jiangtao-ml/ESP32_C3_Gateway/README.md

# ESP32-C3 工业数据采集网关（STB3-125 → UDP）

> **一句话**：用 ~50 元的 ESP32-C3 SuperMini + MAX13487，把配电箱电表 `STB3-125` 的用电数据
> （RS-485 / Modbus RTU）采下来，经 WiFi 以 **UDP + JSON** 送到电脑入库。
>
> **目标级别 = L1 实验室样机**（2026-10-22 定）：单台稳定采集 + 结果可复现 + 故障可定位。
> **明确不做**：隔离 / 打样 PCB / EMC 认证 / 批量一致性 —— 理由见 `02_docs/26_级别声明与范围边界.md`。
>
> **最后更新**：**2026-10-26 · 砚青**（结构整理：本文件由 212 行压到约 100 行。删除了与 `PROGRESS.md`
> 重复的进度表、待办清单、环境参数，以及已过期的 IP 值、编译基线、"RXO 必须分压"、EN 接 5V 等口径。
> 原则：**会变的事实只留单一出处**，本文件只做导航）
> 上一版：2026-10-17

---

## 0. 只读这几份文件

| 顺序 | 你想知道 | 读这个 | 它不回答什么 |
| --- | --- | --- | --- |
| 1️⃣ | **这个系统到底怎么跑起来的** | **`02_docs/28_系统全链路说明.md`** ← **新人从这里开始** | 需求和判据 |
| 2️⃣ | **现在在哪个阶段、下一步做什么、能不能放行** | **`02_docs/00_阶段与门禁主控表.md`** ← **唯一主线** | 具体怎么做 |
| 3️⃣ | **今天/本周发生了什么、历史决策留痕** | `PROGRESS.md` | 需求与判据 |
| 4️⃣ | **每个文件该去哪、目录怎么组织** | `02_docs/23_项目结构说明.md` | 进度 |

> 其余 20+ 份文档**只在上面几份指向时才需要打开**。
> 每个目录都有自己的 `README.md`，进去先看那个。
>
> ⚠️ 旧版本文档常写"`04_ai_prompts/00_context.md` 是唯一事实来源"，**该口径已不准确**（2026-10 旧说法）：
> 需求以 `02_docs/21` 为准、判据以 `02_docs/24` 为准、进度以 `PROGRESS.md` 为准。详见 `02_docs/00` §2。

---

## 1. 项目定位（2026-10-21 重新定调，覆盖旧表述）

| | 内容 |
| --- | --- |
| ❌ 不是 | "用 ESP32 替代树莓派省钱" —— 那只是立项由头，**不是验收目标** |
| ✅ 是 | **把 ESP32-C3 + MAX13487 焊到洞洞板上、稳定收发真机数据、做到"完整"** |
| 载体 | 7×9 洞洞板，两模块引脚**直焊**（无排母、焊上即不可拆），后续只补外壳 |
| 验收 | 能采 / 可信 / 可诊断 / 可复现 / 可交付（`02_docs/26` §2） |

> 因此：**本项目不做 PCB**（`02_docs/26` N-2，2026-10-26 用户确认放弃，两套自研板工程已删除）。
> 唯一硬件方案是**洞洞板直焊**。网上买块板子、等打样、找贴片厂 —— 都不在计划内。

---

## 2. 系统链路

```
STB3-125 电表 ──RS-485 (9600 8N1 / Modbus RTU)──►  ESP32-C3 SuperMini + MAX13487
                                                              │  WiFi
                                                              ▼
                                              UDP:8888 JSON ──►  电脑（Ubuntu）→ SQLite
```

三条设计口径（**别"优化"掉**）：

- **上行 = JSON**：数据行 / 心跳行 `type:"hb"` / 失败行 `type:"err"`；带 `seq`、`dev`、`quality`、`invalid`、`raw`（HEX）
- **轮询 = `0x04` 读输入寄存器**，运行时自适应：启动默认**一帧读全 39 寄存器**（83 B），从未成功且连续 3 轮失败才降级 3 段（37/37/19 B）
- **固件只搬运原始值，不做工程量换算** —— 换算放 PC/服务端 ⇒ 公式可演进、`raw_hex` 可重放

---

## 3. 六个目录

```
ESP32_C3_Gateway/
├─ 01_firmware/        固件（唯一可编译产物来源）
│  ├─ esp32c3_gateway/   ★ 主工程（PlatformIO / Arduino）
│  ├─ pio_verify/        编译对照工程（只编译、不烧录）
│  └─ rs485_probe/       焊接体检工程（诊断 GPIO20 通断，不是业务固件）
├─ 02_docs/            设计、需求、方案、判据、排障记录（入口 = 00_阶段与门禁主控表）
├─ 03_logs/            运行证据与日志（不入库；分 A/B/C 三级，见其 README）
├─ 04_ai_prompts/      AI 协作指令与上下文包
├─ 05_hardware/        硬件资料：协议原件 / 字段字典 / 接线 / 洞洞板图纸
│  └─ _备查_未打样PCB/   两块自研板（L2 备查，未入库）
├─ 06_tests/           PC 侧测试脚本与操作卡（见其 README）
├─ PROGRESS.md         进度与决策留痕
└─ README.md           本文件（只做导航）
```

编号前缀用于固定排序，**不要改名**（两百多处交叉引用依赖它）。

---

## 4. 如果今天就要动手

1. **施工顺序**：`05_hardware/洞洞板固化操作卡_2026-10-08.md`（v1.3，含材料 / 步骤 / 电检 / 签核表）
   → 图纸依据 `05_hardware/洞洞板布局图_2026-10-21.md`（v1.2）
2. **编译 / 烧录**：命令与两条链路的选择见 `PROGRESS.md` §5b（**PlatformIO 为正式链**）
3. **起接收端 / 抓包**：`06_tests/README.md`
4. **真机联调**：`06_tests/M5_真机联调操作卡.md`

---

## 5. 三条最致命的红线（都踩过，别再踩）

### ① 485 模块的 `TXD` / `RXD` 是**交叉**约定

模块丝印写的是**模块自身**的收发方向：模块 `TXD` = 芯片 `RO`（收），模块 `RXD` = 芯片 `DI`（发）。

- ✅ 正确：`GPIO21`(ESP32 TX) → 模块 `RXD`；`GPIO20`(ESP32 RX) ← 模块 `TXD`
- ❌ 同名对接 ⇒ **双向全断，而模块电源灯仍亮** —— 这正是 M4 卡五天的真凶
- 复盘：`02_docs/14_M4排障全过程复盘_2026-10-04.md`

### ② 总线侧顺序是 `B` / `A` / `GND`（GND 在最后）

按**字母**接，不按位置接。旧材料记作 `GND/A/B` 是错的。

### ③ 真机在**带电配电箱**里 —— 开箱前断电 + 验电

- 疑似三相 380V ⇒ **必须断全三相**；**无万用表不许开箱**
- **判据：看 485 另一头有没有市电** —— 有市电 ⇒ **充电宝供电 + 拔 USB**
  （否则经 USB 地 + 485 共模可烧电脑主板）
- ⚠️「装的时候断电了」≠「此后一直安全」⇒ **每次改接线前都要再断一次**

> 其余接线事实（EN 接 **3.3V**、`RXO` **直连 GPIO20 不分压**、GND 共地、5V/3.3V 双供电）
> 见 `05_hardware/接线说明.md` 与 `04_ai_prompts/00_context.md` 三.2–三.5。

---

## 6. 现状一句话

**M0–M6 全部通过**（M6：900 s 压测 `poll_ok=975 / poll_err=0`，UDP 数据行送达 98.0%）。
当前在 **S3 验证阶段**：台面计划已就绪（`02_docs/24`），**缺 168 h 真机长跑报告**，
以及 `09_成本对比` / `10_验收结项` 两份交付文档。

> 逐条门禁判定与"下一步只做一件事"见 `02_docs/00_阶段与门禁主控表.md` §6–§7。

---

## 7. 协作约定（详见 `PROGRESS.md` §2b）

- **作者 ≠ 验证者**：任何固件改动必须由另一角色复核后才可烧录。
- **提交只 add 自己的文件**，永不 `git add -A`（会吞掉他人的在途改动）。
- **作废 ≠ 删除**：先移 `_archive/` 并记一行原因。
- **临时产物**写 `.workbuddy/tmp/` 或 `03_logs/`，**不落仓库根目录**。
