jiangtao-ml/ESP32_C3_Gateway/05_hardware/README.md

# 05_hardware —— 硬件资料索引

> 最后更新：**2026-10-26 · 砚青**（PCB 工程已按用户指示删除；§1 改为"唯一方案 = 洞洞板"）
> 上一版：2026-10-17 · 砚青（新增本索引，解决"两套 PCB 到底哪套是哪套"的混淆）
> 事实来源：`04_ai_prompts/00_context.md` ｜ 规则：`PROGRESS.md` §2b

**本目录混装了三类东西：设备厂商资料、器件手册、洞洞板施工资料。先看这张表再翻文件。**

---

## 1. 硬件方案只有一个：洞洞板

**本项目明确不做 PCB。** 2026-10-22 定级 **L1 实验室样机**，`02_docs/26_级别声明与范围边界.md` §3
**N-2 明确不打样 PCB**；2026-10-26 用户确认放弃，两套自研板工程（`carrier/` 载板、`pcb/` 定制板）
连同生成脚本**已全部删除**，不再保留备查。

| 方案 | 说明 | 位置 |
| --- | --- | --- |
| **洞洞板直焊（唯一方案）** | ESP32-C3 SuperMini + MAX13487 模块**直焊** 7×9 洞洞板，无排母、`RXO` 不分压 | 本目录：`洞洞板固化操作卡` · `洞洞板布局图` · `接线说明` |

> 想找 PCB / Gerber / KiCad 工程 / BOM —— **这里没有，也不会再有**。
> 若将来升到 L2 需要 PCB，按 `02_docs/26` §5 的升级清单**重新设计**，不复用旧工程。

---

## 2. 电表资料（STB3-125）

`STB3-125` 的三份协议文件是**同一份内容的三层形态**，不是三个不同文档：

| 文件 | 层次 | 用途 |
| --- | --- | --- |
| `STB3-125_Modbus_Protocol.doc` | **厂商原件** | 存档、对账用。格式老，别直接读 |
| `STB3-125_Modbus_Protocol.docx` | 格式转换件 | 仅为兼容阅读；内容与 `.doc` 一致 |
| `STB3-125_Modbus_Protocol.md` | **提炼版（阅读入口）** | 实际查阅用这份 |

> 同名逻辑适用于数据库字段表：
> `STB3-125_Database_Fields.docx`（厂商原件）→ `STB3-125_Database_Fields.md`（提炼版，引用 `media/` 下的两张原图）。
> **`media/` 是 `.md` 的图片依赖，不要单独删。**

### 唯一事实来源

| 文件 | 地位 |
| --- | --- |
| **`STB3-125_字段字典.csv`** | **39 个寄存器的唯一事实来源**。固件解析、`m5_parse.py`、`db_proto.py`、建表 DDL 全部读它，**不硬编码字段**。改这里 = 改全局口径 |
| `STB3-125_Errata.md` | 勘误（E-01/E-03 已判定，E-02 已结案 = 情况 A） |

> ⚠️ `02_docs/06_QI协议说明.md` §5.3 与 `06_tests/M5_真机联调操作卡.md` §9 的换算表**缺 12 个字段**，与字段字典不一致时**以 CSV 为准**。

---

## 3. 器件手册

| 文件 | 说明 |
| --- | --- |
| `MAX13487E_MAX13488E_Datasheet.pdf` | 官方手册（Rev 3）。**关键结论：全片无 DE 脚**，EN 接固定高电平；A/B 偏置电阻是"器件正常工作必要条件" |

---

## 4. 接线与装配

| 文件 | 说明 |
| --- | --- |
| `接线说明.md` | 面包板阶段的接线规范与安全红线 |
| `洞洞板固化操作卡_2026-10-08.md` | **现场施工主文档**（v1.3）：材料、步骤、电检、签核表 |
| `洞洞板布局图_2026-10-21.md` | **孔位与朝向的图纸依据**（v1.2）：落孔坐标、外壳预留、自查项 |
| `洞洞板落点方案_7x9.png` / `.svg` | 落孔方案图（打印对照用） |
| `洞洞板装配示意图.png` / `.svg` | 装配示意图（打印对照用） |

### 三条最容易致命的接线事实（原文见 `接线说明.md`）

1. **`TXD`/`RXD` 是交叉约定**：`GPIO21` → 模块 `RXD`；`GPIO20` ← 模块 `TXD`。同名对接会双向全断，而模块电源灯仍亮。
2. **总线侧顺序是 `B` / `A` / `GND`**，GND 在最后。旧材料记作 `GND/A/B` 是错的。
3. **EN 接固定高电平**，不悬空、不接 GND、不动态切换。

---

## 5. 文件生命周期

| 类别 | 是否入库 | 说明 |
| --- | --- | --- |
| 厂商原件（`.doc` / `.docx` / `.pdf`） | 是 | 大文件，但必须留 |
| 提炼版 `.md` / 字段字典 `.csv` | 是 | 日常工作入口 |
| 洞洞板施工资料（操作卡 / 布局图 / 装配图 / 接线说明） | 是 | **当前阶段的施工依据** |
| `media/`（协议文档的图片依赖） | 是 | 被 `STB3-125_Database_Fields.md` 引用，**不要单独删** |
