jiangtao-ml/ESP32_C3_Gateway/01_firmware/esp32c3_gateway/README.md

# 01_firmware/esp32c3_gateway —— ESP32-C3 RS-485 采集网关固件主工程

本目录是「ESP32-C3 替换树莓派网关项目」的固件主工程（Arduino sketch）。

> ## ⚠️ 先读这里：当前状态（最后更新 **2026-10-17** 砚青：M6 收官状态同步 + 工具链切 PlatformIO）
>
> | 项 | 现值 |
> | --- | --- |
> | **关卡** | **M0–M6 全部通过** + 功能对齐 **批次 1 / 2 / 3 / 3.5 全部完成**；**M7 验收结项进行中** |
> | 当前阶段 | **阶段四 → 阶段五**（M6 已收官：900s `poll_ok=975/poll_err=0` = 100%） |
> | **上行格式** | **JSON 三类行**（数据行 + 心跳行 `type:"hb"` + **失败行 `type:"err"`**）—— **不再是** `时间戳 \| HEX`（功能对齐批次 1 起） |
> | **轮询帧** | **功能码 `0x04`**（读输入寄存器）；**运行时自适应**（批次 2 起）：启动默认**一帧读全**（`00 27` → 83 字节），从未成功且连续 3 轮失败自动降级 **3 段**（S1/S2/S3 → 37/37/19 字节），本会话不回切 |
> | **时间同步** | **三源**：**主 `172.16.0.2`（校内 chrony）** → 备1 `ntp.aliyun.com` → 备2 `203.107.6.88`；`NTP_TZ_INFO = "CST-8"` |
> | **电脑侧 IP** | **每次开工前实测确认**（漂移史 `.117`→`.118`→`.114`→`.113`→`.121`→**`.150`**）。**2026-10-22 起定为旧测试电脑 `192.168.1.150`**。真机当前由 **NVS** 决定，改 Web 即可、不必重烧 |
> | **串口** | ESP32 = **COM5**（`303A:1001`，原生 USB CDC）；USB 转 485 = CH340（`1A86:7523`）；换 USB 口会变 |
> | **字符间隔超时** | **`RS485_CHAR_TIMEOUT_MS = 8`**（M5 正式档位；M4 期间曾临时放大到 25） |
> | **设备命名** | `dev = "ESP485-" + MAC 后 6 位`（例 `ESP485-159B88`） |
> | 编译基线（`--clean`） | **Flash `1 089 225` B / RAM `49 568` B**（`SELFTEST=0`，2026-10-27 实测）；`SELFTEST=1` = `1 081 561` / `49 408`。**0 error / 0 warning**（默认 flags）｜⚠️ 旧记 `1 070 975 / 49 348` 是 **M6 时代过期数**，勿再引用 |
>
> - **完整当前状态与下一步 → 根目录 `PROGRESS.md`**（**所有协作者 / AI 智能体先读它**）。
> - **烧录工具链**：**PlatformIO（`pioarduino@55.03.311`）为正式链**（2026-10-08 两链真机对照 100%，commit `28945a8`）；`arduino-cli` 降为对照。
> - **本文件其余章节（M2 / M3 / M4）是当时的**过程与实测记录**。示例里的 IP、NTP 源、`HEARTBEAT` 载荷、
>   `0x03` 请求帧等，**都是"当时的真值"**，保留原样作为历史与复现依据 —— **不要拿它们当现状去配置**。

## 目录结构

```
01_firmware/esp32c3_gateway/
├── esp32c3_gateway.ino     # sketch 主文件（M5：WiFi + NTP 三源 + UDP JSON 上行 + 485 总线 0x04 三段读取/解析）
├── config.h               # 非敏感常量（电脑/自身 IP、端口、NTP 三源、周期；485 超时与 Modbus/QI 常量）
├── secrets.h.example      # 凭据模板（占位符，不含真实值）
├── secrets.h              # ← 本地自建，不入库（.gitignore 已忽略）
└── README.md              # 本文件
```

sketch 目录名必须与 .ino 文件名一致（`esp32c3_gateway`），否则 Arduino IDE 无法识别。

## 首次搭建

1. 复制凭据模板并填写真实值（本文件不入库）：

   ```powershell
   Copy-Item .\secrets.h.example .\secrets.h
   ```

   然后编辑 `secrets.h`，把 `<占位符>` 换成实际 SSID / 密码。

2. 用 Arduino IDE 打开 `esp32c3_gateway.ino`。

## 构建方式（Arduino IDE）

| 项 | 设置 |
| --- | --- |
| 开发板 | ESP32C3 Dev Module（ESP32-C3 SuperMini） |
| **USB CDC On Boot** | **Enabled** ← 必需，否则 `Serial` 无输出 |
| Flash Size | 4MB (32Mb) |
| Upload Speed | 921600（不稳定时降到 115200） |
| Port | **COM5**（`303A:1001`，原生 USB CDC；换 USB 口会变）。⚠️ 烧前关掉 Arduino IDE 串口监视器，否则报 `PermissionError(13)` |
| CPU Frequency | 160MHz |

关键设置：**USB CDC On Boot = Enabled**（此项是 `Serial` 有输出的前提）。

> ⚠️ **M3 起（含 M4）这是硬性要求**：若设为 Disabled，`Serial` 会落到 UART0，而 ESP32-C3 的 UART0 默认引脚正是 GPIO20/21 —— 会与 `Serial1` 争用同一对引脚，回环/总线收发必然异常。

> 命令行编译（可选，与上面的 IDE 设置等价；在仓库根目录执行）：

```powershell
arduino-cli compile --fqbn "esp32:esp32:esp32c3:CDCOnBoot=cdc" 01_firmware/esp32c3_gateway
```

> `CDCOnBoot=cdc` 不可省。烧录用同一条命令末尾加 `--upload -p COM5`。
>
> **编译基线（`--clean`，core `esp32:esp32 3.3.10-cn`）**：
> - M4 期（2026-10-03，Codex）：Flash **997299 B (76%)** / RAM **38244 B (11%)**
> - NTP 三源改造后（2026-10-05，Codex）：Flash **999293** / RAM **38308**
> - **M5 + 功能对齐批次 1 后（2026-10-06，WorkBuddy 独立复现）：Flash `1004579 B (76%)` / RAM `39108 B (11%)`，0 error / 0 warning** ← **当前基线**

UART1 参数（**M3 起已接入**，由 `setup()` 调用，形参顺序为 `(baud, config, RX, TX)`）：

```cpp
Serial1.begin(9600, SERIAL_8N1, 20, 21);   // RX=GPIO20, TX=GPIO21，9600 8N1
```

- 引脚：ESP32-C3 的 `HardwareSerial(1)` 可映射到 GPIO20/21（SuperMini 上无 USB/Flash 冲突）。
- `HardwareSerial(1)` 与 USB CDC（`Serial`）相互独立，可同时使用。
- RX 侧电平：**2026-10-21 已裁定直连** —— `RXO` 直接接 `GPIO20`，**不分压**（依据：本模块已实测可直连并通过 M4 1000 次 + M5 真机；用户 2026-10-21 最终确认）。若日后换用 5V 逻辑模块，必须重新按 §6.2 的分压方案处理。

## M2：WiFi + NTP + UDP 联通验证（**历史记录** · 2026-09-27；示例中的 IP / NTP 源 / `HEARTBEAT` 载荷均为当时真值）

前提：本目录已有 `secrets.h`（含真实 SSID / 密码）；`config.h` 的 `UDP_TARGET_IP` / `LOCAL_IP` 与实测一致。

1. **电脑侧**：打开 **NetAssist（网络调试助手）**，协议选 **UDP**，本地端口填 **8888**（= `UDP_TARGET_PORT`），点「打开」。
2. 确认电脑无线网卡 IPv4 仍为 `192.168.1.118`（`ipconfig /all`；**会随网络漂移**，2026-10-04 实测值，原 `.117`）；若已变化，先改 `config.h` 再烧录。
3. 烧录固件并打开串口监视器（115200）。预期串口输出：

```text
[WIFI] 静态配置 IP=192.168.1.200 GW=192.168.1.1 MASK=255.255.255.0 DNS=192.168.1.1
[WIFI] 已发起连接（非阻塞），等待 wifiTick() 报告结果
[UDP] 本地端口 12345，目标 192.168.1.118:8888
[485] UART1 就绪 baud=9600 8N1 RX=GPIO20 TX=GPIO21
[485] 模式=真实 485 总线：ESP32(TX) -> MAX13487 -> 电脑 USB 转 485（Modbus 从站）
[485] ⚠️ RXO 先万用表实测空闲电平：5V 必须 1k/2k 分压后接 GPIO20，3.3V 则直连不分压（未实测前按 5V 处理）；EN 接法随实物芯片型号二选一（MAX13487/13488 → 固定高电平；MAX485/MAX3485 → 方向控制 GPIO），先读丝印；三方必须共地。方向控制宏：MAX485 / MAX3485 → 把 config.h 的 RS485_DE_PIN 改成 EN 所接的 GPIO 号（默认 -1 = 不启用）
[485] 请求 8 字节 | 01 03 00 00 00 02 C4 0B  ->  期望响应 9 字节（从站地址 1，功能码 0x03 读 2 个保持寄存器）
[BOOT] M4 就绪：WiFi + NTP + UDP 心跳 + 485 总线收发 + Modbus RTU 解析
[WIFI] 已连接 SSID=xxx RSSI=-55 dBm IP=192.168.1.200 GW=192.168.1.1
[NTP] WiFi 已连上 -> 触发 SNTP 对时 TZ=CST-8 主=ntp.aliyun.com 备=203.107.6.88
[NTP] 时间已同步：本地 2026-09-27 20:15:03 +0800（TZ=CST-8，源 ntp.aliyun.com / 备选 203.107.6.88）
[UDP -> 192.168.1.118:8888] BOOT+5.012 | UNSYNCED
[UDP -> 192.168.1.118:8888] 2026-09-27 20:15:01 | HEARTBEAT
```

> 说明：本样例中的 UDP 目标为 **`192.168.1.118`**（= 当前 `config.h` 的 `UDP_TARGET_IP`）。
> 2026-09-27 首测时电脑为 `192.168.1.117`，**2026-10-04 实测漂移到 `.118`**；该值会随网络变化，以 `ipconfig /all` 为准。

4. **判定标准**（对应任务书 §9.1 M2）：
   - NetAssist 接收区**每秒出现 1 行**，格式 `YYYY-MM-DD HH:MM:SS | HEARTBEAT`（M4 起心跳标签为 `HEARTBEAT`；M2 阶段当时为 `M2_HEARTBEAT`，属历史记录）；
   - 对时完成前为 `BOOT+<秒>.<毫秒> | UNSYNCED`，对时完成后自动切换为墙钟时间；
   - **时区自检**：串口 `[NTP] 时间已同步` 行末尾应为 `+0800`（东八区）。若显示 `+0000`，说明 `NTP_TZ_INFO` 未生效（见 config.h 中关于不可写 `"<CST-8>"` 的注释）；
   - 连续 ≥60s 不断包（**从第 2 个包开始计时**，规避 ARP 首包丢失）。
5. **断网自恢复验证**：断开路由器 2.4GHz 约 30s 再恢复 → 串口应出现 `[WIFI] 连接断开` → `[WIFI] 第 N 次重连` → `[WIFI] 已连接` → `[NTP] WiFi 已连上 -> 触发 SNTP 对时`，且 **≤60s 内恢复发包**。

> 排查提示：NetAssist 收不到包 → 先看串口有无 `[WIFI] 已连接`（未连上则看 SSID 是否 2.4GHz）；再看 NetAssist 端口是否 8888 且已「打开」；最后确认电脑 IPv4 未变。

## M3：UART1 物理回环自测（内建，每秒自动一次）

目的：**先不接 MAX13487**，证明「串口能自发自收」，为 M4 的 Modbus 收发打底。
自测逻辑已内建在 `esp32c3_gateway.ino` 的 ST_TX / ST_WAIT_RX / ST_PARSE 中，**无需再手改代码**。

> ⚠️ **M4 起默认走真实总线模式**（`config.h` 里 `RS485_MODE_LOOPBACK_SELFTEST = 0`）。
> 要做本节回环自测，先把该宏改成 **`1`** 再烧录，测完**务必改回 `0`**。
> 若保持 `0` 直接短接 GPIO20/21，固件会按 9 字节响应帧等待，8 字节回环帧将被判为 `[M4] 帧长异常 期望 9 收到 8`（这不是故障，是模式不匹配）。

1. **断电**，用一根母-母杜邦线把 **GPIO21（TX1）与 GPIO20（RX1）短接**。
2. **不接 MAX13487**（避免总线偏置 / 终端电阻干扰判断，也避免 5V 电平灌进 GPIO20）。
3. 烧录并打开串口监视器（115200）。预期每秒一行：

```text
[485] UART1 就绪 baud=9600 8N1 RX=GPIO20 TX=GPIO21
[485] 模式=M3 物理回环自测：请短接 GPIO21 <-> GPIO20，且不接 MAX13487
[485] 回环 OK TX=8 RX=8 | 01 03 00 00 00 02 C4 0B
[485] 回环 OK TX=8 RX=8 | 01 03 00 00 00 02 C4 0B
...
[485] 统计：成功 100 / 失败 0 / 超时 0
```

4. **判定标准**（对应任务书 §9.1 M3）：
   - 每秒一行 `[485] 回环 OK TX=8 RX=8`，帧内容与 `01 03 00 00 00 02 C4 0B` **完全一致**；
   - **连续 1 分钟无 FAIL / TIMEOUT**（≥60 次全 OK）；跑到 1000 次时误帧 0、丢帧 0；
   - 每 100 次打印一次 `[485] 统计：成功 X / 失败 Y / 超时 Z`，其中 **Y 与 Z 应恒为 0**。
5. **失败判读**：
   - `TIMEOUT ... RX=0` → 短接线未插好 / 插错引脚，或 `USB CDC On Boot` 不是 Enabled（见上）；
   - `TIMEOUT ... RX=N`（0<N<8）→ 半帧，查杜邦线接触，或确认 MAX13487 是否仍挂在总线上；
   - `FAIL ... 期望 ... 收到 ...` → 后面紧跟的 `[差异] byte[i]` 会指出具体错位字节。

> ⚠️ 回环自测必须**先断开 MAX13487**，避免总线偏置 / 终端电阻干扰判断。

> 三级超时（均可调，见 `config.h`）：首字节 **80ms** → 字节间静默 **4ms** 判定本帧结束 → 整帧兜底 **300ms**。
> 发送后另有 **2ms** 保护间隔（`RS485_TX_GUARD_MS`）。9600 8N1 下 8 字节仅约 8.3ms，余量充足。

## M4：真实 485 总线收发 + Modbus RTU 解析（✅ **已完成，留作回归参考** · 2026-10-04）

目的：把 ESP32 从「自己发自己收」接到**真实 485 总线**上。ESP32 每秒发一帧 Modbus RTU 请求，
电脑端用 **USB 转 485 模块 + Modbus 从站模拟器**应答，ESP32 校验响应帧并打印解析结果。
M4 只用功能码 `0x03`（读 2 个保持寄存器）验证**物理链路与解析**，**QI 真机协议留待 M5**。

请求帧（`config.h` 的 `MODBUS_TEST_FRAME`，已含独立复算的 CRC）：

```text
01 03 00 00 00 02 C4 0B
│  │  └──┬──┘ └──┬──┘ └──┬──┘
│  │     │       │       └── CRC16/Modbus = 0x0BC4，低字节在前（C4 0B）
│  │     │       └────────── 读 2 个寄存器
│  │     └────────────────── 起始地址 0x0000
│  └──────────────────────── 功能码 0x03（读保持寄存器）
└─────────────────────────── 从站地址 1
```

期望响应帧长 = **9 字节**：地址 1 + 功能 1 + 字节数 1 + 数据 4 + CRC 2。

### 接线（三方必须共地）

> ### ⚠️⚠️【2026-10-04 M4 实测确认】下表用的是**芯片引脚名**，与**模块丝印**的对应关系是「交叉」的
>
> 模块丝印写的是**模块自身的收发方向**，不是"你那边接什么"：
>
> | 芯片引脚（下表用名） | 模块丝印 | 应接到 ESP32 |
> | --- | --- | --- |
> | `DI`（驱动**输入**） | **`RXD`** | `GPIO21`（TX） |
> | `RO`（接收**输出**） | **`TXD`**（别名 `RXO`） | `GPIO20`（RX） |
> | `VCC` / `GND` / `EN` | 同名 | `5V` / `G` / **`3.3`** |
>
> **即：`GPIO21` → 模块 `RXD`；`GPIO20` ← 模块 `TXD`。**
> 按"同名对接"（`GPIO21`→模块 `TXD`）会**双向全断**（`GPIO21` 顶在芯片输出脚上对撞、`DI` 从未被驱动），**而模块电源灯仍亮**，极易误判为硬件故障。
> 本项即 M4 卡 5 天的真凶，详见 `02_docs/14_M4排障全过程复盘_2026-10-04.md`。
>
> 另注：**总线侧 3 脚丝印顺序为 `B` / `A` / `GND`**（`GND` 在最后），旧材料记作 `GND / A / B` 是错的。

| 连接 | ESP32-C3 SuperMini | MAX13487 模块 | 说明 |
| --- | --- | --- | --- |
| 供电 | `5V` | `VCC` | ⚠️ MAX13487 **必须 5V**，不要接 3.3V |
| 发送 | `GPIO21`（TX1） | `DI` | 3.3V 逻辑可直驱 DI，无需电平转换 |
| 接收 | `GPIO20`（RX1） | `RXO`（= RO / RXD）**直连** | **不分压**（2026-10-21 裁定）。见下方说明 |
| 地 | `GND` | `GND` | ⚠️ **必须共地** |
| 总线 | — | `A(+)` / `B(-)` | 与 USB 转 485 模块的 `A(+)` / `B(-)` 一一对应接好 |
| 电脑侧 | — | — | USB 转 485 模块的 A/B 并在同一条总线上，其 `GND` 也必须并入上述共地点 |
| 控制 | `3.3` | `EN` | ⚠️ **接法随实物芯片型号二选一**（`MAX13487 / MAX13488` → 接**固定高电平**；`MAX485 / MAX3485` → 接方向控制 GPIO，需改造固件）。**先读实物 8 脚芯片丝印，未读前不得接任何电平**。本工程实物 = MAX13487，**接 3.3V**（2026-10-21 统一：原表写 `VCC/5V`，与载板网表的 `+3V3 → EN` 冲突，现以 3.3V 为准，见 `PROGRESS.md §8.2`） |

```text
共地拓扑（星形，务必连到同一点）：
  ESP32-C3 GND ──┬── MAX13487 GND
                 └── USB 转 485 模块 GND
```

> ### ✅ RXO 接法：已裁定**直连，不分压**（2026-10-21）
>
> 本模块 `RXO` 直连 `GPIO20`。依据：2026-10-06 拆掉 1k/2k 后 M4（1000 次）与 M5（真机）均通过；2026-10-21 用户最终确认不需分压。
>
> **若将来换用 5V 逻辑的 485 模块**，必须先量 `RXO` 空闲电平再决定，分压按下图：
>
> ```text
> MAX13487 RXO ──[1kΩ]── ● 分压节点 ──[2kΩ]── GND（**仅当 RXO 空闲为 5V 时**）
>                        └── ESP32 GPIO20（约 3.33V）
> ```
>
> - **严禁** `2kΩ 接 RXO、1kΩ 接 GND`：分压点仅约 1.67V，低于 ESP32-C3 高电平门限，必然收不到。
> - **严禁**只串一个 1kΩ 就直接进 GPIO20（不构成分压，5V 会灌进 3.3V 引脚，打穿 GPIO20）。
> - 本项目**洞洞板是直焊的**（无排母），换模块＝拆焊，所以"以后再说"成本很高。

> ### ⚠️⚠️ EN 接法：随实物芯片型号二选一，先读丝印
>
> 模块丝印 `EN` 的**含义随主芯片型号而变**：`MAX13487 / MAX13488` 上是 `RE#` 或 `SHDN#`（**接固定高电平即正确**）；`MAX485 / MAX3485` 上是方向控制脚（**必须由 GPIO 动态切换**，固定接高会占死总线）。
> **接线前必须先读实物 8 脚芯片丝印定型；丝印未读前不得给 EN 接任何电平。** 详见根目录 README 第 6.1 节与 `04_ai_prompts/00_context.md` 三.5。
>
> ### ⚠️⚠️（阻塞）先确认实物主芯片型号，再谈 EN
>
> 本模块所在商品页是**三合一款**：`MAX3485`（3.3V **单向**）/ `MAX485`（5V **单向**）/ `MAX13487`（5V **双向**）。
> 商品图上的芯片丝印是 `MAX485 ESA`。**三者的 EN 语义完全不同**：
>
> | 实物芯片 | 方向控制 | `EN` 该怎么接 |
> | --- | --- | --- |
> | MAX13487 / MAX13488（5V 双向） | 自动，无需控制脚（芯片**无 `DE` 脚**） | **接固定高电平**（模块 VCC/5V，3.3V 亦可）；**不得悬空 / 接 GND / 动态切换**。悬空若对应 `SHDN#` 会关断器件（症状 = `RX=0`） |
> | MAX485 / MAX3485（单向） | **必须**由 MCU 切 DE/RE | **必须接 GPIO 动态切换**；固定接高 = **占死总线**。本固件**已内建** `RS485_DE_PIN`：把 EN 所接 GPIO 号填入 `config.h` 即启用（默认 `-1` 不启用；实测方向相反时改 `RS485_DE_ACTIVE_HIGH`） |
>
> **接线前必须先读实物芯片丝印确认**。若为 MAX485 / MAX3485，把 `config.h` 的 `RS485_DE_PIN` 设为 EN 所接 GPIO 号后重新编译即可（无需改固件逻辑）。
>
> #### MAX13487E / 13488E 数据手册要点（**仅对 `MAX13487 / MAX13488` 成立**）
>
> 引脚（8 脚 SO）：`1 RO / 2 RE# / 3 SHDN# / 4 DI / 5 GND / 6 A / 7 B / 8 VCC` —— **无 `DE` 脚**。
> - `RE#`：拉低 → `RO` 常使能；拉高 → **交 AutoDirection 控制接收器**。
> - `SHDN#`：**拉高才正常工作**；拉低 → 关断器件。
> - **`DI` 空闲须为高电平**（数据手册 Idle State 要求），**不要在 `DI` 上加下拉**。

### 电脑端 Modbus 从站模拟器：**Modbus Slave**（用户已选定）

| 项 | 设定 |
| --- | --- |
| 工具 | **Modbus Slave**（Witte Software），官网 modbustools.com |
| 连接 | `Connection` -> `Connect` -> **Serial Port**，选中 USB 转 485 对应的 COM 口 |
| 模式 | **RTU**；波特率 **9600**、数据位 **8**、校验 **None**、停止位 **1**、无流控 |
| 从站 | `Setup` -> `Slave Definition`：**Slave ID = 1** |
| 功能 | 选 **03: Read Holding Registers**；`Address` = **0**、`Quantity`/**Length = 2**、`Mode` = `Dec` |
| 数据 | 双击 `0` / `1` 两行填任意值，例如 **10** 与 **20**（对应固件打印 `[0]=10 [1]=20`） |
| 应答 | 保持窗口打开并已 `Connect`；Modbus Slave 收到请求会自动回帧 |

> 备选：`pymodbus`（Python，`pip install pymodbus`）以脚本方式起 RTU 从站，便于复现与自动化；若 Modbus Slave 的显示不直观，可换用它。二者任选其一，**不要同时占用同一个 COM 口**。

> ⚠️ Modbus Slave 是**共享软件**：未注册时每次运行限时约 10 分钟且会弹窗。M4 验收需连续 ≥1 分钟，
> 时间够用；若超时弹窗导致断开，重新 `Connect` 即可。

### 用户操作步骤

1. **断电**接线：按上表接 ESP32 ↔ MAX13487 ↔ USB 转 485，**先完成三方共地**。
2. **上电前**用万用表测模块的 RXO 空闲电平，据此决定直连还是分压（见醒目框）。`EN` 按实物芯片丝印结论接入（`MAX13487 / MAX13488` → 固定高电平；`MAX485 / MAX3485` → 方向控制 GPIO）；**丝印未读前不得接任何电平**。
3. 电脑插上 USB 转 485，在设备管理器确认 COM 号，打开从站模拟器并按上节参数设好。
4. 烧录固件（`RS485_MODE_LOOPBACK_SELFTEST = 0`），打开串口监视器（115200）。

### 预期输出

```text
[485] 模式=真实 485 总线：ESP32(TX) -> MAX13487 -> 电脑 USB 转 485（Modbus 从站）
[485] ⚠️ RXO 先万用表实测空闲电平：5V 必须 1k/2k 分压后接 GPIO20，3.3V 则直连不分压（未实测前按 5V 处理）；EN 接法随实物芯片型号二选一（MAX13487/13488 → 固定高电平；MAX485/MAX3485 → 方向控制 GPIO），先读丝印；三方必须共地。方向控制宏：MAX485 / MAX3485 → 把 config.h 的 RS485_DE_PIN 改成 EN 所接的 GPIO 号（默认 -1 = 不启用）
[485] 请求 8 字节 | 01 03 00 00 00 02 C4 0B  ->  期望响应 9 字节（从站地址 1，功能码 0x03 读 2 个保持寄存器）
[M4] 解析 OK ADDR=1 FUNC=0x03 DATA=00 0A 00 14
      REG: [0]=10 [1]=20  CRC=3EDA
[M4] 解析 OK ADDR=1 FUNC=0x03 DATA=00 0A 00 14
      REG: [0]=10 [1]=20  CRC=3EDA
...
[485] 统计：成功 100 / 失败 0 / 超时 0
```

### 判定标准（M4 通过条件）

- 每秒一行 `[M4] 解析 OK ADDR=1 FUNC=0x03 DATA=...`，且 `REG:` 值与电脑端从站设定**一致**；
- **连续 ≥60s 无** `[M4] 超时` / `[M4] CRC 失败` / `[M4] 帧长异常` / `[M4] 地址不匹配`；
- 每 100 次累计打印 `[485] 统计：成功 100 / 失败 0 / 超时 0`（1000 次时误帧 0、丢帧 0）。

> 注：`CRC=3EDA` 是 **CRC 数值**（十六进制字面量）；线上字节序为**低字节在前**，故该帧帧尾实际是 `DA 3E`。二者不矛盾。
>
> 注：若实物为 `MAX485` / `MAX3485`，除接线外还需把 `config.h` 的 `RS485_DE_PIN` 改成 EN 所接的 GPIO 号（默认 `-1` = 不启用方向控制）；固件会在发送前拉高 EN、发完并等满 `RS485_TX_GUARD_MS` 后拉低。

### 失败判读

| 现象 | 可能原因 |
| --- | --- |
| `[M4] 超时 ... RX=0` | 未共地 / `A(+)`、`B(-)` 接反 / MAX13487 未接 5V / `EN` 误接（`MAX13487 / MAX13488` 悬空会关断器件） / RXO 未接入 GPIO20 或分压接错 |
| `[M4] 超时 ... RX=N`（0<N<9） | 波特率或帧格式不一致（须 9600 8N1 无校验）/ 半帧（线缆接触、总线反射） |
| `[M4] 帧长异常 期望 9 收到 8` 且紧跟 `[诊断] RX 帧 == TX 帧` | **自发自收回显 / 总线被占死**：接收器被常开使能（`MAX13487 / 13488` 的 `RE#` 被拉低）或方向控制被固定使能（`MAX485 / 3485` 的 `EN` 接高），先查 `EN` 是否误接 |
| `[M4] 地址不匹配 期望 1 收到 N` | 从站模拟器地址不是 1，或帧错位 |
| `[M4] CRC 失败 期望 XXXX 计算 YYYY` | 从站 CRC 字节序不是「低字节在前」（应为 `低字节 高字节`）/ 线路噪声误码 |
| `[M4] 从站异常响应 FUNC=0x83 异常码=0x02` | 从站不存在该寄存器地址（`0x02` = 非法数据地址），改从站寄存器配置 |
| 一发就收到**自己的请求帧**（`[M4] 帧长异常 期望 9 收到 8`） | 半数情况是单向模块（MAX485 / MAX3485）**未做方向切换**：先读实物芯片丝印确认型号，见上方醒目框 |
| `[485] 回环 FAIL` 出现在 `RS485_MODE_LOOPBACK_SELFTEST = 1` | 该开关只适用于**不接 485 模块**、GPIO20/21 直接短接的场景；接了 MAX13487 时回环会失败，属预期 |

> 三级超时 + 帧长驱动（均在 `config.h`）：首字节 **80ms** → 字节间静默 **4ms** → 收满 **9 字节**立即结束 → 整帧兜底 **300ms**。
> 发送后另有 **2ms** 保护间隔（`RS485_TX_GUARD_MS`）。真实总线上若**稳定丢首字节**，优先把该值调到 **3~5ms** 复测。

> ⚠️ **M4 特有风险：电脑端从站经 USB 转 485 时，字符间隔阈值 4ms 可能过紧。** USB 转串口芯片（CH340 等）按 USB 帧（1ms 轮询、最坏可达 ~16ms 延迟）**批量**交付字节，字节之间会出现数毫秒到十几毫秒的**真空间隙**。固件在“收满预期帧长”之前若遇到 >4ms 的空隙，会按第 2 级（字符间隔）提前判「半帧 → 超时」，典型现象是 `[M4] 超时 ... RX=1~8` 且**每次心跳都超时**——极易被误判成模块坏 / 接线错。
>
> **M4 期间的处置**：把 `config.h` 的 `RS485_CHAR_TIMEOUT_MS` 临时放大再复测。
> **实际经过**：M4 期间用的是 **25ms**；**M5 起已收回正式档位 `8`**（值域 4~8，取上界）。
> 帧长驱动仍是主收帧判据，放大该值不影响正常帧的结束时机。
>
> 附带说明：ESP32-C3 每次复位时 ROM/bootloader 会在 U0TXD（=GPIO21）打印启动日志，这些字节会经 485 模块的 DI 上总线（115200 波特）。通常被从站当作噪声忽略；排查「上电瞬间总线异常」时先想到它。另需目视确认主控板是否带 CH340 之类 USB 转串口芯片且占用 GPIO20/21（带则与 UART1 抢引脚，须改用其它可用 GPIO）。

> 回归自测：改回 `RS485_MODE_LOOPBACK_SELFTEST = 1` + 短接 GPIO20/21，即可复跑 M3 的物理回环自测，
> 用于在怀疑「串口层」故障时快速区分是**串口问题**还是**485 收发器 / 总线问题**。

## M5：接入 QI 真机（✅ **2026-10-05 实测通过**）

**实测结论**：真机**三段读取 59/60**（连续 60 s）、每包 **78 字节 = 39 个寄存器**完整数据，数据自洽
（`openState` 无锁/合闸、A 相 222 V、49.9 Hz、N 相板载温度 24 ℃、B/C 相全 0）；UDP 上行 **36/36** 包。
证据：`03_logs/M5真机首测_20261005_2035.log`。

### 轮询帧：**功能码 `0x04`（读输入寄存器）**

**运行时自适应（批次 2 起，2026-10-07）**：启动默认**一帧读全**（`config.h` 的 `QI_FULL_FRAME`，`00 27` → 83 字节）；从未成功且连续 3 轮失败自动降级为 **3 段**（依据 `05_hardware/STB3-125_Errata.md` E-02；曾成功过则永不降级）：

| 段 | 覆盖寄存器 | 请求帧（CRC 已由 `06_tests/m5_frame_check.py` 独立复核） | 期望响应 |
| --- | --- | --- | --- |
| S1 | 30001–30016 | `01 04 00 00 00 10 F1 C6` | **37 字节** |
| S2 | 30017–30032 | `01 04 00 10 00 10 F0 03` | **37 字节** |
| S3 | 30033–30039 | `01 04 00 20 00 07 B0 02` | **19 字节** |

- 备选「一帧读全」：`01 04 00 00 00 27 B0 10` → 83 字节（**尚未在真机上试过**，属 E-02 未收敛项）。
- ⚠️ **`0x03` 回环帧禁止带到 M5 轮询** —— 它读的是保持寄存器（配置值），会产出"看着正常但语义错误"的数据。
  该帧现在**仅**保留给 `RS485_MODE_LOOPBACK_SELFTEST = 1` 的串口层自检。

### 上行格式：**JSON**（功能对齐批次 1 起，不再是 `时间戳 | HEX`）

- **数据行**（三段全成功时发一行）：`seq / dev / mac / ip / ts / ts_ok` + 39 个测量字段 +
  `quality / invalid / seg` + **`raw`（78 字节 HEX，留证与可重算）**
- **心跳行**（每轮都发）：`"type":"hb"` + `seq / dev / fw / ts / ts_ok` +
  `rssi / free_heap / mode / poll_ok / poll_err / udp_tx` +
  **`tx_fail / reconn / up`**（真实计数）+ **`reset / boot`**（复位原因与启动序号）+
  **`clk_hold / clk_back`**（时钟回退拦截次数与最近秒数）+ **`queue: null / dropped: null`**
  > ⚠️ **2026-10-27 起 `queue`/`dropped` 由假 `0` 改为 `null`**：本固件**没有发送队列**
  > （UDP 走同步 `sendto`，不存在排队缓冲），恒发 0 属于"看起来有能力、实际不存在"的假数据。
  > 改 `null` 后语义 = "本设备无此能力"，与"队列当前为空（=0）"严格区分。
  > 接收端不受影响（`udp_collect.py` 的 `HB_REQUIRED` 不含这两个键）。详见 `02_docs/30`。
- 字段名与顺序以 `02_docs/17` §3（从参考实现读出的格式串）为准；
  **换算口径以 `05_hardware/STB3-125_字段字典.csv` 为准**（39 寄存器 ↔ 39 字段，一一对应）。

### 判据与现场纪律

- **Q-08 主判据** = **原始寄存器值逐项相等**；兜底 = 工程量误差 ≤ ±0.5% 满量程。两条同时记录。
- 🔴 **真机带电期间，ESP32 的 USB 数据线必须拔掉**；运行时用**充电宝**供电
  （否则电脑与配电箱经 USB 地 + 485 共模构成接地回路，**烧电脑主板**）。
- 现场操作单、安全协议与**停手条件**：`06_tests/M5_真机联调操作卡.md`（§1 安全 / §0b 台面预演 / §0c 无串口现场单）。
- 数据落库与商业化设计：`02_docs/16`（含 39↔39 字段对照、四层校验、商业化清单）。

## 商用级加固开关（2026-10-27 · 对应 Codex 固件四条 P0-1~P0-4）

> 事实来源与完整论证：**`02_docs/30_固件商用级加固_2026-10-27.md`**
> ⚠️ **本批未经第二角色复核、未经真机验证**。烧录前先跑 `04_ai_prompts/13` 的复核指令。

| `config.h` 开关 | 默认 | 作用 | 置 0 的后果 |
|---|---|---|---|
| `FW_WDT_ENABLE` | `1` | 任务看门狗 30 s（`trigger_panic`） | 回到"板子卡死只能人工断电"，且无复位证据 |
| `FW_CLK_GUARD_ENABLE` | `1` | NTP 回退钳位（源头用 `settimeofday()` 拉回旧值） | `CLOCK_STEP` 风险回归 ⇒ **Y-4 可能判 F** |
| `FW_TS_MONOTONIC_ENABLE` | `1` | `ts` 严格递增护栏（只在倒退时 `last+1` 跳过） | 时钟回退窗口内可能已发出倒退 `ts` |
| `FW_WDT_TIMEOUT_MS` | `30000` | 看门狗超时（整轮最坏约 1 s，两个数量级余量） | — |
| `FW_CLK_BACK_HOLD_S` | `3600` | 超过此值的回退视为"时钟真错"，直接接受并重建基线 | 调小 ⇒ 大跳也被拦（可能永久卡在旧时间）；调大 ⇒ 容忍更大错误 |

**新增运行时观测（心跳里有字段，串口也有行）**：
- `[BOOT] reset_reason=<原因> boot_count=<n>` —— 上电必打。
  `boot_count == 1` ⇒ RTC 保留区已重建 ⇒ **真断电/首次上电**；`> 1` ⇒ **软复位或看门狗，未断电**。
  `reset_reason` 重点看：`BROWNOUT` / `PWR_GLITCH`（供电不稳，非固件问题）、`USB`（插拔/换 USB 线）、`TASK_WDT`（固件卡死被看门狗救回）。
- `[WDT] 任务看门狗已启用：30000 ms ...` —— **见到这行才算狗真开了**（初始化失败只告警不阻断采集）。
- `[CLK] 拦下 NTP 回退 Ns（保持 X），累计 K 次` —— 钳位生效的直接证据，对应心跳 `clk_hold` / `clk_back`。

**回退方法**：任一开关置 `0` 即局部回退；三个功能开关全置 `0` = 完全回到批次 3 行为（新函数退化为空壳，不影响编译）。

> ⚠️ **本机 IDF 5.5 的坑（勿踩）**：`esp_task_wdt_init()` **只有新签名**
> `esp_task_wdt_init(const esp_task_wdt_config_t *)`。旧的两参数写法
> `esp_task_wdt_init(30, true)` 在该头文件里**无声明，会编译失败**（2026-10-27 已 grep 实证）。

## 约束

- **QI 真机协议已实现（M5 起）**：功能码 `0x04` 读输入寄存器 + **3 段读取**（S1/S2/S3）+ 拼接成 **78 字节** +
  每段独立 CRC 校验（任一段失败即整轮不上传）；一帧读全（`00 27`）作为编译期备选。
  ⚠️ **未做**：`00 27` 的真机验证（E-02 未收敛）、固件侧工程量换算以外的容差判定。
- 全程 `millis()` 非阻塞调度，**禁止 `delay()`**。
- `secrets.h` 永不入库；`config.h` 只放非敏感常量。
- 事实来源：`04_ai_prompts/00_context.md`（动手前必读）。
