jiangtao-ml/ESP32_C3_Gateway/05_hardware/洞洞板固化操作卡_2026-10-08.md

# 洞洞板固化操作卡（面包板 → 洞洞板焊接）

| 项 | 内容 |
| --- | --- |
| 文档 | `05_hardware/洞洞板固化操作卡_2026-10-08.md` |
| 版本 | **v1.4 / 2026-10-23**（v1.3 补外壳预留；v1.4 加"端子→焊盘"读法注记） |
| 作者 | 砚青（方案与验证）· 姜涛（焊接执行） |
| 触发 | 老师要求把面包板装置固化为洞洞板（照片：约 7×9cm 双面镀锡洞洞板） |
| 前置状态 | 面包板版已验证：批次 3 真机 100% + M6 压测 100%（2026-10-08） |
| 关联 | `05_hardware/接线说明.md`（接线事实来源）· `01_firmware/esp32c3_gateway/config.h`（引脚定义）· `06_tests/M5_真机联调操作卡.md`（真机侧安全协议） |

> 🔴 **2026-10-23 读法注记（先读这一段再看下文）**：施工图已改为 `05_hardware/洞洞板落点方案_7x9.svg` **v3**（见 `洞洞板布局图_2026-10-21.md` §2.0）。**3P 端子已取消**，A / B / GND 改由 3 个焊盘 `P1 / P2 / P3` 引杜邦线。本文凡出现「端子 `1` / `2` / `3`」，一律读作 **`P1`(A) / `P2`(B) / `P3`(GND)**；§3 走线表、§4 工序第 5/9 步、§5 电检 **M6 / M7 / M8 / M14 / M16** 的对象同样如此。落孔坐标与 8 根线的路径**只以 v3 图为准**（本文的行/列描述已过期）。

> ⚠️ **红线**
> ① 模块按**字母**接不按位置。逻辑侧丝印顺序是 **`GND` → `TXD` → `RXD` → `VCC` → `EN`**；总线侧是 **`B` → `A` → `GND`**（GND 在最后）。
> ② `EN` 接**固定 3.3V**，不得悬空 / 接 GND / 动态切换。**不要接 5V**（v1.0 写的是 5V，2026-10-21 更正，见 §7）。
> ③ **所有 GND 共地**（ESP32 / MAX13487 / 端子 / 电源）。
> ④ **不分压**：`RXO`（= 模块 `TXD`）直连 `GPIO20`。此条为用户 2026-10-21 裁定，见 §0。
> ⑤ `VCC` 必须 5V，**不得接 3.3V**（MAX13487 是 5V 器件）。
> ⑥ 模块板载已有 `472 / 121 / 472`（4.7k 偏置 / 120Ω 终端 / 4.7k）⇒ **洞洞板上不得再加终端或偏置**。
> ⑦ **本板无排母，模块引脚直焊上板 ⇒ 焊上即不可拆**。焊错只能拆焊，拆焊必伤焊盘。**图纸签核与 §5 电检这两关，权重比用排母时更高。**

---

## 0. 电平：已裁定不分压（本卡不再要求先测）

**用户 2026-10-21 裁定：`RXO` 直连 `GPIO20`，不做 1k/2k 分压。** 本卡按此执行。

原先要求"先测空闲电平再决定"，是因为模块若是 5V 逻辑，直连会超过 GPIO20 的绝对最大额定（3.6 V）。**本次已确认不需分压**，故该前置项关闭。

保留一条给未来的提醒（**不是本次的动作**）：

| 情形 | 动作 |
| --- | --- |
| 换用另一块 485 模块（尤其是 5V 逻辑的） | 重新量 `TXD` 对 `GND` 空闲电压：3.2–3.4 V 直连；4.5–5.1 V 必须分压 |
| 本卡当前这块模块 | 直连，**不测、不分压** |

> 注意：直焊后换模块意味着拆焊。所以"以后再说"的成本很高——如果对这块模块的来路没有把握，**现在花两分钟量一次比将来拆板便宜**。这一句是提醒，不构成前置条件。

---

## 1. 材料清单（v1.2：**无排母，模块直焊**）

| 材料 | 规格 | 数量 | 说明 |
| --- | --- | --- | --- |
| 万用板 | 双面镀锡 **70×90 mm**，2.54 mm 孔 | 2（1 备） | 模块引脚穿板直焊 |
| **排母** | — | **0** | **本板不用排母**（用户 2026-10-21 明确）。模块引脚直接穿过孔焊 |
| 接线端子 | 3P **5.08 mm** 螺钉式 | 1 | 出 A / B / GND 三位 |
| 导线 | 24 AWG 单股，红/黑/蓝/绿/橙 | 各 30 cm | 板内飞线 |
| 焊锡丝 | 0.6–0.8 mm 含松香 | 若干 | 直焊引脚宜用细一点的 |
| 助焊剂 / 吸锡带 | — | 各 1 | **直焊不可拆，返修全靠这两样** |
| 烙铁 | 恒温 320–350 ℃ | 1 | 尖头，便于焊 2.54 mm 相邻脚 |
| 万用表 | 通断 + 电阻 + 直流电压 | 1 | **没有不许开箱/不许焊** |
| 5V 电源 | 5V/2A 适配器 + USB-C 线 | 1 | 充电宝只够台面短测，撑不过 168h |
| 热缩管 | ⌀1.5 / ⌀3 | 若干 | — |
| 斜口钳 / 镊子 | — | 各 1 | 剪引脚、夹线 |
| **手电钻 + ⌀3.2 钻头** | — | 1 | **焊前**钻 4 个安装孔（装壳用，见 §4 步骤 1b） |
| **M3 自攻螺钉 ×4 + 尼龙柱** | M3×8 / M3×6 | 1 套 | 固定到外壳；尼龙柱给背面焊点留净空 |
| **不采购** | 120 Ω、4.7 kΩ、电平转换、1k/2k 分压 | 0 | 模块自带终端/偏置；**本次不分压**（§0） |

> ⚠️ **直焊的三个代价**，动手前先接受：
> ① 模块不可拆，坏了要拆焊；
> ② 引脚剪断后无法插排母复用；
> ③ 焊错一根线，返修要动到相邻焊点。
> 因此 §2 的布局必须先在纸上定死，**不要边焊边改**。

---

## 2. 布局（横放，元件面朝上）

```
 [5V/2A USB-C]            ┌────────────── 洞洞板 70×90 ──────────────┐
      │                   │                                        │
      ▼                   │  [ESP32-C3 直焊]     [MAX13487 直焊]    [端子:A B GND]
   ESP32 的 5V/G          │   (靠右,USB朝外)       (居中)            (靠左,出线方便)
                          └────────────────────────────────────────┘
```

- ESP32 靠**右边缘**（USB 头朝板外，方便插电源线、也方便后期插 USB 烧录）；MAX13487 居中；**A/B/GND 端子在左边缘**（出线朝真机方向）。
- 两模块之间留 **3–4 行孔距**（7.6–10.2 mm）走线。
- SuperMini 两排引脚**行距 15.24 mm（6 格）**；模块 3 针排相对 5 针排**偏 1 格（居中）**。这两项错一格就插不进孔。
- **两模块之间不要贴太近**：直焊后没有排母的间隙，飞线要从中间穿过，留 3 行以上才够。

> 正式动手前必须先在 **A4 5mm 方格纸上画 1:1 图**并签核，规格见 `05_hardware/洞洞板布局图_2026-10-21.md`。**图上没签字不焊。** 直焊不可拆，这一关比任何时候都重要。

---

## 3. 接线表（8 根，无短接）

| # | 从（ESP32-C3 SuperMini） | 到（MAX13487 模块丝印） | 线色 | 说明 |
| --- | --- | --- | --- | --- |
| 1 | `5V` | `VCC` | 红 | 模块必须 5V |
| 2 | **`3.3`** | **`EN`** | 蓝 | **固定高电平；v1.1 从 5V 改为 3.3V** |
| 3 | `G` | `GND` | 黑 | 共地（参考地，先焊这条） |
| 4 | `21`（UART1 TX） | `RXD` | 绿 | ESP32 发 → 模块收（**交叉**） |
| 5 | `20`（UART1 RX） | `TXD` | 黄 | 模块 RO 输出 → ESP32 收（**交叉**，先看 §0） |
| 6 | 模块 `A` | 端子 `1` | 橙 | 字母对字母，勿按位置 |
| 7 | 模块 `B` | 端子 `2` | 橙 | — |
| 8 | 模块 `GND` | 端子 `3` | 黑 | 真机侧 GND |

**就这 8 根，没有第 9 根，也没有"2 根短接"。** LED 是板载 GPIO8 自带；MAX13487 **无 DE 脚**；`5V` / `3.3` 各只用一次。

### 3.1 为什么 #4/#5 是交叉的

模块丝印写的是**模块自己的收发方向**，不是芯片脚名：

- 模块 `RXD` = 芯片 `DI`（驱动输入）⇒ 要接 ESP32 的 **TX**（`GPIO21`）
- 模块 `TXD` = 芯片 `RO`（接收输出）⇒ 要接 ESP32 的 **RX**（`GPIO20`）

同名的 `TXD→TXD`、`RXD→RXD` 接法会**双向全断，而模块电源灯照常亮** —— M4 阶段在这上面耗了五天。

---

## 4. 焊接步骤（v1.2：模块直焊）

1. **拍照**面包板现状（正面 / 背面 / 两个 45°，接线对照用）。
1b. **钻安装孔（必须在焊之前）**：按布局图 §2.1 定的位置钻 4 个 ⌀3.2 mm 孔，距板边 ≥5 mm、距最近焊盘 ≥4 mm；去毛刺。
   - ⚠️ **焊完再钻，手电钻的振动会把已完成的焊点和走线震裂**。这一步顺序不能换。
   - 装壳时用 M3 尼龙柱垫高 ≥5 mm，给背面锡点留净空。
2. **干插定位（不焊）**：把两个模块的引脚穿进板孔，从**背面**看是否每根都落孔、板面是否平贴；用美纹胶带固定位置。**这一步定死后就不再改，因为焊上不可拆。**
3. **焊 ESP32**：先焊**对角两个脚**固定，插 USB 线复查"USB 口朝板外、模块不歪、两排都在孔里"，确认后再焊其余 14 个脚。
4. **焊 485 模块**：逻辑侧 5 脚 + 总线侧 3 脚，同样先焊对角、再补全。注意 5 脚排与 3 脚排**不在同一列**（偏 1 格）。
5. **焊端子**（3P 5.08 mm）。端子热容量大，先焊它可以避免后面烫坏细线。
6. **先焊 #3（GND）**：先把参考地建立起来，后面所有测量都以它为基准。
7. 焊 #1（红，5V）、#2（蓝，3.3V→EN）。#2 两端套热缩，因为它紧邻 5V 走线。
8. 焊 #4 / #5（绿 / 黄）。这两根**双绞并远离电源线**，减少串扰。
9. 焊 #6 / #7 / #8（橙 / 橙 / 黑）到端子。
10. 剪掉背面多余引脚（**留 1 mm 以下**，避免扎穿胶带或短路）、清洗助焊剂、热缩收口。
11. 在每根线两端套/贴 `W1…W8` 标签（后面电检要逐根点名）。
12. **电检（§5），不通过不上电。**

> 直焊时**每焊一个脚都要停一秒确认没有连到隔壁**：2.54 mm 间距下，烙铁停留偏久就会拖出一条锡桥，而这条桥可能是 5V 到 GND。

---

## 5. 万用表检查清单（断电、模块**未插**）

| # | 测点 | 档位 | 期望 | 不符时 |
| --- | --- | --- | --- | --- |
| M1 | J2.1 ↔ J3.4（5V） | 通断 | <1 Ω 鸣响 | 断线/虚焊 |
| M2 | **J2.3 ↔ J3.5（3.3V→EN）** | 通断 | <1 Ω 鸣响 | 断线/虚焊 |
| M3 | J2.2 ↔ J3.1 ↔ J5.3 ↔ TPGND | 通断 | 每段 <1 Ω | 共地没做全 |
| M4 | J1.8(GPIO21) ↔ J3.3(RXD) | 通断 | <1 Ω | 接错/断线 |
| M5 | J1.7(GPIO20) ↔ J3.2(TXD) | 通断 | <1 Ω | 接错/断线 |
| M6 | 模块 A ↔ 端子 1 | 通断 | <1 Ω | — |
| M7 | 模块 B ↔ 端子 2 | 通断 | <1 Ω | — |
| M8 | 模块 GND ↔ 端子 3 | 通断 | <1 Ω | — |
| M9 | 5V ↔ GND | 电阻 | **>10 kΩ** | **短路，停** |
| M10 | 3.3V ↔ GND | 电阻 | **>10 kΩ** | **短路，停** |
| **M11** | **5V ↔ 3.3V** | 电阻 | **>100 kΩ** | **两轨短接，停** |
| M12 | GPIO20 ↔ 5V / 3.3V / GND | 电阻 | 均 >1 MΩ | 桥连，停 |
| M13 | GPIO21 ↔ 5V / 3.3V / GND | 电阻 | 均 >1 MΩ | 桥连，停 |
| M14 | 端子 1 ↔ 端子 2 | 电阻 | 空载 ∞ | 桥连 |
| M15 | 相邻排针之间 | 电阻 | >1 MΩ | 桥连（尤其 20/21 相邻） |
| **M16** | 端子 1 ↔ 2（A↔B） | 电阻 | **100–140 Ω（≈120 Ω）** | ≈60 Ω = 重复终端，拆掉外加的 120Ω |
| M17 | **上电后** EN ↔ GND | 直流电压 | **3.2–3.4 V** | 读到 5 V ⇒ #2 接错，立刻断电 |

> M9–M15 全部通过之前**不许上电**。M16 是模块已焊上后测，M17 需 S1 上电后测。

---

## 6. 上电时序（每步之前都断电、验电）

| 阶段 | 状态 | 判据 |
| --- | --- | --- |
| **S0** | 什么都不插，断电 | M1–M15 全过 |
| **S1** | 模块已直焊在板上，直接 USB 供电 | 5V 引脚 4.75–5.25 V；3.3 引脚 3.25–3.35 V；**EN 对 GND = 3.25–3.35 V（读到 5 V 立即断电）** |
| **S2** | 断电，测 M16（A↔B ≈120 Ω） | 合格后 5V/2A 供电（**不接电脑**）：模块灯亮、无发热、无异味 |
| **S3** | A/B 悬空（不接真机），电脑起接收端 | 约 3 轮后 `mode:"3seg"` + `err` 行 `seg:"S1"` ⇒ ESP32↔模块通路正常 |
| **S4** | **断电**接真机 A/B（先断电验电） | 数据行 `seg:"1"`、39 字段齐全、`quality:"OK"`、连续 5 min 成功率 100% |

> v1.2 起模块是直焊的，**没有"插模块"这个步骤**。S1 一旦上电，模块就已带电，所以 M9–M16 必须在 S1 之前全部通过。

S1–S3 在桌面完成，不用动配电箱。S4 需要断电窗口，按 `06_tests/M5_真机联调操作卡.md` 的安全协议走。

---

## 7. v1.0 → v1.1 改了什么（为什么必须改）

| # | v1.0 原文 | 问题 | v1.1 |
| --- | --- | --- | --- |
| 1 | `:13` 「逻辑侧 `VCC/TXD/RXD/EN/GND`」 | **字母表本身错了**。实物丝印是 `GND/TXD/RXD/VCC/EN`。"按字母接"的原则对，但照这张表念会全部错位 | 改为 `GND/TXD/RXD/VCC/EN` |
| 2 | `:14` / `:52` 「`EN` 接固定 5V」 | 与载板网表（`+3V3 → EN`）及 2026-10-09 确认冲突 | 改 **3.3V** |
| 3 | `:25` 「排母 1×14」 | SuperMini 是 **2×8 = 16 脚**，1×14 插不下 | 改 **1×8 × 2 条** |
| 4 | `:26` 「1×8 或 1×16」 | 模块是 **5 脚排 + 3 脚排**两排 | 改 **1×5 + 1×3** |
| 5 | `:27` 「端子 2P」 | 要出 A / B / GND **三位** | 改 **3P 5.08 mm** |
| 6 | `:47` 「8 根 + 2 短接」 | 表内只有 8 行，`:60` 也写"就这 8 根"；**根本没有短接项** | 删掉"+2 短接" |
| 7 | 无 §0 | `RXO` 空闲电平从未实测（Q-10 挂了很久） | 新增 §0 强制前置 |
| 8 | 电检只有 3 条 | 缺 5V↔3.3V 短接、缺 A↔B 终端值、缺 EN 实测电压 | 扩到 M1–M17 |
| 9 | 无记录表 | 焊完没有任何可追溯证据 | 新增 §8 |

---

## 8. 焊后必须留的记录（填完拍照入 `media/`）

```
板号：________   图纸版本：________   焊接日期：________
烙铁温度：______℃   焊锡：________

W1(5V→VCC)  ☐通  ___Ω      W5(20←TXD) ☐通  ___Ω
W2(3.3→EN)  ☐通  ___Ω      W6(A→1)    ☐通  ___Ω
W3(G→GND)   ☐通  ___Ω      W7(B→2)    ☐通  ___Ω
W4(21→RXD)  ☐通  ___Ω      W8(GND→3)  ☐通  ___Ω

M9  5V↔GND    ____Ω (期望 >10k)
M10 3.3↔GND   ____Ω (期望 >10k)
M11 5V↔3.3    ____Ω (期望 >100k)
M16 A↔B       ____Ω (期望 100–140)
M17 EN(上电)  ____V  (期望 3.2–3.4)
电平处理：□ 直连 GPIO20（本次裁定，不分压）

S1 5V=____V 3.3=____V EN=____V
S4 真机 5min：成功率 ____%   seg=____   quality=____

缺陷/返修：______________________________________
焊接人签字：________    核对人签字：________
```

**必拍 8 张**：正面 / 背面 / 左右各 45° / 两处排母微距 / 端子与 A B GND 标签微距 / 整机带线。
存 `05_hardware/media/weld_<YYYYMMDD>_01..08.jpg`。

---

## 9. 必须停手的 10 条

M1–M8 任一不通 / M9–M15 任一不符 / 5V↔GND < 10 kΩ / 5V↔3.3V 有导通 / EN 实测 5 V / 焦味、发黑、烫手 / 电表端子看不清 A/B/GND / USB 还插着电脑就要接电表 / 没有万用表或没有第二人核对 / RXO 未实测就要接 GPIO20 / 任何"先上电试试"的念头。

---

## 10. 变更记录

| 版本 | 日期 | 作者 | 变更内容 |
| --- | --- | --- | --- |
| **v1.4** | **2026-10-23** | 砚青 | 红线前插入**读法注记**：3P 端子已取消 → 端子 `1/2/3` 一律读作焊盘 `P1/P2/P3`，涉及 §3 走线表、§4 第 5/9 步、§5 电检 M6/M7/M8/M14/M16；落孔与走线只以 `洞洞板落点方案_7x9.svg` v3 为准。**未改写正文坐标**（保留历史可复现性）。触发：施工图 v3 取消端子并重排布局，本卡若被照字面执行会去找不存在的端子。 |
| **v1.3** | **2026-10-22** | 砚青 | 补**外壳预留**：§1 增手电钻/⌀3.2 钻头/M3 螺钉与尼龙柱；§4 新增步骤 **1b「焊前钻 4 个安装孔」**并说明"焊完再钻会震裂焊点"。触发：用户选定 L1 且后续要装壳，而安装孔漏了就得拆板。 |
| v1.2 | 2026-10-21 | 砚青 | 按实际硬件改为**无排母、模块引脚直焊、不分压**：§1 材料删掉 2×1×8 / 1×5 / 1×3 排母，补助焊剂与吸锡带（直焊返修必需）；§0 由"必须先测 RXO"改为"已裁定直连"（保留换模块时的提醒）；§4 焊接顺序改为干插定位→先焊对角→复查几何→补全，并加"每脚停一秒防锡桥"；§5/§6 去掉"插模块"步骤；红线新增第 ⑦ 条"直焊不可拆"。触发：用户明确只有模块 + 洞洞板，没有排母、不需要分压。 |
| v1.1 | 2026-10-21 | 砚青 | 修 v1.0 的 5 处硬错（字母表顺序、排母 1×14、模块排母、端子 2P、"8 根+2 短接"）；**EN 由 5V 改 3.3V**（对齐载板网表与实际使用）；新增 §0 RXO 实测前置、M1–M17 电检表、S0–S4 上电时序、§8 记录表、§9 停手清单。触发：168h 长跑前要把面包板固化，而 v1.0 按原样施工会接错。 |
| v1.0 | 2026-10-08 | 砚青 | 首版。触发：老师要求固化到洞洞板。接线表从 `config.h` 与 `接线说明.md` 提取，照抄已验证 100% 的面包板现状。 |
