jiangtao-ml/ESP32_C3_Gateway/05_hardware/洞洞板布局图_2026-10-21.md

# 洞洞板布局图与接线图 · 纸面作业规格

| 项 | 内容 |
| --- | --- |
| 文档 | `05_hardware/洞洞板布局图_2026-10-21.md` |
| 版本 | **v1.4 / 2026-10-23**（v1.3 挂装配示意图；v1.4 新增 §2.0 v3 施工落点 + 交叉处理） |
| 作者 | 砚青（规格）· 姜涛（绘制与执行） |
| 作用 | **焊前唯一强制关卡**。图上没签字，不动烙铁 |
| 配套 | `05_hardware/洞洞板固化操作卡_2026-10-08.md` v1.1（工序与电检） |

> 为什么值得花半天画图：本项目 M4 阶段在接线错误上耗了 **5 天**，根因就是"模块丝印同名 ≠ 应该对接"。纸上画错只损失一块橡皮，板上接错要拆焊、可能连带烫坏焊盘。

---

## 1. 工具

| 项 | 规格 | 用途 |
| --- | --- | --- |
| 方格纸 | **A4，5 mm 格**（或 2.54 mm 专用洞洞板纸） | 1:1 绘图。5 mm 格 ≈ 2 孔的近似比例，便于目视 |
| 描图纸 | A4 | 翻面做**焊接面镜像图**，检查背面走线 |
| 铅笔 + 橡皮 | HB | 打底稿，允许改 |
| 五色笔 | 红 / 黑 / 蓝 / 绿 / 橙 | 见 §2 颜色约定 |
| 直尺 | 15 cm 钢尺 | 量 2.54 的整数倍 |
| 实物 | 洞洞板、两个模块、端子、烙铁、万用表 | 摆位比对 |
| 相机 | 手机即可 | 拍签核后的图存档 |

### 颜色约定（三张图统一）

| 颜色 | 含义 |
| --- | --- |
| 红 | 5V 轨 |
| 蓝 | 3.3V 轨（只到 EN） |
| 黑 | GND / 共地 |
| 绿 | 逻辑信号（W4 / W5） |
| 橙 | 485 总线（A / B） |

---

## 2. 三张图（缺一不可）

> 📎 **装配外观示意**（2026-10-22 新增）：`05_hardware/洞洞板装配示意图.svg` / `.png` —— 一张图看全「板 + 两模块 + 端子的相对位置、8 根线的 W 编号、关键尺寸、禁止项」。
> ⚠️ 它**只是示意，不是施工图**：孔位未逐个落点，引脚标签写的是**名称**不是坐标。**1:1 落孔仍以下面图 1 为准，图上签字才动烙铁。**

### 2.0 现行施工图：`洞洞板落点方案_7x9.svg` v3（2026-10-23）

> 📎 `05_hardware/洞洞板落点方案_7x9.svg` / `.png` —— **落孔的施工依据**。v3 起口径变了三条，与本节旧描述冲突时**以 v3 为准**：
>
> 1. **取消 3P 端子** → 改 3 个焊盘 `P1(A) / P2(B) / P3(GND)`（列 C/D/E，行 027），各引 1 根杜邦线出去。§2 图 1 元素表里的"端子"行、§4 签核里的"端子朝向"、C8 里的"端子 1/2" 一律读作 `P1 / P2`。
> 2. **ESP32 掉头 180°**：USB 朝板下边缘（板外留 ≥15 mm 插线）。西列落在 **H 列**、东列落在 **N 列**（相距 6 格 = 15.24 mm）。
> 3. **不加 TP5V / TP33 / TPGND 测试点**（板上已无空间余量，测点靠模块引脚本身）。

**落点表（相对关系，允许整体平移）**

| 器件 | 行 | 列 |
| --- | --- | --- |
| 杜邦焊盘 P1~P3 | 27 | C / D / E |
| 模块 3 脚排（A/B/GND） | 23 | C / D / E |
| 模块 5 脚排（GND/TXD/RXD/VCC/EN） | 17 | C ~ G |
| ESP32 西列（5V…0） | 3 ~ 10 | H |
| ESP32 东列（5…21） | 3 ~ 10 | N |

> ⚠️ 模块两排针的行差（23 − 17 = 6 格）**必须先量实物**；量出几格就把行 23 改成 `17 + 格数`，其余不动。

**8 根线（按字母接，不按位置）**

| # | 起点 | 终点 | 线材 |
| --- | --- | --- | --- |
| W1 | H-3 · 5V | F-17 · VCC | 锡条 |
| W2 | H-5 · 3.3 | G-17 · EN（固定高电平） | 锡条 |
| W3 | H-4 · G | C-17 · GND | **绝缘线** |
| W4 | N-10 · 21 | E-17 · RXD | **绝缘线** |
| W5 | N-9 · 20 | D-17 · TXD | **绝缘线** |
| W6 | C-23 · A | P1 · C-27 | 锡条 |
| W7 | D-23 · B | P2 · D-27 | 锡条 |
| W8 | E-23 · GND | P3 · E-27 | 锡条 |

### 2.0.1 交叉怎么办（2026-10-23 定）

**结论：锡条上不做交叉。** 6 处交叉全部由「绝缘飞线从锡条上方架空跨过」消解 —— **0 过孔、0 处锡条互压**。

| # | 孔位 | 交叉的两根 | 谁架空 |
| --- | --- | --- | --- |
| X1 | F-004 | W3 GND × W1 5V | W3（绝缘线） |
| X2 | F-013 | W5 TXD × W1 5V | W5（绝缘线） |
| X3 | G-013 | W5 TXD × W2 3.3V | W5（绝缘线） |
| X4 | F-014 | W4 RXD × W1 5V | W4（绝缘线） |
| X5 | G-014 | W4 RXD × W2 3.3V | W4（绝缘线） |
| X6 | P-013 | W4 RXD × W5 TXD | 两根都绝缘 |

三条硬约束（违反任一条即短路）：

1. 🔴 **原方案 W1(5V) 与 W3(GND) 都落在 F-004 同一个孔** —— 那不是"交叉"，是 5V 直碰 GND。改后 **F-004 孔里只焊 W1**，W3 从锡条上方架空过去。
2. **不能靠"穿到背面绕一下"来解决**：本板是**双面镀锡 + 金属化孔**，正面焊过的孔，**背面环也是同一个网**。从背面横穿 F 列 / G 列（W1 / W2 的竖直轨）必然碰到它们的孔 ⇒ 一样短路。要在背面绕，只能走到 **row ≤ 002**（W1 在 F-003 就收头了，F-002 以下才是空的）——可行但绕远，不推荐。
3. **绝缘线上板必须在锡条焊完之后**再穿，且交叉点要把线**拱起来**，不要绷平压在锡条上；漆包线建议在交叉段套 3–5 mm 热缩管。

> 若坚持 8 根全用锡条：W3 可改 `H-004 → G-004 →（背面）G-002 → C-002 →（正面）C-017`，2 个过孔、0 交叉。W4/W5 同法只剩 row 001/002 两条通道，且与 W3 抢线 —— **不划算，直接用 0.3–0.5 mm 漆包线**。

### 图 1 · 元件面 1:1 布局图

目标：确定**每个器件焊在哪几个孔**，以及它们之间的几何关系。

必须画出并标注：

| 元素 | 要求 |
| --- | --- |
| 板外形 | 70 × 90 mm 实线矩形，四角标尺寸 |
| 2.54 点阵 | 每隔 5 mm 画一条淡格线即可（不必每孔都画圆） |
| ESP32 引脚两排 | **行距 15.24 mm（6 格）**，靠右下侧；**USB 口朝板外**，标出 USB 朝向箭头。**模块直接焊在板上，不画排母** |
| 485 逻辑侧 5 脚 | 居中；按丝印顺序标 `GND / TXD / RXD / VCC / EN`（从上到下） |
| 485 总线侧 3 脚 | 相对 5 针排**偏 1 格（居中）**；标 `B / A / GND` |
| 端子 | **3P 5.08 mm**，靠左边缘（出线朝外），三个位标 `1 / 2 / 3` |
| 测试点 | 三个独立焊盘：`TP5V`、`TP33`、`TPGND` |
| 分区 | 用浅色虚线框出"5V 区"与"3.3V 区"，两区之间留 ≥2 孔 |
| 禁装提示 | 红框写：**"禁止加装 120Ω / 4.7k / 电平转换"** |

**关键尺寸核对**（这四项错一个就装不上）：

1. SuperMini **两排引脚**行距 = **15.24 mm**（不是 2.54 的整数倍以外任意值）
2. SuperMini 每排 **8 孔**（不是 14 孔）
3. 模块 5 针排与 3 针排**间距 = 2 格（5.08 mm）**，且 3 针排相对 5 针排**居中偏 1 格**
4. 端子 3P **5.08 mm** 间距 = **正好跨 2 个孔**

### 2.1 外壳预留（**必须在焊之前定，焊完再改就来不及**）

用户已明确后续要装外壳。外壳虽然以后做，但**板子的外形、安装孔、开窗位置必须在画图时就留出来**——焊完再钻孔会把焊点和走线震裂。

| 项 | 要求 | 为什么 |
| --- | --- | --- |
| **安装孔** | 4 × ⌀3.2 mm（配 M3 自攻螺钉），距板边 **≥5 mm**、距最近焊盘 **≥4 mm** | 太靠边会崩边；太近焊盘会钻断走线 |
| **钻孔时机** | **焊之前钻**（或至少在焊大面积铜箔之前） | 手电钻的振动会震裂已完成的焊点 |
| **背面空间** | 板下（焊接面）留 **≥5 mm** 净空 | 洞洞板背面有锡点，贴平装会顶住壳底/支柱，可能短路 |
| **正面净高** | 实测元件最高点（含热缩、排针）后 **+5 mm** 余量 | 买盒子时按这个数选，不要按板子厚度估 |
| **USB-C 开窗** | 记下"板边 → USB 口中心"的距离与高度 | 装壳后要能插线；位置错了要么开窗偏、要么只能拆壳烧录 |
| **端子出线** | 端子朝**壳体出线孔**那一侧，且留 ≥10 mm 走线空间 | 线要能弯出来，不能顶住壳壁 |
| **板外形与盒子** | **先定盒子，再定板外形**（或先定板，再按板选盒），二者必须同时确定 | 70×90 的板塞不进 100×68 的明装盒（90 > 68） |

**建议流程**：先用纸板剪一块 70×90 试装进候选盒子 → 确认 USB 口与端子能对上 → 再在图上定安装孔 → 再钻孔 → 最后焊。

> 这一节不能省。装壳是 L1 的最后一步（见 `02_docs/26` §3），但如果布局没留位置，就会变成"要么不开窗、要么拆板重做"。

### 图 2 · 接线 / 网络图

目标：把 8 根线**按角色**连起来，而不是按丝印同名连。

画法：

- 每个引脚画一个小圆，圆旁标 **"器件.脚名"**，例如 `U1.20(RX)`、`M1.TXD`。
- 每根线起止两端都标 **`W1`…`W8` 编号**，与操作卡 §3 表严格对应。
- 线的**走向**画出（直连 / 绕行 / 从哪两排孔之间穿过），不要只画逻辑连接。
- 每根线旁标注**线色**。

必须写清的三条"角色"注释：

```
W4：ESP32 TX(21) ──► 模块 RXD       （模块 RXD = 芯片 DI，是"收"）
W5：模块 TXD ──► ESP32 RX(20)       （模块 TXD = 芯片 RO，是"发"）
W2：ESP32 3.3 ──► 模块 EN           （固定高电平，不是 5V）
```

> **禁止写"TXD 接 TXD"这种表述**。写角色不写同名，是这张图唯一的目的。

### 图 3 · 焊接面镜像图

目标：检查从背面看是否短路、是否要跨线。

做法：把图 1 放在描图纸下，沿**长边**翻面描一遍；或直接在描图纸上按镜像画。

检查点：

- 镜像后的引脚序号是否仍与实物一致（拿模块对着描图纸插一下最快）
- 同一列相邻两孔之间是否有两条线要跨过（有 ⇒ 改走线或换孔位）
- 焊盘之间的**锡桥风险区**（间距 2.54 mm 的相邻飞线）是否已用不同层/不同方向避开

---

## 3. 八项自查（前 5 项必做，后 3 项有时间就做）

| # | 检查项 | 通过判据 |
| --- | --- | --- |
| C1 | **端点计数** | 每个网络（除 GND）**恰好 2 个端点**；GND 逐点打勾（应 ≥5 处：J2.2 / J3.1 / J5.3 / TPGND / 模块 GND） |
| C2 | **走线交叉：锡条上必须为 0** | v3 已做到 0 处锡条互压；6 处交叉全部由绝缘线架空跨过（见 §2.0.1）。**出现锡条压锡条 ⇒ 停手改线，不要指望"焊的时候绕一下"**。仍不得从模块体下方穿过 |
| C3 | **电源间距** | 5V 与 GND 不相邻；5V 与 3.3V ≥2 孔（5.08 mm） |
| C4 | **翻面对齐** | 图 3 与实物逐脚对齐，任一脚偏移 >1 mm 就重画 |
| C5 | **角色朗读** | 沿 W1→W8 逐根念："ESP32 发，模块收" / "模块发，ESP32 收"。**不许念丝印同名**。由第二个人听并核对 |
| C6 | **实物摆位** | 把两个模块真的摆在纸上，看引脚是否落进所画的孔位 |
| C7 | **假装配** | 第二个人只看图，用杜邦线在面包板上按图接一遍，能通即说明图自洽 |
| C8 | **A/B 专项** | 必须是"模块 B（总线排第 1 脚）→ `P2`、模块 A（第 2 脚）→ `P1`"。画成两条平行直线几乎必错（**v3 已取消端子，读作焊盘**） |
| C9 | **外壳预留** | 4 个安装孔（距边 ≥5 mm、距焊盘 ≥4 mm）已画进图；USB 口中心位置与端子朝向已标注；纸板试装候选盒子通过。**外壳是 L1 的最后一步，布局没留位就得拆板** |

---

## 4. 签核（画完填，拍照存档）

```
图号：________   版本：________   绘制日期：________

绘制人：________          核对人（第二人）：________

□ C1 端点计数通过        □ C5 角色朗读通过
□ C2 交叉 ≤3 且不穿模块体 □ C6 实物摆位一致
□ C3 5V/GND/3.3V 间距    □ C7 假装配通过
□ C4 镜像对齐            □ C8 A/B 顺序正确
□ C9 外壳预留（安装孔 + USB 开窗 + 端子朝向 + 纸板试装）

候选外壳型号/尺寸：__________  USB 口中心距板边：______ mm
安装孔：□已钻（焊前）  ⌀____  端子朝向：________

RXO 空闲电平实测：______ V    （见操作卡 §0）
   → □ 3.2–3.4V 直连      □ 4.5–5.1V 需分压（图已改）

结论： □ 允许焊接        □ 退回重画（原因：________________）

签字：________
```

拍照存 `05_hardware/media/layout_<YYYYMMDD>_signed.jpg`。

---

## 5. 从图到板：落笔即定孔

画完图后，**不要**拿着图直接焊。先做一次"打点"：

1. 把图 1 垫在洞洞板下，用**记号笔**在板上点出第 1 脚与第 8 脚（或 5 脚排的首尾）**两个孔**（不必全点）。
2. 把模块的引脚**干插**进被点的孔里，从背面看是否每根都落孔、板面是否平贴。
3. 全部对上再开始焊第一个脚。
4. ⚠️ **本板无排母，模块是直焊的**：焊上即不可拆。干插定位这一步做不好，后面只能拆焊返修。

这一步花 3 分钟，能避免"焊到第 7 个脚发现整排偏了一格"。

---

## 6. 变更记录

| 版本 | 日期 | 作者 | 变更内容 |
| --- | --- | --- | --- |
| v1.4 | 2026-10-23 | 砚青 | 新增 **§2.0 现行施工图 v3**（取消 3P 端子改焊盘 P1~P3 / ESP32 掉头 USB 朝外、西列 H 东列 N / 不加测试点）+ **§2.0.1 交叉处理**（6 处交叉全部绝缘线架空，锡条上 0 交叉、0 过孔）；C2 判据由"≤3 次"收紧为"锡条上必须为 0"；C8 端子改读焊盘。触发：用户实焊前问「用锡条走线需要交叉吗」——原图 W1(5V) 与 W3(GND) **落在 F-004 同一个孔**（真短路，不是交叉），且双面镀锡板"穿背面绕行"在已被占用的列上同样短路，必须给出可施工的替代路径。 |
| v1.3 | 2026-10-22 | 砚青 | 新增**装配外观示意图**（`洞洞板装配示意图.svg` / `.png`，1440×1080）并在 §2 挂引用；文档头版本号由过期的 v1.0 对齐到 v1.3。触发：用户要求「用一张图说明焊在洞洞板上的样子」——纯文字规格无法一眼确认摆位；同时必须写明「示意 ≠ 施工图」，否则会拿示意图直接开焊。 |
| v1.2 | 2026-10-22 | 砚青 | 新增 **§2.1 外壳预留**（安装孔 ⌀3.2 / 距边 ≥5 mm / 距焊盘 ≥4 mm、焊前钻孔、背面净空 ≥5 mm、USB 开窗位置、端子朝向、先定盒子再定板外形）与自查项 **C9**；签核表增加外壳/钻孔字段。触发：用户确定 L1，后续要装外壳——**布局不留位，装壳就得拆板**。 |
| v1.1 | 2026-10-21 | 砚青 | 按实际硬件改为**无排母、模块直焊**：图 1 的三处"排母"改为引脚直接落孔；§5「落笔即定孔」由"插排母"改为"干插模块"；C6 判据同步。触发：用户明确只有模块 + 洞洞板。 |
| v1.0 | 2026-10-21 | 砚青 | 首版。把"纸面绘图"从口头要求变成可判定关卡：三张图 + 8 项自查 + 签核表 + 打点落孔。触发：168h 长跑前的洞洞板固化，而项目里此前**没有任何洞洞板几何文件**。 |
