jiangtao-ml/ESP32_C3_Gateway/PROGRESS.md

# PROGRESS.md — 当前状态与下一步

> **这是什么**：一页纸的「现在在哪、接下来做什么」。**任何 AI 智能体 / 协作者进入本仓库，请先读这个文件。**
> **🆕 流程主线 = `02_docs/00_阶段与门禁主控表.md`（S0–S5 六阶段 + 出口判据）**；本文件是**日志与留痕**，不承担流程判断。
> **详细计划**：`02_docs/16_数据落地与商业化设计.md` §9（推进计划）/ §10（功能对齐清单）
> **唯一事实来源**：`04_ai_prompts/00_context.md` —— **与本文件冲突时以它为准**。
> 维护：WorkBuddy ｜ 最后更新：**2026-10-27**（**固件商用级加固 = Codex 固件四条 P0-1~P0-4 落地**：时钟回退钳位 / 心跳诚实化 / 看门狗+复位原因 / 版本自报；`SELFTEST=0/1` 双模式编译**零警告**，`.rtc_noinit=8 B`；新增 `02_docs/30` + 复核指令 `04_ai_prompts/13`。**未经复核与真机验证，烧录前先跑 13 号指令**。见 §8.2 #42）
> 上一版：2026-10-26 21:00（**商用级优化第一轮 = 接收端**：新增 `02_docs/29` 方案；**发现并修复 Python 3.13 `_handle` 遮蔽坑（不改就是 8h/168h 空报告）**；补跨平台介质检查 + `HOST_CLK_SKEW`；交付包 v2。见 §8.2 #40）
> 上一版：2026-10-26（**第三轮结构整理 = 物理层清理**：删 `.pio` 76 MB / 399 文件、清 `tmp` 59→4.8 MB、两套未打样 PCB 归档、`03_logs` B 类 25 日志清理、根 `README` 压到约 100 行改为纯导航，见 §8.2 #39）
> 上一版：2026-10-21（168h 长跑前的代码加固 + 洞洞板施工文档，见 §8.2 #33；施工见 `05_hardware/洞洞板固化操作卡` v1.3，验收见 `02_docs/24`，结构总览见 `02_docs/23`）
> **文档铁律已于 2026-10-06 改版 → 见 §2b**（旧版"某些文件绝对不许改"已废除）。

---

## 0. 30 秒上手（**新来的智能体 / 协作者：先看这一段**）

**项目在做什么**：用 ~50 元的 ESP32-C3 SuperMini + MAX13487 把 `STB3-125` 用电数据（RS-485 / Modbus RTU）采下来，经 UDP 送到电脑入库。

> **⚠️ 2026-10-21 用户重新定调（覆盖"替代树莓派"的旧表述）**：项目核心**不是省钱替代**，而是**把 ESP32-C3 + MAX13487 焊到洞洞板上、稳定收发真机数据、做到"完整"**。"替树莓派"只是立项由头。
> **目标级别 = L1 实验室样机**（2026-10-22 定）：单台稳定采集 + 结果可复现 + 故障可定位；**明确不做**隔离 / 打样 PCB / EMC 认证 / 批量一致性。级别定义与"不做"的理由见 `02_docs/26_级别声明与范围边界.md`。后续只补外壳。

**现在到哪了（2026-10-15 快照）**

| 状态 | 内容 |
| --- | --- |
| ✅ 已完成 | **M0–M6 全部通过**。M5 真机 **59/60**；批次 1 真机 300s **403/403 = 100%**；批次 2 一帧读全 **384 轮 100%**（E-02 结案 = 情况 A）；批次 3 真机回归 **100%**；批次 3.5 LED 现场验证；**M6 压测 900s `poll_ok=975/poll_err=0` = 100%**（判据线 97%，老师基线 96.9%） |
| ✅ 工具链 | **PlatformIO 迁移完成**（`pioarduino@55.03.311`，两工具链真机对照 100%，commit `28945a8`）⇒ 正式编译链 = PlatformIO，`arduino-cli` 降为对照 |
| 🚧 正在做 | **M7 交付方案**：`02_docs/21_需求规格说明书.md` + `02_docs/22_实现与交付方案.md` 已落盘（2026-10-15），**待 Claude/Codex 独立复核**（`04_ai_prompts/08`） |
| ⬜ 接着做 | **168h 长跑的前置**（不做必失败）：① **7 天供电**（现在靠充电宝，撑不过 1 天）② **PC IP 固定**（历史已漂移 4 次：.117→.118→.114→.113→.121）③ **端口独占**（长跑时禁开 NetAssist）→ `udp_collect.py` → 8h 加密对比 → 168h 长跑 → M7 结项 |
| ⚠️ 已知缺口 | 安全 4 口子未收紧（AP 常开 / `/` 免鉴权 / `/status` 免鉴权 / UDP 明文）；**无看门狗**；**无补传队列**（`queue`/`dropped` 是占位）；`RXO` 空闲电平万用表实测仍 `[待确认]` |

**必读顺序**：① 本文件 → ② `04_ai_prompts/00_context.md`（背景与口径，**唯一事实来源**）→ ③ `02_docs/16` §9 / §10（推进计划与功能对齐分批）→ ④ 动代码前读 `01_firmware/esp32c3_gateway/README.md`（工程内说明）。

**动手前必看**：§2b 文档铁律（**改完必须留痕**）｜ §7 硬件安全红线（**真机带电时 ESP32 的 USB 必须拔掉**；STB3-125 **只读不写**）。

**工具链提醒**：**编译 / 烧录走 Arduino 工具链**（`arduino-cli`），`01_firmware/pio_verify/` 的 PlatformIO **只编译、不烧录** —— 见 §5b。

**要把任务交给另一个智能体？** 直接把 **`04_ai_prompts/05_新智能体接手指令_2026-10-06.md`**（`====` 之间整段）复制给它即可 —— 里面已含目标 / 思路 / 现状 / 下一步 / 红线 / 角色要求。

---

## 1. 项目一句话

ESP32-C3 SuperMini（HW-466AB）+ MAX13487 模块 **替换树莓派网关**（500-800 元 → 约 50 元）。
链路：`STB3-125（QI 用电采集，RS-485/Modbus RTU）` → `ESP32 轮询 + 打时间戳 + UDP 上报` → `电脑`。

## 2. 角色分工（**别越界**）

| 角色 | 职责 |
| --- | --- |
| 用户 | 接线 / 烧录 / 看现象 / 给日志；维护 `00_context.md` |
| 总控 AI | 拆任务 / 写提示词 / 审代码 / 排障 |
| **Codex** | **写代码 / 编译 + 可改「事实类」文档**（能改哪类见 §6 第 7 条）；**决策类内容要改必须留痕** |
| **WorkBuddy** | 查资料 / 写文档 / 整理 PC 侧测试工具；**也可以写 ESP32 业务代码**（2026-10-06 用户授权）⇒ 一律交另一角色**独立复核**，**不自审自改** |

> ⚠️ **`04_ai_prompts/00_context.md`（唯一事实来源）—— 可以改，但按最严档来**（§2b 第 4 条）：
> **只做定点修正**（改过期 / 错误的部分）+ **逐处行内留痕** + **同时在 §8 挂条**。
> **禁止整段重写、禁止删除他人的历史留痕** —— 那才是"取消权威性"。

## 2b. 铁律（**2026-10-06 修订版**）

> **修订理由**：旧铁律是"**某些文件绝对不许改**"（`00_context.md` / `README.md` / `01_firmware/`）。
> 实际执行下来，每次改都要用户单独授权 ⇒ **规则变成了流程税**，而且挡住的全是"文档该更新却没更新"。
> ⇒ 改用 **分层 + 留痕** 模型：**能不能改**取决于**内容类型**；**改完必须留下痕迹**。

| # | 铁律 | 说明 |
| --- | --- | --- |
| 1 | **动手前先读 `00_context.md`**（唯一事实来源） | 不变 |
| 2 | **改文档都可以，但必须留痕** | ① 有变更记录表的 → 加一行；② 没有的 → **文件头**加 `> 最后更新：<日期> <作者> <一句话>`；③ 若属**决策类**内容 → **同时在 `PROGRESS.md` §8 挂一条** |
| 3 | **分「事实类 / 决策类」** | **事实类**（参数值、接口、注释、排障记录、帧表、字段字典）→ **直接改**；<br>**决策类**（阶段口径 / 安全红线 / 验收判据 / 角色分工 / 接口契约 / 版本里程碑）→ **可改，但必须留痕 + 挂 §8**。<br>⇒ **取代**旧的"不改 `00_context.md` / `README.md` / `01_firmware/`" |
| 4 | **`04_ai_prompts/00_context.md` = 唯一事实来源，允许改、但走最严档** | **定点修正**（只改过期 / 错误部分，**不重写**）＋ **逐处行内留痕** ＋ **同时在 §8 挂条**。**禁止删改他人的历史留痕**。<br>⇒ **不再需要"先问再改"** —— 旧铁律的流程税就卡在这里。 |
| 5 | **不确定的一律标 `[待确认]`**，禁止发明协议 / 寄存器 / 口径 | 不变 |
| 6 | **不要与另一个智能体同时改同一个文件**；提交**只 add 自己负责的文件** | `git add -A` 会吞掉别人的在途改动（2026-10-04 已踩）。**每次提交前先看 `git status`** |
| 7 | **临时产物写 `.workbuddy/tmp/` 或 `03_logs/`**，不要落在仓库根目录 | `03_logs/` 与 `.workbuddy/` 不入库 |
| 8 | **提交信息格式 `阶段N: 简述`**（当前 = **阶段3**） | 不变 |
| 9 | **角色分工 = 「作者 ≠ 验证者」（2026-10-06 用户授权放宽）** | 分工不再是"谁不许做"，而是**流程要求**：**谁写的改动，由另一个角色复核后再烧录 / 定案**。<br>⚠️ **WorkBuddy 现在可以正常写 ESP32 业务代码**（原"默认不写"已废止）；唯一硬约束 = **不得自审自改**。（来源：用户 2026-10-06 决策 D1，见 §8.2） |
| 10 | **驱动别的 AI（如 `codex exec`）须有用户 / 总控的明确指令** | 不得**自主发起**。2026-10-05 踩过：WorkBuddy 擅自跑了一次 `codex exec`，被当场纠正 |
| 11 | **硬件安全红线独立于本表**（见 §7），**任何情况不得为进度让步** | 真机带电不插 USB；只读不写；没有万用表 / 验电笔不开箱 |

## 3. 关卡进度

| 关卡 | 状态 |
| --- | --- |
| M0（任务书冻结）、M1、M2、M3、M4 | ✅ 全部通过 |
| **M5 接入 QI 真机** | ✅ **主干通过（2026-10-05 实测）** —— 真机三段读取 **59/60**、78 字节真实数据；WiFi/NTP/UDP 上行 **36/36**；数据自洽（合闸 / A 相 222 V / 49.9 Hz / 24 ℃）。✅ **结项记录已补**（`02_docs/08`，2026-10-06 砚青）。 |
| **M6 系统集成与压测** | ✅ **已收官（2026-10-08）** —— 900s 连续采样 `poll_ok=975/poll_err=0` = **100%**（判据线 97%，老师基线 96.9%）；HB 900 / DATA 882 / ERR 0；UDP 丢 2/1800（99.9%）〔**2026-10-21 更正**：原始数据为 seq 145–1945 应有 **1801** 行、实收 **1782** 行，**缺 19 行 = 18 条数据行 + 1 条心跳** ⇒ 数据行送达 **882/900 = 98.0%**（"丢 2"与"99.9%"两处都不成立）。详见 §8.2 #33〕；`free_heap` 179KB 稳定。详见 §8.2 #26 |
| M7 验收结项 | 🚧 **进行中** —— 交付方案已落盘（`02_docs/21` + `02_docs/22`，2026-10-15）；待 **168h 长跑数据** + 安全整改 + 补齐 `09_成本对比` / `10_验收结项` / `06_tests/压力测试报告.md` |

## 4. 现在正在做 / 接着要做

**功能对齐 —— 对齐老师的参考实现**（老师已跑通一版）。**分三批，不要一次全做**（详见 `02_docs/16` §10）：

| 批次 | 内容 | 状态 |
| --- | --- | --- |
| **1** | JSON 上行（数据行 + 心跳行 + **失败行 `type:"err"`**）+ `dev=ESP485-<MAC后6位>` 命名 + 累计计数器 `poll_ok/poll_err/udp_tx` + **三项补项**（`QI_PHASE_TEMP_ABSENT` / `QI_UDP_PAYLOAD_MAX 1200` / `QI_SEND_ERR_ROW`） | ✅ **已完成（2026-10-07）** —— 真机 300s：555 包 = 290 hb + 265 data + 0 err，`poll_ok=403/poll_err=0` = **100%**；39 字段 + 电量公式真机实证；commit `1334527`。指令：**`04_ai_prompts/04_Codex提示词_功能对齐_JSON上报与统计.md`** |
| **2** | 一帧读全 39 为默认 + 失败自动降级 3 段（顺带给出 E-02 答案） | ✅ **已完成（2026-10-07）** —— 真机一帧读全 **384 轮 100%**，E-02 结案 = 情况 A，commit `de51f59` |
| **3** | AP 回退 + Web 配置页 + `/status` + NVS 闪存持久化 | ✅ **已完成（2026-10-08）** —— 真机回归 100%，commit `1a8142f` + `b5b72cc` |
| **3.5** | LED 状态灯（GPIO8 低电平；WiFi 断慢闪 / 成功短闪 / 失败长闪） | ✅ **已完成（2026-10-08）** —— 现场验证通过，commit `49c5c63` |

> **批次 1 的两条遗留提醒**（写代码 / 写解析的人注意）：① 每轮现在**恒发 2 行**（`hb + err` 或 `hb + data`）⇒ `seq` 每轮 **+2**；
> ② **数据行的 `seg` 是"读取模式"（`"3"`），err 行的 `seg` 是"失败段"（`"S2"`）—— 落库 / `udp_listen.py` 解析时不得当同一字段**。

**除功能对齐外，还剩：**

- ~~② `02_docs/08_M5真机联调记录.md`（M5 结项记录）~~ ✅ **已交付（2026-10-06）**
- ⑥ 安全整改（改自家固件即可，不求人）：AP 超时关闭 / 一机一密 / 配置页与 `/status` 鉴权
- ⑦ 自研配网模块（拿不到老师源码，自己做）

## 5. 最近的重要产出（2026-10-04 ~ 10-06）

| 类别 | 文件 |
| --- | --- |
| 设计文档 | `02_docs/16_数据落地与商业化设计.md`（**§9 推进计划 / §10 功能对齐**）、`02_docs/17_参考实现逆向笔记_2026-10-05.md` |
| **字段字典（唯一事实来源）** | **`05_hardware/STB3-125_字段字典.csv`**（39 行；固件解析 / 解析工具 / 建表 DDL 共用） |
| 施工指令 | `04_ai_prompts/03_...M5功能码与3段读取.md`（**已完成**）、`04_ai_prompts/04_...功能对齐_JSON上报与统计.md`（**进行中**） |
| PC 侧工具（`06_tests/`） | `m5_slave_04.py`（台面预演从站）、`m5_parse.py`（39 字段解析）、`fw_strings.py`（固件逆向）、`pio_cn_seed.py`（PlatformIO 国内离线引导）、`db_proto.py` + `db_schema.sql`（落库原型） |
| 操作卡 | `06_tests/M5_真机联调操作卡.md`（v1.5，含 §0b 台面预演 / §0c 无串口现场单） |
| **批次 1 固件改动（未 commit）** | `01_firmware/esp32c3_gateway/config.h` + `esp32c3_gateway.ino`：JSON 上行（数据 / 心跳 / err 三类行）+ `dev=ESP485-<MAC后6位>` + 计数器 + 三项补项（`QI_PHASE_TEMP_ABSENT` / `QI_UDP_PAYLOAD_MAX 1200` / `QI_SEND_ERR_ROW`）——**待真机通过后 commit** |
| 证据 | `03_logs/M5真机首测_20261005_2035.log`（真机 59 包）、`03_logs/老师固件_*`（逆向产物） |

## 5b. 工具链：编译 / 烧录走哪条链（**别搞错**）

| 用途 | 用哪条链 | 说明 |
| --- | --- | --- |
| **编译 + 烧录（正式）** | **Arduino 工具链** —— `arduino-cli`（Arduino IDE 2.3.10 自带） | 在 Arduino IDE 图形界面点"上传"等效 |
| **只编译、不烧录** | **PlatformIO**（`01_firmware/pio_verify/`） | 只是"平行对照组"，**不参与烧录** |

**`arduino-cli` 路径**
`F:\Users\17352\AppData\Local\Programs\Arduino IDE\resources\app\lib\backend\resources\arduino-cli.exe`

```
compile --fqbn esp32:esp32:esp32c3:CDCOnBoot=cdc 01_firmware/esp32c3_gateway
# 烧录：同一条命令末尾加  --upload -p COM5
```

- **`CDCOnBoot=cdc` 不能漏** —— 即 Tools 里的 "USB CDC On Boot = Enabled"；漏了 `Serial` 会去占 GPIO20/21，与 UART1 打架。
- 用的是 **arduino-esp32 3.3.10-cn**（在 `Arduino15`）+ `esp-rv32` 工具链。
- 烧前**关掉 Arduino IDE 的串口监视器**（进程 `serial-monitor` 占着 COM 口，否则报 `PermissionError(13)`）。

### 🔴 为什么 PlatformIO 现在**不能**烧

它用 `espressif32@7.1.3` → **arduino-esp32 2.0.17**，而板子在跑 **3.3.10** ⇒ 实测**产物不等价**
（Flash −23.4%、RAM +4.7%）。**拿它烧 = 给板子换 core，而新 core 的运行行为一次都没验过。**
⇒ 详见 `02_docs/16` §9.5.4。

### 🔴 烧录时的两条硬规矩

1. **真机带电 ⇒ ESP32 的 USB 必须拔掉**（要烧录就先给真机断电，或把 A/B 从面包板拔掉 —— **拔面包板侧不用碰配电箱**）。
2. 烧完**拔 USB**、改**充电宝**供电，再合闸跑数据。

### 迁 PlatformIO 的时机与门槛

项目已登记的决策：导师要求组内迁 **VSCode + PlatformIO + Claude Code**，裁定「**推迟到 M5 真机数据稳定之后、M6 压测之前**」。

**建议门槛（三条都满足才迁）：**

| # | 门槛 |
| --- | --- |
| ① | 功能对齐**批次 1、2 完成**且**真机验证通过** |
| ② | 有一次 **≥10 分钟**真机连续采样、成功率 **≥97%** |
| ③ | **先决定 core**：跟 PlatformIO 默认（2.0.17，与老师一致）还是显式钉 3.x ⇒ **这决定要不要重验全部行为** |

⇒ **迁移后必须重跑**：一次台面（合成数据）+ 一次真机。
⇒ ⚠️ **现在别迁**：会把"功能对齐"和"换 core"两个变量混在一起，出问题分不清是谁引起的。
⇒ 📌 **别为了迁移而迁移**：`arduino-cli` 已经能满足"命令行 + 可复现 + 能烧"；迁 PlatformIO 的主要理由是**导师要求的组内工具链统一**。

> 🔧【2026-10-06 校准 · 砚青】导师已明确**组内必须用 PlatformIO**（不是可选偏好）⇒ 迁移是**硬交付约束，必须做**。
> 因此**撤回**此前"把 M6 与 PlatformIO 解绑、M6 先用 arduino-cli 跑"的提法：**M6 是结项前的最终稳定性验证，其产物应当来自最终交付链** —— 在迁移之前跑，等于验一个随后会被替换掉的二进制。
> **正确动作 = 先打通迁移**。真阻塞只有两个：① **core 选择**（`2.0.17` 跟老师一致 vs 钉 `3.x` 少改行为）② **国内下载 / 离线安装**（⭐ 最快：老师打包 `.platformio` 的 `platforms/` + `packages/` 拷过来，0 下载）。**问题不是"要不要迁"。**
>
> ✅【2026-10-07 落地 · 砚青】**两个阻塞均已打通**：core 钉 **3.x**（`pioarduino@55.03.311` = Arduino 3.3.11/IDF 5.5.5，pioarduino 跳过 3.3.10 故取最近邻）；国内安装走 `06_tests/pio_cn_seed.py` v2.0（双通道规则 A/B）。**首次真实编译 `[SUCCESS]`**（RAM 39 384 B = 基线 +100 B；Flash 1 019 703 B = 基线 +1.5%；日志 `03_logs/pio3_m.log`）。`pio_verify` 仍**只编译不烧录**。6 个环境坑与复机 playbook 见 `02_docs/20` §8.4。**剩余前置 = 迁移后对照验证**（台面 + 真机各一次，`02_docs/19` §3.2）。

---

## 6. 协作纪律（**都是踩过的坑**）

1. **提交只 add 自己的文件** —— 多智能体在同一仓库工作，`git add -A` 会**吞掉别人的在途改动**（2026-10-04 已实际踩到）。
2. ~~**改 `04_ai_prompts/00_context.md` / `README.md` / `01_firmware/` 业务代码**，需对应角色授权。~~
   **【2026-10-06 已被 §2b 取代】**：现在**按内容类型分层** —— 事实类直接改、决策类留痕 + 挂 §8；
   **`00_context.md` 不再是"禁改"，而是"最严档"**（定点 + 逐处留痕 + 挂 §8，见 §2b 第 4 条）；
   **唯一的硬规矩只剩"改完必须留痕"**。
3. **临时 / 探针产物写 `.workbuddy/tmp/` 或 `03_logs/`**，**不要落在仓库根目录**。
4. `.workbuddy/` 与 `03_logs/` **不入库**（已在 `.gitignore`）。
5. 提交信息格式：**`阶段N: 简述`**（当前阶段 = **阶段3**）。
6. **不要自行调用其他 AI**（WorkBuddy 曾误跑 `codex exec` 被纠正）—— 提示词放 `04_ai_prompts/`，由用户 / 总控转交。
7. **【2026-10-06 新规】Codex 也可以改文档**，但要分清两类：
   - **事实类**（与你的代码改动直接相关）：README 的参数与接口、操作卡里的帧清单/判据、字段字典、代码注释 ⇒ **可以直接改**。
   - **决策类**（阶段口径 / 安全红线 / 验收判据 / 角色分工 / 接口契约）⇒ **可以改，但必须留痕**，不许静默改。
8. **改任何文档都必须更新该文档自己的「变更记录」行**（谁 / 何时 / 为什么）。没有变更记录行的文档，就在文件头加一行 `> 最后更新：<日期> <作者> <一句话>`。
9. **改「决策类」内容时，同时在 `PROGRESS.md` §8「待同步 / 待确认」里挂一条** —— 让漂移**可见**。
10. **别和另一个智能体同时改同一个文件**：先看 `git status`。提交纪律见第 1 条。

## 7. 硬件与现场安全（**最高优先级**）

- QI 真机装在**带电配电箱**内（`GOOWANT PZ30`），**疑似三相 380V**（铭牌 `400V~` + 协议含 A/B/C 三相寄存器）。
- 🔴 **真机带电期间，ESP32 的 USB 数据线必须拔掉** —— 否则电脑与配电箱经 USB 地 + 485 共模构成接地回路，**烧电脑主板**。真机运行时用**充电宝**供电。
- 🔴 **开箱接线前必须断电 + 验电**（"断电 ≠ 无电"）；**没有万用表 / 验电笔不许开箱**；首选请老师或电工断电接线。
- **STB3-125 只读不写**：合闸 / 分闸 / 锁扣 / 解锁 / 复位 / 写寄存器 / 广播 **一律禁止执行**。
- 完整安全协议与**停手条件**：`06_tests/M5_真机联调操作卡.md` §1。

## 8. 待同步 / 待确认

### 8.1 仍待处理（需要人 / 总控 / 后续批次）

| # | 项 | 说明 |
| --- | --- | --- |
| 1 | **电量公式存疑** | `(H*65536)/1000 + L` 与「32 位累加器 /1000」两解，对同一组真机数据**差 1000 倍**（59093.144 度 vs 320.975 度）。暂按文档公式；详见 `06_tests/db_proto.py` 文件头 |
| 2 | `record1/2/3` 半字节解码 | 已由老师的独立实现佐证（**`%04X` 十六进制字符串**），但 `0` 与 `F` 的区别**待确认** |
| 3 | ✅ **温度量程口径（已闭环 2026-10-06）** | 定案：字段字典的 `raw_min/raw_max` 列**存的是"换算后工程量范围"**（temp = −40…160 ℃、frequency = 0…100 Hz）——不是原始寄存器值。故 `db_proto.py` **不得对 `raw-40` 字段二次减 40**。**已修**（`db_proto.py:127` 改为统一按工程量比较），与固件口径一致。 |
| 4 | **PlatformIO 的 core 选型** | **建议 = `3.x`**（完整论证 + 落地方式见 **`02_docs/19_PlatformIO_core选型决策_2026-10-06.md`**）：① 现板基线**就是 3.x**，选 `2.0.17` 等于作废 M0–M5；② `2.0.17` 已 **EOL、无安全补丁**（商业化不可接受）；③ **本固件不碰任何 3.x 破坏性 API**（已实测审计）；④ 批次 3 的 Web 配置页在 `2.0.17` 上缺 `Network.h` 走不通。**待用户 / 老师拍板**；✅ **已核实**：`3.3.10-cn` ↔ 官方 `3.3.10`（同版本不同镜像渠道）；**迁移的国内镜像/离线安装方案见 `02_docs/20_工具链国内镜像与离线安装_2026-10-06.md`**（包清单 + 逐包实测通道） |
| 5 | **数据行 / err 行的 `seg` 语义双关** | 数据行 `"seg":"3"` = **读取模式**；err 行 `"seg":"S2"` = **失败段** ⇒ 落库 / `udp_listen.py` 解析必须**显式区分**，不得当同一字段 |
| 6 | **`quality` 编码对齐** | 老师新版固件有 `quality:"00"`，**含义未知 ⇒ 须向老师确认**；确认前**不得自造第二套**（两块板固件版本还不一致，见 `02_docs/17`） |
| 7 | ✅ **`02_docs/08_M5真机联调记录.md`（已补 2026-10-06）** | M5 结项记录已交付，含真机 59/60 证据摘要与遗留项 |

### 8.2 本轮（2026-10-06）决策类改动留痕（按 §2b 第 3 / 4 条挂条）

| # | 改动 | 落点 |
| --- | --- | --- |
| 1 | **文档铁律改版**：废除"某些文件绝对不许改" ⇒ 分层（事实类 / 决策类）+ 强制留痕；`00_context.md` 由"禁改"改为**最严档**（定点 + 逐处留痕 + 挂 §8） | 本文件 §2 / §2b / §6；`04_ai_prompts/00_context.md` 一、角色分工 |
| 2 | **Codex 可改文档**（事实类直接改；决策类留痕 + 挂本节） | 本文件 §2 / §6 第 7 条；`00_context.md` 一；任务书 §3 |
| 3 | **任务书升版 `v0.3.9` → `v0.4.0`**：M5 结项 + IP `.118`→`.113` + §12 协作规范改版 + §11.1 逐字重同步（含 Q-04/Q-09/Q-10/Q-13、§11.2 第 6/7 条） | `02_docs/01_项目任务书.md`（§13 已有 v0.4.0 行） |
| 4 | **`06_QI协议说明.md` 文档状态**：待真机验证 → ✅ **已真机验证**；E-02 范围收窄到批次 2 | `02_docs/06_QI协议说明.md`（v1.2） |
| 5 | **根 `README.md` / 固件 `README.md`**：文首「当前状态」块随 M5 + 批次 1 刷新（含编译基线 `1004899`/`39284`） | `README.md` 文首块 / §4；`01_firmware/esp32c3_gateway/README.md` |
| 6 | **`02_docs/16` 新增 §10.5**（批次 1 三项补项已交付并独立复核） | `02_docs/16`（v1.10） |
| 7 | **两份已执行指令补 IP 勘误注**：`04_ai_prompts/02` / `03` 正文里的 `192.168.1.114` **已被 `.113` 取代**（`config.h` 现值 = `.113`）⇒ 各加一行勘误，**原文保留不改历史** | `04_ai_prompts/02_...md` / `03_...md` |
| 8 | **新增接手指令**：`04_ai_prompts/05_新智能体接手指令_2026-10-06.md`（`====` 区间整段可复制给任意智能体；含目标 / 思路 / 现状 / 下一步 / 红线 / 角色要求） | `04_ai_prompts/05_...md`；本文件 §0 已加入口 |
| 9 | **D1（用户授权）**：**WorkBuddy 可写 ESP32 业务代码**，唯一硬约束改为"**不得自审自改**"；原"默认不写"废止 | 本文件 §2 / §2b 第 9 条；`00_context.md` 一（C-8） |
| 10 | **D2（用户授权）**：允许一次"事实源轻量重构 + 过期事实清扫" ⇒ **已执行**：`README.md` §6.1 去重校准（两段矛盾 EN 合成一条）、`00_context.md` 过期表述清除 + 变更记录归置（C-7）、温度量程口径统一 | `README.md` §6.1；`00_context.md` 三 / 七；`06_tests/db_proto.py` |
| 11 | **D3（用户裁定）**：**撤回**"解绑 M6 与 PlatformIO"提法 —— 导师要求组内用 PlatformIO，属硬交付约束 ⇒ 先打通迁移，再跑 M6 | 本文件 §5b |
| 12 | **新增 `02_docs/19`（PlatformIO core 选型决策备忘）**：建议钉 `3.x`（非 `2.0.17`），含 API 实测审计 + 官方支持/安全事实 + 自持措施 | `02_docs/19_...md`；本文件 §8.1-4 |
| 13 | **新增 `02_docs/20`（工具链国内镜像与离线安装）**：确认 `-cn` = Espressif 官方 CN 镜像渠道标记；归纳镜像通道**规则 A/B**；给出 PlatformIO 3.x 迁移的**完整包清单 + 逐包实测通道**（`github.com` 本机实测超时 = 根因） | `02_docs/20_...md`；`02_docs/11` C-02 闭环（v1.3） |
| 14 | **PlatformIO 3.x 迁移编译打通（2026-10-07）**：`pio_cn_seed.py` v2.0（平台驱动 + 桩包解析 + 双通道）；平台切到 `pioarduino@55.03.311`（Arduino 3.3.11/IDF 5.5.5）；**首编 SUCCESS**（RAM +100 B / Flash +1.5% vs Arduino 基线）；`platformio.ini` 改 `lib_ldf_mode = deep`（禁 `+`，issue #9782）+ `main.cpp` 加 WiFi 锚点；6 个环境坑 playbook 入档 | `06_tests/pio_cn_seed.py`；`01_firmware/pio_verify/{platformio.ini,src/main.cpp}`；`02_docs/20` §8（v1.1）；本文件 §5b |
| 15 | **批次 1 真机前置验证 + USB CDC 阻塞 bug 修复（2026-10-07，砚青）**：485 悬空安全态烧录（基线一致 1004899/39284）+ 上行验证通过（hb/err JSON、NTP ts_ok、WiFi/UDP 通）。🔴 **发现并修一个真 bug**：无主机读串口时 `HWCDC::write` 默认 `tx_timeout_ms=100` 阻塞 ⇒ 轮询退化 19s/轮（真机拔 USB 必踩）；**修复 = `Serial.setTxTimeoutMs(0)` 一行**，验证恢复 1s/轮（60s/118 包）。⚠️ **该行改动待 Codex/用户独立复核**；数据行（39 字段 + raw 78 字节）待接真机验证后再 commit | `01_firmware/esp32c3_gateway/esp32c3_gateway.ino`（setup 处）；`03_logs/batch1_*_20261007.log` |
| 16 | **批次 1 真机验证通过（2026-10-07）**：合闸采样 300s，555 包 = 290 hb + 265 data + **0 err**，`poll_ok=403/poll_err=0` = **100%**（老师基线 96.9%）；39 字段 + 换算全对（A 相 222V/0.16A/49.9Hz/18W、N 温 28℃、`openState 00F0` 合闸）；**电量公式 `(H×65536)/1000+L` 真机实证**（A_H=4 + 0xE60F=58895 → 59157.144 ✓）；USB CDC 修复真机侧生效（每秒一轮） | `03_logs/batch1_real_20261007.log`；本文件 §8.1 电量待确认项推进 |
| 17 | **批次 1 收尾 + 批次 2 启动（2026-10-07）**：用户复核 `setTxTimeoutMs(0)` 通过 ⇒ **批次 1 commit `1334527`**（config.h + .ino + PROGRESS.md）。批次 2 提示词产出 `04_ai_prompts/06`（运行时自适应：启动试一帧读全 `00 27`，从未成功且连续 3 轮失败自动降级 3 段、本会话不回切；心跳行加 `mode`；数据行 seg 值域扩展 "1"/"3"，err 行 "F"/"S1~S3"）；配套 `db_proto.py` seg_ok 适配（"1"/"111"）已改并 `--demo` 验证通过 | `04_ai_prompts/06_Codex提示词_批次2_一帧读全与自动降级.md`；`06_tests/db_proto.py`；真机跑一次同时收敛 E-02（A: seg="1" 成立 / B: 降级后 seg="3" 成立） |
| 18 | **批次 2 Codex 交付 + 独立复核通过 + 悬空态降级验证（2026-10-07）**：我逐项核对 diff 全符合提示词，**编译独立复现一致**（0 err/0 warn，Flash `1005739`/RAM `39292`，+804B/+8B）；复核中发现并修工程内 README 两处过期宏引用。悬空态烧录验证：降级后 `mode:"3seg"` + `seg:"S1"` + 3 段 37/37/19 + 每秒一轮，与批次 1 行为一致 ✅。⭐ 认知修正：打开 COM5 **不复位** ESP32（3.x USB CDC），旧记录作废 | `esp32c3_gateway.{ino,README.md}`；`03_logs/batch2_*.log`；剩：真机正式跑收敛 E-02 → 回写文档（含 seg "0"→"1"）→ commit |
| 19 | **批次 2 真机验证 + E-02 结案（2026-10-07）**：真机插好（USB 已拔充电宝供电、断电接线确认）→ **一帧读全 `00 27` 384 轮 100%**（poll_err=0），289 心跳全 `mode:"full"` **从未降级**；39 寄存器逐项对照 raw 全对（`reg8=0x00DD→221V`、`reg14/15→59167.144度`与 JSON 一位不差）。**E-02 判定 = 情况 A 成立**：原文"上限 16"对 0x04 不成立。文档回写：`06_QI` §7/§3.1/头部状态、`Errata` §4"明确"+汇总表、`04_ai_prompts/04` 加勘误注（seg "0"→"1"） | `03_logs/batch2_real_20261007.log`；`02_docs/06_QI协议说明.md`；`05_hardware/STB3-125_Errata.md`；`04_ai_prompts/04` |
| 20 | **批次 3 提示词产出（2026-10-07）**：`04_ai_prompts/07`（常驻 AP + Web 配置页 4 卡片 + `/status` 22+3 项 + NVS）。关键裁定：路由/字段名**照老师版**（`/save`、`/reset`、22 项逐字对齐 = 生态兼容）；Basic Auth 只保写操作（`/status` 免鉴权照老师现状，口子记录 M7 收紧）；AP SSID=`ESP485-<MAC后6位>`、密码 NVS+MAC 派生默认；UDP 目标/采集周期/NTP 主源编译期宏 → 运行时变量（NVS 可覆盖，保存立即生效）；心跳**不加**老师 `cfg` 字段（含义未确认，进问老师清单）。不做：OTA/captive portal/`esp485_config.py` | `04_ai_prompts/07_Codex提示词_批次3_AP与Web配置与NVS.md`；待转交 Codex → 复核 → 台面/AP 验证 → 真机 |
| 21 | **批次 3 Codex 交付 + 独立复核 + 台面验证 9/9（2026-10-08）**：我逐行核对（web_config.h 480 行 + .ino/config.h diff），十项裁定全落实，**编译独立复现一致**（0/0，Flash `1070427`(+63.2KiB)/RAM `49340`(+9.8KiB)）。台面 9 项全过：/status 25 项无密码字段、页面 200、/save 无鉴权 401、Basic Auth 200、**改 UDP 目标立即生效（实战：电脑 IP .113→.121 漂移，Web 改一下就好，不用重烧）**、period=2s 真实生效、空密码保持、**NVS 掉电保持**、/reset 恢复出厂。485 轮询回归全程正常。复核发现 4 条已记录（最重要：配置页回显 AP 口令 = 已知口子 M7 收紧） | `01_firmware/esp32c3_gateway/{config.h,esp32c3_gateway.ino,web_config.h}`；`.workbuddy/tmp/b3_*.log`；剩：真机回归（与 M6 前置对照验证合并） |
| 22 | **批次 3 真机回归 100% + 批次 3 正式闭环（2026-10-08）**：合闸采样 300s = HB 301 + DATA 300 + **ERR 0**；`mode="full"`/`seg:"1"`/`poll_ok=590/poll_err=0`=100%；**1s 节拍 = NVS period 生效**；UDP 目标 = **Web 配置的 `.121`**（非烧录的 .113）⇒ NVS 配置真机场景工作正常。设备留现场运行（.121:8888 / 1s / full） | `.workbuddy/tmp/b3real_rows.json`；本文件 §0 |
| 23 | **批次 3.5 LED 状态灯（2026-10-08，commit `49c5c63`）**：板载蓝灯 GPIO8 低电平（批次差异用 `LED_ACTIVE_LOW` 宏切）；WiFi 断=慢闪 / 采集成功=每轮短闪 30ms / 失败=长闪 200ms；全 millis() 非阻塞。现场验证通过。对标老师固件 `[LED` | `config.h` LED_* 宏；`.ino` ledPulse/ledTick |
| 24 | **M6 前置·迁移对照验证：pio 编译打通 + 台面对照 8/8 一致（2026-10-08）**：pio 编译最新源码（批次 3/3.5）SUCCESS 192s；突破 4 环境障碍（penv 依赖被 uv 拆坏、esptool==5.4.0 sdist 缺陷、tool-scons 版本漂移+死代理、pioarduino Core 的 enable_telemetry KeyError；safe-delete 挂死用 `CODEBUDDY_SAFE_DELETE_ENABLED=0`）。烧 factory.bin 后**悬空对照 8/8 与 Arduino 产物一致**（/status 25 项、Web、401、改目标立即生效、1s 节拍、3seg 降级）。⚠️ 发现：**烧 pio factory.bin 清 NVS 配置**（烧后需 Web 重配） | `pio_verify/src/main.cpp`（+2 LDF 锚点）；`03_logs`→`.workbuddy/tmp/pio_b3.log`；**剩：真机对照**（与 Arduino 产物 12:20 数据逐字段比，待断电窗口）→ 迁移收官 |
| 25 | **M6 前置收官：迁移真机对照 100%（2026-10-08 晚，commit `28945a8`）**：pio 产物真机 300s = HB 301/DATA 296/ERR 0，`poll_ok=385/poll_err=0`=100%，39 字段与 Arduino 产物同源同值（A_voltage=221、frequent=50.0、openState=00F0 合闸），1s 节拍，P0-1 零误伤 ⇒ **两工具链真机行为等价，PlatformIO 迁移正式完成**（正式编译链 = pioarduino 55.03.311，arduino-cli 降为对照） | `.workbuddy/tmp/{pio_real_rows,b3real_rows}.json`；本文件 §0 |
| 26 | **M6 压测通过（2026-10-08 晚，commit 本行）**：900s/15min 连续采样 **poll_ok=975/poll_err=0 = 100%**（线 97%，老师基线 96.9%）；HB 900（1s 节拍零漂移，seq 连续）+ DATA 882（无一次 LEN 失败，P0-1 零误伤）+ ERR 0；UDP 丢 2/1800（99.9%）〔**2026-10-21 更正见 §8.2 #33**：实为缺 19 行 / 数据行 98.0%〕；free_heap 179KB 稳定。**M6 正式收官** | `.workbuddy/tmp/m6_stress_rows.json`（全量 1782 行） |
| 27 | **P0-1 短帧防护（2026-10-08，commit `b7f5942`）**：用户转交 Claude 完善——parseResponse (5b) `byteCount+5 == 本段期望响应长`（83/37/37/19 自动成立），堵住"从站短帧 → (5) 自洽判定放行 → g_merged 尾部残留旧值 → 静默掺假"。**砚青复核通过**（闭环正确/不写死常量/单点失败分支；Flash 1070975(+214B)）。⚠️ 流程教训：外部 AI 产物入库前必须主动报备 + 过复核 | `.ino` parseResponse (5b) |
| 28 | **P0-1 配套测试工具（Claude 产出 + 砚青复核，2026-10-08）**：`m5_slave_04.py --short N`（短响应对照从站：帧自洽但与请求不符，稳定复现短帧做 P0-1 靶子；文档注明 `--short 30` 触发降级 3 段是**预期行为**）+ README v1.9 判定口径表。语法/逻辑复核通过；**实测留待下次台面窗口**（需 ESP32+USB 转 485 背靠背） | `06_tests/m5_slave_04.py`；`06_tests/README.md` v1.9 |
| 25 | **批次 3.5 复核发现 = P0-2 来源（2026-10-08，编号已顺延）**：批次 3.5 当轮漏挂 §8，我按 §2b 第 2 条补记时**顺带查出注释缺陷**：`.ino:229` 注释称"WiFi 断开时**不计数不脉冲**"，与代码矛盾（`:790` 计数与链路无关、`:1185` 脉冲无条件执行）⇒ 属**注释写错**。用户裁定 **P0-2 = 只改注释、不动 `ledPulse` 行为**（**未执行**，等 P0-1 验收后发指令）。⚠️ 本行原编号 23，与另一角色补入的 #23（批次 3.5 正式留痕）**撞号**，2026-10-08 按 §2b 顺延为 #25；"补留痕"这一目的已由 **#23** 完成，本行仅保留 P0-2 发现 | `.ino:229 / :790 / :1185`；本文件 §8.2 **#23**（批次 3.5 正式行） |
| 26 | **P0-1 帧长校验（2026-10-08 · 未 commit · 待独立复核）**：`parseResponse()` 新增 (5b)——帧长除"自洽"外还必须等于 `qiActiveRespLens()[g_segIndex]`（= 与本段**请求的寄存器数**一致，不新写死常量）。**行为变更（用户已知情并认可代价）**：从站回短帧由"静默掺假"（CRC/地址/功能码/(5) 全过 → 判成功 → `g_merged` 尾部保留**上一轮**残留、`quality` 可能仍 OK）改为 `recordSegFail("LEN")` → 该轮发 err 行、不发数据行（§4「错误的数据不要」）。编译 `1070761 → 1070975`（**+214 B**）/ RAM `49348` **不变**。**本工程 0 新增 warning**：`--warnings all` 下现出 7 条 `-Wformat-truncation`（`web_config.h:411~438` 的 `loadConfig` snprintf），经**未改的 HEAD 副本同条件对照**确认**同为 7 条同位置 = 批次 3 既存**，非本次引入（⇒ §8.2 第 21 行"0/0"仅成立于**默认 flags**，core 默认 `-w`；**该行原文不动**，只在此处记结论）。**前提记录（本轮不动）**：`g_merged` 全项目**无清零点**——只在 (7) 按段偏移 `memcpy`，这正是短帧能留下残留的必要条件 | `01_firmware/esp32c3_gateway/esp32c3_gateway.ino`（new (5b)，`+959~979`）；台面短响应从站 = **`06_tests/m5_slave_04.py --short N`**（2026-10-08 由临时脚本并入常驻，见 `06_tests/README.md` v1.9） |
| 27 | **P0-3 回环分支编译回归修复（2026-10-08）**：批次 3.5 引入的 `ledPulse(g_roundFailed ? …)` 落在 `#if !RS485_MODE_LOOPBACK_SELFTEST` 守卫**之外**，而 `g_roundFailed` 声明在守卫**之内** ⇒ `RS485_MODE_LOOPBACK_SELFTEST=1`（串口层自检 / GPIO20 通路回归分支）**自批次 3.5 起一直编不过**。**修法（用户批准）**：该行包进守卫，`#else` 恒 `ledPulse(LED_POLL_OK_MS)` —— 回环模式无"段/轮"语义 ⇒ 恒视为成功轮、恒短亮（顺带消掉该分支"`ledPulse` 定义未使用"警告）。**硬判据（用户指定）= SELFTEST=1 必须编译通过（0 error）**：**修前** HEAD 副本 ❌ `error: 'g_roundFailed' was not declared in this scope`（.ino:1185）→ **修后** ✅ 0 error（Flash 1062815 / RAM 49236）。正式工程 SELFTEST=0 编译 `1070975` / `49348` 与本表 #26 **完全一致 = Flash/RAM ±0**、**0 新增 warning**。⚠️ `config.h` 常量**未改动**（自 2026-10-04 起恒为 0），验证全程用临时副本 | `01_firmware/esp32c3_gateway/esp32c3_gateway.ino`（新 `+1206~1211`（注释）、`+1213~1215`（`#else`/`#endif`），原 `:1185` 那行保留于新 `:1212`）；临时副本 `.workbuddy/tmp/p0_1_loop{,_head}/`（不入库） |

| 29 | **M7 交付方案落盘 + M6 状态校准（2026-10-15，砚青）**：① 新增 `02_docs/21_需求规格说明书.md` —— 代码逆向基线：18 条 FR + 6 条 IF + 6 条 DR + 10 条 NFR + **13 条隐含需求** + **12 条三方差异清单** + 需求追溯矩阵 + 8 条缺口清单；② 新增 `02_docs/22_实现与交付方案.md` —— 168h 接收程序设计（3 线程 / 1MiB 收缓冲 / WAL / 6 张表 / 断点续收）、统计三口径 + 四计数器对账恒等式、明文 vs AES-128-GCM 对比实验、14 项补漏、168h 判据表；③ **状态校准（事实类）**：§0 / §3 / §4 由"M6 未开始"改为"M6 已收官、M7 进行中"，依据 §8.2 #26。**决策类裁定（本行留痕）**：ⓐ 168h 主判据 = **M2 端到端完整率 ≥96%**（用户 2026-10-15 裁定；由 `M2≈A×M1×D` 隐含要求 M1 ≥96.4%）；ⓑ **加密默认关闭 `enc_on=0`**（保老师接收端兼容，加密仅作可选开关 + 对比实验）；ⓒ 接收端 = 本机 Windows + SQLite；ⓓ 统计必须 **M1/M2/M3 三口径并列**，禁止只报一个数 | `02_docs/21_需求规格说明书.md`；`02_docs/22_实现与交付方案.md`；本文件 §0 / §3 / §4 |
| 30 | **发现 `00_context.md` 自相矛盾（2026-10-15，砚青，⚠️ 未修）**：L41 写"字符间隔 **4ms**"，但同文件 L52 与 `config.h:89` 均为 **8ms**；任务书 §6.1.2 写 **3–5ms** ⇒ **三方三个值**。**裁定 = 以代码 8ms 为准**（M5 起正式档位 4–8，真机验证通过）。`00_context.md` 属最严档，**本次未改动**，待用户确认后按"定点修正 + 逐处行内留痕 + 挂 §8"处理。详见 `02_docs/21` §9 D-01 | `02_docs/21_需求规格说明书.md` §9 D-01；`04_ai_prompts/00_context.md` L41（待修） |

| 31 | **项目结构整理（2026-10-17，砚青）**：删除 6 项零价值/可再生文件（`_enc_probe.txt`、`.codex_baseline_build.txt`、`__pycache__`、`.pio/build_2x.bak` 38MB、5 个失效 `.gitkeep`）；**归档** 2 项作废物（`usb485_loopback.py`、`M4_重测操作卡.md` → `06_tests/_archive/`，保留踩坑物证）；**更新 6 处过时状态**（根 `README.md` 与固件 README 的关卡/基线/工具链/IP/轮询模式）；**新增 4 份索引**（`05_hardware/README.md` 厘清 carrier vs pcb、`03_logs/README.md` 分级证据、`_archive/README.md`、`02_docs/23_项目结构说明.md`）。⚠️ **`00_context.md` §4.2 属最严档定点修正**：「字符间隔 4ms」→ **8ms**（与第五节及 `config.h` L89 冲突），已行内留痕 + 变更记录 C-10 + 本行。**未删任何 `03_logs` 证据**（不可经 git 恢复，清理建议已写入 `03_logs/README.md` §1-B） | `02_docs/23_项目结构说明.md`；`05_hardware/README.md`；`03_logs/README.md`；`06_tests/_archive/`；`README.md`；`01_firmware/esp32c3_gateway/README.md`；`04_ai_prompts/00_context.md`（C-10）；`.gitignore` |

| 33 | **洞洞板施工与 168h 长跑前的代码加固（2026-10-21，砚青）**：① **接收端修 3 个真 bug** —— B-1 统计线程用只读连接写 `stat_snapshot`/`event_log`（异常被 `except: pass` 吞 ⇒ 快照与全部告警静默为空，验收时看不出来）、B-2 `ensure_run` 续跑返回 naive 而新建返回 aware（重启一次后 T3 抛 `TypeError` 死亡，168h 永不收尾）、B-3 只捕 `KeyboardInterrupt`（`systemctl stop` 发 SIGTERM ⇒ 排空/`ended_at`/checkpoint/报告全跳过）；另补 Linux 可观测性 10 项（`SO_RCVBUF` 回读、`/proc/net/snmp` 与网卡计数采样、主机指纹落库、报告固定 LF、SQLite ≥3.24 闸门、`--env-check`、每日 `backup()` 备份、`bin_sha256`、`--verify-raw` raw 自校验）。**验证**：`--selftest` 全绿（含新增 B-1/B-2 回归项）、22 s 与 75 s 实跑通过（快照确实写入）、`--report-only` 与运行时报告 md5 相同。② **固件 4 项零协议风险加固**：`write()` 返回值校验（不做应用层重传，避免污染重包率）、去掉每轮 `String` 分配、丢轮打 `[POLL][SKIP]`、`SERIAL_VERBOSE_ROUND` 开关。**双模式编译 0 error**：`SELFTEST=0` = 1,086,695 B / 49,496 B；`SELFTEST=1` = 1,078,957 B / 49,368 B。**事实修正**：文档长期引用的 Flash 基线 `1,070,975` 已过期，HEAD 干净重编为 **1,086,409 B**，本次实际增量 **+286 B / +0 B**。③ **决策留痕**：**EN 由 5V 统一为 3.3V**（改 `接线说明.md` / `M5_真机联调操作卡.md` / 固件 `README.md` / 洞洞板操作卡 v1.1，均加行内注）；**M17（`loop_ms`）本期不适用**，用 M11 替代并在报告标注；**洞洞板 v1.0 的 5 处硬错已修**（字母表顺序、排母 1×14→1×8×2、模块排母→1×5+1×3、端子 2P→3P 5.08、"8 根+2 短接"删除）。④ **F-2 更正**：M6「UDP 丢 2/1800 = 99.9%」经复核原始数据为 **缺 19 行、数据行 98.0%**（`PROGRESS.md:79,237` 与 `02_docs/22:31,459` 均已加更正括注）。⑤ 新增 `02_docs/24_焊接与168h测试规划.md`（34 条验收 + M1–M18/R1–R25 指标 + 输出形式 + 六级归因树）、`05_hardware/洞洞板布局图_2026-10-21.md`、`04_ai_prompts/09_复核提示词`；`05_hardware/洞洞板固化操作卡` 升 v1.1。**未做**：主键加宽（`meter_record` 秒级 PK，仍需决策）；固件改动**待独立复核后才可烧录** | `06_tests/udp_collect.py`；`01_firmware/esp32c3_gateway/{esp32c3_gateway.ino,config.h,README.md}`；`05_hardware/{洞洞板固化操作卡_2026-10-08.md,洞洞板布局图_2026-10-21.md,接线说明.md}`；`06_tests/M5_真机联调操作卡.md`；`02_docs/{22,24}`；`04_ai_prompts/09` |

| 34 | **装配方式定稿：无排母直焊、不分压（2026-10-21，用户裁定，砚青落文档）**：① 载体只有**模块 + 洞洞板**，**不用排母**，两模块引脚直接穿板焊接 ⇒ **焊上即不可拆**；② **`RXO` 直连 `GPIO20`，不做 1k/2k 分压**（Q-10 按"裁定"关闭，非按"实测"关闭）。受影响的文档已同步：`05_hardware/洞洞板固化操作卡` **v1.2**（材料删排母、补助焊剂与吸锡带、§0 改为已裁定、§4 改为干插定位直焊、§5/§6 去掉"插模块"、红线加第 ⑦ 条"直焊不可拆"）、`05_hardware/洞洞板布局图` **v1.1**（三处"排母"改引脚落孔、§5 改干插模块）、`02_docs/24` §1.1 与 Q1。⚠️ **代价**：引脚不可改、模块不可换、返修要拆焊 ⇒ **图纸签核（G1）与电检 M1–M17（G2）两关不可省**；若将来换 5V 逻辑模块，必须重新分压，否则打穿 GPIO20。同时产出 `04_ai_prompts/10_Codex提示词_全面审查与优化.md`（交 Codex 独立审查固件，含 12 项禁区与"已改 4 处只复核不重做"清单） | `05_hardware/{洞洞板固化操作卡_2026-10-08.md,洞洞板布局图_2026-10-21.md}`；`02_docs/24`；`04_ai_prompts/10` |

| 35 | **全仓文档一致性对齐 + 第二轮清理（2026-10-21，砚青）**：① **事实类更新**（与当前代码对齐）：`02_docs/21` NFR-04 基线 1,070,975/49,348 → **1,086,695/49,496**；根 `README.md` M6 行「丢 2/1800（99.9%）」→ **1782/1801、缺 19 行、98.0%**；`01_firmware/README.md` **4 处**改为「RXO 直连不分压」+ 指示表 EN→3.3V；`04_ai_prompts/00_context.md` **定点修正 2 处**（三.2 分压、三.5 EN）+ 变更记录 **C-11**（未删改原文，只在末尾追加方括号留痕）；`02_docs/23` 升 **v1.1**（目录树 01~25、意图索引补 24/25/udp_collect/洞洞板两件、§7 遗留重排、新增 §6.5）。② **清理**：删 `.codex_edit_20261021.py`、`.codex_task_utf8.txt`（AI 临时文件混入仓库根）、`06_tests/__pycache__/`、`.workbuddy/tmp/` 下约 20 个历史编译产物目录（**约 1 GB**）。**保留**证据类：`03_logs/`（3.4 MB）、`05_hardware/{carrier,pcb}/`（4.2 MB，未入库自研板工程）、`.workbuddy/tmp/*_rows.json`（被 §8.2 #25/#26 引用）。③ 未改任务书（v0.4.1 冻结）——其 §5.2 第 2 条的"必须分压"与本次裁定冲突，已由 `00_context.md` C-11 与 `24` §1.1 覆盖说明，差异不再回写任务书。**未做**：主键加宽、09/10 两份结项文档、固件复核 | `README.md`；`02_docs/{21,23}`；`01_firmware/esp32c3_gateway/README.md`；`04_ai_prompts/00_context.md`（C-11）；本文件 §9 |

| 36 | **Codex 固件审查改动入库（2026-10-21，Codex 改 · 砚青复核）**：用户把 `04_ai_prompts/10` 交给 Codex，Codex 已实际改码。**复核结论 = 通过**：12 项禁区**一项未动**；双模式编译 0 error（`SELFTEST=0` 1,086,171 / 49,512；`=1` 1,078,983 / 49,384）。**它的核心贡献是纠正了我的一处错误**：`NetworkUDP::write()` 返回的是"已写入本地 tx_buffer 的字节数"（实现上逐字节写、最后 `return i` = 传入 size），**恒等于请求长度**，所以我 2026-10-21 加的 `wrote == want` 判据无效——它已改回只认 `endPacket()`，并把 `wrote != want` 降级为诊断 WARN。**其余改动**：① 三处 payload 组装失败时**不再发送不完整 JSON**（原会把 bad_json 推给接收端并被算成网络丢失；`seq` 已占、`udp_tx` 不增，对账归入"未发出"）；② `parseResponse` 功能码判定由"接受 0x03/0x04"收紧为 `func == reqFunc`（判定顺序未变）；③ ST_TX 清 RX 与 ST_WAIT_RX 收字节改为**有界预算**（4×96+8=392 ≥ UART 256+128，防噪声占死主循环）；④ `g_ntpPrimary[48]→[64]`（对齐 `isPlausibleHost` 63 字符上限）；⑤ Web 配置页/`/status` 缓冲不足时返 500 而非发截断内容；⑥ `SERIAL_VERBOSE_ROUND` 1→0。**砚青另修**：`.ino` 一处注释把预算写成 512（实际 392），已改正。**遗留**：`SERIAL_VERBOSE_ROUND=0` 后台面脚本 `m4_accept.py`/`m5_parse.py` 的 grep 锚点消失，台面用需临时改 1 | `01_firmware/esp32c3_gateway/{esp32c3_gateway.ino,config.h,web_config.h,README.md}`；本行 |

| 37 | **目标级别定档 L1 + 外壳预留（2026-10-22，砚青）**：用户重新定调「项目核心不是替代树莓派，而是把 ESP32-C3 + MAX13487 焊到洞洞板上跑真机数据、做到完整」，并选定 **L1 实验室样机**（现状硬件不改，后续只补外壳）。① 新增 **`02_docs/26_级别声明与范围边界.md`**：L1 五条验收定义（能采/可信/可诊断/可复现/可交付）、**四项明确不做**（隔离、打样 PCB、EMC 认证、批量一致性，各带理由与决定人）、**六条残余风险补偿**（无隔离 ⇒ 必须拔 USB + 断续电 + 验电；无 TVS ⇒ 只在受控室内）、L2 升级最小改动清单。② **`05_hardware/洞洞板布局图` 升 v1.2**：新增 §2.1「外壳预留」（4×⌀3.2 安装孔、距边 ≥5 mm / 距焊盘 ≥4 mm、**焊前钻孔**、背面净空 ≥5 mm、USB 开窗位置、端子朝向、先定盒子再定板外形）+ 自查项 **C9** + 签核表加外壳字段。③ **`洞洞板固化操作卡` 升 v1.3**：补助 1b「焊前钻安装孔」，说明"焊完再钻会震裂焊点"；材料加手电钻/⌀3.2 钻头/M3 螺钉与尼龙柱。④ `PROGRESS §0` 改写项目定位（原"替代树莓派"表述作废）、`§9` 新增 **G8 外壳** 4 项与待决策 D-6；`02_docs/24` 头部加"目标级别 L1"。**关键提醒**：G8-8.2（纸板试装候选盒）**必须在焊接前完成** | `02_docs/{26,24}`；`05_hardware/{洞洞板布局图_2026-10-21.md,洞洞板固化操作卡_2026-10-08.md}`；本文件 §0/§9 |

| 38 | **建立项目流程主线（2026-10-22，砚青）**：用户反馈"项目很乱"，要求按专业流程重做、已做过的只做检验。诊断结果：**内容不缺，缺主线** —— 26 份文档按"什么时候写的"编号（时间序），而非按阶段组织；`PROGRESS` / `00_context` / `21` / `24` 四份都像"事实来源"；没有门禁概念。① 新增 **`02_docs/00_阶段与门禁主控表.md`**：S0 立项与需求 → S1 设计 → S2 实现 → S3 验证（台面）→ S4 确认（真机 168h）→ S5 交付结项，每阶段给交付物、现有文件、状态、出口判据；把 26 份文档归位为**规范 8 / 过程记录 12 / 评审 6**（**无一份多余**）；明确分工（`00` 判流程、`PROGRESS` 记日志、`21` 定需求、`22` 定方案、`24` 定判据）。② 新增 **`02_docs/27_评审与风险登记册.md`**：评审记录 8 条（其中 RV-05「`21`/`22` 复核」**未执行**、RV-06 固件加固**无法自审**故交 Codex 反向审查）+ 待补 2 条；风险台账 14 条（`D-03/05/07/08/10` 沿用 `21 §9` 编号 + 新增 `R-01~R-09`），每条带归属人与卡住的阶段。③ 审核结论：**S0 有条件通过**（12 条差异中 5 条仍待确认）、**S1 概要通过详细未开始**、**S2 技术通过程序未闭环**（缺独立签字）、S3–S5 未开始。④ `PROGRESS §0` 声明流程判断以 `00` 为准、本文件降为日志；`23` 目录树与意图索引同步（补 `00`/`27`）。**真实缺口只剩 3 项**：S1 详细设计、S4 报告、S5 两份结项文档 | `02_docs/{00,27,23}`；本文件 §0 |

| 39 | **第三轮结构整理：物理层清理（2026-10-26，砚青）**：用户反馈"太乱、无用信息太多、眼花缭乱"。诊断结论：**前两轮（#31 / #35）只理顺了文档逻辑，物理层从未执行** —— `02_docs/23` §7 写着 `.pio` 52 MB、`tmp` 曾 1.2 GB，全停在"建议"，没人动手。① **删 `01_firmware/{pio_verify,rs485_probe}/.pio/`**：409 → 10 文件、**76 MB → 194 KB**（可再生、`git ls-files` 实测零跟踪）。② **清 `.workbuddy/tmp/`**：551 → 114 文件、**59 MB → 4.8 MB**（21 张调试截图 / 2 个工具链 zip / 16 个源码快照目录打包留底 `_源码快照归档_20261026.tar.gz` / 301 个瞬时 txt；另**删除含明文凭据的 `secrets.h.bak`**）。③ **`05_hardware/{carrier,pcb}` 删除**（80 文件 / 4.2 MB）：先归档到 `_备查_未打样PCB/`，同日用户明确"PCB 不要了" ⇒ **连备查一并删除，含 9 个 KiCad 生成脚本**；依据 `26` **N-2 裁定 L1 不打样**，D-5 关闭。④ **`03_logs` B 类 25 个迭代日志删除**，A 类证据全部保留。⑤ **`.gitignore` 补 `.pio/`**（原先只忽略 `build/`，故反复堆积）。⑥ **重写根 `README.md`（212 → 约 100 行）**：原文标题仍写"替换树莓派"（与 #37 定调矛盾）、19 条"待确认"大半已闭环、EN 仍写 5 V / `RXO` 仍写要分压 ⇒ 改为**纯导航**，会变的事实只留单一出处。⑦ **重写 `05_hardware/README` §1**：原文"要动手做板子先看 `carrier/`"与 L1 裁定冲突。
**同日追加（用户第二轮反馈："pcb 不要了，每个文件夹我都不知道放的啥，读文档感觉项目没被串起来"）**：
⑧ **`05_hardware/_备查_未打样PCB/` 整体删除**（80 文件 / 4.2 MB）+ 9 个 KiCad 生成脚本 —— 用户明确"PCB 不要了"，**D-5 关闭**，`26` N-2 的"L2 再重新设计"路径不变。
⑨ **新增 3 份目录 README**（`01_firmware` / `02_docs` / `04_ai_prompts`）—— 此前三个目录**没有 README**，是"不知道文件夹放什么"的直接原因。
⑩ **新增 `02_docs/28_系统全链路说明.md`** —— 27 份文档全按时间序组织，**缺一份按数据流讲的整体叙事**；新文按"电表→485 帧→状态机→质量标注→JSON→UDP→入库"七环串起，附故障定位树与参数速查表。
🔎 **过程中发现一处文档与代码不一致（已登记 D-07 未决）**：`16` 号文与旧 `01_firmware/README` 都写「固件只搬运原始值，不做工程量换算」，但代码**实际既换算又发 `raw`**（`频率÷10`、`电流÷100`、`温度−40`…）。本轮在 `01_firmware/README` 与 `28` 号文如实标注，**未改代码也未改 `16`**，等用户/导师定。⚠️ **一处失误据实记录**：`03_logs` 归档包在重建时丢失（先删旧包、再打包时原文件已不存在），**25 个日志不可恢复**；已核对 `PROGRESS` 与 `02_docs` 正文**均未引用**这些文件、A 类证据完好 ⇒ **不影响任何已发布结论**；教训写入 `23` §8 第 7 条 | `README.md`；`.gitignore`；`02_docs/23`（v1.2）；`03_logs/README.md`；`05_hardware/README.md`；本行 |

| 40 | **商用级优化（第一轮：接收端）+ 发现 Python 3.13 致命坑（2026-10-26 21:00，砚青）**：用户授权「现在可以优化代码了，今天先跑 8h」⇒ 先改接收端、再起跑。① 新增 **`02_docs/29_商用级优化方案_2026-10-26.md`**：七维度（稳定性/准确性/完整性/异常处理/容错重试/性能/可维护）× 商用标准的差距表 + **P0×7 / P1×4** 改动清单（带文件:行号、示意代码、风险、验证方式）+ 商业化验收标准 + **给需求分析文档预留的支撑信息**（术语表/6 类接口契约/SLA 候选/追溯矩阵骨架/**10 个必须由导师或业务方拍板的问题**）。② **P0-7（新发现，最严重）**：**Python 3.13 起 `threading.Thread` 在实例上设置 `self._handle`，把 `Receiver` 的同名回调整个遮蔽** ⇒ 每包抛 `TypeError: '_thread._ThreadHandle' object is not callable`，被 `except` 吞成 `PARSE_EXC` 告警，**`rx` 恒 0，症状与"抓不到包/IP 错/防火墙拦了"完全一致，8h 与 168h 都会跑出空报告**。修复：回调改名 `_on_datagram` + `run()` 入口可调用性断言 + `--env-check` 增硬项。③ **P0-5**：`storage_check()` 跨平台介质检查（Windows `GetDriveTypeW` 判 REMOTE/REMOVABLE，Linux 读不到 `/proc/mounts` 也判硬项不再静默跳过，两平台都查 OneDrive/坚果云等**云同步目录**）。④ **新增 `HOST_CLK_SKEW`**：本机时钟与固件 NTP 差 >5 s 记事件（10 min 节流），防 `BootAnchor` 把整个世代的 `collect_time` 平移而报告看不出来。⑤ 交付包 **v2**（`ESP32接收端_2026-10-26_v2.zip`，v1 作废）。**回归**：`py_compile` OK、`--selftest` 全绿、`--env-check` 通过、端到端注入 6 轮 `rx 12(d 6/h 6)` + `meter_record 6 行` + 对账残差 0、`--report-only` 报告 10 章齐全、`HOST_CLK_SKEW` 精确测出 3600.7 s 且只记 1 条。⚠️ **固件 P0-1~P0-4 本轮未动**（本机无 COM5，ESP32 已接旧电脑，无法烧录）⇒ **今晚 8h 跑现有固件 = 等价原路线 A 的"先拿基线"**。⚠️ 顺带实测：Windows 上 `SIGTERM` 不可投递（`timeout -s TERM` 实为硬杀，`stop_signal_at`/`ended_at` 均 NULL）⇒ **G0-0.7 在 Win10 只能用 Ctrl+C 验证**，已写入交接包 §7 三条禁令 | `02_docs/29`（新建）；`06_tests/udp_collect.py`；`04_ai_prompts/11`（v2）；`04_ai_prompts/ESP32接收端_2026-10-26_v2.zip`；本行 |

| 41 | **G5 8h 门控通过（2026-10-27，砚青 判读）**：旧电脑 Win10（`172.16.0.138`）跑 2026-10-26 21:34:08 → 10-27 05:34:08，**8.00 h 满、脚本自动优雅收尾（`[RUN] 报告已写入`）、整夜零人工干预**。**成绩**：收到 56720 包（data 28358 + hb 28362 + **err 0**）、重包率 **0.0000%**、网络丢 **8 行（0.014%）**、对账恒等式 `期望 56726 = 收到 56718 + 未发 0 + 丢 8` **残差 0 完全闭合**、**M1 采集成功率 100.0000%**、M3 送达 99.9859%、M2′ 端到端 99.9788%（门槛 97.5%）⇒ **G5 判通过**。meter_record 28357 行、`quality=OK` 100%。**DHCP 实测零漂移**（租约自 19:17:48 起自动续约至 06:12，IP 全程 `.138`）⇒ R-08 类风险可关闭。**设备侧独立佐证**：13:10 读 `/status` 得 `poll_ok=55749 / poll_err=0 / udp_tx=111494 / uptime 15.49 h / heap 176424`（-148 B/15.5h，无泄漏），与"8h 内约 28360 轮"自洽；**板子连续 15.5 h 零失败**。**两处 WARN 判读**：① 抖动 p99=82.1 ms（M11 门槛 50 ms）、max=1205 ms（M12 门槛 200 ms）**超标但不阻断 G5**（M11/M12 不在 §5.6 门禁内），max 可用"起跑后 7.5 min 那次复位"解释，建议固件加 `WiFi.setSleep(false)` 后复测；② **`RAW 校验 checked=2000 / bad=2000` 是误报** —— `bad` 为**字段级**计数（平均 1 处/行），根因是 `openState` 固件发 HEX（`00F0`）、`decode()` 返中文（`无锁/合闸`），直接比字符串必错。**已修**：`verify_raw` 对 `openState` 统一按 `"%04X" % regs[0]` 比，**用 G4 真机 297 条真实帧实测：改前 297 处不一致（1.00/行）→ 改后 0 处**；回归 `--selftest` 全绿、`--env-check` 通过。⚠️ **未解**：ESP32 于 21:41:38 复位一次（起跑后 7.5 min，世代 #1/#2 分界），**复位原因未知**（无看门狗、无 `esp_reset_reason` 上报）⇒ 需 P0-3/P0-4 落地后才有答案；且 `ts_ok=false` 窗口的 BOOT 行在旧接收端会被 P0-1 判 `udp_bad`，需用新版 `--repair` 从 `udp_packet` 补。 | `PROGRESS.md`；`02_docs/29`；`06_tests/udp_collect.py`（`verify_raw` openState 口径） |
| 42 | **固件商用级加固落地（2026-10-27，砚青）—— Codex 固件四条 A 类修复 P0-1~P0-4 全部写入 + 双模式编译零警告**：① **编号纠错（重要）**：Codex 原报告的固件四条是 **P0-1 时钟回退钳位 / P0-2 心跳诚实化 / P0-3 看门狗+复位原因 / P0-4 版本自报**；我 10-26 在会话里一度误记为 "P0-5~P0-8"，已按原文对齐，`02_docs/30` §0 有对照表（接收端侧 P0-5 盘符检查 / P0-6 服务托管另有编号）。② **P0-1**：`ntpApplyWithGuard()` 替代 2 处 `configTzTime`（`ntpTick` 内），`ntpClampTick()` 在 `loop()` 里**不受 200 ms 节流**（把"SNTP 已改钟→拉回"的漏网窗口从 200 ms 压到单次迭代），`settimeofday()` 拉回旧值并计 `clk_hold`/`clk_back`；`buildTimestampIso()` 再加 **ts 严格递增护栏**（只在 `cur < last` 时 `last+1`）。**两处设计取舍（有意为之，不是缺陷）**：ⓐ 只做源头不兜底 ⇒ `configTzTime` 异步窗口内可能已发出倒退 `ts`；只做兜底不源头 ⇒ `ts` 单向超前且**每次回拨累积**；ⓑ **不用"ts 冻结等真实时间追上"** —— `udp_collect.py:640` 对同秒撞车**直接丢弃该行**（`StoreResult.SAME_SECOND` 不入库），冻结会连续丢行直接伤 M2。预期代价：一次被拦的回退**丢 1 行**（同秒），远好于修复前丢 D 行且 **Y-4 判 F**。③ **P0-2**：心跳 `queue`/`dropped` 由假 `0` 改 **`null`**（本固件无发送队列，UDP 走同步 `sendto`），新增真实计数 `tx_fail`/`reconn`/`up`；**接收端已逐行核实无需改动**（`HB_REQUIRED` 不含这两键、`:845` 只查"必须有"、`:1060` 只对三项做 `isinstance(int)`）。④ **P0-3**：`esp_task_wdt` 30 s + `trigger_panic`，`RTC_NOINIT_ATTR` boot 计数（带 magic 校验，`==1` ⇒ 真断电 / `>1` ⇒ 软复位或看门狗），`esp_reset_reason()` 映射 15 串（★`BROWNOUT`/`PWR_GLITCH`=供电不稳、`USB`=插拔换线 —— **正好覆盖 10-26 那次 21:41:38 复位的定性难题**，用户已确认那次是换 USB 供电线所致，非故障）。⑤ **P0-4**：`FW_VERSION` 接进心跳 `fw`。⑥ **实测硬发现（推翻 Codex 原话）**：本机 IDF 5.5 的 `esp_task_wdt.h` **只有新签名** `esp_task_wdt_init(const esp_task_wdt_config_t*)`，Codex 写的 `esp_task_wdt(30, true)` 在此框架**无声明会编译失败**（已 grep 实证）。⑦ **双模式编译**：`SELFTEST=0` → Flash `1089225` / RAM `49568`；`SELFTEST=1` → `1081561` / `49408`；**均 0 error 0 warning**；`.rtc_noinit = 8 B`（= 两个 `uint32_t`，**boot 计数确实进 RTC 保留区的硬证据**）；两次 SELFTEST=0 编译产物完全一致（可复现）；`config.h:192` 已复位为 **0**。**基线经实测更正**：把 HEAD `71c19ca` 三个源文件导出到 `.workbuddy/tmp/base_check/` 单独编译，得 `SELFTEST=0` = `1086171`/`49512`、`SELFTEST=1` = `1078983`/`49384`（与 `02_docs/21` NFR-04 吻合）⇒ **真实增量 `+3054 B / +56 B`（SELFTEST=0）、`+2578 B / +24 B`（SELFTEST=1）**。⚠️ **此前沿用的 `1070975`/`49348` 是 M6 时代过期数，`+18250/+220` 作废**（memory 里的基线也已一并纠正）。⑧ **JSON 实测**：新心跳 312 B、`json.loads` 通过、`queue/dropped = None`、`HB_REQUIRED` 无缺失、三项 int 判定 True。⑨ **新增** `02_docs/30_固件商用级加固_2026-10-27.md`（含 §5 六条已知限制与 §6 烧录验证步骤）+ `04_ai_prompts/13_固件商用级加固复核指令_2026-10-27.md`（两阶段：审查 + **直接实施 A 类修复**）。⚠️ **本批未经第二角色复核、未经真机验证**（铁律：作者不得自审自改）⇒ **烧录前必须先跑 `04_ai_prompts/13`**。⚠️ **未做**：`web_config.h` 的 `/status` 仍发 `queue:0`/`dropped:0`（属"老师 22 项"契约，决策类，待导师拍板 ⇒ 当前存在"心跳诚实、/status 仍假"的有意不一致）；`FW_VERSION` 未升版（建议 `0.7.0-batch4`，决策类）。**安全前提已满足**：用户确认板子已从配电箱拆下、485 线已拔。 | `01_firmware/esp32c3_gateway/{esp32c3_gateway.ino,config.h}`（`web_config.h` 0 改动）；`02_docs/30`（新建）；`04_ai_prompts/13`（新建）；本行 |
| 43 | **D-10 电量公式定案（2026-10-27，砚青）—— 现行式错，正确式 `(H*65536+L)/1000`**：旧电脑反馈「`A_L` 恒定 +1.00/分钟走字，8h 走 331 度，37W 负载每小时只该 0.037 度，差 1000 多倍」，怀疑"固件填充模拟数据"或"刻度错"。**我定性：刻度确实错 1000 倍，但绝不是固件造假** —— 固件只是**照字段字典实现了错公式**（`.ino:866/:894` 两处，且代码里早已标注"存疑"），并同时上行 `raw`。**定量证据（真机 raw，非推算）**：`2026-10-08 12:20` = `A_H=4, A_L=58935` ⇒ 错式 `59197.144` 度 / 正式 `321.079` 度；`20:55` = `A_L=58964` ⇒ `59226.144` / `321.108`。**8.5 h raw 增量 29 ⇔ 正式式增量 0.029 度（严格自洽）⇔ 折合 3.4 W**（该段 `A_power` 均值 2.6 W）。**旧电脑那 8h**：错式 331 度 ⇒ 反推 raw 增量 331 ⇒ 真实 **0.331 度** ⇒ 平均 **41.4 W**，与它测的 **37 W** 只差 11.8% ⇒ **原观察与正确公式完全兼容**。**为何不用"绝对值荒谬"定案**：6 万度若按十年日均 16 度勉强可辩，故改用**增量**（331 度/8h = 41 kW，插座回路不可能）。**结构论证（最硬）**：错式里 H 每 +1 贡献 65.536 度、L 每 +1 贡献 1 度，**同一 32 位累加器高低字量纲差 1000 倍**，任何合理设计都不成立 ⇒ 必然形如 `(H*65536+L)*k`。**附带发现（独立隐患）**：错式在 `L` 由 65535→0 时电量会**暴跌 ≈65469 度**（正式式此时仅 +0.001 度，连续）；当前 `L≈58965`，距溢出仅 6570 Wh（41 W 约 160 h、3.4 W 约 1930 h）⇒ **168h 期间"可能不溢出"，但一旦溢出就是无法解释的负跳变，会直接打穿"电量单调性"判据，故即使不改刻度也必须修**。**修复方案 4 处**（`.ino` 两处需烧录；字段字典 4 行 conv；`06_QI` 4 条公式；`db_proto.py:114-116`），且**历史数据可完整重算**（固件全程上行 `raw`，`meter_record` 有 `raw_hex`，无需重跑 168h）。⚠️ **本轮只出结论与方案，代码一行未改** —— 因动的是**老师给的字段字典口径**（决策类），且需现场示数最终确认：**看电表屏显 ≈321 度 ⇒ 确认并改；≈59197 度 ⇒ 存在未记录的倍率/CT 变比，停下重查**。 | `02_docs/31_电量公式勘误_2026-10-27.md`（新建）；`02_docs/{00,21,27}`（D-10 状态）；本行 |
| 44 | **M3 判据裁定：双条件口径（2026-11-04，用户拍板）—— 决策类**：用户答「不认」，M3 ≥99% **不再是单一硬门槛**，拆两条并列：**C-a 系统能力** = 受控窗口 **22:00–08:00（完整 10 h 全部计入）** 内 M3 ≥99%（判 P/F）；**C-b 环境实测** = 全天 M3 照实报（不判 F，但**必须与 C-a 并列出现、不得隐去**）。**支撑三条**：① **8 h 门控那轮本来就是夜间窗口** —— 2026-10-26 **21:34:08 → 10-27 05:34:08**、M3 **99.9859%**、err 0、对账残差 0（本表 #41），即**另一份固件（`0.6.0-batch3` 加固前）、另一天、独立进程**复现了同一窗口的能力 ⇒ 不是单次侥幸；**关键发现：G5 一直靠夜间窗口通过，而 `24` §3.5 从未写明「必须夜间」** ⇒ 本裁定是把**隐含前提显式化**，不是新造判据（已在 `24` G5 行补注）。② **损失已排除系统侧**：`q_drop=0`、收缓冲未用满、解析 0 不一致、重包 0、`M1=99.9995%`（纯 RS-485）⇒ 只剩空口。③ **防 p-hacking**：窗口**前置固定为完整 10 h、不许再二次挑选**，且全天值不得隐去。**与 `22` §3 纪律 2「判据只认全程」的冲突已就地处理**：该条防的是**事后择优**（跑完不达标再挑一段顶替），本次是**判据定义的前置变更**（第二轮数据产出之前由用户裁定）⇒ 已在 `22` 加「唯一一次例外」注，并写死**「M2 仍认全程、同一逻辑不得类推」**。⚠️ **可错性（写死，不许事后改口）**：夜间段复算 **<99%** ⇒ 裁定作废、M3 回落 `F`，重新讨论口径。**遗留**：C-a 的夜间段 M3 必须由旧电脑**从 168h 库复算**（不能只引 8 h 轮那份）⇒ `04_ai_prompts/16`。**风险册联动**：`27` R-10 由「开放（最高优先）」改「已裁定（口径）」，并新增 **R-13**（甲方若非要真达标，只能改环境：有线/独立 AP/专网，改固件无效，成本工期需重估）。 | `02_docs/{32,24,22,27}`；`04_ai_prompts/16`（新建）；本行 |
| 45 | **M3 C-a 复算通过 → Y-2 定稿 P（2026-11-04，砚青 判读）**：旧电脑执行 `16` 号指令，在 168h 归档库（`0.7.0-batch4`）上 **`mode=ro` 只读**复算受控窗口 M3。**结果：C-a = 99.5678% ≥ 99% ⇒ Y-2 判 P**（6 个真·完整 10 h 夜，430,139/432,006 行）；宽松口径（含 10-27 起跑残段夜）99.6194%，**两口径结论一致，取更保守的严格值作主语**。**三条硬记录**：① **分母自洽** —— 6 个完整夜发送行数**全部精确等于 `72,001`**（3600 秒 × 2 行/秒 × 10 h + 1）⇒ 夜间无重启无断流、分母与物理模型严丝合缝，不存在系统性偏差；② **诚实记录 11-02 夜 = 98.2028%**，是唯一低于 99% 的完整夜（按预声明「完整夜**合计**判」不影响判定，但必须写进报告；该日白天 10 点低至 59.95%，为全轮最差小时）；③ 趋势侧写（小时算术平均）**夜间 99.60% vs 白天 94.33%**，昼夜差 5.3 pp，双条件口径的物理依据得到直接印证。**归档指纹勘误（必须替换）**：14:38 回执的 `F7B43FBF…` 是 `starts` 还原（14:41）**之前**的中间态、已过时；**交付版真实指纹 = `f878bd9837a4a685a50d79faba946e0e8b81058aba680a65949b5395e594e3fa`**（重建前备份 `bak_AL修正前` = `4f3b44f0…`，仅作对照）。指纹变化源于我方必要操作（A_L 重建 + `starts` 还原写库），**不是数据污染**；复算前后指纹一致 ⇒ 只读复算零写入。**脚本 3 处 bug 已修并双方向验证**（旧电脑在真库上发现）：① C-b 分母跨世代失效 —— 原用全局「末−首 `udp_tx`+1」，而重启把 `g_udpTx` 归零 ⇒ 10-29 三次重启使 C-b 算成 **131.66%**（收到比发出多，物理不可能），改为按 `epoch_id` 分段求和（**C-a 不受影响**，夜间无重启）；② 「完整夜」判据不严 —— v1 只判「10 个时钟小时都有心跳」，抓不到 10-27 夜 22 点只有 16 分钟（该夜 `tx=66,684` 行 = 9.26 h），已补首包 ≤22:05 / 末包 ≥07:55；③ 逐小时出现 `M3=160%`（`rx > tx`），已标 `RX_GT_TX` 排除。**至此 34 条验收判定全部落定**，可出 `02_docs/25` 的 168h 正式报告。 | `02_docs/32`（§8.6.2/§8.6.3/§8.5）；`02_docs/27`（R-10 关闭）；`04_ai_prompts/16_{M3夜间窗口复算指令,m3_night}.py`（v2）；本行 |

> **原 §8 已闭环（2026-10-06）**：① 任务书进度字段过期 → ✅ 已同步（v0.4.0）；② 角色口径两处旧表述（`00_context.md` 一、任务书 §3）→ ✅ 已同步。

| 32 | **168h 接收端落地（2026-10-17，砚青）**：新增 `06_tests/udp_collect.py`（3 线程 + 2 队列 / WAL 六表 / 原始包优先落盘 / 报告全 SQL 重算 / `--report-only` 逐字节一致 / `--repair` / `--selftest`）。**落地时发现方案 4 处与源码不符并修正**（已回写 `02_docs/22` §2.10，冲突以该节为准）：① `2ΔR` 仅在 `QI_SEND_ERR_ROW=1` 成立 ⇒ 改为运行时推断；② hb 的 `udp_tx` 是**发送前**值 ⇒ 窗口发出行数 = `Δudp_tx+1`；③ 世代首轮无差分 ⇒ 由 `seq_first+1` 的 ptype 归属，否则 M1 系统性少 1（22 轮时差 4.5%）；④ 重复包会被 M3 误算成丢包 ⇒ 分母改用"应唯一发送数"。**验证**：自检注入 50 整轮丢/20 数据行丢/10 心跳丢/3 err 丢/5 重包/2 重启/各 1 次同秒与回跳，**逐项精确复现**（unexpl=0）；20~30s 真实 UDP 冒烟 4 轮，`--report-only` 与运行时报告 **md5 相同**。🔴 **新发现既有 schema 限制（需决策）**：`meter_record` 主键 `(device_id, collect_time)` 秒级，1 Hz 下同秒两轮会顶掉一行；原始包不丢、主键加宽后可重放。**是否加宽主键 = 决策类，需改 `db_proto.build_ddl` + `ingest` 的 `ON CONFLICT`，须走「作者≠验证者」复核 —— 未执行** | `06_tests/udp_collect.py`；`06_tests/README.md`（v1.11）；`02_docs/22`（§2.5 DDL 补 2 列 + 新增 §2.10）；本行 |

---

## 9. 接下来要做的事（按门禁排序，2026-10-21 版）

> 规则：**上一道门禁没过，不许进下一道**。每项标 `[ ]` 未完成 / `[x]` 已完成，括号里是"卡住什么"。
> 判据细节见 `02_docs/24_焊接与168h测试规划.md` §3；施工细节见 `05_hardware/洞洞板固化操作卡_2026-10-08.md` v1.2。

### G0 · 代码冻结（挡住烧录与 8h）

| # | 事项 | 负责 | 状态 |
| --- | --- | --- | --- |
| 0.1 | 把 `04_ai_prompts/10` 交给 Codex，拿回审查报告 | 用户转交 | `[x]`（2026-10-21 已交回，改动已入库，见 §8.2 #36） |
| 0.2 | 复核 Codex 报告：确认它**没碰 12 项禁区** | 砚青 | `[x]`（2026-10-21 复核通过：12 项禁区一项未动） |
| 0.3 | 定案 `UDP::write()` 返回值语义（错了要回退 C-1） | Codex 查源码 + 砚青判 | `[x]`（**已定案**：`NetworkUDP::write()` 返回"已写入本地 tx_buffer 的字节数"，恒等于请求长度 ⇒ 判据只认 `endPacket()`，`wrote != want` 降为诊断 WARN。见 §8.2 #36） |
| 0.4 | 固件改动过「作者≠验证者」复核并签字 | 另一角色 | `[ ]` |
| 0.5 | `--selftest` 全绿 + `--env-check` 0 阻断 | 砚青 | `[x]`（2026-10-21 已过；固件改后需重跑） |
| 0.6 | `SELFTEST=0/1` 双模式编译 0 error | 砚青 | `[x]`（Codex 改动后：1,086,171 / 1,078,983） |
| 0.7 | SIGTERM 收尾实测 3 次（空闲 / 灌数 / 备份中） | 砚青 | `[ ]`（需 Ubuntu 环境） |

### G1 · 图纸签核（**未过不许动烙铁**）

| # | 事项 | 负责 | 状态 |
| --- | --- | --- | --- |
| 1.1 | 买料：洞洞板 70×90 ×2、3P **5.08 mm** 端子、24AWG 五色线、吸锡带、热缩管 | 用户 | `[ ]` |
| 1.2 | 画图 1：元件面 1:1 布局（两模块行距 15.24 / 3 针排偏 1 格） | 用户 | `[ ]` |
| 1.3 | 画图 2：接线图，8 根线按**角色**命名（不按丝印同名） | 用户 | `[ ]` |
| 1.4 | 画图 3：焊接面镜像图 | 用户 | `[ ]` |
| 1.5 | 八项自查 C1–C8（C5 角色朗读必须第二人听） | 用户 + 第二人 | `[ ]` |
| 1.6 | 签核表填写 + 拍照存 `media/layout_<日期>_signed.jpg` | 用户 | `[ ]` |

### G2 · 焊接与电检

| # | 事项 | 负责 | 状态 |
| --- | --- | --- | --- |
| 2.1 | 干插定位（不焊）→ 先焊对角 → 复查几何 → 补全 | 用户 | `[ ]` |
| 2.2 | 按 §4 顺序焊 8 根线（GND 先建参考地） | 用户 | `[ ]` |
| 2.3 | 电检 M1–M15（通断 / 短路 / 5V↔3.3V 不导通） | 用户 + 万用表 | `[ ]` |
| 2.4 | M16 A↔B ≈120 Ω、M17 EN 上电后 3.2–3.4 V | 用户 | `[ ]` |
| 2.5 | 填 §8 记录表 + 拍 8 张照片 | 用户 | `[ ]` |

### G3 · 上电（桌面，不动配电箱）

| # | 事项 | 负责 | 状态 |
| --- | --- | --- | --- |
| 3.1 | S1 只上 ESP32：5V / 3.3V / EN 三个电压核对 | 用户 | `[ ]` |
| 3.2 | S3 A/B 悬空：约 3 轮后出现 `mode:"3seg"` + `err seg:"S1"` | 砚青看接收端 | `[ ]` |
| 3.3 | LED 三种状态语义核对（WiFi 断 / 成功 / 失败） | 砚青 | `[ ]` |

### G4 · 真机接入（需断电窗口）

| # | 事项 | 负责 | 状态 |
| --- | --- | --- | --- |
| 4.1 | **断电 + 验电**后接 A/B/GND（只读，禁止任何写命令） | 用户 + 第二人 | 🟡 **接线完成，验电未确认**（用户未提及是否用万用表/验电笔逐点验电） |
| 4.2 | 真机 5 min：`seg:"1"`、39 字段、`quality:"OK"`、100% | 砚青 | ✅ **2026-10-26 20:07:24–20:12:24 通过** — 297 数据行全 `quality:"OK"`、`invalid:""` 全空、`type:"err"` **0 条**、`poll_ok` 104→404（**+300 次/300 s = 100%**）、`poll_err` 恒 0、`queue/dropped` 恒 0、`mode:"full"`、`rssi -58~-61`。证据 `03_logs/G4_real_20261026.log` |
| 4.3 | 环境冻结表定稿（主机 / IP / 网卡 / 防火墙） | 砚青 | `[ ]`（当前实测：Windows / WLAN `192.168.1.113` / 402FBS / ESP32 `192.168.1.200`） |

### G5 · 8h 门控（**过了才允许上 168h**）

| # | 事项 | 负责 | 状态 |
| --- | --- | --- | --- |
| 5.1 | Ubuntu 旧机 `--env-check` 通过（SQLite ≥3.24、磁盘 ≥20 GB、ext4） | 用户 | `[ ]` |
| 5.2 | 旧机禁休眠（无 sudo 用 `systemd-inhibit` + 开盖） | 用户 | `[ ]` |
| 5.3 | 8h 连续跑 + 2 段 pcap 窗口（+1h / +5h 各 30 min） | 砚青 | `[ ]` |
| 5.4 | 判定：M2 ≥97.5% 放行；96.5–97.5% 延到 24h；**<96.5% 停** | 砚青 | `[ ]` |
| 5.5 | 若 M2≈98% 且 pcap 证明空口丢 ⇒ 报告须写明"余量仅 2 点" | 砚青 | `[ ]` |
| 5.6 | **8h 必须在焊好的洞洞板上跑** —— M6 的 98.0% 是**面包板 + 杜邦线**测的，焊接后接触电阻 / 走线 / 地回路全变，旧数据不得当门控依据 | 砚青 | `[ ]` |

### G6 · 168h 长跑

| # | 事项 | 负责 | 状态 |
| --- | --- | --- | --- |
| 6.0 | **开跑前最后一道：确认目标 IP 真的生效** —— 2026-10-26 实测 `/status` 返回 `server:"192.168.1.113"` + `configured:false`（NVS 无 `udp_ip` ⇒ 编译期默认值 `config.h` 起作用，**已实收 5 分钟验证**）。⚠️ 旧记录"改成 .150"已作废：电脑当前 WLAN 就是 `.113`（402FBS 网段） | 砚青 | ✅ **2026-10-26 已实证** |
| 6.1 | 开跑（`--db 03_logs/m7_longrun_<日期>.db --bin <bin>`） | 砚青 | `[ ]` |
| 6.2 | 每日 10 min 巡检（看 `q_drop`、`快照行数`、`RcvbufErrors`） | 砚青 | `[ ]` |
| 6.3 | 每日备份 + SHA256 核对 | 砚青 | `[ ]` |
| 6.4 | 收尾：stop → 排空 → 报告 → CSV → manifest | 砚青 | `[ ]` |
| 6.5 | 第二人独立复算（`--report-only`，比 SHA256） | 另一角色 | `[ ]` |

### G7 · 交付文档

| # | 事项 | 负责 | 状态 |
| --- | --- | --- | --- |
| 7.1 | 填 `02_docs/25_168h测试报告.md`（34 条判定逐条结论） | 砚青 | `[ ]` |
| 7.2 | 写 `02_docs/10_验收结项.md`（M7 结项） | 砚青 | `[ ]` |
| 7.3 | 写 `02_docs/09_成本对比.md`（不依赖 168h，可提前做） | 砚青 | `[ ]` |
| 7.4 | 缺口归因专章（按 `24` §6 判定树，含 `UNATTRIBUTED`） | 砚青 | `[ ]` |

### G8 · 外壳（L1 的最后一步，**布局阶段就要留位**）

| # | 事项 | 负责 | 状态 |
| --- | --- | --- | --- |
| 8.1 | 选外壳型号：先按布局图 §2.1 量出"正面净高 +5 mm、背面净空 ≥5 mm、USB 口中心距板边"，再选盒 | 用户 | `[ ]` |
| 8.2 | 纸板剪 70×90 试装候选盒（USB 口与端子能否对上） | 用户 | `[ ]`（**焊前做，见布局图 C9**） |
| 8.3 | 装壳：M3 尼龙柱垫高、线束固定、应力释放、不压 USB 与端子 | 用户 | `[ ]` |
| 8.4 | 装壳后复测 5 min（确认装配没压到线、`seg:"1"` 仍成立） | 砚青 | `[ ]` |

> ⚠️ 8.2 必须在焊接前完成。焊完再钻孔会震裂焊点；板子塞不进盒子时已经无法改外形。

### 待决策（不阻塞施工，但阻塞结项）

| # | 事项 | 谁来定 |
| --- | --- | --- |
| D-1 | `meter_record` 主键是否加宽为 `(device_id, epoch_id, seq)` | 用户 + 复核人 |
| D-2 | 是否加看门狗（会引入误重启风险） | 用户 + 导师 |
| D-3 | M17（`loop_ms`）接受"不适用" | 导师 |
| D-4 | 三次强制断电放 8h 专项还是 168h 内 | 用户 + 导师 |
| ~~D-5~~ | ~~`05_hardware/{carrier,pcb}` 是否入库（4.2 MB）~~ → **✅ 已结案（2026-10-26）**：用户明确"PCB 不要了"，两套工程 + 生成脚本**整体删除**，不再入库也不再备查。L2 若要 PCB 按 `26` §5 重新设计 | 用户 |
| D-6 | 外壳型号（按 §G8 8.1 量出的净高/开窗尺寸选） | 用户 + 采购 |
