jiangtao-ml/ESP32_C3_Gateway/02_docs/16_数据落地与商业化设计.md

# 16 · 数据落地与商业化设计（M5 → 产品化）

| 项 | 内容 |
| --- | --- |
| 文档 | `02_docs/16_数据落地与商业化设计.md` |
| 版本 | v1.0 |
| 日期 | 2026-10-05 |
| 作者 | WorkBuddy（文档 / 测试角色） |
| 触发 | 用户提问：采集数据怎么入库、解析格式怎么设计、错误数据怎么处理、商业化要考虑什么；并附《数据库说明.docx》 |
| 事实来源 | `04_ai_prompts/00_context.md` |
| 字段字典来源 | **`05_hardware/STB3-125_Database_Fields.md`（= 用户所附《数据库说明.docx》，逐条一致）**、`02_docs/06_QI协议说明.md` §5.3 |
| 实测依据 | `03_logs/M5真机首测_20261005_2035.log`（59 包真机数据）+ `06_tests/m5_parse.py` |

---

## 0. 先纠正一处我自己的疏漏

用户所附的《数据库说明.docx》，**仓库里本来就有**：`05_hardware/STB3-125_Database_Fields.md` / `.docx`
（逐条比对一致，含两张原始截图）。

2026-10-05 上午做 M5 数据核对时，我遇到 `reg1/2/3 = 0x6660/0x0066` 和 `reg7 = 0` 读不懂，
**只查了 `06_tests/M5_真机联调操作卡.md` §9 的换算速查表，没有去查这份字段表** ⇒ 当时只能标 `?` 并说"待查全表"。
**这是我的疏漏**，不是资料缺失。本文档把那份表接进来了。

---

## 1. 关键结论：39 个输入寄存器 ↔ 39 个数据库字段，**一一对应、顺序完全一致**

`STB3-125` 的输入寄存器 `30001~30039`（0-based `0x0000~0x0026`）与字段表里的 39 个字段**同序对应**。
两侧独立来源（协议文档 vs 数据库字段表）在同一点上完全吻合，且与真机实测值自洽 ⇒ **映射成立**。

| 序 | 寄存器 | DB 字段 | 类型 | 量程 / 精度 | 换算 | 真机实测（2026-10-05 20:35:40） |
| --- | --- | --- | --- | --- | --- | --- |
| 0 | `0x0000` | `openState` | varchar | 高字节 `0x01`=本地锁止/`0x00`=无锁；低字节 `0x0F`=分闸/`0xF0`=合闸 | 整字节比对 | `0x00F0` → **无锁 / 合闸** |
| 1 | `0x0001` | `record1` | varchar | 前第 9-12 次分闸原因，F=无 1=过流 2=漏电 3=过温 4=过载 5=过压 6=欠压 7=远程 8=模组 9=失压 B=限电 | 见 §1.1 | `0x6660` → 欠压×3 + 空位 |
| 2 | `0x0002` | `record2` | varchar | 前第 5-8 次分闸原因 | 同上 | `0x0066` → 欠压×2 |
| 3 | `0x0003` | `record3` | varchar | 前第 1-4 次分闸原因 | 同上 | `0x0000` → 全空位 |
| 4 | `0x0004` | `frequent` | double | 0~100 Hz，0.1 | ÷10 | `0x01F3` → **49.9 Hz** |
| 5 | `0x0005` | `leakage_current` | double | 0~1 A，0.001 | ÷1000 | `0x0000` → 0.000 A |
| 6 | `0x0006` | `N_temp` | int | −40~160 ℃ | −40 | `0x0040` → **24 ℃** |
| 7 | `0x0007` | `A_temp` | int | −40~160 ℃ | −40 | `0x0000` → −40 ℃ ⚠️**无效** |
| 8 | `0x0008` | `A_voltage` | int | 0~600 V | 1:1 | `0x00DE` → **222 V** |
| 9 | `0x0009` | `A_current` | double | 0~655.35 A，0.01 | ÷100 | `0x0000` → 0.00 A |
| 10 | `0x000A` | `A_Pf` | double | 0~1，0.01 | ×0.01 | 0.00 |
| 11 | `0x000B` | `A_power` | int | 0~65535 W | 1:1 | 0 W |
| 12 | `0x000C` | `A_Q` | int | 0~65535 VAR | 1:1 | 0 VAR |
| 13 | `0x000D` | `A_S` | int | 0~65535 VA | 1:1 | 0 VA |
| 14 | `0x000E` | `A_H` | int | 1~999999999 | — | `0x0004` |
| 15 | `0x000F` | `A_L` | double | 度，0.001 | 见 §1.2 | `0xE5CF` → **A 相 59093.144 度** |
| 16 | `0x0010` | `B_temp` | int | −40~160 ℃ | −40 | −40 ℃ ⚠️**无效** |
| 17 | `0x0011` | `B_voltage` | int | 0~600 V | 1:1 | 0 V |
| 18 | `0x0012` | `B_current` | double | 0~655.35 A | ÷100 | 0.00 A |
| 19 | `0x0013` | `B_Pf` | double | 0~1 | ×0.01 | 0.00 |
| 20 | `0x0014` | `B_power` | int | 0~65535 W | 1:1 | 0 W |
| 21 | `0x0015` | `B_Q` | int | 0~65535 VAR | 1:1 | 0 VAR |
| 22 | `0x0016` | `B_S` | int | 0~65535 VA | 1:1 | 0 VA |
| 23 | `0x0017` | `B_H` | int | 1~999999999 | — | 0 |
| 24 | `0x0018` | `B_L` | double | 度 | 见 §1.2 | **B 相 0.000 度** |
| 25 | `0x0019` | `C_temp` | int | −40~160 ℃ | −40 | −40 ℃ ⚠️**无效** |
| 26 | `0x001A` | `C_voltage` | int | 0~600 V | 1:1 | 0 V |
| 27 | `0x001B` | `C_current` | double | 0~655.35 A | ÷100 | 0.00 A |
| 28 | `0x001C` | `C_Pf` | double | 0~1 | ×0.01 | 0.00 |
| 29 | `0x001D` | `C_power` | int | 0~65535 W | 1:1 | 0 W |
| 30 | `0x001E` | `C_Q` | int | 0~65535 VAR | 1:1 | 0 VAR |
| 31 | `0x001F` | `C_S` | int | 0~65535 VA | 1:1 | 0 VA |
| 32 | `0x0020` | `C_H` | int | 1~999999999 | — | 0 |
| 33 | `0x0021` | `C_L` | double | 度 | 见 §1.2 | **C 相 0.000 度** |
| 34 | `0x0022` | `power` | int | 0~65535 W | 1:1 | 0 W |
| 35 | `0x0023` | `Q` | int | 0~65535 VAR | 1:1 | 0 VAR |
| 36 | `0x0024` | `S` | int | 0~65535 VA | 1:1 | 0 VA |
| 37 | `0x0025` | `H` | int | 1~999999999 | — | `0x0004` |
| 38 | `0x0026` | `L` | double | 度 | 见 §1.2 | **合相 59093.144 度** |

另有 5 个**不由寄存器提供**、由系统补齐的字段：`id` / `macAddress` / `address` / `collectTime` / `saveTime`。

### 1.1 两个悬案解开

- **`reg1/2/3` = `record1/2/3` 分闸记录**。实测 `0x6660` / `0x0066` / `0x0000`。
  ⚠️ **解码方式待确认**：字段表说是 varchar（4 条记录/字段），本文件的读法是"每半字节 1 条记录"
  （`0x6660` → 欠压/欠压/欠压/空位），**这是推测**；也可能是 ASCII 字符或 BCD。**定案前不得写进固件/入库逻辑**。
  不过它与现场自洽：施工/工地供电反复欠压跳闸是常见现象。
- **`reg7` = `A_temp`（A 相接线柱温度），量程 −40~160** ⇒ 实测 `raw = 0` → **−40 ℃ 恰好是量程下限**，
  而 A 相电压 222 V 说明该相是带电的 ⇒ **这是"无数据"的伪装值，不是真实温度**。
  同一时刻 `N_temp = 24 ℃`（板载温度）正常 ⇒ 判断该设备**不上报 A/B/C 接线柱温度**。

### 1.2 电量公式（字段表原文）

```
A 相总电量 = (A_H × 65536) / 1000 + A_L   单位度，精度 0.001
B 相总电量 = (B_H × 65536) / 1000 + B_L
C 相总电量 = (C_H × 65536) / 1000 + C_L
合相总电量 = (H   × 65536) / 1000 + L
```

⚠️ 字段表把 `A_L` 描述为「double 型，单位度，精度 0.001」，但公式里 `A_L` 是按**原始低字**（0~65535 整数）
参与运算的。**二者表述不一致**，按 `H=4, L=58831 → 59093.144 度` 验证，**公式口径才是对的**。
建议在字段字典里把 `A_L` 改注为「低字原始值（0~65535）」，避免下游把 0.001 再乘一次。

### 1.3 连带影响：操作卡 §9 换算表不完整

`06_tests/M5_真机联调操作卡.md` §9 只列了 27 项，**缺 `record1/2/3`、`A_Q/A_S`、`B_Q/B_S`、`C_Q/C_S`、`power/Q/S` 共 12 项**。
⇒ 应把 §9 改为**引用字段字典**，不要再维护第二份。

---

## 2. 数据链路分层与格式约定

```
L0 总线帧      Modbus RTU（485 差分，CRC16 保证）            ← 固件
L1 上行报文    UDP 文本：`YYYY-MM-DD HH:MM:SS | <78B HEX>`   ← 固件（M5 现状）
L2 解析换算    取 39 寄存器 → 按 §1 字典换算 → 判质量        ← PC / 边缘 / 云
L3 持久化      入库（结构化字段 + 原始留证 + 质量标记）
```

### 设计原则（建议固化为项目铁律）

> **固件只搬运原始值，不做任何工程量换算。**

理由（都是商业化的钱）：
1. **换算式变更不用召回设备**——改服务端即可，现场设备零动作；
2. **可重算**：保留原始 78 字节，历史数据可离线重放；新增字段/纠错不必重新采集；
3. 避免把"未验证的公式"固化进 240 台设备里的每一台。

M5 当前的 P12 已经就是这样（`m5_parse.py` 在 PC 侧换算），**这是隐性优势，不要"顺手优化"掉**。

---

## 3. 解析结果的字段契约（建议在字段表基础上补 6 列）

原字段表定义的是**"值"**，没有定义**"这条数据可不可信"**。商业化必须补：

| 新增字段 | 类型 | 用途 |
| --- | --- | --- |
| `device_id` | varchar | 设备唯一标识（优先 `macAddress`；**不要**用自增 `id` 当设备外键） |
| `src` | varchar | 数据来源：`real` 真机 / `sim` 模拟器 / `replay` 回放 —— **防止测试数据混入生产** |
| `raw_hex` | varchar(156) | 原始 78 字节 HEX，**留证 + 可重放** |
| `seg_ok` | char(3) | 三段成败位图，如 `111`；`101` 表示 S2 失败 |
| `quality` | varchar | 整行质量：`OK` / `PARTIAL`（部分字段无效）/ `BAD` |
| `invalid_fields` | varchar | 被判无效的字段名（逗号分隔或 JSON） |

建议索引：`UNIQUE(device_id, collectTime)` —— 补传/重发场景必然产生重复，靠唯一键做**幂等**。

---

## 4. 「错误的数据不要」—— 分四层，且**不要靠"丢整条"实现**

| 层 | 检查 | 现状 |
| --- | --- | --- |
| **L0 传输层** | CRC16 校验；**任一段失败即整轮不上传** | ✅ 已在固件实现（P6） |
| **L1 结构层** | 三段齐全 / 帧长 / `byte count` 与长度自洽 | ✅ 已在固件实现（P4） |
| **L2 语义层（新增，重点）** | ① 量程越界（按 §1 表逐字段判）<br>② **无效值伪装**：`A/B/C_temp == −40`（=量程下限）⇒ 判无效<br>③ 状态一致性：`openState` 合闸但三相电压全 0 ⇒ 可疑<br>④ 电量单调性：总电量只增不减，回退 ⇒ 计数字段异常<br>⑤ 时间合理性：`collectTime` 与 `saveTime` 偏差过大 / 时间戳重复 | ❌ **待做** |
| **L3 业务层** | 连续失败 N 次告警；设备级数据缺失率统计 | ❌ 待做 |

### ⚠️ 「不要错误数据」的两种实现，强烈建议选 (b)

- **(a) 整条丢弃**：简单，但**一个温度字段无效会连带丢掉 39 个有效字段**。
  按本次实测，A/B/C_temp 三项恒为无效 ⇒ **按 (a) 每一条数据都会被丢掉**，系统直接废掉。
- **(b) 整行入库 + 无效字段置 NULL + 打质量标记**：可追溯、可统计，也能按客户要求出
  "只看 `quality='OK'`" 的视图。

> 商业化要的是**数据质量可观测**，不是"看不见坏数据"。建议默认 (b)，
> 并保留一个**可配置的严格模式**给有强制要求的客户。

---

## 5. 商业化落地要考虑的（按优先级）

### P0 —— 不做会翻车

1. **上报协议必须换掉 UDP。** 现在是"无连接 / 无重传 / 无鉴权"，**丢一个包就永久丢 1 秒数据**（本次 59/60 就有 1 次缺口）。
   建议：**MQTT(QoS1) + TLS**，边缘侧本地缓存 + 序号 + 断网续传。
2. **规模账要早算。** 1 台 1 Hz = **8.64 万条/天**；1000 台 = **8640 万条/天**。
   ⇒ 必须定**采样/入库分频**（例：1 s 采样、15 s 或 60 s 落库）、**时序库**（TDengine / TimescaleDB / ClickHouse）
   或**分区表 + 冷热分离**。用自增主键 + 单表 MySQL 撑不住。
3. **安全基线**：一机一密、TLS、固件签名、安全启动、OTA 校验。
   485 侧目前是**明文、无认证**（现场短距离可接受，但必须写进威胁模型）。
   ⚠️ 历史提交里有明文 WiFi 凭据（Q-07 已按"策略 A 不改写历史"结案）—— 商业化前必须真换密码 + 一机一密。
4. **🚨 架构分叉点：只读铁律 vs 客户要"远程分合闸"。**
   `00_context.md` 三.5 明令本阶段**只读不写**（合闸/分闸/锁扣/解锁/复位/广播一律禁止）。
   但商业化后客户**一定**会要控制功能 —— 这是**产品需求与安全红线的正面冲突**。
   **必须先把安全设计做完**（强鉴权 + 二次确认 + 操作审计 + 权限分级 + 失败回滚 + 物理闭锁），
   才谈开放写操作。**在 M6 之前不要动它。**

### P1 —— 规模化之前必须补齐

5. **设备管理**：OTA、远程配置、心跳超时/离线告警、设备台账（`macAddress` ↔ 现场位置/箱号/客户）。
6. **时间一致性**：目前单 NTP 源（校内 chrony）。商业化需多源 + 单调时钟；
   **入库统一存 UTC + 时区字段**（现场是 CST-8），避免跨时区/夏令时事故。
7. **幂等与去重**：`UNIQUE(device_id, collectTime)`；补传必然重复。
8. **可重放**：`raw_hex` 保留策略（保留期/压缩/归档），这是纠错与审计的底牌。

### P2 —— 长期

9. **合规**：用电数据含用户行为与商业信息 ⇒ 等保、留存期、加密存储、数据出境。
10. **可靠性冗余**：单 ESP32 无冗余。建议心跳 + 离线判定 + 现场备用网关（哪怕只做"存储转发"）。
11. **硬件成本**：ESP32-C3 ~50 元 + **RS485 隔离模块（必配，不是可选）**；规模化后复核选型。
    `MAX13487` 5 V 双向、`EN` 固定高——已确认，无方向切换风险 ✅。
12. **可运维性**：日志分级、远程诊断、故障自恢复演练（断电/断网/485 断线各一次）。

---

## 6. 对现有资产的改动建议（**不阻塞 M5**）

| # | 动作 | 状态 |
| --- | --- | --- |
| **A1** | 把 §1 的表固化成字段字典（机器可读） | **✅ 已完成（2026-10-06）** —— `05_hardware/STB3-125_字段字典.csv`（39 行，列：`reg_index/reg_addr/field/cn/unit/raw_min/raw_max/decimals/conv`）。**唯一事实来源**，供固件解析 / 解析工具 / 建表 DDL / 文档四处共用 |
| **A2** | `06_tests/m5_parse.py` 改为**读字段字典** | ⏳ **部分**：新增的 `db_proto.py` **已是字典驱动**；`m5_parse.py` 仍内置一份拷贝 ⇒ 待改为读同一份 CSV |
| **A3** | 写 **SQLite 落库原型**（DDL + 解析 + 校验 + 打标 + 幂等） | **✅ 已完成（2026-10-06）** —— `06_tests/db_proto.py` + 导出的 `06_tests/db_schema.sql`。**不依赖真机**：用 `--demo` 合成数据、或 `--log <真机抓包>` 都能端到端跑通。实测真机 59 条全部入库且 `quality=OK`；同数据二次入库 **7→7、新增 0 行**（幂等成立） |
| **A4** | `M5_真机联调操作卡.md` §9 换算表 → 改为引用字段字典 | ⏳ 待做 |

> **A3 的一个关键设计（实测才发现）**：把「**该型号已知不上报的字段**」与「**本次异常**」分开。
> 否则按实测 `A/B/C_temp` 恒为 `−40`，**每一行都会被降级成 `PARTIAL`**，`quality` 就彻底失去区分度
> （永远不存在 `OK`）。`db_proto.py` 用 `--known-missing`（默认 `A_temp,B_temp,C_temp`）处理：
> 这些字段**仍置 NULL**，但**不拖累整行质量**，只在 `err_reason` 里记 `KNOWN_MISSING:...`。

---

## 7. 结论

1. **那份《数据库说明.docx》完全能用，而且是关键拼图** —— 它补齐了 39 个寄存器的完整语义，
   让 M5 的"解析"从"27 项 + 12 个问号"变成"39 项全解"。
2. **"错误的数据不要"的正确做法不是丢行，而是"整行入库 + 字段级置 NULL + 打质量标记"** ——
   否则按本次实测的无效值情况，会把全部数据都丢光。
3. **当前架构有一个商业化优势要守住**：固件只搬原始值、换算全在服务端 ⇒ 公式可演进、数据可重放。
4. **最大的架构分叉点是"要不要开放写操作"**，它撞的是项目自己的安全红线，需要单独决策。

---

## 8. 与老师的参考实现对比（2026-10-05 收到实拍，**重要**）

老师的 `ESP32-C3 + MAX13487 采集器`（固件 **1.5.0**，设备标识 `ESP485-AF49E4`）已经跑起来了，
能力清单与我们的 M5 对照如下：

| 能力 | 老师的实现 | 我们的 M5 | 结论 |
| --- | --- | --- | --- |
| **配置方式** | **常驻 AP 热点 + Web 配置页**（`ESP485-CFG-XXXX`，`http://192.168.4.1/`），保存**立即生效**、配置存闪存 | 编译期常量（`config.h`） | **老师的更适合商用**：现场改参数不用重烧 |
| **状态观测** | **`/status` JSON**：`mac/fw/ip/rssi/uptime_ms/poll_ok/poll_err/udp_tx/queue/dropped` | 只能看串口 / UDP 数据 | **值得抄**：`poll_ok/poll_err` 正是 M5 的"读取成功率" |
| **上行格式** | **JSON**：`seq` + `dev` + `ip` + `ts` + `quality` + 39 字段（**工程量**） | 文本 `时间戳 \| 78B HEX`（**原始值**） | 取舍见 §8.2 |
| **传输** | UDP :9000（带 `queue`/`dropped` 计数） | UDP :8888 | 同一代方案，**两边都还没上 MQTT** |
| **设备标识** | `dev = "ESP485-" + MAC 后 6 位` | 无（只有 IP） | **抄** —— 正是 §3 建议的 `device_id` |
| **质量标记** | **`"quality":"00"`** | 无（只有固件侧 PASS/FAIL） | 老师**已经做了** ✅ 但编码含义待确认 |
| **序号** | `seq` 递增 | 无 | **抄** —— 算丢包率、去重都要 |
| **时间戳** | ISO8601 + 微秒：`2026-10-03T20:40:23.503800` | `YYYY-MM-DD HH:MM:SS`（Q-12） | 入库用老师的 ISO 格式；人眼通道保留 Q-12 |
| **实测成功率** | `poll_ok 402 / poll_err 13` ≈ **96.9%** | 59/60 ≈ **98.3%** | 同量级 ⇒ **1 Hz 下 ~97% 可作基线** |

### 8.1 三点重要发现

1. **`quality` 字段老师已经实现了。**
   我 §3 建议的"整行入库 + 打质量标记"**方向与老师一致**（不是我独创）。
   ⚠️ 但 `"quality":"00"` 的**编码含义未知**（是位图？故障码枚举？）—— **需向老师确认**，
   确认前不得自行定义第二套。

2. **`A/B/C_temp = −40` 在老师的数据里同样存在**（`"A_temp":-40,"B_temp":-40,"C_temp":-40`）。
   ⇒ **不是我方接线或解析的问题**，是该型号设备确实不上报接线柱温度。
   ⚠️ 而老师的数据里 **−40 被原样输出、直接进库** ⇒ **说明这个"无数据伪装值"目前会污染数据库**。
   ⇒ §4 的 **L2 无效值判定是真实存在的缺口**，且已被老师自己的数据佐证。

3. **老师的 `recor1 = "6666"` / `recor2 = "0066"` / `recor3 = "0000"`，
   与我们实收的 `0x6660` / `0x0066` / `0x0000` 完全同构**
   （4 位十六进制字符 = 4 条分闸原因，逐位对应）。
   ⇒ 我 §1.1 标"推测"的**半字节解码，现已被老师的独立实现佐证**，置信度可上调为
   「已由老师实现验证」（仅 `0` 与 `F` 的区别仍待确认）。
   📌 另注：老师的字段名写作 **`recor1/2/3`**（少一个 d），若日后要接收老师的数据需做兼容映射。
   📌 **老师的 JSON 里没有 `openState`**（其余 38 项齐全）—— 是有意省略还是遗漏，值得一问。

### 8.2 一处架构分歧（要总控裁定）

- **老师：固件内换算** —— JSON 直接给工程量（`"frequent":50.1`、`"A_voltage":231`、`"A_current":0.11`）。
- **我们 M5：固件只搬原始值** —— 78 B HEX，换算在 PC / 服务端。

| 对比项 | 老师（固件换算） | 我们（只搬原始值） |
| --- | --- | --- |
| 接收端复杂度 | **低**（直接入库） | 需要一个解析层 |
| 公式 / 字段含义变更 | **要重烧每一台设备** | 改服务端即可 |
| 历史可重算 | **不能**（JSON 里没有原始值） | **能**（保留 raw） |
| 现场演示友好度 | **高** | 低 |

**建议（折中，不推翻任何一方）**：
1. M5 的"原始值"通道**保持不动**（已实测可用）；
2. 由**服务端**生成"工程量 JSON"（等价于老师的输出）—— 接收端一样简单，但公式仍可演进；
3. 若总控决定让**固件直出 JSON**，则**必须同时附带 `raw`（78 B HEX）字段**，否则历史数据不可重算。
4. 两条路都要把 `seq` / `dev` / `quality` / `ts` 对齐（见 §8.3），**格式统一是接老师数据的前提**。

### 8.3 可以马上就抄的三件事

| # | 抄什么 | 落在哪 |
| --- | --- | --- |
| 1 | **`/status` 计数器**：`poll_ok` / `poll_err` / `udp_tx` / `queue` / `dropped` / `uptime_ms` | 补进 P13 的 UDP 行或另开一行；`poll_ok/poll_err` 就是 M5「读取成功率」的现成分母分子 |
| 2 | **`dev` 设备标识** = MAC 后 6 位 | 我们的 UDP 行加 `dev=` 字段，入库即 `device_id` |
| 3 | **`seq` 递增序号** | 同上；用来算丢包率、做补传去重 |

> 老师的 `queue` / `dropped` 两个计数说明**固件里有本地排队**（我 §5-P1 建议的"边缘缓存"雏形）。

### 8.4 🔴 商业化必须处理的安全项（本次实拍暴露）

| # | 问题 | 风险 | 处置 |
| --- | --- | --- | --- |
| 1 | **AP 热点用固定密码，且密码已出现在文档 / 聊天记录里** | 任何人靠近即可连上配置页，**改 WiFi / 改 UDP 目标地址 = 把数据引流到别处** | 一机一密；配网完成后**关闭或超时关闭 AP**；密码贴在设备标签而非写在群文件 |
| 2 | **配置页无鉴权**（`http://<ip>/` 直接打开就能改） | 同网段任何人可改参数 | 加口令 / Token；改关键项（UDP 地址）需二次确认 |
| 3 | **`/status` 明文暴露 MAC、内网 IP、上游地址** | 攻击前的情报收集 | 加鉴权或仅在 AP 配网模式开放 |
| 4 | **UDP 明文、无鉴权** | 可伪造数据上报；可窃听 | MQTT + TLS（§5-P0 第 1 条）；至少加应用层校验 |

---

## 9. 推进计划（2026-10-05 定）

> 前提澄清（用户补充）：**老师本意是让用户 / 企业都能改配置，图的是方便。** 这是**对的需求**，
> 所以 §8.4 的结论不是"把配置锁死"，而是 **把"谁能进"从"知道那个已流出的密码的人"改成"手里拿着设备的人"**。

### 9.1 六条线（按"谁能动"排序）

| 序 | 线 | 内容 | 谁能做 / 阻塞点 |
| --- | --- | --- | --- |
| **①** | **向老师对齐**（零成本，**先做**） | **基准已定（2026-10-05 21:15 用户裁定）：以逆向的那块板为准**（`48:F6:EE:15:9B:88`：用 `mac`、**无** `dev`/**无** `quality`、配置页**有**鉴权）。<br>**只剩两个问题**：<br>a) **能不能直接给源码** —— 逆向只能拿字符串，要改逻辑必须有源码<br>b) **这块板的固件版本号**是什么（便于日后对齐） | 用户发一条消息即可 |
| **②** | **M5 收尾**（关卡纪律） | a) **E-02 决策**：烧一次 `QI_READ_SPLIT_3SEG = 0`，在真机上试 `00 27` 一帧读全<br>b) **缺的 1 包定性**（需串口）<br>c) 写 `02_docs/08_M5真机联调记录.md`（交付物，待建） | **需老师配合断电一次**<br>⇒ 与 ③ 合并同一次窗口 |
| **③** | **对齐上报格式（JSON）** | 把我们的上行从 `时间戳 \| 78B HEX` 改成**与基准同构的 JSON**（§9.4）。⚠️ 其中"换算放哪"需一次裁定 | 需 Codex 改 + 断电烧录；**与 ② 合并** |
| **④** | **PlatformIO 并行验证** | 迁移窗口已到（§9.5）。新建 `platformio.ini` + `src/main.cpp` **与现有 `.ino` 并存**，**只编译不烧录**，比对 Flash/RAM 与警告 | **WorkBuddy 可独立做**（不占断电窗口、不动现有工程） |
| **⑤** | **落库原型**（可独立推进） | SQLite：建表 DDL + 解析 + **L2/L3 四层校验** + 打标 + 幂等 | **不依赖真机** |
| **⑥** | **安全整改**（交付前） | 见 §9.2 | 需老师同意改固件 |

### 9.2 安全项的正确姿势（回应"老师要方便"）

问题不在"开放"，在**开放给谁**：

- **现在** = 知道那个（已流出的）密码的人，**任何时间、任何距离**内都能进；
- **目标** = **手里拿着这台设备的人**才能进。

做到这一点的最小改动、且**完全不牺牲现场便利**：

| # | 改动 | 现场体验 | 关掉的口子 |
| --- | --- | --- | --- |
| 1 | **AP 上电只开 N 分钟，或长按按键才开** | 装机时开着，照样方便；**运行期自动关门** | 设备在线期间的常开入口 |
| 2 | **一机一密，密码印在设备标签上** | 照样"看一眼标签输入" | 一处泄露 = 全网泄露 |
| 3 | **配置页加口令（复用 AP 密码）** | **零额外记忆成本** | 同网段任意人可改 |
| 4 | **改 UDP 目标地址需二次确认** | 多点一次 | **唯一能把数据引流出去的开关** |
| 5 | 长期：上行 MQTT + TLS | 无感知 | 伪造 / 窃听 |

> 一句话：**把"墙上那把万能钥匙"换成"每台设备各自的门卡"，便利性一点没少。**

### 9.3 现在**不要**做

| 别做 | 原因 |
| --- | --- |
| MQTT / 时序库 / 云平台 | 属**产品化阶段**；现在上会打断"跑通 → 压测 → 产品化"的节奏（§5 已登记，不是遗忘） |
| 远程分合闸等**写操作** | 撞 `00_context.md` 三.5 **只读铁律**；**M6 之前不碰**（§5-P0 第 4 条已定性为架构分叉点） |
| 在 `quality` 语义确认前自定义第二套质量编码 | 会与老师的数据**对不上**，后期还得改 |

### 9.4 对齐清单：以逆向的那块板为基准

**基准版固件**（`48:F6:EE:15:9B:88`）的上行格式串（原文，见 `02_docs/17` §3）：

```
{"seq":%lu,"mac":"%s","ip":"%s","ts":"%s","ts_ok":%s,
 "openState":"%04X","record1":"%04X","record2":"%04X","record3":"%04X",
 "frequent":%.1f,"leakage_current":%.3f,"N_temp":%d,
 "<A|B|C>_temp":%d,"<A|B|C>_voltage":%u,"<A|B|C>_current":%.2f,"<A|B|C>_Pf":%.2f,
 "<A|B|C>_power":%u,"<A|B|C>_Q":%u,"<A|B|C>_S":%u,"<A|B|C>_H":%u,"<A|B|C>_L":%.3f,
 "power":%u,"Q":%u,"S":%u,"H":%u,"L":%.3f}
```

| 类别 | 项 | 决定 |
| --- | --- | --- |
| **必须一致** | 字段名、字段顺序、语义 | 按上表逐字对齐（与 `05_hardware/STB3-125_Database_Fields.md` 三方吻合） |
| **必须一致** | `openState` / `record1/2/3` 的表示 | **`"%04X"` 十六进制字符串**（半字节解码已确认） |
| **必须一致** | 设备标识 | **用 `mac`**（完整 MAC），**不用 `dev`** |
| **必须一致** | 心跳行独立 | 基准：`"type":"hb"` + `rssi/free_heap/poll_ok/poll_err/udp_tx/queue/dropped/cfg`。**我方现状（2026-10-27）**：去掉 `cfg`；新增 `dev`/`fw`/`mode`/`tx_fail`/`reconn`/`up`/`reset`/`boot`/`clk_hold`/`clk_back`；且 `queue`/`dropped` 由 `0` 改 **`null`**（本固件无发送队列，不谎报）。**接收端按名取值、缺键不报错**（`HB_REQUIRED` 只 5 个键），故不破坏兼容；完整差异见 `02_docs/30` |
| **必须一致** | `/status` 22 项 | 逐字对齐 |
| **必须一致** | `ts` 时间戳 | ISO8601（基准是 `2026-10-03T20:40:23.503800`）；**人眼通道可继续用 Q-12 格式** |
| **可以不同（推荐）** | **换算位置** | 基准 = **固件内换算**；我们**推荐"基线字段 + 末尾追加 `raw`（78 B HEX）"** —— JSON 接收端按名取值，多一个字段不破坏兼容，但换来**公式可演进 + 历史可重放**。⚠️ **此项需一次裁定** |
| **可以不同（推荐）** | **质量标记** | 基准这版**没有** `quality`（老师新版有）。**建议：上报格式严格对齐基准、不加 `quality`；把质量判定放在"入库层"**（§4 的 L2/L3），落成数据库的 `quality` / `invalid_fields` 列。**上报字段 ≠ 数据库列**，两边都不冲突 |
| **保持现状** | 传输 | 双方都还是 UDP（老师 :9000，我们 :8888）；MQTT 属产品化阶段 |

> 一句话：**"以这块版本为准"我们落成"字段与语义逐字对齐，只有在'可重算性'和'质量标记位置'两点上做加法，并把加法做成向后兼容"。**

### 9.5 PlatformIO 迁移（**窗口已到**）

**这条不是新话题，是接上一条已登记的决策。** 项目记录里写着：
导师张振亚要求组内迁 **VSCode + PlatformIO + Claude Code**，项目已裁定
「**PlatformIO 接管编译推迟到 M5 真机数据稳定之后、M6 压测之前**」（导师已回「可以」默许）。
当时推迟的理由：换构建系统会污染 M5 期间"硬件 or 代码"的判因。

**现在**：M5 主干实测已通过（真机 3 段读取、59/60 成功、连续 60 s 无失败），只剩两个小尾巴（E-02、缺包定性）。
**⇒ 触发条件基本达成，老师那边也在用 PlatformIO ⇒ 顺理成章，窗口到了。**

**做法：并行验证，不整体切换。**

| 步 | 动作 |
| --- | --- |
| 1 | 新建 `platformio.ini` + `src/main.cpp`，**与现有 `01_firmware/esp32c3_gateway/` 的 `.ino` 并存**（不动现有工程，M5 收尾还能用它） |
| 2 | **只编译、不烧录**；比对 Flash / RAM 是否等价、有无新增警告 |
| 3 | 等价后再决定是否切换为唯一构建方式，并同步 `README` / 任务书 / 排障文档 |

**必须锁死三件事**（否则重演 `esp-rv32` 那次排障）：

1. **core 版本** —— ⚠️ **这是最大的坑**：PlatformIO 默认的 `espressif32` platform 用的是 **arduino-esp32 2.x**
   （**正是老师那套**，`esp-idf v4.4.7`），而我们 Arduino IDE 用的是 **3.3.10（IDF 5.x）**。
   ⇒ **一旦迁移，core 会降级，API 可能不兼容**（`configTzTime` / `sntp_*` / `WiFi.setSleep` 等签名有过变化）。
   ⇒ 必须**显式锁定版本**（写死在 `platformio.ini` 里），并**重新编译 + 复跑一遍 M5 验证**，不能"默认就好"。
2. **编译选项要搬全** —— `CDCOnBoot=cdc`（USB CDC On Boot，**必须**，否则 Serial 会占 GPIO20/21）、Flash 4 MB、分区表。
3. **`.ino` → `main.cpp` 的坑** —— `.ino` 由 Arduino 预处理器**自动生成函数原型**；改成 `main.cpp` 后
   **必须自己补前向声明**，否则会出现一堆"未声明标识符"的错误（这与代码逻辑无关，纯构建差异）。

> 附带好处：老师的固件里出现 `Arduino Event Malloc Failed!` ⇒ **他用的也是 arduino 框架，只是构建工具是 PlatformIO**。
> ⇒ **框架相同、只是构建工具不同** ⇒ 复用代码的成本比想象中低。

### 9.5.1 ⚠️ 实测阻塞（2026-10-05 22:00，**重要**）

**② 「PlatformIO 并行验证」在当天网络条件下做不成** —— 卡在下载，不是卡在代码。

| 实测项 | 结果 |
| --- | --- |
| `platform-espressif32` | ✅ **已装**（`espressif32@7.1.3`，7 MB） |
| `toolchain-riscv32-esp`（~200 MB+） | ❌ 下载速度仅 **≈14 KB/s**（两分钟 1.67 MB）⇒ 单独这个就要 **约 4 小时**，而 PlatformIO 侧还要 `framework-arduinoespressif32` 等，总量 **GB 量级** |
| 网传"清华 PlatformIO 镜像" | ❌ **不存在**（`mirrors.tuna.tsinghua.edu.cn/platformio/` → **404**；TUNA 的 404 页还专门提示"从大模型拿到的链接多半不存在"） |
| 网传"阿里云 PlatformIO / espressif 镜像" | ❌ **均 404** |
| 本地代理 | ❌ 7892 / 7890 / 7897 / 10809 / 1080 **全部未监听** |
| 国内网络本身 | ✅ **不慢** —— TUNA 首页 0.2 s 返回 22 KB ⇒ **慢的是 PlatformIO 的 CDN，不是家里的网** |
| 另注 | PlatformIO Core **不读 Windows「Internet 选项」代理**，只认环境变量 `HTTP_PROXY` / `HTTPS_PROXY` ⇒ 系统代理开着也没用 |

**✅ 但本地其实已经有大部分所需组件**（Arduino esp32 core 3.3.10-cn 装的）：

| Arduino 侧（`Arduino15\packages\esp32\tools\`） | 体积 | PlatformIO 对应包 |
| --- | --- | --- |
| **`esp-rv32` 2601-cn**（RISC-V GCC） | **2387 MB** | `toolchain-riscv32-esp` |
| `esptool_py` 5.3.0-cn | 62 MB | `tool-esptoolpy` |
| `mkspiffs` / `mklittlefs` | 1.8 MB | `tool-mkspiffs` / `tool-mklittlefs` |
| `openocd-esp32` | 7 MB | `tool-openocd-esp32` |
| `esp32c3-libs` 等 | 200 MB+ | `framework-arduinoespressif32-libs`（部分） |

⇒ 缺的主要是 `framework-arduinoespressif32`（Arduino core 本体在 `Arduino15\packages\esp32\hardware\esp32\3.3.10-cn`）。

**三条出路（按性价比排序）：**

| # | 办法 | 成本 |
| --- | --- | --- |
| **A** ⭐ | **找老师要一份 `/教授机/.platformio` 的 `platforms/` + `packages/` 打包拷过来** —— 他那边已装齐，PlatformIO 的包目录**是可移植的**，拷过来 0 下载 | 一次拷盘 |
| **B** | 换网络环境再下：**手机 5G 热点** / 有代理的机器 / 学校机房；或先设 `HTTPS_PROXY` 再跑 `pio run` | 等网络 |
| **C** | 把 Arduino 已有的包**软链/改造给 PlatformIO 用**（`esp-rv32` → `packages/toolchain-riscv32-esp`，补版本标记） | **可行但不确定**：目录命名与版本号都对不上（PlatformIO 要 `8.4.0+2021r2-patch5`，Arduino 那份是新的 GCC），可能要调较久 |

### 9.5.2 复核"四条提速方法"（2026-10-05 22:10，**逐条实测**）

用户提供了 4 条网传方案，逐条验证如下（**结论：1 条真、2 条假、1 条前提不满足**）：

| 方法 | 判决 | 实测依据 |
| --- | --- | --- |
| **① `platform_packages` 指向 `dl.espressif.cn`** | **✅ 真实且很快，但只解决一半** | `.../arduino-esp32/releases/download/2.0.17/esp32-2.0.17.zip` → **HTTP 200，242.9 MB**；**实测下载 2185 KB/s（≈2.1 MB/s）**，比 PlatformIO CDN **快 150 倍以上**。⚠️ 但：**(a) 它只换 framework，不换卡住的工具链**；**(b) 版本对不上**（见 §9.5.3） |
| **② `pioconfig.ini` + 阿里云/清华镜像** | **❌ 不可行，URL 是编的** | `mirrors.aliyun.com/espressif/` → **404**；`mirrors.aliyun.com/platformio/` → **404**；清华 TUNA 无 `platformio` 目录（404）。且 PlatformIO **没有 `pioconfig.ini` 这个配置文件**，`mirror.*` 键名官方不认 |
| **③ 设 `HTTPS_PROXY` 走代理** | **✅ 思路对，但前提不满足** | `HTTPS_PROXY` + `pio settings set enable_proxy_strict_ssl false` 这两条正确（PlatformIO Core **只认环境变量**，不读 Windows 系统代理）。但实测本机 **7892/7890/7897/10809/1080 全部未监听** ⇒ 现在设了也没用 |
| **④ 手动下载放 `packages/`** | **✅ 思路对（兜底），但它给的源 404** | `mirrors.aliyun.com/espressif/tools/` → **404**。⚠️ 另注：**裸目录不一定被识别** —— PlatformIO 靠包目录里的 `.piopm` 元数据判断是否已装，常需补元数据。**正确源应换成乐鑫 CN CDN**（见下） |

**✅ 已验证可用的乐鑫 CN CDN 直链（实测 HTTP 200）**

| 包 | URL | 大小 |
| --- | --- | --- |
| **工具链（正是 PlatformIO 要的版本）** | `https://dl.espressif.cn/github_assets/espressif/crosstool-NG/releases/download/esp-2021r2-patch5/riscv32-esp-elf-gcc8_4_0-esp-2021r2-patch5-win64.zip` | **247.7 MB** |
| framework 2.0.17 | `https://dl.espressif.cn/github_assets/espressif/arduino-esp32/releases/download/2.0.17/esp32-2.0.17.zip` | 242.9 MB |

> ⚠️ 乐鑫 CN CDN **只镜像 GitHub release 资产**，不镜像 PlatformIO 自己重新打包的包
> ⇒ `toolchain-riscv32-esp@8.4.0+2021r2-patch5` 这个"PlatformIO 重打包版"在上面**没有**；
> 但它的**上游**（Espressif 原版 win64 zip）有 —— 代价是**目录布局不同**（原版多一层），需拍平 + 补 `.piopm`。

### 9.5.3 🔴 比下载更重要的发现：**"零差异"这个目标不成立**

| 项 | 我们（Arduino IDE） | `espressif32@7.1.3` 声明要的 |
| --- | --- | --- |
| Arduino core | **arduino-esp32 3.3.10** | **`framework-arduinoespressif32 ~4.20017.0`**（2.0.17 那一代） |

佐证（乐鑫镜像实测）：`esp32-3.3.10.zip` → **404**；`esp32-3.3.0.zip` → 200 但**只有 24.6 MB**
（3.x 把预编译库拆成独立的 `*-libs` 包 —— 这正是本机 `Arduino15` 下那堆 `esp32c3-libs`（200 MB+）的来源）。

> **⇒ 迁到 PlatformIO ≠ 零差异，而是"换 core"（3.3.10 → 2.0.17）。**
> API 会变（§9.5 已预警），**产物必然不同**，且**必须重跑一遍 M5 验证**。
> **⇒ 所以 ② 的真正前置不是"能不能下载"，而是"迁到哪个 core"——这个决定必须由用户 / 总控做。**
> 📌 附带好处：老师用的是 PlatformIO + **arduino-esp32 2.x** ⇒ **他那边和 `espressif32@7.1.3` 的默认是同一代**，
> 所以"找老师拷 `.platformio`"不仅能省下载，**而且正好验证他那个组合**。

### 9.5.4 ✅ ② 已完成：**能编过，但产物不等价**（2026-10-05 22:44）

**结论：PlatformIO 编译通过（`[SUCCESS] Took 47.21 s`，0 error / 0 warning），但产物与 Arduino 不等价。**

| 指标 | Arduino IDE（arduino-cli，**core 3.3.10**） | PlatformIO（**core 2.0.17**） | 差 |
| --- | --- | --- | --- |
| **Flash** | **1 000 967 B**（76%） | **766 588 B**（58.5%） | **−234 379 B（−23.4%）** |
| **RAM（global）** | **38 412 B**（11%） | **40 212 B**（12.3%） | **+1 800 B（+4.7%）** |
| error / warning | 0 / 0 | **0 / 0** | — |
| 产物 | — | `firmware.bin` 785 456 B / `firmware.elf` 11.0 MB | — |

> **⇒ 「迁 PlatformIO 零差异」的答案：不成立（已量化）。**
> 差异来源就是 §9.5.3 说的**换 core**（3.3.10 → 2.0.17）：库更旧更瘦 ⇒ Flash 少 229 KB；静态区更大 ⇒ RAM 多 1.8 KB。
> **⇒ 迁移的正确姿势是"换 core + 重跑全套验证"，不是"零差异切换"。**

**⚠️ 两个必须一并计入迁移成本的点**

1. **"只 include 外部 `.ino`"这种骨架会让 PlatformIO 的 LDF 失效**：`src/main.cpp` 只 `#include "../esp32c3_gateway/esp32c3_gateway.ino"`，
   而该 `.ino` **在 `src/` 之外** ⇒ LDF **看不到它里面的 `#include <WiFi.h>`** ⇒ 报
   `fatal error: WiFi.h: No such file or directory`（框架核心本身编得过）。
   本次靠两处人为改动绕过：`lib_ldf_mode = deep+` + 一条额外 `-I.../libraries/WiFi/src`。
   ⇒ **正式迁移时应当把 `.ino` 拆成真正的 `src/*.cpp`**（届时还要补函数原型，见 §9.5 第 3 条）。
2. **能编过 ≠ 跑对**：0 error / 0 warning 只说明 **API 层面兼容**；**运行期行为差异（NTP / WiFi / 485 时序）完全没验证**。

**✅ 已解决的环境问题（可复用）**

| 问题 | 解法 |
| --- | --- |
| PlatformIO CDN ≈14 KB/s | 改用**乐鑫 CN CDN `dl.espressif.cn`（实测 2.1 MB/s）** |
| 乐鑫给的是原版包，PlatformIO 报 `MissingPackageManifestError` | **离线预置**：`06_tests/pio_cn_seed.py` —— 解压到 `~/.platformio/packages/`，**自动拍平多余顶层目录 + 写 `package.json` / `.piopm`** |
| framework 包主属必须是 **`platformio/`**（不是 `espressif/`），否则 PlatformIO 认为没装 | 已在脚本里更正（`pio_owner="platformio"`） |
| pip 依赖走 PyPI 只有 37 kB/s | 可加 `PIP_INDEX_URL=https://pypi.tuna.tsinghua.edu.cn/simple`（清华 PyPI 镜像**是真实存在**的） |

📌 本工程实测体量：`toolchain-riscv32-esp` 908 MB + `framework-arduinoespressif32` 703 MB（解压后），
外加大约 20 个小包 ⇒ 说明**为什么"拷老师那份 `.platformio`"仍然是最快的路**。

---

---

## 10. 功能对齐清单（对齐老师的参考实现，2026-10-06 用户要求）

**用户要求：老师有的功能，我们也要有。** 共 8 项。**不一次全做**——按"可独立验证"分批：

| # | 能力 | 老师 | 我们（现状） | 批次 | 风险 |
| --- | --- | --- | --- | --- | --- |
| 1 | **一帧读全 39** | ✅ | ❌ 走 3 段（E-02 保守方案） | **2** | 中（动状态机 + E-02） |
| 2 | **输出 JSON** | ✅ | ❌ 文本 `时间戳 \| 78B HEX` | **1** | 低（只动上行侧） |
| 3 | **设备命名 `ESP485-<MAC后6位>`** | ✅ | ❌ 无 | **1** | 低 |
| 4 | **Web 配置页**（改 WiFi/NTP/UDP/周期） | ✅ | ❌ 编译期常量 | **3** | 高（≈新写一套） |
| 5 | **`/status` JSON 端点** | ✅ | ❌ 无 | **3** | 高 |
| 6 | **AP 回退**（连不上开热点） | ✅ | ❌ 无 | **3** | 高 |
| 7 | **闪存配置持久化** | ✅ | ❌ 无 | **3** | 中 |
| 8 | **统计 `poll_ok/poll_err/udp_tx`** | ✅ | ⚠️ 只有串口统计 | **1** | 低 |

### 10.1 分批方案与理由

| 批次 | 内容 | 为什么这样切 | 状态 |
| --- | --- | --- | --- |
| **1** | **JSON 上行（数据行 + 心跳行）+ `dev` 命名 + 累计计数器** | 只动 `sendUdpPayload` 与几个计数器 ⇒ **不动 485 逻辑、可台面验证**（A/B 拔掉 + USB 供电 = 无市电回路，安全） | ✅ **Codex 已交付，WorkBuddy 独立复核通过**（数字逐字节一致）；⏳ **待补 3 项小修**（见 §10.4）。指令：`04_ai_prompts/04_...md`（§八 为复核结论与补项） |
| **2** | **一帧读全为默认 + 失败自动降级 3 段** | 顺带**一举给出 E-02 的答案**（真机到底接不接受 `00 27`）；但会动状态机，**必须与批次 1 分开** | 待批次 1 验证后另发指令 |
| **3** | **AP + Web 配置页 + `/status` + NVS 持久化** | 等于新写一套配置体系，**改动量与风险完全不同级**，不应与批次 1 混在一次提交 | 待批次 2 后另发指令 |

### 10.2 批次 1 里我们要比老师**多做**的两处（已写进指令）

1. **JSON 里额外带 `raw`（78 字节 HEX）** —— 老师只有工程量 ⇒ **他的历史数据不可重算**；
   多一个字段不破坏兼容，但换来公式可演进 + 历史可重放（§9.4 已论证）。
2. **带 `quality` 与 `invalid`（无效字段列表）** —— 老师把 `A/B/C_temp = −40` 原样发出去，
   **接收端无法分辨"设备不上报"与"本次异常"**；我们多给一个无效字段列表（§4 已论证）。

### 10.3 批次 1 的一个**行为变更**（需留意）

失败时**不再单独发 `FAIL:Sx:原因` 行**，改为「数据行 / 心跳行」两类行模型（对齐老师）。
⇒ **代价：拔掉 USB 时现场看不到失败段与原因**（只剩计数器）。
⇒ 指令里要求：**串口日志必须保留 `FAIL:Sx:原因`**，并请 Codex 回报"要不要额外发一行 `type:"err"`"。

### 10.4 批次 1 复核发现（2026-10-06）——**一个"同一个坑踩了两次"的问题**

Codex 交付后 WorkBuddy 独立复核：**编译数字逐字节一致**（`1004579` / `39108`，0 error / 0 warning，
本工程文件 0 warning），硬约束逐条通过，6 处 `appendf` 的格式串与实参**逐个对上**。**报告可信。**

🔴 **但固件侧把 `A/B/C_temp == -40` 计入了 `invalid`** ⇒ 而该型号设备**恒不上报接线柱温度**
⇒ **每一行数据的 `invalid` 都非空 ⇒ `quality` 永远是 `PARTIAL`，彻底失去区分度**。

> ⚠️ **这正是 §6「A3 的一个关键设计」里、落库原型已经踩过并修正的同一个坑**
> （那里是 `OK=0/PARTIAL=6` → `OK=6/PARTIAL=0`）。
> **教训**：这不是"固件没写好"，而是**我写指令时没把"已知不上报 ≠ 本次异常"这条口径写进去**
> —— 口径在文档里，但没有传递到固件规格。**以后凡是"字段有效性"相关的指令，必须显式带上这条分层。**
> ⇒ 已在 `04_ai_prompts/04` §8.2 补上（要求加 `QI_PHASE_TEMP_ABSENT` 宏，与 `db_proto.py --known-missing` 同口径）。

**另两项一起补（趁未烧录，零额外窗口成本）**：`QI_UDP_PAYLOAD_MAX` 1024→1200（最坏 1106 B 会截断）；
实现 `QI_SEND_ERR_ROW` 且**本次默认为 1**（第一次真机运行 USB 必须拔掉 ⇒ 没有串口 ⇒ `type:"err"` 行是唯一的失败可见通道）。

### 10.5 ✅ 批次 1 收尾：3 项补项**已交付并独立复核**（2026-10-06）

Codex 按 §10.4 / 指令 §8.2 交付 ①②③，WorkBuddy **独立重编复核**（`arduino-cli --clean --warnings all`）：

| 项 | 落地 | 复核 |
| --- | --- | --- |
| ① `A/B/C_temp == -40` 不进 `invalid` | `config.h` 新增 `QI_PHASE_TEMP_ABSENT 1`；`.ino` 拆两支：`== -40` 走空分支（宏=1），`< -40` / `> 160` 无论宏取值都进 `invalid` | ✓ 逐行核对；`quality` 判定式**一字未改** |
| ② `QI_UDP_PAYLOAD_MAX` 1024 → 1200 | `config.h` | ✓ 截断告警路径保留，不静默截断 |
| ③ `QI_SEND_ERR_ROW`（本次默认 1） | `config.h` + `.ino` `buildErrJson()`；失败轮发 `hb + err`、成功轮发 `hb + data` | ✓ 回环模式编译不受影响；`poll_err` 取本轮 `++` 后值 |

**编译基线**：seg1（3 段）**Flash `1004899` / RAM `39284`**、seg0（一帧读全）`1004339` / `39284`，**0 error / 0 warning**（`--warnings all` 下 38 条警告**全部**来自 core `gpspi_flash_ll.h` / `spimem_flash_ll.h`，本工程 0 条）——**与 Codex 报告逐字节一致**。
**最坏行长**：数据行 **1106 B**（缓冲 1200 ⇒ 余量 **94 B**；1024 时缺口 82 B ⇒ ② 确有必要）；典型数据行 898 B（旧口径 923 B ⇒ ① 省 25 B 并恢复 `quality` 区分度）；心跳 213 B / err 典型 130 B。
**代价与注意**：① 每轮现在**恒发 2 行**（`hb + err` 或 `hb + data`）⇒ `seq` 每轮 +2；② 数据行 `seg` 是**读取模式**、err 行 `seg` 是**失败段**，**落库 / `udp_listen.py` 解析时不得当同一字段**。
⇒ **代码侧批次 1 完成**（未 commit）；**下一步 = 真机跑一次**（场次：③ 台面 A/B 拔掉 + USB 供电 → 真机 充电宝供电 + 拔 USB）。

---

## 变更记录

| 版本 | 日期 | 作者 | 变更内容 |
| --- | --- | --- | --- |
| **v1.10** | 2026-10-06 | WorkBuddy | **批次 1 收尾**，新增 **§10.5**。① §10.4 的 3 项补项（`QI_PHASE_TEMP_ABSENT` / `QI_UDP_PAYLOAD_MAX 1200` / `QI_SEND_ERR_ROW`）**已交付**，WorkBuddy **独立重编复核** `1004899`/`39284`、0 error/0 warning，**与 Codex 报告逐字节一致**；② 记录最坏行长（数据行 1106 B、缓冲余量 94 B）与两条代价（`seq` 每轮 +2；数据行 `seg`=读取模式 vs err 行 `seg`=失败段，**解析时不得混同**）；③ §10.1 批次 1 状态改为「代码完成·复核通过·待真机」。 |
| **v1.9** | 2026-10-06 | WorkBuddy | **批次 1 交付并复核**，新增 **§10.4**。① 独立复核结论：**编译数字逐字节一致**（`1004579`/`39108`，0 error/0 warning，本工程 0 warning）、硬约束逐条通过、6 处 `appendf` 格式串与实参逐个对上 ⇒ **Codex 报告可信**；② 🔴 **发现固件侧把 `A/B/C_temp == −40` 计入 `invalid`** ⇒ 该型号恒不上报接线柱温度 ⇒ **每行 `quality` 永远是 `PARTIAL`、失去区分度**；**这正是落库原型已踩过并修正的同一个坑** ⇒ 教训记录：**口径在文档里、但没传递到固件规格**，以后"字段有效性"类指令必须显式带上「已知不上报 ≠ 本次异常」的分层；③ 另两项补项（缓冲 1024→1200、实现 `QI_SEND_ERR_ROW` 且本次默认 1 —— 因为第一次真机运行 USB 必须拔掉、没有串口）；④ §10.1 批次 1 状态更新为「已交付·复核通过·待 3 项小修」。 |
| **v1.8** | 2026-10-06 | WorkBuddy | 新增 **§10 功能对齐清单**。触发：用户列出老师的 8 项能力，要求「老师有的我们也要有」。内容：① 8 项能力逐条对照现状；② **按"可独立验证"分三批** —— **批次 1**（JSON 上行 + `dev` 命名 + 累计计数器，只动上行侧、可台面验证）、**批次 2**（一帧读全为默认 + 失败自动降级 3 段，顺带给出 E-02 答案）、**批次 3**（AP + Web 配置页 + `/status` + NVS，≈新写一套）；③ 明确批次 1 里我们**比老师多做的两处**（JSON 额外带 `raw`、带 `quality`/`invalid`）；④ 记录批次 1 的**行为变更与代价**（失败不再单独发 `FAIL:Sx:原因` ⇒ 现场失去失败原因，要求串口保留 + 请 Codex 回报是否补 `type:"err"` 行）。<br>配套新增施工指令 **`04_ai_prompts/04_Codex提示词_功能对齐_JSON上报与统计.md`**（批次 1 详规 + 批次 2/3 概要 + 13 条硬约束 + 7 条验收判据）。 |
| **v1.7** | 2026-10-06 | WorkBuddy | **落地 ⑤ 落库原型**。① 新增 **`05_hardware/STB3-125_字段字典.csv`**（39 行机器可读字段字典，**唯一事实来源**，对应 A1）；② 新增 **`06_tests/db_proto.py`**（字典驱动：解析 → **四层校验 L0~L3** → 质量打标 → **幂等入库**，保留 `raw_hex`；`PRIMARY KEY(device_id,collect_time)` + UPSERT 保证补传幂等）与导出的 **`06_tests/db_schema.sql`**（对应 A3）；③ **§6 的 A1/A3 标记为已完成**、A2 部分完成；④ 记录 A3 过程中实测到的**关键设计修正**：必须把「该型号已知不上报字段」（`A/B/C_temp = −40`）与「本次异常」分开，否则每行都降级成 `PARTIAL`、`quality` 失去区分度 —— 用 `--known-missing` 处理（仍置 NULL，但不拖累整行）；⑤ 实测证据：真机抓包 **59 条全部入库且 `quality=OK`**、同数据二次入库 **7→7 新增 0 行**。 |
| **v1.6** | 2026-10-05 | WorkBuddy | **完成 ② PlatformIO 并行验证**，新增 **§9.5.4**。**结论：能编过（`[SUCCESS]`，0 error / 0 warning），但产物不等价** —— Flash **1 000 967 → 766 588 B（−23.4%）**、RAM **38 412 → 40 212 B（+4.7%）**，差异来自**换 core**（3.3.10 → 2.0.17）⇒ **「零差异迁移」不成立，正确姿势是"换 core + 重跑全套验证"**。另记录：(a) 「只 include 外部 `.ino`」的骨架会让 PlatformIO 的 LDF 失效（`WiFi.h not found`），本次靠 `lib_ldf_mode = deep+` + 额外 `-I` 绕过，**正式迁移应拆成真正的 `src/*.cpp`**；(b) **能编过 ≠ 跑对**，运行期行为未验证；(c) 新增可复用工具 **`06_tests/pio_cn_seed.py`**（从乐鑫 CN CDN 离线预置包，自动拍平目录 + 写 `package.json`/`.piopm`；并修正 frameowrk 包主属须为 `platformio/`）；(d) 实测本平台需求包解压后 **1.6 GB+**，佐证"拷老师的 `.platformio`"仍是最快路径。 |
| **v1.5** | 2026-10-05 | WorkBuddy | 新增 **§9.5.2「复核四条提速方法」**（逐条实测）与 **§9.5.3「零差异目标不成立」**。触发：用户贴来 4 条网传提速方案问可行性。结论：**① `platform_packages` → `dl.espressif.cn` 真实且很快**（实测 **2.1 MB/s，比 PlatformIO CDN 快 150×**；给出两条已验证 HTTP 200 的直链），但只解决 framework、不解决工具链，且版本对不上；**② 与 ④ 的 URL 全是编的**（阿里云 `espressif`/`platformio`、清华 `platformio` **全 404**；PlatformIO **没有 `pioconfig.ini`**）；**③ `HTTPS_PROXY` 思路正确但本机无代理在跑**。**更重要的发现**：`espressif32@7.1.3` 声明要 `framework-arduinoespressif32 ~4.20017.0`（2.0.17 代），而我们用 **3.3.10** ⇒ **"迁 PlatformIO 零差异"不成立，实质是换 core**（产物必然不同、必须重跑 M5 验证）⇒ **② 的真正前置是"迁到哪个 core"，需用户/总控裁定**；并指出"找老师拷 `.platformio`"正好验证他那个同代组合。 |
| **v1.4** | 2026-10-05 | WorkBuddy | 新增 **§9.5.1「实测阻塞」**。② PlatformIO 并行验证**当天做不成**：`platform-espressif32` 已装，但 `toolchain-riscv32-esp`（200 MB+）实测只有 **≈14 KB/s**，PlatformIO 侧总需求量级为 GB。**核实并否掉了网传镜像**（清华 TUNA 与阿里云的 PlatformIO/espressif 路径**全部 404**；TUNA 404 页还专门提示"从大模型拿到的链接多半不存在"），本地也无代理（7892/7890 等全未监听）；但**国内网络本身不慢**（TUNA 首页 0.2 s / 22 KB）⇒ 瓶颈是 PlatformIO 的 CDN。同时记录：**PlatformIO Core 不读 Windows「Internet 选项」代理，只认 `HTTP_PROXY`/`HTTPS_PROXY`**；**本机已由 Arduino esp32 core 备好大部分组件**（`esp-rv32` 2.4 GB 等）；给出三条出路，**首推"从老师机器拷 `.platformio` 的 `platforms/`+`packages/`"（包目录可移植，0 下载）**。<br>**结论定性：② 不是失败，是被外部网络阻塞；工程骨架已就绪**（`01_firmware/pio_verify/` 只 include 现有 `.ino`，设计正确）。 |
| **v1.3** | 2026-10-05 | WorkBuddy | 用户裁定「**以逆向的那块板为基准**」（`48:F6:EE:15:9B:88`：用 `mac`、无 `dev`/`quality`、配置页有鉴权），并补充「**老师用 PlatformIO、用户用 Arduino IDE**」。改动：① **§9.1 四条线扩为六条** —— ① 向老师对齐**基准已定**（只剩"能否给源码"与"版本号"两问）、② M5 收尾、**③ 新增「对齐上报格式（JSON）」**、**④ 新增「PlatformIO 并行验证」**、⑤ 落库原型、⑥ 安全整改；② **新增 §9.4 对齐清单** —— 逐项区分"必须一致"（字段名/顺序/语义/`%04X` 表示/`mac`/心跳行/`/status`/`ts`）与"可以不同"（**换算位置**推荐"基线字段 + 追加 `raw`"；**质量标记**建议**不放上报、放入库层**，并说明"上报字段 ≠ 数据库列"）；③ **新增 §9.5 PlatformIO 迁移** —— 指出这接的是项目已登记决策（导师要求组内迁 VSCode+PlatformIO，"推迟到 M5 数据稳定之后、M6 之前"），**判定窗口已到**，做法为"并行验证、不整体切换"，并列出**必须锁死的三件事**（core 版本会从 3.3.10 降到 arduino-esp32 2.x ⇒ 最大风险；编译选项 `CDCOnBoot=cdc`/Flash/分区表要搬全；`.ino`→`main.cpp` 需自己补函数原型）。 |
| **v1.2** | 2026-10-05 | WorkBuddy | 新增 **§9 推进计划**。触发：用户澄清「老师本意就是让用户/企业都能改配置，图方便」，并问「接下来做什么」。内容：① §9.1 四条线按"谁能动"排序 —— **① 向老师对齐 3 个问题（零成本先做，不解锁则后面可能白做）→ ② M5 收尾（需老师配合断一次电，E-02 + 缺包定性 + 写 `02_docs/08`）→ ③ 落库原型（不依赖真机，可独立推进）→ ④ 安全整改（交付前）**；② §9.2 把安全结论从"锁死配置"修正为**"把谁能进从『知道流出密码的人』改成『手里拿着设备的人』"**，并给出 5 条**不牺牲便利性**的最小改动（AP 超时关闭 / 一机一密贴标签 / 配置页口令 / 改 UDP 目标二次确认 / 上行 TLS）；③ §9.3 明确**现在不要做**的三件事（MQTT 与云平台、写操作、自定第二套 quality 编码）。 |
| **v1.1** | 2026-10-05 | WorkBuddy | 新增 **§8「与老师的参考实现对比」**。触发：用户提供老师实拍的 3 张图（配置页 / `/status` JSON / NetAssist 抓包）。内容：① 10 项能力逐条对照（配置方式、状态观测、上行格式、设备标识、序号、质量标记、时间戳、实测成功率）；② 三点发现 —— `quality` 字段老师**已实现**（方向印证 §3，但编码待问）、`A/B/C_temp = −40` **在老师数据里同样存在且被原样入库**（佐证 §4 的 L2 缺口）、老师 `recor1="6666"` 与我方 `0x6660` **同构**（半字节解码置信度上调为"已由老师实现验证"）；③ §8.2 固件换算 vs 只搬原始值的分歧与折中建议；④ §8.3 可立即借鉴的三项（`/status` 计数器、`dev` 标识、`seq`）；⑤ §8.4 商业化必须处理的安全项（固定 AP 密码、配置页无鉴权、`/status` 信息暴露、UDP 明文）。 |
| v1.0 | 2026-10-05 | WorkBuddy | 首版。触发：用户附《数据库说明.docx》并提出入库/解析格式/坏数据剔除/商业化四个问题。内容：① 指出该文档与仓库 `05_hardware/STB3-125_Database_Fields.md` 逐条一致（并承认上午核对时漏查该文件的疏漏）；② 给出 **39 寄存器 ↔ 39 字段 一一对应表**（含真机实测值），解开 `reg1/2/3`=分闸记录、`reg7`=−40 ℃ 为"无数据"伪装两个悬案；③ 指出电量公式与 `A_L` 类型描述不一致、操作卡 §9 缺 12 项；④ 提出四层校验（L0~L3）与"整行入库 + 打标"而非丢行的处置原则；⑤ 商业化考虑 12 条按 P0/P1/P2 分级，含"只读铁律 vs 远程分闸"的架构分叉点；⑥ 给出 A1~A4 后续动作。 |
