jiangtao-ml/ESP32_C3_Gateway/04_ai_prompts/00_context.md

> 最后更新：2026-10-06 · 砚青（接手校准）—— 清除三节里已闭环却仍写"待复核 / 未实测按 5V"的过期表述；把散落的内嵌同步标记归置到文末「七、变更记录」（内容保留，仅换位置）。
> 用法：本文件仍是**唯一事实来源**；与 `PROGRESS.md` 冲突时以本文件为准；改本文件走「最严档」= 定点修正 + 逐处留痕 + 挂 `PROGRESS.md` §8。

【项目全景上下文包：ESP32-C3 替换树莓派网关项目】

一、项目背景与目标

- 背景：现有架构使用树莓派（成本500-800元）作中间数据采集网关，数量多导致成本过高。
- 目标：使用 ESP32-C3 SuperMini（约50元）+ MAX13487 RS-485模块 替换树莓派，重写架构，先在面包板上跑通原型机。
- 角色分工：
  - 用户：负责硬件接线、烧录、看现象和提供日志。
  - 总控AI：负责拆解任务、写提示词、审查代码和排障。
  - Codex：负责在工程目录写/改代码、编译；**也可改文档**。改文档按「内容类型」分层：**「事实类」**（参数值 / 接口 / 注释 / 排障记录 / 帧表 / 字段字典 / 进度字段）⇒ **直接改**；**「决策类」**（阶段口径 / 安全红线 / 验收判据 / 角色分工 / 接口契约 / 里程碑）⇒ **可改，但必须留痕**（更新该文档的变更记录，并在根目录 `PROGRESS.md` §8 挂一条）。⚠️ **本文件（`00_context.md`）属「最严档」**：**允许定点修正**（只改过期 / 错误部分，不重写），但必须**逐处行内留痕** + **同时在 `PROGRESS.md` §8 挂条**；**禁止删除他人历史留痕**。**改文档不再需要事先逐次授权**。完整口径见 `PROGRESS.md` §2b。
  - WorkBuddy：负责查资料、写文档、整理 PC 侧测试工具；**可以写 ESP32 业务代码**（2026-10-06 用户授权），但**必须由 Codex / 另一个角色 / 用户独立复核后再定案 —— 绝不自审自改**（见文末「七、变更记录」C-1 / C-2）。

二、系统架构与数据流

1. 底层设备：QI 用电数据采集设备（约300元），支持 RS-485 通信，Modbus RTU 协议。
2. 中间网关：ESP32-C3 SuperMini + MAX13487 485模块（轮询采集、加时间戳、UDP上传）。
3. 上层接收：电脑上的“网络调试助手”通过 UDP 协议接收数据。

三、硬件清单与接线规范（⚠️ 致命警告）

- 主控板：ESP32-C3 SuperMini（工作逻辑电压 3.3V，使用 HardwareSerial(1)，RX=GPIO20，TX=GPIO21）。主控板 PCB 型号为 HW-466AB（板载标签）。
- 扩展底板：HW566 V0.0.1 扩展板（提供 5V、3.3V、锂电池供电接口）。面包板原型阶段（阶段三）先不使用 HW566，直接由电脑 USB 给 ESP32-C3 供电、由 SuperMini 的 5V 引脚给 MAX13487 供电；HW566 留到成品阶段（阶段四/五）上锂电池时再用。此决定已由总控确认。
- 通信模块：RS-485 模块，**主芯片型号已确认 = MAX13487**（2026-10-04 丝印复核，见第五节）：+5V 供电，AutoDirection 自动方向控制，无需 DE/RE 控制引脚（EN 固定高电平）。固件 `RS485_DE_PIN` 保持 -1。（若日后换 MAX485 / MAX3485：EN 即方向控制脚，必须由 GPIO 动态切换，见三.5 ②。）
- ⚠️ 致命接线警告（必须遵守）：
  1. 共地：ESP32、MAX13487、USB转485模块、电源，所有 GND 必须连在一起。
  2. 电平转换（极其重要）：MAX13487 的 RXO 输出是 5V 电平，绝对不能直接连 ESP32 的 RX (GPIO20)。必须加电阻分压。正确分压：1kΩ接RXO，2kΩ接GND，交点接GPIO20（电压约3.33V）。严禁使用 2k接RXO，1k接GND（电压仅1.67V，ESP32无法识别高电平）。（模块侧该脚术语统一为 RXO；部分手册记作 RO / RXD，同一引脚。）【Q-10 实测口径（2026-10-03 补充）】上电前必须先用万用表实测 RXO 空闲电平：实测为 5V 时必须按上述 1kΩ/2kΩ 分压；实测为 3.3V 时直连 GPIO20、不再分压（分压后约 2.2V 低于 ESP32-C3 的 VIH≈2.475V，会把高电平判成低电平）。未实测前一律按 5V 处理（必须分压），严禁直连。与任务书 §5.2 第 2 条、README §6.2 第 2 条口径一致。⚠️【2026-10-06 校准】本模块**拆掉 1k/2k 分压、RXO 直连 GPIO20** 后 M4（1000 次）与 M5（真机）均通过 ⇒ 现场按"可直连"接线；但**万用表实测空闲电平始终未做（Q-10 未闭合）**，电气合规性维持 [待确认]。**〔2026-10-21 砚青定点修正：本条已升级为「已裁定」——用户明确本机不分压，`RXO` 直连 `GPIO20`。此前"未实测前一律按 5V 处理"作废；Q-10 按「裁定」关闭（不是按「实测」关闭）。⚠️ 若日后换用 5V 逻辑模块，必须重新分压，否则会打穿 GPIO20。见 `PROGRESS.md §8.2 #34`〕**
  3. 供电：**MAX13487 接 5V，ESP32-C3 接 3.3V**（型号已于 2026-10-04 丝印复核闭环）。
  4. 总线偏置：商品页仅注明「具有 120 欧匹配电阻」；4.7kΩ 偏置电阻未经实物核实 —— 按总控裁定，M3 须实测终端/偏置并联数量后回写本条。⚠️【2026-10-03 数据手册核实】MAX13487E 官方数据手册“Pullup and Pulldown Resistors”一节明确：**A/B 线上的上拉/下拉偏置电阻是器件正常工作的必要条件**（原文 “required for proper operation of the device”）——AutoDirection 在每次 DI 低→高跳变时保持驱动器使能，直到总线差分 A-B > VDT（typ 0.6V / max 1V）后即释放驱动器，改由偏置电阻把 A/B 保持在高态（A-B > 200mV）—— 手册 Detailed Description 原文：“the driver stays enabled until (A-B) > VDT, and then disables the driver”。【2026-10-03 二次修订】故偏置不足或缺失的症状**不是**“驱动器锁死、占死总线”（初版机理有误）：真正的后果是“1”位在驱动器释放后塌陷到偏置电平（120Ω 跨接时约 63mV）→ 数据错乱 / CRC 全败，且空闲差分落入 ±200mV 不定区致 RXO 输出不定。故 M3 的“偏置电阻实测”不是可选项而是**功能项**：实测若模块未焊 4.7kΩ，必须外部补（A 上拉 4.7kΩ、B 下拉 4.7kΩ）。数据手册原件已入库 `05_hardware/MAX13487E_MAX13488E_Datasheet.pdf`。
  5. EN引脚：⚠️ **接法随实物主芯片型号二选一 —— 接线前必须先用放大镜读模块上 8 脚芯片丝印定型**：① **MAX13487 / MAX13488（5V 双向，芯片无 DE 脚，靠 AutoDirection）** → EN 接**固定高电平**（首选模块 VCC/5V，3.3V 亦可），**不得悬空、不得接 GND、不得动态切换**（悬空若对应 SHDN# 会关断器件，症状正是 RX=0）；② **MAX485 / MAX3485（单向半双工，EN 即方向控制脚）** → EN **必须接 GPIO** 由固件按收发切换，**严禁固定接高**（常使能会占死总线、并与从站驱动冲突）。用户 2026-10-03 口述实物为 MAX13487、老师亦称 MAX13487（「不要切换 EN 引脚」= 接固定电平、不要动态切换），但商品页为三合一款、渲染图丝印为 MAX485 ESA，页面图不能代表实物 —— **故以丝印复核结果为准**；丝印未读前不要给 EN 接任何电平。【2026-10-03 数据手册核实】MAX13487E/MAX13488E 官方数据手册（Rev 3, 2024，已入库 `05_hardware/MAX13487E_MAX13488E_Datasheet.pdf`）Pin Description：**1 RO / 2 RE / 3 SHDN / 4 DI / 5 GND / 6 A / 7 B / 8 VCC，全片无 DE 引脚**（DE 为内部信号，RECEIVER_ENABLE = DRIVER_ENABLE 的反相，可被外部 RE 引脚覆盖）。手册口径：RE 高 = 交给 AutoDirection 状态机控制（热插拔默认态，正常收发）；RE 低 = 强制 RO 常开；SHDN 高 = 正常工作，SHDN 低 = 关断。故 ① 的“EN 接固定高电平”在手册 RE / SHDN 两种诠释下**均成立**，已由官方手册核实。**〔2026-10-21 砚青定点修正：本工程**统一接 3.3V**（与载板网表 `+3V3 → EN` 一致）；此前"首选 5V"的表述废止，施工文档已同步。见 `PROGRESS.md §8.2 #34`〕**【2026-10-03 商品页佐证】购买页对 MAX13487 变体明示「不能通过 EN 脚切换方向，不然烧坏电脑，后果自负」，与 ① 的「不得动态切换」一致；同页仅注明「具有 120 欧匹配电阻」，未提 4.7kΩ 偏置 —— 偏置是否板载见三.4，必须实物核实。

四、软件功能需求（1秒循环任务）

1. 联网：连接 WiFi，SSID = <占位符>，密码 = <占位符>。实际值放 01_firmware/esp32c3_gateway/secrets.h，.gitignore 已忽略。
2. 时间同步：通过 NTP 服务器（ntp.aliyun.com）同步时间，时区设置为东八区（UTC+8），获得准确的本地时间。
3. 485 通信：波特率 9600（已确认为最终值），8N1。若实物为 MAX13487 则 AutoDirection 自动收发、无需方向控制引脚；若为 MAX485 / MAX3485（丝印未复核前不得假定）则须由 GPIO 切换 EN（固件已内建 RS485_DE_PIN 开关）。
4. 1秒定时循环（使用 millis() 非阻塞实现）：
   - 4.1 向 485 总线发送 Modbus RTU 查询指令（测试帧（功能码 0x03，仅用于链路回环自测）：{0x01, 0x03, 0x00, 0x00, 0x00, 0x02, 0xC4, 0x0B}。QI 真实读取命令（功能码 0x04）：读全部参数 {0x01, 0x04, 0x00, 0x00, 0x00, 0x27, 0xB0, 0x10}，读 A 相电流 {0x01, 0x04, 0x00, 0x09, 0x00, 0x01, 0xE1, 0xC8}。真实协议见 05_hardware/STB3-125_Modbus_Protocol.doc）。
   - 4.2 接收 485 设备回复数据（两级超时 + 帧长驱动：首字节 80ms、字符间隔 **8ms**〔⚠️ 2026-10-17 砚青定点修正：原写「4ms」，与本文第五节「已由 25 改为 8」及 `config.h` L89 的 `RS485_CHAR_TIMEOUT_MS = 8` 冲突，**以代码为准**；见 `PROGRESS.md` §8.2 #31〕，收满预期帧长即止；300ms 仅作整帧兜底，避免死循环）。
   - 4.3 解析回复数据（Modbus 协议解析），拼接 ESP32 当前时间戳（格式：YYYY-MM-DD HH:MM:SS | HEX数据）。
   - 4.4 通过 UDP 将数据发送到电脑网络调试助手（目标 IP **192.168.1.113**（2026-10-05 实测；漂移史 2026-09-27 `.117` → 2026-10-04 `.118` → **2026-10-05 `.113`**，每次开工前 `ipconfig /all` 确认）—— 这是**电脑侧**接收地址；192.168.1.200 是 **ESP32 自身**固定 IP，勿混用。UDP 端口 8888（M2 起 NetAssist 实测可用，已定为项目最终值）。两者均需在阶段二固化为常量并在 README 第 8 节跟踪）。（见文末「七、变更记录」C-3）
   - 4.5 等待下一次 1秒定时触发。

五、当前进度与待确认盲区

- 当前进度：
  - 硬件已拍照确认（ESP32-C3 SuperMini 主控板，PCB 型号 HW-466AB；HW566 V0.0.1 扩展底板；RS-485 模块——主芯片型号待丝印复核；面包板，均已就位）。
  - Arduino IDE 2.3.10 已安装（Windows）。
  - 工程目录结构已规划（01_firmware, 02_docs, 03_logs, 04_ai_prompts, 05_hardware, 06_tests）。
  - M0 已冻结（迭代记录见 02_docs/01_项目任务书.md 第 13 节变更记录）。技术审查报告与 v0.2 复查报告均已完成。QI Modbus 协议已获取并入库。当前阶段：**阶段三 · M1–M5 已通过**（M5 真机联调 2026-10-05 实测通过：功能码 `0x04` + 默认 3 段读取，真机连续 60 s **59/60** 成功，每包 **78 字节 = 39 个寄存器**完整数据且自洽；证据 `03_logs/M5真机首测_20261005_2035.log`）（2026-10-04 21:33 主干实测：连续 65 秒解析 OK 65 次 / 超时 0 / CRC 失败 0 / 帧长异常 0；2026-10-04 22:11 补测：**1000 次 / 1000.0 s，解析 OK 984 / 超时 11 / CRC 失败 5 / 帧长异常 0，账目自洽，三项全 PASS**）。（见文末「七、变更记录」C-9）**M4 根因＝485 模块丝印 `TXD`/`RXD` 为「交叉」约定**（`GPIO21`→模块 `RXD`、`GPIO20`←模块 `TXD`），详见 `02_docs/14_M4排障全过程复盘_2026-10-04.md`；补测详见 `02_docs/15_M4验收补测记录_2026-10-04.md`。COM 号已确认：ESP32 = **COM5**（`VID:PID 303A:1001`，原生 USB CDC）；USB 转 485 = CH340（**2026-10-04 补测期间为 COM10**，换 USB 口会变）。M5 前置**已闭环**：功能码已切 `0x04` + 默认 3 段读取（S1/S2/S3 → 37/37/19 字节）、`RS485_CHAR_TIMEOUT_MS` 已由 25 改为 **`8`**、供电隔离已执行（运行时充电宝供电 + 拔 USB）。**仍待**：`RXO` 空闲电平万用表实测。（见文末「七、变更记录」C-4）
  - 固件侧 M4 已完成并通过编译（真实 485 收发 + Modbus RTU 解析 + 可选方向控制宏 RS485_DE_PIN，默认 -1 不启用；见 01_firmware/esp32c3_gateway/），**并已在真机上跑通 —— M5，2026-10-05 实测：三段读取 59/60、78 字节真实数据**。（见文末「七、变更记录」C-5）
  - 电脑网络实测见本节末『网络环境与裁定』小节（WLAN **192.168.1.113**（2026-10-05 实测；漂移史 `.117` → `.118` → `.113`）/ 网段 192.168.1.0/24 / 频段与客户端隔离待 M1 实测）。
  - 开发板包与工具链已打通：曾卡在 esp-rv32@2601（ESP32-C3 是 RISC-V 芯片，需 esp-rv32 工具链；之前记录的 esp-x32 有误），后经 02_docs/11_esp32开发板包排障.md 所述步骤解决；M2/M3/M4 均已用 arduino-cli 编译通过。
- 待确认盲区：
  - QI 设备真实 Modbus 协议已获取（STB3-125）。原始文档见 05_hardware/STB3-125_Modbus_Protocol.doc，字段映射见 05_hardware/STB3-125_Database_Fields.docx，提炼版见 02_docs/06_QI协议说明.md，勘误见 05_hardware/STB3-125_Errata.md（E-01/E-03 已判定，E-02 待 M5 实测）。通信参数：设备地址 1、9600、8N1、无校验、CRC16 低位在前。
  - 电脑的实际 IPv4 地址（实测 WLAN 网卡；路由器 DHCP 静态绑定不可行——学校统一管理无后台权限，改为每次开工前 ipconfig /all 确认）：2026-09-27 为 192.168.1.117，2026-10-04 为 192.168.1.118，**2026-10-05 实测为 `192.168.1.113`（`config.h` 已同步）**；UDP 监听端口 8888 ✅ **已实测可用**（M2 起 NetAssist 在 8888 正常收包），定为项目最终端口（若变更须同步 config.h / README §8 / 本条）。
  - ✅【已闭环 2026-10-04】实物 485 模块主芯片型号：**读实物 8 脚芯片丝印确认为 MAX13487**（与用户口述、老师说法一致）。⇒ EN 接固定高电平（见三.5 ①），固件 RS485_DE_PIN 保持 -1。三合一款页面渲染图（MAX485 ESA）不代表实物。⚠️ 另注：该模块丝印 `TXD`/`RXD` 为**交叉**约定（`GPIO21`→模块 `RXD`、`GPIO20`←模块 `TXD`），总线侧 3 脚顺序为 **`B`/`A`/`GND`** —— 详见 `02_docs/14_M4排障全过程复盘_2026-10-04.md`。
  - ESP32 本地 UDP 端口 12345（仅发送用，便于抓包定位；见 01_firmware/esp32c3_gateway/config.h 的 UDP_LOCAL_PORT）。
  - ✅【已闭环 2026-10-04】COM 口号：**ESP32 = COM5**（VID:PID `303A:1001`，原生 USB CDC，板上无 CH340）；USB 转 485 = CH340 `1A86:7523` / FTDI `0403:6001`。每次换 USB 口都会变，烧录前用设备管理器或 `arduino-cli board list` 确认。开发板包与工具链已打通（见本节当前进度）。
  - 【2026-10-04 更新·WorkBuddy】原 M4 硬件阻塞（R-12 / R-13）**已解除**：
    - **R-12（模块选型）**：带 GND 端子的 CH340 模块已到货；**旧黑模块（FTDI）经双端口互测证明收发完好**，此前"物理损坏"判定系无效测试所致，已推翻。
    - **R-13（GPIO20 可能受损）**：短接 GPIO21↔GPIO20 回环自检实测 **8 字节逐字节原样收回** ⇒ **GPIO20 完好，R-13 解除**。
    - **分压**：用户按"老师不用电阻"拆除 1k/2k 后 M4 仍 100% 通过 ⇒ 本模块 `RXO` **可直连 GPIO20**（⚠️ 但万用表实测电平仍属 `[待确认]`）。
    - **当前仅剩**：**`RXO` 空闲电平万用表实测**（仍属 `[待确认]`）。`RS485_CHAR_TIMEOUT_MS` 已随 M5 首次烧录改为 **`8`**；`UDP_TARGET_IP` 已同步为 **`.113`**。【2026-10-06 更新】✅ M4 的 3 项补测**已于 2026-10-04 完成并全部 PASS**（见 `02_docs/15_M4验收补测记录_2026-10-04.md`）。
  - 电脑端 Modbus 从站模拟器：已选定 Modbus Slave（Witte Software），备选 pymodbus；参数见 01_firmware/esp32c3_gateway/README.md 的 M4 章节。
  - 总控已裁定：M2 起即采用最小非阻塞状态机（IDLE→TX→WAIT_RX→PARSE→SEND），M6 只做加固不做重构；M1 增加“万用表实测 MAX13487 的 RXO 空闲电平”；M3 增加“实测终端/偏置并联数量”。
  - 总控裁定：Q-08 容差 = 主判据原始寄存器值完全相等，兜底工程量误差 ≤ ±0.5% 满量程，两条同时记录。
  - 总控裁定：Q-12 同秒时间戳不加毫秒、不加序号。

网络环境与裁定（2026-09-27 追加）

网络环境（实测）：

- 学校统一管理 WiFi，无路由器后台权限；无需网页登录（ESP32 可直连）；手机 2.4GHz 热点退路可行。
- 电脑 WLAN：**192.168.1.113**（2026-10-05 实测；漂移史 2026-09-27 `.117` → 2026-10-04 `.118` → **2026-10-05 `.113`**）/ 255.255.255.0 / 网关 192.168.1.1 / 网段 192.168.1.0/24。
- 唯一剩余风险：客户端隔离（AP isolation）是否开启 → M1 用 ping 192.168.1.200 实测（R-11）。

总控裁定：

- Q-02 主方案：ESP32 连学校 WiFi，用 WiFi.config(192.168.1.200, 192.168.1.1, 255.255.255.0, 192.168.1.1) 固定；退路=手机 2.4GHz 热点。M1 前置：ping + arp -a 确认 192.168.1.200 空闲；WiFi 分析 App 确认 SSID 在 2.4GHz 独立可连。
- Q-05：手写帧组装（不用第三方 Modbus 库）。
- Q-11：已闭环（RXO 术语已统一）。
- Q-12：同秒时间戳不加毫秒、不加序号。
- ~~NTP 网络风险（M2 前置）：校园网可能屏蔽 UDP/123 或不下发外部 DNS；失败时改用 IP 直连 203.107.6.88，仍不通退手机热点。~~
  ✅ **已闭环（2026-10-04/05）**：导师提供内网 chrony **`172.16.0.2`**（实测 stratum 2 / RTT 3.4 ms，公网对照 41 ms）⇒ 裁定 **三源：主 `172.16.0.2` → 备1 `ntp.aliyun.com` → 备2 `203.107.6.88`（IP 直连）**。
  ⚠️ **公网备源必须保留**：网络退路是手机 2.4GHz 热点，那时内网源必然不可达。（见文末「七、变更记录」C-6）

六、项目标准落地流程（全局视图）

1. 阶段一：项目立项与规划（文档先行）—— 编写任务书、制定里程碑。
2. 阶段二：环境搭建与基建 —— 装软件、清点硬件、建目录、查COM/IP。
3. 阶段三：分模块验证（先软后硬，先模拟后真机）—— WiFi/NTP/UDP联通 -> 485物理回环 -> 电脑模拟Modbus从站 -> 接入QI真机。
4. 阶段四：系统集成与稳定性测试 —— 非阻塞状态机加固（最小状态机自阶段三 M2 起已在位）、异常处理、2小时压力测试。
5. 阶段五：项目验收与结项 —— 成本对比、交付物整理、演示准备。

---

七、变更记录（本文件的修改留痕；正文中的 `（见变更记录 Cn）` 指向本表）

| 编号 | 日期 | 作者 | 内容 |
| --- | --- | --- | --- |
| C-1 | 2026-10-06 | WorkBuddy | 角色口径变更：**Codex 也可改文档**（分「事实类」直接改 / 「决策类」留痕），依用户指示同步。如需回滚请告知。 |
| C-2 | 2026-10-06 | WorkBuddy | 依用户裁定「旧铁律不好用」：去掉本文件"禁改"，改为「最严档 = 定点修正 + 逐处行内留痕 + 挂 `PROGRESS.md` §8」。如需回滚请告知。 |
| C-3 | 2026-10-04 | WorkBuddy | 同步四.4（电脑侧接收 IP + UDP 端口）依用户指示。如需回滚请告知。 |
| C-4 | 2026-10-06 | WorkBuddy | 第五节「当前进度」同步 **M5 已通过**（真机三段读取 59/60），依用户指示。如需回滚请告知。 |
| C-5 | 2026-10-06 | WorkBuddy | 第五节同步「固件侧 M4 完成 + 已在真机跑通（M5）」，依用户指示。如需回滚请告知。 |
| C-6 | 2026-10-06 | WorkBuddy | 「网络环境与裁定」同步 NTP **三源**裁定（主 `172.16.0.2` → 备 `ntp.aliyun.com` → 备 `203.107.6.88`），依用户指示。如需回滚请告知。 |
| C-7 | 2026-10-06 | 砚青（接手） | **事实清扫**：三节（通信模块 / 三.2 电平转换 / 三.3 供电）清除"型号待复核""未实测前按 5V 处理"等**已闭环却仍挂着**的过期表述；第五节与 B/C 段落的过期同步标记归置到本表（C-3~C-6）。 |
| C-8 | 2026-10-06 | 砚青（接手） | 一、角色分工：**WorkBuddy 由"不写业务代码"改为"可写，但不得自审自改"**（用户授权，见 `PROGRESS.md` §8.2）。 |
| C-9 | 2026-10-04 | WorkBuddy | 第五节「当前进度」逐处更新（M4 主干 + 3 项补测 PASS、R-12/R-13 解除、《14/15》复盘链接），依用户指示。如需回滚请告知。 |
| C-10 | 2026-10-17 | 砚青 | **定点修正第四节 4.2**：「字符间隔 4ms」→ **8ms**。理由：与本文件第五节记载的「已由 25 改为 8」及 `config.h` L89 实际值冲突，属笔误；**只改这一个数字，未动其余表述**。同时挂 `PROGRESS.md` §8.2 #31。|
| C-11 | 2026-10-21 | 砚青 | **定点修正三.2 与三.5 两处**：① 三.2 电平转换段末尾补「已裁定直连、不分压」（用户确认；此前"未实测前一律按 5V 处理"作废，Q-10 按裁定关闭而非按实测关闭）；② 三.5 ① 末尾补「本工程 EN 统一接 3.3V」（原"首选 VCC/5V"废止，与载板网表 `+3V3→EN` 一致）。**只在两处末尾追加方括号留痕，未删改任何原有文字**。同时挂 `PROGRESS.md` §8.2 #34。|
