jiangtao-ml/ESP32_C3_Gateway/04_ai_prompts/10_Codex提示词_全面审查与优化.md

# 10 · Codex 提示词：固件全面审查与优化

| 项 | 内容 |
| --- | --- |
| 文档 | `04_ai_prompts/10_Codex提示词_全面审查与优化.md` |
| 版本 | v1.0 / 2026-10-21 |
| 作者 | 砚青（WorkBuddy） |
| 用途 | 交 Codex 做**独立审查 + 提出可落地的优化改动**。产物仍需另一角色复核（作者 ≠ 验证者） |
| 基线 | commit `98ebf1d`，`SELFTEST=0` = Flash 1,086,695 / RAM 49,496；`SELFTEST=1` = 1,078,957 / 49,368 |

> 用法：把下面 `====` 之间的内容整段复制给 Codex。

---

====

## 你的任务

对一个 ESP32-C3 的 RS-485 采集网关固件做**全面审查**，找出并**提出具体的优化改动**。不要重写、不要重构项目结构——本项目有明确纪律：**M6 之后"只加固不重构"**。

产出两份东西：

1. **审查报告**：逐条列出发现的问题（每条必须给 `文件:行号` + 代码证据 + 为什么是问题 + 具体改法）。
2. **改动清单**：你实际改了哪些行、为什么改、改动前后编译体积对比。

你的改动之后还会被另一个角色复核，所以**每一条都必须可被验证**，禁止"建议优化一下结构"这种无法判定的表述。

---

## 一、项目背景（够用即可，不要扩大调研）

用 ~50 元的 ESP32-C3 SuperMini + MAX13487 替换 500–800 元的树莓派网关，轮询 `STB3-125` 电表（Modbus RTU，功能码 `0x04`，39 个输入寄存器，9600 8N1，从站地址 1），每秒一轮，把读数以 **UDP JSON** 发到 PC 的 8888 端口。已连续跑到 M6（900 s 压测 100%、真机回归 300 s 100%），现在要冲 **168 小时连续测试**。

代码位置：

- `01_firmware/esp32c3_gateway/esp32c3_gateway.ino`（主逻辑，约 1350 行）
- `01_firmware/esp32c3_gateway/config.h`（全部编译期常量）
- `01_firmware/esp32c3_gateway/web_config.h`（常驻 AP + Web 配置页 + `/status` + NVS）
- `01_firmware/esp32c3_gateway/secrets.h`（**凭据，禁止读取内容写进报告，禁止修改**）

---

## 二、硬件现状（**本次审查的关键前提，已定稿，不要再讨论选型**）

| 项 | 现状 |
| --- | --- |
| 载体 | **洞洞板（万用板）**，70×90 mm 双面镀锡，2.54 mm 孔 |
| 装配 | **没有排母**。ESP32-C3 SuperMini 与 MAX13487 模块的引脚**直接穿过洞洞板孔焊接**，焊上即不可拆 |
| 供电 | ESP32 的 USB-C 是唯一入口；模块 `VCC` 由 ESP32 的 `5V` 引脚供给 |
| 电平 | **不分压**。模块 `TXD`（RO/RXO）**直连** `GPIO20`，已裁定为 3.3V 逻辑兼容 |
| `EN` | 固定接 **3.3V**（不是 5V） |
| DE | **无**。MAX13487 是 AutoDirection，`RS485_DE_PIN = -1` |
| 终端/偏置 | 模块板载已有 `472 / 121 / 472`（4.7k / 120Ω / 4.7k），板上**不得再加** |
| 调试口 | 只有 USB-C（串口 + 烧录 + 供电三合一）；LED 是板载 GPIO8 |

接线（8 根，**交叉**，这是最容易错的地方）：

```
ESP32 5V   → 模块 VCC        ESP32 3.3 → 模块 EN
ESP32 G    → 模块 GND        ESP32 21(TX) → 模块 RXD
ESP32 20(RX) ← 模块 TXD      ESP32 GND → 端子 GND
模块 A → 端子 A              模块 B → 端子 B
```

**"没有排母"带来的三个后果，请在审查时始终考虑：**

1. **不可插拔隔离**：无法把模块拔下来做回环测试，也无法在不动烙铁的前提下换模块。固件里的降级/自恢复逻辑因此更重要。
2. **不可跳线**：任何"临时短接 A/B 自环"的调试手段都不可用（何况 A/B 短接本身就是无效自测）。
3. **引脚不可改**：一旦焊错只能拆焊。所以**引脚分配的正确性优先级高于一切**。

---

## 三、编译与验证方式

```bash
cd 01_firmware/pio_verify
pio run              # SELFTEST=0（正式）
```

双模式是硬要求（历史上漏过一次，导致回环分支编不过）：

```bash
# SELFTEST=1：把 config.h:184 的 RS485_MODE_LOOPBACK_SELFTEST 临时改为 1
# 编译后必须改回 0，不得提交该改动
```

**当前基线（必须对齐，否则说明你改坏了）**

| 模式 | Flash | RAM | 要求 |
| --- | --- | --- | --- |
| `SELFTEST=0` | 1,086,695 B（82.9%） | 49,496 B（15.1%） | 0 error / 0 新增 warning |
| `SELFTEST=1` | 1,078,957 B | 49,368 B | 0 error |

> ⚠️ 仓库文档里出现的 `1,070,975` 是**过期基线**，不要拿它做对比。
> ⚠️ Flash 只剩约 **224 KB** 余量，任何新增功能都要报增量。

---

## 四、审查清单（逐项给结论，不要跳）

### A. 功能正确性（最高优先级）

1. **Modbus 帧**：请求帧字节、CRC16（`0xFFFF` 初值 / `0xA001` 多项式 / **低字节在前**）是否与 `m5_frame_check.py` 的独立复核结果一致？不要重算后"顺手改"，只报告是否一致。
2. **39 个寄存器的映射**：`g_merged` 的段偏移拼接是否正确？一帧读全（83 B）与 3 段（37/37/19 B）两条路径拼出来的 39 个寄存器是否逐一对齐？有没有可能某段缺失导致尾部残留上一轮的值？
3. **P0-1 帧长校验**：`byteCount + 5` 是否等于本段**请求**的寄存器数×2+5？这道闸门是唯一挡住"短帧静默掺假"的，**不得削弱**。
4. **工程量换算**：`A/B/C_temp`（`raw-40`）、电压、电流、功率、频率、漏电、电量 `(H×65536)/1000+L` 的公式与量程判据是否一致？特别注意 `-40 ℃` 既是"该型号恒不上报"的伪装值、又可能是"真越界"，代码如何区分？
5. **`quality` / `invalid`**：`PARTIAL` 的判定条件是否与字段级 `invalid` 一一对应？
6. **计数器语义**：`poll_ok` / `poll_err` 是否仍在 WiFi 链路判断**之前**自增？（这是接收端对账恒等式的前提，动了整套统计就废了）
7. **`seq` 语义**：是否仍是**每发一行自增 1**、三条行型共用同一个 `seq`？
8. **时间戳**：NTP 判据是否仍用 `sntp_getreachability()` 而不是 `getLocalTime()` 的返回值？`ts_ok` 是否准确反映"本轮会话已对时"？

### B. 逻辑缺陷与边界/异常

逐条给"有/无问题"的结论：

1. **半帧/超时**：三级超时（首字节 80 ms / 字符间隔 8 ms / 整帧 300 ms）组合起来，会不会出现"半帧被当成完整帧"？
2. **`byteCount` 异常**：奇数、为 0、超过 `g_rxFrame` 容量、与请求不符 —— 四种情况分别怎么处理？
3. **异常响应**（`func|0x80` + 异常码，5 字节）与正常短帧的区分顺序是否正确？
4. **`g_merged` 从不整轮清零**（这是已知设计），那么"某段失败但整轮仍被判成功"的可能路径是否存在？
5. **3 段模式最坏耗时**：3×300 ms 兜底 + 8 ms 间隙 ≈ 933 ms，而周期是 1000 ms —— 阈值只剩 67 ms 余量。请核算这个估算，并指出会在什么条件下越界、越界后发生什么。
6. **`millis()` 回绕**：所有比较是否都写成 `(int32_t)(now - t) >= 0`？168 h = 7 天，不触发 49.7 天回绕，但写法错就是埋雷。
7. **`seq` 是 `uint32_t`**：回绕时（约 49,710 天）不会出问题，但 `%lu` 打印与接收端解析是否一致？
8. **电量 32 位进位**：`rH` 从 0xFFFF 进位到 0 的瞬间，公式会不会出现负跳变？
9. **WiFi 断线期间**：`sendUdpPayload()` 早退后，`g_roundFailed` / `g_failSeg` 等状态是否会在下一轮残留？
10. **NTP 未同步**：`ts` 退化成 `BOOT+<秒>` 后，接收端要靠锚点换算。这个格式是否稳定、有没有边界（例如 `millis()` 恰好在整秒附近抖动）？
11. **NVS**：读失败、键缺失、值越界（例如 `poll_s` 被写成 0 或负数）分别怎么处理？会不会导致除零或死循环？
12. **Web 服务**：客户端只发半个请求时，`handleClient()` 最长会阻塞多久？这段时间里轮询会怎样？

### C. 资源占用与性能（168 h 视角）

1. **堆**：热路径上是否还存在任何动态分配（`String` / `malloc` / `new`）？本轮已把 `WiFi.localIP().toString()` 改为栈上缓冲，请确认没有遗漏。
2. **栈**：`parseResponse()` / `buildDataJson()` 的局部数组叠加 `vsnprintf` 的浮点栈帧，在 8 KB 的 loopTask 栈上余量多少？给出最坏路径估算。
3. **串口**：`Serial.setTxTimeoutMs(0)` 是否仍在、是否对所有分支生效？（去掉它会让 1 s 周期退化到 ~19 s）每轮还剩多少次 `write`？`SERIAL_VERBOSE_ROUND=0` 时降到多少？
4. **Flash**：82.9% 已用，剩约 224 KB。指出当前有哪些"占体积但长跑用不到"的部分（例如 Web 页面字符串、调试字符串），并给出可压缩的建议（**只建议，不实施**）。
5. **CPU**：`loop()` 是否有隐含的忙等或长阻塞？`WebServer::handleClient()` 的 `_nullDelay` 是否已关？
6. **NVS 磨损**：`WiFi.persistent(true)` + "从未连上时每 5 s 调 `WiFi.begin()`" 是否会导致 NVS 反复写入？请从 core 源码确认，并给出证据（行号）。这是 168 h 场景下的真实风险。
7. **UDP 发送路径**：`beginPacket` 失败（pbuf 耗尽）时会发生什么？会不会连续失败却没有自恢复？

### D. 可读性与结构

1. 注释与代码**不一致**的地方，逐条列出并给出正确表述。已知可疑项（请核实，不要照抄我的话）：
   - 某处注释称"每轮热路径 ~190 次 write"，实际构造是否为 44 次（verbose 开）/ 2 次（关）？
   - `config.h` 里关于字符间隔"3~5 ms"的提示与 `RS485_CHAR_TIMEOUT_MS = 8` 是否矛盾？
2. 单文件 1350 行是否该拆？**只给结论和代价分析**（拆 `.ino` 需要自己补函数原型），不要动手拆。
3. 命名是否有误导（例如 `qiSegTag()` 与 `qiDataSegTag()` 的区别是否一目了然）？
4. 是否存在复制粘贴造成的重复代码块（三相交替处理的段落）？如果合并能显著降体积且不改行为，可以作为"建议项"提出。

### E. 与硬件接线的匹配性（**本次重点**）

逐条确认：

1. **引脚分配**：`RS485_TX_PIN=21` / `RS485_RX_PIN=20` / `LED_PIN=8` 是否与 `ARDUINO_USB_CDC_ON_BOOT=1` 下的 USB CDC 不冲突？`Serial`（USB）与 `Serial1`（UART1）是否各走各的？
2. **GPIO8 是 ESP32-C3 的 strapping 脚**（启动时需为高电平才能正常从 flash 启动）。LED 是**低电平点亮**，请确认：上电/复位瞬间 GPIO8 的状态由谁决定？会不会因为"低电平点亮"的默认状态影响启动？给出 core 与芯片手册依据。
3. **`EN` 固定 3.3V**：代码里是否存在任何会驱动 EN 或方向脚的逻辑？`RS485_DE_PIN=-1` 是否在所有分支（含 3 段模式、含错误恢复）都成立？
4. **不分压、直连 GPIO20**：确认代码中没有任何依赖"外部电平转换"的假设；同时指出如果将来换 5V 逻辑模块，固件层面有没有可做的保护（例如启动时自检）——**只建议**。
5. **无排母、不可插拔**：评估当前的降级策略（一帧读全 → 3 段）在"无法人工干预"的现场是否足够。如果 168 h 中途总线彻底断开，固件的行为是什么？
6. **只有 USB-C 一个口**：长跑时必须拔掉 USB 数据线、改用电源适配器。固件是否依赖 USB 连接（例如 `while(!Serial)` 等待）？这个等待会阻塞多久？
7. **LED 是唯一现场反馈**：当前三种状态（WiFi 断=慢闪 / 成功=短闪 / 失败=长闪）在"总线正常但 WiFi 断"时显示什么？现场能否据此判断该修网络还是该修 485？

---

## 五、绝对不能动（动了就是事故）

| # | 项 | 原因 |
| --- | --- | --- |
| 1 | Modbus 请求帧字节与 CRC 实现 | 已被独立脚本复核、真机 384 轮验证 |
| 2 | `parseResponse()` 的判定顺序 | 异常响应必须先于帧长判定 |
| 3 | P0-1 的 `byteCount+5 == 本段期望长` | 唯一挡住"短帧静默掺假"的闸门 |
| 4 | `g_merged` 不做整轮清零 | 加清零会掩盖短帧问题 |
| 5 | `RS485_DE_PIN = -1` 与 AutoDirection 假设 | 实物无 DE 脚，动态切会顶死总线 |
| 6 | `Serial1.flush()` 作为"发完"判据 | 换固定 delay 在 9600 下不可靠 |
| 7 | `poll_ok`/`poll_err` 在链路判断前自增 | 接收端对账恒等式的前提 |
| 8 | `g_nextPollMs += g_pollIntervalMs` 的推进方式 | 改成按完成时刻推进会累积漂移 |
| 9 | JSON 字段名、字段顺序、类型 | 与老师接收端逐字兼容 |
| 10 | `Serial.setTxTimeoutMs(0)` | 去掉就回到 ~19 s/轮 |
| 11 | NTP 判据 `sntp_getreachability()` | 换 `getLocalTime()` 会被 RTC 旧时间骗过 |
| 12 | `seq` 的自增位置（每次 build 时 +1） | 三行型共用一个序列 |

**另外禁止**：

- 不改 `secrets.h`（也不要把它里面的内容写进报告）
- 不改 `platformio.ini` 的平台版本（`pioarduino@55.03.311` 是选型结论）
- 不引入第三方库
- 不把 `01_firmware/esp32c3_gateway/` 拆成多文件
- 不 `git add -A`（提交时只 add 你自己改的文件）

---

## 六、已经改过的地方——请**复核**，不要重做

2026-10-21 已做了 4 处加固，请分别判断"正确 / 有问题 / 需要回退"：

| # | 位置 | 改动 | 你要确认什么 |
| --- | --- | --- | --- |
| C-1 | `udpSendLine()` | 校验 `write()` 返回值是否等于 `strlen(payload)`；不等即判失败；失败仍调用 `endPacket()` 释放 pbuf | ⚠️ **重点**：core 3.x 的 `UDP::write()` 返回值语义是"已写入字节"还是"已受理"？若是后者，这项会把成功误判为失败。请查 `NetworkUdp.cpp` 并给出结论 |
| C-2 | `buildDataJson()` | `WiFi.localIP().toString().c_str()` → 栈上 `char ipBuf[16]` + `snprintf` | JSON 里 `ip` 字段是否**逐字节相同** |
| C-3 | `loop()` 尾部 | 丢轮重对齐分支加 `Serial.printf("[POLL][SKIP] ...")` | 是否**没有**改变 `g_nextPollMs` 的推进语义 |
| C-4 | `parseResponse()` / `udpSendLine()` | 新增 `SERIAL_VERBOSE_ROUND` 开关，包住逐轮详细回显 | 关掉后是否有变量变成"未使用"、是否产生新 warning |

---

## 七、已知但**这次不要实施**的项（评估即可）

这几项风险明确，但属决策类，需用户/复核人拍板：

1. **看门狗**：当前 `loop()` 无 WDT（core 的 `loopTaskWDTEnabled = false`），卡死只能人工断电。168 h 场景值得加，但会引入误重启风险，且要配合喂狗点设计。**给方案与代价，不要改代码。**
2. **WiFi 从未连上时的 NVS 写入**（见 C-6）：给证据与改法建议。
3. **Web 半开连接阻塞 5 s**：给量化影响与规避建议（运维规避 or 代码改造二选一）。
4. **`loop()` 无 `yield`**：CPU 常驻 100%，功耗偏高。是否值得动，给判断依据。

---

## 八、一个必须回答的实证问题

M6 的 900 s 原始数据里，**缺 19 行 = 18 条数据行（870 B）+ 1 条心跳（190 B）**，而设备侧 `udp_tx` 与 `seq` 逐行严格相等（`endPacket` 全部返回成功）。即：固件认为发出去了，但接收端少了约 2% 的**大包**。

请从**固件角度**回答：

1. 心跳行与数据行是**背靠背在同一毫秒内发两个 UDP 包**（间隔 0 ms）。这会不会导致 lwIP pbuf 或 WiFi 发送队列在"第二个较大的包"上出问题？
2. 在 hb 与 data 之间插入一个很小的间隔（例如 2–5 ms）是否可能改善？**请评估对 1 s 周期的影响**（当前一轮约 105–120 ms，余量够）。
3. 有没有固件侧可观测手段能在长跑中区分"发了但没上空中"与"真的没发"？（例如 `endPacket` 成功但 WiFi 层丢帧的迹象）

**这一问不要猜。** 能给证据（core 源码、lwIP 配置、已知 issue）就给证据；给不了就明确写"固件侧无法判定，需接收端 pcap 与内核计数配合"。

---

## 九、输出格式

### 9.1 审查报告

按 A–E 五节组织，每节一张表：

| 编号 | 严重度 | 位置 | 问题 | 证据 | 建议改法 |
| --- | --- | --- | --- | --- | --- |
| A-1 | Blocker / Major / Minor / Info | `文件:行号` | 一句话说清 | 代码片段或日志 | 具体到怎么改 |

严重度定义：
- **Blocker**：会导致数据错、挂死、或破坏协议，必须改。
- **Major**：影响长跑可靠性或可观测性，建议改。
- **Minor**：可读性、注释错误、轻微浪费。
- **Info**：仅记录，不建议动。

### 9.2 改动清单

| 文件 | 行号 | 改了什么 | 对应发现 | 风险 |
| --- | --- | --- | --- | --- |

### 9.3 编译证据

```
SELFTEST=0: Flash ____ / RAM ____   error __  warning __
SELFTEST=1: Flash ____ / RAM ____   error __  warning __
与基线差值：Flash ____ / RAM ____
```

### 9.4 结论

一句话回答：**这份固件现在能不能支撑 168 小时连续跑？** 如果不能，还差什么。

---

## 十、纪律

1. **只加固，不重构。** 每一处改动都要能说清"不改会出什么事"。
2. **不确定就标 `[待确认]`**，禁止编造寄存器、寄存器地址、芯片行为。
3. **不要静默修改**你不确定的地方；拿不准的写进报告让用户决定。
4. 改完必须自己编译两种模式并贴出体积。
5. 报告里出现的中文注释风格与现有代码保持一致（带日期与改动人标记）。

====

---

## 附：本次提示词针对的硬件变更（供后续文档同步）

用户 2026-10-21 明确：**只有模块 + 洞洞板，没有排母，不需要分压，接线直接焊在洞洞板上。**

对既有文档的影响（待同步）：

| 文档 | 需改 |
| --- | --- |
| `05_hardware/洞洞板固化操作卡` | §1 材料取消 2 条 1×8 / 1×5 / 1×3 排母；§0 RXO 实测由"必须测"改为"已裁定直连"；§4 焊接顺序改为"模块引脚穿板直焊" |
| `05_hardware/洞洞板布局图` | §6「打点落孔」改为"先干插模块定位、再焊模块引脚" |
| `02_docs/24` §1.1 | 注明"不分压已定稿" |

> ⚠️ 直焊的代价：**焊上即不可拆**。焊错只能拆焊，拆焊会伤焊盘。所以图纸签核与 M1–M17 电检这两关的权重比用排母时更高。
