jiangtao-ml/ESP32_C3_Gateway/02_docs/20_工具链国内镜像与离线安装_2026-10-06.md

# 20 · 工具链国内镜像与离线安装方案（`-cn` 释义 + PlatformIO 3.x 迁移）

> 最后更新：**2026-10-06 · 砚青** ｜ 类型：**方案 + 实测记录**
> 关联：`02_docs/11_esp32开发板包排障.md`（CN 镜像首次排障）· `02_docs/19`（core 选型）· `06_tests/pio_cn_seed.py`（既有落地脚本）· `PROGRESS.md` §5b / §8.1-4
> 本文件所有 URL 与体积均为 **2026-10-06 本机实测**，未实测项一律标 `[待确认]`。

---

## 0. 一句话

**`-cn` = Espressif 官方中国镜像的版本标记**（与官方版本号一一对应，如 `3.3.10-cn` ↔ 官方 `3.3.10`）；它的下载走**乐鑫 CN CDN `dl.espressif.cn`**。
**根因是 `github.com` 在国内直连不通**（本机实测超时 / 0 字节）。⇒ 只要把包分成两类走两条通道（见 §4），**PlatformIO 迁到 3.x 完全可以不下 GitHub**。

---

## 1. `-cn` 是什么（已用本机数据确认）

本机 `Arduino15` 下同时存在两个索引，对照即得结论：

| 索引文件 | 版本列表（节选） | 所有下载 URL 的域名 |
| --- | --- | --- |
| `package_esp32_index_cn.json`（**CN 镜像**） | `3.3.10-cn, 3.3.9-cn, …, 2.0.17-cn, …`（**全部带 `-cn`**） | **`dl.espressif.cn`（50/50 平台 + 1041/1041 工具）** |
| `package_esp32_index.json`（官方） | `3.3.12, 3.3.11, 3.3.10, 3.3.9, …`（**无后缀**） | `github.com`（52/52 平台） |

**结论（三条）**：
1. **`-cn` 只是"发布渠道标记"，不是不同的代码分支** —— `3.3.10-cn` 对应官方 `3.3.10`，**同一版本、不同镜像**。
2. **CN 索引把全部下载 URL 换成了 `dl.espressif.cn`** —— 这就是"国内镜像"的实质。
3. **CN 镜像索引来源**：`https://jihulab.com/esp-mirror/espressif/arduino-esp32/raw/gh-pages/package_esp32_index_cn.json`（**极狐 GitLab**，Espressif 官方 CN 镜像仓）。本机 `~/.arduinoIDE/arduino-cli.yaml` 的 `board_manager.additional_urls` 已配置此地址 ✅。

⚠️ **一个必须知道的取舍**：CN 镜像**会滞后** —— 官方已到 `3.3.12`，CN 最高 `3.3.10-cn`。
⇒ 对"固定版本、可复现"其实**有利**（钉一个 CN 版本即可）；但**不要以为它总是最新**。

---

## 2. 本机现状（2026-10-06 实测）

| 侧 | 状态 |
| --- | --- |
| **Arduino / arduino-cli** | 已装 **`3.3.10-cn`**，位于 `Arduino15/packages/esp32/hardware/esp32/3.3.10-cn` ✅ |
| **PlatformIO** | **VS Code 内已装**；`~/.platformio` 存在，含 `platforms/espressif32@7.1.3` + `packages/{framework-arduinoespressif32, toolchain-riscv32-esp, tool-esptoolpy, tool-scons}` |
| **PlatformIO 当前 core** | ⚠️ **`framework-arduinoespressif32 4.20017.0` = arduino-esp32 `2.0.17`** ⇒ **与板子上的 3.3.10 不是同一代**（这正是要迁移的原因） |

⇒ **迁移动作 = 把 PlatformIO 的平台从官方 `espressif32`（2.0.17）换成 `pioarduino` 的 3.x**，**不是从零安装**。
⇒ 且**项目里已经有成熟做法**：`06_tests/pio_cn_seed.py`（2.0.17 时代写的"CN CDN 下载 → 拍平目录 → 补 `package.json`/`.piopm`"）。

---

## 3. 网络实测（2026-10-06，本机）

| 站点 | 结果 | 说明 |
| --- | --- | --- |
| **`github.com`** | ❌ **超时 / 0 字节** | **根因**：直连不可用 |
| `dl.espressif.cn` | ✅ HTTP 200 / 0.23 s | 乐鑫 CN CDN，**主力通道** |
| `jihulab.com` | ✅ HTTP 302 / 0.8 s | CN 索引托管地 |
| `gh-proxy.com` | ✅ HTTP 200 | GitHub 代理，可拉取 |
| `ghfast.top` | ✅ HTTP 200 | 备用 GitHub 代理 |
| `pypi.tuna.tsinghua.edu.cn` | ✅ HTTP 200 | 清华 PyPI（PlatformIO 的 pip 依赖用） |

---

## 4. ⭐ 两条通道的**规则**（本文件最有用的部分）

实测归纳出两条可复用的替换规则：

### 规则 A —— **Espressif 官方组织**的 GitHub 资产 ⇒ 走乐鑫 CN CDN
```
github.com/espressif/<repo>/releases/download/...      ← 原始
      ↓  替换
dl.espressif.cn/github_assets/espressif/<repo>/releases/download/...   ← 可直连、快
```
已多例实测通过（`espressif/crosstool-NG`、`espressif/arduino-esp32`、`espressif/esp32-arduino-lib-builder`）。

### 规则 B —— **非 Espressif 组织**（如 `pioarduino/*`）⇒ 走 GitHub 代理
```
https://gh-proxy.com/https://github.com/<org>/<repo>/releases/download/...   （或 ghfast.top 同法）
```

📌 **关键发现（决定了 3.x 迁移能不能离线做）**：`pioarduino/registry` 里那些看着像"工具链包"的 zip，**其实只是清单桩**。
例：`riscv32-esp-elf-14.2.0_20241119.zip` 只有 **1644 字节**，解压后是 `package.json` + `tools.json`。
而 `tools.json` 里给出的**真实工具链地址指向 `github.com/espressif/crosstool-NG`** ⇒ **规则 A 适用，可走 CN CDN**。
⇒ **所以 3.x 迁移所需的大包，绝大多数都能走 `dl.espressif.cn`，不必碰 GitHub。**

---

## 5. PlatformIO 3.x 迁移的完整包清单（每个包实测走哪条通道）

平台：**`pioarduino/platform-espressif32@55.03.30`** ⇒ **Arduino `3.3.0` / IDF `5.5.0`**（`[待确认]` 是否有 framework = `3.3.10` 的更新平台，见 §7）

| 包 | 体积（实测） | 通道 | 实测结果 |
| --- | --- | --- | --- |
| `platform-espressif32-55.03.30.zip`（平台本体） | 2.6 MB | **B** gh-proxy | ✅ HTTP 200 / 2 629 580 B |
| `framework-arduinoespressif32` @ **3.3.0** | 25.8 MB | **A** CN CDN | ✅ HTTP 200 / 25 835 747 B |
| `framework-arduinoespressif32-libs`（IDF v5.5 预编译库） | **430 MB** | **A** CN CDN | ✅ HTTP 200 / 430 471 837 B |
| `toolchain-riscv32-esp`（C3 编译器，win64） | **678 MB** | **A** CN CDN | ✅ HTTP 200 / 677 812 937 B |
| `framework-espidf` @ v5.5.0 | 91 MB | **B** gh-proxy | ✅ HTTP 200 / 91 164 117 B |
| `pioarduino/registry` 各**桩包**（esptoolpy/scons/gdb…） | 1~2 KB | **B** gh-proxy | ✅ HTTP 200 / 985~1644 B |

> ⚠️ **3.x 与 2.0.17 的一个结构差异**：3.x 把框架拆成了 **`framework-arduinoespressif32`（源码）+ `framework-arduinoespressif32-libs`（430 MB 预编译库）** 两包 —— 2.0.17 时代只有一个包。⇒ 迁移时**别只补 framework 就以为齐了**。

---

## 6. 落地步骤（复用既有脚本，不重造）

1. **拿到平台**：经规则 B 下载 `platform-espressif32-55.03.30.zip`，解压到 `~/.platformio/platforms/espressif32/`（或让 PlatformIO 用本地 zip）。
2. **扩展 `06_tests/pio_cn_seed.py` 的 `TARGETS`**：把 §5 表里走**规则 A** 的包加进去（framework @3.3.0 / -libs / riscv32 工具链），URLPattern = `dl.espressif.cn/github_assets/...`。
   - 该脚本已有的能力正好对口：**下载 → 拍平多余顶层目录 → 写 `package.json`/`.piopm`**（解决"乐鑫原版包缺 PlatformIO 清单"的历史坑）。
3. **走规则 B 的包**（平台本体、espidf、各桩包）用 gh-proxy 前缀拉取。
4. **pip 依赖**改清华源：`pip config set global.index-url https://pypi.tuna.tsinghua.edu.cn/simple`（或 `PIP_INDEX_URL` 环境变量）。
5. **跑 `pio run` 验证**：能完成一次**真实编译**才算成功（不是"平台装上"就算）。
6. **做对照验证**（`02_docs/19` §3.2 第 4 条）：与 `arduino-cli` (3.3.10-cn) 产物比对 + 一次台面 + 一次真机。
7. **自持归档**：把 §5 的包 zip 存进项目发布物 / 内网，日后**发布构建不依赖任何外网**。

### 备选（最快，0 下载）
**让老师打包他机器上 `~/.platformio/{platforms,packages}` 直接拷过来** —— 若老师的组内环境已是 pioarduino 3.x，这一步 5 分钟搞定，比任何镜像都快。

---

## 7. 风险与待确认

| # | 项 | 状态 |
| --- | --- | --- |
| 1 | **CN 镜像滞后**：官方 `3.3.12` vs CN `3.3.10-cn` | 已知，接受（钉版本即可） |
| 2 | **pioarduino 是否有 framework = `3.3.10` 的平台**（对齐现板，做到零行为差） | `[待确认]` 需查 pioarduino release 列表；若无则用 `3.3.0` + 对照验证 |
| 3 | **GitHub 代理的长期可用性**（gh-proxy / ghfast.top 属第三方） | ⚠️ 中风险；故 §6.7 的**自持归档**是商业化必需 |
| 4 | **桩包的真实地址可能随 pioarduino 版本变化** | 每次迁移前**重新读一次 `tools.json`**，不要硬编码 §5 的 URL |
| 5 | **`dl.espressif.cn` 只镜像 Espressif 组织的资产** | 已验证；`pioarduino/*` 的资产**不在**其中，必须走代理 |
| 6 | ~~`lib_ldf_mode = deep+` 在 3.x 下是否仍需要~~ | ✅ **已闭环（2026-10-07）**：**禁止带 `+`** ⇒ 改用 `deep` + `main.cpp` 显式 `#include <WiFi.h>` 锚点（§8.4） |

---

## 8. 3.x 落地结果（2026-10-07 实测，已编译成功）

### 8.1 实际落地版本（风险表 #2 闭环）

实际装的是 **`pioarduino/platform-espressif32@55.03.311` = Arduino `3.3.11` / IDF `5.5.5`**，不是 §5 调研时的 55.03.30（3.3.0）。
原因：**pioarduino 跳过了 3.3.10**（tag 序列 `55.03.39`=3.3.9 → `55.03.311`=3.3.11 → `55.03.312`=3.3.12），
故取与板子 3.3.10 **最接近的 3.3.11**；±1 个 patch 的差异由迁移后对照验证覆盖（`02_docs/19` §3.2）。

### 8.2 首次真实编译结果 ✅

`pio run -d 01_firmware/pio_verify` ⇒ **`[SUCCESS] Took 117.17 seconds`**（日志 `03_logs/pio3_m.log`）：

| 指标 | PlatformIO (3.3.11) | Arduino IDE 基线 (3.3.10-cn) | 差 |
| --- | --- | --- | --- |
| RAM | **39 384 B**（12.0% / 327 680） | 39 284 B | **+100 B** |
| Flash | **1 019 703 B**（77.8% / 1 310 720） | 1 004 899 B | **+14 804 B（+1.5%）** |

产物：`firmware.bin` 1 042 912 B · `firmware.elf` · `firmware.factory.bin` · `bootloader.bin` · `partitions.bin`（均在 `01_firmware/pio_verify/.pio/build/esp32c3/`）。
⚠️ 差异在合理预期内（core 差 1 个 patch + 构建系统不同），但**行为等价性未证** ⇒ 仍需 `02_docs/19` §3.2 的台面/真机对照。

### 8.3 `pio_cn_seed.py` v2.0 要点

平台驱动（读 `platform.json` 自动列包）· 桩包解析（读 `tools.json` 取 win64 真实地址）· magic-byte 判格式（sha1 缓存文件无扩展名）· `park()` 改名代替 `shutil.rmtree`（沙箱拦批量删除）· 双通道 `rewrite()`（规则 A/B）· 成功阈值 `MIN_OK=128`（桩包仅 ~1 KB）。

### 8.4 首编路上踩过的 6 个环境坑（重装/换机 playbook）

1. **`MSYSTEM`**：Git Bash 会注入 `MSYSTEM=MINGW64` ⇒ `idf_tools.py` 直接拒绝运行（"MSys/Mingw is not supported"），`unset` 无效（沙箱重注入）。⇒ **必须在 PowerShell 里跑 `pio`**（`Remove-Item Env:MSYSTEM` 保险）。
2. **uv 不认 `PIP_INDEX_URL`**（认 `UV_INDEX_URL`）；且 **esptool 5.x 在 PyPI 只有 sdist 无 wheel** ⇒ uv 编译 sdist 时的批量清理被沙箱拦截。⇒ **预先用 pip 把 16 个 pioarduino 依赖装进 `~/.platformio/penv`**（pip 走 `https://pypi.org/simple`；清华源缺 `pioarduino>=6.1.19`）。
3. **uv `--force-reinstall` 中途超时会拆坏 penv**（先卸后装，卸载完被掐 ⇒ dist-info 缺 `METADATA`）⇒ `pip install --ignore-installed --no-deps <pkg>` 修复（跳过卸载步骤）。
4. **esptool 的 MATCH 守卫**：`penv_setup.py::install_esptool` 先查 `import esptool` 的路径是否指向 `tool-esptoolpy` 包目录，MATCH 才跳过 uv 强装。⇒ **`pip install -e tool-esptoolpy --no-deps --no-build-isolation`**（penv 需先有 setuptools/wheel）+ 补 `bitstring/cryptography/pyserial/reedsolo/PyYAML/intelhex/rich_click<2/click` 8 依赖；**`click` 钉 `<8.4`**（pioarduino 6.2.0 要求 `click<8.4,>=8.0.4`，与 esptool 的 `click<9` 取交集）。
5. **`.piopm.spec.uri` 必须与 `platform.json` 的 URL 版 spec 完全一致**（`test_pkg_spec` 对 URL spec 按 uri 判等）⇒ 不一致时 pio 认为"未安装" ⇒ 触发重装 ⇒ 删除旧包目录（数千文件）被沙箱拦截。**已对 5 个已装包批量对齐 uri**。
6. **`lib_ldf_mode` 禁止带 `+`**（上游 espressif/arduino-esp32#9782：3.x 网络层重构与宏预处理求值冲突 ⇒ WiFi 报 `Network.h` 找不到）；而纯 `deep` 模式下 **LDF 不会跟进 `src/` 之外的 .ino 扫描库依赖**（依赖图为空）⇒ **`src/main.cpp` 显式 `#include <WiFi.h>` 作 LDF 锚点**（include guard 下与 .ino 重复包含无害）。

> 备注：`pio3_m.log` 尾部 `SystemExit: 1 / safe-delete` 噪音是 **SCons atexit 清理临时 .rsp 文件被沙箱拦截**，发生在 `[SUCCESS]` **之后**，对产物无影响。

---

## 变更记录

| 版本 | 日期 | 作者 | 内容 |
| --- | --- | --- | --- |
| v1.0 | 2026-10-06 | 砚青 | 首版。① 用本机两个索引 JSON 确认 `-cn` = 官方 CN 镜像标记（`3.3.10-cn` ↔ 官方 `3.3.10`）与 `jihulab` 索引来源；② 实测网络（`github.com` 超时 = 根因）；③ 归纳两条镜像通道**规则 A/B**；④ 发现 `pioarduino/registry` 是**清单桩**、真实工具链地址回到 `espressif` 组织 ⇒ 可走 CN CDN；⑤ 给出 3.x 迁移的**完整包清单 + 逐包实测通道 + 体积**；⑥ 落地步骤复用 `pio_cn_seed.py`。 |
| v1.1 | 2026-10-07 | 砚青 | §8 落地结果：**`pioarduino@55.03.311`（Arduino 3.3.11/IDF 5.5.5）首次真实编译 SUCCESS**（RAM +100 B / Flash +1.5% vs Arduino 基线）；记录 `pio_cn_seed.py` v2.0 要点与 6 个环境坑 playbook（MSYSTEM / uv 索引 / penv 预装 / esptool MATCH 守卫 / `.piopm` uri 对齐 / LDF 禁 `+`+WiFi 锚点）；风险表 #2/#6 闭环。 |
