jiangtao-ml/ESP32_C3_Gateway/02_docs/08_M5真机联调记录.md

# 08 · M5 接入 QI 真机 —— 联调记录

> 最后更新：**2026-10-06 · 砚青（接手后补齐）** ｜ 事件日期：**2026-10-05**
> 状态：**M5 ✅ 通过**（本记录 = 结项交付物，原为唯一欠交付项）
> 事实来源：`04_ai_prompts/00_context.md`；帧与 CRC 独立复核见 `06_tests/m5_frame_check.py`；字段口径见 `05_hardware/STB3-125_字段字典.csv`。

---

## 1. 目的与范围

把 ESP32-C3 网关从"电脑模拟从站（M4）"推进到**真实 QI 用电采集设备（STB3-125）**，验证：
① 功能码从 `0x03`（回环自测）切到 **`0x04`（读输入寄存器）**；② 3 段读取能拼出完整 39 个寄存器；③ 数据经 UDP 上送到电脑。

**不在本次范围**：JSON 上行（属功能对齐批次 1）、一帧读全 39（E-02，属批次 2）。

## 2. 现场与安全

| 项 | 值 |
| --- | --- |
| 设备 | STB3-125（QI 用电采集，RS-485 / Modbus RTU，**只读**） |
| 现场 | 带电配电箱 `GOOWANT PZ30`（**疑似三相 380V**） |
| 供电隔离 | **充电宝供电 + ESP32 的 USB 数据线已拔**（USB 拔后电脑只看到 COM3/COM4 蓝牙口，无 COM5） |
| 电脑侧 | WLAN `192.168.1.113`；UDP 监听 **8888** |
| ESP32 | 静态 `192.168.1.200`，本地 UDP 端口 `12345` |
| 串口 | 运行期**无串口**（USB 已拔）⇒ 唯一可见通道 = UDP |

## 3. 链路与请求帧

链路：`STB3-125 ──RS-485/Modbus RTU──> ESP32-C3（0x04 轮询 + 打时间戳 + UDP）──UDP 8888──> 电脑`

请求帧（均 8 字节，CRC 已由 `06_tests/m5_frame_check.py` 独立复核）：

| 段 | 覆盖 | 帧 | 期望响应 |
| --- | --- | --- | --- |
| S1 | 30001–30016（0x0000–0x000F，16 个） | `01 04 00 00 00 10 F1 C6` | 37 B |
| S2 | 30017–30032（0x0010–0x001F，16 个） | `01 04 00 10 00 10 F0 03` | 37 B |
| S3 | 30033–30039（0x0020–0x0026，7 个） | `01 04 00 20 00 07 B0 02` | 19 B |

拼接缓冲 = **78 字节 = 39 个寄存器**（S1→偏移 0、S2→32、S3→64）。

## 4. 判据与结果

| 判据 | 结果 |
| --- | --- |
| UDP 在电脑侧真收到包 | ✅ 共 **59 个包**，来源全部 `192.168.1.200:12345` |
| 每包完整 78 字节 / 39 寄存器 | ✅ 全部完整 |
| 读取成功率 | **59/60**（60 s 内少 1 包：20:36:10 与 20:36:12 之间有 **1 秒缺口**，该包未定性） |
| 数据自洽 | ✅ 无锁 / **合闸**、**A 相 222 V**、**49.9 Hz**、**N_temp 24 ℃**、A 相电量高字 4 / 低字 `E5CF` |
| 已知不上报字段处理 | A/B/C_temp 恒 `= -40 ℃`，判为**"型号已知不上报"**（不降级整行） |

**首帧 39 字段判读摘要**（完整表见 `03_logs/M5真机首测_解析_20261005.log`）：

```
reg0  openState 0x00F0 -> 无锁 / 合闸
reg4  frequent  0x01F3 -> 49.9 Hz
reg6  N_temp    0x0040 -> 24 ℃
reg8  A_voltage 0x00DE -> 222 V
reg7  A_temp    0x0000 -> -40 ℃  <<< 无效（接线柱温度传感器缺装，恒量程下限）
reg14 A_H       0x0004 ;  reg15 A_L 0xE5CF -> A 相总电量（公式待定，见 §6）
```

## 5. 证据

| 文件（`03_logs/`，**不入库**） | 内容 |
| --- | --- |
| `M5真机首测_20261005_2035.log` | UDP 原始抓包：59 包、格式 `时间戳 \| HEX`（批次 1 之前的旧上行格式） |
| `M5真机首测_解析_20261005.log` | `m5_parse.py` 的 39 字段解析 + 无效值判定 |

> ⚠️ **证据不入库**：`03_logs/*` 被 `.gitignore` 忽略 ⇒ 上述日志只在本机。本记录即为**入库的结论摘要**。
> 建议（见 `02_docs/18` §2.4）：给 `03_logs/` 加证据白名单，保留原始日志。

## 6. 遗留 / 未闭环（转下一批或待确认）

| # | 项 | 归属 |
| --- | --- | --- |
| 1 | **E-02**：真机是否接受"一帧读全 39"（`01 04 00 00 00 27 B0 10`）未验 —— M5 走 3 段，故不阻塞 | 功能对齐**批次 2** |
| 2 | **电量公式**：`(H*65536)/1000 + L` 与「32 位累加器 /1000」两解差 **1000 倍**（59093.144 vs 320.975 度） | 待确认（`PROGRESS.md` §8.1-1） |
| 3 | `record1/2/3` 半字节 `0` 与 `F` 之别 | 待确认（§8.1-2） |
| 4 | 缺的 1 包（1 秒缺口）未定性 —— 是否偶发丢包，需 M6 长稳观察 | M6 |
| 5 | `RXO` 空闲电平万用表实测仍未做（Q-10） | 待确认（§8.1 相关） |

## 7. 结论

**M5 通过。** 功能码 `0x04` + 3 段读取在真机上稳定工作：数据完整（78 B / 39 reg）、语义正确（合闸 / 222 V / 49.9 Hz）、且能正确区分"型号已知不上的字段"与"本次异常"。**下一步 = 功能对齐批次 1 真机验证**（JSON 上行），之后批次 2 顺带给出 E-02 答案。

## 变更记录

| 版本 | 日期 | 作者 | 内容 |
| --- | --- | --- | --- |
| v1.0 | 2026-10-06 | 砚青（接手） | 首版：补齐 M5 结项记录（原唯一欠交付）。依据 `03_logs/M5真机首测_*` 实测证据与 `06_tests/m5_parse.py` 解析结果。 |
