jiangtao-ml/ESP32_C3_Gateway/02_docs/03_环境搭建记录.md

# M1 环境搭建记录

| 项目 | 内容 |
| --- | --- |
| 文档名称 | M1 环境搭建记录 |
| 版本 | v1.0 |
| 日期 | 2026-10-04（补建；实测发生在 2026-09-27 ~ 10-03） |
| 作者 | WorkBuddy（文档角色） |
| 所属里程碑 | **M1 环境搭建**（阶段二） |
| 状态 | ✅ **已通过** |
| 唯一事实来源 | `04_ai_prompts/00_context.md` |
| 关联 | `02_docs/11_esp32开发板包排障.md`、`05_hardware/接线说明.md`、`02_docs/01_项目任务书.md` §7.3 |

> **说明**：本记录为 M1 的交付物补建（此前结论只散落在任务书 §7.3 的实测表里）。数据来源为任务书 v0.3.x、`00_context.md` 与 `.workbuddy/memory/`。

---

## 1. 目标与验收标准

| 项 | 内容 |
| --- | --- |
| 目标 | 打通开发环境：装 IDE 与开发板包、清点硬件、建目录、确认 COM 号 / 电脑 IP / 网段 |
| 验收 | 能编译并烧录固件；UART1 物理回环通过；网络参数定稿 |

## 2. 完成项清单

| # | 项目 | 结果 |
| --- | --- | --- |
| 1 | Arduino IDE | **2.3.10**（Windows）已安装 |
| 2 | 开发板包 / 工具链 | ✅ **已打通** —— 见第 3 节（曾卡在 `esp-rv32@2601`） |
| 3 | 编译验证 | ✅ `arduino-cli compile --fqbn esp32:esp32:esp32c3:CDCOnBoot=cdc 01_firmware/esp32c3_gateway` 通过 |
| 4 | COM 号 | ✅ **ESP32 = `COM5`**（`VID:PID 303A:1001`，原生 USB CDC，板上无 CH340）；USB 转 485 另占一口（CH340 `1A86:7523` / FTDI `0403:6001`）。换 USB 口会变 |
| 5 | 电脑 IPv4 / 网段 | 2026-09-27 实测 **192.168.1.117** / 掩码 255.255.255.0 / 网关 192.168.1.1 / 网段 `192.168.1.0/24`（WLAN 网卡；VMnet1/VMnet8 为虚拟网卡，忽略） |
| 6 | ESP32 静态 IP | **192.168.1.200**（避开 DHCP 池 .100–.199） |
| 7 | SSID | 学校统一管理 WiFi，**无需网页登录**；手机 2.4GHz 热点为退路 |
| 8 | 工程目录 | ✅ 六目录 `01_firmware` ~ `06_tests` 建立 |
| 9 | 固件工程骨架 | ✅ `01_firmware/esp32c3_gateway/`（`.ino` / `config.h` / `secrets.h.example` / `README.md`） |
| 10 | UART1 物理回环 | ✅ 见 `02_docs/05_485回环记录.md`（M3，M1 的收口项） |

## 3. 开发板包 / 工具链排障（M1 的主要障碍）

**现象**：开发板管理器装包下载失败。

**根因与修正**：

- **ESP32-C3 是 RISC-V 芯片 → 工具链是 `esp-rv32`（如 `esp32:esp-rv32@2601`）**，不是 Xtensa 的 `esp-x32`。名字看错会让排障方向跑偏（项目早期记录即误记为 `esp-x32`）。
- 使用 **CN 镜像**：`https://jihulab.com/esp-mirror/espressif/arduino-esp32/raw/gh-pages/package_esp32_index_cn.json`
- 配完镜像**必须完全关闭并重启 Arduino IDE** 才生效；开发板管理器里**必须选带 `-cn` 后缀的版本**。
- **判断镜像是否生效**：看下载 URL 指向 `jihulab.com` 才算生效；仍指向 `github.com` / `20.205.243.166` 则未生效。

**完整四方向排障手册**：`02_docs/11_esp32开发板包排障.md`（v1.2，状态：已解决）。

## 4. 编译选项（M1 定稿，后续里程碑沿用）

| 项 | 设置 |
| --- | --- |
| 开发板 | `ESP32C3 Dev Module` |
| **USB CDC On Boot** | **Enabled** ← 必需，否则 `Serial` 无输出，且 `Serial` 会占 GPIO20/21 与 `Serial1` 冲突 |
| Flash Size | 4MB (32Mb) |
| Upload Speed | 921600（不稳定时降到 115200） |
| CPU Frequency | 160MHz |

编译产物（Codex 2026-10-03 用 `arduino-cli v1.5.1` 复验）：**Flash 997299 B (76%) / RAM 38244 B (11%)**，零错零警告。

## 5. M1 遗留项（已并入后续里程碑）

| 遗留 | 去向 | 现状 |
| --- | --- | --- |
| `RXO` 空闲电平万用表实测 | M4 重测强制项 | ⚠️ **仍未实测**（拆分压后直连可用，但无定量依据） |
| `EN` 引脚接入 | M4 重测强制项 | ✅ 已接固定高电平，M4 通过 |

## 6. 教训（写入长期记忆）

1. **`esp-rv32` ≠ `esp-x32`** —— ESP32-C3 是 RISC-V。
2. CN 镜像配完**必须重启 IDE** 并选 `-cn` 后缀版本。
3. `USB CDC On Boot = Enabled` 是本项目**硬性要求**（不是可选优化）。

## 7. 变更记录

| 版本 | 日期 | 作者 | 变更内容 |
| --- | --- | --- | --- |
| v1.0 | 2026-10-04 | WorkBuddy | 首版（M1 交付物补建）。汇总完成项清单、开发板包排障（`esp-rv32` / CN 镜像 / 重启 IDE）、编译选项定稿、遗留项与教训。 |
