jiangtao-ml/ESP32_C3_Gateway/02_docs/07_模拟从站记录.md

# M4 电脑模拟 Modbus 从站 — 测试记录（进行中·硬件阻塞）

| 项目 | 内容 |
| --- | --- |
| 文档名称 | M4 电脑模拟 Modbus 从站 — 测试记录 |
| 版本 | v0.2（进行中，未定稿） |
| 文档状态 | **进行中（阻塞：硬件故障，待新硬件到货）** |
| 作者 | WorkBuddy（文档角色） |
| 创建日期 | 2026-10-03 |
| 覆盖时段 | 2026-09-30 ~ 2026-10-03 |
| 所属里程碑 | **M4**（阶段三 分模块验证） |
| 唯一事实来源 | `04_ai_prompts/00_context.md` |
| 关联文档 | `02_docs/01_项目任务书.md`（§7.1 M4 / §9.1 M4）、`README.md`（§6.2 安全约束）、`02_docs/06_QI协议说明.md`（§6 帧边界）、`.workbuddy/memory/MEMORY.md`（硬件安全红线） |

> **本文档定位**：M4 实测的过程记录与故障复盘。**不含任何业务代码**，不修改 `00_context.md` / `README.md` 原文，仅供内部分析与归档。
> **纪律**：推测性内容一律标注「推测」；未确认项标 `[待确认]`。

---

## 1. 里程碑目标与验收标准（引用）

| 项 | 内容 | 来源 |
| --- | --- | --- |
| 交付核心 | 协议层解析正确（含超时与 CRC 容错） | 任务书 §7.1 |
| 关键动作 | ESP32 发**回环自测帧（功能码 0x03）**，电脑模拟从站返回合法响应；串口打印解析出的数值；从站不回包时超时按预期触发 | 任务书 §6.4 / §9.1 M4 |
| 成功条件 | ① `01 03 00 00 00 02 C4 0B` 获合法响应且 CRC 校验通过；② 两级超时按预期触发（首字节 50-100ms / 字符间隔 3-5ms / 300ms 兜底）；③ 连续 10 次超时后仍完成后续轮询；④ 故意注入 1 位 CRC 错误能被识别并丢弃且不崩溃 | 任务书 §9.1 M4 |
| 通信参数 | 从站地址 1，9600，8N1，无校验 | 任务书 §6.3 / `06_QI协议说明.md` §1 |
| 帧边界 | M3/M4 **只用 0x03 回环自测帧**，不得与 0x04 真机帧混用 | `06_QI协议说明.md` §6 |

---

## 2. 测试环境与链路方案

**方案：真实 485 总线**（非 UART 短接回环）

```
ESP32 UART1 ──MAX13487──▶ A/B 总线 ──▶ USB 转 485 ──▶ 电脑（Modbus 从站模拟器）
```

| 要素 | 内容 |
| --- | --- |
| 主控 | ESP32-C3 SuperMini（主控板 PCB 型号 HW-466AB），`Serial1` = UART1，RX=GPIO20 / TX=GPIO21 |
| 485 收发 | MAX13487（+5V，AutoDirection，无 DE/RE 控制引脚） |
| 电脑侧 | USB 转 485 模块（**本期为旧模块：仅 A/B 端子，无 GND**） |
| 从站工具 | **Modbus Slave**（Witte Software，modbustools.com）—— 用户已选定（由用户 2026-10-03 确认）；备选 `pymodbus`。用法见 `01_firmware/esp32c3_gateway/README.md` |
| 从站参数 | 地址 1、9600、8N1、无校验 |

---

## 3. 故障现象

- ESP32 串口**持续**输出 `[M4] 超时`，超时参数为 **首字节 80ms / 字符间隔 4ms / 兜底 300ms**。
- 链路始终表现为 **`RX=0`（期望 9 字节）**，即**从站方向完全没有回包**。
- 超时参数本身**落在任务书 §6.1.2 规定区间内**（50-100ms / 3-5ms / 300ms），**不构成故障原因**。

**现象归类**：属"**接收通路无数据**"，可能来源为 ① 从站未响应、② 总线物理层不通、③ 接收侧（MAX13487 → GPIO20）通路异常、④ 电脑侧收发模块失效。

---

## 4. 排查过程与结论

### 4.1 排查方法：隔离法 + 自环测试

目的：把 ESP32 从链路中摘出，**单独验证电脑侧 USB 转 485 模块自身的收发通路**，从而把"模块故障"与"固件/接线故障"分离。

步骤：

1. 断开 ESP32。
2. 仅保留旧 USB 转 485 模块插在电脑上（该模块**只有 A/B 端子、无 GND 端子**）。
3. **短接该模块的 A/B 线**，构成自环（发送 `abc`）。
4. 观察接收区。

### 4.2 观察结果

- **接收区一片空白**，未回显 `abc`。

### 4.3 结论

| 项 | 内容 |
| --- | --- |
| **主结论** | ~~**旧 USB 转 485 模块物理损坏**~~ |
| **⚠️ 2026-10-04 更正** | **该判定已推翻，须复验。** 其所依据的「A/B 短接自环」是本项目的**方法学错误**——两线半双工 485 短接 A/B 后 `V_AB ≡ 0`，接收器落入 ±200mV **不定区**，**健康模块同样不回显**，故该测试无判别力。详见 `02_docs/13_M4排障记录_2026-10-04.md` §2（含 MaxLinear / Renesas / Industrial Monitor Direct 三处权威依据）。 |
| 判定依据 | 隔离状态下、不依赖 ESP32 与 MAX13487 的纯自环测试即无回显，故障域被限定在"电脑 + USB 转 485 模块"这一环 |

**推测的损坏原因**（未做破坏性验证，标注为**推测**）：

| 推测原因 | 机理描述 | 可信度 |
| --- | --- | --- |
| 前期 **TX-TX 短路**导致大电流 | 两个发送端对接时，输出驱动器可能互相灌电流，超出器件承受范围 | 推测 |
| **强电共地引入电势差** | 现场存在强电环境；模块无 GND 端子，地电位浮动差可能击穿收发芯片 | 推测 |

### 4.4 结论的置信度与残余不确定性（**待新模块到货后排除**）

| 编号 | 残余不确定性 | 排除方法 |
| --- | --- | --- |
| U-1 | 自环空白也可能由**串口驱动未安装/异常、COM 口选错、串口助手参数不匹配**导致（本次未单独记录 COM 口与驱动状态） | 新模块到货后用**同一自环法**复测，与本次结果对照 |
| U-2 | **GPIO20 可能已受损**：本次接线**未加分压**（见 §5.2），5V 直入已超其绝对最大额定 3.6V。若新模块到货后仍为 `RX=0`，应优先怀疑 GPIO20 输入通路 | 做 GPIO20 输入通路验证 / 换脚对照（**先排除此项，再怀疑新模块**） |

> 重要性：U-2 会让"打坏引脚"伪装成"模块又坏了"，从而显著延长排障时间，**必须在新模块到货后的第一轮就排除**。

---

## 5. ⚠️ 安全隐患与违规记录

### 5.1 共地缺陷（环境性隐患）

| 项 | 内容 |
| --- | --- |
| 事实 | 旧 USB 转 485 模块**只有 A/B 端子、无 GND 端子** |
| 后果 | ESP32、MAX13487 与电脑之间**无法建立统一的 0V 参考点**，易形成**地环路电流**，轻则误码、重则烧毁模块 |
| 定性 | **违背** `MEMORY.md` 硬件安全红线**第 1 条**「所有 GND 共地（含 USB 转 485）」；同时违背 `README.md` §6.2 安全约束第 1 条 |
| 处置 | ✅ **已闭环（2026-10-04）**：带 GND 端子的 CH340 模块已到货并投入使用；**旧模块（黑，FTDI）经双端口背靠背互测证明收发完全正常（双向 5/5）** —— 此前"物理损坏"判定**已推翻**。⚠️ 旧模块的真实缺陷只有"缺 GND 端子"（真机上仍建议更换）。 |

### 5.2 未按文档要求做分压（**明确违规操作**）

| 项 | 内容 |
| --- | --- |
| 事实 | 实际接线中**未给 ESP32 GPIO20 加 1kΩ / 2kΩ 分压电阻**，RXO 侧信号未经降压直接进入 GPIO20 |
| 定性 | **严重违反** `MEMORY.md` 硬件安全红线**第 2 条**，以及 `README.md` §6.2 安全约束第 2 条 |
| 规定接法 | `RXO —[1kΩ]— 分压节点 —[2kΩ]— GND；分压节点接 GPIO20`；**严禁只串 1kΩ 直连** |
| 风险 | GPIO20 绝对最大额定 = VDD+0.3V = **3.6V**；直连 5V 可能**永久损坏引脚** |
| **与本次故障的关系** | **不是**本次 `RX=0` 的直接原因（故障已定位到 USB 转 485 模块侧），但属**独立的高危违规**，必须单独立项整改；**不得因"这次不是它引起的"而忽略** |
| 保护 GPIO20 的必要性（重申） | GPIO20 既是本项目唯一的 485 接收入口，又是 ESP32-C3 的 UART0 默认引脚；一旦损坏，需换脚改接并同步修改固件与文档，代价远高于一颗 1kΩ + 一颗 2kΩ 电阻 |

### 5.3 强电 / 弱电直连风险（老师现场额外警告）

老师在群内特别提醒：

> 「采数据时要用**充电宝供电，不要用电脑**」
> 「**MAX13487 是 5V 双向的，不要切换 EN 引脚**」

| 项 | 内容 |
| --- | --- |
| 风险机理 | 后续接入 **220V 强电环境的 QI 真机**时，若电脑与现场共地，将经 USB 形成**强电—弱电通路**，**极易烧毁电脑主板** |
| 对策方向 | 接入真机前**必须**引入 **RS485 隔离模块**，或**断开电脑供电**（改用充电宝/独立电源） |
| 与既有口径的关系 | **⚠️ 口径已于 2026-10-03 更正（见 §5.4）**：「不要切换 EN 引脚」的真实含义是「**EN 要接固定电平，不要当作方向脚来回切换**」，而**不是**"保持断开"。原「EN 未确认前保持断开」口径**已作废** |
| 落地时点 | **M5（接入 QI 真机）开始前必须闭环**，不得带入 M5 |

### 5.4 EN 引脚口径更正（2026-10-03）—— **撤回「保持断开」**

> **⚠️ 历史记录（写于实物芯片型号核实前）**：本节结论建立在「本模块为 MAX13487 / MAX13488」的前提上。购买页为**三合一款**（`MAX3485` / `MAX485` / `MAX13487`）、页面渲染图丝印为 **`MAX485 ESA`**，**实物 8 脚芯片型号待丝印复核**；**现行口径一律以 `04_ai_prompts/00_context.md` 三.5 为准（条件式，先读丝印）**。若实物为 `MAX485 / MAX3485`，本节「EN 接固定高电平」的结论**不适用**（须改为 GPIO 动态切换方向）。

**触发**：老师指出"做不出来正是因为 EN 断开"。复核后**老师是对的**，本项目此前口径有误。

**原口径的立论前提**：EN 可能是 `DE`（驱动使能）；若为 DE 而接高，驱动器会**长期使能、占死总线**。因此"不接"被视为最保守选项。该前提同时来自 Codex 技术审查（`02_docs/02_任务书技术审查_Codex.md` 第 9 点 / H-1）。

**新证据（MAX13487E 官方数据手册 8 脚 SO）**：

```
1 RO    2 RE#    3 SHDN#    4 DI    5 GND    6 A    7 B    8 VCC
```

**该芯片根本不存在 `DE` 引脚** → 原立论前提不成立。模块丝印「EN」的真实候选只剩 `RE#` 与 `SHDN#`。

**重新判定**：

| 模块丝印 EN 实际是 | 悬空 | 接固定高电平 |
| --- | --- | --- |
| `RE#`（低有效接收使能；数据手册：拉高即交由 AutoDirection 控制接收器） | 芯片内部**热插拔上拉**会把它拉高 → AutoDirection 正常接管 ✓ | ✓ 同样正确 |
| `SHDN#`（低电平关断；数据手册：拉高才正常工作） | 悬空可能被拉低 → **器件进入关断，A/B 无任何差分输出** ❌ | 正常工作 ✓ |

→ **接高在两种诠释下都正确；悬空只在 `RE#` 情形下安全。**

**本记录（历史）曾写成**：EN 接固定高电平（首选 VCC/5V，3.3V 亦可）。**⚠️ 该结论已随实物型号复核要求二次更正为条件式** —— 以 `04_ai_prompts/00_context.md` 三.5 为准：`MAX13487 / MAX13488` → 接固定高电平；`MAX485 / MAX3485` → 必须由 GPIO 动态切换方向，**严禁固定接高**。**丝印未读前不得给 EN 接任何电平。**

**对本轮 `RX=0` 的意义（重要）**：

- 若 EN 实为 `SHDN#` 且此前悬空 → **MAX13487 处于关断态**，与实测的"完全无回包、`RX=0`"**完全吻合**。
- 因此 `RX=0` 很可能是**双重原因**：① USB 转 485 模块损坏（已确认）；② MAX13487 被 EN 关断（待验证）。**两项都必须修，缺一不可** —— 只换模块而不处理 EN 仍会失败。
- 也解释了**为什么 M3 通过而 M4 不通**：M3 的 `GPIO21 → GPIO20` 短接回环**绕过了 MAX13487**，EN 问题不会暴露。**"M3 回环通过"不等于"485 通路已验证"。**

**需同步的外部文件（不属于本记录职权，待用户/总控确认）**：

| 文件 | 位置 | 现文 | 应改为 |
| --- | --- | --- | --- |
| `04_ai_prompts/00_context.md` | 三.5 | ~~EN 未确认前保持断开~~ → 曾改为「接固定高电平」 | ✅ **已二次更正为条件式**（随实物芯片型号二选一，先读丝印） |
| `README.md` | §6.1 | 同上 | ✅ 已同步为条件式（含「先读丝印」阻塞条） |
| `02_docs/01_项目任务书.md` | §5.2 第 5 条、§5.3、§7.3、§10 R-06、§11.3 Q-09、附录 A | 同上 | ✅ 已同步为条件式 |
| `.workbuddy/memory/MEMORY.md` | 措辞与术语口径 | 同上 | **✅ 已由 WorkBuddy 于 2026-10-03 更正** |
| `.workbuddy/memory/2026-10-03.md` | §三.3 / §七 | 同上 | **✅ 已由 WorkBuddy 于 2026-10-03 更正** |

---

## 6. 纠正措施与 M4 重测强制准备

| # | 措施 | 状态 |
| --- | --- | --- |
| 1 | 已购买**带 GND 端子的 CH340 芯片 USB 转 485 模块** | ✅ **已到货并投入使用**（2026-10-04） |
| 2 | 新模块到货后，先按 §4.1 自环法**单测模块自身**（发 `abc` 应回显） | ⏳ 待执行 |
| 3 | 若自环通过仍 `RX=0` → 按 §4.4 U-2 排查 **GPIO20 是否受损** | ⏳ 条件触发 |
| 4 | 电脑端 Modbus 从站模拟器工具选型 | ✅ **已选定 Modbus Slave**（由用户 2026-10-03 确认）（备选 `pymodbus`） |
| 5 | 保留本次排查日志与自环测试记录，作为项目风险应对的**实证** | ✅ 已归档 |

### 6.1 M4 重测「强制准备清单」（逐项打勾后方可通电）

- [ ] **加入 1kΩ / 2kΩ 分压**：`RXO —[1kΩ]— 分压节点 —[2kΩ]— GND；分压节点接 GPIO20`（**严禁只串 1kΩ 直连**）
- [ ] 上电前用万用表**实测 RXO 空闲电平**（5V → 分压；3.3V → 直连，加分压反而掉到 2.2V < VIH 2.475V）
- [ ] 新 USB 转 485 模块的 **GND 接入面包板共地**（与 ESP32、MAX13487 同一参考点）
- [ ] 逻辑侧接线核对（**交叉对接，已实测确认**）：**ESP32 `GPIO21`（TXD）→ 模块 `RXD`**、**ESP32 `GPIO20`（RXD）← 模块 `TXD`**。
      > ✅ **2026-10-04 M4 实测结论：本模块采用「交叉」约定。** 模块丝印写的是**模块自身的收发方向** —— 模块 `TXD` = 芯片 `RO`（接收**输出**）、模块 `RXD` = 芯片 `DI`（发送**输入**）。
      > ⚠️ **本行原文本写的就是交叉对接，是对的**；2026-10-04 早前被 WorkBuddy 依据固件 README 误改为"同名对接"，导致现场按「`GPIO21` → 模块 `TXD`」接线 → **双向全断**（`GPIO21` 顶在芯片输出脚对撞、`DI` 从未被驱动；模块电源灯仍亮，极易误判为硬件故障）。**现已回滚。**
      > 实测依据：对调这两根线后，总线上立即出现 `01 03 00 00 00 02 C4 0B`；M4 连续 **65 秒 65 次解析 OK、0 超时 / 0 CRC 失败 / 0 帧长异常**。详见 `02_docs/13_M4排障记录_2026-10-04.md` §9。
- [ ] **EN 按实物丝印结论接入**（先读 8 脚芯片丝印）：`MAX13487 / MAX13488` → 接固定高电平（首选模块 VCC/5V，3.3V 亦可），不得悬空 / 接 GND / 动态切换；`MAX485 / MAX3485` → 接方向控制 GPIO 由固件切换，**严禁固定接高**。以 `04_ai_prompts/00_context.md` 三.5 为准
- [ ] A/B 极性与丝印核对，且整条总线定义统一
- [ ] 确认**未**使用电脑供电给强电侧（真机阶段改用充电宝/独立电源或加隔离模块）
- [ ] 确认 `USB CDC On Boot = Enabled`（否则 `Serial` 占用 GPIO20/21 与 `Serial1` 冲突）

---

## 7. 进度影响与风险登记

| 项 | 内容 |
| --- | --- |
| 延误时段 | **2026-09-30 ~ 2026-10-03**，约 **4 天** |
| 延误性质 | **外部硬件失效导致**，非设计缺陷、非代码缺陷 |
| 结转内容 | M4 全部验收内容（合法响应、两级超时、CRC 容错、10 次超时后继续轮询）顺延至新模块到货后 |
| 实证留存 | 本次排查日志（`.workbuddy/memory/2026-10-03.md`）+ 本记录 |

**风险登记（已于 2026-10-03 并入任务书 §10：R-12 / R-13 / R-14）**：

| 临时编号 | 风险 | 影响 | 应对 | 状态 |
| --- | --- | --- | --- | --- |
| R-12 | **USB 转 485 模块选型缺陷**（无 GND 端子）→ 无法共地 | 通信不可用；地环路可能烧模块 | 只采购**带 GND 端子**的模块；到货先自环自测 | 处置中 |
| R-13 | **未加分压导致 GPIO20 受损**（5V 直入超 3.6V 绝对最大额定） | 引脚永久损坏 → 需换脚并改固件/文档 | M4 重测**强制加分压**；新模块到货先排除 U-2 | 待整改 |
| R-14 | **强电环境经电脑共地** | **烧毁电脑主板** | 真机阶段引入 **RS485 隔离模块**或**断开电脑供电**（充电宝） | **M5 前必须闭环** |

---

## 8. 待确认

| 编号 | 事项 | 状态 |
| --- | --- | --- |
| C-01 | 电脑端 Modbus 从站模拟器工具选型 | ✅ **已闭环**：选 **Modbus Slave**（Witte Software），备选 `pymodbus`；二者**不同时占用同一 COM 口** |
| C-02 | 新 USB 转 485 模块实际到货时间 | ✅ **已闭环**：已到货并投入使用（2026-10-04）。**旧模块亦经互测证明完好**，"物理损坏"判定已推翻 |
| C-03 | 新模块自环测试结果（排除 U-1） | `[待确认]` |
| C-04 | GPIO20 输入通路是否完好（排除 U-2） | `[待确认]` |
| C-05 | 本次自环测试时的 COM 口号与串口驱动状态（用于对照复测） | `[待确认]` |
| C-06 | R-12 / R-13 / R-14 是否正式并入任务书 §10 风险表 | ✅ **已闭环（2026-10-03）** —— 三条已并入任务书 §10（任务书 v0.3.5） |
| C-07 | **EN 按实物丝印结论接入后链路是否恢复收发**（验证 §5.4 判定；**现行口径见 CTX 三.5**） | `[待确认]`（新模块到货后与分压、共地一并验证；**先读实物芯片丝印**） |
| C-08 | **仅当实物为 `MAX13487 / MAX13488` 时**：供 EN 使用的高电平取 **5V（模块 VCC）** 还是 **3.3V** | `[待确认]`（两者均满足 VIH ≥ 2.0V，建议优先 VCC 同电源域）；**若实物为 `MAX485 / MAX3485`，本项作废，改为「方向控制 GPIO 编号与切换时序」** |

---

## 9. 变更记录

| 版本 | 日期 | 作者 | 状态 | 变更内容 |
| --- | --- | --- | --- | --- |
| v0.1 | 2026-10-03 | WorkBuddy | 草稿（进行中，硬件阻塞） | 初稿。记录 M4 真实 485 总线方案的故障现象（`RX=0` / 首字节 80ms / 字符间隔 4ms / 兜底 300ms）、隔离法自环测试排查过程与结论（旧 USB 转 485 模块物理损坏）、结论置信度与 2 项残余不确定性、3 项安全隐患与违规记录（共地缺陷 / 未加分压违规 / 强电直连风险及老师警告）、纠正措施与 M4 重测强制准备清单、4 天进度延误与 R-12~R-14 风险登记。**未涉及任何代码改动，未修改 `00_context.md` 与 `README.md` 原文。** |
| v0.2 | 2026-10-03 | WorkBuddy | 草稿（进行中，硬件阻塞） | **EN 引脚口径更正**：依据 MAX13487E 官方数据手册（8 脚 = `RO/RE#/SHDN#/DI/GND/A/B/VCC`，**无 DE 脚**），撤回「EN 未确认前保持断开」口径，改为「**EN 接固定高电平，不得悬空 / 接 GND / 动态切换**」（新增 §5.4）；同步更正 §5.3 表述、§6.1 重测清单（"三必做"→"四必做"）；新增待确认 C-07 / C-08；登记需外部同步的 5 个文件位置。**`RX=0` 结论修订为双重原因（模块损坏 + EN 关断），并说明 M3 回环绕过 MAX13487 故测不出该问题。** |
