jiangtao-ml/ESP32_C3_Gateway/02_docs/12_全仓库审查报告_Codex.md

# 全仓库审查报告（Codex）

- 审查日期：2026-10-03
- 审查基线：`dc132c1`（`阶段2: M4 实现真实485收发与Modbus RTU解析`）
- 审查范围：仓库全部文件（固件 / 文档 / 协议 / 硬件资料 / Git 卫生）
- 事实来源优先级：`04_ai_prompts/00_context.md` > 其它材料（冲突以 CTX 为准）
- 授权：用户已授权 Codex 直接改动文件（“授权我直接改文件，怎么更好你怎么来”）

---

## 0. 结论摘要

| 级别 | 事项 | 状态 |
| --- | --- | --- |
| 🔴 高 | **R-13：M4 接线未加分压、5V 直入 GPIO20**（ESP32-C3 绝对最大额定 3.6V）→ GPIO20 输入通路可能已受损 | 已登记并写入 README §8-10 / CTX 五节；**新模块到货后必须先验 GPIO20** |
| 🔴 高 | **实物 485 模块主芯片型号未定**：商品页为三合一款，渲染图丝印 `MAX485 ESA`；MAX13487 与 MAX485 的 EN 接法互斥 | 已登记为最高优先阻塞项，需用户读实物丝印 |
| 🟠 中 | **EN 语义在旧文档中曾写“悬空或接 3.3V”** | 已按总控裁定改为“按芯片型号二选一”，存档件按约定保留原文 |
| 🟠 中 | **固件缺方向控制能力**（若实物为 MAX485 则无法工作） | 已内建可选宏 `RS485_DE_PIN`（默认 `-1` 不启用），编译通过 |
| 🟠 中 | 心跳标签 `M2_HEARTBEAT` 在 M4 固件中语义过期 | 已改为 `HEARTBEAT`（历史实测记录保留原样） |
| 🟠 中 | README 把 M4 阻塞原因写成“无 GND 端子”，与 07_ 记录（模块侧物理损坏）不一致 | 已统一 |
| 🟡 低 | “模块自带 4.7kΩ 偏置电阻”无来源依据（商品页只写 120Ω 匹配电阻） | 已改为“待 M3 实测” |
| 🟢 已闭环 | QI 协议（R-01）、工具链（esp-rv32）、UDP 8888、secrets 脱敏、CRC 复核 | 见下 |
| 🟢 新增闭环 | **MAX13487E/88E 官方数据手册核实**（EN 接法、偏置电阻要求、DI 空闲态） | 手册原件入库 `05_hardware/MAX13487E_MAX13488E_Datasheet.pdf`；结论见第 9 节 |

**一句话总结**：文档体系的一致性明显好于一般原型项目（协议、勘误、任务书、CTX 四方对齐）；真正的风险**不在代码，而在两块硬件**——模块芯片型号未定、GPIO20 可能已被 5V 打伤。代码侧本轮补齐了“如果实物是 MAX485 该怎么办”的开关，并修正了若干语义过期点。

---

## 1. 用户 9 条逐条答复

| # | 用户问题 | 结论 | 依据 / 处置 |
| --- | --- | --- | --- |
| 1 | 项目用的是 13487 | **暂按 MAX13487 记录，但实物未证实** | CTX 三.5 / README §6.1 已按“二选一”写；商品图丝印为 `MAX485 ESA`，与口述冲突。**必须读实物丝印**（见第 2 节 H-1） |
| 2 | `secrets.h.example` 不是误删，觉得没用 | **有用，必须保留（当前也确实还在）** | `git ls-files` 显示 `01_firmware/esp32c3_gateway/secrets.h.example` 已入库且工作区存在；`config.h` L7、固件 README「首次搭建」、任务书 §8.2（M1 交付物）三处引用它。删掉会让新接手的人不知道 `secrets.h` 该写什么 |
| 3 | `02_docs/07_模拟从站记录.md` 是否入库 | **应入库（随本次提交入库）** | 它是任务书 §8.2 的 M4 交付物（模拟从站自测记录）；不入库会导致 M4 验收物缺失 |
| 4 | 新模块到货？旧模块损坏确认？ | **新模块：未到货；旧模块：按 §4.1 自环法判定“模块侧物理损坏”，但用户要再试一次** | `07_模拟从站记录.md` §5.1 / C-02 已更正为“未到货，到货前用旧模块按 §4.1 自环法复测”；README §8-10 同步 |
| 5 | 电脑端 Modbus 从站模拟器选型 | **已定 Modbus Slave（Witte Software），备选 pymodbus** | 已写入 `07_模拟从站记录.md` §3、README §8-11、固件 README M4 章节 |
| 6 | QI 协议已给，自行审查 | **已全量复核：50 条完整帧逐条重算，唯一不通过的是 E-01 一帧** | 见第 3 节。协议本身质量高，可用；三处需注意（E-01 / E-02 / E-03） |
| 7 | UDP 8888 是否最终？12345 是否登记？ | **8888 = 最终（M2 实测可用）；12345 已登记** | README §8-3、CTX 五节 L54/L56、`config.h` L17/L18 四处一致 |
| 8 | 授权直接改文件 | **已按“最小必要改动 + 全文一致”执行** | 本轮改动见第 7 节；存档件（`02_`/`03_`）遵守约定只追加勘误节 |
| 9 | 你看着来 | 已按上述执行，另附第 8 节“仍需你确认”清单 | — |

---

## 2. 高风险项（需立即决策）

### H-1（最优先）实物 485 模块主芯片型号未定 —— 它决定 EN 能不能接、接什么

- 证据链：商品页是**三合一款**（`MAX3485` 3.3V 单向 / `MAX485` 5V 单向 / `MAX13487` 5V 双向）；页面渲染图芯片丝印清晰可读为 **`MAX485 ESA`**；用户与老师口述为 MAX13487。**页面图不能代表实物，口述也不能替代丝印。**
- 为什么致命：两类芯片的 EN 语义**互斥**—— 
  - `MAX13487 / MAX13488`：芯片本身无 DE 脚，EN 对应 `RE#` / `SHDN#`，**必须固定高电平**，动态切换反而会关断器件；
  - `MAX485 / MAX3485`：EN 就是方向控制脚，**必须由 GPIO 按收发切换**，固定接高会占死总线（自己发的字节被自己收回来，从站永远无法应答）。
- 另外两点随型号变：供电（MAX3485 = 3.3V，其余 = 5V）、RXO 空闲电平（决定要不要 1k/2k 分压）。
- 需要用户做：**用手机微距 / 放大镜拍下模块上 8 脚芯片的丝印**，回复 `MAX13487` 还是 `MAX485`/`MAX3485`。

### H-2 R-13：GPIO20 可能已被 5V 打伤

- 事实：本次 M4 接线**未加分压**，MAX13487 的 RXO（5V 电平）直接进了 GPIO20，而 ESP32-C3 的 IO 绝对最大额定是 **3.6V**。
- 后果：GPIO20 的输入通路可能已经受损，或者“偶发能收、偶发收不到”。这会造成**误判**——把“引脚坏了”当成“模块又坏了”，白买模块、白折腾。
- 处置：新模块（或旧模块复测）到手后，**先做 GPIO20 输入通路验证**再怀疑模块：
  1. 先用 M3 回环模式（`RS485_MODE_LOOPBACK_SELFTEST = 1`，短接 GPIO21↔GPIO20）跑 1 分钟：若回环 100% OK → GPIO20 输入通路基本正常；
  2. 若回环异常（字节缺失 / 恒为 0 / 恒为 1）→ 换用其它可用 GPIO 作 UART1 RX（如 GPIO4 / GPIO5 / GPIO10），同步改 `config.h` 的 `RS485_RX_PIN`、README §6.1、CTX 三节；
  3. 真机上另可用万用表二极管档测 IO 对 VDD/GND 是否击穿（可选）。

### H-3 E-02 / E-03（协议侧）

- E-02：原文写“数据长度不能超过 16”，但“读全部参数”用 `00 27`（39 个）。**只能真机验证**；固件侧 M5 默认走 3 段方案（CRC 已独立复核）。
- E-03：原文把 `01 06 00 0D 00 00 18 09` 标注为“远程锁扣”，按寄存器表它实际写的是 **40014 = 远程分闸**。属**静默高危**：照抄执行会误拉闸。已登记，本阶段**一律禁止执行任何控制类命令**。

---

## 3. CRC 全量独立复核（回答第 6 条）

- 方法：自写 `CRC16/Modbus`（初值 `0xFFFF`、多项式 `0xA001`、反射/逐位、**低字节在前**），对协议原文、`06_QI协议说明.md`、`05_hardware/STB3-125_Errata.md`、固件 README、`config.h` 中出现过的命令帧逐条重算。
- 结果：**50 条完整帧（26 条命令帧 + §3.4 响应示例帧 + E-02 分段帧 3 条 + E-03 候选帧 4 条等）逐条重算，唯一不通过的是 E-01 一帧**；另 1 条“看似不符”实为**书写口径差异**。（此前写作“33 条通过”，计数与口径均有误，本轮更正。）

| 帧 | 独立计算 CRC | 结论 |
| --- | --- | --- |
| `01 03 00 00 00 02 C4 0B`（回环自测帧） | `0x0BC4` ✓ | 正确 |
| `01 04 00 00 00 27 B0 10`（读全部参数 39 个） | `0x10B0` ✓ | 正确 |
| `01 04 00 09 00 01 E1 C8`（读 A 相电流） | `0xC8E1` ✓ | 正确 |
| `01 04 00 00 00 10 F1 C6`（E-02 S1） | `0xC6F1` ✓ | 正确 |
| `01 04 00 10 00 10 F0 03`（E-02 S2） | `0x03F0` ✓ | 正确 |
| `01 04 00 20 00 07 B0 02`（E-02 S3） | `0x02B0` ✓ | 正确 |
| `01 06 00 0B FF 00 B9 F8`（E-03 锁扣候选） | `0xF8B9` ✓ | 正确 |
| `01 06 00 0B 00 00 F8 08`（E-03 解锁候选） | `0x08F8` ✓ | 正确 |
| `01 06 00 0D FF 00 59 F9`（40014 合闸） | `0xF959` ✓ | 正确 |
| `01 06 00 0D 00 00 18 09`（40014 分闸） | `0x0918` ✓ | **CRC 正确，标注错误**（见 E-03） |
| `01 05 00 02 FF 00 2D FA` | `0xFA2D` ✓ | 正确 |
| `01 01 01 02 90 48`（读线圈回复） | 应为 `0x49D0` → 线上 `D0 49` | ❌ **E-01 原文笔误**，已登记 |
| `01 03 04 00 0A 00 14 DA 3E` | `0x3EDA` ✓ | “`CRC=3EDA`”是**数值写法**，线上字节为 `DA 3E`，不矛盾（已在固件 README 加注） |

**除 E-01 外没有发现新的 CRC 错误**；同时确认全仓库不存在“CRC 抄错却看不出来”的第三处。

---

## 4. 固件代码审查（`01_firmware/esp32c3_gateway/`）

| # | 检查项 | 结论 | 说明 |
| --- | --- | --- | --- |
| 4.1 | 非阻塞约束 | ✅ 通过 | `loop()` 无 `delay()`；唯一的 `delay(10)` 在 `setup()` 内做 USB CDC 枚举等待，且有 2s 上界 |
| 4.2 | 1 秒周期预算 | ✅ 够用 | 最坏 = `flush()` 8.3ms + 2ms 保护间隔 + 首字节超时 80ms ≈ 90ms；即使走满 300ms 兜底也只有 0.3s < 1s。**不需要**把 300ms 改小；帧长驱动已让正常情况在 ~13ms 内结束 |
| 4.3 | 帧长驱动 vs 固定超时 | ✅ 已升级 | 正常响应按 `byteCount + 5` 推算；异常响应（`func|0x80`）固定 5 字节，且判定放在帧长判定**之前**（顺序正确） |
| 4.4 | 三级超时阈值 | 🟠 需实测微调 | t3.5 静默在 9600 下 ≈ 3.65ms，取 4ms 偏紧（ESP32 RX FIFO/中断抖动会吃掉余量）。若实测出现零星“超时/半帧”，优先把 `RS485_CHAR_TIMEOUT_MS` 放到 5~6ms，再考虑 `RS485_FIRST_BYTE_TIMEOUT_MS` |
| 4.5 | 清 RX 的时机 | ✅ 正确 | 清 RX 在 `write()` 之前（回环模式下这是关键，否则必误报 TIMEOUT） |
| 4.6 | 噪声/半帧鲁棒性 | 🟡 建议加固 | 若首 2 字节是噪声且 `byte[1] & 0x80`，会按“异常响应 5 字节”提前收帧。建议加条件 `g_rxFrame[0] == RS485_SLAVE_ADDR` 才启用该快速路径（当前有 CRC 兜底，不会误报成功） |
| 4.7 | 缓冲尺寸 | ✅ 通过 | 发（8）/收（96，M5 的 83 字节响应够用）独立；`g_payload[384]` 对 M5 最坏约 255 字节有余量 |
| 4.8 | CRC 实现 | ✅ 通过 | 与 `06_QI协议说明.md` §1 定义一致，逐位实现，低字节在前 |
| 4.9 | 时间戳来源 | ✅ 明确 | UDP 报文时间戳取 **NTP 本地时间**（`getLocalTime`）；未同步时降级为 `BOOT+<秒>.<毫秒>` 并标 `UNSYNCED`；**不混用 `millis()` 当墙钟** |
| 4.10 | 时区 | ✅ 已修 | `"CST-8"`（不可写 `"<CST-8>"`，曾导致 UTC 差 8 小时）；`configTzTime` 已挪到 WiFi 连上之后，并带 60s 重试 |
| 4.11 | NTP 双服务器 | ✅ 有效 | `configTzTime(TZ, 域名, 备选IP)`，core 3.3.10 支持 3 服务器，主域名 + 备选 IP 均生效 |
| 4.12 | WiFi 自恢复 | ✅ 通过 | `setAutoReconnect` + 5s 节流 `reconnect/begin`，重连成功置位重新对时；无 `delay()` |
| 4.13 | UDP 发送失败判定 | ✅ 通过 | 判 `beginPacket/endPacket` 返回值，失败不再“日志说谎” |
| 4.14 | 心跳标签 | 🟠 已修 | M4 固件仍发 `M2_HEARTBEAT` → 已统一为 `HEARTBEAT`（历史记录不改） |
| 4.15 | 方向控制（EN/DE） | 🟠 已补 | 新增 `RS485_DE_PIN` / `RS485_DE_ACTIVE_HIGH`（默认 `-1` 不启用）；启用时发送前拉高、`flush()` 后再等 ≥`RS485_TX_GUARD_MS` 才拉低（规避“flush 不等移位寄存器发完导致末字节被截断”的经典坑）。**该路径尚未在真机验证** |
| 4.16 | 编译状态 | ✅ 通过 | `arduino-cli compile --fqbn esp32:esp32:esp32c3:CDCOnBoot=cdc`：Flash **997299 B (76%)**、RAM **38244 B (11%)**、零错零警告（2026-10-03 由 Codex 用 `arduino-cli v1.5.1` 全路径复验；此为提交前最终复验值） |
| 4.17 | `WiFi.persistent(true)` | 🟡 低优先 | 每次连接会写 NVS（flash 磨损）。原型阶段无碍；长期运行可改 `false` + 显式保存 |
| 4.18 | 无第三方库 | ✅ 通过 | 仅用 core 自带 WiFi / WiFiUdp / time / HardwareSerial |

**关于 1 秒周期的额外说明**：任务书与 CTX 已把“固定 300ms 收帧”改为“首字节 80ms + 字符间隔 4ms + 帧长驱动 + 300ms 兜底”，这一改动是**本项目的关键正确性修正**——按原设计，收帧失败时每秒独占 30% 周期，且 9600 下帧与帧之间的静默不足以判帧尾。

---

## 5. 协议侧审查（`02_docs/06_QI协议说明.md` + `05_hardware/`）

| 项 | 结论 |
| --- | --- |
| 通信参数 | ✅ 地址 1 / 9600 / 8N1 / 无校验 / CRC16 低字节在前，四方（CTX、06_、Errata、固件）一致 |
| 字节序 | ✅ 寄存器内部大端（高字节先）、CRC 低字节先、多字节电量 H 在前 L 在后，均有原文示例佐证 |
| 命令清单 | ✅ 26 条命令全部 CRC 复核；读写类/控制类已分区，控制类标注禁止执行 |
| 测点数量 | ✅ 输入寄存器 39 个（30001~30039），`0x04` 读；`0x03` 读的是保持寄存器（设备参数，**不是测量值**） |
| 测试帧 vs 真机帧 | ✅ 边界清晰：M3/M4 只允许 `0x03` 回环帧，M5 起只允许 `0x04` 真机帧，禁止混用（混用会得到“看起来正常但语义错误”的数据） |
| E-01 | ✅ 已判定：`01 01 01 02 90 48` → 正确为 `01 01 01 02 D0 49` |
| E-02 | ⏳ 待 M5 真机：`00 27` 与“上限 16”冲突；A/B/C 三方案与分段帧已备妥 |
| E-03 | ✅ 已判定（高危）：40012 = `0x000B` 才是远程锁扣；原文 `00 0D` 实为分闸 |
| E-04 / E-05 | ✅ 已解释（旧 CRC 注释 / 温度量程 −40 换算），非矛盾 |
| 30001 低字节分合闸 | ✅ 实现口径已明确：`reg & 0xFF` **整字节比对**（`0x0F` = 分闸 / `0xF0` = 合闸），原文 `0xF` 与 `0x0F` 数值相同，不是位域 |
| 剩余未确认 | 🟡 “分闸记录（半字节域）”的域顺序与显示顺序对应关系仍标 `[待确认]`，只能真机核对 |
| 文档瑕疵 | 🟡 `06_QI协议说明.md` §8 表格里引用的“第 11 节”是**任务书 v0.1 的原句**（指向任务书，不是本文件），易被误读；建议下次修订加一句括注 |

---

## 6. 全仓库一致性扫描（本轮实测）

| 搜索项 | 命中 | 判定 |
| --- | --- | --- |
| 明文 WiFi 密码字面串（**为免二次泄露，本报告不写出**） | **0**（当前工作区与入库文件；仅存在于早期历史提交内） | ✅ 已脱敏 |
| WiFi SSID 字面串（新旧各一，**本报告不写出**） | 0 / 0（当前工作区与入库文件） | ✅ |
| `HW-466AB` | 5 文件 11 行 | ✅ 合法（主控板型号） |
| `HW566` | 5 文件 12 行 | ✅ 合法（扩展底板） |
| `悬空或接 3.3V` | 2 文件 8 行，**全在存档件** `02_`/`03_` | ✅ 按约定不改存档件 |
| `RXD` | 6 文件 15 行，全部为“RO / RXD 同一引脚”的术语别名或存档件历史引用 | ✅ 无过期用法 |
| `esp-x32` | 4 文件 9 行，全部为“之前记录的 esp-x32 有误”勘误引用 | ✅ |
| `待 WorkBuddy 产出` | 1 文件 2 行，均在存档件 `02_docs/03_` | ✅ |
| `M2_HEARTBEAT` | 修正前 3 文件 5 行 → 修正后仅存于**历史实测记录**（任务书 M2/M3 结果表的历史日志行） | ✅ 当前固件（`esp32c3_gateway.ino` L258）与运行时日志已统一为 `HEARTBEAT` |

- `.gitignore` 例外规则有效：`secrets.h`、`.workbuddy/`、`build/`、`03_logs/*` 命中忽略，而 `!03_logs/.gitkeep` 例外生效（`.gitkeep` 保持跟踪）。
- `05_hardware/` 大文件（`.doc` 177KB / `.docx` 104KB / `.docx` 44KB）均已入库，属有意为之（协议原始件）。

---

## 7. 本轮改动清单（全部由本次提交承载）

| 文件 | 改动 |
| --- | --- |
| `01_firmware/esp32c3_gateway/config.h` | 新增 `RS485_DE_PIN` / `RS485_DE_ACTIVE_HIGH`（方向控制宏，默认关闭）+ 适用型号与空闲 GPIO 建议注释；修订“MAX13487 前提”注释 |
| `01_firmware/esp32c3_gateway/esp32c3_gateway.ino` | `ST_TX` 增加 `#if RS485_DE_PIN >= 0` 方向切换与末字节保护；`setup()` 初始化方向脚；启动打印方向控制状态；心跳标签 `M2_HEARTBEAT` → `HEARTBEAT` |
| `01_firmware/esp32c3_gateway/README.md` | M4 章节补 `CRC=3EDA` 数值/字节序注、方向控制宏用法；心跳标签同步；EN 行补方向控制宏提示 |
| `README.md` | §4 M4 阻塞原因统一；§6.1 通信模块与 EN 口径补方向控制宏；§6.2 偏置电阻改为待实测；§8-10 补“旧模块先重试 + 固件已内建方向控制宏” |
| `04_ai_prompts/00_context.md` | 三.通信模块 / 三.4 偏置 / 四.3 波特率口径修正；五节硬件确认改为“型号待丝印复核”；五节新增“M4 固件已完成待硬件”一条 |
| `02_docs/01_项目任务书.md`、`02_`、`03_`、`06_`、`11_`、`05_hardware/STB3-125_Errata.md`、`.gitignore` | 一致性修正（存档件仅文末追加勘误节） |
| `02_docs/07_模拟从站记录.md` | 由**未跟踪**变为入库（M4 交付物） |
| `02_docs/12_全仓库审查报告_Codex.md` | 本文件（新增） |
| 临时脚本 `_fix_consistency*.js` / `_fix_fw.js` / `_patch15*.js` | 已删除，不入库 |
| `05_hardware/MAX13487E_MAX13488E_Datasheet.pdf` | **新增**（官方数据手册原件，1,540,850 B）—— EN / 偏置电阻结论的证据来源 |
| `04_ai_prompts/00_context.md`（第二轮） | 三.4 偏置电阻升级为功能项；三.5 ① 补手册核实结论与 8 脚引脚表 |

---

## 8. 仍需用户 / 总控确认的清单

1. **【必须】实物 485 模块 8 脚芯片丝印**（`MAX13487` / `MAX13488` / `MAX485` / `MAX3485`）——决定 EN 接法、供电电压、是否启用固件方向控制宏。**丝印未读前不要给 EN 接任何电平。**
2. **【必须】旧模块复测结论**：用 §4.1 自环法复测后，把结果回写 `07_模拟从站记录.md`（“确属损坏”或“其实是接线/引脚问题”）。
3. **【重要】GPIO20 输入通路验证**（H-2 步骤 1~2）——结果决定是否把 UART1 RX 换到其它 GPIO。
4. **【需总控】`RS485_DE_PIN` 选哪个 GPIO**：建议 GPIO3 / 4 / 5 / 10（避开 strapping 脚 2/8/9 与原生 USB 18/19），需与实际接线一致。
5. **【需实测】三级超时微调**：`RS485_CHAR_TIMEOUT_MS` 4ms → 5~6ms 的条件与结果。
6. **【需实测·已升级为功能验收项】** 终端/偏置电阻实际数量（模块到底有几个电阻、120Ω 是否已焊、**A/B 偏置上拉下拉是否存在**）。**手册已明确偏置电阻是 MAX13487 正常工作的必要条件**（见第 9.5 节）——缺了会导致“行为像模块坏了”的假故障，务必在 M3 一并实测。
7. **【需实测】MAX13487 的 RXO 空闲电平**：若实测已是 3.3V，则**不要再分压**（否则高电平被判成低电平）；若为 5V 才用 1k/2k。
8. **【低优先】** `06_QI协议说明.md` §8「第 11 节」引用加括注；`WiFi.persistent` 是否需要为长期运行关掉。
9. **【安全红线】** 任何 STB3-125 控制类命令（含 E-03 候选帧）在 M5 之前**一律不得执行**。

---

## 9. 数据手册核实（2026-10-03 新增 —— 回应 H-1 的“EN 悬案”）

- **来源**：从 Analog Devices 官网下载 **MAX13487E/MAX13488E 官方数据手册**（19-0740; Rev 3; 2024-08），存入 `05_hardware/MAX13487E_MAX13488E_Datasheet.pdf`（1,540,850 B）。用 `pdftotext` 提取正文逐条核对，非凭记忆。

| # | 核实点 | 手册原文依据 | 结论 |
| --- | --- | --- | --- |
| 9.1 | 8 脚定义、有无 `DE` | Pin Description：`1 RO / 2 RE / 3 SHDN / 4 DI / 5 GND / 6 A / 7 B / 8 VCC`；功能框图内 `DE` 属 **STATE MACHINE** 内部信号 | **全片无 `DE` 引脚**（`RECEIVER_ENABLE` = `DRIVER_ENABLE` 反相，可被外部 `RE` 覆盖）→ 文档“MAX13487/88 无 DE 脚”**正确** |
| 9.2 | `RE` 该接什么 | “Drive RE low to enable the RO. **Drive RE high to let the AutoDirection circuit control the receiver.**” | **RE 高 = 交给 AutoDirection（正常收发，且是热插拔后的默认态）**；RE 低 = 强制 RO 常开 |
| 9.3 | `SHDN` 该接什么 | “Drive SHDN high to let the device operate in normal operation. Drive SHDN low to put the part in shutdown.” | **SHDN 高 = 正常**，低 = 关断 → “接固定高电平”正确 |
| 9.4 | **EN 接法裁定** | 9.2 + 9.3 | **① MAX13487/88 → EN 接固定高电平**：在手册 `RE` / `SHDN` 两种诠释下**均成立**，文档口径获手册背书 ✅；② MAX485/3485 → EN 即 `DE`（高 = 发送），固定接高会占死总线，文档口径**正确** ✅ |
| 9.5 | **偏置电阻是必需项（本轮新发现）** | “Pullup and Pulldown Resistors” 一节：**“are required for proper operation of the device”**；Detailed Description：“the driver stays enabled until (A-B) > VDT, and then disables the driver, letting the pullup/pulldown resistors hold the A and B lines in the correct state” | 文档原把“4.7kΩ 偏置实测”列为**备注**，应升级为 **M3 功能验收项**。⚠️ **2026-10-03 二次修订**：初版机理“无偏置 → 状态机保持驱动器使能 → 占死总线”**有误** —— 驱动器每次都会自行释放，真实症状是“1”位塌陷 → 数据错乱 / CRC 全败 / 空闲电平不定。功能项结论不变 → 已回写 CTX 三.4 |
| 9.6 | `DI` 空闲态要求 | “require the DI input be driven high to remain in the idle state” | ESP32 UART TX 空闲即高（mark），**天然满足**，无需改代码 ✅ |
| 9.7 | 供电 | “VCC = +5V ±5%” | 与文档一致（MAX3485 变体才是 3.3V）✅ |

- **仍未闭环（本核实不能解决的）**：手册只证明**芯片侧**该怎么做，**不能证明模块侧**把那颗 `EN` 丝印引到了芯片的哪一脚（`RE`？`SHDN`？还是三合一款里 MAX485 变体的 `DE`）。**仍须实物丝印 + 模块走线（或产品资料）确认** —— H-1 降级但不消失。
- **本轮同步改动**：`04_ai_prompts/00_context.md` 三.4（偏置电阻升级为功能项）、三.5 ①（补手册核实结论与引脚表）。

---

> 本报告为审查意见与证据记录，不修改任何原文；与 `04_ai_prompts/00_context.md` 冲突时，以 CTX 为准。

---

## 10. 第 6 轮独立复验（2026-10-03 · Codex）

本轮为**独立复验**（不沿用前几轮结论，全部重新实测 / 重算）。结论：**前序审查结论成立，未发现新的“错误级”问题**；新增 3 项提示级发现（F-1~F-3），已回写 README §8 与固件 README。

### 10.1 复验项与结果

| # | 复验项 | 方法 | 结果 |
| --- | --- | --- | --- |
| 10.1.1 | 编译 | `arduino-cli v1.5.1`，`--fqbn esp32:esp32:esp32c3:CDCOnBoot=cdc` | ✅ Flash 997299 B (76%) / RAM 38244 B (11%)，零错零警告（与 §4.16 一致） |
| 10.1.2 | 明文凭据 | `git grep -c -I "<WiFi密码明文>"`（工作区 + 全部历史提交） | ⚠️ **2026-10-03 更正**：工作区 0 命中；但本行初版把**明文密码**写进了示例命令，导致 grep 命中报告自身（既自相矛盾又构成泄漏）——已改为占位符。历史提交含明文者共 4 个：`8ef8576`/`e8612d4`/`ca21014`/`aabe7d8`，见 §12.2 |
| 10.1.3 | CRC 全量重算 | 脚本扫描 `06_QI协议说明.md` / `STB3-125_Errata.md` / `README.md` 内全部 HEX 帧，逐条 CRC16/Modbus 重算 | ✅ 61 条通过；8 处“不一致”全部可预期解释（见 10.2），**无新增错误帧** |
| 10.1.4 | `esp-x32` 残留 | `git grep -c -I` | ✅ 5 处全部为「esp-x32 有误」的勘误引用，无语义残留 |
| 10.1.5 | 商品页证据 | 用户附件两张商品页截图逐字核对 | 🟠 新增佐证 1 条 + 冲突 1 条，见 F-1 |
| 10.1.6 | 工作区状态 | `git status --short` | ✅ 本轮改动前为干净 |

### 10.2 CRC 扫描 8 处“不一致”的逐条判定

| 位置 | 片段 | 判定 |
| --- | --- | --- |
| `06_QI协议说明.md` L86 | `01 03 08 25 80 01 13 …` | ℹ️ 字节序示例，带省略号，**不是完整帧**（脚本按“末两字节 = CRC”假设而误报），无需修改 |
| `06_QI协议说明.md` L156 / L354、`STB3-125_Errata.md` L27 | `01 01 01 02 90 48` | ✅ E-01 已知笔误，正确应为 `D0 49`（独立重算一致） |
| `06_QI协议说明.md` L339 | `01 03 00 00 00 02` | ℹ️ 正文引用**载荷**（无 CRC），非完整帧 |
| `STB3-125_Errata.md` L71~L73 | `01 04 00 00 00 10` 等 | ℹ️ E-02 明标「不含 CRC」的载荷行；同表 L65~L67 的完整帧 CRC 已复算通过 |

### 10.3 本轮新增发现（提示级，均非“错误”）

- **F-1（R-14 · 商品页证据）**：页面明示 MAX13487 变体「不能通过 EN 脚切换方向，不然烧坏电脑，后果自负」→ **佐证** CTX 三.5 ①；但同一页面**只写「具有 120 欧匹配电阻」，未提 4.7kΩ 偏置电阻** → 与 CTX 三.4 的既有描述**冲突**，偏置是否板载**必须实物确认**（⚠️ 2026-10-03 二次修订：缺偏置的症状是“1”位塌陷 → CRC 全败 / 空闲电平不定，**不是**驱动器锁死；见 §9.5 与 §11.3）。
- **F-2（R-15 · M4 关键）**：`RS485_CHAR_TIMEOUT_MS = 4ms` 对**电脑模拟从站（经 USB 转 485）**过紧。USB 批量交付会造成 >4ms 的字节间隙，被第 2 级超时提前判「半帧」，现象为**每秒都 `[M4] 超时 ... RX=1~8`**，极易误判成模块坏 / 接线错。**M4 期间建议临时放到 20~30ms；M5 接真机（纯硬件 UART）后改回 4ms。** 本项与 §4.4 的“5~6ms”是同一问题的更强档位，不冲突。
- **F-3（低优先）**：ESP32-C3 每次复位时 ROM/bootloader 会在 GPIO21 打印启动日志，这些字节会经 485 模块上总线（115200），排查「上电瞬间总线异常」时先想到它；另需目视确认主控板是否带 CH340 等 USB 转串口芯片并占用 GPIO20/21。

> 三条均已回写：根 `README.md` §8 第 12~14 条、`01_firmware/esp32c3_gateway/README.md`（新增命令行编译块 + M4 字符间隔提示）、`04_ai_prompts/00_context.md` 三.5 商品页佐证句。
---

## 11. 第 7 轮审查（2026-10-03 · Codex）—— 实物照片鉴定 + AutoDirection 偏置/终端与 VDT 的冲突风险

本轮输入：用户 5 张实物照片（本轮附件）＋ 上一轮商品页截图；手段：arduino-cli 编译复验、MAX13487E/MAX13488E 官方手册（已入库 `05_hardware/MAX13487E_MAX13488E_Datasheet.pdf`）逐条比对、arduino-esp32 core 3.3.10-cn 源码核查、全仓库 CRC 重算。

### 11.1 实物照片鉴定（4 项证据落地）

| # | 照片 | 可见内容 | 结论 |
| --- | --- | --- | --- |
| 11.1.1 | `5d0a5741b91988b67573052ef2019e62.jpg`（485 模块正面） | 8 脚 SOIC 主芯片；同一排三颗贴片电阻丝印 **`472` / `121` / `472`**（=4.7kΩ / 120Ω / 4.7kΩ），紧邻 A/B 侧 | **板载偏置 + 终端“在板上存在”的证据成立**（R-14 由“未核实”降级为“视觉证据充分，待万用表终判”）。三项各自的实际连接须按 §11.5 实测确认 |
| 11.1.2 | `93b49348257cccaa33bbccc7621dbf60.jpg`（485 模块背面） | 逻辑侧 5 脚丝印 **`GND / TXD / RXD(或 RXO) / VCC / EN`**；总线侧 3 脚丝印 ~~**`GND / A / B`**~~ ⚠️ **实为 `B` / `A` / `GND`（2026-10-04 二次放大复核更正；`GND` 在最后）**；板号 **`RS485 V2.05`**、`1901Y_GD4627Z1` | 模块丝印确实写作 `RXO/RXD`（同一脚，分辨率所限无法 100% 区分 D/O）→ Q-11 术语口径再获实证；**模块总线侧自带 GND 端子**（与 ESP32 共地可直接在此端子上取） |
| 11.1.3 | `48879669db253aa69b6fe9fafce6ead6.jpg` + `3a51c3ed366b83e81878038c0a5b9cf9.jpg`（主控板） | `HW-466AB` / `ESP32-C3` / `SuperMini`；引脚丝印：左列 `5V, G, 3.3, 4, 3, 2, 1, 0`，右列 `5, 6, 7, 8, 9, 10, 20, 21` | 与 CTX 三.1 完全一致 ✅；**GPIO20/21 在 USB-C 对侧那一排的末端**（接线时先认丝印）；GPIO18/19（原生 USB）未引出 → 不会与 UART1 抢脚 |
| 11.1.4 | `0fbf26957ce46fdd4b45b15d66a2a3d7.jpg`（主控板正面） | USB-C + BOOT/RESET 双按键 + QFN 封装的 ESP32-C3 + 晶振；**未见 CH340 一类 USB 转串口 SOIC** | 倾向“原生 USB CDC”（低置信度，受分辨率限制）→ 与固件要求的 `USB CDC On Boot = Enabled` 一致；**若烧录异常再按 R-13/R-16 复查** |

- **H-1（模块主芯片型号）仍未闭环**：对 `5d0a5741` 芯片区域做了 6 倍放大 + 局部 2%~98% 对比度拉伸 + 灰度 + UnsharpMask(4/250) 处理，丝印仍是**纯噪点**（原图 972×1394，芯片仅约 100 px 宽）。**不猜型号**；需用户补一张**微距照**（对焦芯片、打光、距离 3~5 cm）或直接用放大镜口述丝印。
- 参考物：上一轮商品页截图 `60ba44f182cf8fe17dcd0ad735faba1f.jpg` 显示的是**同一块 PCB**（`RS485 V2.05` / `1901Y_GD4627Z1`，渲染芯片丝印 `MAX485 ESA`，同样三颗 `472/121/472`）→ 页面渲染图**不能代表实物芯片**，仅能证明“同板型多芯片变体”。

### 11.2 独立复验结果（本轮实测）

| 项 | 方法 | 结果 |
| --- | --- | --- |
| 编译 | `arduino-cli compile --fqbn esp32:esp32:esp32c3:CDCOnBoot=cdc 01_firmware/esp32c3_gateway` | ✅ Flash **997299 B (76%)** / RAM **38244 B (11%)**，零错零警告（与 §10.1.1 一致） |
| CRC 重算 | 脚本扫描 `06_QI协议说明.md` / `STB3-125_Errata.md` / `README.md` / `config.h` 内全部 HEX 帧 | ✅ 无新增错误帧；不一致项全部可预期（`90 48` 笔误、无 CRC 的载荷片段） |
| 明文凭据 | `git grep -c -I`（工作区） | ✅ 0 命中 |
| 仓库状态 | `git status --short` | ✅ 改动前干净，HEAD=`aabe7d8` |

### 11.3 ⚠️【本轮新发现 · 高风险】偏置/终端组合可能与 AutoDirection 的 VDT 冲突

**手册依据（逐条摘自 `MAX13487E_MAX13488E_Datasheet.pdf`）：**

1. 引脚：`1 RO / 2 RE / 3 SHDN / 4 DI / 5 GND / 6 A / 7 B / 8 VCC`，**全片无 DE**。
2. 发送功能表：`SHDN=1, DI=1, A-B > VDT = True → Turn driver OFF`（高阻）；`A-B > VDT = False 且驱动器原为 ON → keep it ON`。
3. **`VDT`（Driver Disable Threshold）TYP **`+0.6 V`**，MAX **`+1 V`**；Note 2 原文：“This is a differential voltage from A to B that the driving device must see on the bus to disable its driver.”
4. 接收功能表：`RE=1`（AutoDirection 模式）时，**驱动器 ON → 接收器 OFF**；驱动器 OFF → 接收器 ON。`RE=0` 时接收器**常开**。
5. “Pullup and Pulldown Resistors: … **are required for proper operation of the device**”。
6. 换向时序：`tDDD` ≤ **2.5 µs**、`tRED` ≤ **70 ns** → 换向总延迟 ≪ 1 ms（对固件的保护间隔无苛刻要求）。

**由此产生的算式（本轮独立计算）：**

- 若板上是「A—4.7k—VCC ∥ B—4.7k—GND ∥ A—120Ω—B 同时接入」，则空闲差分
  `V_AB = 5 V × 120 / (4700 + 120 + 4700) ≈ 63 mV` → **远低于接收器阈值 ±200 mV，也不满足手册要求的 ≥200 mV**；
- 若 120Ω 实际未跨接在 A/B（只焊了偏置），则 `V_AB ≈ 2.5 V` → 满足手册要求。

**⚠️ 同日二次修订（重要）：** 初版把风险写成「V_AB < VDT → AutoDirection 永不释放驱动器 → 占死总线」——**该机理不成立，现更正**。据手册 Function Tables（TRANSMITTING 表）：驱动器一旦被 DI 拉低使能，自己就会把 A-B 驱动到 VOD（≥1.5 V @54Ω）> VDT（max 1 V）→ 立即 `Turn driver OFF`；此后 `DI=1 且 A-B ≤ VDT 且驱动原为 OFF → keep it OFF`。**驱动器一定会释放，不会卡死。**

**真正成立的机理**（同为手册依据，见 "Pullup and Pulldown Resistors" 一节与发送功能表）：

1. 手册明确：偏置电阻的作用是**在 DI 为高期间、驱动器短暂关断之后，把总线维持在 A-B > 200 mV**（原文 "allows the external pullup/pulldown resistors to hold the bus in the high state (A-B > 200mV)"），并要求 "guarantee that the idle voltage on the bus (A-B) is greater than 200mV"。
2. 上表 63 mV 的组合**不满足**该要求 → MAX13487 的「1」位只剩 ~63 mV，且该网络时间常数仅 ns 级（(9.4k ∥ 120Ω) × C_bus），1.04 ms 位宽内会迅速塌到 63 mV → 远端（QI 表 / USB 转 485）可能把「1」读成低或不定 → **数据错乱、CRC 全败**。
3. 空闲期 A-B = 63 mV 落在接收器 ±200 mV 判定窗口的**中间不定区** → RO（RXO）输出不定，ESP32 侧可能收到毛刺/伪起始位。

**结论：63 mV 组合仍是高危，但症状是「收不到正确数据 / CRC 全败 / 偶发乱字节」，不是「驱动器锁死」。** 另注：若实物是 `MAX485` / `MAX3485`（页面渲染图丝印即如此），DE 有效期间驱动器**全程主动驱动**、「1」位不依赖偏置，该组合只剩「空闲电平不定」一项风险 → 再次说明 H-1 丝印复核是前置条件。

**判定：需实测（10 秒万用表法，断电 + 上电两步）**

| 步骤 | 操作 | 预期 / 判据 |
| --- | --- | --- |
| ① 断电量电阻 | A–B；A–VCC；B–GND；EN–VCC；EN–GND | A–B≈120Ω ⇒ 终端在板；A–VCC 与 B–GND ≈4.7k ⇒ 偏置在板；EN 若对 VCC 有几十 k 上拉 ⇒ 悬空可被拉高 |
| ② 上电 5V（只接 VCC/GND，EN 悬空）量 `V_A − V_B` | 直流档 | **≥200 mV ⇒ 符合手册要求**（≈2.5 V 更好）；**≈60 mV ⇒ 不满足**（症状：CRC 全败 / 乱字节 / 偶发丢帧）；≈0 V ⇒ 无偏置 |
| ③ 上电时量 EN 对 GND 电压 | 直流档（注意 DMM 10 MΩ 输入会“读高”，读数≈5V 只说明“未被下拉”） | ≈0 V ⇒ 有强下拉或被接 GND ⇒ 必须改接固定高电平 |

**症状 → 病因对照（供 M4 排障直接用）**

| 现象 | 优先怀疑 |
| --- | --- |
| `RX=0`，模块/总线发热、电脑从站收不到请求 | EN/SHDN 被拉低（器件关断）；A/B 反接；从站未应答；USB 转 485 模块损坏 |
| `RX 帧 == TX 帧`（回显） | 接收器被常开（`RE=0` 接法）导致自发自收（固件已在帧长异常分支给出该诊断） |
| 收到数据但 CRC 失败 / 偶发乱字节 | **空闲差分 ≈60 mV（偏置不足，见上）**；RXO 未分压/分压不当；未共地；终端数量过多；波特率不一致 |
| `RX=0` 但总线波形正常 | 从站侧问题；地址/波特率不符 |

> ⚠️ 本项**不改变现有接线纪律**（M4 前仍须先读丝印、先实测 RXO 空闲电平），但**新增一条 M4 前置检查**：上电后先量 `V_A − V_B` 空闲差分。若 ≈60 mV，**先停手报总控裁定**（候选处置：台架短距 9600 下断开板上 120Ω 终端后复测 → 空闲差分升到 ≈2.5 V；或把 4.7kΩ 偏置换强到 ~680Ω；或换模块），不要反复烧录排障。

### 11.4 新发现（文档错误 · P1）：`Serial1.flush()` 的语义注释写反了

- 现有注释（`config.h` L62、`esp32c3_gateway.ino` L453-455）称“**ESP32 的 flush() 只保证 TX FIFO 排空，不保证移位寄存器已把最后一位送完**”。
- core 源码实证（`cores/esp32/esp32-hal-uart.c` L1470-1486）：
  `uartFlush()` → `uartFlushTxOnly(uart, true)` → `while (!uart_ll_is_tx_idle(UART_LL_GET_HW(uart->num)));`
  → **`flush()` 会一直等到 TX 完全空闲（FIFO 排空 + 移位寄存器发完）**，注释的技术理由不成立。
- 影响：仅为注释错误（不影响行为）。`RS485_TX_GUARD_MS = 2` **仍建议保留**，但理由应改为
  ① 真实总线上给 AutoDirection 状态机留换向余量（手册 tDDD+tRED ≤ ~2.6 µs，2 ms 是 700 倍余量，纯防御性）；
  ② 对 MAX485/MAX3485 变体的 DE 切换同样需要——而**不能**再写“flush 不等移位寄存器”。
- 附带（低优先）：`uartFlushTxOnly` 的忙等**无超时上限**，UART 硬件异常时会死等；9600 下实际有界（8 字节≈8.3 ms），暂不改代码，登记备查。

### 11.5 固件候选问题清单（本轮通读 619 行 + config.h 107 行）

| 级 | 位置 | 问题 | 建议 |
| --- | --- | --- | --- |
| P1 | `config.h` L62-66 / `.ino` L451-455 | flush 注释理由不成立（见 §11.4） | **本轮已改注释**：理由改为“换向防御性余量”，并注明本 core 的 flush 语义（`uart_ll_is_tx_idle`） |
| P1 | `config.h` L71 | R-15（**假设，待实测证伪**）：`RS485_CHAR_TIMEOUT_MS` 仍 4 ms。若电脑端 USB 转 485 从站出现 >4 ms 字节间隙，会被第 2 级超时判成“半帧”，症状为间歇 `[M4] 超时`，易误判成模块坏。**注：合规从站通常一次性 write，byte 间只有 ~1.04 ms，未必会触发；此项是首选排查假设而非已证事实。** | **本轮仅加注释（未改数值）**：A/B 对照法验证——先把本值临时放到 20~30 ms 复测；若放大后仍超时，则不是本因，改查接线/引脚/模块；M5 接真机后收紧到 4~8 ms |
| P1 | `config.h` L60-62 | R-13 无 Plan B：`RS485_RX_PIN` 写死 20，GPIO20 可能已被 5V 打伤 | **本轮已加注释**：登记“先做回环自检（`RS485_MODE_LOOPBACK_SELFTEST=1` + 短接 21↔20）→ 失败则改用 GPIO3/4/5/10”的排障顺序；**未加 `RS485_RX_PIN_ALT` 宏**（固件无运行期换脚能力，加宏即死代码），换脚须改本行 + 文档 |
| P2 | `config.h` L65 | 4 ms ≈ 3.84 字符时间，紧贴 Modbus t3.5（3.65 ms）边界，**无余量** | 真机（纯硬件 UART）时也建议 6~8 ms |
| P2 | `.ino` L450 / L266 | `Serial1.write()` 与 `g_udp.write()` 返回值未检查（`write` 失败会静默少发） | 加返回值判断 + 计数告警 |
| P2 | `.ino` L259-262 | `snprintf` 截断告警后**仍继续发**截断内容 | 截断时直接 `return`（或截断包不再上行） |
| P2 | `.ino` L280-283 | `logRxHex()` 只打前 24 字节 → M5 的 83 字节响应**看不到尾部 CRC**，排障时会被误导 | M5 前把上限提到 96，或头部 24 + 尾部 8 分段打印 |
| P2 | `.ino` L244-275 | **M4 的 UDP 报文只有心跳，不含 485 数据**（与产品数据流“时间戳 + HEX 数据”有差距） | 属 M5 范围，但须在任务书/M5 清单里显式登记，避免验收时被当成漏项 |
| P3 | `config.h` L70-82 | EN 语义只写了“MAX485 方向控制 / MAX13487 接高”，**缺 `SHDN` 第三态**（模块丝印 `EN` 也可能引到 SHDN） | **本轮已补注释**：`EN=RE → 高=AutoDirection；EN=SHDN → 高=正常、低=关断；EN=DE → 高=发送（MAX485）`。三者在“MAX13487 接固定高”这一处置下**结论一致**，但诊断思路不同 |
| P3 | `.ino` L14 / L554 | `setup()` 内有界 `delay(10)`（≤2 s 等 USB CDC 枚举），与文件头“禁止 delay()”措辞冲突 | **本轮已改**：文件头补“（唯一例外：setup() 内有界等待 USB CDC 枚举，最多 2s）”，与 L552-554 的注释口径一致 |
| P3 | `config.h` L41-43 / `.ino` L165-166 | `wifiTick()` 的检查周期常量（5 s）与 `ntpTick()` 硬编码的 200 ms 节流风格不一致（后者未常量化） | 可读性，非缺陷 |

**已核实无问题**：状态机 IDLE→TX→WAIT_RX→PARSE→SEND 的非阻塞实现；帧长驱动 + 三级超时（含 `(int32_t)` 回绕判断、首字节/字符间隔/兜底优先级）；`need` 上限保护；CRC16/Modbus（0xFFFF/0xA001/逐位，与 `06_QI协议说明.md` §1 一致）；`memcmp` 自收回显诊断；`g_payload[384]` 对 M5 最坏 255 字节余量充足；`g_nextPollMs` 落后重对齐；`getLocalTime(&now, 0)` 实测非阻塞（core 源码 `while((millis()-start)<=0)` 只跑一遍）；M3 回环模式固定帧长（不误用 byte count 推算）；异常响应（0x84）分支排在帧长判定之前。

### 11.6 不确定项 / 需要用户提供的材料

1. **⭐ 485 模块主芯片微距照**（或口述丝印）—— H-1 唯一阻塞项，直接决定 EN 接法。
2. **§11.3 的三步万用表实测结果**（A–B、A–VCC、B–GND、EN–VCC/GND；上电后 `V_A − V_B`；EN 对 GND 电压）。
3. **GPIO20 死活**：`RS485_MODE_LOOPBACK_SELFTEST=1` + 短接 GPIO21↔GPIO20 的自检结果（R-13）。
4. **旧 USB 转 485 模块复测结果**（自环法，`02_docs/07_模拟从站记录.md` §4.1）。
5. **新 USB 转 485 模块到货通知**（R-12 解除前提）。
6. **RXO 空闲电平实测**（5 V → 1k/2k 分压；3.3 V → 直连）—— 未测前一律按 5 V 处理。
7. 无法从现有材料判定的两件事（**不猜**）：模块 `EN` 究竟接到芯片 `RE`、`SHDN` 还是 `DE`；板上 `121` 是否确实跨接在 A/B（§11.3 实测可解）。

> 本节为审查意见与证据记录，不修改原文；与 `04_ai_prompts/00_context.md` 冲突时以 CTX 为准。

---

## 12. 第 8 轮（2026-10-03 · Codex）—— 事实源纠错与明文脱敏

### 12.1 偏置缺失的真实机理（纠错，已回写 CTX 三.4 / README §8-12 / 本报告 §9.5 · §10.3 F-1）

- **原表述（错）**：“总线若无偏置，状态机会持续保持驱动器使能、占死总线，从站永远无法应答。”
- **手册原文**（`05_hardware/MAX13487E_MAX13488E_Datasheet.pdf`，Detailed Description）：“When DI is high, the device drives the bus for a short time, then disables the driver and allows the external pullup/pulldown resistors to hold the bus in the high state (A-B > 200mV). During each low-to-high transition of DI, the driver stays enabled until (A-B) > VDT, and then disables the driver…”
- **更正后的机理**：驱动器自身把 A-B 拉到 VOD（≥1.5V）> VDT（max 1V）后**每次都会自行释放**，**不存在“锁死/占死总线”**。偏置不足的真实后果：驱动器释放后“1”位塌陷到偏置电平（120Ω 跨接时约 63mV）→ 从站把“1”读错 → 数据错乱 / CRC 全败；空闲差分落入 ±200mV 不定区 → RXO 输出不定、偶发伪起始位。
- **“占死总线”的正确适用对象**：只有 `MAX485 / MAX3485` 的 `DE` 被固定接高（单向驱动器全程主动驱动）——该处文档表述**正确，保留不动**（CTX 三.5 ②、任务书 §5.2 ②、R-06、固件 README）。
- **功能结论不变**：偏置仍是 MAX13487E 的必需项，M3 实测偏置/终端并联数量仍是功能验收项。

### 12.2 明文凭据自查（本轮新发现，已修）

- `02_docs/12_全仓库审查报告_Codex.md` §11 前的 §10.1.2 曾把 **WiFi 明文密码**写进示例命令行 → `git grep -c -I` 会命中报告自身（与“0 命中”结论自相矛盾，且构成实际泄漏）。**本轮已改为占位符**，工作区复扫为 0。
- 历史含明文提交由 3 个更正为 **4 个**：`8ef8576`、`e8612d4`、`ca21014`（`04_ai_prompts/00_context.md`）+ `aabe7d8`（本报告）。用户已决定不改写历史（策略 A），缓解措施仍为 R-04。

### 12.3 其它一致性修正

- `RS485_CHAR_TIMEOUT_MS` 的 M4 临时档位在 `config.h`（原写 8~30ms）与 README §8-13 / 固件 README（20~30ms）之间不一致 → 统一为 **20~30ms**。
- §11.5 表中 `config.h` 行号 `L65` 随注释增行漂移 → 更正为 `L71`。
- README §8-12 引用的“手册 §9.5”**不存在该章节编号**（手册只有图号 1~11）→ 改为按章节名引用。

### 12.4 复验

| 项 | 方法 | 结果 |
| --- | --- | --- |
| 编译 | `arduino-cli compile --fqbn esp32:esp32:esp32c3:CDCOnBoot=cdc 01_firmware/esp32c3_gateway` | 见提交前实测（注释改动，产物大小应与 997299 B 一致） |
| 明文复扫 | `git grep -c -I "<密码>"`（工作区） | 0 命中 |
