jiangtao-ml/ESP32_C3_Gateway/02_docs/13_M4排障记录_2026-10-04.md

# M4 排障记录（2026-10-04）—— 方法学更正 + 双向测试 + 万用表测量清单

| 项目 | 内容 |
| --- | --- |
| 文档名称 | M4 排障记录（2026-10-04） |
| 版本 | v1.0 |
| 日期 | 2026-10-04 |
| 作者 | WorkBuddy（文档角色） |
| 覆盖时段 | 2026-10-04 18:20 ~ 19:50 |
| 所属里程碑 | **M4**（阶段三 分模块验证） |
| 唯一事实来源 | `04_ai_prompts/00_context.md` |
| 关联 | `02_docs/07_模拟从站记录.md`（本记录**更正**其 §4.3 结论）、`06_tests/M4_重测操作卡.md`、`.workbuddy/memory/2026-10-04.md` |

> **定位**：本轮实测与**方法学更正**的正式归档。不含业务代码，不修改 `00_context.md` / `README.md`。推测一律标注「推测」，未确认项标 `[待确认]`。

---

## 1. 结论摘要

| # | 结论 | 依据强度 |
| --- | --- | --- |
| 1 | **「短接 A/B 发 abc 看回显」是无效的自环测试**，负结果不能证明模块坏 | 🔴 **确定**（三个独立权威来源 + 物理机理） |
| 2 | 此前「旧 USB 转 485 模块物理损坏」的判定（`07` §4.3）**不成立** | 🔴 由上一条推翻 |
| 3 | **烧录流程本身无误**；上轮"烧录未生效"是**点成「验证」而非「上传」** | 🟢 确定（IDE 输出 `Hash of data verified.` + 固件三指纹全部对上） |
| 4 | **总线上双向全断**（去程与回程均 0 字节） | 🟢 确定（两组有效互测，样本量足够，见 §3） |
| 5 | 故障必然位于**两个方向共用**的那一段：`A/B 总线` / `MAX13487` / `USB 转 485` / `三方共地` | 🟢 由 #4 逻辑推出 |
| 6 | EN 接法、分压比、`TXD/RXD` 方向等此前重点排查项**均非本次主因** —— 它们最多只断**一半** | 🟢 由 #4 逻辑推出 |
| 7 | ~~**当前唯一硬瓶颈：用户没有万用表**，导致测点 1~7（§5）全部无法实测~~ ✅ **已解除** —— 2026-10-04 21:33 M4 跑通（真凶＝模块 `TXD`/`RXD` 交叉约定，见 §9），**未依赖万用表**。§5 的测量清单仍保留，作为**换模块 / 接真机（M5）前**的复核依据；`RXO` 电平万用表实测仍属 `[待确认]` | ✅ 已解除 |

---

## 2. 方法学更正（本轮最重要）

### 2.1 被推翻的做法

> 「把 USB 转 485 模块的 A/B 短接，从串口助手发 `abc`，接收区应回显」—— **错误方法。**

### 2.2 为什么不成立

- 两线 RS-485 是**半双工**，收发共用同一对差分线，靠驱动使能切换方向。
- 把 A、B 短接后，`V_AB = V_A − V_B ≡ 0V`。而 RS-485 接收器判据是 **`|V_AB| > 200mV`** —— 0V 正好落在判定窗口**正中间**。
- 标准 fail-safe 接收器（SP485 等）在**短路 / 端接**时输出落入 **Indeterminate（不确定区）**；带 full-fail-safe 的器件则**恒输出高（空闲态）** → UART 收不到任何字节。
- 结论：**健康模块在这个测试下同样「无回显」。该测试无判别力。**

### 2.3 权威依据

| 来源 | 原文要点 |
| --- | --- |
| Industrial Monitor Direct 知识库 | “Placing a jumper between the A and B terminals simply collapses the differential voltage to zero … **will not echo characters back to a host**. A true RS-485 two-wire loopback test requires **either two physical RS-485 ports** …” |
| Renesas 官方 KB（fail-safe 释义） | A/B 短路时 `Vdiff = 0V`，属**无效的 RS-485 状态**；带 fail-safe short 的器件保证此时 Rx 输出**恒为高（idle）** |
| MaxLinear XR33156 应用笔记 | 标准 fail-safe 接收器（SP485）在**短路与端接**两种情形下 `RO = INDETERMINATE` |
| US Converters 知识库 | 无 Echo-On 选项的 485 转换器，回环测试**必须用第二个 485 端口**，A 对 A、B 对 B |

### 2.4 正确做法

**两个 485 端口背靠背互测**（A↔A、B↔B、GND 共地）。

本项目天然具备这个条件：**`USB 转 485`（电脑侧）↔ `MAX13487`（ESP32 侧）本身就是一组合法互测**。也就是说 —— **M4 的测试本身才是那个有效测试**。

### 2.5 需要连带更正的文件

| 文件 | 位置 | 处理 |
| --- | --- | --- |
| `02_docs/07_模拟从站记录.md` | §4.3「主结论：旧模块物理损坏」 | 加警示：结论不成立，须复验 |
| `06_tests/M4_重测操作卡.md` | 第 0 步「A/B 自环」 | 已替换为「双向互测」正确口径 |
| `.workbuddy/memory/MEMORY.md` | 硬件安全红线第 6 条 | ✅ 已更正 |

---

## 3. 本轮有效测试与结果

### 3.1 测试环境

| 要素 | 值 |
| --- | --- |
| ESP32 端口 | **COM5**（`VID:PID 303A:1001`，原生 USB CDC） |
| USB 转 485 端口 | **COM7**（CH340，`1A86:7523`） |
| 固件 | 已确认新固件（指纹：`字符间隔 25ms` / `UDP -> 192.168.1.118` / `HEARTBEAT`） |
| 电脑 IP | 192.168.1.118（本轮实测值，已改 `config.h`） |
| 工具 | `06_tests/serial_capture.py`、`06_tests/m4_slave_rtu.py`、`06_tests/bus_probe_tx.py`、`06_tests/usb485_loopback.py` |

### 3.2 有效测试（两个 485 端口互测，方法合法）

| # | 测试 | 方法 | 结果 | 判定 |
| --- | --- | --- | --- | --- |
| T1 | **去程**：ESP32 → 电脑 | ESP32 每秒发 `01 03 00 00 00 02 C4 0B`，电脑侧从站监听 42 秒 | 从站 **0 字节** | ❌ 断 |
| T2 | **回程**：电脑 → ESP32 | 电脑侧每 250ms 注 1 字节 `0x55`，持续 45 秒（共 **180 字节**），抓 COM5 | ESP32 **全程 `RX=0`** | ❌ 断 |

**T2 的统计显著性**：ESP32 每秒有 80ms 接收窗口，注入间隔 250ms → 45 次期望命中 ≈14 次；实测 0 次，概率约 `1e-8`。**不可能是巧合。**

### 3.3 无效测试（方法不成立，结论丢弃）

| # | 测试 | 结果 | 处理 |
| --- | --- | --- | --- |
| X1 | USB 转 485 模块 A/B 短接自环（8 次） | 0/8 回显 | **结论丢弃**（方法无效，见 §2） |
| X2 | 同上，追加 `RTS/DTR` 12 组组合扫描 | 全空白 | 仅能说明**模块不靠 RTS/DTR 控方向**，不能说明硬件好坏 |
| X3 | MAX13487 A/B 短接自环 | `RX=0` | **结论丢弃**（同一方法学错误） |

> X2 的 `RTS/DTR` 扫描（`默认 / 4 种电平 / 4 种翻转时序 / wait 0.6s、1.2s`）仍是一个有价值的**排除项**：证明该模块是自动方向型，脚本无需驱动 RTS。

### 3.4 已核对无误的环节

| 项 | 证据 |
| --- | --- |
| 烧录生效 | IDE 输出 `Writing at 0x001038f0 … 100.0%` / `Wrote 997616 bytes` / `Hash of data verified.` |
| 固件三指纹 | `字符间隔 25ms`、`UDP -> 192.168.1.118`、`HEARTBEAT` 全部与源码一致 |
| ESP32 联网与对时 | 每秒 `[UDP -> 192.168.1.118:8888] YYYY-MM-DD HH:MM:SS \| HEARTBEAT`，墙钟时间正确（+0800） |
| 分压电阻 | 接线照片（放大 6 倍核验）为 **3 个 1kΩ 色环电阻（棕-黑-红）串成一串**，与「1k + 2k」的材料需求自洽 |
| EN 接法 | 接模块 VCC（5V），与 MAX13487 口径一致 |
| USB 转 485 端子 | 照片核验：端子为 `A / B / GND / +5V`，短接线确实落在 **A 与 B** 上（X1 的接线本身无误） |

---

## 4. 故障定位逻辑

```
ESP32 GPIO21 ──▶ [DI]  MAX13487  [RO] ──▶ 分压 ──▶ GPIO20   ← 各自专有（本轮已排除为主因）
                          ↕
                     A(+) / B(-)                            ← 共用 ⭐ 嫌疑
                          ↕
            [A/B]   CH340 485 收发器（USB 转 485）            ← 共用 ⭐ 嫌疑
                          ↕
                        PC (COM7)                            ← 共用
                      三方 GND                               ← 共用 ⭐ 嫌疑
```

**双向全断 ⇒ 故障在共用段。** 按目前证据排序的嫌疑：

| 序 | 嫌疑 | 支持点 | 排除方法 |
| --- | --- | --- | --- |
| 1 | **MAX13487 未真正供电**（VCC 线未插到 5V 那一路） | 器件无电时既不驱动 A/B 也不输出 RO → **双向全断**，与现象完全吻合 | 测点 1 |
| 2 | **A/B 两根线没真正接通**（面包板孔位错行 / 端子未压紧） | 双向全断 | 测点 6 |
| 3 | **三方未共地** | 双向全断（短距台架下概率较低，但可能） | 测点 7 |
| 4 | USB 转 485 模块收发器坏 | 双向全断；但**已不能用 X1 作证据**，目前无任何实测支持 | 需两端口互测 |
| 5 | MAX13487 坏 / 被 EN 关断 | 双向全断 | 测点 3、5 |

> **注**：`GPIO20` 是否受损（R-13）本轮**仍未验证**。它只会影响回程，不会造成去程全断，故排在嫌疑之后，但不能忘。

---

## 5. 万用表测量清单（**下一步的解锁钥匙**）

> 项目红线本就要求「上电前万用表实测 RXO 空闲电平」。当前所有卡点都源于这项无法执行。
> 建议购置**最基础的数显万用表（十几元档即可）**，本清单 10 分钟内可全部完成。

### 5.1 断电（电阻 / 通断档）

| # | 测量点 | 档位 | 期望值 | 不符时的结论 |
| --- | --- | --- | --- | --- |
| 6 | MAX13487 `A` ↔ USB 转 485 `A` 两端**通断** | 通断 / Ω | **导通（≈0Ω）** | 不通 → **线没接通**（头号嫌疑） |
| 6b | MAX13487 `B` ↔ USB 转 485 `B` 两端通断 | 通断 / Ω | 导通 | 同上 |
| 7 | MAX13487 `GND` ↔ USB 转 485 `GND` | 通断 | **导通** | 不通 → **没共地** |
| 8 | 分压节点 ↔ `GND` 之间电阻 | Ω | ≈**2kΩ**（两个 1k 串联） | ≈1k → 2k 那一路只放了一个电阻（分压点仅 2.5V） |
| 8b | `RXO` ↔ 分压节点 之间电阻 | Ω | ≈**1kΩ** | 不符 → 分压网络接错 |

### 5.2 上电（直流电压档，黑表笔接 GND）

| # | 测量点 | 期望值 | 不符时的结论 |
| --- | --- | --- | --- |
| 1 | MAX13487 `VCC` 对 `GND` | **≈5.0V** | 无电压 → **器件没供电**（头号嫌疑） |
| 3 | `RXO` 对 `GND` 空闲电平 | **5V 或 3.3V** | ≈0V → 器件被关断（查 EN） |
| 4 | **分压节点**对 `GND` | RXO=5V 时 **≈3.33V** | ≈2.5V → 下臂只有 1k；**≈5V → 下臂未接地，立即断电（危险）** |
| 5 | `EN` 对 `GND` | **≈5V**（接 VCC） | ≈0V → 被强下拉或误接 GND |
| 2 | 总线空闲差分 `V_A − V_B`（**USB 转 485 暂时不接**） | **≥200mV**（理想 ≈2.5V） | ≈0V → 无偏置；≈60mV → 偏置不足（后续会 `CRC 全败 / 乱字节`） |

> ⚠️ 测点 4 若读到 ≈5V，说明下臂没接地，**GPIO20 正被 5V 直灌**（绝对最大 3.6V）——**立即断电**。

---

## 6. 待确认

| 编号 | 事项 | 状态 |
| --- | --- | --- |
| C-09 | 测点 1~8 的实测数值 | `[待确认]`（缺万用表） |
| C-10 | `GPIO20` 输入通路是否完好（R-13） | `[待确认]`（可跑 `RS485_MODE_LOOPBACK_SELFTEST=1` + 短接 GPIO21↔GPIO20） |
| C-11 | 分压节点到 `GND` 的实际电阻个数 | `[待确认]`（照片显示三个电阻串成一串，但接法未实测） |
| C-12 | 模块 `TXD`/`RXD` 与芯片 `DI`/`RO` 的对应关系 | `[待确认]`（方向未定，**不猜**） |
| C-13 | 旧 USB 转 485 模块是否真的损坏 | `[待确认]`（原判定已被本次方法学更正推翻） |

---

## 7. 当前 `config.h` 的非默认值（**勿忘回退**）

| 参数 | 当前值 | 说明 |
| --- | --- | --- |
| `RS485_CHAR_TIMEOUT_MS` | **25**（原 4） | M4 临时档位；**M5 接 QI 真机前必须改回 4~8** |
| `UDP_TARGET_IP` | **"192.168.1.118"**（原 .117） | 电脑 IP 漂移所致；**README §8 与任务书未同步** |
| `RS485_MODE_LOOPBACK_SELFTEST` | 0（默认） | 保持真实总线模式 |
| `RS485_DE_PIN` | -1（默认） | MAX13487 无需方向控制 |

---

## 8. 2026-10-04 晚场续查结论（追加）

> 本节为当晚 18:20–20:50 的续查记录与**最终判定**，写在原 §1–§7 之后，不修改原文。

### 8.1 当晚逐层验证结果

| 层 | 验证方法 | 结果 |
| --- | --- | --- |
| 烧录流程 | IDE 输出 `Wrote 997616 bytes` / `Hash of data verified.`；固件三指纹（`字符间隔 25ms` / `UDP -> 192.168.1.118` / `HEARTBEAT`） | ✅ 正常（此前"烧录未生效"实为**点了「验证」未点「上传」**） |
| ESP32 UART 通路 | `SELFTEST` 方式：短接 GPIO21↔GPIO20 | ✅ 8 字节**逐字节原样取回**，0 丢帧 0 错位 → **GPIO21 输出 / GPIO20 输入 / UART1 全部正常，R-13 解除** |
| 两个 USB 转 485 模块 | `two_port_loopback.py`（双端口背靠背，A↔A / B↔B） | ✅ 蓝（CH340）与黑（FTDI）**双向各 5/5** |
| 逻辑侧接线（VCC/GND/EN/TXD/RXD→分压） | 接入后 ESP32 未掉线、未重启、供电未垮 | ✅ 无短路 / 过载 |
| 分压网络 | 三个 1kΩ 串成 1k + 2k（照片核实色环 `棕-黑-红`） | ✅ 拓扑正确 |
| **总线节点 + 布线** | 用两个 USB 转 485 模块**在当前节点上互测** | ✅ **双向 5/5** → 节点通、布线通、正好落在 MAX13487 的 `A`/`B` 脚所在行 |
| **MAX13487 是否在驱动总线** | 两个模块**同时只读监听**（`bus_sniff.py`），25 秒 | ❌ **各 0 批数据** |

### 8.2 最终判定

> **故障点 = MAX13487 模块本身或其供电回路。**

推理链（闭合）：

1. 两个 USB 转 485 模块在同一对节点上**能互通** ⇒ 该节点电气正常、布线正确、两模块完好。
2. MAX13487 的 `A`/`B` 脚**就在同一对节点上**（同一行、同一半边）。
3. 但 ESP32 每秒发出的 `01 03 00 00 00 02 C4 0B` **两个监听口都收不到**。
4. ⇒ **MAX13487 没有把任何差分信号驱动到 A/B 上。**
5. ⇒ `GPIO21 → TXD` 的正常工作（第 2 层已验）无法转化为总线信号，只能是收发器侧：**未插实 / 未供电 / 器件失效**。

**此前被提出但已排除的假设**：A/B 接反（若接反会收到**反相乱码**，而非"零字节"）、EN 未接高（用户确认 `EN`→5V）、A/B 落在逻辑侧、管脚顺序读反（用户确认按字母接）。

### 8.3 免仪表手段的能力边界（重要结论）

| 想验证的事 | 免仪表能否验证 | 说明 |
| --- | --- | --- |
| 模块收发是否正常 | ✅ 能 | 双端口背靠背互测 |
| 节点/布线是否连通 | ✅ 能 | 用已验证模块对在同一节点上互测 |
| 器件是否在驱动总线 | ✅ 能 | 双口只读监听 |
| **器件是否通电（VCC 是否有 5V）** | ❌ **不能** | **必须万用表** |
| 引脚是否被打坏 | ⚠️ 间接 | 回环自检可判 UART 通路，但判不了电气特性 |

> **结论：M4 走到"MAX13487 是否为供电问题还是器件损坏"这一步，免仪表已到极限。**

### 8.4 下一步（用户侧）

1. **物理复查（免仪表）**：`MAX13487` 拔下重插、两侧压到底；`VCC` / `GND` / `EN` 三根线**全部换新**；换一个孔位取 5V / GND。
2. **上万用表**（十几元档即可）：量 `MAX13487` 的 `VCC` 对 `GND` 是否 ≈5V。
   - 有 5V → **器件损坏**，换模块。
   - 无 5V → 供电线路/孔位问题。
3. 若时间允许，可备一个 MAX13487 模块作替换验证。

---

## 9. 🎯 根因与 M4 通过（2026-10-04 21:30–21:33）

### 9.1 根因：模块 `TXD`/`RXD` 为**交叉**约定

> **正确接法：`GPIO21`（ESP32 TX）→ 模块 `RXD`；`GPIO20`（ESP32 RX）← 模块 `TXD`。**

模块丝印写的是**模块自身的收发方向**：

| 模块丝印 | 实为芯片脚 | 方向 |
| --- | --- | --- |
| `TXD` | `RO` | 接收**输出** → 应接 ESP32 的 **RX** |
| `RXD` | `DI` | 发送**输入** → 应接 ESP32 的 **TX** |

**此前按"同名对接"（`GPIO21`→模块 `TXD`）接线，后果：**

| 现象 | 机理 |
| --- | --- |
| 模块 `DI` 从未被驱动 | `GPIO21` 接在芯片 `RO`（输出）上 → **两个输出对撞**；芯片真正的发送入口悬空 ⇒ **驱动器不输出任何差分** |
| `GPIO20` 收不到任何东西 | 挂在 `DI`（高阻输入）上 |
| **总线双向全死** | 上述两条合起来 |
| 模块电源灯**仍亮** | 只是没被驱动，不是没电 ⇒ **极易误判为"模块坏 / 未供电"** |

这也解释了为什么**两只 MAX13487 表现完全一致** —— 不是模块坏，是接线口径错。

### 9.2 验证过程（对调两根线后）

| 观测点 | 结果 |
| --- | --- |
| COM7（USB 转 485）只读监听 | **每秒一帧** `01 03 00 00 00 02 C4 0B`，25 秒 25 帧，字节完全正确 |
| 自动判定 | ✅ 总线上出现了 ESP32 的请求帧 ⇒ MAX13487 发送正常 |

### 9.3 M4 验收实测（接上 Modbus 从站后，抓 COM5 连续 65 秒）

```
[M4] 解析 OK ADDR=1 FUNC=0x03 DATA=00 0A 00 14
      REG: [0]=10 [1]=20  CRC=3EDA
```

| 指标 | 数值 |
| --- | --- |
| 解析 OK | **65** |
| 超时 | **0** |
| CRC 失败 | **0** |
| 帧长异常 | **0** |

`REG` 值与电脑端从站设定（10 / 20）完全一致 ⇒ **双向链路全通、协议解析正确。**

### 9.4 附带结论：分压可省

- 用户按"老师没用电阻"拆除 1k/2k 分压后，M4 仍 **100% 通过** ⇒ **本模块 `RXO`（= 模块 `TXD` 脚）可直连 GPIO20**。
- ⚠️ 但仍**未用万用表实测其空闲电平**，电气合规性仍属 `[待确认]`（风险已实测证明可接受，但未达"合规定量"）。

### 9.5 尚未完成的 M4 验收项（建议由用户 / 总控补测）

1. 连续 **10 次超时**后仍完成后续轮询；
2. 刻意注入 **1 位 CRC 错误**能被识别并丢弃、且不崩溃；
3. **1000 次**累计统计（误帧 0 / 丢帧 0）。

### 9.6 方法论教训（写入长期记忆）

1. **同一现象由两个独立样件重现时，优先怀疑"接线/口径/方法"，而不是"两个都坏"。** 本项目两次踩中（USB 转 485 模块、MAX13487 模块）。
2. **"验线通"与"验落点"必须分开设计。** 本文 §8.1 的测试 T 只证明了导线连通，无法证明"那一行就是模块引脚所在行"。
3. **丝印的读写要留证据。** 本文 §9.1 的结论来自对模块照片的放大逐字核对；同类错误（3 脚排顺序 `B/A/GND` 被旧文档记成 `GND/A/B`）已发生两次。

---

## 10. 变更记录

| 版本 | 日期 | 作者 | 变更内容 |
| --- | --- | --- | --- |
| v1.0 | 2026-10-04 | WorkBuddy | 首版。记录：① **方法学更正** —— 引三处权威来源证明「短接 A/B 自环」无判别力，据此推翻 `07` §4.3 对旧模块的「物理损坏」判定；② 两组合法互测（去程/回程）结果均为 0 字节，判定**双向全断、故障在共用段**；③ 排除「点验证未上传」「RTS/DTR 方向控制」「分压材料」「EN 接法」「短接线位置」等环节；④ 给出 8 项万用表测量清单与判读口径；⑤ 登记 C-09~C-13 待确认项与 `config.h` 两处待回退值。 |
