jiangtao-ml/ESP32_C3_Gateway/02_docs/14_M4排障全过程复盘_2026-10-04.md

# M4 排障全过程复盘（2026-10-04）

| 项目 | 内容 |
| --- | --- |
| 文档名称 | M4 排障全过程复盘 |
| 版本 | v1.0 |
| 日期 | 2026-10-04 |
| 覆盖时段 | 2026-09-30 ~ 2026-10-04（含当晚 18:20–21:33 完整现场） |
| 作者 | WorkBuddy（文档角色） |
| 定位 | **过程复盘与方法论沉淀**。记录"怎么错的、怎么一步步排除的、哪些现象会骗人"。 |
| 与其它文档的分工 | `02_docs/13` = 排障**数据与测点清单**；本文 = **过程、假设台账与教训**；`06_tests/M4_从零重建分步指南.md` = **可执行操作卡** |
| 唯一事实来源 | `04_ai_prompts/00_context.md` |

> **结论先行**：M4 卡了 5 天的根因是 —— **485 模块丝印 `TXD` / `RXD` 是「交叉」约定，不是同名对接**。
> 而它之所以能骗过所有人 5 天，是因为**它的症状和"模块损坏 / 未供电"一模一样**（双向全断、模块电源灯仍亮）。

---

## 1. 最终结论

### 1.1 根因（一句话）

> **`GPIO21` 必须接模块 `RXD`、`GPIO20` 必须接模块 `TXD`。**

模块丝印写的是**模块自身的收发方向**，不是"你那边接什么"：

| 模块丝印 | 实为芯片引脚 | 方向 |
| --- | --- | --- |
| `TXD` | `RO` | 接收**输出** → 应接 MCU 的 **RX** |
| `RXD` | `DI` | 发送**输入** → 应接 MCU 的 **TX** |

### 1.2 结果（2026-10-04 21:33 实测）

```
[M4] 解析 OK ADDR=1 FUNC=0x03 DATA=00 0A 00 14
      REG: [0]=10 [1]=20  CRC=3EDA
```

连续 **65 秒**：解析 OK **65** / 超时 **0** / CRC 失败 **0** / 帧长异常 **0**。

---

## 2. 为什么这个故障能骗过 5 天

按"同名对接"接线后的真实电路状态：

| 接线 | 实际发生 | 表象 |
| --- | --- | --- |
| `GPIO21`（TX）→ 模块 `TXD`（实为芯片 `RO` 输出） | **两个输出对撞** | 不发热、不冒烟、看不出异常 |
| 芯片 `DI`（真正的发送入口） | **悬空，从未被驱动** | 驱动器一点差分都不输出 |
| `GPIO20`（RX）← 模块 `RXD`（实为芯片 `DI` 高阻输入） | 接收端挂在输入脚上 | 永远收不到数据 |
| 模块 `VCC` / `EN` | 供电正常 | **电源指示灯正常点亮** |

**净效果：总线双向全死，而板子看起来完全正常。**

这就是本故障的全部杀伤力 —— 它同时伪造了三个"硬件坏了"的特征：

1. 收发全无（像收发器坏了）
2. 电源灯亮（排除了"没供电"这个思路）
3. 换新模块同样全无（看起来像"两只都坏"或"板子有问题"）

---

## 3. 完整时间线

### 3.1 第一阶段：M4 首次尝试（2026-09-30 ~ 10-03，约 4 天）

| 时刻 | 事件 |
| --- | --- |
| 09-30 | M4 首次上电：串口持续 `[M4] 超时`，`RX=0`（期望 9 字节） |
| 10-03 | 隔离法排查：断开 ESP32，单独给旧 USB 转 485 模块做 **A/B 短接自环**，接收区一片空白 |
| 10-03 | **据此判定"旧模块物理损坏"** → 下单带 GND 端子的 CH340 新模块 |
| 10-03 | 老师指出"做不出来正是因为 EN 断开" → EN 口径由"悬空"改为**接固定高电平** |
| 10-03 | 全仓库文档一致性排查（任务书 v0.3.5）；Codex 完成 8 轮审查 |

**这一阶段埋下的两个错误**：

- ❌ **"A/B 短接自环"本身是无效方法**（见 §4.1）→ 由此得出的"旧模块损坏"结论不成立
- ❌ 未记录：**模块 `TXD`/`RXD` 的实际接线方式**

### 3.2 第二阶段：当晚现场（2026-10-04 18:20–21:33）

| 时刻 | 事件 | 结果 |
| --- | --- | --- |
| 18:20 | 用户要求盘点进度并带着往下做 | 确认 M0–M3 通过、M4 阻塞 |
| 18:30 | 侦察环境：找 `arduino-cli`（未安装）、装 `pymodbus`/`pyserial` | 决定由 WorkBuddy 承担从站与串口抓取 |
| 18:46 | 用户：线已接好、无万用表、USB 已插 | 识别 `COM5`=ESP32（`303A:1001`）、`COM7`=USB转485（CH340） |
| 18:52 | **发现电脑 IP 由 .117 漂移到 .118** | 改 `config.h`；同时把 `RS485_CHAR_TIMEOUT_MS` 4→25（M4 临时档位） |
| 18:59 | 抓串口：心跳为 `M2_HEARTBEAT`、超时仍 4ms、UDP 仍 .117 | **判定"烧录未生效"** |
| 19:23 | 用户重烧，IDE 输出 `Hash of data verified.` | **三指纹全部对上 → 烧录确认生效** |
| 19:23 | 双向全断（从站 52 s 收 0 字节；回程注 225 字节 ESP32 收 0） | 判别"故障在共用段" |
| 19:41 | 用户短接 USB 转 485 模块 A/B → 自环 0/8 | **触发对"自环测试"本身的怀疑** |
| 19:45 | 短接 MAX13487 A/B → 仍 `RX=0` | 同为无效方法 |
| 19:50 | **查证三处权威来源，确认"A/B 短接自环"无效** | 推翻旧结论，更正文档与长期记忆 |
| 20:02 | 用户短接 `GPIO21↔GPIO20` → **8 字节逐字节原样收回** | **GPIO20 完好，R-13 解除** |
| 20:10 | 接入 MAX13487 逻辑侧（接法按"同名"） | ESP32 未掉线、供电未垮；总线仍无数据 |
| 20:21 | 全量重建后联测 | 双向仍全断 |
| 20:23 | 回程注入 225 字节 → 0 | 双向全断，收窄到 MAX13487 侧 |
| 20:31 | 用户提供模块照片 → **总线侧丝印实为 `B / A / GND`**（旧文档写 `GND / A / B`） | 更正文档（但用户确认自己按字母接，非根因） |
| 20:39 | 用户换黑模块复测 | 仍 0 字节 |
| 20:41 | 换新 MAX13487 复测 | **仍 0 字节 → 两只模块表现一致，转为怀疑接线/口径** |
| 21:03 | 用户"去掉了分压电阻" | 结果无变化（电阻在接收段，解释不了发送段） |
| 21:07 | **测试 T**：`GPIO21 →` 用户认定的 `TXD` 行 `→` 跳线 `→` `GPIO20` | ✅ 通过 → 那根导线是好的（⚠️ 但见 §4.4 盲区） |
| 21:14 | 换电（`VCC`/`EN` 改接蓝模块 `+5V`）+ `EN` 直连 `VCC` | 仍全空 → 排除供电路径与 EN |
| 21:19 | **测试 U**：靠模块内部 `GND` 连通两行 | `RX=0`（两种解释未分） |
| 21:23 | 俯视照分析：模块**电源灯亮着** | 削弱"未供电"假设 |
| 21:27 | **提出「`TXD`/`RXD` 交叉约定」假设** | — |
| 21:30 | 用户对调这两根线 | **总线上立刻出现 `01 03 00 00 00 02 C4 0B`（25 秒 25 帧）** |
| 21:33 | 接上 Modbus 从站复测 | **65 秒 65 次解析 OK，0 失败 → M4 通过** |

---

## 4. 六个骗过我们的陷阱

> 这一节是本文最有价值的部分。**每一个陷阱都足以让一次排障绕上几小时。**

### 4.1 陷阱一：「A/B 短接自环」是无效方法

**做法**：把 USB 转 485 模块的 A、B 短接，从串口发 `abc`，看是否回显。

**为什么看似合理**：这是 TTL 串口"TX 接 RX 自环"的思维惯性；网上也广泛流传。

**为什么无效**（物理原因）：

- 两线 RS-485 是**半双工**，收发共用一对差分线。
- **短接 A/B 后差分电压 `V_AB ≡ 0`**，而接收器判据是 `|V_AB| > 200mV` → 0V 正好落在判定窗口**正中间**。
- 标准 fail-safe 接收器（SP485 等）此时输出落入 **Indeterminate（不确定区）**；带 full-fail-safe 的器件则**恒输出高（空闲态）**。
- ⇒ **健康的模块同样不会回显。**

**权威依据**：

| 来源 | 原文要点 |
| --- | --- |
| Industrial Monitor Direct 知识库 | 短接 A/B 使差分塌到 0，**不会回显**；真正的两线 485 回环**必须两个物理 485 端口** |
| Renesas KB（fail-safe 释义） | 短路时 `Vdiff = 0V` 属**无效 RS-485 状态**；fail-safe short 器件保证输出恒高 |
| MaxLinear XR33156 应用笔记 | 标准 fail-safe 接收器在**短路 / 端接**时 `RO = INDETERMINATE` |
| US Converters 知识库 | 无 Echo-On 选项的转换器，回环测试**必须用第二个 485 端口** |

**造成的实际损失**：

1. **旧 USB 转 485 模块被误判"物理损坏"**（`02_docs/07` §4.3）→ 用户额外购买了新模块。当晚用**双端口互测**证明：**旧模块（黑，FTDI）收发完全正常，双向 5/5。**
2. 我（WorkBuddy）在 19:41 又让用户做了一次同样的无效测试（MAX13487 A/B 短接），结论同样不可用。

**正确做法**：

> **两个 485 端口背靠背互测**（A↔A、B↔B、GND 共地）。
> 本项目天然具备这个条件：`USB 转 485`（电脑侧）↔ `MAX13487`（ESP32 侧）本身就是一组合法互测 —— **也就是说，"M4 测试"本身就是那个有效测试。**

---

### 4.2 陷阱二：同一个现象有多个成因（`RX=0`）

`RX=0`（一个字节都没收到）在本次排障中至少对应过 **7 种**不同原因：

| # | 原因 | 关键鉴别 |
| --- | --- | --- |
| 1 | 烧录未生效（跑的是旧固件） | 看固件"指纹"：`字符间隔`值 / UDP 目标 IP / 心跳标签 |
| 2 | 电脑侧根本没人应答 | 检查从站脚本/工具是否在跑 |
| 3 | 模块未供电 | 电源指示灯 / 万用表 |
| 4 | `A/B` 没接到同一对节点 | 用已验证模块对在同一节点互测 |
| 5 | 逻辑侧线插错行 / 错半边 | 目视 + 用 MCU 当通断表 |
| 6 | **`TXD`/`RXD` 约定相反**（本次真凶） | **对调这两根线看现象是否变化** |
| 7 | 引脚本身损坏（曾被 5V 直灌） | 短接回环自检 |

**教训**：`RX=0` 不是"一个故障"，而是"一个**类的症状**"。
**排障必须把它拆成"可独立验证的子命题"**，而不是围着同一个现象反复换件。

---

### 4.3 陷阱三：同一个现象由两个独立样件重现 → 会诱导"都坏了"的错误结论

**这个陷阱今晚踩了两次：**

| 次 | 现象 | 当时的错误直觉 | 实际 |
| --- | --- | --- | --- |
| 1 | 旧模块 + 新模块，A/B 短接自环**同样无回显** | "都是坏的？" | **方法本身无效**，两个模块都好好的 |
| 2 | 旧 MAX13487 + 新 MAX13487，**同样总线全死** | "模块都不行？" | **接线口径错**，两只模块都没问题 |

**教训（已写入长期记忆）**：

> **同一现象由两个独立样件重现时，优先怀疑"接线 / 口径 / 方法 / 工具"，而不是"两个都坏"。**

这条法则如果在第一次就生效，今晚可以少走两个小时。

---

### 4.4 陷阱四：测试设计的盲区 ——「验线通」≠「验落点」

**测试 T 的设计**：`GPIO21 →(原有线)→ 用户认定的 TXD 行 →(新跳线)→ GPIO20`，
ESP32 收到自己的 8 字节 ⇒ 判定"`GPIO21 → TXD` 这根线是好的"。

**盲区**：它只证明了**那根导线是通的**，**无法证明"用户插的那个孔，就是模块 `TXD` 引脚所在的孔"**。
如果整体错了一行，测试 T 依然通过。

**教训**：

> **"验线通"和"验落点"必须拆成两个独立测试设计。**

**补充的"验落点"思路（测试 U）**：利用模块**逻辑侧 `GND` 与总线侧 `GND` 在模块内部是同一节点**这一事实，
让信号"穿过模块"走一圈 —— 若通，说明两侧引脚都真的插进了面包板。
（本次测试 U 未通过，但因存在"引脚未接触"与"测试未做对"两种解释，未能定论；见 §6 待办。）

---

### 4.5 陷阱五：丝印会读反（两处，两次）

| 位置 | 错误读法 | 正确读法 | 后果 |
| --- | --- | --- | --- |
| 总线侧 3 脚顺序 | `GND / A / B` | **`B / A / GND`** | 按错序接会把 `B` 接到 `GND` 上 → 总线差分永远出不去 |
| 逻辑侧 `TXD`/`RXD` 语义 | 同名对接（`TXD`→MCU 的 TX） | **交叉对接**（`TXD`→MCU 的 RX） | **本次 M4 卡 5 天的真凶** |

**两次都发生在"对着照片核对丝印"这一动作上** —— 第一次是 Codex（2026-10-03，把 3 脚排读成 `GND/A/B`，且该错序被写进审查报告固化），第二次是 WorkBuddy（把 `TXD`/`RXD` 定为同名）。

**教训**：

> **丝印判读必须留证据**（放大截图 + 逐字记录），而且**判读结果与被测现象不符时，第一件事是回头复核丝印**，而不是继续换件。
> **对丝印的"常识性假设"（比如"TXD 当然接 TX"）是本项目最高频的致错点。**

---

### 4.6 陷阱六：面包板的"隐形断路"

面包板有两个**用眼睛几乎看不出**的断路方式：

| 陷阱 | 说明 |
| --- | --- |
| **中央凹槽隔断** | 同一行的 `a–e` 与 `f–j` 是**两个互不导通的节点**。模块跨在凹槽上，其两排脚分居两侧。把线插到"同一行的另一半边"→ **看着接上了，实际断路**。 |
| **整排错行** | 插到相邻一行 → 同样看着接上了。 |

**对本项目的具体影响**：
MAX13487 模块跨中央凹槽，**总线侧 3 脚在 `f–j`，逻辑侧 5 脚必在 `a–e`**。
—— 这类问题**只能靠"看清引脚实际落在哪一行哪半边"解决**，问话问不出来，也不该靠猜。

---

## 5. 方法论沉淀（可复用的排障法则）

### 5.1 七条法则

1. **分层搭建，每层单独验证。** 一次接完再测 = N 个变量同时上场，任一错都表现为同一个症状。
2. **同一现象由两个独立样件重现 → 优先怀疑方法，不要怀疑器件。**
3. **"验线通"与"验落点"分开设计。** 导线连通 ≠ 接点正确。
4. **给固件留"指纹"。** 本次靠 `字符间隔` 值 / UDP 目标 IP / 心跳标签，一眼判定"烧录是否生效"。
5. **免仪表也要先穷尽"能用代码测的"再上仪器。** 本次用三招顶替了万用表：双端口互测、MCU 当通断表、只读监听。
6. **丝印判读留证据、并接受复核。** 与现象不符时先回头复核丝印。
7. **改动只做单变量。** 每次只动一处，改完立刻复测。

### 5.2 免仪表的能力边界（本次实测得出）

| 待验证的事 | 免仪表能否做到 | 方法 |
| --- | --- | --- |
| 485 模块收发是否正常 | ✅ | 双端口背靠背互测（`two_port_loopback.py`） |
| 节点 / 布线是否连通 | ✅ | 用已验证的模块对在同一节点互测 |
| 器件是否在驱动总线 | ✅ | 多口只读监听（`bus_sniff.py` / `m4_verify.py`） |
| MCU 引脚与串口通路 | ✅ | 短接 TX↔RX 回环自检 |
| **器件是否通电（VCC 有无 5V）** | ❌ | **必须万用表** |
| 引脚电气特性（电平、驱动能力） | ❌ | **必须万用表 / 示波器** |
| 两点之间是否导通 | ⚠️ | 只能间接（让信号穿过被测物） |

### 5.3 症状 → 优先怀疑（速查表）

| 症状 | 优先怀疑（按序） |
| --- | --- |
| **双向全断 + 模块电源灯亮** | **① `TXD`/`RXD` 约定接反（同名 vs 交叉）** ② 引脚整排错行 / 错半边 ③ 模块未插实 |
| 双向全断 + 模块不亮 | 供电（`VCC` / `GND` / 5V 来源） |
| 只有发送方向不通 | `MCU TX → 模块发送输入` 这一段 |
| 只有接收方向不通 | `模块接收输出 → MCU RX` 这一段（含分压） |
| 收到数据但 CRC 全败 / 偶发乱码 | 未共地 / 偏置不足 / 极性反 / 波特率不一致 |
| 一发就收到自己的请求帧 | 接收器被常开（`MAX485/3485` 的 `EN` 固定接高） |

---

## 6. 未完成事项

| # | 事项 | 状态 |
| --- | --- | --- |
| 1 | M4 补测：连续 10 次超时后仍完成后续轮询 | `[待做]` |
| 2 | M4 补测：刻意注入 1 位 CRC 错误能被识别且不崩溃 | `[待做]` |
| 3 | M4 补测：1000 次累计统计（误帧 0 / 丢帧 0） | `[待做]` |
| 4 | `RS485_CHAR_TIMEOUT_MS` 由 25 改回 4~8（M5 前） | `[待做]` |
| 5 | `UDP_TARGET_IP` = .118 的 README / 任务书同步 | `[待做]` |
| 6 | `RXO` 空闲电平万用表实测（当前直连可工作，但无定量依据） | `[待确认]` |
| 7 | 测试 U 未定论（引脚是否真正插实） | `[待确认]` |
| 8 | 黑模块（COM6）在监听时每秒收到 1 字节 `D8`，未解释 | `[待确认]` |
| 9 | 万用表采购（M5 接强电前必需） | `[待做]` |

---

## 7. 本次排障产出的工具（均在 `06_tests/`）

| 脚本 | 用途 |
| --- | --- |
| `m4_verify.py` | **一键联测**：同时看 ESP32 串口 + 多个 485 端口只读监听，自动判定"是否在驱动总线" |
| `m4_slave_rtu.py` | 手写帧组装的 Modbus RTU 从站（替代 Modbus Slave GUI），含容错解析 |
| `two_port_loopback.py` | **两个 485 端口背靠背互测**（本项目唯一有效的"换件后第一动作"） |
| `bus_sniff.py` | 485 总线只读监听（不发送，不会与从站争抢） |
| `bus_probe_tx.py` | 单向注入探针（用于分离去程 / 回程） |
| `serial_capture.py` | ESP32 串口抓取（替代人工复制串口监视器） |
| `usb485_loopback.py` | 单端口 A/B 自环 —— ⚠️ **已证无效，仅作历史留档，勿再使用** |

---

## 8. 责任与修正（WorkBuddy 自省）

| # | 失误 | 影响 | 修正 |
| --- | --- | --- | --- |
| 1 | **把 `TXD`/`RXD` 口径定为"同名对接"**，并据此改写 `02_docs/07` §6.1（原文"交叉"才是对的） | **直接导致现场接错线，M4 多绕一整晚** | ✅ 已回滚 `07` §6.1；✅ 已写入 `MEMORY.md` 红线 4c |
| 2 | 依据用户一句口误（"EN 接的 RXD"）即宣布"找到原因" | 结论作废，浪费一轮 | ✅ 已写入流程教训：口述与已验事实冲突时先复核 |
| 3 | 设计"测试 T"时未区分"验线通"与"验落点" | 得出偏乐观的中间结论 | ✅ 已写入本文 §4.4 |
| 4 | 沿用项目旧文档的"A/B 短接自环"思路，在 19:41 又让用户做了一次 | 浪费一轮 | ✅ 已查证推翻，并更正 `MEMORY.md`、`07`、`06_tests` 三处 |

**同时值得一提的正面产出**：正因为回头质疑了"A/B 短接自环"，才把**旧 USB 转 485 模块的"物理损坏"误判**推翻 —— 旧模块其实完好，用户因此省下一次不必要的采购。

---

## 9. 数据附录（关键原始输出）

### 9.1 烧录生效的三指纹

| 旧固件 | 新固件 | 判据 |
| --- | --- | --- |
| `字符间隔 4ms` | `字符间隔 25ms` | 超时档位 |
| `UDP -> 192.168.1.117:8888` | `UDP -> 192.168.1.118:8888` | UDP 目标 |
| `M2_HEARTBEAT` | `HEARTBEAT` | 心跳标签 |

### 9.2 双端口互测（证明两个 USB 转 485 模块都完好）

```
[two] COM7 -> COM6 : 5/5
[two] COM6 -> COM7 : 5/5
✅ 双向互通：两个模块的收发都正常
```

### 9.3 总线只读监听（对调 `TXD`/`RXD` 之前 vs 之后）

**之前（25 秒）**：`COM6 0 字节` / `COM7 0 字节`

**之后（25 秒）**：
```
COM7  批次=25  总字节=200  收到请求帧=★ 是
      [21:30:31] 8  01 03 00 00 00 02 C4 0B
      [21:30:32] 8  01 03 00 00 00 02 C4 0B
      ...
判定：✅ 总线上出现了 ESP32 的请求帧 ⇒ MAX13487 发送正常
```

### 9.4 M4 正式验收（连续 65 秒）

```
总行数: 200
解析OK : 65
超时   : 0
CRC失败: 0
帧长异常: 0
```

---

## 10. 变更记录

| 版本 | 日期 | 作者 | 变更内容 |
| --- | --- | --- | --- |
| v1.0 | 2026-10-04 | WorkBuddy | 首版。完整复盘 M4 从 09-30 到 10-04 的排障过程：最终根因（`TXD`/`RXD` 交叉约定）、完整时间线、六个"骗过我们的陷阱"（含三处权威查证）、七条可复用排障法则、免仪表能力边界、症状速查表、未完成事项、工具清单、WorkBuddy 自省与修正记录、关键原始输出附录。 |
