jiangtao-ml/ESP32_C3_Gateway/02_docs/README.md

# 02_docs —— 文档中心（32 份 + 本索引）

> 最后更新：2026-10-27 · 砚青（补 31 电量勘误 / 32 起跑前置清单；份数 30→32）
> 分类口径与 `02_docs/00_阶段与门禁主控表.md` §4 **完全一致**，此处只多给"一句话说明"和"还要不要读"

**所有"结论、需求、方案、判据、排障记录"都在这里。代码在 `01_firmware/`，日志在 `03_logs/`。**

---

## 0. 先读这三份（其余按需）

| 顺序 | 文件 | 为什么先读它 |
| --- | --- | --- |
| 1 | **`00_阶段与门禁主控表.md`** | **项目唯一主线**：现在在哪个阶段、下一步做什么、能不能放行。只认这张表 |
| 2 | **`28_系统全链路说明.md`** | **这个系统到底怎么跑起来的**：一个数据包从电表到数据库的完整旅程 |
| 3 | `21_需求规格说明书.md` | 要做什么、做到什么程度（需求基线） |

> 其余 29 份**只在上面三份指向时才需要打开**。

---

## 1. ⚠️ 编号是"写的顺序"，不是"读的顺序"

`01` 是任务书、`03` 是环境记录、`13/14` 是排障、`21/22` 是需求和方案 ——
**同一个阶段的东西被拆到 `01` 和 `21` 两处，中间隔着 20 份记录**。

- ❌ 别按编号顺读，会迷路
- ✅ **按下表按需跳**，或从 `00` 号文进

> 编号**不能改**（两百多处交叉引用依赖它）。这是历史包袱，用这张地图绕过去。

---

## 2. 文档地图

### A 类 · 规范与交付物（**要维护，现在还在用**）

| # | 文件 | 一句话 | 状态 |
| --- | --- | --- | --- |
| **00** | 阶段与门禁主控表 | S0–S5 六阶段 + 每阶段出口判据 + 文档归位 | ✅ **唯一主线** |
| **28** | 系统全链路说明 | 数据从电表到数据库怎么走、每环的坑在哪 | ✅ **新，先读** |
| 21 | 需求规格说明书 | 需求基线（含"三方差异清单"——本文件核心） | ✅ 要维护 |
| 22 | 实现与交付方案 | 168h 长跑怎么做、指标怎么算（M1–M18） | ✅ 要维护 |
| 24 | 焊接与 168h 测试规划 | 34 条验收判据 + 施工摘要 + 归因树 | ✅ 要维护 |
| 26 | 级别声明与范围边界 | **L1 是什么、四项明确不做**（含理由与决定人） | ✅ 要维护 |
| 23 | 项目结构说明 | 目录怎么组织、文件该去哪、整理记录 | ✅ 要维护 |
| 27 | 评审与风险登记册 | 评审记录 8 条 + 风险台账 14 条 | ✅ 要维护 |
| 06 | QI 协议说明 | STB3-125 怎么说话（帧格式、命令、寄存器） | ✅ **常查** |
| 29 | 商用级优化方案（接收端） | P0-1~P0-7 / P1-4 改动清单 + 商业化验收标准 + 10 个待拍板问题 | ✅ 要维护 |
| 30 | 固件商用级加固 | 固件 P0-1~P0-4 落地 + **六条已知限制** + 烧录验证步骤 | ⚠️ **待复核** |

### B 类 · 过程记录（**只读存档**，用于复现与复盘）

| # | 文件 | 一句话 |
| --- | --- | --- |
| 01 | 项目任务书 v0.4.1 | 立项文档。**已冻结**，改走变更记录；部分参数已被 `21`/`24` 覆盖 |
| 03 | 环境搭建记录 | 开发板包、COM 口、静态 IP 怎么配的 |
| 04 | 网络联通记录 | WiFi + NTP + UDP 第一次打通 |
| 05 | 485 回环记录 | UART1 物理回环自测 |
| 07 | 模拟从站记录 | 用 PC 模拟电表做台面预演 |
| 08 | M5 真机联调记录 | 第一次接真机：59/60 |
| 11 | ESP32 开发板包排障 | 包安装、编译报错怎么解决的 |
| 13 | M4 排障记录 | M4 卡住那几天的逐日记录 |
| 14 | **M4 排障全过程复盘** | **卡 5 天的真凶 = TXD/RXD 交叉**，最值得读的排障复盘 |
| 15 | M4 验收补测记录 | 1000 次补测，账目自洽 |
| 16 | 数据落地与商业化设计 | 39 寄存器 ↔ 39 DB 字段、四层校验、商业价值 |
| 17 | 参考实现逆向笔记 | 从老师的固件里反推出的上报格式与配置页 |
| 19 | PlatformIO core 选型决策 | 为什么从 2.0.17 换到 pioarduino 3.3.11 |
| 20 | 工具链国内镜像与离线安装 | 网络受限时怎么装 PIO |
| 25 | 168h 测试报告 | **仅模板**，等长跑结果填 |

### C 类 · 评审与建议（**历史意见**，已被采纳或否决）

| # | 文件 | 一句话 |
| --- | --- | --- |
| 02 | 任务书 v0.1 技术审查（Codex） | 第一轮外部挑错 |
| 02b | 任务书 v0.2 复查报告 | 第二轮 |
| 12 | 全仓库审查报告（Codex） | 2026-10-03 全仓挑错（含凭据泄露发现） |
| 18 | 接手体检与优化建议 | 砚青接手时的体检，**建议稿**，已拍板部分另见 `PROGRESS` §8 |

### 缺号

`09`（成本对比）、`10`（验收结项）**尚未写** —— S5 交付阶段的两份必需文档。

---

## 3. 三种找东西的方式

| 你知道什么 | 怎么找 |
| --- | --- |
| **想做什么事** | `00` 号文 §3（阶段表）→ 或本文件 §2 按类跳 |
| **记得文件名/编号** | 直接开，`01`~`30` 无重号 |
| **只记得现象/关键词** | 全局搜：`grep -r "关键词" 02_docs/`，或先看 `28_系统全链路说明.md` 的故障定位树 |

---

## 4. 这里找不到什么

| 想找 | 去哪 |
| --- | --- |
| 代码 | `01_firmware/` |
| 原始日志 / 证据 | `03_logs/`（不入库） |
| 测试脚本 / 操作卡 | `06_tests/` |
| 协议原件 / 字段字典 / 接线 / 图纸 | `05_hardware/` |
| 给 AI 的指令 | `04_ai_prompts/` |
| 最新进度 / 决策时间线 | `PROGRESS.md` |
