jiangtao-ml/ESP32_C3_Gateway/04_ai_prompts/README.md

# 04_ai_prompts —— 给 AI 的指令与上下文包

> 最后更新：2026-10-26 · 砚青（新增本目录说明）
> 上游：`README.md` §0（该读哪三份）

**这里放"给 AI 派活的话"，不放结论。** 结论进 `02_docs/`，过程进 `03_logs/`。

---

## 1. 两类文件，别混

| 类型 | 是什么 | 还能用吗 |
| --- | --- | --- |
| **`00_context.md`** | **项目背景包**：技术事实、口径、红线、约束。派活前先把它附上 | ✅ 常青，持续维护 |
| `01` ~ `10` | **历史指令存档**：当时派给 Codex / Claude 的具体任务书 | 📖 **只作格式参考**，内容已完成 |

> `01`~`10` 是**已执行完**的施工单。留着是为了：① 出下一份时照格式抄；② 复盘"当时怎么要求的"。
> **不要照着旧指令重跑** —— 里面的基线数字、文件路径都可能已变。

---

## 2. 指令存档一览（按时间）

| # | 文件 | 给了谁 | 干了什么 | 结果 |
| --- | --- | --- | --- | --- |
| 01 | `01_Codex提示词_NTP源改造` | Codex | NTP 三源（内网优先 + 公网兜底） | ✅ 已完成 |
| 02 | `02_Codex提示词_NTP同步判定修正` | Codex | "已同步"判定逻辑修正 | ✅ 已完成 |
| 03 | `03_Codex提示词_M5功能码与3段读取` | Codex | `0x03`→`0x04` + 3 段读取 | ✅ M5 通过 |
| 04 | `04_Codex提示词_功能对齐_JSON上报与统计` | Codex | 对齐参考实现：JSON 上行 + 统计 | ✅ 批次 1 |
| 05 | `05_新智能体接手指令_2026-10-06` | **任意接手 AI** | 项目交接包（可整段复制） | 📌 **仍有效**，新人可用 |
| 06 | `06_Codex提示词_批次2_一帧读全与自动降级` | Codex | 一帧读全 39 寄存器 + 失败降级 | ✅ 批次 2 |
| 07 | `07_Codex提示词_批次3_AP与Web配置与NVS` | Codex | 常驻 AP + 配置页 + NVS | ✅ 批次 3 |
| 08 | `08_复核提示词_交付方案` | Claude/Codex | **只挑错不改码**（作者≠验证者） | ✅ 已复核 |
| 09 | `09_复核提示词_固件加固与接收端移植` | Claude/Codex | 固件 4 项加固 + 接收端 12 项 | ✅ 已复核 |
| 10 | `10_Codex提示词_全面审查与优化` | Codex | 固件全面审查（含 12 项禁区） | ✅ 已入库 |

---

## 3. 出下一份指令的规矩（`PROGRESS.md` §2b）

1. **一次只推进一个最小可验证目标** —— 不要把 5 件事塞进一份指令。
2. **写清禁区**：哪几行、哪个函数**不许动**（`10` 号就是范例，列了 12 项禁区）。
3. **要求双模式编译**：`SELFTEST=0` 与 `=1` 都要 0 error。
4. **作者 ≠ 验证者**：让 A 写、B 复核，复核指令**明确写"不要改代码，只挑错"**。
5. **不确定的标 `[待确认]`**，**禁止发明协议或寄存器**。

---

## 4. ⚠️ 一处口径冲突（已登记，未改原文）

`00_context.md` 头部写「本文件仍是**唯一事实来源**，与 `PROGRESS.md` 冲突时以本文件为准」。

**该说法已不准确**（`02_docs/00_阶段与门禁主控表.md` §2 已更正）：
现在需求以 `02_docs/21` 为准、判据以 `02_docs/24` 为准、进度以 `PROGRESS.md` 为准；
`00_context.md` 的角色是**给 AI 的背景包**。

> 未直接改 `00_context.md` 的原因：它属**最严档**（定点修正 + 逐处留痕 + 挂 §8）。
> 读到头部那句时，按本节口径理解。要正式改，走最严档流程。

---

## 5. 这里找不到什么

| 想找 | 去哪 |
| --- | --- |
| 需求 / 方案 / 判据 | `02_docs/21` · `22` · `24` |
| 进度 / 决策留痕 | `PROGRESS.md` |
| 代码 | `01_firmware/` |
| 测试脚本 | `06_tests/` |
