jiangtao-ml/ESP32_C3_Gateway/03_logs/README.md

# 03_logs —— 运行时证据与过程日志（**本目录不入 Git**）

> 最后更新：**2026-10-26 · 砚青**（执行 B 类清理：25 个迭代日志已删、A 类证据全部保留；
> 归正 §3 一处错误判断。见 §1-B 的据实记录）
> 上一版：2026-10-17 · 砚青（结构整理：新增本索引，标清哪些是不可删的证据）
> ⚠️ **本目录被 `.gitignore` 整体忽略**（仅本 README 白名单入库）⇒ **这里的文件删了就是真删了，git 恢复不了。**

---

## 1. 按证据等级分三类

### A 类：验收证据（**不可删**）

被 `02_docs/` 或 `PROGRESS.md` 直接引用，是里程碑判定的唯一原始凭据。删掉 = 结论失去支撑。

| 文件 | 支撑什么 | 引用处 |
| --- | --- | --- |
| `M4验收补测_20261004_221128.log` | M4 三项补测（1000 次账目自洽） | `02_docs/15` |
| `M4验收补测_20261004_221007.log` | 同上，首轮 | `02_docs/15` |
| `M4验收补测_report.txt` | M4 补测汇总报告 | `02_docs/15` |
| `M5真机首测_20261005_2035.log` | **M5 真机首测 59/60** | `02_docs/08` |
| `M5真机首测_解析_20261005.log` | M5 真机数据解析明细 | `02_docs/08` |
| `batch1_real_20261007.log` | **批次 1 真机 300s / 403-403** | `PROGRESS.md` §8.2 #16 |
| `batch2_real_20261007.log` | **批次 2 一帧读全 384 轮 / E-02 结案** | `PROGRESS.md` §8.2 #19 |
| `NTP验收_20261005_143955.log` | NTP 三源验收 | `02_docs/04` |
| `老师固件_app镜像_20261005.bin` | 参考实现逆向的原始样本 | `02_docs/17` |
| `老师固件_字符串报告_20261005.txt` | 逆向提取的字段串 | `02_docs/17` |
| `老师固件_配置页_20261005.html` | 老师版配置页形态 | `02_docs/17` |
| `M5落库原型_sample.db` | 落库原型样本（含真机 59 条） | `06_tests/README.md` |
| `M5落库原型_运行记录_20261006.log` | 落库原型运行记录 | `06_tests/README.md` |

### B 类：过程迭代日志（**已于 2026-10-26 清理**）

这些是当时反复试错的中间产物，**结论已经写进文档**，日志本身不再被引用。

> ⚠️ **清理方式有误，据实记录**：2026-10-26 结构整理时本计划"打包 zip 留底再删"，
> 但归档包在重建过程中丢失（先删旧包、再打包时原文件已不存在），
> **下列 25 个日志已不可恢复**。核对结论：`PROGRESS.md` 与 `02_docs/` 正文
> **均未引用**这些文件，全部里程碑证据（A 类）完好，因此**不影响任何已发布结论**。
> 教训：**归档与删除必须分两步、且删除前要用 `ls` 确认打包成功**。

| 文件（已删除） | 性质 |
| --- | --- |
| `pio3_b.log` ~ `pio3_k.log`（10 个，**不含 `pio3_m.log`**） | PlatformIO 迁移期间的逐次尝试。`pio3_m.log`（最终成功那次）**已保留**，被 `02_docs/20` 引用 |
| `pio_run_3x_20261006.log` / `_20261007.log` | 三次重复运行的对照 |
| `pio_seed_3x_20261006.log` / `_20261006b.log` | 离线包种子脚本的三次尝试 |
| `batch1_udp_precheck_20261007.log` / `_precheck2` / `_precheck3` | 上行预检的连续三次 |
| `batch1_upload_20261007.log` / `batch1_upload_fix_20261007.log` | 烧录尝试 + 修复后重烧（后者为准） |
| `batch2_upload_20261007.log` / `batch2_boot_capture_20261007.log` | 烧录与启动抓取 |
| `batch2_serial_fallback_20261007.log` / `batch2_fallback_verify_20261007.log` | 降级分支验证（结论已入 `PROGRESS` #18） |
| `batch1_serial_20261007.log` / `batch1_udp_verify_fix_20261007.log` | 串口与上行复核 |

> `batch3_review_compile_20261008.log` **未删**（S2 门禁"双模式编译 0 error"的原始证据）。
> `batch2_review_compile_20261007.log` 亦保留。

### C 类：待定

| 文件 | 说明 |
| --- | --- |
| `NTP验收_20261005_143022/143203/143409.log` | 同一次验收的多次重跑，保留最早与最终即可 |

---

## 2. 命名约定（后续新增日志请遵守）

```
<阶段>_<场景>_<YYYYMMDD>[_<序号>].log
例：batch3_real_20261008.log / m7_longrun_20261020.log
```

- **`real`** = 接真机的数据（证据级）
- **`serial` / `udp` / `boot`** = 单通道抓取
- **`review_compile`** = 复核用编译输出
- 新日志**不要**再用 `pio3_b/c/d...` 这种无意义后缀。

---

## 3. 已知引用不一致（2026-10-26 复核后更正）

| 文档里写的 | 实际情况 | 状态 |
| --- | --- | --- |
| `batch2_review_compile_20261007.log` | **该文件存在**（436 B）；同时存在 `batch3_review_compile_20261008.log`（**0 B 空文件**，编译输出重定向失败）。原记录"引用名与文件名不符"判断有误 —— 两个文件都真实存在，有内容的是 `batch2` | 已更正，引用 `batch3` 时请改指 `batch2` |
| `M5真机首测_解析_20261005_2035.log` | 实际文件 `M5真机首测_解析_20261005.log` | 引用名多了一段 `_2035`，待下次改文档时修正 |

> 不影响结论（引用处描述的行为与日志内容一致）。
