jiangtao-ml/ESP32_C3_Gateway/02_docs/27_评审与风险登记册.md

# 27 · 评审记录与风险登记册

| 项 | 内容 |
| --- | --- |
| 文档 | `02_docs/27_评审与风险登记册.md` |
| 版本 | v1.0 / 2026-10-22 |
| 作者 | 砚青（WorkBuddy） |
| 作用 | 两张**活的**登记表：① 谁审过什么、审出几条、怎么关闭；② 当前未闭环事项的唯一台账 |
| 上位 | `02_docs/00_阶段与门禁主控表.md`（横向过程 · 质量保证 / 风险管理） |

> **规则**：评审结论只有三种 —— `通过` / `有条件通过`（附遗留项） / `不通过`。
> **不许写"基本没问题"**：那等于没审。
> 风险/待确认项**只在这里编目**，别处（`21 §9`、`PROGRESS §8.1`、`26 §4`）保持原编号，本表只引用不复制，避免出现第二份事实。

---

## 1. 评审记录

| # | 日期 | 对象 | 评审人 | 发现 | 结论 | 遗留 / 关闭 |
| --- | --- | --- | --- | --- | --- | --- |
| RV-01 | 2026-10-03 | 任务书 v0.2 | Codex | 10 点（见 `02`） | 有条件通过 | 已并入 v0.2.1（`02b` 复查） |
| RV-02 | 2026-10-04 | 任务书 v0.2.1 | WorkBuddy | 三处口径 | 通过 | — |
| RV-03 | 2026-10-06 | 全仓库 | Codex（`12`） | 4 类问题 | 有条件通过 | 已逐条处置 |
| RV-04 | 2026-10-06 | 交接体检 | 砚青（`18`） | 6 项 + 优化建议 | 有条件通过 | 部分转入 `PROGRESS §8.1` |
| RV-05 | 2026-10-15 | `21`/`22` 交付方案 | **未执行**（`08` 提示词已产出但未转交） | — | — | ⏸ **待执行** |
| RV-06 | 2026-10-21 | 固件 4 项加固（砚青写） | **无法自审** → 交 Codex 反向审查 | Codex 指出 `write()` 返回值判据无效（属真错） | 有条件通过 | 已改；砚青复核定案（`PROGRESS §8.2 #36`） |
| RV-07 | 2026-10-21 | Codex 固件改动 | 砚青 | 12 项禁区 0 触碰；注释预算算错（512 vs 392）；`SERIAL_VERBOSE_ROUND=0` 影响台面脚本 | 通过 | 注释已修；脚本影响已记入 `§2 R-07` |
| RV-08 | 2026-10-22 | 级别定档 L1（`26`） | 用户裁定 | 4 项明确不做 | 通过 | — |

**待补的评审**

| # | 对象 | 谁审 | 为什么必须审 |
| --- | --- | --- | --- |
| RV-09 | 接收端 `udp_collect.py`（1991 行，含 12 项改动） | 未指定（Codex 或同学） | 改动量大且直接影响验收数据，目前只有作者自检 |
| RV-10 | `24` 的 34 条判定 + `00` 本表 | 导师 | 判据口径一旦定错，168h 白跑 |

---

## 2. 风险与待确认登记册（**未闭环事项唯一台账**）

> 编号沿用原文档：`D-xx` = `21 §9` 三方差异；`R-xx` = 新登记。状态只有 `开放 / 缓解中 / 关闭`。

| 编号 | 事项 | 类别 | 影响 | 状态 | 处置 / 谁定 | 卡住什么 |
| --- | --- | --- | --- | --- | --- | --- |
| **D-03** | `quality:"00"` 编码含义未知 | 接口 | 与老师接收端不兼容 | 开放 | 问老师 | S5 结项 |
| **D-05** | `queue`/`dropped` 恒 0 | 接口 | ~~字段无意义、易误读~~ → **2026-10-27 已改为 `null`，风险消除** | **已缓解** | 老师/自定（仅 `/status` 部分待定） | S5 |
| **D-07** | 固件同时发工程量与 raw | 设计原则 | 与"只搬运原始值"冲突 | 开放 | 用户/导师 | S5 |
| **D-08** | 抖动判据（±50 ms）vs 秒级时间戳 | 判据 | M11/M12 解释力 | 缓解中 | 已用 M11 替代并备案 | S4 报告 |
| **D-10** | 电量公式另一种解差 1000 倍 | 数据 | ~~电量是否可验收~~ → 已定案，风险降为"待现场示数确认" | **已缓解**（`02_docs/31`） | 砚青依真机 raw 定案 + 用户现场确认 | S4/S5 |
| **R-01** | 无隔离 + 无 TVS | 安全 | 可烧电脑主板 / 打穿模块 | 缓解中 | `26 §4` 操作约束（拔 USB、断续电、只在受控室内） | 每次施工 |
| **R-02** | ~~无看门狗~~ → **2026-11-04 关闭**：`FW_WDT_ENABLE=1`（60 s）+ 台面注入实测 **75.2 s 触发 `TASK_WDT` 并自动重启**，复位原因可读 | 可靠性 | ~~固件卡死需人工断电~~ → 已自愈 | **关闭** | 砚青（`02_docs/30` §4 台架 4 项） | — |
| **R-03** | 洞洞板直焊不可拆 | 工艺 | 焊错只能拆焊 | 缓解中 | 图纸签核 + M1–M17 电检 | S1→S2 |
| **R-04** | `meter_record` 秒级主键会顶掉同秒行 | 数据 | 少量行不入库（原始包仍在） | 开放 | 决策：是否加宽主键 | S4 数据完整性 |
| **R-05** | 2% 大包丢失原因未定 | 数据 | M2 余量仅 2 个点 | 开放 | 8h + pcap + 内核计数归因 | S4 |
| **R-06** | 固件改动未过独立复核签字 | 质量 | 违反"作者≠验证者" | 缓解中 | RV-06/RV-07 已补，仍缺第三人签字 | S2 出口 |
| **R-07** | `SERIAL_VERBOSE_ROUND=0` 使台面脚本 grep 锚点消失 | 工具 | `m4_accept.py`/`m5_parse.py` 失效 | 开放 | 台面用时临时改 1（`config.h` 已注明） | S3 台面 |
| **R-08** | 旧 Ubuntu 机性能未知 | 环境 | 抖动 p99 可能超 50 ms | 开放 | 换机后重测基线，不沿用旧阈值 | S4 |
| **R-09** | 168h 供电靠 5V 适配器，无 UPS | 环境 | 一次断电就要重跑 | 缓解中 | 每日备份 + 断点续跑 | S4 |
| **R-10** | **M3 96.15% vs 验收 99%，差 2.85 pp** | 交付 | 商业化验收硬指标；且 50 ms 包间隔建模上限只有 **98.55%** ⇒ 调参救不回来 | **关闭**（2026-11-04） | 用户拍板双条件口径 + **复算通过**：C-a = **99.5678%**（6 个真·完整夜）≥99% ⇒ Y-2 判 **P**；C-b 96.15% 归档并列。详见 `02_docs/32` §8.6 / §8.6.2 | — |
| **R-13** | 若需**真达标**（甲方不接受双条件口径） | 交付 | 只能改环境：有线回传 / 独立 AP / 专网；改固件无效 | 开放（备选方案） | 导师/用户定；**成本与工期需重估** | S5 结项 |
| **R-11** | 长黑洞：~450 段 ≥3 秒、约 **4,700 行** | 数据 | 这些行**任何包间隔都救不回来**（不是调度问题，是空口断连） | 开放 | 归因需 pcap / AP 侧日志；当前只能标"环境" | S4 报告 |
| **R-12** | Y-4 时钟钳位证据链在 168h 库中不可得 | 证据 | 本轮只能记"未验证"，不能记 P | **已缓解** | 已加 `clk_hold/clk_back/boot/reset_reason` 四列（`06_tests` v1.13），下一轮 24h 全程实证 | S4 报告 |

**登记规则**：新增风险必须给"影响 + 谁能定 + 卡住哪个阶段"。**没有归属人的风险条目等于没登记**。

---

## 3. 变更记录

| 版本 | 日期 | 作者 | 变更内容 |
| --- | --- | --- | --- |
| v1.0 | 2026-10-22 | 砚青 | 首版。补两张横向登记表：评审记录 8 条（含 1 条"未执行"、1 条"无法自审"）+ 待补 2 条；风险台账 14 条（引用 `21 §9` 原编号，不复制内容）。触发：`00` 主控表指出"质量保证与风险管理只有口头、无记录"。 |
| v1.1 | 2026-11-04 | 砚青 | 168h 收官后更新：**关闭 R-02**（看门狗已实测 `TASK_WDT` 75.2 s 触发自愈）；**新增 R-10/R-11/R-12** —— R-10 是本次最重的交付风险（**M3 96.15% 距 99% 差 2.85 pp，而 50 ms 间隔上限仅 98.55%，调参救不回来**，必须由导师/用户裁定"改口径还是改环境"）；R-11 记 ≥3 秒长黑洞约 4,700 行（间隔无解）；R-12 记 Y-4 证据链缺口（已加四列缓解）。触发：旧电脑回传 50 ms 建模三界后发现"即便最乐观也到不了 99%"。 |
| v1.2 | 2026-11-04 | 砚青 | **R-10 由"开放（最高优先）"改为"已裁定（口径）"**：用户拍板双条件口径（受控窗口 22:00–08:00 ≥99% + 全天值并报），裁定全文 `02_docs/32` §8.6。**新增 R-13** 兜住反面情形 —— 若甲方不接受双条件、非要真达标，只能改环境（有线/独立 AP/专网），**成本与工期需重估**，改固件无效。⚠️ R-10 保留**可错条件**：夜间段复算 <99% 则裁定作废、回落 F。 |
| v1.3 | 2026-11-04 | 砚青 | **R-10 → 关闭**：复算通过，C-a = **99.5678%** ≥99%（6 个真·完整 10 h 夜；宽松含残段夜 99.6194%）⇒ Y-2 判 **P**，可错条件未触发。R-11（≥3 秒长黑洞）与 R-13（甲方要真达标）仍开放。 |
