jiangtao-ml/ESP32_C3_Gateway/04_ai_prompts/16_M3夜间窗口复算指令_2026-11-04.md

# 16 · M3 夜间窗口复算指令（2026-11-04）

> 执令人：砚青（主控）｜执行方：旧电脑（Win10，`172.16.0.138`）
> 前置：168h 已收官，`run168h.db` 已归档（1,157,976 包）
> 目的：**为 M3 双条件口径补齐 C-a 判据值**（受控窗口 22:00–08:00 的 M3）

---

## 0. 一句话

用户已拍板：`M3 ≥99%` **不再作为单一硬门槛**，改成两条并列——
**C-a 系统能力** = 受控窗口 `22:00–08:00`（完整 10 小时）内 M3 ≥99%（**这才判 P/F**）；
**C-b 环境实测** = 全天 M3 照实报（96.15%，归档，不判 F）。

现在缺的就是 **C-a 的值**。8h 门控那轮跑出过 `99.9859%`，但那是**另一份固件**（`0.6.0-batch3`）——
**不能替代**，必须从 168h 这份库（`0.7.0-batch4`）里自己算出来。

裁定全文见 `02_docs/32` §8.6；决策留痕 `PROGRESS.md` §8.2 #44。

---

## 1. 三条铁律（**违反任何一条，归档作废**）

1. **只读。** 脚本以 `mode=ro` 打开数据库，物理上写不进去。**不要**改成可写连接。
2. **禁止在 `run168h.db` 上跑新版 `udp_collect.py --repair` 或 `--verify-raw`。**
   新版脚本（v1.13）的 `init_schema` 会给 `udp_packet` 补 4 列（`clk_hold/clk_back/boot/reset_reason`），
   这是 `ALTER TABLE` ⇒ **归档库 schema 与文件 sha256 都会变**，档案就废了。
   要跑诊断，先 `copy` 一份副本再跑。
   > `--report-only` 不受影响（它在 `open_db` 之前就返回，不碰 schema），仍可放心用。
3. **不要重启采集进程、不要动板子。** 本轮只是事后复算，与设备无关。

---

## 2. 执行步骤

### 2.1 放脚本

把本目录的 **`16_m3_night.py`** 拷到 `run168h.db` 所在目录（或任意目录都行，路径用参数传）。

```bat
cd /d D:\esp32_run

python 16_m3_night.py run168h.db
```

> 若你的库不叫 `run168h.db`，换成实际名字。**带上完整路径也可以。**

### 2.2 看输出

跑完会打印摘要，并写三个文件到**库所在目录**：

| 文件 | 内容 |
|---|---|
| `m3_summary.txt` | 摘要（= 控制台输出，直接回传这个最省事） |
| `m3_by_night.csv` | 逐夜：起止时刻、覆盖小时数、收到/发送行数、M3、是否完整 |
| `m3_by_hour.csv` | 逐小时：`rx_rows` / `tx_rows` / `m3_pct` / `note` |

### 2.3 回传

**只需要回传 `m3_summary.txt` + `m3_by_night.csv` 两个文件**（`m3_by_hour.csv` 有 168+ 行，
控制台摘要里的"最差/最好小时"已经够用，除非主控另要）。

---

## 3. 判定规则（主控判，这里先写清，避免来回）

脚本会直接打印结论，但**以主控复核为准**。规则：

| 情形 | 判 |
|---|---|
| 完整夜合计 M3 **≥99%** | **C-a 成立** ⇒ Y-2 判 **P**，168h 收官判定定稿 |
| 完整夜合计 M3 **<99%** | **C-a 不成立** ⇒ **裁定作废**，Y-2 回落 **F**，需重新讨论口径 |
| 完整夜 < 3 个 | 样本不足 ⇒ 主控另议（按 168h 应能拿到 7 个完整夜） |

**「完整夜」的定义（脚本已内置，不要手工放宽）**：
`22:00–07:59` 这 **10 个时钟小时全都有心跳**，**且首包不晚于 22:05、末包不早于 07:55**，
且该夜内 `udp_tx` **没有回落**（回落 = 固件重启）。
首尾残段（起跑当天 22:45 才开跑、收尾当天 22:44 就停）**必须剔除** ——
这是**事先定好的规则**，不是"挑好看的"。

> **v2 补充（2026-11-04 15:5x）**：v1 只判"10 个时钟小时都有心跳"，抓不到"22 点只有 16 分钟"
> 这种情况（168h 起跑夜就是）。实测该夜 `tx = 66,684 行 = 33,342 秒 = 9.26 h`，比 10 h 缺 44 分钟。
> v2 已补首末包时刻校验，该夜会被正确判为 `PARTIAL_START`。

> ⚠️ **不许做的事**：如果某个完整夜算出来偏低，**不能**改成"只取该夜 23:00–06:00"
> 或"剔除某几个小时"。窗口一旦二次收缩，本裁定立刻失去全部证明力（详见 `02_docs/32` §8.6.1）。

---

## 4. 指标口径（为什么这么算）

```
M3 = 去重收到行 / 应唯一发送行
  分子：COUNT(DISTINCT device_id|epoch_id|seq)，ptype ∈ {data, hb, err}
        —— 重包不能算两次送达
  分母：Δudp_tx + 1
        —— 固件心跳里的 udp_tx 是「发送这一行之前」的累计值，
           所以窗口内真实发出行数 = 末条 udp_tx − 首条 udp_tx + 1
```

**逐小时值只用于看趋势，不参与判据**：它的分母取"该小时首条/末条**收到的**心跳"，
若该小时开头有成片丢包，首条心跳会偏晚 ⇒ 分母偏小 ⇒ M3 偏乐观。
整夜值把边缘效应摊到约 3.6 万行上（≈0.005%），才够格当判据。

---

## 5. 脚本已自测（两个方向都验过）

用合成库（丢包率已知）跑过：

| 合成条件 | 完整夜合计 | 脚本判定 | 对不对 |
|---|---|---|---|
| 两夜分别丢 1% / 3% | 98.0409% | 不成立 | ✅ |
| 两夜都丢 1% | 99.0248% | 成立 | ✅ |
| 起跑残段（22:44 起）+ 完整两夜 + 白天中途重启 | 99.0248%（只算两完整夜） | 成立 | ✅ |

并验证了：起跑前的残段夜被正确标 `PARTIAL_START` 并剔除；整夜值与设计值只差 0.02–0.06 pp。

**v2 修的三处（都来自旧电脑在 168h 真库上的实跑反馈）**：

1. **C-b 分母跨世代失效（真 bug）**：原实现用「全库末条 `udp_tx` − 首条 + 1」，
   而固件重启会把 `g_udpTx` 归零 ⇒ 一次重启就吃掉前面全部增量。
   168h 里 10-29 有 3 次重启，导致 C-b 被算成 **131.66%**（收到比发出还多，物理不可能）。
   v2 改为**按 `epoch_id` 分段求和**，并检测段内单调性（段内有回落就告警）。
2. **「完整夜」判据不严**：只判"10 个时钟小时都有心跳"，抓不到起跑夜 22 点只有 16 分钟。
   v2 补首包 ≤22:05 / 末包 ≥07:55 校验。
3. **逐小时异常值未过滤**：出现 `M3 = 160%` 这种数（`rx > tx`）。v2 标 `RX_GT_TX` 并排除。

---

## 6. 可能出问题的地方

| 现象 | 原因 | 怎么办 |
|---|---|---|
| `unable to open database file` | 路径不对 / 库被别的进程独占 | 用绝对路径；关掉正在跑的采集进程 |
| 完整夜只有 1–2 个 | 起跑/收尾残段被剔除是正常的；若明显偏少，看 `m3_by_night.csv` 的 `hours_seen` | 把 CSV 回传，主控判 |
| 某夜 `note` 出现 `REBOOT_IN_NIGHT` | 该夜内固件重启过，`udp_tx` 归零 ⇒ 增量不可算 | 该夜自动不参与 C-a；168h 里预期最多 3 次重启 ⇒ 最多影响 2–3 个夜 |
| 数字与 96.15% 差很远 | 正常。96.15% 是**全天**（含 14 个白天小时），C-a 只算夜间 | 不用管 |

---

## 7. 回传后主控会做什么

1. 复核 `m3_by_night.csv` 的完整性判定（有无被误剔除的夜）；
2. 把 C-a 值写进 `02_docs/32` §8.6.2 与 §8.5 判定表；
3. Y-2 定稿 ⇒ 34 条判定全部落定 ⇒ 出 `02_docs/25` 的 168h 正式报告。

---

> 变更记录
>
> | 日期 | 作者 | 变更 |
> |---|---|---|
> | 2026-11-04 | 砚青 | 新建。起因：用户拍板 M3 双条件口径，C-a 需从 168h 库复算；同时警告"新版 `--repair`/`--verify-raw` 会 ALTER 归档库"这一此前未注意的风险 |
