jiangtao-ml/ESP32_C3_Gateway/02_docs/22_实现与交付方案.md

# 22 · 实现与交付方案（M6 → M7 结项闭环）

| 项 | 内容 |
| --- | --- |
| 文档 | `02_docs/22_实现与交付方案.md` |
| 版本 | v1.1 |
| 日期 | 2026-10-15 成稿 / **2026-10-17 落地校准** |
| 作者 | 砚青（WorkBuddy） |
| 触发 | 导师明确「项目需真正落地并达到可验收的完整程度」；要求给出实现与交付方案 |
| 需求基线 | `02_docs/21_需求规格说明书.md`（本文所有需求编号引用它） |
| 判据来源 | `02_docs/01_项目任务书.md` §9、§11.3；`PROGRESS.md` §8.2 |
| 状态 | v1.1 待复核（作者 ≠ 验证者）；**§2.10 为落地实测校准，与正文冲突时以 §2.10 为准** |

---

## 0. 摘要与索引

**一句话**：当前系统**满足任务书 M0–M6，不满足 M7**。缺的不是功能，是**证据**——168 小时的数据链、可复算的统计口径、可回答的加密结论。

| 用户问的 | 本文哪章 | 交付物 | 验收判据 |
| --- | --- | --- | --- |
| 一、需求分析文档 | 见 `21_需求规格说明书.md` | 需求基线 + 差异清单 + 追溯矩阵 | 任取一条需求可定位到代码行与验证方法 |
| 二、168h 接收程序 | §2 | `06_tests/udp_collect.py` + 6 张表 | 168h 不中断、可复算、断电可恢复 |
| 三、收集率 / 丢包率 / 重包率 | §3 | 指标定义表 M1–M18 + 报告模板 | 三口径齐全、数值可复算到 SQL |
| 四、明文 vs 加密 | §4 | AES-128-GCM 可选通道 + A/B 对照表 | 解密失败 0、不触发分片、结论不越界 |
| 五、遗漏的关键方面 | §5（14 项） | 环境/异常/校验/性能/运维/归档 | 逐项有落地要点 + 验收标准 |
| 总验收 | §6 | 168h 判据表（13 条） | 全部通过 = M7 可判 |

**三条贯穿全文的纪律**：

1. **不预填未实测的数字。** 所有百分率在实测前写 `[待实测]`。目前唯一可引用的实测基线是 M6 的 900s：采集 100%、送达 99.9%（1800 包丢 2）。**900s 的数字不得外推成 168h 结论。**
   〔**2026-10-21 更正**：复核原始数据后，M6 实为 seq 145–1945 应有 1801 行、实收 1782 行，**缺 19 行**（18 条数据行 + 1 条心跳）⇒ 数据行送达 **882/900 = 98.0%**，"丢 2 / 99.9%"两处均不成立。**M2 阈值 96% 只剩约 2 个点余量**，故新增 8h 门控（见 `02_docs/24` §3.5）。详见 `PROGRESS.md §8.2 #33`。〕
2. **判据只认全程。** 168h 允许事后做诊断性拆分（如剔除链路不可用时段），但**不得用拆分后的数字替代主判据**。
   〔**2026-11-04 例外（唯一一次，决策类）**：M3 判据由单一"全程 ≥99%"改为**双条件**——C-a 受控窗口（22:00–08:00 完整 10 h）≥99% 判 P/F，C-b 全天值**同时报出但不判 F**。之所以不违反本条：本条的防范对象是**事后择优**（跑完发现不达标再挑一段好看的顶上去），而本次是**判据定义的前置变更**（在第二轮数据产出之前由用户裁定），窗口按"外部干扰可归因"的物理理由预先固定、不允许二次挑选，且全天值不得隐去。**同一逻辑不得类推到其他指标**；M2 仍认全程。裁定全文见 `02_docs/32` §8.6，挂 `PROGRESS.md` §8.2 #44。〕
3. **作者 ≠ 验证者。** 本文由砚青编写，须经 Claude/Codex 独立复核（`04_ai_prompts/08_复核提示词_交付方案.md`）。

---

## 1. 需求基线结论（承接 21）

| 结论 | 依据 |
| --- | --- |
| 固件功能完整度：18 条 FR 中 15 条已验证、2 条部分验证、1 条单侧验证 | 21 §10 |
| **最长连续运行 900s**，168h 从未验证 | `PROGRESS.md` §8.2 #26 |
| 现有 PC 工具**不可用于长跑**：`udp_listen.py` 只打印，`db_proto.py` 不认 JSON | 21 §1、`06_tests/` 实读 |
| 统计口径**未定义**，三个"成功率"会给出三个不同数字 | 21 §9 D-02 |
| 安全口子 4 个未收紧 | 21 §11 G-05/G-06 |
| 文档滞后：`PROGRESS.md` §3 仍写 M6 未开始 | 21 §9 D-11 |

**因此 M7 的工作不是写新功能，是补三件事：可跑 7 天的接收端、可复算的口径、可解释的安全结论。**

---

## 2. 168 小时连续采集接收程序

### 2.1 为什么现有工具不能直接用

| 工具 | 能做到 | 缺什么 |
| --- | --- | --- |
| `udp_listen.py` | 收包、打印、按源 IP 计数 | 无 JSON 解析、无落盘、无 seq 连续性、无统计 |
| `db_proto.py` | 字典驱动解析、四层校验、幂等入库 SQLite | **只认旧文本格式，不认 JSON 上行** |
| `m5_parse.py` | 39 字段表驱动换算 | 面向 HEX 文本，非 JSON |
| `.workbuddy/tmp/*.py` | 一次性解析 M6 数据 | 临时脚本、未入库、无长跑能力 |

结论：**新建 `06_tests/udp_collect.py`，复用 `db_proto.py` 的解析与入库函数，不重写。**

### 2.2 进程模型：3 线程 + 2 队列

```
┌──────────────┐   q_pkt (maxsize=20000)   ┌──────────────┐
│ T1 收包线程   │ ───────────────────────► │ T2 落库线程   │ ── SQLite (WAL)
│ recvfrom     │                          │ 批量 UPSERT  │
└──────┬───────┘                          └──────┬───────┘
       │ 每包只做：记时 + 解 JSON + 分类            │
       │ 严禁：SQL / print / 文件 I/O              │
       ▼                                          ▼
   内存计数器  ◄──────────────  q_stat (满则丢弃)
                                    │
                            ┌───────▼────────┐
                            │ T3 统计线程     │ 10s 控制台 / 60s 快照
                            │ 只读连接        │
                            └────────────────┘
```

**为什么必须解耦**：一次 Windows Defender 全盘扫描或 WAL checkpoint 就能让 `commit` 阻塞数十秒。若收包与写库同线程，这几十秒内新到的包只能堆在内核缓冲区，**溢出即静默丢包**——而且事后完全看不出来，会被误判成"WiFi 不好"。

| 线程 | 允许 | 严禁 |
| --- | --- | --- |
| T1 收包 | `recvfrom`、`json.loads`、计数器累加、`q_pkt.put_nowait` | 任何 SQL、任何 `print`（控制台写阻塞会传染）、任何文件写 |
| T2 落库 | 单写连接、批量事务、`q_stat.put_nowait` | 网络 I/O |
| T3 统计 | 只读连接（`mode=ro`）、写快照文件 | 写主库 |

**背压策略**：`q_pkt` 满时**不阻塞 T1**，丢弃并累加 `q_drop`，同时记 `QUEUE_FULL` 告警。这是**唯一允许的、可观测的**丢弃点——与内核缓冲静默丢包必须能区分开。

### 2.3 收包层参数（逐条给值）

```python
s = socket.socket(socket.AF_INET, socket.SOCK_DGRAM)
s.setsockopt(socket.SOL_SOCKET, socket.SO_RCVBUF, 1024 * 1024)   # 必须在 bind 前
if hasattr(socket, "SO_EXCLUSIVEADDRUSE"):
    s.setsockopt(socket.SOL_SOCKET, socket.SO_EXCLUSIVEADDRUSE, 1)
s.bind(("0.0.0.0", 8888))
s.settimeout(0.5)
```

| 参数 | 取值 | 理由 |
| --- | --- | --- |
| `SO_RCVBUF` | **1 MiB** | 典型包 1.1 KB ⇒ 约 950 包 ≈ **475 s** 缓冲。Windows 默认 64 KB 只够 29 s |
| 地址复用 | **`SO_EXCLUSIVEADDRUSE`** | Windows 上 `SO_REUSEADDR` 允许第二个进程**静默抢包**（NetAssist 忘了关 = 数据被分走且无报错） |
| 超时 | 0.5 s | 用于响应停止标志；超时不是错误 |
| 单包上限 | 4096 B | 明文最坏 1106 B、密文 1135 B；超出记 `oversize`，不崩溃 |

**异常自恢复**（循环内全部 `continue`，绝不退出）：

| 异常 | 触发场景 | 处理 |
| --- | --- | --- |
| `socket.timeout` | 正常空闲 | 继续 |
| `ConnectionResetError` (10054) | Windows UDP 端口不可达回传 | 继续 + 计数 |
| `OSError` (10040/10022) | 巨型包 / 缓冲不足 | 继续 + 计数 |
| `JSONDecodeError` | 半包、乱码、非本协议流量 | 入 `udp_packet(parse_status='bad_json')`，不污染统计 |
| 其他 | — | 写 traceback 到 `event_log`；连续 100 次才告警 |

**三类行判别**（按字段，不按长度）：

```python
t = obj.get("type")
ptype = "data" if t is None else ("hb" if t == "hb" else ("err" if t == "err" else "unknown"))
```

必填字段校验：`data` 需 `seq,dev,ts,raw,quality`；`hb` 需 `seq,dev,poll_ok,poll_err,udp_tx`；`err` 需 `seq,dev,type,seg,reason`。缺任一 → `parse_status='bad_field'`，保留原文，不参与统计。

### 2.4 解析层：复用 `db_proto.py`

```python
# JSON raw → 39 寄存器 → 复用既有入库
regs_hex = obj["raw"].split()          # 78 个 "AA"
assert len(regs_hex) == 78
db_proto.store(conn, {"ts": ts_db, "hexs": regs_hex, "seg": obj["seg"]},
               device_id, slave_addr=1, src="udp", fields=fields,
               seq=obj["seq"], known_missing={"A_temp","B_temp","C_temp"})
```

| JSON 字段 | 落点 | 规则 |
| --- | --- | --- |
| `ts` | `collect_time` | `T` → 空格；`ts_ok=false` 时用 epoch 锚点换算（`boot_wall + BOOT秒`），并置 `src="udp_boot"` |
| `quality` | `quality` | 直通；**接收端复核**：`quality=OK` 但 `invalid` 非空 ⇒ 记 `quality_conflict`（固件口径 bug 的证据） |
| `invalid` | `invalid_fields` | 逗号串直通，另做字段级频次统计 |
| `seg` | `seg_ok` | `"1"`→`"1"`；`"3"`→`"111"`（沿用 `db_proto.store` 既有约定） |
| `raw` | `raw_hex` | 原样保留 233 字符 |
| `dev`/`mac`/`ip` | 新表 `udp_packet` | `meter_record` 不加列；设备身份由 `device_id` 承载 |

**对 `db_proto.py` 的最小扩展**（向后兼容，不改既有行为）：

1. `store_json(conn, obj, device_id, fields, epoch_id)` —— 封装上面的映射，返回 `("new"|"dup", quality)`。
2. `build_ddl_v2(fields)` —— 给 `meter_record` 增 `epoch_id`，并建 `UNIQUE(device_id, epoch_id, seq)`。

**为什么要加 `epoch_id`**：现主键是 `(device_id, collect_time)`，秒级精度 + 1Hz 周期下，**NTP 回跳 1 秒就会让两条不同轮次撞主键并被 `ON CONFLICT DO UPDATE` 静默覆盖**——一行数据凭空消失且无任何报错。`(device_id, epoch_id, seq)` 才是真正的幂等键。

### 2.5 持久化：6 张表

```sql
-- ① 原始流水（唯一不可再生资源，只增不改）
CREATE TABLE udp_packet (
    id INTEGER PRIMARY KEY AUTOINCREMENT,
    recv_time TEXT NOT NULL,          -- 接收墙钟（含毫秒）
    recv_mono REAL NOT NULL,          -- time.perf_counter()，抗墙钟跳变，用于抖动
    src_ip TEXT, src_port INTEGER,
    dev TEXT, device_id TEXT, seq INTEGER,
    ptype TEXT NOT NULL,              -- data|hb|err|unknown|bad
    payload_len INTEGER, payload BLOB,  -- hb 不存 payload（只存下列字段）
    enc INTEGER DEFAULT 0,
    parse_status TEXT,                -- ok|bad_json|bad_field|decrypt_fail|oversize
    epoch_id INTEGER,
    poll_ok INTEGER, poll_err INTEGER, udp_tx INTEGER,
    rssi INTEGER, free_heap INTEGER, ts_ok INTEGER
);
CREATE INDEX idx_pkt_dev_seq ON udp_packet(device_id, seq);
CREATE INDEX idx_pkt_recv    ON udp_packet(recv_mono);
CREATE INDEX idx_pkt_type    ON udp_packet(ptype, recv_mono);

-- ② 采集会话（一次长跑一行；重启不新建）
CREATE TABLE collect_run (
    run_id INTEGER PRIMARY KEY AUTOINCREMENT,
    started_at TEXT, planned_end TEXT, ended_at TEXT,
    target_hours REAL DEFAULT 168, period_ms INTEGER DEFAULT 1000,
    bin_sha256 TEXT, note TEXT
);

-- ③ 设备启动世代（seq 回退时切分；所有统计的分组单位）
CREATE TABLE device_epoch (
    epoch_id INTEGER PRIMARY KEY AUTOINCREMENT,
    device_id TEXT, seq_first INTEGER, seq_last INTEGER,
    first_recv TEXT, last_recv TEXT,
    poll_ok_at_start INTEGER,
    poll_err_at_start INTEGER,        -- 落地补充：M1 分子分母都要它
    udp_tx_at_start INTEGER,          -- 落地补充：M3 分子分母都要它
    detect TEXT                       -- cold_start|seq_rollback|poll_reset|manual
);

-- ④ 分钟级快照（趋势/告警，不参与最终口径）
CREATE TABLE stat_snapshot (
    ts TEXT PRIMARY KEY, run_id INTEGER, device_id TEXT,
    pkt_rx INTEGER, data_rx INTEGER, hb_rx INTEGER, err_rx INTEGER,
    seq_last INTEGER, lost_lines INTEGER, full_lost_rounds INTEGER,
    data_lost INTEGER, dup INTEGER, q_depth INTEGER, q_drop INTEGER,
    poll_ok_last INTEGER, poll_err_last INTEGER, udp_tx_last INTEGER,
    rssi INTEGER, free_heap INTEGER, db_mb REAL, disk_free_mb REAL
);

-- ⑤ 断点游标
CREATE TABLE ingest_cursor (k TEXT PRIMARY KEY, v TEXT);
-- k = last_packet_id | run_id | last_report_at

-- ⑥ 异常事件（报告"事件表"直接来源于此）
CREATE TABLE event_log (
    id INTEGER PRIMARY KEY AUTOINCREMENT,
    ts TEXT, kind TEXT, severity TEXT, detail TEXT
);
```

> `udp_packet` **不建 `UNIQUE(device_id, seq)`**——重复包必须留下来当证据（重包率是实测指标），去重放在分析期。

**SQLite 参数**：

```python
PRAGMA journal_mode = WAL            -- 读写不互斥
PRAGMA synchronous  = NORMAL         -- 崩溃不损坏；最多丢最后一个事务（该事务数据仍在内存队列）
PRAGMA wal_autocheckpoint = 2000     -- 约 8 MB 一次
PRAGMA journal_size_limit = 67108864 -- WAL 上限 64 MB
PRAGMA busy_timeout = 10000
PRAGMA temp_store = MEMORY
```

**提交策略**：每 **2 s** 或累计 **500 行** 或队列空闲 **>1 s**，三者先到即 commit。168h ≈ 30 万次提交，实测 CPU 占用 `[待实测]`。
**每 6 小时**做一次 `wal_checkpoint(TRUNCATE)`，防止 168h 后留下几百 MB 的 `-wal`。

**写序（不可颠倒）**：先写 `udp_packet` → commit → 再写 `meter_record`。
理由：原始包不可再生，解析结果可再生。解析崩了、字典换版了、口径改了，都能从 `udp_packet` 全量重放。

**存储预算**：168h @1Hz = 604,800 轮 ≈ **121 万包**。心跳不存 payload（只存字段）、数据/err 存全文 ⇒ **约 1.0–1.5 GB**。**预留 ≥10 GB**，并每 60s 检查一次剩余空间。

### 2.6 断点续收与可复算

| 需求 | 做法 |
| --- | --- |
| 进程重启不清零 | 统计**不保存运行时累加值**；控制台数字只是内存快照，报告数字 **100% 由 SQL 从 `udp_packet` 重算** |
| 168h 倒计时跨重启 | `collect_run.started_at` 一经写入不再改动 |
| 断电后补解析 | 启动时读 `ingest_cursor.last_packet_id`，对 `parse_status='ok'` 但 `meter_record` 缺行的记录补入库（`--repair`） |
| 验收复算 | `--report-only` 必须与运行时报告**逐字节一致**（排序键固定 `id`，浮点统一 `%.4f`） |

> "重启后接着统计"不是靠把数字存盘，而是靠**数字本来就能从原始流水重算**。这一条同时解决了断点续收、断电恢复、事后复算三个问题。

### 2.7 可观测性

控制台每 10 s 一行（单行 ≤160 字符）：

```
[09:12:30] up 12:00:00 | rx 43210 (d 21580/h 21600/e 30) | 送达 99.93% | 整轮丢 12/21600 (0.06%)
           | 仅数据丢 3 | dup 0 | seq 43210 | q 0/20000 | db 128MB | disk 42GB | heap 182k | M1 99.87%
```

事件类型（同时写 `event_log` 与滚动日志）：

| kind | 触发 | 级别 |
| --- | --- | --- |
| `BIND_FAIL` | 8888 被占用 | FATAL（退出） |
| `IP_CHANGE` | `src_ip` 与上次不同 | WARN |
| `REBOOT` | seq 回退 + 计数器回退 | WARN |
| `GAP` | 连续 >30 s 无任何包 | ALERT |
| `SILENT_DEATH` | 有包但 seq 停滞 >60 s（WiFi 断） | ALERT |
| `DISK_LOW` | 剩余 <10 GB | ALERT |
| `DECRYPT_FAIL` | 单包解密失败；连续 >10 升 ALERT | WARN |
| `QUEUE_FULL` | `q_pkt` 满 | ALERT |
| `CLOCK_STEP` | `ts` 跳变但到达间隔正常（NTP 步进） | WARN |

日志按 50 MB 滚动、保留 10 个；日志里**不写完整 payload**（会撑爆），只写 `dev/seq/type/len`，原文在 DB。

### 2.8 168h 自动收尾与报告

满 168h：置 `stopping` → 关 socket → 排空 `q_pkt` → 最后一次 commit → `wal_checkpoint(TRUNCATE)` → 生成报告 → 写 `ended_at` → 退出码 0。

**报告结构**（可直接贴进验收文档）：

1. 封面表：设备 / MAC / 固件版本 + bin SHA256 / 起止时间 / 实际时长 / PC 主机名与 IP / DB 路径与大小
2. **核心指标表**（§3.6 的 M1–M18，填实值 + 阈值 + 通过与否）
3. **对账表**：`Δseq / Δudp_tx / ΣΔpoll_ok / ΣΔpoll_err / rx` 五个总量 + 恒等式校验
4. 分时段趋势（每小时一行）
5. 异常事件表（来自 `event_log`）
6. 数据质量分布 + 字段级 NULL 率（`A/B/C_temp` 预期 100% NULL）
7. 加密对比章节（若启用）

### 2.9 第二章验收标准

| # | 判据 | 阈值 |
| --- | --- | --- |
| 1 | 连续运行时长 | ≥168 h，无进程退出 |
| 2 | 进程自身崩溃 | 0 次（Ctrl+C 除外） |
| 3 | 队列溢出丢弃 | 0 包（`q_drop = 0`） |
| 4 | 断电恢复 | 强制断电 3 次，每次重启后库不损坏、`--report-only` 数字与断电前一致 |
| 5 | 复算一致性 | 运行时报告 == `--report-only` 报告（逐字节） |
| 6 | 磁盘 | 全程剩余 ≥10 GB，无 `DISK_LOW` |
| 7 | 单包解析 | `bad_json + bad_field` 占比 ≤0.01% |
| 8 | 30 分钟冒烟 | 先跑 30 min，`poll` 计数与接收行数对账闭合 |

### 2.10 落地校准（2026-10-17，写 `udp_collect.py` 时发现，**以此节为准**）

方案成稿在前、代码落地在后。以下四条是落地时与固件实际行为对不上、或原方案没写透的地方，已按实测修正：

| # | 原方案表述 | 实测/源码事实 | 落地口径 |
| --- | --- | --- | --- |
| 1 | 对账恒等式写作 `2ΔR = R + 未组装 + 发送失败 + 网络丢失` | 每轮必发 1 条 `hb`，成功轮补 `data`、失败轮补 `err`。**只有 `QI_SEND_ERR_ROW=1` 时失败轮也是 2 行**，恒等式才成立（`config.h` L217 当前=1，但编译期可变） | 每轮行数**运行时推断**（有 `err` 包 ⇒ 开；有失败轮却无 `err` 包 ⇒ 关），不写死 2 |
| 2 | `ΣΔudp_tx` 作分母 | `buildHeartbeatJson` 取的是 `g_udpTx`，**自增发生在 `udpSendLine` 之后** ⇒ hb 里带的是"发这一行之前"的值 | 窗口内发出行数 = `Δudp_tx + 1`；窗口取 `[首个 hb, 末个 hb]`，与 `seq` 口径 `seq_N−seq_1+1` 对齐 |
| 3 | M1 = `ΣΔpoll_ok/Σ(Δok+Δerr)` | 世代首包之前无 hb 可差分，`+1` 若只加在分母，M1 系统性偏低（22 轮时差 4.5%，1800 轮时差 0.06%） | 首轮归属由 `seq_first+1` 的 ptype 判定：`data` ⇒ 该轮成功，`err` ⇒ 失败；两者皆缺则**同时从分子分母退出**并计入 `unexpl` |
| 4 | `M3 = ΣR/ΣΔudp_tx` | 重复包让 `Δudp_tx` 多 1 而 `seq` 不变 ⇒ 重包被误算成丢包（冒烟实测 M3 从 100% 被压到 97.7%） | M3 分子用**去重**收到数、分母用 `Δudp_tx − 重复数`（"应唯一发送数"），重复单独进 M8 |

**另有一条既有 schema 限制（不是本接收端的 bug，但必须在验收文档里主动交代）**：

`meter_record` 的主键是 `(device_id, collect_time)`，而 `collect_time` **只到秒**。1 Hz 轮询一旦周期略小于 1 s（固件调度抖动、NTP 步进），就会有两轮落进同一秒 ⇒ 主键只容得下一行，第二轮进不去。任何基于 `db_proto` 的采集端都有此限制。

- **兜底**：`udp_packet` 里**一条原始包都不会少**，主键一旦加宽（改为 `(device_id, epoch_id, seq)`）即可用 `--repair` 全量重放。
- **报告要求**：必须输出「收到数据行 / meter_record 实存 / 差额及成因分解」，**不得只报一个干净的行数**。
- **待办**：主键加宽需改 `db_proto.build_ddl` + `ingest` 的 `ON CONFLICT` 子句 ⇒ 属**决策类**改动，须走「作者≠验证者」复核（见 `PROGRESS.md` §8）。

---

## 3. 数据收集率、丢包率、重包率

### 3.1 必须先承认：这里有三个不同的"成功率"

只报一个数一定会在答辩时被问倒。三个都要报，并说明关系。

| 口径 | 公式 | 度量什么 | 会漏掉什么 |
| --- | --- | --- | --- |
| **M1 采集成功率** | `ΣΔpoll_ok / Σ(Δpoll_ok+Δpoll_err)` | **纯 RS-485 总线**：轮次在 MCU 里跑没跑成功 | 全部网络损失、WiFi 断线期间的轮次 |
| **M2 端到端完整率** | `收到数据行数 / (T_run / 周期)` | **业务视角**：我到底拿到多少条电表数据 | 无法区分"采集失败"与"传输丢失" |
| **M3 传输送达率** | `Σ收到行 / ΣΔudp_tx` | **纯 UDP**：设备交出去的行有多少到了 | WiFi 断线期间未发送的行（分子分母同时剔除） |

**三者关系（写进报告，否则数字对不上会被当成算错）**：

```
M2 ≈ A × M1 × D
  A = 链路可用率 = ΣΔR / (T_run/周期)
  D = 数据行送达率
```

- 老师基线 **96.9%** 是 **M1**（纯总线），与 UDP 一点关系都没有。
- 我们 M6 的 100% 也是 **M1**（900s，975/975）。
- **M2 一定 ≤ M1**，差值就是网络与链路不可用的代价。

### 3.2 四计数器区间对账（本方案的数学核心）

**可行性依据（已逐行核对源码）**：

| 计数器 | 语义 | 递增时机 | 位置 |
| --- | --- | --- | --- |
| `poll_ok` / `poll_err` | 采集轮数 | 每轮进入 `sendUdpPayload` **开头**，**在 WiFi 判断之前** | `.ino` L791-792 |
| `seq` | 已组装行数 | 每个 `build*Json` 内 `++g_seq`，**在 WiFi 判断之后** | L692 / L736 / L759 |
| `udp_tx` | 交给 lwIP 的行数 | `beginPacket` 与 `endPacket` 都返回 1 | L772-783 |

**关键事实**：WiFi 未连接时 `sendUdpPayload` 在 L798 提前 `return`——**`seq` 不增、`udp_tx` 不增，但 `poll_ok/poll_err` 照增**。这让"链路不可用轮数"从猜测变成可计算的差值。

对相邻两个心跳（同一 epoch）：

```
ΔR = Δpoll_ok + Δpoll_err     真实执行轮数
ΔS = seq 增量                 真实组装行数
ΔT = udp_tx 增量              交给 lwIP 的行数
R  = 区间内实际收到并去重的行数

闭合恒等式（逐区间成立，全 run 求和仍成立）：

    2·ΔR = R + 未组装 + 发送失败 + 网络丢失

    未组装   = 2ΔR − ΔS        （WiFi 断 / 缓冲截断）
    发送失败 = ΔS − ΔT          （beginPacket/endPacket 失败）
    网络丢失 = ΔT − R           （发出去了但没到）
```

> ⚠️ **一处必须修正的推导**：初稿曾把 `k = ΔS/ΔR` 判为"必须等于 2，否则该区间作废"。**这是错的**——WiFi 断开时 `ΔS` 本就小于 `2ΔR`，按等式判会把**最该统计的区间全部丢弃**。
> 正确做法：**把 2 当作设计常量**（每轮最多 2 行），只校验 **`ΔS ≤ 2·ΔR`**；`ΔS > 2ΔR` 才是协议异常（宏被改动或 seq 语义变了），该区间标 `EPOCH_ANOMALY` 并排除。

### 3.3 丢包必须四分类

正常轮 seq 为（奇数=心跳，偶数=数据）；失败轮为（奇数=心跳，偶数=err）。据此：

| 类别 | 判定 | 含义 |
| --- | --- | --- |
| **整轮丢失** | 奇数 seq 缺 且 配对偶数 seq 也缺 | 连心跳都没到 ⇒ 链路级丢失 |
| **仅数据行丢失** | 偶数 seq 缺，但同轮 `Δpoll_ok=1` | 心跳到、采集成功、数据行没到 ⇒ **包长敏感**（数据行 892 B vs 心跳 213 B） |
| **仅心跳丢失** | 奇数 seq 缺，偶数到 | 少见，通常伴随乱序 |
| **err 行丢失** | 偶数 seq 缺，但同轮 `Δpoll_err=1` | 失败可见性下降 |

判据优先级：**先看 `Δpoll_ok/Δpoll_err`（累计计数，可靠），再看 seq 缺哪一条**。两者矛盾时以计数器为准并记异常。

> "仅数据行丢失"是本次长跑最值得看的指标：它区分"位错主导"（丢失率 ∝ 包长）与"尾部丢帧主导"（最后发出的大包优先丢）。这直接决定加密对比时"+29 B 包长"会不会有影响。

### 3.4 重包率

```
重包率 = 1 − distinct(device_id, epoch_id, seq) / 收到且 parse_status='ok' 的包数
```

同时报三个衍生物：

| 指标 | 公式 | 用途 |
| --- | --- | --- |
| DB 幂等冲突率 | 命中 `(device_id, epoch_id, seq)` 已存在 / 入库尝试 | 与重包率应同步 |
| 时段撞车率 | 命中 `(device_id, collect_time)` 已存在 / 入库尝试 | **>0 即证明发生过时钟回跳**，是数据被静默覆盖的直接证据 |
| 期望值 | 0 | UDP 单播不重复是理论；必须实测验证 |

> ⚠️ **键里必须带 `epoch_id`**。设备重启后 `seq` 从 1 重来，若用 `(dev, seq)` 去重，**每次重启都会被算成上千个"重复包"**，重包率瞬间爆表。

### 3.5 周期抖动

`ts` 只有秒级（Q-12 裁定不加毫秒），**用它根本算不出 ±50ms**（21 §9 D-08）。改用接收侧单调时钟：

```python
d = perf_counter[i] - perf_counter[i-1]
jitter = d - 1.000
```

**样本筛选（不做则数字无意义）**：

| 剔除 | 理由 |
| --- | --- |
| 跨 epoch | 间隔 = 停机时长 |
| 跨 `CLOCK_STEP` | NTP 步进改变发包节奏 |
| `d > 5 s` | 属"可用性"不属"抖动" |
| **同一轮的两个包**（hb + data 间隔≈0） | 会污染分布 ⇒ **只取同类型相邻包**（心跳序列最佳，因每轮必发） |

**必须写进报告的局限**：测到的是「设备抖动 + WiFi 空口排队 + PC 内核调度 + 线程唤醒」的**合成上界**，**不能**分离出 MCU 内部 `loop()` 抖动。想做设备侧抖动，需固件新增 `loop_ms` 字段（21 §11 G-07，本方案不改）。

### 3.6 指标定义表（直接贴验收文档）

| # | 指标 | 公式 | 分子 / 分母 | 数据来源 | 阈值 |
| --- | --- | --- | --- | --- | --- |
| M1 | 采集成功率 | `ΣΔpoll_ok/Σ(Δok+Δerr)` | 成功轮 / 执行轮 | 心跳差分 | ≥97% |
| M2 | **端到端完整率** | `N_data/(T_run/周期)` | 数据行 / **604800** | `udp_packet` + `collect_run` | **≥96%** |
| M3 | 传输送达率 | `ΣR/ΣΔudp_tx` | 收到行 / 交付行 | 心跳差分 | ≥99% |
| M4 | 行丢失率 | `1 − M3` | 丢失行 / 交付行 | 同上 | ≤1% |
| M5 | 整轮丢失率 | `full_lost/ΣΔR` | 全丢轮 / 执行轮 | seq 配对 | ≤1% |
| M6 | 仅数据行丢失率 | `data_lost/ΣΔpoll_ok` | 缺数据行 / 成功轮 | 心跳 + seq | ≤1% |
| M7 | 仅心跳丢失率 | `hb_lost/ΣΔR` | 缺心跳 / 执行轮 | seq 配对 | ≤1% |
| M8 | **重包率** | `1 − distinct/rx` | 重复 / 总包 | `udp_packet` | ≤0.01% |
| M9 | DB 幂等冲突率 | `conflict/attempts` | — | 入库计数 | ≤0.01% |
| M10 | 时段撞车率 | `t_conflict/attempts` | — | `meter_record` | **0** |
| M11 | 抖动 p99 | `quantile(abs(Δrecv−1s), 0.99)` | — | `recv_mono` | ≤50 ms |
| M12 | 抖动 max | `max(abs(Δrecv−1s))` | — | `recv_mono` | ≤200 ms |
| M13 | 时间戳可信率 | `hb(ts_ok)/hb` | — | 心跳 | ≥99% |
| M14 | 链路可用率 A | `ΣΔR/(T_run/周期)` | — | 心跳 | ≥99% |
| M15 | 设备在线率 | `1 − Σ(gap>60s)/T_run` | — | `recv_mono` | ≥99% |
| M16 | 数据质量 OK 占比 | `count(quality=OK)/N_data` | — | `meter_record` | ≥95% |
| M17 | 单轮耗时 p99 | 心跳 `loop_ms` | — | **需固件加字段** | `[待实测]` |
| M18 | 自恢复时长 | 断网→首个心跳 | — | `event_log` | ≤60 s，各 3 次 |

**M2 分母的选择必须说明**：用 **604800（墙钟理论轮数）** 是验收视角（含设备停机/断网的损失）；若用"固件执行轮数"作分母，得到的是纯传输完整率。两者**同时给出并明确标注**，只给一个会被质疑。

### 3.7 数值呈现规则（硬性）

- 所有百分率在实测前写 **`[待实测]`**，**禁止预填、禁止外推**。
- 目前唯一可引用的实测基线：M6 900s → M1 = 100%（975/975）、UDP 送达 99.9%（1800 丢 2）、`free_heap` 179 KB 稳定。〔**2026-10-21 更正**：送达实为 **98.0%**（882/900 数据行，缺 19 行），见 `PROGRESS.md §8.2 #33`〕
- 报告模板必须包含「本值由哪条 SQL 算出」的备注，确保可复算。

### 3.8 第三章验收标准

| # | 判据 | 阈值 |
| --- | --- | --- |
| 1 | 三口径齐全 | M1/M2/M3 同时给出，且 `M2 ≈ A×M1×D` 偏差 <0.1% |
| 2 | 对账闭合 | `2ΔR = R + 未组装 + 发送失败 + 网络丢失` 逐区间成立 |
| 3 | 丢包四分类 | 四类分别有数，合计 = 总丢失行数 |
| 4 | 引擎可被证伪 | **用构造数据集注入已知数量的四类丢包 + 重启 + 重包 + 时钟回跳，引擎须逐项精确复现** |
| 5 | 可复算 | 报告每个数字都能由一条 SQL 复现 |

> 第 4 条是整章的关键。**一个没有被证伪过的统计引擎，等于没有统计**。构造数据集要手工造 1000 轮，注入：
> 50 轮整轮丢、20 轮仅数据丢、10 轮仅心跳丢、3 次重启、5 个重复包、2 次时钟回跳 —— 要求输出与注入值完全一致。

---

## 4. 明文传输 vs 加密传输对比

### 4.1 先明确加密保护什么（否则会写出过度承诺）

| 威胁 | 明文现状 | AES-128-GCM 后 |
| --- | --- | --- |
| 同网段被动窃听（用电数据 = 用电行为画像） | **完全暴露** | 保护 |
| 伪造 UDP 包注入假数据 | 可任意伪造 | 保护（Tag 验证失败即丢弃） |
| 重放旧包 | 可重放 | **部分**（靠 `seq` 单调性由上层判断，GCM 本身不防） |
| 密钥泄露 | — | **不防** |
| 拒绝服务 / 泛洪 | 不防 | **不防** |
| 配置面攻击（AP 常开、`/status` 免鉴权） | 不防 | **与本项无关**（属 21 §11 G-05/G-06） |

**定性声明（必须原文进报告）**：本加密为**对比实验能力**，采用预共享密钥、无密钥协商、无前向保密、无密钥轮换。**不构成生产级安全方案。**

### 4.2 帧格式

```
偏移   长度    字段
0      1      版本字节：bit7=1 表示加密帧，低 4 位=协议版本(2)
1      12     nonce
13     n      密文（n = 明文 JSON 字节长度，等长）
13+n   16     GCM Tag
──────────────────────────────
总计   n + 29
```

- **AAD** = 版本字节本身（1 B），防版本降级，接收端可独立复现。
- **无需长度字段**：UDP 保留报文边界，`len(payload) − 29` 即明文长度。
- **明文/密文判别**：明文 JSON 首字节恒为 `0x7B`（`{`），密文首字节恒 ≥0x80，**不可能冲突**。
- **MTU 硬约束**：明文最坏 1106 B → 密文 **1135 B**；`1472 − 1135 = 337 B` 余量 ⇒ **不触发 IP 分片**。
  > 这条必须写进报告：一旦分片，任一分片丢失即整包丢失，会凭空把丢包率放大数倍，整个对比结论作废。
- **缓冲**：新增 `QI_ENC_BUF_MAX 1280`，**另开静态缓冲**，不复用 `g_payload`（mbedTLS 输入输出重叠是未定义行为）。

### 4.3 Nonce 构造（否掉一个常见错解）

**错解**：`4B 设备ID + 4B seq + 4B 毫秒计数`。
**为什么不成立**：`seq` 与 `millis()` **在重启时同时归零**。跨两次开机的碰撞条件是"第 N 条报文的 seq 相同且发送毫秒相同"——断电重启后 WiFi 连接耗时高度一致，落在同一毫秒的概率远高于 1/2³²。**毫秒字段对跨重启防重没有任何贡献，是"看起来严谨、实际不设防"。**

**推荐构造（12 B）**：

```
nonce[0..3]  = dev_tag  = CRC32(MAC 字符串) 低 32 位     （设备维度，启动算一次）
nonce[4..7]  = boot_id  = NVS 持久化的开机序号，每次启动读→+1→立即 commit
nonce[8..11] = seq      = g_seq（本行组装后的值）
```

**唯一性三段论证**：

1. **同一 boot 内**：`seq` 每发一行严格 +1 ⇒ 任意两条 `nonce` 不同。
2. **跨 boot**：`boot_id` 持久化且严格单调递增 ⇒ `nonce[4..7]` 不同。
3. **回绕**：`seq` 为 uint32，2 行/s 下需约 **68 年**才回绕；`boot_id` 每次重启 +1，168h 内为个位数。

**失效兜底（fail-closed）**：若启动时 `boot_id` 读回校验失败（Flash 损毁/分区满），置 `enc_ready=false` 并**整体禁用加密、退回明文**——绝不允许用可能重复的 nonce 硬跑。

### 4.4 密钥管理

| 侧 | 存放 | 写入方式 | 纪律 |
| --- | --- | --- | --- |
| 设备 | NVS `cfg485/aes_key`（16 B BLOB） | Web 配置页 POST；**仅当键不存在时允许写** | 页面只显示 `已配置 ****`，**绝不回显** |
| PC | `06_tests/keys.json` | 手工放置，ACL 限当前用户 | **不进 Git**；缺失则拒绝启动加密模式 |

不写 `secrets.h`（会进 Git 历史，与 21 §7 的凭据纪律冲突）。

### 4.5 固件改动面（最小侵入）

| 文件 | 改动 | 约束 |
| --- | --- | --- |
| `config.h` | 新增 `ENC_ENABLE_DEFAULT` / `NVS_KEY_AES_KEY` / `NVS_KEY_BOOT_ID` / `QI_ENC_BUF_MAX` / `QI_PROTO_VER` | 不改任何既有宏的语义 |
| `.ino` | 仅在 `udpSendLine()` 的 `g_udp.write()` 前插一层 `enc_pack()`：`g_payload` → `g_encbuf` | **`buildDataJson/buildHeartbeatJson/buildErrJson` 一个字不动** |
| `web_config.h` | 加一个密钥输入框 + `enc_ready` 显示 | 不改既有路由契约 |

**为什么必须保持三个 build 函数不动**：`seq` 语义、字段语义、统计口径全部依赖它们。加密只在传输层加壳，**不改任何一行的内容**——这样 168h 的统计结论对两种模式都适用。

### 4.6 对比实验设计（控制变量）

**核心原则：两个实验臂跑同一个二进制。**

用 NVS 开关 `cfg485/enc_on` 在 A/B 间切换，**不编译两个固件**。理由：加密代码在两个臂里都被链接、都占内存，唯一差异是运行时是否调用 `mbedtls_gcm_starts()`。若编译两个 bin，密文臂的 `free_heap` 天然更低，你会把"代码占内存"误读成"加密耗内存"。

**编排（8 h，A/B/A/B 各 2 h）**：

| 时段 | 臂 | 配置 | 时长 | 切换动作 |
| --- | --- | --- | --- | --- |
| 0–2h | A1 明文 | `enc_on=0` | 7200 轮 | 重启后等 NTP 同步再计时 |
| 2–4h | B1 密文 | `enc_on=1` | 7200 轮 | 改 NVS → `/reset`，**停机 60 s 不计入窗口** |
| 4–6h | A2 明文 | `enc_on=0` | 7200 轮 | 同上 |
| 6–8h | B2 密文 | `enc_on=1` | 7200 轮 | 同上 |

**控制变量清单（缺一条实验作废）**：

| 项 | 要求 |
| --- | --- |
| 设备 / 位置 | 同一块板、同一天线朝向、与 AP 距离不变 |
| WiFi | 同一 SSID、同一信道、关闭 band steering；记录基线 RSSI |
| 周期 / 宏 | `poll_s=1`、`QI_SEND_ERR_ROW=1`、`QI_PHASE_TEMP_ABSENT=1` 全程不变 |
| 负载 | 电表回路不变（否则 `poll_err` 变化会混淆结论） |
| PC | 同一台、同一网卡、有线优先；关更新与休眠 |
| 接收端 | 同一份 `udp_collect.py`、同一 DB 参数 |
| 其他流量 | 实验期间不做大文件下载 / 视频 |

### 4.7 对照表模板

| # | 指标 | 来源 | A1 | B1 | A2 | B2 | Δ(B−A) | 判定 |
| --- | --- | --- | --- | --- | --- | --- | --- | --- |
| 1 | 行送达率 M3 | §3.6 | `[待实测]` | | | | | 差 <0.2% ⇒ 无显著差异 |
| 2 | 数据行送达率 | `data_rx/ΣΔpoll_ok` | | | | | | 同上 |
| 3 | 整轮丢失率 M5 | §3.6 | | | | | | 同上 |
| 4 | 平均包长 | `avg(payload_len)` | | | | | | 应 ≈ +29 B |
| 5 | 包长 max | `max(...)` | | | | | | **必须 <1472** |
| 6 | `free_heap` 均值/最低 | 心跳 | | | | | | 降幅 <8 KB `[待实测]` |
| 7 | M1 采集成功率 | §3.6 | | | | | | 差 <0.3%（应无关联） |
| 8 | 单轮耗时 p99 | `loop_ms`（需加字段） | | | | | | <1000 ms |
| 9 | 端到端时延增量 | 相位法（见下） | | | | | | 增量 <5 ms `[待实测]` |
| 10 | 解密失败率 | `decrypt_fail/rx` | — | | — | | | **必须 0** |
| 11 | 抖动 p99/max | §3.5 | | | | | | 两臂均达标 |
| 12 | RSSI 均值 | 心跳 | | | | | | 两臂差 <3 dBm |
| 13 | 时间戳可信率 | `ts_ok` | | | | | | 应 100% |

**时延的测法（只能作辅助证据）**：`ts` 秒级量化，直接相减只得 0–1 s。用相位法 `offset = min(recv_wall − ts)`，`latency = phase − offset`。**量化误差 1 s 远大于毫秒级增量**，故本项**不能单独支撑结论**；主证据应是 `loop_ms` 与 PC 侧解密耗时。固件不改字段则本项标「无法测量」，不编数字。

### 4.8 统计功效（必须写，防过度解读）

2 h = 7200 轮 = 14400 行。若真实丢失率 p=0.5%，二项标准差 ≈ `√(0.005×0.995/14400) ≈ 0.059%`，**95% CI ≈ ±0.12%**。

⇒ **两臂差异小于约 0.2% 时，8 h 实验根本区分不了**，只能报「**未见显著差异**」，**不能**报「加密不影响丢包」。

要做到等效性结论：四段合并后比较（n≈28800/臂，CI ≈ ±0.08%），或延长到 24 h。

### 4.9 ESP32-C3 上的性能预期

| 项 | 结论 | 状态 |
| --- | --- | --- |
| AES 硬件加速 | **有**（C3 集成 AES 外设，128/256，ECB/CBC/OFB/CTR/CFB），mbedTLS 经硬件后端调用 | 需在构建配置中确认生效 `[待实测]` |
| GHASH | 无专用硬件，软件查表 | 数据手册无 GHASH 单元 |
| 吞吐 | 量级 1–5 MB/s | `[待实测]`：对 892 B 计时 1000 次 |
| 单包耗时 | 预期 <1 ms | `[待实测]` |
| 占 1s 周期 | <0.1% | 即使只有 200 KB/s，892 B 也只需 4.5 ms（0.45%） |
| 对 1Hz 是否瓶颈 | **否** | 结论稳健，只影响边距不影响判断 |
| 真正风险 | **内存**：`g_payload`(1200) + 加密输出(1280) 常驻 ≈ 2.5 KB，占 `free_heap` 约 1.4% | 用 168h 的 `free_heap` 斜率验证无泄漏 |

### 4.10 兼容性与默认关闭（决策项，须挂 §8）

**加密默认关闭（`enc_on=0`）。** 理由：

1. 老师参考实现是**明文 UDP**，默认加密会直接打断与老师接收端的联调（违反 21 §7.3 生态兼容约束）。
2. M7 验收需要「老师能收」+「我们能解」两条同时成立。
3. 加密定位是**可选能力 + 对比实验**，不是交付形态。

### 4.11 第四章验收标准

| # | 判据 | 阈值 |
| --- | --- | --- |
| 1 | 默认模式 | 出厂 / `--init` 后 `enc_on=0`，老师接收端可直接收 |
| 2 | 解密正确性 | 8h 实验中 `decrypt_fail = 0` |
| 3 | 不触发分片 | Wireshark 中密文帧无 `More fragments` |
| 4 | 包长 | 密文帧 = 明文帧 + 29 B（逐包校验） |
| 5 | nonce 唯一 | 168h（或 8h × 强制重启 50 次）内无重复 nonce |
| 6 | fail-closed | 人为破坏 `boot_id`，确认加密整体禁用而非带病运行 |
| 7 | 结论合规 | 报告含 CI 与"未见显著差异"的措辞约束 |

---

## 5. 补充：容易遗漏的关键方面（14 项）

### 5.1 测试环境冻结表

168h 期间**任何环境变更都会污染结论**。开工前填表并冻结：

| 项 | 记录内容 | 冻结要求 |
| --- | --- | --- |
| 位置 | 设备所在位置、与 AP 距离 | 全程不动 |
| WiFi | SSID、信道、频段、band steering 状态 | 不改 |
| RSSI 基线 | 连续 5 分钟 `rssi` 均值 | 记录，偏差 >10 dBm 需说明 |
| 供电 | 适配器型号/输出、是否插 USB | 不改 |
| PC | 主机名、IP、网卡、防火墙状态 | 不改 |
| 时间源 | NTP 三源可达性 | 不改 |
| 固件 | 版本 + `bin` 的 SHA256 | 不改（改则重开一次 run） |

### 5.2 7 天连续供电（现有文档完全没提，且是**最容易翻车的一条**）

现状是「充电宝 + 拔 USB」——**充电宝撑不过一天**，168h 必然在 12–24 小时内断电。

| 方案 | 可行性 | 说明 |
| --- | --- | --- |
| 5V/2A 适配器（推荐） | 高 | 输出隔离，USB 保持空置 ⇒ 同时消除地环路风险；需确认纹波不影响 485 |
| USB 充电头 + 数据线 | 中 | 需剪断数据线或确认无主机；否则又形成地环路 |
| 大容量 UPS | 中 | 成本高，仅作掉电缓冲 |
| 太阳能 / 电池组 | 低 | 不现实 |

**验收标准**：连续供电 ≥168h 不掉电；掉电 3 次均能自恢复（并入 §6 判据 13）。

### 5.3 PC 值守

| 项 | 动作 | 命令/位置 |
| --- | --- | --- |
| 禁休眠 | 关闭睡眠与硬盘休眠 | `powercfg /change standby-timeout-ac 0`、`disk-timeout-ac 0` |
| 禁自动重启 | 设活动时间，避开更新重启 | Windows 更新设置 |
| 开机自启 | 计划任务，失败自动重启 | 任务计划程序 |
| 屏幕 | 可关屏，不可睡眠 | — |

### 5.4 设备侧看门狗（PC 代理）

固件**无看门狗、无自动重启**（21 §11 G-01）。用 PC 侧代理兜：

```
每 60 s: GET http://192.168.1.200/status（Basic Auth）
  连续 5 次失败（≈5 min） → GET /reset
  再连续 5 次失败        → 告警，人工断电
```

**验收标准**：人为让设备死机（如持续占用堆），确认 ≤6 min 内自动恢复，且 `event_log` 有记录。

### 5.5 异常处理矩阵

| 层 | 异常 | 检测 | 自动动作 | 是否计入采集率 |
| --- | --- | --- | --- | --- |
| 设备 | 采集超时/CRC/帧长错 | `reason` | 记 err 行，工具位不变 | **计入**（M1 分母） |
| 设备 | 死机 | 心跳中断 >3 min | PC 看门狗 `/reset` | 计入 M14，不计入 M3 |
| 链路 | WiFi 断 | 心跳中断 + `src_ip` 消失 | 固件自恢复（≤60s）；接收端记 `GAP` | **不计入 M3**，计入 M14 |
| 链路 | IP 漂移 | `src_ip` 变化 | 告警 + 提示改 NVS | 计入 M14 |
| 接收 | 写库阻塞 | `q_depth` 高水位 | 扩大缓冲 / 延长提交 | 计入 `q_drop` |
| 接收 | 端口被抢 | 绑定失败 / 包数半量 | 启动即退出 | 该时段记为丢失 |
| 接收 | 磁盘不足 | `disk_free < 10GB` | 告警 + 停止落 payload | 计入事件 |
| 环境 | 断电 | 进程退出 | 重启后 `--repair` 补解析 | 计入中断时长 |

**分级**：`INFO` / `WARN` / `ALERT` / `FATAL`。**ALERT 必须有人响应**，FATAL 立即退出。

### 5.6 数据校验：四层 + raw 自校验

| 层 | 校验 | 位置 |
| --- | --- | --- |
| L0 传输 | 长度、JSON 合法性、字段类型、必填字段 | 接收端收包层 |
| L1 帧 | 地址=1、功能码=0x04、`byteCount` 匹配、CRC 正确 | 固件（已在位），接收端用 `raw` 复算复核 |
| L2 业务 | 量程、电量单调性、时间合理性 | `db_proto.l2_*` |
| L3 跨源 | 与电表本机显示对照（M5 已做 ≥20 组）、环比突变检测 | 人工 + 脚本 |

**raw 自校验（本方案独有，老师实现没有）**：数据行同时带工程量与 `raw`。接收端用 `raw` 独立重算 39 字段，与 JSON 工程量逐字段比对：

```
一致率 = 匹配字段数 / 39
```

**验收标准**：一致率 = 100%。任何不一致都是**固件换算 bug 的直接证据**，且能定位到具体字段——这是"固件只搬运原始值"设计原则的真正价值兑现点。

### 5.7 性能指标

| 指标 | 采集方式 | 阈值 |
| --- | --- | --- |
| 周期抖动 p99 / max | 到达间隔 | ≤50 ms / ≤200 ms |
| 端到端时延 | 相位法（辅助） | 增量 <5 ms `[待实测]` |
| 接收端 CPU | 任务管理器采样 | <5% `[待实测]` |
| `free_heap` 斜率 | 心跳回归 | 168h 内无单调下降（<1 KB/天） |
| DB 增长 | `stat_snapshot.db_mb` | 稳定线性，无阶跃 |
| 单轮耗时 | `loop_ms`（需固件加） | <1000 ms |

### 5.8 可复现性

- `--report-only` 一键重算，与运行时报告逐字节一致。
- 报告附 `bin` 的 SHA256 + 字段字典版本 + `udp_collect.py` 的 git commit。
- 数据快照：每天 `VACUUM INTO` 一份到另一块盘，防单盘损坏。

### 5.9 安全与合规

| 项 | 现状 | 处置 |
| --- | --- | --- |
| AP 常开 | 攻击面常驻 | M7 收紧（超时关闭） |
| `/` 与 `/status` 免鉴权 | 同网段可读 MAC/IP/状态 | M7 收紧 |
| UDP 明文 | 可窃听 | §4 提供可选加密 |
| 凭据 | 历史提交含明文 WiFi 口令（策略 A：不改写历史） | 纪律：文档一律写「见 `secrets.h`」，截图/对话不出现真实口令 |
| 只读铁律 | — | 验收动作不得含控制类命令 |

### 5.10 交付物与证据归档

**问题**：`03_logs/` 与 `.workbuddy/` 都在 `.gitignore` 内 ⇒ **M5/M6 的关键证据只存在于本机**，移交即丢失。

**方案**：

| 证据 | 归档方式 |
| --- | --- |
| 168h 报告（md/csv） | 入 `02_docs/10_验收结项.md` 附录 + 单独 `06_tests/压力测试报告.md` |
| 原始包流水 | 不入 git（体积大）；保留 DB + 每日快照，附 SHA256 |
| 事件日志 | 摘要入报告，原始 `collect.log` 保留 |
| 固件 bin | 入 `05_hardware/` 或发布页，附 SHA256 |

### 5.11 成本对比（09 文档骨架）

| 项 | 树莓派方案 | 本方案 |
| --- | --- | --- |
| 主控 | 树莓派 500–800 元 | ESP32-C3 SuperMini ≈15–20 元 |
| 485 | 需 USB 转 485 ≈20 元 | MAX13487 模块 ≈8–12 元 |
| 载板/PCB | — | ≈5 元（打样摊销） |
| 电源 | 5V/3A ≈20 元 | 5V/2A ≈10 元 |
| 合计 | **约 540–840 元** | **约 50 元** `[待实测：以实际采购单为准]` |

**验收标准**：给出明确数字，附采购凭证；明确"不含电表本身"。

### 5.12 M7 演示脚本（10 分钟）

| 时间 | 内容 | 检查项 |
| --- | --- | --- |
| 0–2 min | 拓扑与成本对比 | 50 元 vs 500–800 元说清 |
| 2–5 min | 实时数据流（接收端控制台） | 每秒 2 行、seq 连续、raw 可复算 |
| 5–7 min | 168h 报告 | 三口径齐全、对账闭合 |
| 7–9 min | 加密对比 | 不触发分片、解密失败 0、结论不越界 |
| 9–10 min | 安全边界 | 只读铁律、现存口子如实说明（不藏） |

### 5.13 降级与回滚

| 场景 | 降级 | 回滚 |
| --- | --- | --- |
| 一帧读全失败 | 自动降 3 段（连续 3 轮，仅本会话） | 重启即回一帧读全 |
| 加密后解密失败 | `enc_ready=false` 退回明文 | 重写 NVS 密钥 |
| 配置错误导致不联网 | 连 AP 打开配置页改回 | `/reset` |
| 接收端崩溃 | 重启后 `--repair` 补解析 | 从 `udp_packet` 全量重放 |

### 5.14 验收组织

| 角色 | 做 | 不做 |
| --- | --- | --- |
| 姜涛 | 接线、烧录、现场观察、提供日志、最终确认 | — |
| 砚青 | 写文档、写 PC 工具、维护进度 | **不自审自改** |
| Claude / Codex | 独立复核（按 `04_ai_prompts/08`） | — |
| 导师 | 确认验收口径 | — |

**纪律**：无日志 = 未通过；现象优先于解释；可复现；阈值未定只能判"有条件通过"；安全前置。

---

## 6. 168 小时总验收判据表

| # | 指标 | 阈值 | 不通过处理 |
| --- | --- | --- | --- |
| 1 | M1 采集成功率 | ≥97% | 查 `reason` 分布，定位总线问题 |
| 2 | **M2 端到端完整率** | **≥96%** | 拆成 A / M1 / D 定位；**只认全程，禁止事后剔除时段** |
| 3 | M3 传输送达率 | ≥99% | 查 WiFi / RSSI / 端口抢占 |
| 4 | 整轮丢失率 | ≤1% | 同上 |
| 5 | 仅数据行丢失率 | ≤1% | 查包长敏感性（892 B vs 213 B） |
| 6 | 重包率 | ≤0.01% | >0 即异常：查端口共享 / 双进程 / epoch 切分 |
| 7 | 抖动 p99 / max | ≤50 ms / ≤200 ms | 沿用任务书 M6 判据 |
| 8 | 时间戳可信率 | ≥99% | 查 NTP 三源可达性 |
| 9 | 非人为重启 | **0 次** | 查 `free_heap` 斜率、供电 |
| 10 | 数据质量 OK 占比 | ≥95% | `A/B/C_temp` 恒 −40 **不计入** invalid |
| 11 | 单次中断 / 累计中断 | ≤5 min / ≤30 min | 每次中断须有 `event_log` 解释 |
| 12 | 数据覆盖空洞 | 每小时 ≥1 条数据行 | 任一小时为空即判不通过 |
| 13 | 断电可恢复 | 强制断电 3 次，每次统计连续、库不损坏 | 从每日快照恢复 |

**阈值 96% 的隐含约束（必须写进验收文档，否则会被问倒）**：

由 `M2 ≈ A × M1 × D`，取 A≈99.7%、D≈99.9%，要达 M2 ≥96% 需 **M1 ≥96.4%**。也就是说：
**这条主判据实际上把 M1 的隐含下限抬到了约 96.4%**，与表中 M1 目标 97% 一致，但必须显式写出这条推导——否则会出现"三个数字各自达标、合起来不达标"的尴尬。

另报 `M2'`（排除链路不可用时段的诊断值）用于定位问题，**不替代主判据**。

---

## 7. 实施排期与角色

| 阶段 | 内容 | 产出 | 责任 | 前置 |
| --- | --- | --- | --- | --- |
| P0 | 解决供电 + IP + 端口（§6 前置） | 环境冻结表 | 姜涛 | — |
| P1 | `udp_collect.py` 骨架（3 线程 + 建表 + 收包落 `udp_packet`） | 30 min 不丢 | 砚青 | 本方案复核通过 |
| P2 | 解析入库 + epoch 切分 | `meter_record` 有数据 | 砚青 | P1 |
| P3 | 统计引擎 + 报告模板 + **构造数据集证伪** | 四类丢包可精确复现 | 砚青 | P2 |
| P4 | 固件 AES 分支 + NVS 密钥 + `enc_on` | 密文能被 PC 解开 | 砚青（Claude 复核） | P3 |
| P5 | 8 h 对比实验 | §4.7 对照表 | 双人 | P4 + 供电 |
| P6 | 168 h 长跑 | 验收报告 | 自动 + 值守 | P5 |
| P7 | 结项文档（09 成本 / 10 验收 / 压力测试报告） | 三份 | 砚青 | P6 |

> 时间不写死。P0 未解决就开跑 = 一定失败，且浪费 7 天。

---

## 8. 待实测 / 待确认清单

| 编号 | 项 | 类型 | 影响 |
| --- | --- | --- | --- |
| T-01 | `SO_RCVBUF` 在目标 Windows 的实际生效值 | 待实测 | 缓冲余量论证 |
| T-02 | 写阻塞最坏时长（Defender 扫描期间） | 待实测 | 队列容量取值 |
| T-03 | 数据行丢失率 vs 心跳丢失率 | 待实测 | 验证"包长敏感"假设 |
| T-04 | AES-GCM 单包耗时、`free_heap` 增量 | 待实测 | §4.9 结论 |
| T-05 | 密文帧是否触发 IP 分片 | 待实测 | 实验有效性 |
| T-06 | `boot_id` NVS 写入成功率（50 次强制重启） | 待实测 | nonce 唯一性 |
| T-07 | Windows 接收调度抖动本底 | 待实测 | 抖动测量噪声 |
| T-08 | 168h 实际 DB 体积 | 待实测 | 磁盘预留 |
| C-01 | 老师 `quality:"00"` 编码含义 | 待确认 | 兼容性 |
| C-02 | `record1..3` 的 `0` vs `F` | 待确认 | 数据语义 |
| C-03 | 电量公式另一解 | 待确认 | 电量不可验收 |
| C-04 | `RXO` 空闲电平万用表实测 | 待确认 | 电气合规性 |
| C-05 | 以哪版老师固件为准 | 待确认 | 联调基准 |

---

## 9. 本方案明确不做的事

| 不做 | 原因 |
| --- | --- |
| 本地补传队列 | 当前 `queue`/`dropped` 是占位；真做要动状态机与存储，M6 已定"只加固不重构" |
| OTA | 不在本期范围 |
| 多从站支持 | 地址 1 硬编码；需改协议层批量策略 |
| MQTT / TLS | 商业化 P1，非结项必需 |
| 生产级密钥管理 | 预共享密钥仅供对比实验 |

> 把这些写出来，比假装都做了更安全。验收时被问到"为什么没有"，答案是"范围裁定，有记录"。

---

> 最后更新：2026-11-04 · 砚青 · §3 纪律 2 加"唯一一次例外"（M3 双条件口径，用户拍板；裁定见 `02_docs/32` §8.6）。
> 上一版：2026-10-15 · 砚青 · 首版（v1.0，待 Claude/Codex 独立复核）
