jiangtao-ml/ESP32_C3_Gateway/02_docs/24_焊接与168h测试规划.md

# 洞洞板焊接与 168h 连续测试规划

| 项 | 内容 |
| --- | --- |
| 文档 | `02_docs/24_焊接与168h测试规划.md` |
| 版本 | v1.0 / 2026-10-21 |
| 作者 | 砚青（WorkBuddy） |
| 触发 | 导师要求项目真正落地并达到可验收；用户要求给出「基于 ESP32-C3 + MAX13487 + 洞洞板载体」的完整测试与焊接规划，并先优化代码 |
| 上游 | `02_docs/22_实现与交付方案.md`（接收端设计）· `02_docs/21_需求规格说明书.md`（需求基线） |
| 配套 | `05_hardware/洞洞板固化操作卡_2026-10-08.md` **v1.1** · `05_hardware/洞洞板布局图_2026-10-21.md` |
| 状态 | 待复核（作者 ≠ 验证者） |
| **目标级别** | **L1 实验室样机**（定义、明确不做项与残余风险见 `02_docs/26_级别声明与范围边界.md`） |

---

## 0. 三个必须先纠正的前提

写在最前面，因为后面所有数字都依赖它们。

| # | 常见说法 | 核实结果 | 影响 |
| --- | --- | --- | --- |
| **F-1** | 「MAX13847」 | 全仓 0 次出现。实物 = **MAX13487(E)**，SOIC-8，**无 DE 脚**（AutoDirection）。文档里 `MAX13487` 与 `MAX13487E` 混用，是同一颗 | 器件选型、引脚定义 |
| **F-2** | 「UDP 丢 2/1800 ≈ 99.9%」 | **错**。M6 那 900 s 的原始数据：seq 145–1945 应有 1801 行，实收 1782 行，**缺 19 行 = 18 条数据行（870 B）+ 1 条心跳（190 B）** ⇒ 数据行送达 **882/900 = 98.0%** | **M2 阈值 96%，只剩 2 个百分点余量**。原记录保留并加更正括注，见 `PROGRESS.md §8.2` |
| **F-3** | 「周期 1 s，168h = 604800 轮」 | **成立**。M6 900 s 内 `poll_ok` 75→975（+900），898 个心跳间隔 = 1.000 s、1 个 = 2.000 s，零系统性漂移 | 604800 可直接作 M2 分母 |

> F-2 是本方案最重要的一个修正。如果按 99.9% 去准备，会在 168h 跑完才发现只有 98%，届时既没有时间排查，也很难解释为什么"和之前一样却没通过"。

---

## 1. 硬件与接线（施工摘要）

详细工序见 `05_hardware/洞洞板固化操作卡_2026-10-08.md` **v1.1**，纸面绘图规格见 `05_hardware/洞洞板布局图_2026-10-21.md`。此处只列**会影响测试结果**的要点。

### 1.1 唯一权威接线（8 根，交叉）

| # | 从 | 到 | 说明 |
| --- | --- | --- | --- |
| 1 | ESP32 `5V` | 模块 `VCC` | 模块必须 5V |
| 2 | ESP32 **`3.3`** | 模块 **`EN`** | 固定高电平；**本次裁定接 3.3V**（原文档写 5V，已统一） |
| 3 | ESP32 `G` | 模块 `GND` | 共地，先焊 |
| 4 | ESP32 `21`（TX） | 模块 `RXD` | **交叉**：模块 RXD = 芯片 DI |
| 5 | ESP32 `20`（RX） | 模块 `TXD` | **交叉**：模块 TXD = 芯片 RO |
| 6/7/8 | 模块 `A`/`B`/`GND` | 端子 `1`/`2`/`3` | 总线侧丝印顺序是 **B → A → GND** |

- 模块板载已有 `472/121/472` ⇒ **板上不得再加终端或偏置**（重复加终端会让 A↔B 变 60 Ω）。
- **不分压已定稿**：用户 2026-10-21 确认 `RXO` 直连 `GPIO20`，不做 1k/2k 分压。详见 `05_hardware/洞洞板固化操作卡` §0。
- **本板无排母**：两个模块的引脚直接穿板焊死，**焊上即不可拆**。因此图纸签核与焊后电检（M1–M17）两关的权重高于常规做法。

### 1.2 安全红线（原样执行）

1. 真机带电期间**拔掉 USB 数据线**，改用独立 5V 供电——不隔离，强电会经 USB 地 + 485 共模**烧电脑主板**。
2. **每次改接线前断电 + 验电**；没有万用表不许开箱。
3. STB3-125 **只读不写**：合闸 / 分闸 / 锁扣 / 复位 / 写寄存器 / 广播一律禁止。
4. 禁止 5V 直灌 GPIO20（绝对最大额定 3.6 V）。

---

## 2. 代码优化（长跑前必须先做完）

### 2.1 优化目标的重新定义

原始诉求是"提升跑数据时的表现"。先说结论：**提速不是瓶颈**。

- 一轮采集约 105–120 ms，占 1 s 窗口约 10%；
- 周期实测零漂移，`endPacket` 全部返回成功，`udp_tx` 与 `seq` 逐行相等（0 处不符）；
- `free_heap` 在 900 s 内稳定在 179.5 KB，斜率 −17 B/小时。

真正的风险是**可观测性缺失**与**2% 的系统性丢失**。所以本节优化的重点是"让 168h 结束时拿到的报告可信"，而不是"让每秒快 1 ms"。

### 2.2 接收端（`06_tests/udp_collect.py`）

| # | 改动 | 为什么这是必须的 |
| --- | --- | --- |
| B-1 | 统计线程改用**读写连接**（原来是只读） | 原来它要写 `stat_snapshot` 与 `event_log`，但连接是 `mode=ro`，异常又被 `except sqlite3.Error: pass` 吞掉 ⇒ **分钟快照、GAP、磁盘告警全部静默为空**，而报告看起来正常 |
| B-2 | `ensure_run` 统一返回 **aware datetime** | 续跑返回 naive、新建返回 aware ⇒ 进程重启过一次后 T3 比较 `deadline` 抛 `TypeError` 死亡，**168h 自动收尾永不触发** |
| B-3 | 注册 **SIGTERM/SIGINT** handler（只置标志） | 原来只捕 `KeyboardInterrupt`；`systemctl stop` 发 SIGTERM 会直接杀进程 ⇒ 排空队列、`ended_at`、checkpoint、报告**全部跳过** |
| A-4 | 新增 `stop_signal_at`，时长以它为准 | `ended_at` 是收尾之后才写的，30 min 冒烟里收尾能花 2 min，拿它算时长会把 M2 拉低约 6.7%——自己制造的门控失败 |
| A-5 | `SO_RCVBUF` 设后**回读**并落库 | Linux 会把 1 MiB 请求**静默截断**到 `net.core.rmem_max`（Ubuntu 默认 208 KB ⇒ 约 190 s 而非设计里的 475 s），不报错、不看就发现不了 |
| A-6 | 每 60 s 采 `/proc/net/snmp`（`InErrors`/`RcvbufErrors`）与网卡 `rx_dropped`/`rx_missed_errors` | 这是 Linux 独有的证据源。**没有它，就永远分不清"空口丢"与"接收端丢"** |
| A-7 | 主机名 / IP / OS / Python / SQLite 版本 / 代码 commit / bin SHA256 落库 | 原来 `COMPUTERNAME` 在 Linux 输出 `主机：?`；且这些数必须从库里读，不能读运行时环境，否则 `--report-only` 换机重算时封面会变，"逐字节一致"永远不成立 |
| A-8 | 报告固定 **LF** 行尾 + `--report-out` | Windows 的 CRLF 会让跨机复算 diff 全红，被误判成"复算不一致" |
| A-9/A-10 | SQLite <3.24 直接退出；新增 `--env-check` | `ON CONFLICT DO UPDATE` 需要 3.24（Ubuntu 18.04 自带 3.22）。带病跑 168h 是最贵的失败方式 |
| A-11 | 每日 `Connection.backup()` 在线备份 + SHA256，保留 3 份 | 不用 `VACUUM INTO`（需 SQLite ≥3.27），`backup()` 在所有版本都对且不长时间持锁 |
| A-13 | `--verify-raw`：用 `raw` 重算 39 字段与 **JSON** 比对 | 必须比 JSON，不能比 `meter_record`——后者本来就是 raw 算出来的，自己跟自己比必然 100%，是同义反复 |

**不变的部分**：收包线程仍只做 `recvfrom + json + 计数 + 入队`；报告数字仍 100% 由 SQL 重算；`udp_packet` 先写的顺序不变；**`db_proto.py` 一个字未改**；不引入第三方依赖。

### 2.3 固件（4 项零协议风险加固）

| # | 改动 | 收益 |
| --- | --- | --- |
| C-1 | `udpSendLine()` 校验 `write()` 返回值（≠`strlen` 即失败） | 短写时 `endPacket()` 仍可能返回 1 ⇒ `udp_tx` 记成"已发"而实际只发出一部分，接收端只看到 `bad_json`，对账时被算成"网络丢失"，**把排查方向整条带偏**。**不做应用层重传**（重传会造重复 `seq`，污染 M8） |
| C-2 | 数据行的 `ip` 改用栈上 `char[16]`，去掉每轮 `String` 分配 | 消除实测 356/712 B 的堆锯齿，降低 168h 碎片风险；JSON 里 `ip` 逐字节不变 |
| C-3 | 丢轮分支打 `[POLL][SKIP]` 日志 | 原来该分支**完全静默**，168h 对账出现"墙钟有 N 轮、poll 只涨 N−k"时查不出是设备跳轮还是网络丢包。**只加日志，不加 JSON 字段** |
| C-4 | `SERIAL_VERBOSE_ROUND` 开关（长跑设 0） | 每轮从约 1961 B / 44 次 write 降到约 120 B / 2 次；168h 累计省掉约 1.09 GB 的纯格式化浪费 |

**编译基线（实测，2026-10-21）**

| 版本 | Flash | RAM | 结论 |
| --- | --- | --- | --- |
| HEAD `ff0b6f1`（干净重编） | 1,086,409 B | 49,496 B | 实际基线 |
| 本轮 4 项加固后 `SELFTEST=0` | 1,086,695 B | 49,496 B | +286 B / +0 B |
| 本轮 4 项加固后 `SELFTEST=1` | 1,078,957 B | 49,368 B | 0 error（回环分支可编） |
| **再经 Codex 审查改动后 `SELFTEST=0`** | **1,086,171 B** | **49,512 B** | **−524 B / +16 B**（`SERIAL_VERBOSE_ROUND` 改 0） |
| **再经 Codex 审查改动后 `SELFTEST=1`** | **1,078,983 B** | **49,384 B** | 0 error |
| **2026-10-27 商用级加固后 `SELFTEST=0`** | **1,089,225 B** | **49,568 B** | **+3,054 B / +56 B**；`.rtc_noinit = 8 B`（boot 计数）；0 warning |
| **2026-10-27 商用级加固后 `SELFTEST=1`** | **1,081,561 B** | **49,408 B** | **+2,578 B / +24 B**；0 warning（回环分支仍可编） |

> ⚠️ 仓库文档里写的 `1,070,975` 是**过期数字**（M6 时代 core/配置下的产物），与当前源码不符。以上表为准，已记入 `PROGRESS.md`。
>
> ✅ **2026-10-27 复核基线**：把 HEAD `71c19ca` 的三个源文件导出到 `.workbuddy/tmp/base_check/` **单独编译**，
> 实测 `SELFTEST=0` = `1,086,171 / 49,512`、`SELFTEST=1` = `1,078,983 / 49,384`，
> 与上表第 4/5 行**完全一致** ⇒ **本表可信**。（此前一度误用 `1,070,975 / 49,348` 作基线、算出 `+18,250` 的增量，**已作废**。）

**十二项绝对不能动**：Modbus 帧与 CRC、解析顺序、P0-1 帧长校验、`g_merged` 无整轮清零、`RS485_DE_PIN=-1`、`Serial1.flush()` 作发完判据、`poll_ok` 先于链路判断自增、`g_nextPollMs` 按计划时刻推进、JSON 字段名与顺序、`Serial.setTxTimeoutMs(0)`、NTP reachability 判据、`seq` 自增位置。

### 2.4 验收前必须做的代码门禁

| 项 | 命令 | 通过条件 |
| --- | --- | --- |
| 统计引擎自检 | `python 06_tests/udp_collect.py --selftest` | 全部一致（注入 50 整轮丢 / 20 数据丢 / 10 心跳丢 / 3 err 丢 / 5 重包 / 2 重启 / 各 1 次同秒与回跳） |
| 环境自检 | `python 06_tests/udp_collect.py --db <库> --env-check` | 0 项阻断 |
| 收尾实测 | `systemctl stop` 三次（空闲 / 灌数 / 备份中） | 每次 `ended_at` 非空、报告生成、`-wal` 归零 |
| 复算一致 | 跑完 → `--report-only --report-out` | 两份文件 `sha256` 相同 |
| 固件双模式 | `SELFTEST=0` 与 `=1` | 均 0 error |

---

## 3. 验收标准（34 条，判定 P / F / M）

判定规则：
- **P（Pass）**：达到阈值。
- **F（Fail）**：未达阈值，或数据不足以判定。
- **M（Manual）**：需人工裁定（由导师/第二人确认）。
- **主判据任一 F ⇒ 总体不通过**，其余为分项结论。

### 3.1 主判据（9 条，一票否决）

| # | 判据 | 公式 | 阈值 | 判定条件 | 数据来源 |
| --- | --- | --- | --- | --- | --- |
| Y-1 | **端到端完整率 M2** | 数据行 / 604800 | **≥96%** | <96.0% ⇒ F；96.0–96.5% ⇒ M（需解释余量） | `SELECT COUNT(*) FROM udp_packet WHERE ptype='data'` |
| Y-2 | 传输送达率 M3 | 去重收到 / 应唯一发送 | **受控窗口（22:00–08:00，完整 10 h）≥99%** | 该窗口 <99% ⇒ F；**全天值同时报出但不判 F** | 见 §4 M3；双条件裁定见 `02_docs/32` §8.6（2026-11-04） |
| Y-3 | 重包率 M8 | 1 − distinct/rx | ≤0.01% | >0.01% ⇒ F | `GROUP BY device_id,epoch_id,seq HAVING COUNT(*)>1` |
| Y-4 | 时钟回跳 M10 | `CLOCK_STEP` 事件数 | **= 0** | ≥1 ⇒ F（说明 ts 倒退，数据可能被覆盖） | `event_log WHERE kind='CLOCK_STEP'`；**交叉证据（2026-10-27 起可用）**：心跳 `clk_hold` > 0 且 `CLOCK_STEP` = 0 ⇒ 固件时钟钳位确实生效；若 `clk_hold` = 0 而 `CLOCK_STEP` = 0，说明整段没触发过回退，属"未验证"而非"已验证" |
| Y-5 | 队列溢出 | `q_drop` | **= 0** | >0 ⇒ F（接收端自己丢的包） | `MAX(q_drop) FROM stat_snapshot` |
| Y-6 | 解析失败率 | (bad_json+bad_field)/rx | ≤0.01% | >0.01% ⇒ F | `udp_packet.parse_status` |
| Y-7 | 非人为重启 | `device_epoch` 数 − 1 − 计划重启 | **= 0** | ≥1 ⇒ F | `device_epoch` |
| Y-8 | 数据覆盖空洞 | 每小时数据行数最小值 | **≥1** | 任一小时为 0 ⇒ F | `substr(recv_time,1,13)` 分组 |
| Y-9 | 磁盘余量 | 全程 `disk_free_mb` 最小值 | ≥10 GB | <10 GB ⇒ F | `MIN(disk_free_mb) FROM stat_snapshot` |

### 3.2 指标判据（16 条）

| # | 指标 | 阈值 | 数据来源 |
| --- | --- | --- | --- |
| M-1 | M1 采集成功率 | ≥97% | 心跳 `poll_ok` 差分 |
| M-2 | M2 端到端完整率 | ≥96% | 同 Y-1 |
| M-3 | M3 传输送达率 | **受控窗口 22:00–08:00 ≥99%**（全天值并报） | 同 Y-2 |
| M-4 | M4 行丢失率 | **受控窗口内 ≤1%**（= 1 − M3） | 1 − M3 |
| M-5 | M5 整轮丢失率 | ≤1% | seq 配对 |
| M-6 | M6 仅数据行丢失率 | ≤1% | 心跳 + seq |
| M-7 | M7 仅心跳丢失率 | ≤1% | seq 配对 |
| M-8 | M8 重包率 | ≤0.01% | 同 Y-3 |
| M-9 | M9 DB 幂等冲突率 | ≤0.01% | `dup/attempts` |
| M-10 | M10 撞车率 | **= 0** | 同 Y-4 |
| M-11 | M11 抖动 p99 | ≤50 ms | `recv_mono` |
| M-12 | M12 抖动 max | ≤200 ms | 同上 |
| M-13 | M13 时间戳可信率 | ≥99% | 心跳 `ts_ok` |
| M-14 | M14 链路可用率 A | ≥99% | ΔR / 理论轮数 |
| M-15 | M15 设备在线率 | ≥99% | 1 − Σ(gap>60 s)/T |
| M-16 | M16 数据质量 OK 占比 | ≥95% | `meter_record.quality` |

**M17（单轮耗时 p99）本期不适用**：固件没有 `loop_ms` 字段，加字段属改接口，需复核。用 **M11 抖动**替代，并在报告中明确标注"不适用"，不计入 34 条。

### 3.3 过程判据（6 条）

| # | 判据 | 阈值 | 判定条件 |
| --- | --- | --- | --- |
| P-1 | 连续运行时长 | ≥168 h | 不足 ⇒ F；中途重启后累计 ≥168 h ⇒ M |
| P-2 | 进程崩溃 | 0 次（计划内 stop 除外） | 依赖 `collect_run.starts` = 1 |
| P-3 | 断电恢复 | 3 次强制断电均可恢复 | 库不损坏、`--report-only` 与断电前一致 |
| P-4 | 报告可复算 | `--report-only` 与运行时报告 `sha256` 相同 | 不同 ⇒ F |
| P-5 | 快照完整 | `stat_snapshot` 行数 ≥ 0.9 × 运行分钟数 | 为 0 ⇒ F（统计线程死了） |
| P-6 | 每日备份 | 备份文件数 = 运行天数（≤3）且 SHA256 齐全 | 缺 ⇒ M |

### 3.4 分析判据（3 条）

| # | 判据 | 阈值 | 说明 |
| --- | --- | --- | --- |
| A-1 | 未归因比例 | ≤0.1% | `UNATTRIBUTED` 占总缺口比例 |
| A-2 | 最差小时数据率 | ≥90% | 抑制"总量合格但某小时全丢" |
| A-3 | 最差 5 分钟数据率 | ≥85% | 同上，粒度更细 |

### 3.5 先做 8 小时门控（不是放宽阈值）

M2 只剩 2 个百分点余量，**不能拿 168h 去赌**。168h 开跑前必须先跑 8 h：

| 8h 观测 | 动作 |
| --- | --- |
| M2 ≥97.5% 且 95% 置信下界 ≥96.5% | 放行 168h |
| 96.5%–97.5% | 延长到 24 h；仍 <97.5% ⇒ 停 |
| **<96.5%** | **停，不上 168h**，按 §6 判定树排查 |
| ≈98% 且 pcap 证明是空口丢 | 可放行，但报告必须写"系统性空口损失约 2%，阈值余量仅 2 点"；最差小时 <90% 仍停 |

统计功效：8 h = 28 800 轮，98.0% 的 95% CI ≈ ±0.16%（与 96% 相距约 12σ）。
**30 分钟只有 1800 轮，且 1 Hz 丢包成簇**，CI 约 ±0.65%，不足以判断 2 个点的余量。

---

## 4. 完整指标清单

### 4.1 核心指标 M1–M18

见 `02_docs/22` §3.6 定义表。M17 本期不适用（见 §3.2 说明）。

### 4.2 本次新增必须记录的 R1–R25

| 编号 | 指标 | 为什么必须记 |
| --- | --- | --- |
| R-1 | 收缓冲请求值 / **回读值** / `rmem_max` / 等效秒数 | Linux 静默截断，只看代码看不出来 |
| R-2 | 内核 `Udp InErrors` / `RcvbufErrors` | 区分"空口丢"与"接收端丢"的唯一硬证据 |
| R-3 | 网卡 `rx_dropped` / `rx_missed_errors` | 驱动层丢包（与内核 socket 缓冲不同层） |
| R-4 | `q_drop` / `q_depth_max` | 应用层唯一允许的丢弃点 |
| R-5 | `[POLL][SKIP]` 丢轮次数 | 设备侧跳轮 vs 网络丢包的分界 |
| R-6 | `free_heap` 斜率与最小值 | 168h 内存风险的唯一长期证据 |
| R-7 | DB 体积 / WAL 体积 / 行数 / **字节每包** | 存储预算与实际膨胀是否一致 |
| R-8 | 接收端 CPU% / RSS | 老机器上 p99 偏高时能自证"不是我拖的" |
| R-9 | 每轮耗时 p50/p95/p99/max | 用 `recv_mono` 差分，同类型之间比 |
| R-10 | 重复包数 / 重复 `seq` 列表 | 与 M8 呼应 |
| R-11 | `CLOCK_STEP` / `TS_SAME_SECOND` / `TS_OUT_OF_ORDER` | 三类时间戳异常必须分开计 |
| R-12 | 时钟跳变次数与最大跳幅 | NTP 步进的幅度 |
| R-13 | 断电次数与每次恢复时长 | 对应 P-3 |
| R-14 | RSSI 分箱 vs 丢失率 | 判断是否与信号强度相关 |
| R-15 | 包长分布（hb 190 B / data 870 B / err） | 判断是否与包长相关（"大包优先丢"） |
| R-16 | 解析失败四类分布 | bad_json / bad_field / decrypt_fail / oversize |
| R-17 | raw 自校验一致率 | 用 raw 重算 39 字段与 JSON 比对 |
| R-18 | 世代数与每次重启的原因 | `detect` 字段 |
| R-19 | pcap 与 DB 同窗计数 | 归因 L4 的判据 |
| R-20 | 固件 `quality` 与接收端重算的质量差异 | 固件口径 bug 的证据 |
| R-21 | IP 源变化次数 | 长跑"数据没了"的高频原因 |
| R-22 | NTP 状态 / `ts_ok` 比例 | 时间戳可信度 |
| R-23 | 磁盘最低余量 | 对应 Y-9 |
| R-24 | 进程启动次数 | 对应 P-2 |
| R-25 | 缺口直方图（>5/30/60/300 s） | 区分"零星丢包"与"整段断流" |

---

## 5. 结果的输出形式与呈现

### 5.1 文件树

`<RUN>` = 开跑日（`YYYYMMDD`）。

```
03_logs/
  m7_longrun_<RUN>.db                    # 主库（不入 git）
  m7_longrun_<RUN>.log                   # 运行日志，50 MB × 10 滚动
  m7_longrun_<RUN>_report.txt            # 运行时报告（LF）
  m7_longrun_<RUN>_report.md             # 同上，markdown 版（给人看）
  m7_longrun_<RUN>_metrics.csv           # M/R 全表，一行一指标
  m7_longrun_<RUN>_hourly.csv            # 逐小时趋势
  m7_longrun_<RUN>_gaps.csv              # 缺口清单（gap_id 起止/时长/归因层）
  m7_longrun_<RUN>_events.csv            # event_log 全量
  m7_longrun_<RUN>_rawcheck.csv          # raw 自校验不一致样例
  m7_longrun_<RUN>_manifest.sha256       # 上述所有文件的 SHA256
  m7_longrun_<RUN>_pcap_<HHMM>.pcap      # 抓包窗口（只留 2–3 段）
  m7_longrun_<RUN>_backup/               # 每日备份 .db + .sha256（保留 3 份）
```

命名遵循 `03_logs/README.md` 的 `<阶段>_<场景>_<YYYYMMDD>`。`--db` 决定 log/report 文件名，传 `03_logs/m7_longrun_<RUN>.db` 即自动配套。

**归档**：`03_logs/` 与 `.workbuddy/` 都在 `.gitignore` 内 ⇒ **原始证据只存在于本机，移机即丢失**。交付时必须另行拷贝并附 SHA256 清单。

### 5.2 报告章节顺序（14 章）

| 章 | 内容 | 读者 |
| --- | --- | --- |
| 1 | 封面：设备 / MAC / bin SHA256 / 代码 commit / 主机 IP / OS / Python / SQLite / 起止 / 收缓冲实际值 / 字典 SHA | 双方 |
| 2 | 结论摘要：34 条判定统计（P/F/M 各几条）、总体通过与否 | 老师 |
| 3 | M 表 + R 表 | 老师 |
| 4 | 三口径关系：`A × M1 × M3` vs M2，偏差 <0.1 | 老师 |
| 5 | 四计数器对账（逐世代 + 残差） | 双方 |
| 6 | 丢包四分类 + 按小时分布 | 双方 |
| 7 | **接收端健康**：q_drop、内核丢包、CPU/RSS、快照行数、raw 一致率 | 内部 |
| 8 | 周期与抖动（p50/p99/max） | 老师 |
| 9 | 数据质量 + 字段 NULL 率（A/B/C_temp 预期 100%） | 老师 |
| 10 | 事件表 | 内部 |
| 11 | 逐小时趋势 | 双方 |
| 12 | **缺口归因专章**（§6 判定树结果） | 内部/老师 |
| 13 | 局限与未达标项（含 `UNATTRIBUTED`） | 老师 |
| 14 | 附录：SQL 编号、SHA256、环境冻结表、复算命令 | 内部 |

### 5.3 三张图

| 图 | 内容 | 形式 |
| --- | --- | --- |
| 图 1 | 每小时数据率 + 96% 阈值水平线 | 折线 + 警戒线 |
| 图 2 | 抖动分布（log y）+ p99 / max 参考线 | 直方图 |
| 图 3 | RSSI 分箱 vs 丢失率 | 柱状或散点 |

优先用旧机已装的 `matplotlib`；未安装则只出 CSV + 说明用 LibreOffice 绘制，**不新增依赖**。

### 5.4 分层呈现

| 层 | 内容 | 去处 |
| --- | --- | --- |
| **老师看** | 结论、三口径、M 表、34 条判定、三张图、局限 | `02_docs/25_168h测试报告.md` |
| **内部排查** | SQL、缺口表、pcap、内核计数、raw 明细、事件全表 | `03_logs/*_gaps.csv` 等附件 |
| **原始证据** | DB / pcap / 日志 | 不入 git，附 SHA256 清单 |

---

## 6. 未采集数据的错误分析方案

### 6.1 五个层级与判据

从"缺口"出发，逐层排除。**每一层只回答一个问题，答不出来就停在该层记"证据不足"。**

```
缺口 (gap_id)
 ├─ L1 设备在跑吗？         ΔR 是否明显小于墙钟轮数
 ├─ L2 跑了但没组装？        Δseq < 2ΔR
 ├─ L3 组装了没发出？        Δseq > Δudp_tx + 1
 ├─ L4 发出但没到？          Δudp_tx + 1 > R
 │    ├─ L4a 内核缓冲溢出     RcvbufErrors 增量 > 0
 │    ├─ L4b 网卡/驱动丢      rx_dropped / rx_missed_errors > 0
 │    ├─ L4c 空口丢          pcap 也少 且 DB ≈ pcap
 │    └─ L4d 端口被抢        pcap 有、DB 几乎无、ss 出现两个 socket
 ├─ L5 到了没入库？          udp_packet 有、meter_record 无
 └─ L6 入库但值错？          raw 重算与 JSON 不符
```

### 6.2 每层的证据与 SQL

| 层 | 判据 | SQL / 证据 |
| --- | --- | --- |
| L0 | 列出所有缺口，**不猜原因** | 相邻 `hb` 的 `recv_mono` 差 > 5 s 即为一个缺口，按 `epoch_id` 分组编号 |
| L1 | 设备没跑 | `SELECT poll_ok, poll_err FROM udp_packet WHERE ptype='hb' ORDER BY id`，看相邻两条的差是否 < 墙钟轮数 |
| L2 | 跑了没组装（WiFi 未连时 `seq` 不增、`poll` 照增） | `Δseq` vs `2·ΔR`；配合 `poll_ok/poll_err` |
| L3 | 组装了没发出 | `Δseq` vs `Δudp_tx + 1`；台上时看 `[UDP][ERR]` |
| L4 | 发出没到 | `Δudp_tx + 1` vs 该窗口内 `COUNT(*)` |
| L4a | 内核缓冲 | `MAX(udp_rcvbuf_errors) - MIN(...) > 0` |
| L4b | 网卡/驱动 | `nic_rx_dropped` / `nic_rx_missed` 增量 |
| L4c | 空口 | pcap 与 DB 同窗计数：`\|P − R\| / P < 1%` 且 `P < 期望` |
| L4d | 端口被抢 | `ss -lunp \| grep 8888` 出现两个 socket；或 pcap 有而 DB 几乎无 |
| L5 | 到了没入库 | `SELECT parse_status, COUNT(*) FROM udp_packet GROUP BY 1`；`event_log` 的 `STORE_BAD` |
| L6 | 值错 | `--verify-raw` 输出的 `_rawcheck.csv` |

### 6.3 闭合判据

```
1 − R/期望  ≈  L_air + L_recv + L_parse
```

不闭合的部分记 `UNATTRIBUTED`，**必须留在报告里**，超过 0.1% 触发人工复核。

### 6.4 五条硬规矩

1. **没有 pcap 覆盖，不得判定"空口丢"**。
2. **没有计数器差分，不得判定"设备没发"**。
3. **没有 `RcvbufErrors` / `rx_dropped`，不得判定"接收端丢"**。
4. `UNATTRIBUTED` 不得省略、不得改名、不得合并进其它类。
5. **禁止用"可能 / 大概 / 应该是"填空**；证据不足就写"证据不足，需补测"。

> 这一节的目的是**防止把猜测写进验收文档**。一个没有被证伪过的归因，比"未知"更危险。

---

## 7. 流程与排期

| 阶段 | 内容 | 门禁 |
| --- | --- | --- |
| 1 | 代码优化（§2）+ 自检 + 双模式编译 | G0：自检全绿、`SELFTEST=0/1` 均 0 error、独立复核签字 |
| 2 | 纸面绘图（三张图 + 8 项自查 + 签核） | **G1：双人签字 + RXO 实测值已填**，未过不焊 |
| 3 | 焊接 + 电检 M1–M17 | G2：通断全通、无短路、A↔B ≈120 Ω |
| 4 | 上电 S1–S4 | G3：悬空降级正常；G4：真机 5 min 100% |
| 5 | Ubuntu 环境准备 + `--env-check` + SIGTERM 三次实测 | G4.5 |
| 6 | 8 h 连续（含 2 次 pcap 窗口）**必须落在 22:00–08:00 夜间窗口内** | **G5：M2 ≥97.5%、M3 ≥99.5%、q_drop=0、内核丢包 0**，未过不上 168h。⚠️ **"夜间"是必要条件**：2026-10-26 那轮通过是靠 21:34→05:34 的天然夜间窗口，白天跑 8h 必不过（当时未写明，2026-11-04 补齐） |
| 7 | **168 h 连续** | — |
| 8 | 收尾 → 报告 → CSV → manifest → 第二人复算 | G6：34 条全部有结论 |

**关键路径**：G1 图纸签核 → 焊接 → 电检 → 真机 → G5 8h 门控 → 168h。**任何一步没过都不允许跳。**

---

## 8. 尚未闭环、必须由人确认的 6 件事

| # | 事项 | 为什么卡住 |
| --- | --- | --- |
| Q1 | ~~RXO 空闲电平实测值~~ **→ 已闭环（2026-10-21 裁定直连，不分压）** | 用户已确认不需分压；操作卡 §0 保留"换 5V 逻辑模块时必须重测"的提醒 |
| Q2 | 旧电脑能否禁用休眠 / 有无 sudo | 不能禁休眠 ⇒ 168 h 不可开跑 |
| Q3 | 3P **5.08 mm** 端子能否买到 | 只有 5.0 mm 则孔位偏 0.16 mm，图纸要改 |
| Q4 | 3 次强制断电放在 8 h 专项还是 168 h 内 | 建议放 8 h 专项（风险前移，168 h 零人为中断） |
| Q5 | M17（`loop_ms`）接受"不适用" | 影响 34 条判定的解释口径 |
| Q6 | core 3.x 的 `write()` 返回值语义 | 若返回 0 表示"已入队"而非"已发完"，C-1 会把成功误判为失败，需回退 |

**Q1 不闭环不许动烙铁。**

---

## 9. 变更记录

| 版本 | 日期 | 作者 | 变更内容 |
| --- | --- | --- | --- |
| v1.0 | 2026-10-21 | 砚青 | 首版。含 F-1~F-3 三项事实纠正、代码优化清单（接收端 12 项 + 固件 4 项）、34 条可勾选验收标准、M1–M18 + R1–R25 指标清单、输出形式与分层、未采集数据六级判定树。 |
| v1.1 | 2026-11-04 | 砚青 | **P-2 判据修好**（正文口径不变，改的是被它依赖的工具）：`collect_run.starts` 原会把 `--repair`/`--verify-raw` 也算成一次"进程启动"，导致"starts=1 ⇒ 零崩溃"这条判据本身不成立；现已改为只在真正 collect 时自增（见 `06_tests/README.md` v1.13）。另：**Y-4 的交叉证据在 168h 库中不可得**（hb 未存 payload、抽干列缺 `clk_hold`）⇒ 本轮按本文件口径记"未验证"，下一轮起由新增四列实证。详见 `02_docs/32` §8.4.1/§8.4.2。 |
| v1.2 | 2026-11-04 | 砚青 | **M3 判据改双条件（决策类，用户 2026-11-04 拍板）**：Y-2 / M-3 阈值由"全程 ≥99%"改为"**受控窗口 22:00–08:00（完整 10 h）≥99%**"，M-4 同步改为"受控窗口内 ≤1%"；**全天值必须同时报出但不判 F**。理由与防 p-hacking 的约束见 `02_docs/32` §8.6。**同时补齐 G5 门的隐含前提**：8 h 门控**必须落在夜间窗口**（2026-10-26 那轮通过靠的是 21:34→05:34 的天然夜间，白天跑 8 h 必不过，原文未写明）。⚠️ 本条与 `02_docs/22` 纪律 2「判据只认全程」的例外关系已在 `22` 就地留痕。 |
