jiangtao-ml/ESP32_C3_Gateway/02_docs/29_商用级优化方案_2026-10-26.md

# 29 商用级优化方案（评估 + 改动清单 + 验收标准）

> 最后更新：2026-10-26 砚青 新增。本文件是**评审用施工单**，不是验收记录。
> 状态：`方案待批` —— **未落盘任何代码改动**（本次会话对 `01_firmware/` 与 `06_tests/` 零写入，可用 `git status` 核对）。
> 签发规则：本方案由砚青编写，**执行后必须由 Codex / Claude 或用户复核**，砚青不得自审自签（`PROGRESS §铁律`、`27 §RV-06`）。

---

## §0 一页结论

### 0.1 先说三件事（避免误读本文件）

| # | 事实 | 含义 |
|---|---|---|
| 1 | **接收端已经是接近商用级的成熟度**，固件不是 | 2669 行里有 epoch 世代判定、三线程解耦、WAL、对账恒等式、缺口三层归因（空口/接收端/内核）、`--selftest` 构造数据集自检。这些不是学生作业水平。**真正的短板在固件侧 4 处 + 服务化 1 处。** |
| 2 | **"商用级"在本项目里有天花板** | `26_级别声明与范围边界.md` 已裁定 **L1 实验室样机**：不做隔离、不打样 PCB、不做 EMC 认证、不做批量一致性。本方案所有指标都在**单台、非隔离、直焊洞洞板**的边界内成立。**任何写成"商用级"的对外表述都必须带上这个边界**，否则是虚假宣传。 |
| 3 | **改固件 = 8h 门禁观察窗归零** | 现在正在等 G5 8h 门控。改代码后再跑，等于把"环境未知"和"新代码未知"叠在一起。**§8 给了两条路线，我明确推荐 A。** |

### 0.2 与 10-26「现在先别优化代码」指令的关系
你当时的原话是「你优化一下代码，**现在先别优化代码**」，随后转去准备旧电脑。本文件即"先出方案、批了再改"的产物 —— 方案不动盘，改动权在你。**本文件不构成对那条指令的解除**，需要你一句话确认。

### 0.3 优化能拿到什么、拿不到什么
- **能拿到**：① 时钟回退这一类"必然发生的定时炸弹"被拆掉；② 假的运维指标变成真的；③ 崩溃能自愈且能被看见；④ 版本可追溯；⑤ 7×24 无人值守能落地。
- **拿不到**：拿不到"商用产品"的资质。隔离、EMC、第三方检测、批量一致性这四项不是代码问题，是硬件与流程问题，L1 明确不做。

---

## §1 现状基线（客观清点）

### 1.1 规模
| 组件 | 位置 | 行数 | 成熟度判断 |
|---|---|---:|---|
| 固件主逻辑 | `01_firmware/esp32c3_gateway/esp32c3_gateway.ino` | 1407 | 功能完整、非阻塞、状态机清晰；**缺容错纵深** |
| 固件配置 | `.../config.h` | 284 | 常量集中、注释带历史根因（优良） |
| 接收端 | `06_tests/udp_collect.py` | 2669 | **准商用**，缺服务化与平台适配 |
| 解析/换算/入库 | `06_tests/db_proto.py` | ~450 | 单一职责，读 CSV 字段字典 |
| 字段字典 | `05_hardware/STB3-125_字段字典.csv` | 39 行 | **唯一事实来源** |

### 1.2 已经达到商用级的要素（这些不用再改，别再"优化"掉）
1. **三线程解耦**：T1 收包只做 `recvfrom` 入队，T2 落库，T3 统计 —— 落库慢不会丢包（`Q_MAX=20000`）。
2. **原始流水不可再生优先**：`udp_packet` 每包立即 `commit`，宁可多一次 fsync 也不丢证据。
3. **世代（epoch）机制**：seq/poll 计数回退即切世代，避免重启被算成上千"重复包"（这是很多人踩的坑，本仓库已解决）。
4. **对账恒等式**：`期望行 = 收到 + 未发出 + 网络丢失 → 残差`，缺口不是"猜"出来的，是算出来的。
5. **缺口三层归因**：`udp_rcvbuf_errors` / `nic_rx_dropped` / `rx_missed` 分开记，能区分"空口丢"与"接收端丢"。
6. **fail-closed 解密**：错解一律 `None`，脏数据比丢包严重（`decrypt_frame` docstring 已写明）。
7. **同秒撞车四因区分**：`SAME_SECOND`/`CLOCK_STEP`/`COLLIDE`/首包分开处理，没把分辨率伪影当故障（第一版错过并被记录下来）。
8. **`--selftest` 构造数据集自检**：不需要设备就能验统计引擎，这是回归测试。
9. **在线备份 + WAL checkpoint**：`VACUUM INTO` 每 24h、`TRUNCATE` 每 6h。
10. **字段字典 CSV 驱动**：新增点位不改代码，改 CSV。

### 1.3 看起来做了、实际没做的（本方案的主要靶子）
| 表象 | 实测事实 | 出处 |
|---|---|---|
| 心跳带 `queue`/`dropped` | **硬编码 `0`**，不是真队列 | `.ino:756` |
| 有 WiFi 重连计数 | `g_reconnectCount` 只涨不上报，云端看不见 | `.ino:83` |
| 有 NTP 重同步 | 重连后 `configTzTime` **可把时钟往回拨** ⇒ `CLOCK_STEP` ⇒ Y-4 判 F | `.ino:493` |
| 环境自检含文件系统检查 | `open("/proc/mounts")` **在 Windows 静默跳过**，等于没检 | `udp_collect.py:2386` |
| 数据自动可恢复 | 无看门狗，死锁 = 静默停采（`R-02` 开放） | 全局 grep 无 `esp_task_wdt` |
| 版本可追溯 | `fw_ver` 是**接收端命令行参数**，固件自己不报 | `udp_collect.py --fw-ver` |

---

## §2 七维度差距分析

严重度：**P0 = 影响 168h 判据或会造成"假通过"**；P1 = 影响可运维/可维护；P2 = 增强。

| 维度 | 当前能力 | 商用级要求 | 差距 | 级别 |
|---|---|---|---|---|
| **稳定性** | 非阻塞状态机 + WiFi 周期重连；无看门狗 | 异常自愈 + 自愈可观测 + 不回退 | 死锁静默停采；复位次数不可见 | **P0** |
| **数据准确性** | `raw` 78B 全量上行 + `--verify-raw` 可复算；工程量双口径并存 | 单一事实来源 + 双口径一致性可证 | ① D-07 双口径口径未声明谁是权威 ② D-10 电量公式差约 3 倍 ③ **心跳 `queue/dropped` 是假值** | **P0** |
| **完整性与一致性** | 对账恒等式 + 三层缺口归因 + `seq` 每轮 +2 | 缺口 100% 可归因 | 已基本达标；缺"每轮是否成对到达（hb+data）"的显式表 | P1 |
| **异常处理** | 六种失败原因上行 + `type:"err"` 行 + `event_log` | 任一失败 3 分钟内可定位 | 已达标。差的只有"告警推送"（现在只落日志） | P1 |
| **容错与重试** | 固件 3 段降级 + 段间 4ms 静默；接收端 `--repair` | 重试有界、不污染指标 | 固件 UDP 发送失败**直接丢弃且不计数不重试**（`.ino:783`）；WiFi 重连固定 5s 无退避 | **P0** |
| **性能效率** | 1 Hz、CPU/内存自采样、`COMMIT_SECS=2` 批提交 | 资源占用有基线、可长跑 | 已达标。缺长跑资源趋势的自动判据（人眼看曲线） | P1 |
| **可维护性/可扩展性** | 字段字典 CSV 驱动；参数化 CLI | 新增点位 ≤30 分钟、不改业务代码 | **39 字段名在固件里是手抄第二份**（与 CSV 双份维护）；常量硬编码在 `udp_collect.py` 顶部 | P1 |

---

## §3 优化方案与具体改动

> 每条给出：问题 → 根因 → 改哪里 → **怎么改** → 风险 → **怎么验证**。
> 代码为**示意实现**，不是最终提交版本；落盘前需复核。

### P0-1 时钟回退钳位（拆掉 `CLOCK_STEP` 死结）★最高优先

**问题**：WiFi 掉线 → 重连 → `g_ntpResyncPending=true` → `configTzTime` 重新对时 → 本机无外部晶振、RTC 日漂 0.9–4.3 s ⇒ SNTP 把时钟**往回拨** ⇒ 1 Hz + 秒级 `ts` 必然撞上已占用的秒 ⇒ 接收端记 `CLOCK_STEP` ⇒ **Y-4 = 0 ⇒ 168h 总体判 F**。这是"跑完 7 天才发现"的类型。

**根因**：`configTzTime` 无条件接受 SNTP 结果，没有"时钟只许前跳"的钳位。

**改哪里**：`esp32c3_gateway.ino` 新增 `ntpApplyWithGuard()`，替代 3 处 `configTzTime` 调用（`:498`、`:515`，以及后续同类）。

**怎么改**（示意）：
```c
// ---- 新增：时钟单调护栏 ------------------------------------------------
static uint32_t g_clkHoldCount = 0;      // 被拦下的回退次数（上心跳）
static time_t   g_clkLastGood  = 0;      // 上次被接受的墙上时间

// 只许前跳：SNTP 结果早于 g_clkLastGood 时不接受，保持旧时钟。
// Δ>CLK_BIG_STEP_S（默认 3600）视为"真的错了"，仍接受并单独计数（避免永久卡死）。
static const int32_t CLK_BIG_STEP_S = 3600;

static void ntpApplyWithGuard(const char *why) {
  configTzTime(NTP_TZ_INFO, g_ntpPrimary, NTP_SERVER_2, NTP_SERVER_3);
  // SNTP 是异步的，首个回包在几十~几百 ms 后到；此处只能"挂标志"，
  // 真正的判定放在 ntpTick 的下一次检查里（见 ntpClampTick）。
  g_clkGuardPending = true;
}

// 在 ntpTick() 里，ntpHasReply() 成立之后调一次
static void ntpClampTick() {
  if (!g_clkGuardPending || !ntpHasReply()) return;
  g_clkGuardPending = false;
  time_t now = time(nullptr);
  if (now < 1600000000) return;                    // 明显未就绪
  if (g_clkLastGood && now < g_clkLastGood) {
    int32_t back = (int32_t)(g_clkLastGood - now);
    if (back <= CLK_BIG_STEP_S) {                  // 小幅回退 ⇒ 拒绝
      struct timeval tv = { .tv_sec = g_clkLastGood, .tv_usec = 0 };
      settimeofday(&tv, nullptr);
      g_clkHoldCount++;
      Serial.printf("[CLK] 拦下 NTP 回退 %ld s（保持 %ld），累计 %lu 次\n",
                    (long)back, (long)g_clkLastGood, (unsigned long)g_clkHoldCount);
      return;
    }
    Serial.printf("[CLK] 回退 %ld s 超过大跳阈值，接受（疑似真错误）\n", (long)back);
  }
  g_clkLastGood = now;
}
```

**风险**：
- `settimeofday` 会与 `getLocalTime` 竞争 —— 单线程 loop，无并发问题，但**必须**在 `ntpTick` 内调用（不要在 ISR）。
- 若 RTC 初始就慢很多（首次对时），`g_clkLastGood` 为 0 直接接受，不受影响。
- **保底做法（若不想改固件）**：接收端把 `SAME_SECOND` 与 `CLOCK_STEP` 从**判据里剔除**，改为只在 `ts` 倒退 **> 5 s** 时记 `CLOCK_STEP`。这是"改判据而不是改代码"，**但必须导师同意**，因为它动了 Y-4 的口径 —— 只有你能去问。

**怎么验证**：`06_tests/ntp_verify.py` 打通后，人为 `WiFi.disconnect()` 3 次，串口应出现 3 次 `[CLK] 拦下 NTP 回退`，且接收端 `event_log` 的 `CLOCK_STEP` 计数**不增加**。

---

### P0-2 心跳里的 `queue`/`dropped` 是假数据

**问题**：`.ino:756` 写死 `(unsigned)0, (unsigned)0`。接收端把它当"发送端积压为 0"写进 `stat_snapshot.q_depth`，报告里出现"队列健康"的结论 —— **这是自证清白式的假指标**，商用交付里最忌讳。

**两条路，我推荐 B**：
| 路 | 做法 | 代价 |
|---|---|---|
| A | 真做发送队列（环形缓冲 + 有界重发） | 引入重复 `seq` 风险（`.ino:793` 明确禁止重传），与 M8 冲突。**不建议** |
| **B** | 诚实化：`"queue":null,"dropped":null`，新增 `"tx_fail":<计数>` | 5 行代码；接收端需容忍 null（`HB_REQUIRED` 不含这两键，已兼容） |

**怎么改 B**：
```c
static uint32_t g_udpTxFail = 0;   // beginPacket/endPacket 失败次数

// buildHeartbeatJson 内，替换 "...\"queue\":%u,\"dropped\":%u"
"\"queue\":null,\"dropped\":null,\"tx_fail\":%lu,\"reconn\":%lu,\"up\":%lu",
(unsigned long)g_udpTxFail, (unsigned long)g_reconnectCount,
(unsigned long)(millis() / 1000UL)
```
`udpSendLine()` 失败分支里 `g_udpTxFail++`。
**同时**：接收端 `Writer._process` 里 `obj.get("poll_ok")` 那组判断保持不动（`queue` 不在必需键内），并在 `build_report` 的"队列"行改为读 `tx_fail`。

**为什么这条是 P0**：它不影响跑不跑得完，但影响**报告可不可信**。168h 报告里出现一个恒为 0 的"健康指标"，评审一眼就会怀疑其余数字。

**验证**：`--selftest` 加一条用例：构造 `queue:null` 的心跳，断言 `store` 不报 `BAD_FIELD`，且 `stat_snapshot.tx_fail` 有值。

---

### P0-3 看门狗 + 复位原因上报（`R-02` 收口）

**问题**：固件无 `esp_task_wdt`。若 `loop()` 内任一 tick 卡死（例如 `udp.write` 遇协议栈异常），设备**静默停采**，云端只看到"没数据了"，与"断网"无法区分。

**改哪里**：新文件 `watchdog.h`（或直接进 `.ino` 顶部）+ `setup()` / `loop()`。

**怎么改**：
```c
#include <esp_task_wdt.h>
#include <esp_system.h>

RTC_NOINIT_ATTR static uint32_t g_bootCount;   // 深睡/复位不丢
static uint32_t g_bootCountNow = 0;

// setup()
g_bootCount++;
g_bootCountNow = g_bootCount;
esp_reset_reason_t rsn = esp_reset_reason();
esp_task_wdt_init(30, true);       // 30 s 超时，超时直接复位（不打印）
esp_task_wdt_add(NULL);            // 喂自己（loopTask）

// loop() 末尾
esp_task_wdt_reset();
```
心跳新增：`"boot":<g_bootCountNow>,"rsn":<rsn编码>`

**⚠️ 必须先做的实测（否则会变成复位循环）**：
1. `esp_task_wdt_init(30,true)` 后，`Serial1.flush()` 在 9600 波特下一帧 83 B ≈ 86 ms —— 远小于 30 s，安全。
2. `WiFi.begin()` 首次连接若阻塞 > 30 s 会复位 ⇒ 建议 **30 s 起，实测 8h 无复位后保持**；若 8h 内 `boot` 增长，说明有真阻塞点，这本身就是**有价值的发现**。
3. `RTC_NOINIT_ATTR` 在断电后归零 —— 这是已知局限，报告中"boot 计数在断电后会重新计"，靠 `esp_reset_reason()` 区分软复位/上电。

**顺带解决一件事**：`rsn` 能让 `R-02` 从"开放风险"变成"已监控"。8h 门控里 `boot` 恒为 1 是一条**硬证据**。

---

### P0-4 固件版本自报（可追溯性最低要求）

**问题**：`fw_ver` 现在是接收端命令行参数，靠人填。人填错 = 报告里的版本是假的。商用可追溯性不接受"人工声明"。

**怎么改**：
- `config.h` 加 `#define FW_VERSION "1.4.0"`（与 `git tag` 对齐，建议同时打 tag）
- 心跳新增 `"fw":"1.4.0"`
- 接收端 `udp_collect.py`：若收到 `fw` 且 `--fw-ver` 也给了，**两者不一致时记 `FW_MISMATCH` 事件**（这是防呆，不是防错）

**成本**：极低。**收益**：168h 报告可以写"本次运行固件 = 1.4.0，与 git tag `v1.4.0` 一致"，这是审计级证据。

---

### P0-5 接收端在 Windows 上的文件系统检查形同虚设

**问题**：`env_check()` 用 `open("/proc/mounts")` 判网络盘。Windows 上 `OSError` 被 `except` 吞掉（`udp_collect.py:2399`），**静默跳过**。而旧电脑正是 Win10（你的方案）⇒ 这条检查 100% 不生效，而"DB 放在网络盘/OneDrive 同步目录"恰恰是 SQLite WAL 最常见的破坏源。

**怎么改**（纯标准库 + ctypes，不装依赖）：
```python
def _fs_kind_win(path: str):
    """Windows：返回 (盘符类型名, 是否远端)。取不到返回 (None, False)。"""
    try:
        import ctypes
        root = os.path.splitdrive(os.path.abspath(path))[0] + "\\"
        t = ctypes.windll.kernel32.GetDriveTypeW(root)
        names = {0: "UNKNOWN", 1: "NO_ROOT", 2: "REMOVABLE", 3: "FIXED",
                 4: "REMOTE", 5: "CDROM", 6: "RAMDISK"}
        return names.get(t, "UNKNOWN"), (t == 4)
    except Exception:
        return None, False
```
`env_check()` 里加分支：
- `REMOTE`(4) ⇒ 硬项失败（网络盘）
- `REMOVABLE`(2) ⇒ 硬项失败（U 盘，会被拔）
- `FIXED`(3) ⇒ 继续检查"是否在 OneDrive/Dropbox 同步目录"（路径含 `OneDrive`/`Dropbox`/`坚果云` ⇒ **硬项失败**，这是 Windows 侧的 WAL 杀手）

**验证**：`--env-check` 在 C 盘、D 盘、网络映射盘、OneDrive 目录各跑一次，四种输出都要对。

---

### P0-6 服务化：7×24 无人值守（缺件）

**问题**：旧电脑方案里没有任何"进程死了自动拉起"的机制。一次 Python 崩溃 = 后面几十小时全空，且**没人知道**。

**新增文件**（两个，共约 30 行）：
1. `06_tests/systemd/udp_collect.service`
```ini
[Unit]
Description=ESP485 168h collector
After=network-online.target
Wants=network-online.target

[Service]
Type=simple
WorkingDirectory=/opt/esp485/06_tests
ExecStartPre=/usr/bin/python3 udp_collect.py --env-check --db /data/run168.db
ExecStart=/usr/bin/python3 udp_collect.py --db /data/run168.db --hours 168
# 只认 SIGTERM：脚本已实现收尾（close db / 落 ended_at / 三次实测待补 G0-0.7）
KillSignal=SIGTERM
TimeoutStopSec=60
Restart=always
RestartSec=5
StartLimitBurst=0
StandardOutput=append:/data/collector.out

[Install]
WantedBy=multi-user.target
```
2. `06_tests/systemd/README.md` —— 三条安装命令 + 一条"开跑后 5 分钟自查"脚本。

**⚠️ Windows 侧的等价物**：旧电脑是 Win10，systemd 用不上。等价方案写进 `04_ai_prompts/11_旧电脑接收端准备指令` 的下一版：
- 任务计划程序「开机启动 + 失败后每 5 分钟重试」（最省事）
- 或 `nssm` 注册服务（更稳，但要装第三方）
- **必须**配合 `powercfg /change standby-timeout-ac 0`（已在 `11` 号文件里）

---

### P1-1 消除 39 字段的"手抄第二份"（可维护性硬伤）

**问题**：`05_hardware/STB3-125_字段字典.csv` 是唯一事实来源，但固件 `buildDataJson()` 里的字段名是**手打的第二份**。改一个点位名 = 改两处，漏一处 = 静默错配（`db_proto` 按名取值，取不到就 NULL，不报错）。

**怎么改**：
- 新增 `06_tests/gen_fields.py`：读 CSV → 生成 `01_firmware/esp32c3_gateway/qi_fields.inc`（`static const char *const QI_FIELD_NAME[39] = {...};`）
- `buildDataJson()` 改为循环生成 `"<name>":<val>`（现在应该是逐字段 `appendf`，改动量中等但收益很大）
- `config.h` 加 `#include "qi_fields.inc"`
- 加生成物校验：`pio run` 前跑一次 `python gen_fields.py --check`，不一致就失败

**风险**：`buildDataJson` 是核心函数，重构有回归风险 ⇒ **必须配 `--selftest` + 一帧真实 raw 的逐字段比对**。建议排到 168h 之后做，**不要赶在门禁前**。

---

### P1-2 配置外置（可运营性）

`COMMIT_SECS / Q_MAX / DISK_LOW_GB / PORT` 等 12 个常量硬编码在 `udp_collect.py:97-107`。商用交付应支持 `--config cfg.json`（未给则用内置默认），让现场不用改代码。

**优先级说明**：L1 单台，收益不高，排在最后。但**需求分析文档**里必须留这个口子（`§6.3`）。

---

### P1-3 报告双出口（JSON）

`--report-out` 现在是纯文本。加 `--report-json`：把 `build_report()` 的关键指标打成结构化 JSON，供看板/告警/后续商业化产品直接消费。改动小（已有 `_sql1` 取值函数），价值高。

---

### P1-4 告警通道（从"发现问题"到"通知到人"）

现在只有控制台 + `log` 文件。商用要求：**GAP > 10 min、磁盘 < 20 GB、`boot` 增长、`quality_conflict > 0`** 四类事件能推出去。最小实现：`--alert-cmd`（收到事件时执行一条命令，用户自己填 webhook / 发邮件）。**不做内置 SMTP**（凭据管理是另一个坑）。

---

## §4 改动清单（逐条可核对）

| 编号 | 文件 | 位置 | 类型 | 估算 | 破坏兼容 | 验证方式 | 建议时点 |
|---|---|---|---:|---:|---|---|---|
| P0-1 | `esp32c3_gateway.ino` | `ntpTick()` `:492` + 新增 2 函数 | 新增+替换 3 处 | +60 行 | 否（新增） | `ntp_verify.py` + 3 次强制断网 | **门禁后立即** |
| P0-2 | `esp32c3_gateway.ino` | `buildHeartbeatJson` `:744` / `udpSendLine` `:783` | 改字段 | +6 行 | **是**（`queue/dropped`→null） | `--selftest` 新用例 | **门禁后立即** |
| P0-3 | `esp32c3_gateway.ino` | `setup()` / `loop()` | 新增 | +15 行 | 否 | 8h 内 `boot` 恒 1 | **门禁后立即** |
| P0-4 | `config.h` + `.ino` | 顶部 / 心跳 | 新增 | +4 行 | 否 | 报告"固件版本"行 | **门禁后立即** |
| P0-5 | `udp_collect.py` | `env_check()` `:2386-2400` | 改 + 新增函数 | +30 行 | 否 | 4 种盘各跑一次 | **随时（不影响固件）** |
| P0-6 | 新增 `06_tests/systemd/*` | — | 新建 | +40 行 | 否 | 装一遍，kill -9 看拉起 | 旧机就位后 |
| P1-1 | 新增 `gen_fields.py` + `.inc` | `buildDataJson` `:620` | 重构 | +40/−60 行 | 否（输出不变） | 逐字段比对一帧真实 raw | **168h 之后** |
| P1-2 | `udp_collect.py` | `:97-107` | 改 | +25 行 | 否 | 默认值与原有行为一致 | 168h 之后 |
| P1-3 | `udp_collect.py` | `build_report()` | 新增 | +50 行 | 否 | `--report-json` 能 `json.loads` | 168h 之后 |
| P1-4 | `udp_collect.py` | `StatReporter` `:1236` | 新增 | +20 行 | 否 | 断网 11 min 看是否触发 | 168h 之后 |

**向后兼容性结论（重要）**：
接收端的 `DATA_REQUIRED` / `HB_REQUIRED` / `ERR_REQUIRED` 是**必需键白名单**，多出来的键不会导致解析失败（`_handle` 只检查缺键）。⇒ **P0-2 / P0-4 加字段，旧接收端也能跑**。这是当前设计的隐形优点，应在需求文档里明确写成"上行协议向后兼容规则：新增字段允许，改名/删字段需版本升级"。

---

## §5 商业化标准（可验收，不是形容词）

### 5.1 可靠性
| 指标 | 目标 | 现有判据 |
|---|---|---|
| M1 采集成功率 | ≥ 97% | `24` 已定义 |
| M2 端到端完整率 | ≥ 96%（8h 门控 ≥ 97.5%） | `24` Y-1 |
| M3 传输送达率 | ≥ 99% | `24` Y-2 |
| M8 重包率 | ≤ 0.01% | `24` Y-3 |
| 无人干预连续时长 | 168 h 零接触 | **新增**：`boot` 恒 1 + 无 `GAP>60s` |
| 崩溃自愈 | ≤ 10 s 恢复 | **新增**：systemd `RestartSec=5` |

### 5.2 可观测性
任一失败能在 **3 分钟内**定位到「哪个段 / 什么原因 / 哪一秒」——现有 `type:"err"` + `event_log` 已满足，**不需改动**。

### 5.3 可追溯性
每条入库记录可回放到原始帧：`raw` 78B（业务侧）+ `udp_packet.payload`（链路侧）双向可达。**已满足**。补 P0-4 后，还能追到"哪个固件版本"。

### 5.4 可运维性
| 项 | 标准 |
|---|---|
| 安装 | ≤ 10 分钟（解压 + `--env-check` + 起服务） |
| 启动 | 单命令 |
| 停止 | `SIGTERM`，60 s 内优雅退出，DB 可读（**待 G0-0.7 三次实测**） |
| 状态查询 | `--report-only` 不干扰在跑的进程 |

### 5.5 可维护性
新增一个 Modbus 点位：改 CSV（1 行）→ 跑生成器 → 重编译，**不碰业务逻辑**。目标 ≤ 30 分钟。达成依赖 P1-1。

### 5.6 安全性（L1 内）
| 项 | 现状 | 标准 |
|---|---|---|
| Web 写操作 | Basic Auth ✅ | 保持 |
| `/status` | **免鉴权** ❌ | L1 可接受（AP 局域网），**M7 收紧** |
| AP 口令 | MAC 派生，不回显 ✅ | 保持 |
| 上行加密 | 支持 AES-128-GCM（`--key-hex`）✅ | L1 默认不开，需求文档列为选配 |
| 明文口令 | 历史提交含 WiFi 密码（策略 A：不改写） | 靠纪律，文档一律写"见 `secrets.h`" |

### 5.7 合规性（面向未来，L2 才做）
数据留存策略、审计日志、时间源可证（NTP 三源 + `ts_ok` 标记）、个人信息（本系统只采电量，无 PII ⇒ **天然低合规风险**，这是商业化的一个卖点，应写进需求文档）。

---

## §6 为商业化需求分析文档预留的支撑信息

> 这一节是给你下一份文档「直接抄」的，不是给我自己看的。

### 6.1 术语与实体（必须先统一，否则需求文档写不实）
| 术语 | 定义 | 唯一标识 |
|---|---|---|
| 设备 Device | 一台 ESP485 网关 | `dev = ESP485-<MAC后6位>` |
| 点位 Point | 一个 Modbus 输入寄存器映射的物理量 | `<字段名>`（CSV 第 1 列） |
| 轮次 Round | 一次完整轮询（成功或失败） | `seq` 每轮 +2 |
| 行 Line | 一次 UDP 上行（hb / data / err 之一） | `seq` 每行 +1 |
| 世代 Epoch | 设备从一次启动到下一位的现象区间 | `epoch_id` |
| 缺口 Gap | 应有而实收未到的行 | 对账恒等式残差 |

### 6.2 接口契约清单（需求文档的"外部接口"章可直接引用）
1. **下行采集**：Modbus RTU，从站 1，9600 8N1，功能码 **`0x04` 只读**，39 寄存器一帧读全（83 B 响应）；降级 3 段 37/37/19 B。**禁止写操作**（合闸/分闸/写寄存器）。
2. **上行传输**：UDP，默认 `8888`，JSON，三类行（`data` / `hb` / `err`），最坏明文 1106 B。**新增字段向后兼容，改名需版本升级**。
3. **配置面**：`GET /`（免鉴权）· `POST /save`（Basic Auth）· `GET /reset`（Basic Auth）· `GET /status`（免鉴权，22 项 + `dev/mode/free_heap`）。
4. **存储面**：SQLite 6 表（`udp_packet` / `meter_record` / `collect_run` / `device_epoch` / `stat_snapshot` / `event_log` + `ingest_cursor`）。
5. **运维面**：`--env-check` / `--report-only` / `--repair` / `--selftest` / `--verify-raw`。
6. **安全面**：AES-128-GCM 帧格式 `1B ver + 12B nonce + ct + 16B tag`。

### 6.3 非功能需求候选（SLA 表，需业务方确认数字）
| 类别 | 候选指标 | 本方案能支撑 | 需业务方拍板 |
|---|---|---|---|
| 可用性 | 单机 99.0% / 月 | 可测 | ✅ |
| 采集周期 | 1 s（可配 1–5 s） | ✅ | ✅ |
| 端到端时延 | ≤ 1.5 s（p99） | 可测（`recv_mono − ts`） | ✅ |
| 数据留存 | 原始包 90 天 / 解析行 3 年 | 需新增清理策略 | ✅ |
| 并发设备数 | L1 = 1；L2 目标 ? | `device_id` 已留口，`EpochTracker` 按 dev 分组 | ✅ **必须问** |
| 网络中断容忍 | 断网 ≤ ? 分钟不丢（本地缓冲） | **当前不支持**（断网期间数据直接丢） | ✅ **必须问** |

### 6.4 需求追溯矩阵雏形（表格骨架，后续逐条填）
| 需求ID | 需求描述 | 实现位置 | 验证方法 | 状态 |
|---|---|---|---|---|
| FR-01 | 1 Hz 采集 39 个输入寄存器 | `.ino` 状态机 | `m5_slave_04.py` | ✅ |
| FR-02 | 失败轮上报失败段与原因 | `buildErrJson` `:767` | `03_logs/G4_real_*.log` | ✅ |
| FR-03 | 断网/重启后数据可区分 | `epoch_id` + `CLOCK_STEP` | `--selftest` | ✅ |
| FR-04 | 时钟单调不回退 | **待实现 P0-1** | `ntp_verify.py` | ❌ |
| FR-05 | 运营指标真实可查 | **待实现 P0-2** | 心跳 `tx_fail` | ❌ |
| NFR-01 | 无人值守 168h | 待 P0-3/P0-6 | G6 长跑 | ⬜ |

### 6.5 必须由业务方/导师拍板的 10 个问题（需求文档的输入，代码答不了）
1. `quality:"00"` 的编码含义（禁止自造第二套）— **老师**
2. `record1/2/3` 里 `0` 与 `F` 的语义 — **老师**
3. 电量公式：`(H×65536)/1000+L` vs 另一解（差 1000 倍），实测差约 3 倍 — **老师**（D-10）
4. 固件是否应停止工程量换算、只发 `raw`（D-07）— **导师**（涉及"单一事实来源"原则）
5. 本系统是否需要支持多台设备并发 — **业务方**
6. 网络中断期间是否需要本地缓存补传 — **业务方**（当前明确不支持，要写进范围边界）
7. 数据留存期限与删除责任 — **业务方**
8. 参考板固件版本以哪版为准 — **老师**
9. `CLOCK_STEP` 判据是否接受"仅 >5 s 才算故障" — **导师**（动 Y-4 口径）
10. 本项目对外是否可称"商用级"、需带怎样的边界声明 — **导师**

---

## §7 仍需补齐的关键项

### 7.1 代码能解决的 → 见 §3（P0-1 ~ P0-6，共 6 条）
### 7.2 代码解决不了的（**列为"不可由开发消除"**）
| # | 项 | 卡住什么 | 归属 |
|---|---|---|---|
| 1 | **验电未确认**（G4-4.1 仍 🟡） | G4 无法签字 | 用户 + 万用表 |
| 2 | 无隔离、无 TVS（`R-01`） | 真机带电必然有主板风险 | 硬件（L1 明确不做） |
| 3 | 直焊不可拆（`R-03`） | 返修成本高 | 已接受 |
| 4 | 无 UPS（`R-09`） | 断电即数据断 | 采购 |
| 5 | 旧机性能未知（`R-08`） | 接收端可能成瓶颈 | 旧机就位后 `--env-check` |
| 6 | 无第三人签字（`R-06`） | 评审不闭环 | 流程 |
| 7 | `udp_collect.py` 未独立评审（`RV-09`） | 2669 行无人复核 | Codex / Claude |

### 7.3 流程性
- **G5 8h 门控必须在焊好的洞洞板上跑**（`24` §5.6），不能拿面包板数据充数
- **G0-0.7**：`SIGTERM` 优雅收尾三次实测（影响 `stop_signal_at` 与 M2 分母）
- **G1**：先跑 8h，看 M2 与 `free_heap` 曲线，再决定改不改

---

## §8 执行顺序（**这一节比 §3 更重要**）

### 路线 A（推荐）：门禁优先，改动随后
```
今晚：现有固件跑 8h（不改一行代码）
  ↓
明早：看三件事 —— ① 掉线次数 ② M2 是否 ≥97.5% ③ free_heap 是否单调下滑
  ↓
分支 A1（M2 过了）：改 P0-1~P0-4 → 再跑 8h 确认 → 168h
分支 A2（M2 没过）：先查 485 与网络（不改代码）→ 修好 → 再跑 8h
```
**理由**：现在改代码，明早你拿到的是"一团混在一起的变量"。**先拿到基线，再动刀。**

### 路线 B：先改再跑
只省一次 8h（约 8 小时），代价是所有未知叠加。**只有在 A2 反复失败、且你认为时间比确定性更贵时才选**。

### 明确反对
**边改边跑**。改完立刻起 168h，中途发现问题就得重来 7 天。

---

## §9 本轮已落地（2026-10-26 21:00 更新）

> 原计划"门禁后再改"，用户 20:53 明确授权「现在可以优化代码了，今天先跑 8h」⇒ 改为**先改接收端、再起跑**。
> 固件侧（P0-1/2/3/4）**本轮未动** —— 原因：本机没有 COM5（`Get-CimInstance Win32_PnPEntity` 只剩 COM3/COM4），
> ESP32 已接在旧电脑上，无法从这台机器烧录。⇒ **今晚 8h 跑的是现有固件**，这恰好等价于原路线 A 的"先拿基线"。

### 9.1 已完成（4 项，全部有实测证据）

| 编号 | 内容 | 验证 |
|---|---|---|
| **P0-7（新发现，最严重）** | **Python 3.13 `_handle` 遮蔽**：`threading.Thread` 自 3.13 起在实例上设置 `self._handle`（`_thread._ThreadHandle`），**把 `Receiver` 的同名回调方法整个遮蔽**。每包抛 `TypeError: '_thread._ThreadHandle' object is not callable`，被外层 `except` 吞成 `PARSE_EXC` 告警 ⇒ **`rx` 恒 0，与"抓不到包/IP 错/防火墙"症状完全相同**。修复 = 回调改名 `_on_datagram`（`udp_collect.py:747`）+ `run()` 入口加可调用性断言 + `--env-check` 增硬项。 | 复现脚本见 `.workbuddy/tmp/host_skew_probe.py` 首轮：`rx 12 (d 0/h 6)` + 12 条 `PARSE_EXC`、`meter_record 0 行`；改名后 `rx 12 (d 6/h 6)`、`meter_record 6 行` |
| **P0-5** | `storage_check()`：Windows 走 `GetDriveTypeW`（REMOTE/REMOVABLE 判硬项失败），Linux 走 `/proc/mounts`（读不到也判硬项，不再静默跳过），**两平台都查云同步目录**（OneDrive/Dropbox/坚果云…，命中即硬项失败） | `--env-check` 在 Win11 C 盘输出`介质 = 本机固定盘（FIXED）`、`结论：通过` |
| **新增：HOST_CLK_SKEW** | `Writer._process` 里比对「固件 NTP 时间」与「本机 CST 时刻」，>5 s 记事件（10 min 节流）。防 `BootAnchor` 被本机时钟带偏导致整世代 `collect_time` 平移而报告看不出来 | 注入 ts−3600 s：`[CLK] 本机时钟与固件差 3600.7 s`，`event_log` 1 条，报告【10】异常事件表出现 `HOST_CLK_SKEW WARN 1 次`，**未重复刷屏** |
| **交付包 v2** | `04_ai_prompts/ESP32接收端_2026-10-26_v2.zip`（58 KB，含修订后的 `00_先读我_指令.md` v2）—— **v1 包作废** | 包内 4 个文件 sha256 已核；`_on_datagram` / `storage_check` / `HOST_SKEW_WARN_S` 均在包内 |

### 9.2 回归证据（改完必须重跑，否则不许起跑）

| 项 | 结果 |
|---|---|
| `python -m py_compile udp_collect.py` | OK |
| `--selftest` | `✓ 全部一致，引擎可复现注入值`（整轮丢 50 / 仅数据丢 20 / 仅心跳丢 10 / 仅 err 丢 3 / 重复 5 / 世代 3 / 时钟回跳 1 / 同秒 1 / unexpl 0） |
| `--env-check` | `结论：通过`（9 条信息项，含`收包回调可调用`） |
| 端到端注入 6 轮（hb+data） | `rx 12 (d 6/h 6/e 0)`、`db 12 行`、`meter_record 6 行`、对账 `期望 11 = 收到 11 + 未发出 0 + 网络丢失 0 → 残差 0（闭合）` |
| `--report-only` 复算 | 报告完整生成，10 个章节齐全 |

### 9.3 偏离原计划的一处（如实记录）
原 §4 说"P1-1 等排到 168h 之后"，本轮**没有**动 P1 任何一条 —— 因为 P1-1（字段名生成器）要重构 `buildDataJson`，属于"改核心函数"，
在没有真机的当晚做，风险与收益不成比例。**保持原计划。**

### 9.4 顺带获得的一条门禁证据（G0-0.7 部分）
Windows 下用 `timeout -s TERM` 杀进程 → `EXIT=0` 但 `collect_run.stop_signal_at`/`ended_at` 均为 NULL、且无报告。
⇒ 证实 **Windows 上 SIGTERM 无法投递**（Git Bash 的 `timeout` 实际是硬杀）。**G0-0.7 在 Win10 上只能用 Ctrl+C（SIGINT/CTRL_C_EVENT）验证**，
这条已写进交接包 v2 的 §7 三条禁令 + "必须看到 `[RUN] 报告已写入`"判据。

---

## §10 变更记录
| 日期 | 作者 | 变更 |
|---|---|---|
| 2026-10-26 | 砚青 | 新建。七维度差距分析 + P0×6 / P1×4 改动清单 + 商业化标准 + 需求文档支撑信息 + 10 个待拍板问题。**未改任何代码**。 |
| 2026-10-26 21:00 | 砚青 | 补 §9：用户授权后落地 4 项（P0-7 Python 3.13 遮蔽 / P0-5 跨平台介质检查 / HOST_CLK_SKEW / 交付包 v2）+ 5 项回归证据 + SIGTERM 在 Windows 不可投递的实测结论。**固件未动（本机无 COM5）。** |
