jiangtao-ml/ESP32_C3_Gateway/02_docs/31_电量公式勘误_2026-10-27.md

# 31 电量公式勘误（D-10 定案）—— `(H*65536)/1000 + L` 是错的

> 最后更新：**2026-10-27 砚青** 依据真机 raw 数据定量定案
>
> 触发：旧电脑 2026-10-27 反馈「A_L 以恒定 +1.00/分钟走字，8h 走了 331 度，而 37W 负载每小时只能 0.037 度，差 1000 多倍」
> 事实来源：`05_hardware/STB3-125_字段字典.csv`、`02_docs/06_QI协议说明.md`、`06_tests/db_proto.py`、真机 raw（`.workbuddy/tmp/{b3real,pio_real}_rows.json`）

---

## 1. 结论（三句话）

1. **刻度确实差 1000 倍**：`A_L` 等电量寄存器的原始单位是 **Wh**，即 0.001 度，不是"度"。
2. **正确公式 = `(H*65536 + L) / 1000`**，结果单位 **度（kWh）**。现行 `(H*65536)/1000 + L` 把低字当"度"直接加了。
3. **不是固件造假**。固件只是**照字段字典实现了这个错公式**，且代码里早已标注"存疑"。固件同时上行 `raw`（78 B 原始寄存器）⇒ **全部历史数据都能用正确公式重算**。

---

## 2. 定量证据（真机 raw，非推算）

`raw` 是 39 个寄存器的原始值，是唯一事实来源。把 `reg14(A_H)` + `reg15(A_L)` 拼成 32 位再看：

| 时间点 | `A_H` | `A_L`(raw) | **错式** `(H*65536)/1000+L` | **正式** `(H*65536+L)/1000` |
|---|---|---|---|---|
| 2026-10-08 12:20:07 | 4 | 58935 | `59197.144` 度 | **`321.079` 度** |
| 2026-10-08 20:55:13 | 4 | 58964 | `59226.144` 度 | **`321.108` 度** |

**三点自洽性检验**：

| 检验 | 结果 |
|---|---|
| 8.5 h 内 raw 增量 | `58964 − 58935 =` **29** |
| 正式增量 | `321.108 − 321.079 =` **0.029 度** = 29 Wh ✓ **与 raw 增量严格一致** |
| 折合平均功率 | `29 Wh / 8.5 h` = **3.4 W**（该时段 `A_power` 均值 2.6 W，max 39 W）✓ 吻合 |

**旧电脑那 8 小时**：错式显示"走 331 度"⇒ 反推 raw 增量 **331** ⇒ 真实 **0.331 度** ⇒ 平均 **41.4 W**，
与它自己测到的 **37 W** 只差 11.8%（负载波动范围内）⇒ **原观察与正确公式完全兼容**。

---

## 3. 为什么"增量"比"绝对值"更有说服力

绝对值论证**不够强**：59197 度 ≈ 6 万度，若电表已装十年、日均 16 度，理论上有那么一丝可能，容易被反驳。

增量论证**无法反驳**：
- 错式 ⇒ 8 h 增加 **331 度** ⇒ 平均功率 **41 kW**。一个实验室插座回路不可能持续 41 kW。
- 正式 ⇒ 8 h 增加 **0.331 度** ⇒ 平均功率 **41 W**。一台待机设备完全正常。

**所以定案依据是增量，不是绝对值。**

---

## 4. 结构论证（这条最硬）

现行公式 `(H*65536)/1000 + L` 存在**量纲不一致**：

- `H` 项：`H*65536/1000` ⇒ **H 每 +1 只贡献 65.536 度**
- `L` 项：`+ L` ⇒ **L 每 +1 贡献 1 度**

同一个 32 位累加器的高字与低字，**单位差了 1000 倍** —— 任何合理的累加器设计都不会这样。

**32 位累加器的标准形态必然是 `H*65536 + L`，然后整体乘一个刻度。**
即正确式只能写成 `(H*65536 + L) * k`。取 `k = 1/1000`（raw 单位 Wh）得度，与 §2 实测吻合。

---

## 5. 附带发现：错式在 `L` 溢出时会导致电量断崖

`L` 是 16 位（raw_max = 65535），溢出时 `65535 → 0` 且 `H + 1`：

| | L=65535, H=k | L=0, H=k+1 | 变化 |
|---|---|---|---|
| **错式** | `k*65.536 + 65535` | `k*65.536 + 65.536` | **暴跌 ≈ 65469 度** |
| **正式** | `(k*65536+65535)/1000` | `((k+1)*65536+0)/1000` | **+0.001 度**（连续） |

⇒ 这不仅是"当前值放大 1000 倍"，还是**一个定时炸弹**：一旦 `L` 溢出，电量会瞬间掉 6.5 万度。

> 当前 `L ≈ 58965`，距 65535 只剩 **6570 Wh**。按 41 W 估算约 **160 h**，按 3.4 W 估算约 **1930 h**。
> **也就是说 168 h 长跑期间"很可能"不会溢出，但随时可能，且一旦溢出就是一条无法解释的负跳变。**
> ⚠️ 这个隐患独立于刻度问题，**即使不改刻度也必须修**，否则 168 h 报告的"电量单调性"判据会被它打穿。

---

## 6. 固件为什么这样：照文档实现，且已标注存疑

`.ino:864-866` 与 `:894` 两处：

```c
//   文档 / 字段字典写 (H*65536)/1000 + L；若该字段真实语义是"32 位累加器、单位 0.001 度"，
//   正确式应为 (H*65536 + L)/1000 —— 两者相差 1000 倍。此处按文档实现，不擅自改口径。
pEnergy[i] = (double)rH * 65536.0 / 1000.0 + (double)rL;   // 度
const double energy = (double)rH * 65536.0 / 1000.0 + (double)rL;   // 度（公式同上，存疑）
```

`06_tests/db_proto.py:29-30` 也早写了同样的疑问，且 `:116` 按字段字典实现、而 `:220` 的**单调性检查却用正确的 32 位拼接** —— 同一份代码里两套口径并存。

**⇒ 这不是新问题，是长期挂着的 D-10；本轮用真机数据把它定案。**

> 另需更正一条长期记忆：MEMORY 里写「固件只搬运原始值、不做工程量换算」——
> 对电量字段**不成立**，固件确实做了换算（`pEnergy` / `energy`）。其余字段仍只搬运。

---

## 7. 修复方案（4 处，全部需留痕）

| # | 文件 | 改动 | 是否需烧录 |
|---|---|---|---|
| 1 | `01_firmware/esp32c3_gateway/esp32c3_gateway.ino` | `:866` `:894` 两处改 `(rH*65536.0 + rL)/1000.0` | ✅ **是** |
| 2 | `05_hardware/STB3-125_字段字典.csv` | `conv` 列 4 行（A/B/C/合相）改 `(H*65536+L)/1000` | 否 |
| 3 | `02_docs/06_QI协议说明.md` | §4 的 4 条公式（`:197/212/227/238`） | 否 |
| 4 | `06_tests/db_proto.py` | `:114-116` 的 conv 分支改正确式（并对旧库做重算说明） | 否 |

**历史数据可完整修复**：因为固件全程上行 `raw`，`meter_record` 里也有 `raw_hex`，
可以直接用正确公式从 `raw` 重算电量列，**不需要重跑 168 h**。这是"raw 全量上行"设计的直接回报。

**为什么建议固件也改**（而不只改 PC 侧）：
如果老师那边直接消费固件 JSON，会拿到 `59197.144` 这个错值；只改 PC 侧等于把错误留在接口上。

### 7.1 执行结果（2026-10-27 21:5x 砚青，**已落地**）

| # | 文件 | 状态 | 验证证据 |
|---|---|---|---|
| 1 | `esp32c3_gateway.ino` **`:875`**（`pEnergy[i]`）· **`:903`**（`energy`） | ✅ 已改 | 双模式编译：`SELFTEST=0` = `1,089,215 / 49,568`、`SELFTEST=1` = `1,081,561 / 49,408`，**0 error / 0 warning**。⚠️ 体积与改前**逐字节相同**（仅浮点运算结合顺序变化，指令数不变）——不是没编到，日志有 `Compiling main.cpp.o` |
| 2 | `05_hardware/STB3-125_字段字典.csv` | ✅ 4 行 | 逐行 diff 确认**仅这 4 行**变化；字节数 `2348 B` 与改前一致（sed 曾把 CRLF 转 LF，已修复并复核 40 行全 CRLF） |
| 3 | `02_docs/06_QI协议说明.md` | ✅ `:197/212/227/238` | 四条公式，逐行 diff 确认仅此 4 行 |
| 4 | `06_tests/db_proto.py` | ✅ `:114` 匹配键 + `:116` 实现 | ⚠️ 匹配键**必须与 CSV 的 `conv` 列字面一致**，否则分支不命中、**静默退回** `float(raw)`（错 1000 倍且不报错）。`--demo` 复算得 `A_L = 320.98` 度（旧值 59093）✓ |
| 5 | `06_tests/M5_真机联调操作卡.md:439-442` | ✅ 4 行 | **本轮新发现**的残留（现行操作卡，不属历史记录） |
| 6 | `esp32c3_gateway.ino:831-832` 注释 | ✅ | 同上，conv 取值列举 |

**残留扫描结论**：全仓已无旧式实现。仍出现旧式字样的仅三类，**均属故意保留**——①`.workbuddy/tmp/base_check/gw/`（HEAD 基线快照，对照用）；②`.workbuddy/memory/` 与 `04_ai_prompts/04_*`（历史留痕，按铁律「历史文档不要改成现值」）；③`02_docs/30`/`31` 本身（勘误说明必须引用旧式）。

---

## 8. 验证路径（**不依赖电表屏显**）

> **2026-10-27 更正**：原 §8 把"现场看屏显累计电量"当作终极判据。该判据**不可得**（表计屏显看不到），
> 且事后复核发现它本来就是**最弱**的一条。以下三条路径**完全不依赖任何外部读数**，其中路径 ① 已在手，
> 结论已闭合。屏显降级为"锦上添花的可选项"（见 §8.4）。

### 8.1 路径 ①：双通道交叉标定（**已在手，最硬**）

旧电脑观察到的现象本身就是一组完美的标定数据。把它拆成两路**互相独立**的测量：

| 通道 | 来源 | 8 h 数值 | 折合 |
|---|---|---|---|
| **A 路：寄存器增量** | `A_H/A_L` raw 差 | `A_L` 走字 **331** | 若单位=度 ⇒ 331 度；若单位=Wh ⇒ **0.331 度** |
| **B 路：功率积分** | `A_power` 逐秒积分 | 负载 **37 W** × 8 h | **0.296 度**（296 Wh） |

**判读**：

- 按 **Wh** 口径：A 路 `0.331` vs B 路 `0.296` ⇒ 偏差 **11.8%**（负载非恒定的正常范围）⇒ ✅ **两路吻合**
- 按 **度** 口径：A 路 `331` vs B 路 `0.296` ⇒ 偏差 **1118 倍** ⇒ ❌ 荒谬

**两条独立测量只在"Wh"口径下自洽** —— 这就是标定，且**不需要屏显**。

### 8.2 路径 ②：排除"倍率 / CT 变比"假设（**决定性**）

§8.1 的 B 路还堵死了唯一剩下的备选假设："raw 是度，但表计有 1000 倍 CT 变比/倍率"。

**若真有 1000 倍倍率，它必须同倍数作用于电流、功率，不可能只作用于电量。** 实测三件套：

| 字段 | 实测 | 与 37 W 负载的一致性 |
|---|---|---|
| `A_voltage` | ≈ **220 V** | 正常市电 ✓ |
| `A_current` | ≈ **0.16 A** | `220 × 0.16 = 35.2 W` ≈ 37 W ✓ |
| `A_power` | ≈ **37 W** | 与 `U×I` 自洽 ✓ |

若有 1000 倍倍率，`A_current` 应为 **168 A**（实验室插座线径根本撑不住），`A_power` 应为 **37 kW**。
实测三个值全部自洽于 **37 W** ⇒ **"只放大电量、不放大功率"的倍率在物理上不存在**。

⇒ 电量"看起来大 1000 倍"的**唯一**可能根因 = **公式把 Wh 当度**。备选假设已排除，**无需屏显也能定案**。

### 8.3 路径 ③：结构自洽（不依赖任何数据）

错式 `(H*65536)/1000 + L` 中，同一个 32 位累加器的高字与低字**单位差 1000 倍**（§4）；
且 `L` 由 `65535 → 0`（`H` 4→5，**正常进位**）时错式**暴跌 65469.464 度**，正确式连续 `+0.001` 度（§5）。

一个"合法"的计量公式不可能在正常进位时产生 6.5 万度的负跳变。**这条纯逻辑，零外部输入。**

### 8.4 屏显（降级为可选项，非阻断）

若哪天方便，看一眼屏显累计电量可作**额外**佐证：≈ **321 度** ⇒ 与本勘误一致；≈ **59197 度** ⇒ 才需回头查倍率
（但 §8.2 已把这条路堵死，出现该值只可能是表计自带倍率显示而寄存器已折算，仍需以 §8.1 为准）。

⚠️ 现场安全：开箱前**断电 + 验电**（`02_docs/26` / `06_tests/M5_真机联调操作卡.md` §1）。无万用表不开箱。
**本勘误定案不要求开箱。**

### 8.5 上电后的可选补强：已知负载标定

若想再加一道实物级验证（**不要求，且需市电安全前提**）：接一只标称功率已知的纯阻性负载跑固定时长，看 `raw` 增量。

| 负载 | 时长 | 理论电量 | 期望 `raw` 增量 | 正式式 | （错式会读成） |
|---|---|---|---|---|---|
| 1500 W 电水壶 | 10 min | **250 Wh** | **≈ 250** | `+0.250` 度 | `+250` 度 |

差 1000 倍 ⇒ 一眼可辨，无需屏显。⚠️ 前提：确认该支路容量 ≥ 2000 W、**断电接线后验电**、**充电宝供电 + 拔 USB**。

---

## 9. 待确认 / 待决策

| # | 事项 | 谁定 | 状态 |
|---|---|---|---|
| Q1 | ~~现场读出电表屏显示数（321 还是 59197）~~ | 用户 | **已取消**（屏显不可得；§8.1–8.3 已独立闭环，不再阻断） |
| Q2 | 是否**连同本轮固件加固（P0-1~P0-4）一起烧录**这批公式修正 | 用户 | **待拍板**（建议：一起烧） |
| Q3 | 老师那边是否也消费 `A_L`/`H`/`L` 字段？若消费，需同步告知口径变更 | 用户/导师 | 待确认 |
| Q4 | 已入库历史数据的电量列是否重算（可用 `raw_hex` 全量重放） | 用户 | **待拍板**（建议：重算，成本低且不必重跑） |
| Q5 | 是否补做 §8.5 已知负载标定 | 用户 | **可选**（非阻断，需市电安全前提） |

---

## 10. 变更记录

| 日期 | 作者 | 变更 |
|---|---|---|
| 2026-10-27 | 砚青 | 新建。依据真机 raw 定量定案 D-10：正确式 `(H*65536+L)/1000`；并发现错式在 L 溢出时导致电量断崖（独立隐患）。**代码暂未改**，等 Q1 现场示数确认 |
| 2026-10-27 | 砚青 | **§8 重写**（事实类更正）：原"终极验证 = 看屏显"不可得且本为最弱判据，改为三条不依赖外部读数的路径 —— ①双通道交叉标定（A 路寄存器增量 vs B 路功率积分，仅 Wh 口径自洽）②排除倍率/CT 变比（`U`×`I` 自洽于 37 W，倍率假设物理不成立）③结构自洽。Q1 取消，新增 Q5（已知负载标定，可选） |
| 2026-10-27 | 砚青 | **§7.1 执行结果**：4 处 + 2 处新发现残留（M5 操作卡 / 固件注释）**全部落地**；双模式编译 0 error 0 warning、体积不变；`db_proto.py --demo` 复算 `A_L=320.98` 度。残留扫描确认全仓无旧式实现 |
