jiangtao-ml/ESP32_C3_Gateway/04_ai_prompts/13_固件商用级加固复核指令_2026-10-27.md

# 13 固件商用级加固 —— 复核 + 优化指令（2026-10-27）

> 用法：把本文件整篇交给 **Codex 或 Claude Code**，让它在本仓库根目录 `ESP32_C3_Gateway/` 下执行。
> 产出物请直接落到**对话回复**，需要改的代码请**直接改文件**（见 §4 的分级规则）。
>
> 事实来源：`02_docs/30_固件商用级加固_2026-10-27.md`（本批改动说明）· `02_docs/29_商用级优化方案_2026-10-26.md`

---

## 0. 你的角色与硬约束

你是本项目的**第二审查者**。项目有一条铁律：**作者不得自审自改**。
本批固件改动由 WorkBuddy（砚青）完成，所以**你必须复核**。

**已知环境事实（不要重新发明，也不要"顺手纠正"）**：
- 编译链 = PlatformIO 6.2.0 + `pioarduino 55.03.311`（= Arduino 3.3.11 / IDF 5.5.5）
- 编译工程 = `01_firmware/pio_verify`（靠 `-I${PROJECT_DIR}/../esp32c3_gateway` 拉主固件，
  编的是**同一份源码**；**不要**在 `01_firmware/esp32c3_gateway/` 下新建 `platformio.ini`）
- 编译命令：`cd 01_firmware/pio_verify && pio run -e esp32c3`
- **双模式编译是硬要求**：`config.h:192` 的 `RS485_MODE_LOOPBACK_SELFTEST` 必须 `0` 和 `1` 各编一次，
  且**编完必须复位为 0**（出货形态）
- **基线（HEAD `71c19ca` 实测，2026-10-27 更正）**：
  `SELFTEST=0` = Flash **`1086171`** / RAM **`49512`**；`SELFTEST=1` = **`1078983`** / **`49384`**；默认 flags **零警告**
  > ⚠️ 仓库旧文档里的 `1070975` / `49348` 是 **M6 时代过期数**；`02_docs/24:102` 的 `1,086,695` 是 10-21 那轮的值。
  > **都不要再引用。** 本基线是把 HEAD `71c19ca` 三个源文件导出到 `.workbuddy/tmp/base_check/` 单独编译得来，
  > 与 `02_docs/21` NFR-04 记录完全吻合。
- 本批实测：`SELFTEST=0` → `1089225` / `49568`（**+3054 B / +56 B**）；`SELFTEST=1` → `1081561` / `49408`（**+2578 B / +24 B**）；
  `.rtc_noinit = 8 B`；**零警告**

---

## 1. 本次改了什么（先读这个，再看代码）

四个 Codex 自己提的 P0，**编号沿用 Codex 原报告 P0-1~P0-4**：

| 编号 | 内容 | 主要落点 |
|---|---|---|
| P0-1 | 时钟回退钳位（拆 `CLOCK_STEP` 死结） | `ntpApplyWithGuard()` / `ntpClampTick()` / `buildTimestampIso()` |
| P0-2 | 心跳诚实化（`queue`/`dropped` → `null`，新增 `tx_fail`/`reconn`/`up`） | `buildHeartbeatJson()` |
| P0-3 | 看门狗 + `esp_reset_reason` + `RTC_NOINIT` boot 计数 | `wdtInit()` / `wdtFeed()` / `bootInfoInit()` / `resetReasonStr()` |
| P0-4 | 版本自报（心跳带 `fw`） | `buildHeartbeatJson()` |

改动文件：`config.h`（+68）、`esp32c3_gateway.ino`（+243/−17）、`web_config.h`（**0**）。

**设计意图（我做的两个取舍，请重点审这两个）**：
1. **时钟钳位采用"源头拉回 + ts 严格递增兜底"双保险**。
   刻意**不采用**"ts 冻结等真实时间追上"，因为 `06_tests/udp_collect.py:640`
   对同秒撞车**直接丢弃该行**（`StoreResult.SAME_SECOND` 不入库），冻结会连续丢行、直接伤 M2。
2. **ts 护栏只在 `cur < last` 时 `+1`，同秒不 `+1`**。
   若同秒也 `+1`，一旦轮询周期略快于 1 s 就会每轮 `+1` 并**持续累积超前**。

---

## 2. 请重点挑这 7 个地方（按怀疑强度排序）

1. **`settimeofday()` 与 `getLocalTime()` / `time()` 的交互**
   拉回时钟后，`buildTimestampIso()` 拿到的 `now` 是否会与 `g_clkLastGood` 产生**振荡**
   （拉回 → 下一轮又判为"没回退" → 再被 SNTP 拨回 → 再拉…）？有没有可能死循环式对拉？

2. **`RTC_NOINIT_ATTR` 的 magic 校验边界**
   `g_bootMagic`/`g_bootCount` 两个变量**是否可能只写成功一个**（掉电瞬间）导致 magic 对但 count 是旧值/随机值？
   是否需要把 magic 放在**后面**写（写顺序屏障）？

3. **`esp_task_wdt_add(NULL)` 的幂等性与 `ESP_ERR_INVALID_ARG`**
   我把 `ESP_ERR_INVALID_ARG` 当作"已订阅 ⇒ 视为成功"。这个假设在当前 core 下成立吗？
   如果 core 其实**没**订阅、只是参数非法，我们会误以为狗开着而实际没开。

4. **`wdtFeed()` 的覆盖充分性**
   目前只在 `loop()` 第一行喂一次。`webTick()` 里的 `handleClient()`（配置页 ~8 KB）
   在最坏情况（弱网、客户端慢）下会不会把单次迭代拖过 30 s？`stateTick()` 呢？

5. **`ntpClampTick()` 的置位/清零时序**
   `g_clkGuardPending` 在 `ntpApplyWithGuard()` 置位、在 `ntpClampTick()` 里只要
   `ntpHasReply()` 成立就清零。若 SNTP 回包**很慢**（> 数秒），这几秒内 `ntpClampTick` 每次都会
   因 `ntpHasReply()==false` 直接 return（不清零），逻辑对吗？会不会漏掉"回包前时钟已被改"的情况？

6. **心跳字段的接收端兼容性**
   请**独立验证**（不要信我的结论）：`06_tests/udp_collect.py` 收到 `"queue":null` + 6 个新字段时
   是否真的不报 `bad_field`、不进异常分支。关键点：`HB_REQUIRED`（约 `:120`）、`:845`、
   `:1060`、以及 `:1114` 附近对 hb 行的 payload 处理。

7. **`buildTimestampIso()` 的 `ts_ok` 语义有没有被改动**
   要求：`ts_ok` 仍严格等价于"本轮会话确已收到 NTP 回包"，**不得**因为护栏而改变。

**另外请自行寻找我没列出的问题** —— 上面只是我最担心的，不是全部。

---

## 3. 不许碰的东西（碰了就是引入回归）

- **`web_config.h` 一行都不要改**：`/status` 的 `queue`/`dropped` 仍发 `0` 是**有意保留**的
  （"老师 22 项"契约，属决策类，等导师拍板）。你若认为该改，写进报告，**不要动手**。
- **`FW_VERSION` 不要擅自升版**（同上，决策类）。
- **不要改 `06_tests/udp_collect.py`**：本轮已确认接收端兼容；如有必要改，只写建议。
- **不要动 485 侧任何逻辑**（帧表、超时、解析、`raw` 组装）—— 本批完全不涉及。
- **不要 `git add -A`**（会吞掉其他角色在途的改动）。

---

## 4. 输出要求（两阶段，**都要做**）

### 阶段 A —— 审查报告

- 按 §2 逐条给结论：**成立 / 不成立 / 需要实测**，每条给 `文件:行号` 与最小复现或推理链。
- 明确指出**我漏掉的问题**（有新发现请单列，标明严重度 P0/P1/P2）。
- 对 P0 级问题给出**示意补丁**（不要只描述）。

### 阶段 B —— 直接实施（这是必须的，不要只审不改）

按下面的分级**动手**：

| 类型 | 判据 | 你的动作 |
|---|---|---|
| **A 类：事实性缺陷** | 明确的 bug、编译错误、语义错误、边界错误，**无多种合理选择** | **直接改代码**，改完立即双模式编译，然后继续找 |
| **B 类：设计/口径选择** | 有多种合理方案、或会动验收判据/契约/版本号 | **不要改**，列出选项与代价，等我拍板 |

A 类改完，**必须**：
1. `SELFTEST=0` 编一次；
2. `config.h:192` 改 1 编一次，**编完改回 0**；
3. 把两次的 Flash/RAM 与警告数贴出来（对照 §0 的基线）；
4. 若产生新警告，**必须消掉**，不许留。

### 阶段 C —— 最终交付表

| 项 | 内容 |
|---|---|
| A 类实际改动的文件与行数 | |
| B 类待拍板清单（含你的推荐项） | |
| 双模式编译结果（4 个数字 + 警告数） | |
| 你认为**烧录前必须做**的验证项 | |
| 你判断"仍不安全、不该烧"的理由（若有） | |

---

## 5. 一句话验收标准

**如果你认为这批改动烧进去会引入比修复前更糟的故障，请直接说"不要烧"，并给出理由。**
我宁可白写一轮，也不要带着未知缺陷上电。
