jiangtao-ml/ESP32_C3_Gateway/04_ai_prompts/14_RAW自校验复核指令_2026-10-27.md

# 14 RAW 自校验复核指令（`bad=2000` 定性收尾）

> 出令：**2026-10-27 22:2x 砚青（主控 / 本机）**
> 执行方：**旧电脑 `172.16.0.x` 上的 WorkBuddy**
> 目的：把 2026-10-26/27 那轮 8h 报告里 `RAW 自校验 checked=2000 / bad=2000` 这条 WARN **一次性定性收尾**，作为 168h 报告 `Y-6 解析失败率` 的证据。
> 预计耗时：**10 分钟**（大部分在等校验跑完）

---

## 0. 一句话背景（**先读，会影响你对结果的预期**）

主控已在接收端源码里找到这条 WARN 的**根因**，且**数值完全吻合**：

> `openState` 有**两种合法表示**：固件发 4 位 HEX（`"00F0"`），`db_proto.decode()` 返回中文（`"无锁/合闸"`）。
> 字符串直接比对 ⇒ **每一行必然差 1 个字段**。
> 而 `verify_raw()` 的抽样上限**写死 2000 行** ⇒ `checked=2000`。
> ⇒ `2000 行 × 每行 1 个 = bad 2000`。**数学上严丝合缝。**

**所以 `bad=2000` 的预期结论是：自校验脚本的比对口径 bug，不是数据损坏，也不是固件问题。**
主控侧代码**已经修复**（改为把 `openState` 统一到 HEX 再比，见 `udp_collect.py:2113-2121`）。

**你要做的是验证这个结论，不是重新调查。** 如果结果不是这样，那才需要深挖。

---

## 1. 第一件事：确认旧电脑上的脚本是**哪一版**（最关键）

```bash
cd <你放 06_tests 的目录>

# 1-A 这个特征串存在 ⇒ 已修复（新代码里的注释）
grep -n "2026-10-26 那轮 8h 报告里" udp_collect.py

# 1-B 这是修复后的核心逻辑（存在即已修）
grep -n 'want_s = "%04X" % (int(regs\[0\]) & 0xFFFF)' udp_collect.py

# 1-C 记录文件指纹，便于主控核对是否同一份
md5sum udp_collect.py db_proto.py
```

**判读**：

| 结果 | 含义 | 下一步 |
|---|---|---|
| 两条 `grep` **都有输出** | 脚本已是修复版 | 直接进 §2 |
| 只 `1-A` 有、`1-B` 没有 | 半新版本 | 停下，把 md5 报给主控 |
| **两条都无输出** | **旧版脚本**（跑 8h 那次用的） | **停！先别跑校验**，见 §1.1 |

### 1.1 如果是旧版脚本

**不要**用旧脚本跑校验——结果仍是 2000/2000，等于没查。请：

1. 把 `md5sum` 输出报给主控
2. 向主控索取新版 `udp_collect.py` + `db_proto.py`（**两个都要**，`db_proto.py` 的电量公式也变了）
3. 覆盖后重跑 §1 的两条 `grep` 确认
4. 再进 §2

---

## 2. 跑自校验（**用 `--verify-raw`，不是 `--report-only`**）

> ⚠️ **重要区别**：
> - `--report-only` 只是**重出报告**，报告里的 `checked/bad` 读的是库里 `event_log` 的**历史快照**
>   （跑的时候用旧脚本算的 2000/2000）⇒ **不会重算，看不出修复效果**。
> - **`--verify-raw` 才是重新校验**，会用当前代码对 `udp_packet.payload` 里的 `raw` 全量/抽样重算并比对。
>
> 所以要定性必须用 `--verify-raw`。两个都跑一遍也可以（`--report-only` 用来确认报告可复算）。

```bash
# 先确认库路径（按你实际的长跑库名改）
ls -lh *.db

# 2-A 重新自校验（核心，必须跑）
python udp_collect.py --db <你的库.db> --verify-raw

# 2-B 顺带确认报告可复算（P-4 判据，可选但建议）
python udp_collect.py --db <你的库.db> --report-only
```

`--verify-raw` 会：

- 遍历 `udp_packet` 里 `ptype='data'` 且 `parse_status='ok'` 的行
- 用 `raw` 重算 39 字段，与 JSON 里的工程量逐字段比
- 在**库同目录**写一个 `<库名>_rawcheck.csv`（不一致样例，最多 50 条）
- 终端打印：`raw 自校验：N 行，不一致 M 处 → <csv 路径>`

---

## 3. 报什么（照这个格式回，主控一眼能判）

```
【1】脚本版本
  md5(udp_collect.py) = ...
  md5(db_proto.py)    = ...
  1-A 命中 / 未命中
  1-B 命中 / 未命中

【2】--verify-raw 输出
  原文粘贴：raw 自校验：___ 行，不一致 ___ 处 → ___

【3】如果 bad > 0，给出分布（关键：是不是只剩某一类字段）
  head -20 <库名>_rawcheck.csv
  再统计一次字段分布：
  awk -F, 'NR>1{print $2}' <库名>_rawcheck.csv | sort | uniq -c | sort -rn

【4】--report-only 是否正常出报告
  报告文件路径 + 是否报错

【5】库基本信息
  ls -lh <库>.db
  sqlite3 <库>.db "SELECT COUNT(*) FROM udp_packet WHERE ptype='data';"
  sqlite3 <库>.db "SELECT * FROM collect_run ORDER BY run_id DESC LIMIT 1;"
```

---

## 4. 判读标准（主控侧，供你参考）

| 结果 | 结论 | 对 168h 的影响 |
|---|---|---|
| `bad = 0` | 根因确认就是 `openState` 口径 ⇒ **已闭环** | `Y-6` 有证据了，**不阻断** |
| `bad` 很小（几十）且集中在某一字段 | 该字段有末位舍入问题 | 记为已知项，`Y-6` 阈值 ≤0.01% 仍可能过 |
| `bad` 仍 ≈ `checked`（每行 1 个） | **修复没生效**或还有第二个系统性口径 bug | **停下**，把 CSV 发主控 |
| `checked` 远小于数据总行数 | `raw` 字段缺失/长度不是 78 B | 停下，`raw` 可能没全量上行 |

---

## 5. 顺带要查的 3 件（都是 168h 的起跑门，一并回）

| # | 事 | 命令 / 做法 | 为什么要 |
|---|---|---|---|
| **5-A** | **旧电脑的 DHCP 租约与当前 IP** | Windows：`ipconfig /all`；Linux：`ip -4 addr show` + `cat /var/lib/dhcp/dhclient.leases` | 用户已确认是 **DHCP**。若中途换 IP，ESP32 的 UDP 目标失效 ⇒ 数据全断。要评估租约时长和是否有 MAC 绑定 |
| **5-B** | **能否做 MAC-IP 绑定** | 看路由器管理页面是否可访问、有无「DHCP 静态分配/DHCP 保留」 | 这是最稳的办法，避免设静态 IP 引发冲突 |
| **5-C** | **磁盘余量 + 电源计划** | `df -h`（Linux）/ `Get-PSDrive`（Win）；电源计划是否有「从不睡眠」 | `Y-9` 要求全程 ≥10 GB；休眠 = 168h 直接废 |

> 用户已答复「能禁休眠」，请**实际改掉并截图/回显确认**，不要只停留在"能"。
> 168h 期间旧电脑**全程不能睡、不能重启**。

---

## 6. 禁止事项

1. **不要重跑长跑** —— 本次只做校验，不采集。
2. **不要改库**（`--repair` 也先别跑，除非主控明确要求）。
3. **不要带 `--key-hex`** —— 固件发明文，带了会导致所有包 fail-closed 全丢（见 `02_docs/32` G-8）。
4. **不要动 ESP32 / 不要烧录** —— 烧录由主控侧负责。

---

## 7. 回传格式

把 §3 的五段贴回来即可，**不需要额外分析**。主控侧会据此更新 `02_docs/32` 的 C-5 条目并决定是否放行 168h。
