jiangtao-ml/ESP32_C3_Gateway/04_ai_prompts/15_168h收官核验指令_2026-11-04.md

# 15 168h 收官核验指令（三件，纯数据侧，不碰设备）

> 出令：**2026-11-04 砚青（主控）**
> 执行方：**旧电脑 WorkBuddy**（`D:\esp32_collect\` 数据在它手里）
> 预计耗时：**15 分钟**（大头是 56 万行电量重算，纯本地）
> ⚠️ 全程**只读库 + 跑脚本**，不重新采集、不碰 ESP32、不改原始 DB（重算结果写新文件）

---

## 背景（先读 30 秒）

168h 已收官（10-27 22:45 起跑 → 11-03 22:44 优雅收尾，收到 1,157,976 包，对账残差 0）。
主控已按 `02_docs/24` 的 34 条判据对完账：**Y-1/Y-2 两条主判据 F（归因=白天 WiFi 空口拥堵）**，
其余主判据 P。但有 **3 件证据缺口**不补齐就不能出正式判定：

| # | 缺口 | 一句话说明 |
|---|---|---|
| 1 | `openState` 还有 6000 处误报 | 主控 10-27 已在 `udp_collect.py` 修复（统一到 HEX 比），**你跑的是旧脚本** ⇒ 要同步重跑 |
| 2 | `clk_hold` / `boot` 序列没回传 | `CLOCK_STEP=0` 单独不构成"钳位已验证"，要看交叉证据 |
| 3 | **电量公式 D-10 没在真机数据上验证** | 库里 56 万行全带 `raw_hex`，可用**新公式**全量重算——这是 168h 最值钱的验证 |

另外：主控已确认 10-29 两次拔电为**计划内人为断电** ⇒ Y-7 将改判 P，不需要你做什么。

---

## 任务 0：同步新版脚本（**先做，2 分钟**）

主控已打包 `04_ai_prompts/15_sync_2026-11-04.zip`（用户会拷给你），含 3 个文件：

```
06_tests/udp_collect.py            # 135,881 B  含 openState 修复
06_tests/db_proto.py               #  18,544 B  含 D-10 新电量公式 (H*65536+L)/1000
05_hardware/STB3-125_字段字典.csv   #   2,348 B  conv 列已更新（旧 conv 会匹配不到、静默退回 raw 值）
```

**步骤**：

```bash
# 0-A 备份你现在的旧脚本（不要覆盖，重命名）
mv 06_tests/udp_collect.py 06_tests/udp_collect.py.bak_20261104
mv 06_tests/db_proto.py    06_tests/db_proto.py.bak_20261104
mv 05_hardware/STB3-125_字段字典.csv 05_hardware/STB3-125_字段字典.csv.bak_20261104

# 0-B 解压覆盖（zip 内已按项目相对路径组织，解到项目根即可）
python3 -c "
import zipfile
zipfile.ZipFile('15_sync_2026-11-04.zip').extractall('.')
"

# 0-C 验证同步成功（两条 grep 都要有输出）
grep -n '2026-10-26 那轮 8h 报告里' 06_tests/udp_collect.py
grep -n '(H\*65536+L)/1000' 06_tests/db_proto.py 06_tests/udp_collect.py 05_hardware/STB3-125_字段字典.csv
```

三条 grep 全命中 ⇒ 同步成功。**缺任何一条停下报主控。**

---

## 任务 1：`--verify-raw`（预期 bad ≈ 0，5 分钟）

```bash
python3 udp_collect.py --db <run168h 的库路径> --verify-raw
```

- 旧脚本跑会报 `bad=2000`（openState 口径 bug）；
- **新脚本预期 `bad = 0` 或个位数**。
- 顺带把 `--report-only` 也跑一遍（P-4 可复算证据），新报告里的 RAW_CHECK 应为 INFO。

**回传**：`raw 自校验：N 行，不一致 M 处` 原文 + 若 M>0 附 CSV 前几行。

---

## 任务 2：三条 SQL / 小脚本（核心，8 分钟）

> 心跳字段没有独立表，都在 `udp_packet.payload`（JSON）里。SQLite ≥3.22 有 json1 可直接用；
> 如果 `json_extract` 报错，就写个 10 行 python 逐行 `json.loads` 统计——两者等价。

### 2-A `clk_hold` / `clk_back` / `reconn` 分布（Y-4 交叉证据）

```sql
SELECT json_extract(payload,'$.clk_hold') AS clk_hold,
       json_extract(payload,'$.clk_back') AS clk_back,
       COUNT(*) AS cnt
FROM udp_packet
WHERE ptype='hb' AND payload IS NOT NULL
GROUP BY 1,2 ORDER BY cnt DESC LIMIT 20;
```

**主控要看什么**：`clk_hold` 是否**>0**（168h 里 lwip 每 3h 自同步一次，理论必然触发钳位或 ts 护栏）。
若全程 `clk_hold=0` ⇒ `02_docs/24` Y-4 交叉证据判"未验证"，报告里要如实写。

### 2-B `boot` / `reset` 序列（世代对账的最后一环）

```sql
SELECT json_extract(payload,'$.boot')  AS boot,
       json_extract(payload,'$.reset') AS reset,
       COUNT(*) AS cnt,
       MIN(recv_time) AS first_seen,
       MAX(recv_time) AS last_seen
FROM udp_packet
WHERE ptype='hb' AND payload IS NOT NULL
GROUP BY 1,2 ORDER BY first_seen;
```

**主控要看什么**：应为 **3 个世代段**，每段内 `boot` 从小到大单调、`reset` 一致（POWERON/USB/BROWNOUT…）。
10-29 两次拔电对应两个新段的 `reset=POWERON` 或 `BROWNOUT`。

### 2-C **电量全量重算**（D-10 验证，最重要）

库里的 `meter_record` 电量列是**入库时旧脚本算的（错式，放大 1000 倍）**，**不要用它**。
请写一个小脚本从 `raw_hex` 全量重算（56 万行，纯本地）：

```python
# 电量重算规格（D-10）：raw = 78 字节空格分隔 HEX，reg[i] = int(bytes[2i:2i+2],16)
# A 相: H=reg[14] L=reg[15]   B: H=reg[23] L=reg[24]   C: H=reg[32] L=reg[33]   合相: H=reg[37] L=reg[38]
# energy = (H*65536 + L) / 1000    ← 单位：度（kWh）
# 输出四列 CSV: recv_time, phase, energy_kwh   （只存 energy 发生变化的行即可）
```

对四条序列各做三个检查，**把结果直接贴回来**：

1. **单调性**：`energy` 是否全程单调不减（允许相等，不允许下降）
2. **跨进位**：找 `L` 从 ≥60000 跳到 <6000 的时刻（即 65535→0 进位），确认该点 `energy` 变化量是 **+0.0xx 度**（连续），而不是暴跌
3. **收支对照**：`(末值 − 初值) 度` vs `SUM(A_power)/1000/3600 度`（功率积分），两者应在 ±15% 内吻合

**预期**：起跑约 321 度、收尾约 321 + 总耗电量；四相中合相 = A+B+C 之和（±0.01 度内）。

---

## 任务 3：磁盘与文件（1 分钟）

```bash
df -h <数据盘>            # 或 Windows: 看盘剩余空间
ls -lh <run168h.db>       # 确认 1.2GB 完好
sha256sum <run168h.db>    # 主控留档（归档指纹）
```

---

## 回传格式（五段，照抄字段名）

```
【0】三条 grep：命中/命中/命中（或具体缺哪条）
【1】verify-raw：raw 自校验：___ 行，不一致 ___ 处
【2A】clk_hold 分布：（粘贴 SQL 输出）
【2B】boot/reset 序列：（粘贴 SQL 输出）
【2C】电量重算：
     A 相: 初值 ___ 度 → 末值 ___ 度，单调性 ✓/✗，跨进位 ___ 次、连续 ✓/✗
     B/C/合相同格式
     功率积分对照: 电量差 ___ 度 vs 积分 ___ 度，偏差 ___%
【3】磁盘剩余 ___ GB，DB sha256 = ___
```

**不要自行下结论**，原始输出贴回来，判定由主控做。

---

## 禁止事项

1. 不重新采集、不起 `udp_collect.py` 正式监听
2. **不写原始 DB**（`--verify-raw` 只读；重算脚本输出写 CSV 新文件）
3. 不带 `--key-hex`
4. 不动 ESP32、不烧录
