jiangtao-ml/ESP32_C3_Gateway/02_docs/00_阶段与门禁主控表.md

# 00 · 阶段与门禁主控表（**项目唯一主线，先读这张**）

| 项 | 内容 |
| --- | --- |
| 文档 | `02_docs/00_阶段与门禁主控表.md` |
| 版本 | v1.0 / 2026-10-22 |
| 作者 | 砚青（WorkBuddy） |
| 作用 | 把散落的 26 份文档收进**一条主线**：项目走到哪个阶段、每阶段要交什么、现在缺什么、谁能放行 |
| 关系 | 本表是**索引与门禁**，不重复任何内容；细节一律跳到被引用的文档 |

> **只认这一张表判断"现在该干什么"。** 其他文档只在被本表引用时才需要打开。

---

## 1. 为什么之前显得乱（三个乱源）

| # | 乱源 | 具体表现 | 修法 |
| --- | --- | --- | --- |
| 1 | **编号是时间顺序，不是逻辑顺序** | `02_docs/01` 是任务书，`03` 是环境记录，`13/14` 是排障，`21/22` 是需求与方案——同一个阶段的东西被拆到 01 和 21 两处，中间隔着 19 份记录 | 用本表按**阶段**重排；编号不动（两百多处引用，改不起） |
| 2 | **四份文件都像"事实来源"** | `PROGRESS.md`（进度）、`00_context.md`（自封"唯一事实来源"）、`21`（需求基线）、`24`（验收判据） | 分工写死，见 §2 |
| 3 | **没有"门禁"概念** | 做到哪算完、谁签字、什么条件才能进下一步——全靠口头约定 | 本表 §3 的六道出口判据 |

---

## 2. 各文件的分工（**别再看错**）

| 文件 | 回答什么问题 | 不回答什么 |
| --- | --- | --- |
| **本表 `02_docs/00`** | **现在在哪个阶段、下一步做什么、能不能放行** | 具体怎么做 |
| `02_docs/28` | **这个系统怎么跑起来的**（数据流七环 + 故障定位） | 需求与判据 |
| `PROGRESS.md` | 今天/本周发生了什么（**日志**）、历史决策留痕 §8.2 | 需求与判据 |
| `04_ai_prompts/00_context.md` | 给 AI 的**背景与口径**（为什么这样定） | 进度、验收 |
| `02_docs/21` | **需求基线**：要做什么、做到什么程度 | 怎么做 |
| `02_docs/22` | **实现方案**：怎么设计、怎么算指标 | 进度 |
| `02_docs/24` | **验证判据**：怎么测、什么算通过 | 需求为什么定成这样 |

> `00_context.md` 自称"唯一事实来源"是 2026-10 的旧口径，**已不准确**：需求以 `21` 为准，判据以 `24` 为准，进度以 `PROGRESS` 为准。

---

## 3. 六阶段与出口判据

```
S0 立项与需求 ──► S1 设计 ──► S2 实现 ──► S3 验证(台面) ──► S4 确认(真机168h) ──► S5 交付结项
      E0              E1              E2              E3                  E4                E5
```

| 阶段 | 要交什么 | 现有 | 状态 | 出口判据（E） |
| --- | --- | --- | --- | --- |
| **S0 立项与需求** | 任务书 + 需求规格 + 数据字典 + 接口协议 | `01`（冻结 v0.4.1）、`21`、`05_hardware/STB3-125_字段字典.csv`、`02_docs/06` | 🟡 **有条件通过** | 12 条三方差异每条有处置；**待确认项已登记为风险**（见 §6） |
| **S1 设计** | 概要设计 + 详细设计 + 级别边界 | `22`（系统级）、`26`（级别）、`05_hardware/{接线说明,洞洞板操作卡,布局图}` | 🟡 **概要 ✅ / 详细 ❌** | 详细设计覆盖：硬件参数与 BOM、失效模式、固件可靠性（看门狗/掉电/fail-safe） |
| **S2 实现** | 固件 + 接收端 + 测试脚本 | 固件（M0–M6 已过）、`06_tests/udp_collect.py` 等 18 个脚本 | 🟡 **待签字** | 双模式编译 0 error + 自检绿 + **独立复核签字**（现在只有提示词，无签字记录） |
| **S3 验证（台面）** | 测试计划 + 台面记录 + 冒烟报告 | `24`（计划）、`02_docs/{05,07,08,15}`、`06_tests/M4_从零重建分步指南.md`、`M5_真机联调操作卡.md` | 🟡 **计划 ✅ / 报告 ❌** | 台面项全过 + 30 min 冒烟对账残差 0 |
| **S4 确认（真机 168h）** | 168h 报告 + 原始证据 | `25`（**仅模板**） | ❌ **未开始** | `24` §3 的 34 条判定逐条有结论 |
| **S5 交付结项** | 验收结项 + 成本对比 + 使用说明 | — | ❌ **缺 2 份（`09`/`10`）** | 结项文档可被第三方读懂；局限与未达标项写明 |

**横向过程（贯穿全阶段）**

| 过程 | 现状 | 缺 |
| --- | --- | --- |
| 配置管理 | ✅ `23` + git 规范（只 add 自己的文件） | — |
| 质量保证 | 🟡 "作者≠验证者"机制已执行 | **无评审记录表**（谁审的、审出什么、怎么关闭） |
| 风险管理 | 🟡 散在 `PROGRESS §8.1`、`21 §9`、`26 §4` | **无统一风险登记册** |
| 变更管理 | ✅ 铁律 §2b（事实类/决策类分层 + 留痕） | — |

> `PROGRESS §9` 里的 **G0–G8** 是 S2–S4 **内部**的施工门禁（更细），从属于本表，不冲突。

---

## 4. 现有文档归位（28 份，**没有一份是多余的**）

### 4.1 规范类 · 交付物（9 份，要维护）

| 文档 | 归属 | 说明 |
| --- | --- | --- |
| `01_项目任务书` | S0 | 已冻结 v0.4.1，**不再改** |
| `21_需求规格说明书` | S0 | 需求基线，冲突以它为准 |
| `06_QI协议说明` + `字段字典.csv` | S0 | 接口与数据定义 |
| `22_实现与交付方案` | S1（+S3 口径） | 系统级方案 |
| `24_焊接与168h测试规划` | S3/S4 | 验证判据 |
| `25_168h测试报告` | S4 | **模板**，待填 |
| `26_级别声明与范围边界` | S0/S1 | 级别与非目标 |
| `23_项目结构说明` | 配置管理 | 目录与命名 |
| **`28_系统全链路说明`** | **横向（S0–S3）** | **2026-10-26 新增**：按数据流串起七环链路 + 故障定位树。**新人与复盘的入口** |

### 4.2 过程记录类（12 份，**只读存档**）

`03` 环境搭建 · `04` 网络联通 · `05` 485 回环 · `07` 模拟从站 · `08` M5 真机联调 · `11` 开发板包排障 · `13` M4 排障 · `14` M4 复盘 · `15` M4 补测 · `17` 参考实现逆向 · `20` 工具链镜像 · `06_tests/{M4指南,M5操作卡}`

> 这些是**证据**，不是流程节点。不要更新它们，也不要拿它们当"当前状态"。

### 4.3 评审 / 决策类（6 份）

`02` 技术审查 · `02b` v0.2 复查 · `12` 全仓库审查 · `18` 接手体检 · `19` PIO core 选型 · `04_ai_prompts/{08,09,10}` 复核提示词

---

## 5. 真正缺的只有 5 项（其余 80% 已做完）

| # | 缺口 | 属于 | 阻塞什么 | 工作量 | 状态 |
| --- | --- | --- | --- | --- | --- |
| 1 | **详细设计**（硬件参数/BOM/失效模式 + 固件可靠性） | S1 | 焊接后的返修率、168h 的 fail-safe 语义 | 中 | ❌ 未开始 |
| 2 | **评审记录表** | 横向 | "作者≠验证者"目前只有口头，无证据 | 极小 | ✅ **已补（`27`）** |
| 3 | **风险登记册** | 横向 | 结项时说不清"已知风险有哪些、怎么处置" | 小 | ✅ **已补（`27`）** |
| 4 | **168h 报告**（`25` 填实） | S4 | 结项 | 依赖长跑 | ⏸ 待 S4 |
| 5 | **`09` 成本对比 + `10` 验收结项** | S5 | 交付 | 小（09 现在就能写） | ❌ 未开始 |

**不需要新写的**：需求分析（`21` 已有）、概要设计（`22` 已有）、测试计划（`24` 已有）、结构说明（`23` 已有）。

---

## 6. 当前门禁审核结论（2026-10-22）

### S0 · 判定：**有条件通过**

| 检查项 | 结论 |
| --- | --- |
| 任务书是否存在且冻结 | ✅ v0.4.1（2026-10-06） |
| 需求规格是否完整 | ✅ 18 FR / 6 IF / 6 DR / 10 NFR / 13 IR，带追溯矩阵与变更规则 |
| 数据与接口定义 | ✅ 字段字典 39 行（唯一事实来源）+ `06` 协议说明 |
| 三方差异是否裁决 | 🟡 **12 条中 5 条仍为 `待确认`** |
| 级别与边界 | ✅ `26`（2026-10-22 定 L1） |

**5 条待确认项（登记为风险，不阻塞施工，但**阻塞 S5 结项**）**：

| 编号 | 事项 | 影响 | 谁能定 |
| --- | --- | --- | --- |
| D-03 | `quality:"00"` 编码含义 | 与老师接收端兼容性 | 问老师 |
| D-05 | ~~`queue`/`dropped` 恒 0~~ → **2026-10-27 已改为 `null`** | 已消除：`null` = "设备无此能力"，不再被误读 | ✅ 心跳侧已闭环；`/status` 仍发 0（老师 22 项契约）待拍板 |
| D-07 | 固件同时换算工程量与发 raw | 与"只搬运原始值"原则冲突 | 用户/导师 |
| D-10 | ~~电量公式另一解差 1000 倍~~ → **2026-10-27 已定案**：正确式 `(H*65536+L)/1000`（raw 单位 Wh） | 电量数据可用于验收；代码待改（`02_docs/31`） | 砚青依真机 raw 定量定案，**待现场示数最终确认** |
| D-08 | 抖动判据（±50 ms）与秒级时间戳不匹配 | M11/M12 如何解释 | 已用 M11 替代，需备案 |

### S1 · 判定：**概要通过，详细未开始**

- 概要：`22` 给出系统级方案（接收端三线程、统计口径、加密方案）；`26` 定级别；硬件施工层有操作卡与布局图。
- **缺详细设计**，具体缺：硬件参数与降额、BOM 料号、失效模式分析（FMEA 简版）、固件可靠性（看门狗策略/掉电安全/fail-safe 三态定义）。

### S2 · 判定：**技术通过，程序未闭环**

- 固件 M0–M6 已过；`udp_collect.py` 自检全绿 + 双模式编译 0 error。
- **缺独立复核签字**：`04_ai_prompts/09` 已产出，但没有"谁审、审出几条、怎么关闭"的记录。

### S3–S5 · 未开始

---

## 7. 下一步：一次一门

| 顺序 | 做什么 | 为什么现在做 |
| --- | --- | --- |
| **1** | ~~补 **评审记录表 + 风险登记册**~~ **→ 已完成（`27`）** | 补完 S2 才能算闭环；成本半小时 |
| **2** | 补 **S1 详细设计**（重点：固件 fail-safe 三态 + 硬件参数/BOM） | **你马上要焊了**，硬件参数不定就得返工 |
| **3** | S3 台面验证（照 `24` 走，补一份冒烟报告） | 焊完立刻要跑 |
| **4** | S4 真机 168h | 依赖 2–3 |
| **5** | S5 写 `09`/`10` | 依赖 4 |

> 规矩：**上一阶段的出口没判"通过"，不进入下一阶段**。要跳必须写明理由并挂 `PROGRESS §8.2`。

---

## 8. 变更记录

| 版本 | 日期 | 作者 | 变更内容 |
| --- | --- | --- | --- |
| v1.0 | 2026-10-22 | 砚青 | 首版。建立六阶段主线（S0–S5）+ 出口判据；把 26 份文档归位为「规范 8 / 记录 12 / 评审 6」；识别三个乱源并定分工；给出 S0–S2 的审核结论与 5 项真实缺口。触发：用户认为项目"很乱"，要求按专业流程重做、已做过的只做检验。 |
