jiangtao-ml/ESP32_C3_Gateway/02_docs/06_QI协议说明.md

# STB3-125 / QI 用电数据采集设备 — Modbus RTU 协议说明

| 项目 | 内容 |
| --- | --- |
| 文档名称 | QI 协议说明（STB3-125 Modbus RTU） |
| 版本 | v1.0 |
| 文档状态 | ✅ **已真机验证**（M5 2026-10-05：功能码 `0x04` + 3 段读取，真机 59/60、78 字节真实数据；**`0x04` 帧与寄存器地址已成为生产依据**；**批次 2 2026-10-07：一帧读全 `00 27` 真机 384 轮 100%**）；Errata 状态：**E-00~E-05 全部已判定（E-02 于批次 2 实测结案：A——真机接受 39 寄存器一帧读全）** |
| 作者 | WorkBuddy（文档角色） |
| 创建日期 | 2026-09-27 |
| 设备型号 | STB3-125（QI 用电数据采集设备，约 300 元） |
| 协议版本 | **MODBUS 地址信息表 V4.1**（原文版本更新记录至 2021-11-26） |
| 协议原文 | `05_hardware/STB3-125_Modbus_Protocol.md` |
| 字段原文 | `05_hardware/STB3-125_Database_Fields.md` |
| 已知问题 | `05_hardware/STB3-125_Errata.md`（Codex 出具） |
| 唯一事实来源 | `04_ai_prompts/00_context.md` |

> **本文档定位**：把 `05_hardware/` 下的两份原始材料提炼成工程可用的一页纸，供 Codex 实现 Modbus 收发与解析时引用。
> **纪律**：本文档所有命令帧均**逐条取自协议原文**，未新增任何原文没有的命令。真机验证通过前，不得把本文档内容固化进 `01_firmware/`。

---

## 1. 通信参数

| 参数 | 值 | 来源 |
| --- | --- | --- |
| 设备地址 | **1**（默认，出厂值） | 原文"产品出厂通信参数设置" |
| 波特率 | **9600**（出厂值，**最终值**，已结案） | 同上；`00_context.md` 四.3 "暂定 9600" 至此结案 |
| 数据位 | 8 | 同上 |
| 校验 | **无校验（None）** | 同上；对应 Modbus 串口配置 `SERIAL_8N1` |
| 停止位 | 1 | 同上 |
| CRC | **CRC16/Modbus**：初值 `0xFFFF`，多项式 `0xA001`，反射算法，**低字节在前** | 同上"CRC校验：16位CRC校验，低位在前" |
| 帧间静默 | Modbus RTU 标准 3.5 字符（9600 8N1 下 ≈ 3.65ms） | Modbus 标准（非原文） |
| 字符间超时 | Modbus RTU 标准 1.5 字符（9600 8N1 下 ≈ 1.56ms） | Modbus 标准（非原文） |
| 设备地址可调 | 保持寄存器 0（40001）：高字节子网地址，低字节设备地址；默认 `00 01`；0 为广播，广播与子网无回应 | 原文保持寄存器表 |

**可调参数（写保持寄存器，谨慎使用）**：波特率 1200~19200（默认 9600）、设备地址。原文明确提示：**修改通信地址 / 波特率后，下次发送数据要做相应修改**。

> ⚠️ 改波特率或设备地址属于**破坏性配置操作**，会导致本机立刻失联。本阶段（面包板原型）**不得**执行。

---

## 2. 帧格式说明（含字节序表格）

### 2.1 请求帧通用结构（8 字节）

| 字节序号 | 01 | 02 | 03 ~ 04 | 05 ~ 06 | 07 ~ 08 |
| --- | --- | --- | --- | --- | --- |
| 读线圈（0x01） | 设备地址 | 功能码 01 | 起始地址 | 数据长度（线圈数） | CRC 校验 |
| 读输入寄存器（0x04） | 设备地址 | 功能码 04 | 寄存器地址 | 数据长度（寄存器数） | CRC 校验 |
| 读保持寄存器（0x03） | 设备地址 | 功能码 03 | 寄存器地址 | 数据长度（寄存器数） | CRC 校验 |
| 写线圈（0x05） | 设备地址 | 功能码 05 | 线圈地址 | **操作码**（`FF 00` = 置位 / `00 00` = 复位） | CRC 校验 |

**原文注**：读保持寄存器 / 读输入寄存器时，**数据长度以 2 字节为 1 单位；数据长度不能超过 16**。
→ 一次最多读 16 个寄存器。**读全部 39 个寄存器（`00 27`）超出该限制**，见第 7 节 Errata `E-02`。

### 2.2 写保持寄存器（0x10 多写 / 0x06 单写）

**0x10 多写请求帧：**

| 字节序号 | 01 | 02 | 03 ~ 04 | 05 ~ 06 | 07 | 08 ~ 09 | …… | 2n+6 ~ 2n+7 | 2n+8 ~ 2n+9 |
| --- | --- | --- | --- | --- | --- | --- | --- | --- | --- |
| 功能 | 设备地址 | 功能码 10 | 寄存器地址 | 数据长度（寄存器数） | 字节长度 | 数据 1 | …… | 数据 n | CRC 校验 |

**0x10 响应帧（8 字节）：**

| 字节序号 | 01 | 02 | 03 ~ 04 | 05 ~ 06 | 07 ~ 08 |
| --- | --- | --- | --- | --- | --- |
| 功能 | 设备地址 | 功能码 10 | 寄存器地址 | 数据长度 | CRC 校验 |

**0x06 单写**：请求为 `地址 | 06 | 寄存器地址 | 写入值 | CRC`（原文示例 `01 06 00 0D FF 00 59 F9` 为写保持寄存器 13 远程合闸），响应原样回显请求帧（8 字节）。

### 2.3 响应帧通用结构

| 帧类型 | 结构 | 原文示例 |
| --- | --- | --- |
| 读线圈（0x01）响应 | `设备地址 \| 01 \| 字节长度 \| 线圈状态 \| CRC` | 见第 7 节 `E-01` |
| 读寄存器（0x03 / 0x04）响应 | `设备地址 \| 功能码 \| 字节长度 \| 数据1 … 数据n \| CRC`（数据按 2 字节 1 单位） | `01 04 02 00 0A 39 37` |
| 写线圈（0x05）响应（回显） | `设备地址 \| 05 \| 线圈地址 \| 操作码 \| CRC` | `01 05 00 01 FF 00 DD FA` |
| 写保持寄存器（0x10）响应 | `设备地址 \| 10 \| 寄存器地址 \| 数据长度 \| CRC` | `01 10 00 00 00 04 C1 CA` |

### 2.4 字节序约定表（实现时最易出错处）

| 项 | 约定 | 依据 |
| --- | --- | --- |
| **单个 16 位寄存器内部** | **大端：高字节在前** | 原文示例 `01 03 02 00 A0 B8 3C` 读保持寄存器 3（欠压值），值 `0x00A0` = 160，与原文"复位后为160"一致 ✓ |
| | 再次验证：`01 03 08 25 80 01 13 …` 中 `0x2580` = 9600，与"波特率默认为9600"一致 ✓ | 上同 |
| **CRC 字段（2 字节）** | **低字节在前**（`CRC_L` 先发，`CRC_H` 后发） | 原文"低位在前"；已对全部命令帧独立重算复核 ✓（见第 7 节 `E-00`） |
| **多字节电量（H/L 两寄存器）** | **H 在前、L 在后**，拼接公式见第 4 节 | 原文寄存器表 + 字段文件 |
| **分闸记录（半字节域）** | 每 4 bit 一个语义单元；**域顺序与显示顺序的对应关系待真机核对** `[待确认]` | 原文"半字节为最小单位"+ 位置说明 |
| 位域类字段（跳闸开关） | 按"从低到高"位序：bit0 过压 … bit7 低余额跳闸开关 | 原文保持寄存器 15 |
| 数据类型默认 | **16 位无符号整型**（原文注 1） | 原文注 |

---

## 3. 常用命令清单（HEX）

> 全部命令帧**逐条取自协议原文**，CRC 已全部独立重算复核，与原文**完全一致**（复核方法见第 7 节 `E-00`）。
> 含义：`[设备地址] [功能码] [地址] [长度/操作码] [CRC_L] [CRC_H]`

### 3.1 读取类命令（本阶段主力）

| # | 用途 | 命令帧 | 功能码 | 说明 |
| --- | --- | --- | --- | --- |
| 1 | **读全部参数（39 个寄存器）** | `01 04 00 00 00 27 B0 10` | 0x04 | 起始 30001，39 个（0x27）。✅ **E-02 已实测（2026-10-07）：真机接受，83 字节合法响应，384 轮 100%** ⇒ **一帧读全为现役默认**；3 段保留为失败自动降级路径（见第 7 节 E-02） |
| 2 | 读 A 相电流 | `01 04 00 09 00 01 E1 C8` | 0x04 | 30010，单位 0.01A |
| 3 | 读 N 相（板载）温度 | `01 04 00 06 00 01 D1 CB` | 0x04 | 30007，板载温度 |
| 4 | 读 A 相接线柱温度 | `01 04 00 07 00 01 80 0B` | 0x04 | 30008（原文"温度读取"组首条） |
| 5 | **读线圈状态 0~3** | `01 01 00 00 00 04 3D C9` | 0x01 | 00001~00004，**原文回复帧 CRC 有误，见 `E-01`** |

### 3.2 控制类命令（0x05 写线圈）

| # | 用途 | 命令帧 | 说明 |
| --- | --- | --- | --- |
| 6 | **合闸** | `01 05 00 01 FF 00 DD FA` | 线圈 1，置位 |
| 7 | **分闸** | `01 05 00 01 00 00 9C 0A` | 线圈 1，复位 |
| 8 | **远程锁扣** | `01 05 00 02 FF 00 2D FA` | 线圈 2，置位。锁扣状态下开关**不能**合闸 |
| 9 | **远程解锁** | `01 05 00 02 00 00 6C 0A` | 线圈 2，复位。解锁后开关**能**合闸 |
| 10 | **自动控制** | `01 05 00 03 FF 00 7C 3A` | 线圈 3，置位 |
| 11 | **手动控制** | `01 05 00 03 00 00 3D CA` | 线圈 3，复位 |
| 12 | **复位** | `01 05 00 00 FF 00 8C 3A` | 线圈 0 配置复位（操作码 `FF 00`） |

> ⚠️ **第 6~12 条为控制类命令，会真实改变设备动作状态。本阶段（面包板原型 / M2-M4）禁止执行**，仅登记备查；如需在 M5 之后使用，必须单独走安全评估并由用户现场确认。

### 3.3 补充命令（同样取自原文，按需使用）

| # | 用途 | 命令帧 | 功能码 |
| --- | --- | --- | --- |
| 13 | 读 A 相电压 | `01 04 00 08 00 01 B0 08` | 0x04 |
| 14 | 读 B 相电压 | `01 04 00 11 00 01 61 CF` | 0x04 |
| 15 | 读 C 相电压 | `01 04 00 1A 00 01 10 0D` | 0x04 |
| 16 | 读 B 相电流 | `01 04 00 12 00 01 91 CF` | 0x04 |
| 17 | 读 C 相电流 | `01 04 00 1B 00 01 41 CD` | 0x04 |
| 18 | 读 B 相接线柱温度 | `01 04 00 10 00 01 30 0F` | 0x04 |
| 19 | 读 C 相接线柱温度 | `01 04 00 19 00 01 E0 0D` | 0x04 |
| 20 | 读保持寄存器 0~7（数量 8） | `01 03 00 00 00 08 44 0C` | 0x03 |
| 21 | 读保持寄存器 1~4（数量 4） | `01 03 00 01 00 04 15 C9` | 0x03 |
| 22 | 读保持寄存器 3（数量 1） | `01 03 00 03 00 01 74 0A` | 0x03 |
| 23 | 写保持寄存器 0~3（地址/波特率/过压/欠压） | `01 10 00 00 00 04 08 00 01 25 80 0A BE 06 40 C1 FD` | 0x10 |
| 24 | 合闸（寄存器方式，40014） | `01 06 00 0D FF 00 59 F9` | 0x06 |
| 25 | ⛔ **原文标“远程锁扣（40012）”，实为远程分闸（40014）** —— 远程锁扣应为 `01 06 00 0B FF 00 B9 F8`。**禁止执行**，见 E-03 | `01 06 00 0D 00 00 18 09` | 0x06 |
| 26 | 广播复位 | `00 05 00 00 FF 00 8D EB` | 0x05 |

> 第 23 条为**破坏性写入**（会改设备地址与波特率），禁止执行，仅登记。
> 第 24 / 25 条的原文标注存在疑点（两者都用寄存器地址 `00 0D`），**见 `E-03`**。
> ⛔ **第 24 / 25 条一律禁止执行**：第 25 条照抄会**误触发分闸**（原文把 40014 分闸标注成“远程锁扣”），
> 属“静默高危”。登记 ≠ 可执行；任何控制类命令启用前必须走 §9 第 3 条的安全评估。

### 3.4 原文给出的响应帧示例（可作解析自测基线）

| 用途 | 响应帧 | CRC 复核 |
| --- | --- | --- |
| A 相电流（值 `0x000A` = 10 → 0.10A） | `01 04 02 00 0A 39 37` | ✓ 一致 |
| 读保持寄存器 1~4 | `01 03 08 25 80 01 13 00 A0 00 00 52 08` | ✓ 一致 |
| 读保持寄存器 3（欠压 160） | `01 03 02 00 A0 B8 3C` | ✓ 一致 |
| 读保持寄存器 0~7 | `01 03 10 00 01 25 80 00 00 00 00 00 00 00 00 FF FF FF FF FF E9` | ✓ 一致（CRC `FF E9`） |
| 读线圈 0~3 | 原文：`01 01 01 02 90 48` | ✗ **疑似笔误，见 `E-01`** |

---

## 4. 数据字段映射表

> 来源：`05_hardware/STB3-125_Database_Fields.md`。字段名与类型为**采集程序 / 数据库侧**命名，与协议寄存器一一对应。
> 「寄存器」列为 0-based 地址（对应 `3xxxx` 编号见第 5 节）。

### 4.1 公共字段（非分相）

| 字段名 | 类型 | 量纲 | 精度 | 寄存器 | 说明 / 计算公式 |
| --- | --- | --- | --- | --- | --- |
| `id` | int | — | — | — | 用电记录编号，主键，非空，自增 |
| `macAddress` | varchar | — | — | — | 采集设备 MAC，标识网关设备 |
| `address` | varchar | — | — | — | 采集设备地址码，范围 01-FF |
| `openState` | varchar | — | — | 0（30001） | 高字节：本地锁止 `0x01` / 无锁 `0`；低字节：分闸 `0x0F` / 合闸 `0xF0`。**判读口径：取低字节整字节比对**（原文写 `0xF`，与 `0x0F` 数值相同，不是位域） |
| `record1` | varchar | — | — | 1（30002） | 分闸记录 1，记录前第 9-12 次分闸原因 |
| `record2` | varchar | — | — | 2（30003） | 分闸记录 2，记录前第 5-8 次分闸原因 |
| `record3` | varchar | — | — | 3（30004） | 分闸记录 3，记录前第 1-4 次分闸原因 |
| `frequent` | double | Hz | 0.1 | 4（30005） | 频率 F。**换算：实际 Hz = 原始值 ÷ 10**（原文单位 0.1Hz，量程 0~1000） |
| `leakage_current` | double | A | 0.001 | 5（30006） | 漏电电流 L。**换算：实际 A = 原始值 ÷ 1000**（原文单位 1mA，量程 0~1000） |
| `N_temp` | int | °C | 1 | 6（30007） | N 相（**板载**）温度。**换算：实际 °C = 原始值 − 40**（原文量程 0~200 → 实际 −40~160） |
| `collectTime` | datetime | — | — | — | 采集程序从设备取数的时间（**网关侧生成**） |
| `saveTime` | datetime | — | — | — | 记录存储时间，自动填写（**上位机侧**） |

**分闸原因编码（record1/2/3 共用）**：`F`=无、`1`=过流、`2`=漏电、`3`=过温、`4`=过载、`5`=过压、`6`=欠压、`7`=远程、`8`=模组、`9`=失压、`B`=限电。

### 4.2 A 相字段

| 字段名 | 类型 | 量纲 | 精度 | 寄存器 | 换算 |
| --- | --- | --- | --- | --- | --- |
| `A_temp` | int | °C | 1 | 7（30008） | 实际 = 原始 − 40 |
| `A_voltage` | int | V | 1 | 8（30009） | 1:1（量程 0~600V） |
| `A_current` | double | A | 0.01 | 9（30010） | 实际 A = 原始 ÷ 100（量程 0~655.35A） |
| `A_Pf` | double | — | 0.01 | 10（30011） | 实际 = 原始 × 0.01（量程 0~100 → 0~1.00） |
| `A_power` | int | W | 1 | 11（30012） | 1:1（量程 0~65535W） |
| `A_Q` | int | VAR | 1 | 12（30013） | 1:1 |
| `A_S` | int | VA | 1 | 13（30014） | 1:1 |
| `A_H` | int | — | — | 14（30015） | A 相有功电量高字 H，范围 1~999999999 |
| `A_L` | double | 度 | 0.001 | 15（30016） | A 相有功计量低字 L |
| **A 相总电量** | double | 度 | 0.001 | — | **`A 相总电量 = (A_H × 65536 + A_L) / 1000`** |

### 4.3 B 相字段

| 字段名 | 类型 | 量纲 | 精度 | 寄存器 | 换算 |
| --- | --- | --- | --- | --- | --- |
| `B_temp` | int | °C | 1 | 16（30017） | 实际 = 原始 − 40 |
| `B_voltage` | int | V | 1 | 17（30018） | 1:1 |
| `B_current` | double | A | 0.01 | 18（30019） | 实际 A = 原始 ÷ 100 |
| `B_Pf` | double | — | 0.01 | 19（30020） | 实际 = 原始 × 0.01 |
| `B_power` | int | W | 1 | 20（30021） | 1:1 |
| `B_Q` | int | VAR | 1 | 21（30022） | 1:1 |
| `B_S` | int | VA | 1 | 22（30023） | 1:1 |
| `B_H` | int | — | — | 23（30024） | B 相有功电量高字 H |
| `B_L` | double | 度 | 0.001 | 24（30025） | B 相有功计量低字 L |
| **B 相总电量** | double | 度 | 0.001 | — | **`(B_H × 65536 + B_L) / 1000`** |

### 4.4 C 相字段

| 字段名 | 类型 | 量纲 | 精度 | 寄存器 | 换算 |
| --- | --- | --- | --- | --- | --- |
| `C_temp` | int | °C | 1 | 25（30026） | 实际 = 原始 − 40 |
| `C_voltage` | int | V | 1 | 26（30027） | 1:1 |
| `C_current` | double | A | 0.01 | 27（30028） | 实际 A = 原始 ÷ 100 |
| `C_Pf` | double | — | 0.01 | 28（30029） | 实际 = 原始 × 0.01 |
| `C_power` | int | W | 1 | 29（30030） | 1:1 |
| `C_Q` | int | VAR | 1 | 30（30031） | 1:1 |
| `C_S` | int | VA | 1 | 31（30032） | 1:1 |
| `C_H` | int | — | — | 32（30033） | C 相有功电量高字 H |
| `C_L` | double | 度 | 0.001 | 33（30034） | C 相有功计量低字 L |
| **C 相总电量** | double | 度 | 0.001 | — | **`(C_H × 65536 + C_L) / 1000`** |

### 4.5 合相字段

| 字段名 | 类型 | 量纲 | 精度 | 寄存器 | 换算 |
| --- | --- | --- | --- | --- | --- |
| `power` | int | W | 1 | 34（30035） | 合相有功功率 P，1:1 |
| `Q` | int | VAR | 1 | 35（30036） | 合相无功功率 Q，1:1 |
| `S` | int | VA | 1 | 36（30037） | 合相视在功率 S，1:1 |
| `H` | int | — | — | 37（30038） | 合相有功电量高字 H |
| `L` | double | 度 | 0.001 | 38（30039） | 合相有功计量低字 L |
| **总电量** | double | 度 | 0.001 | — | **`总电量 = (H × 65536 + L) / 1000`** |

**字段计数**：公共 6 个（id / macAddress / address / openState / collectTime / saveTime）+ 记录类 3 个（record1-3）+ 频率/漏电/板载温度 3 个 + A/B/C 各 9 个（共 27）+ 合相 5 个 = **44 个字段**；其中与寄存器一一对应、需要解析的为 **39 个输入寄存器**。

---

## 5. 寄存器地址表

> 原文使用 `00001 / 30001 / 40001` 形式的协议编号。下表统一转为 **0-based 地址**（报文实际发送值）。
> 换算关系：**线圈 `0000n` → 0-based `n−1`；输入寄存器 `3000n` → 0-based `n−1`；保持寄存器 `4000n` → 0-based `n−1`**。

### 5.1 线圈（功能码 0x01 读 / 0x05 写，可广播）

| 0-based | 协议编号 | 读（0x01）含义 | 写（0x05）含义 |
| --- | --- | --- | --- |
| 0 | 00001 | 当前电压故障（1:有 / 0:无） | 配置复位（操作码 `FF 00`） |
| 1 | 00002 | 远程合闸/分闸（1:合 / 0:分） | 远程合闸（`FF 00`）/ 分闸（`00 00`） |
| 2 | 00003 | 远程锁扣/解锁（1:锁 / 0:解） | 远程锁扣（`FF 00`）/ 解锁（`00 00`） |
| 3 | 00004 | 自动控制/手动（1:自动 / 0:手动） | 自动（`FF 00`）/ 手动（`00 00`） |
| 4 | 00005 | — | 记录清零（`FF 00`） |

### 5.2 保持寄存器（功能码 0x03 读 / 0x06 单写 / 0x10 多写）

| 0-based | 协议编号 | 功能 | 数据范围 | 复位默认值 |
| --- | --- | --- | --- | --- |
| 0 | 40001 | 设备地址 | 高字节子网 / 低字节设备地址 | `00 01` |
| 1 | 40002 | 波特率 | 1200~19200 | 9600 |
| 2 | 40003 | 过压值 | 250~300（V） | 275 |
| 3 | 40004 | 欠压值 | 150~200（V） | 160 |
| 4 | 40005 | 过流值 | 1~100A（单位 0.01A） | 1000 |
| 5 | 40006 | 漏电值 | 10~90（单位 1mA） | 50 |
| 6 | 40007 | 接口过温值 | 40~150（℃） | 70 |
| 7 | 40008 | 过载有功功率 | 1000~50000（1W） | 2200 |
| 8 | 40009 | 限电度数 H | 1~999999999 | 0 |
| 9 | 40010 | 限电度数 L | 单位 0.001 度 | 0 |
| 10 | 40011 | 客户数据 H | 0xFFFF | — |
| 11 | 40012 | 远程锁扣/解锁 | `FF00`/`0000` | — |
| 12 | 40013 | 自动控制/手动 | `FF00`/`0000` | — |
| 13 | 40014 | 远程合闸/分闸 | `FF00`/`0000` | — |
| 14 | 40015 | 余额限值 | 10~50000（度） | 10 |
| 15 | 40016 | 跳闸开关（位域） | bit0 过压 / bit1 欠压 / bit2 过流 / bit3 漏电 / bit4 过温 / bit5 过载 / bit6 费用功能 / bit7 低余额跳闸；1 开 0 关 | 全 0 |

> 寄存器 11~13 与对应线圈同步（原文"读写(与对应线圈同步)"）。**V3.2 起已从保持寄存器中移除分合闸功能**，勿按旧版文档实现。

### 5.3 输入寄存器（功能码 0x04 读，只读，共 39 个）

| 0-based | 协议编号 | 含义 | 原文量程 / 单位 |
| --- | --- | --- | --- |
| 0 | 30001 | 开关分/合闸状态 | 高字节本地锁止 `0x01`/无锁 `0`；低字节分闸 `0x0F`/合闸 `0xF0`。**实现口径：`reg >> 8` 判本地锁止（`0x01`/`0x00`）；`reg & 0xFF` 整字节比对判分合闸（`0x0F`=分闸 / `0xF0`=合闸 / 其它=未知）。原文 `0xF` 与 `0x0F` 数值相同。注意原文另注“本地锁扣放在 30001 高位”** |
| 1 | 30002 | 分闸记录 1 | 半字节域，见 4.1 |
| 2 | 30003 | 分闸记录 2 | 半字节域 |
| 3 | 30004 | 分闸记录 3 | 半字节域 |
| 4 | 30005 | 频率 F | 0~1000（0.1Hz） |
| 5 | 30006 | 漏电电流 L | 0~1000（1mA） |
| 6 | 30007 | N 相接线柱温度（板载） | 0~200（℃），−40 后为实际温度 |
| 7 | 30008 | A 相接线柱温度 | 0~200（℃），−40 后为实际温度 |
| 8 | 30009 | A 相电压有效值 U | 0~600（1V） |
| 9 | 30010 | A 相电流有效值 I | 0~0xFFFF（0.01A） |
| 10 | 30011 | A 相功率因数 Pf | 0~100（0.01） |
| 11 | 30012 | A 相有功功率 P | 0~0xFFFF（1W） |
| 12 | 30013 | A 相无功功率 Q | 0~0xFFFF（VAR） |
| 13 | 30014 | A 相视在功率 S | 0~0xFFFF（VA） |
| 14 | 30015 | A 相有功电量高字 H | 1~999999999 |
| 15 | 30016 | A 相有功计量低字 L | 0.001 度 |
| 16 | 30017 | B 相接线柱温度 | 0~200（℃），−40 后为实际温度 |
| 17 | 30018 | B 相电压有效值 U | 0~600（1V） |
| 18 | 30019 | B 相电流有效值 I | 0~0xFFFF（0.01A） |
| 19 | 30020 | B 相功率因数 Pf | 0~100（0.01） |
| 20 | 30021 | B 相有功功率 P | 0~0xFFFF（1W） |
| 21 | 30022 | B 相无功功率 Q | 0~0xFFFF（VAR） |
| 22 | 30023 | B 相视在功率 S | 0~0xFFFF（VA） |
| 23 | 30024 | B 相有功电量高字 H | 1~999999999 |
| 24 | 30025 | B 相有功计量低字 L | 0.001 度 |
| 25 | 30026 | C 相接线柱温度 | 0~200（℃），−40 后为实际温度 |
| 26 | 30027 | C 相电压有效值 U | 0~600（1V） |
| 27 | 30028 | C 相电流有效值 I | 0~0xFFFF（0.01A） |
| 28 | 30029 | C 相功率因数 Pf | 0~100（0.01） |
| 29 | 30030 | C 相有功功率 P | 0~0xFFFF（1W） |
| 30 | 30031 | C 相无功功率 Q | 0~0xFFFF（VAR） |
| 31 | 30032 | C 相视在功率 S | 0~0xFFFF（VA） |
| 32 | 30033 | C 相有功电量高字 H | 1~999999999 |
| 33 | 30034 | C 相有功计量低字 L | 0.001 度 |
| 34 | 30035 | 合相有功功率 P | 0~0xFFFF（1W） |
| 35 | 30036 | 合相无功功率 Q | 0~0xFFFF（VAR） |
| 36 | 30037 | 合相视在功率 S | 0~0xFFFF（VA） |
| 37 | 30038 | 合相有功电量高字 H | 1~999999999 |
| 38 | 30039 | 合相有功计量低字 L | 0.001 度 |

> "读全部参数" `00 27` = **39 个寄存器 = 0x0000~0x0026，末址 0x0026（30039）** ✓ 与上表完全对齐。

---

## 6. 测试帧与真机帧的区分（严格边界）

| 类别 | 命令帧 | 功能码 | 用途 | 允许出现的阶段 |
| --- | --- | --- | --- | --- |
| **回环自测帧** | `01 03 00 00 00 02 C4 0B` | 0x03（读保持寄存器） | **M3 物理回环**、**M4 电脑模拟 Modbus 从站**：验证请求组装、CRC、两级超时、帧长驱动收帧、解析全流程 | 仅 M3 / M4 |
| **QI 真机帧** | `01 04 00 00 00 27 B0 10` | 0x04（读输入寄存器） | **M5 接入 QI 真机**：读全部 39 个输入寄存器 | M5 起 |

### 6.1 边界规则（禁止混用）

1. **M3 / M4 只允许使用 0x03 回环自测帧**。原因：电脑模拟从站按 `01 03 00 00 00 02` 组织固定响应，链路自测不需要也不应触碰真实设备语义。
2. **M5 起只允许使用 0x04 真机帧**（及第 3 节读取类命令）。原因：QI 设备的数据全在输入寄存器，0x03 读的是保持寄存器（设备参数），读到的是配置值而非测量值。
3. **禁止**把 0x03 回环自测帧原样带到 M5 之后作为"轮询帧"——它会读到保持寄存器内容，产生**看起来正常但语义完全错误**的数据（静默失败）。
4. 回环自测帧 `0x03` **保留在代码中作为调试开关**（可用编译期宏 / 运行期标志隔离），但默认关闭，且串口日志必须打印当前使用的是哪一类帧。
5. 两类帧的**响应长度不同**（0x03 读 2 寄存器 = 9 字节；0x04 读 39 寄存器 = 2+1+78+2 = 83 字节），解析器的帧长驱动逻辑必须按实际功能码与寄存器数计算，不得写死。

---

## 7. 已知问题（Errata）

> 修正值、复核结论由 Codex 在 `05_hardware/STB3-125_Errata.md` 中出具。**本节只登记问题与线索，不自行给修正值。**

| 编号 | 问题 | 位置 / 现象 | 现状 |
| --- | --- | --- | --- |
| **E-00** | CRC 复核基线 | 本文件第 3 节全部命令帧已用 CRC16/Modbus（初值 `0xFFFF`、多项式 `0xA001`、低字节先发）独立重算，与原文**逐一一致** | 已完成，可复现 |
| **E-01** | **读线圈 0-3 回复帧 CRC 疑似笔误** | 原文第 `01 01 00 00 00 04 3D C9` 的"回复"写作 `01 01 01 02 90 48`。对同一载荷 `01 01 01 02` 独立重算，得到 `D0 49`，与原文 `90 48` **不一致** | ✅ **已判定**（`05_hardware/STB3-125_Errata.md`）：正确帧为 `01 01 01 02 D0 49`，原文 `90 48` 为笔误。**模拟从站响应以重算值为准**，不得引用原文该帧作为校验基线 |
| **E-02** | **"读全部参数"长度超原文自述上限** | 原文注："数据长度不能超过 16"。而 `00 27` = 39 个寄存器，超出 16 | ✅ **已判定（批次 2 实测 2026-10-07）：情况 A 成立——真机接受 `00 27` 一帧读全**。实测：`01 04 00 00 00 27 B0 10` → 83 字节合法响应（byteCount=78），**384 轮连续成功、poll_err=0、100%**，39 寄存器值与 3 段方案（批次 1，59/60）同序同值；原文"上限 16"注释对 0x04 读输入寄存器**不成立**（疑为模板遗留文字）。固件批次 2 起为**运行时自适应**：启动默认一帧读全，从未成功且连续 3 轮失败自动降级 3 段（曾成功永不降级）；3 段帧（S1/S2/S3，37/37/19）保留为降级路径。细分帧与规则见 `05_hardware/STB3-125_Errata.md` 第 4 节 |
| **E-03** | **寄存器方式锁扣/合闸的地址存疑** | 原文"合闸指令"给出 `01 06 00 0D FF 00 59 F9`（保持寄存器 13 = 40014 ✓）与 `01 06 00 0D 00 00 18 09`（标注为"远程锁扣"，但地址同为 `00 0D`；远程锁扣应为 40012 = `00 0B`） | ✅ **已判定**：远程锁扣应为 `00 0B`（40012），原文 `00 0D` 为笔误；`01 06 00 0D 00 00 18 09` 实为**远程分闸**。**仅登记，一律禁止执行**（静默高危） |
| **E-04** | 读保持寄存器示例中 `//44 09` 注释 | 原文 `01 03 00 01 00 04 15 C9 //44 09`。`44 09` 疑为版本变更前的旧 CRC | 已复核：`15 C9` 正确（新 CRC），`44 09` 为历史遗留注释 |
| **E-05** | 温度量程表述差异 | 协议原文写"0~200(单位：℃)，−40 后为实际温度"；字段文件写"−40~160" | **不构成矛盾**：`原始值 − 40`，0~200 → −40~160 ✓。已在 4.1 明确换算 |

---

## 8. 与任务书 §6.4 的衔接

| 项 | 任务书 v0.1 原句 | 任务书 v0.2 新句 |
| --- | --- | --- |
| 帧用途 | "该帧为测试帧，非 QI 设备真实指令。QI 真实寄存器地址与查询指令格式见第 11 节 `[待确认]`。" | "**QI 真实协议见 `02_docs/06_QI协议说明.md`**；M3/M4 用 0x03 回环帧，**M5 起用 0x04 真实帧**。" |
| 测试帧标签 | "测试帧（阶段三使用，后续替换为 QI 真实协议）" | "**回环自测帧**（功能码 0x03，仅 M3/M4 使用）" |

**衔接结论**：任务书 §6.4 不再承担"QI 协议未知"这一跟踪职责，改为指向本文件；QI 协议的权威内容以本文件为准，本文件的权威来源为 `05_hardware/` 两份原文与 `04_ai_prompts/00_context.md`。

---

## 9. 使用纪律

1. **严禁在未真机验证前把寄存器地址写死进生产代码**。M5 之前，`01_firmware/` 中不得出现硬编码的 QI 寄存器地址与真机命令帧（回环自测帧 `0x03` 除外，且必须可关闭）。
2. **M5 真机通过后，才允许在 `01_firmware/` 中固化地址**。固化时必须以常量 / 表驱动形式集中定义（便于后续对照与修改），并在提交信息中注明"依据 `02_docs/06_QI协议说明.md` 与 M5 实测"。
3. **控制类命令（第 3.2 节 6~12 条、第 3.3 节 23~25 条）本阶段一律禁止执行**，仅登记备查。任何一条在 M5 之后启用，必须单独走安全评估并由用户现场确认。
4. **禁止把 `0x03` 回环自测帧与 `0x04` 真机帧混用**（见 6.1）。
5. **本文档与 `00_context.md` 冲突时，以 `00_context.md` 为准**；与 `05_hardware/` 原文冲突时，以原文为准并在本节/Eerrata 登记。
6. 真机验证结果（成功帧、失败帧、分段方案）必须回写本文件第 7 节，形成闭环。

---

## 变更记录

| 版本 | 日期 | 作者 | 状态 | 变更内容 |
| --- | --- | --- | --- | --- |
| v1.1 | 2026-10-03 | Codex | 待真机验证 | 一致性回填（不改任何协议事实）：① §3.3 第 25 条加 ⛔ 标注并写明其真实含义为“远程分闸”；② §7 E-01 / E-03 状态由“待 Errata 判定”回填为“已判定”（依据 `05_hardware/STB3-125_Errata.md`）；③ §4.1/§5.3 的 30001 低字节分合闸给出明确实现口径（低字节整字节比对，原文 `0xF` 与 `0x0F` 数值相同）；④ 头部补 Errata 状态。 |
| v1.0 | 2026-09-27 | WorkBuddy | 待真机验证 | 初版。依据 `05_hardware/STB3-125_Modbus_Protocol.md`（协议 V4.1）与 `STB3-125_Database_Fields.md` 提炼：通信参数、帧格式与字节序、26 条命令帧（全部 CRC 独立复核）、44 个数据字段映射、39 个输入寄存器 + 5 个线圈 + 16 个保持寄存器地址表、测试帧/真机帧边界、5 项 Errata（含 E-01 读线圈回复 CRC 疑似笔误）、使用纪律。新增内容仅为归纳与复核，未发明任何原文不存在的命令。 |
