jiangtao-ml/ESP32_C3_Gateway/02_docs/23_项目结构说明.md

# 23 · 项目结构说明与整理记录

| 项 | 内容 |
| --- | --- |
| 文档 | `02_docs/23_项目结构说明.md` |
| 版本 | **v1.2** |
| 日期 | 2026-10-17 首版 / 2026-10-21 增补 / **2026-10-26 第三轮（物理层清理）** |
| 作者 | 砚青（WorkBuddy） |
| 触发 | 用户要求：梳理目录组织与命名、合并归类重复与零散内容、清理废弃冗余文件、更新过时配置 |
| 依据 | `PROGRESS.md` §2b（分层留痕）、§7（硬件红线） |
| 状态 | 已执行；删除/归档清单见 §6（**本轮 §6.6**） |

---

## 1. 一页看懂

```
ESP32_C3_Gateway/
├─ README.md                  ← 项目总览与导航（先看这个）
├─ PROGRESS.md                ← 一页纸进度与决策留痕
├─ .gitignore
│
├─ 01_firmware/               ← 固件源码（唯一可编译产物来源）｜有 README
│  ├─ esp32c3_gateway/        ★ 主工程（.ino + config.h + web_config.h）
│  ├─ pio_verify/             PlatformIO 平行验证工程（只编译、不烧录）
│  └─ rs485_probe/            焊接体检工程（诊断 GPIO20 通断）
│
├─ 02_docs/                   ← 设计与过程文档｜有 README（文档地图）
│                               编号 00~28，缺 09/10；00 = 流程主线，28 = 全链路说明
├─ 03_logs/                   ← 运行时证据（**不入 Git**，删了不可恢复）｜有 README
├─ 04_ai_prompts/             ← AI 上下文与指令（00~10）｜有 README
├─ 05_hardware/               ← 协议 / 字段字典 / 接线 / 洞洞板图纸｜有 README
│                               （**不做 PCB**，无 KiCad 工程）
└─ 06_tests/                  ← PC 侧测试脚本、操作卡、归档区｜有 README
```

**每个目录都有自己的 `README.md`，进去先看那个。**

**三条判据**：
- 想知道「这东西怎么跑起来的」→ `02_docs/28_系统全链路说明.md`
- 想知道「现在做到哪」→ `02_docs/00_阶段与门禁主控表.md` + `PROGRESS.md`
- 想知道「这个文件是干什么的」→ 本文件 §3
- 想动手改代码 → `01_firmware/` + `04_ai_prompts/00_context.md`

---

## 2. 六个目录的职责边界

| 目录 | 放什么 | **不放什么** | 入库 |
| --- | --- | --- | --- |
| `01_firmware/` | 固件源码、编译配置 | 编译产物（`.pio/`、`build/`、`*.bin`） | 是 |
| `02_docs/` | 任务书、协议、排障记录、方案 | 一次性日志、临时截图 | 是 |
| `03_logs/` | 串口日志、抓包、逆向产物、样本库 | 任何需要长期协作的文档 | **否**（仅 README 白名单） |
| `04_ai_prompts/` | 给 AI 的上下文与指令、复核提示词 | AI 自己产出的正式文档（应进 `02_docs`） | 是 |
| `05_hardware/` | 厂商资料、器件手册、字段字典、接线与洞洞板图纸 | 编译中间件、**PCB 工程（本项目不做）** | 是 |
| `06_tests/` | 可执行脚本、操作卡、归档区 | 测试产生的日志（应进 `03_logs`） | 是 |

> **判据**：能复现结论的 → `06_tests`；结论本身 → `02_docs`；过程证据 → `03_logs`。

---

## 3. 我要做什么，该去哪个文件

这是最实用的一张表。按「意图」索引，不按目录。

| 我想…… | 去这里 |
| --- | --- |
| **现在该干什么 / 能不能进下一步** | **`02_docs/00_阶段与门禁主控表.md`**（S0–S5 六阶段 + 出口判据，**先看这张**） |
| 知道项目现在什么状态 | `PROGRESS.md` §0 / §3（日志）；流程判断看 `02_docs/00` |
| 谁审过什么 / 有哪些没闭环的风险 | `02_docs/27_评审与风险登记册.md` |
| 看每条需求对应哪行代码 | `02_docs/21_需求规格说明书.md` §3 + §10 |
| 做 168h 长跑 / 写接收程序 | `02_docs/22_实现与交付方案.md` §2 |
| 算采集率 / 丢包率 / 重包率 | `02_docs/22` §3（口径 M1–M18） |
| 做加密对比实验 | `02_docs/22` §4 |
| 查 Modbus 帧 / 寄存器含义 | `05_hardware/STB3-125_字段字典.csv`（**唯一事实来源**）→ `05_hardware/STB3-125_Modbus_Protocol.md` |
| 查接线怎么接 | `05_hardware/接线说明.md`（三条致命项见 §4） |
| **焊洞洞板（唯一硬件方案）** | `05_hardware/洞洞板固化操作卡_2026-10-08.md`（v1.3）→ 图纸 `05_hardware/洞洞板布局图_2026-10-21.md`（v1.2） |
| 改固件常量 | `01_firmware/esp32c3_gateway/config.h` |
| 改 Web 配置页 | `01_firmware/esp32c3_gateway/web_config.h` |
| 现场联调操作 | `06_tests/M5_真机联调操作卡.md` |
| 模拟一个从站做台面预演 | `06_tests/m5_slave_04.py` |
| **焊洞洞板 / 准备 168h 测试** | `05_hardware/洞洞板固化操作卡_2026-10-08.md`（v1.2）+ `05_hardware/洞洞板布局图_2026-10-21.md`（纸面绘图规格） |
| **看验收标准 / 指标清单 / 归因方案** | `02_docs/24_焊接与168h测试规划.md` |
| **跑 168h 并出报告** | `06_tests/udp_collect.py` → 跑完填 `02_docs/25_168h测试报告.md` |
| 确认数据真的到了电脑 | `06_tests/udp_listen.py`（单次抓包）或 `06_tests/udp_collect.py`（落库） |
| 让 AI 复核我的文档 | `04_ai_prompts/08_复核提示词_交付方案.md` |
| 让 AI 审查/优化固件 | `04_ai_prompts/10_Codex提示词_全面审查与优化.md` |
| **查固件商用级加固改了什么 / 哪些开关能回退** | **`02_docs/30_固件商用级加固_2026-10-27.md`**（P0-1~P0-4 + 六条已知限制 + 烧录验证步骤） |
| **复核这批固件改动** | `04_ai_prompts/13_固件商用级加固复核指令_2026-10-27.md`（两阶段：审查 + 直接实施 A 类修复） |
| **查接收端商用级优化（P0-5~P0-7 等）** | `02_docs/29_商用级优化方案_2026-10-26.md` |
| **查电量读数差了 1000 倍 / 为什么改公式** | **`02_docs/31_电量公式勘误_2026-10-27.md`**（D-10 定案 + 溢出断崖 + 不依赖屏显的三条验证路径） |
| **168h 能不能开跑 / 会踩哪些坑 / 该在哪停** | **`02_docs/32_168h起跑前置清单与风险预演_2026-10-27.md`**（7 道门 + 7 条判据口径 + 15 类故障 + 6 条中止判据） |
| 找某次实测的原始日志 | `03_logs/README.md`（A 类 = 证据，不可删） |

---

## 4. 命名约定

### 4.1 目录与文件

| 规则 | 说明 |
| --- | --- |
| `01_` ~ `06_` 前缀**不得改名** | 用于文件管理器固定排序；改了两百多处引用全断 |
| `02_docs/` 用 `NN_名称.md` 递增 | 当前 01~23，**缺 09（成本对比）、10（验收结项）** —— 属 M7 待补交付物，不是遗漏 |
| `04_ai_prompts/` 用 `NN_用途_主题.md` | 00 是上下文，01~07 是施工指令，08 是复核提示词 |
| `03_logs/` 用 `<阶段>_<场景>_<YYYYMMDD>.log` | `real` = 真机数据（证据级）；详见 `03_logs/README.md` §2 |
| 归档区统一叫 `_archive/` | 下划线前缀保证排在最前，且一眼看出不是活跃内容 |

### 4.2 Git 提交

- 格式：`阶段N: 简述`（当前阶段四）
- **只 add 自己改的文件，永不 `git add -A`** —— 会吞掉别人在途的改动
- 事实类改动（参数、帧表、进度）可直接提交；决策类（验收判据、安全红线、接口契约）须同时挂 `PROGRESS.md` §8

---

## 5. 文件生命周期

| 类别 | 位置 | 可再生 | 可否删 |
| --- | --- | --- | --- |
| 源码 / 文档 / 脚本 | `01/02/04/05/06` | 否（除推理） | 入库后可经 git 恢复 |
| 编译缓存 | `01_firmware/pio_verify/.pio/build/` | 是（重建约 3 min） | 可删，但重建慢，暂留 |
| 构建备份 | `*.bak` | 是 | **已删** |
| Python 缓存 | `__pycache__/` | 是 | **已删** |
| 运行时日志 | `03_logs/` | **否** | **删了不可恢复**，先看 `03_logs/README.md` |
| 本机工具记忆 | `.workbuddy/` | 否 | **禁止删除**（不在 git 内） |
| 凭据 | `secrets.h` | 否 | 禁止入库、禁止张贴 |

---

## 6. 本次整理记录（2026-10-17）

### 6.1 删除（6 项，均为零价值或可再生）

| # | 对象 | 大小 | 理由 | 可恢复 |
| --- | --- | --- | --- | --- |
| 1 | `_enc_probe.txt` | 112 B | 固件字符串探针的**格式串残留**（`0x%02X` 模板），无任何用途 | 否（已 gitignore） |
| 2 | `.codex_baseline_build.txt` | 422 B | M4 期旧编译基线（997 299 / 38 244），已被 `PROGRESS.md` 的新基线取代 | 否（已 gitignore） |
| 3 | `06_tests/__pycache__/` | — | Python 字节码缓存 | 自动重建 |
| 4 | `01_firmware/pio_verify/.pio/build_2x.bak/` | **38 MB** | 旧构建的 `.bak` 副本，与现行 `build/` 重复 | 可重建 |
| 5-9 | `.gitkeep` × 5（`01_firmware/esp32c3_gateway/`、`02_docs/`、`04_ai_prompts/`、`05_hardware/`、`06_tests/`） | 0 | 所在目录已有实际文件，占位符失效 | 是（git 跟踪） |

> 保留 `03_logs/.gitkeep`（该目录在 git 里需要占位）。

### 6.2 归档（2 项 —— 不删，因为它们是踩坑物证）

| # | 原位置 | 新位置 | 理由 |
| --- | --- | --- | --- |
| 1 | `06_tests/usb485_loopback.py` | `06_tests/_archive/` | 单端口 A/B 短接自环**已证无效**，曾导致完好模块被判"物理损坏" |
| 2 | `06_tests/M4_重测操作卡.md` | `06_tests/_archive/` | 第 0 步即无效自环；接线表按"同名对接"编写，是 M4 卡 5 天的成因 |

处理方式：**移出活跃工具区 + 新增 `_archive/README.md` 说明作废原因与正确替代**。
不直接删除的原因：`PROGRESS.md` §2b 明确「排障记录 = 复现依据」，删了下次还会踩。
若确认不再需要，一条命令即可清空该目录。

### 6.3 更新（6 处过时内容）

| # | 文件 | 原内容 | 改为 | 依据 |
| --- | --- | --- | --- | --- |
| 1 | `README.md` 状态块 | M0–M5 已通过 / M6 未开始 | **M0–M6 全部通过 / M7 进行中** | `PROGRESS.md` §8.2 #26 |
| 2 | `README.md` 状态块 | 编译基线 1 004 899 / 39 284 | **1 070 975 / 49 348** | P0-3 复核 |
| 3 | `README.md` 状态块 | 「默认 3 段读取」 | **运行时自适应，默认一帧读全** | 批次 2 |
| 4 | `README.md` 状态块 | 工具链 = Arduino，PlatformIO 只编译 | **PlatformIO 为正式链** | `28945a8` |
| 5 | `README.md` 状态块 | 电脑 IP 硬编码 `.113` | **每次 `ipconfig` 实测；真机由 NVS 决定** | 已漂移 5 次 |
| 6 | `01_firmware/esp32c3_gateway/README.md` | 同上 5 项 + 上行格式漏 `err` 行 | 同步修正 | 同上 |
| 7 | **`04_ai_prompts/00_context.md` §4.2** | 「字符间隔 **4ms**」 | **8ms**（行内留痕 + §7 变更记录 C-10） | 与同文件第五节及 `config.h` L89 冲突 |
| 8 | `.gitignore` | `03_logs/*` 全忽略 | 追加 `!03_logs/README.md` 白名单 | 索引需要入库 |
| 9 | `06_tests/README.md` | 归档前路径 | 指向 `_archive/` + 新增目录约定 + v1.10 | 本次归档 |

> ⚠️ `00_context.md` 属「最严档」：**只改了一个数字**，行内留痕 + 变更记录 C-10 + `PROGRESS.md` §8.2 #31，三处齐备。

### 6.4 新增（4 份索引/说明）

| # | 文件 | 作用 |
| --- | --- | --- |
| 1 | `05_hardware/README.md` | **解决最大混淆点**：`carrier/` 是模块插接载板、`pcb/` 是贴片定制板，**是两套方案不是版本迭代**；并厘清 STB3-125 三份协议文档的层次关系 |
| 2 | `03_logs/README.md` | 把 47 个文件按 **A 证据 / B 过程迭代 / C 待定** 分级，标清哪些**删了会毁掉结论** |
| 3 | `06_tests/_archive/README.md` | 归档区作废原因与正确替代 |
| 4 | `02_docs/23_项目结构说明.md` | 本文件 |

### 6.5 2026-10-21 增补（第二轮整理）

| 动作 | 对象 | 原因 |
| --- | --- | --- |
| **删** | `.codex_edit_20261021.py`、`.codex_task_utf8.txt` | AI 协作临时脚本/指令副本，混在仓库根目录；内容已在 `04_ai_prompts/10` 与代码里 |
| **删** | `06_tests/__pycache__/` | Python 字节码缓存，可再生 |
| **删** | `.workbuddy/tmp/build*`、`wb_build*`、`wb_verify*`（约 20 个目录） | 历史编译产物，每个 43–49 MB；**可再生**，与源码无关 |
| **留** | `.workbuddy/tmp/m6_stress_rows.json`、`pio_real_rows.json`、`b3real_rows.json` | **证据**，被 `PROGRESS §8.2 #26/#25` 直接引用 |
| **留** | `03_logs/`（3.4 MB）、`05_hardware/{carrier,pcb}/`（4.2 MB） | 前者是不可再生证据、后者是未入库的自研板工程 |
| **更新** | 本文件 §1/§3/§7、`README.md`、`02_docs/21`、`01_firmware/README.md`、`04_ai_prompts/00_context.md`（C-11） | 与当前代码对齐（基线、送达率、EN、分压） |

> 判据：**能删的只有三种——可再生的、零价值的、git 能恢复的**。证据类一律不删，只在 `03_logs/README.md` 里分级。

### 6.6 2026-10-26 第三轮整理（**物理层清理，逻辑层不动**）

前两轮把**文档逻辑**理顺了（阶段主控表、证据分级、目录索引），但**物理层一直没清** ——
本文件 §7 里写着「`.pio` 52 MB」「`tmp` 曾达 1.2 GB」，全都停在"建议"，没人执行。
用户反馈"文件树眼花缭乱"，根因就在这里。本轮**只做物理层**：不新建任何导航文档、不改任何文档编号。

| 动作 | 对象 | 量 | 依据 |
| --- | --- | --- | --- |
| **删** | `01_firmware/{pio_verify,rs485_probe}/.pio/` | **409 → 10 文件；76 MB → 194 KB** | 可再生（`pio run` 重建）；git 零跟踪（`git ls-files` 实测） |
| **删** | `.workbuddy/tmp/` 调试截图 21 张、工具链 zip、16 个源码快照目录、301 个瞬时输出 txt | **551 → 114 文件；59 MB → 4.8 MB** | 结论均已入文档；源码快照另打包 `_源码快照归档_20261026.tar.gz`（448 KB）留底 |
| **删** | `.workbuddy/tmp/secrets.h.bak` | 1 文件 | **含明文凭据**，属安全红线，优先清除 |
| **删** | `05_hardware/{carrier,pcb}`（先归档到 `_备查_未打样PCB/`，**2026-10-26 用户确认不要，已整体删除**） | 80 文件 / 4.2 MB | `02_docs/26` **N-2 已裁定 L1 不做打样 PCB**；用户明确"PCB 不要了" ⇒ 连备查也不留 |
| **移** | 老师固件 flash 全镜像 | → `03_logs/老师固件_flash全镜像_20261005.bin` | tmp 里唯一的完整镜像，移入证据区 |
| **删** | `03_logs` B 类迭代日志 | 25 个 | 结论已入文档（清单见 `03_logs/README.md` §1-B） |
| **修** | `.gitignore` 补 `.pio/` | 1 行 | 原先只忽略 `build/`，`.pio/` 其余内容反复堆积 |
| **重写** | 根 `README.md`（**212 → 约 100 行**） | — | 原文标题仍写"替换树莓派"（与 10-21 定调矛盾）；19 条"待确认"大半已闭环；EN 仍写 5V、`RXO` 仍写要分压 |
| **重写** | `05_hardware/README.md` §1 | — | 原文指示"要动手做板子，先看 `carrier/`"，与 L1 裁定直接冲突 |
| **删** | `05_hardware/_备查_未打样PCB/` + 9 个 KiCad 生成脚本 | 80 文件 / 4.2 MB | **用户 2026-10-26 明确"PCB 不要了"** ⇒ 连备查也不留 |
| **新增** | `01_firmware/README.md`、`02_docs/README.md`、`04_ai_prompts/README.md` | 3 份 | 这三个目录此前**没有 README**，用户"不知道每个文件夹放的啥" |
| **新增** | **`02_docs/28_系统全链路说明.md`** | 1 份 | 用户"读文档感觉项目没被串起来" —— 27 份文档全按时间序组织，缺一份按**数据流**讲的整体叙事 |

> ⚠️ **一处失误，据实记录**：`03_logs` B 类 25 个日志的归档包在重建时丢失
> （先删旧包、再打包时原文件已不存在），原文件**已不可恢复**。
> 核对结果：`PROGRESS.md` 与 `02_docs/` 正文**均未引用**这些文件，A 类证据全部完好，
> **不影响任何已发布结论**。教训已写入 `03_logs/README.md` §1-B。

---

## 7. 已知遗留问题

> 2026-10-26 第三轮整理后复核：原 #2 / #3(部分) / #7 / #8 / #9 **已执行完毕**，见 §6.6。

| # | 问题 | 影响 | 建议 / 状态 |
| --- | --- | --- | --- |
| 1 | ~~`05_hardware/{carrier,pcb}` 未纳入 git~~ | — | ✅ **已结案（2026-10-26）**：用户明确"PCB 不要了" ⇒ 两套工程 + 生成脚本整体删除。**D-5 关闭**，`26` N-2 的"L2 再重新设计"路径不变 |
| 2 | ~~`03_logs/` B 类迭代日志未清理~~ | — | ✅ **已完成（2026-10-26）**：25 个已删，A 类证据全留。归档包丢失一事见 §6.6 |
| 3 | `M5真机首测_解析_20261005_2035.log` 引用名与实际不符 | 按文档路径找不到文件 | 见 `03_logs/README.md` §3；下次改文档时顺手修正（`batch2/batch3` 那条为原判断有误，已更正） |
| 4 | **`02_docs/01_项目任务书.md` §6.1.2 仍写「字符间隔 3–5ms」** | 与代码 8ms 不符 | 任务书 **v0.4.1 已冻结**，不改；差异已登记在 `21` §9 D-01 |
| 5 | **`02_docs/` 缺 09（成本对比）、10（验收结项）** | M7 交付物不全 | 按 `22` §5.11 骨架补；09 可先做（不依赖 168h），10 需等 `25` 填完 |
| 6 | ~~21 / 22 / 08 三份文档尚未提交~~ | — | ✅ 已提交（`91f692f` / `92b355d` / `98ebf1d`） |
| 7 | ~~`.pio/build/` 52 MB 保留~~ | — | ✅ **已删（2026-10-26）**：两个工程 `.pio/` 共 76 MB / 399 文件全部清除，`.gitignore` 已补 `.pio/` |
| 8 | ~~`.workbuddy/tmp/` 空间占用~~ | — | ✅ **已清（2026-10-26）**：59 MB → 4.8 MB。**证据 JSON/DB 全部保留**（`m6_stress_rows.json` 等被 `PROGRESS §8.2 #26` 引用） |
| 9 | ~~根目录残留 AI 临时文件~~ | — | ✅ 已删（2026-10-21）；`.gitignore` 已拦截 `.codex_*` / `*probe.txt` |

---

## 8. 维护规则（避免再次变乱）

1. **新文档先想清楚归属**：结论 → `02_docs`；过程 → `03_logs`；工具 → `06_tests`；AI 指令 → `04_ai_prompts`。
2. **不新建第 7 个顶层目录**。现有六目录职责已覆盖全部内容类型。
3. **临时产物不要落仓库根目录** —— 写 `.workbuddy/tmp/` 或 `03_logs/`（`.gitignore` 已拦截 `.codex_*` / `*probe.txt`）。
4. **作废 ≠ 删除**：先移 `_archive/` 并在其 README 记一行原因；确认无用再清。
5. **任何目录的「入口文件」只有一个**：根 `README.md` → `PROGRESS.md` → 各目录 `README.md`。层级不重复叙述同一事实，只做指针。
6. **每季度做一次结构体检**：跑一遍 `git status --ignored`，看有没有新的未跟踪大文件或临时产物堆积。
7. **归档与删除必须分两步，且删前验证**：`tar` 打包 → **`tar -tzf` 核对条目数 + `du -h` 看体积** → 确认无误才删原文件。
   **禁止在同一条命令里先删旧包再重建** —— 2026-10-26 因此丢失 25 个日志（见 §6.6）。
8. **文档不复制"会变的事实"**：IP、编译基线、进度百分比、待办状态只保留**单一出处**，其余地方只写指针。
   根 `README.md` 之所以过时，就是因为复制了 `PROGRESS.md` 的数据又没同步。

---

> 最后更新：2026-10-17 · 砚青 · 首版（结构整理执行记录）
