jiangtao-ml/ESP32_C3_Gateway/02_docs/25_168h测试报告.md

# 168h 连续采集测试报告（模板）

| 项 | 内容 |
| --- | --- |
| 文档 | `02_docs/25_168h测试报告.md` |
| 版本 | v0.1（**模板，未填实测值**） |
| 作者 | 砚青（WorkBuddy） |
| 判据来源 | `02_docs/24_焊接与168h测试规划.md` §3（34 条） |
| 状态 | `[待实测]` —— 按项目铁律，**实测前禁止预填任何百分率** |

> 填写规则：所有数字必须来自 `03_logs/m7_longrun_<RUN>_report.txt` 与配套 CSV；不得手算，不得外推。判 P/F/M 时逐条引用 SQL 编号。

---

## 1. 封面

| 字段 | 值 |
| --- | --- |
| 设备 ID / MAC | `[待实测]` |
| 固件版本 / bin SHA256 | `[待实测]` |
| 代码 commit | `[待实测]` |
| 接收端主机 / IP | `[待实测]` |
| OS / Python / SQLite | `[待实测]` |
| 收缓冲（请求 → 回读，`rmem_max`） | `[待实测]` |
| 起止时间（UTC+8） | `[待实测]` |
| 实际时长 / 理论轮数 | `[待实测]` / 604800 |
| DB 路径与体积 | `[待实测]` |
| 字段字典 SHA256 | `[待实测]` |

---

## 2. 结论摘要

| 类别 | P（通过） | F（不通过） | M（待裁定） |
| --- | --- | --- | --- |
| 主判据（9） | | | |
| 指标（16） | | | |
| 过程（6） | | | |
| 分析（3） | | | |
| **合计（34）** | | | |

**总体结论**： `[待实测]`

---

## 3. 主判据（一票否决）

| # | 判据 | 实测 | 阈值 | 判定 | 备注 |
| --- | --- | --- | --- | --- | --- |
| Y-1 | M2 端到端完整率 | | ≥96% | | |
| Y-2 | M3 传输送达率 | | ≥99% | | |
| Y-3 | M8 重包率 | | ≤0.01% | | |
| Y-4 | M10 时钟回跳 | | =0 | | |
| Y-5 | q_drop | | =0 | | |
| Y-6 | 解析失败率 | | ≤0.01% | | |
| Y-7 | 非人为重启 | | =0 | | |
| Y-8 | 每小时数据行最小值 | | ≥1 | | |
| Y-9 | 磁盘最低余量 | | ≥10 GB | | |

---

## 4. 指标（M1–M18）

| # | 指标 | 实测 | 阈值 | 判定 |
| --- | --- | --- | --- | --- |
| M1 | 采集成功率 | | ≥97% | |
| M2 | 端到端完整率 | | ≥96% | |
| M3 | 传输送达率 | | ≥99% | |
| M4 | 行丢失率 | | ≤1% | |
| M5 | 整轮丢失率 | | ≤1% | |
| M6 | 仅数据行丢失率 | | ≤1% | |
| M7 | 仅心跳丢失率 | | ≤1% | |
| M8 | 重包率 | | ≤0.01% | |
| M9 | DB 幂等冲突率 | | ≤0.01% | |
| M10 | 撞车率 | | =0 | |
| M11 | 抖动 p99 | | ≤50 ms | |
| M12 | 抖动 max | | ≤200 ms | |
| M13 | 时间戳可信率 | | ≥99% | |
| M14 | 链路可用率 A | | ≥99% | |
| M15 | 设备在线率 | | ≥99% | |
| M16 | 质量 OK 占比 | | ≥95% | |
| M17 | 单轮耗时 p99 | **不适用**（固件无 `loop_ms`） | — | M |
| M18 | 自恢复时长 | | ≤60 s | |

---

## 5. 三口径与对账

| 项 | 值 |
| --- | --- |
| M1 / M3 / A | `[待实测]` |
| `A × M1 × M3` vs M2 偏差 | `[待实测]`（判据 <0.1 个百分点） |
| 期望行 / 收到 / 未发出 / 网络丢失 | `[待实测]` |
| 对账残差 | `[待实测]`（判据 = 0） |
| 丢包四分类（整轮/仅数据/仅心跳/仅 err） | `[待实测]` |

---

## 6. 接收端健康（缺口归因的证据链）

| 项 | 值 |
| --- | --- |
| 内核 `Udp InErrors` / `RcvbufErrors` | `[待实测]` |
| 网卡 `rx_dropped` / `rx_missed_errors` | `[待实测]` |
| CPU% / RSS max | `[待实测]` |
| 快照行数 | `[待实测]` |
| raw 自校验 | `[待实测]` |
| 每日备份份数 / SHA256 | `[待实测]` |

---

## 7. 缺口归因（按 §6 判定树）

| gap_id | 起止 | 时长 | 归因层 | 证据 | 结论 |
| --- | --- | --- | --- | --- | --- |
| | | | | | |

**未归因比例（A-1）**：`[待实测]`（判据 ≤0.1%）

---

## 8. 局限与未达标项

| # | 项 | 说明 | 是否影响总体结论 |
| --- | --- | --- | --- |
| 1 | M17 不适用 | 固件无 `loop_ms`，改用 M11 | |
| 2 | 空口损失 | 若为系统性 ~2%，须写明"余量仅 2 点" | |
| 3 | | | |

---

## 9. 附录

- 复算命令：`python 06_tests/udp_collect.py --db <库> --report-only --report-out <文件>`
- 文件清单与 SHA256：见 `<RUN>_manifest.sha256`
- 环境冻结表：`[待填]`
- SQL 编号对照：见 `03_logs/<RUN>_metrics.csv` 的 `sql_id` 列

---

## 10. 变更记录

| 版本 | 日期 | 作者 | 变更内容 |
| --- | --- | --- | --- |
| v0.1 | 2026-10-21 | 砚青 | 建模板。与 `02_docs/24` §3 的 34 条一一对应。 |
