jiangtao-ml/ESP32_C3_Gateway/04_ai_prompts/09_复核提示词_固件加固与接收端移植.md

# 复核提示词 · 固件 4 项加固 + 接收端 12 项修改

| 项 | 内容 |
| --- | --- |
| 用途 | 交给**另一角色**（Codex / Claude / 导师或同学）独立复核。作者 ≠ 验证者 |
| 版本 | v1.0 / 2026-10-21 |
| 改动方 | 砚青（WorkBuddy） |
| 涉及文件 | `01_firmware/esp32c3_gateway/esp32c3_gateway.ino`、`config.h`、`06_tests/udp_collect.py` |
| 前置 | 已在 2026-10-21 完成：`--selftest` 全绿；`SELFTEST=0/1` 双模式编译 0 error；22 s / 75 s 实跑通过 |

> 请**只做复核，不要顺手改代码**。发现问题就写在下面「复核结论」里，由用户决定是否采纳。

---

## 一、复核范围

### 1. 固件（4 处）

| # | 位置 | 改了什么 | 重点质疑 |
| --- | --- | --- | --- |
| C-1 | `udpSendLine()` | `write()` 返回值与 `strlen(g_payload)` 比对，不等即判失败；失败时仍调用 `endPacket()` 释放 pbuf | ① `endPacket()` 是否**一定**被调用（不能因短路被跳过）？② core 3.x 的 `UDP::write()` 返回语义是"已写入"还是"已入队"？若返回 0 表示"已受理"，这里会把成功误判为失败 ⇒ 需回退 |
| C-2 | `buildDataJson()` | `WiFi.localIP().toString().c_str()` → 栈上 `char ipBuf[16]` + `snprintf` | JSON 里 `ip` 字段是否**逐字节相同**？`IPAddress::operator[]` 返回类型是否与 `%u` 匹配？ |
| C-3 | `loop()` 尾部 | 丢轮重对齐分支加 `Serial.printf("[POLL][SKIP] ...")` | ① 是否**没有**改动 `g_nextPollMs` 的推进语义？② `(long)(millis()-g_nextPollMs)` 在回绕时是否会打出异常值（168 h = 7 天，不触发 49.7 天回绕，但请确认） |
| C-4 | `parseResponse()` / `udpSendLine()` | 新增 `SERIAL_VERBOSE_ROUND` 开关，包住 `[M4] 解析 OK`、`REG:` 循环、`[UDP -> ...]` 整包回显 | ① 关掉后是否有变量变成"未使用"而产生 warning？② 验收脚本 `m4_accept.py` / `m5_parse.py` 依赖这些锚点，是否已注明"仅台面用"？ |

**请特别核对：这 12 项是否真的一个字都没动** —— Modbus 请求帧与 CRC、解析顺序、P0-1 帧长校验、`g_merged` 无整轮清零、`RS485_DE_PIN=-1`、`Serial1.flush()` 作发完判据、`poll_ok` 先于链路判断自增、`g_nextPollMs` 按计划时刻推进、JSON 字段名与顺序、`Serial.setTxTimeoutMs(0)`、NTP reachability 判据、`seq` 自增位置。

### 2. 接收端（12 处，`06_tests/udp_collect.py`）

| # | 改动 | 重点质疑 |
| --- | --- | --- |
| B-1 | 统计线程由 `readonly=True` 改读写连接 | 两个写者（T2 每 2 s、T3 每 60 s）在 WAL 下会不会互相 `SQLITE_BUSY`？`busy_timeout=10000` 是否足够？ |
| B-2 | `_parse_wall()` 统一 `.replace(tzinfo=CST)` | 是否所有读库时间的地方都换成了它？有没有漏掉裸 `strptime`？ |
| B-3 | 注册 SIGTERM/SIGINT，handler 只 `stop.set()` | ① 在 Windows 上 `signal.SIGTERM` 行为与 Linux 不同，是否会影响？② `Event.wait()` 被信号打断后（PEP 475）是否会自动重入、导致 stop 延迟？ |
| A-4 | `stop_signal_at` 与 `ended_at` 分开 | 报告时长改用 `stop_signal_at`，会不会掩盖"收尾很慢"这个信息？ |
| A-5 | `SO_RCVBUF` 回读 | 回读值在 Linux 上是"内核翻倍后取 min(rmem_max)"，因此回读值通常 ≥ 设置值？请确认解读口径（等效秒数按 `act/1150` 算是否合理） |
| A-6 | `/proc/net/snmp` 与 `/sys/class/net/*/statistics/*` 采样 | ① 按表头名取值是否对 Ubuntu 18/20/22 都成立？② `rx_missed_errors` 在某些驱动上不存在，是否已容错？ |
| A-7 | 主机指纹落库 | 读库而非读环境，是否覆盖了所有封面字段？ |
| A-8 | 报告固定 LF | `--report-out` 与运行时的 `_report.txt` 是否**同一份内容**（都用 `newline="\n"`）？ |
| A-9/A-10 | SQLite 版本闸门 + `--env-check` | 硬项/软项分类是否合理？会不会把"能跑但慢"误判为阻断？ |
| A-11 | 每日 `Connection.backup()` | 在 WAL 模式下 `backup()` 是否拿到的是一致快照？备份期间会不会阻塞主线程（它在 T3 里）？ |
| A-13 | `--verify-raw` | ① 容差按 `0.5×10^-decimals` 是否合理？② 只比数值字段与两个字符串字段（`openState`/`record*`）够不够？③ **是否确实比的是 JSON 而不是 `meter_record`**（后者自己跟自己比必然 100%） |

---

## 二、必须回答的问题

1. **C-1 会不会把成功误判为失败？** 这是唯一可能"改坏"的项。请查 core 3.x `UDP::write()` 的实现（`NetworkUdp.cpp`）确认返回语义。
2. **B-1 的两个写者会不会在 168 h 里偶发 `database is locked`？** 若会，T3 的快照会不会又变成静默丢失（虽然现在有告警）？
3. **B-3 在 systemd 下的收尾时延**：从 SIGTERM 到进程退出，最长多久？`TimeoutStopSec` 设 300 s 够吗？
4. **A-5 的"约 N 秒缓冲"公式**（`bytes / 1150`，1150 ≈ 单包字节数）是否成立？1 Hz 下 190 s 缓冲够不够覆盖一次 WAL checkpoint？
5. **有没有引入新的静默失败点**？（上一版的教训就是"异常被 `except: pass` 吞掉"）

---

## 三、复核结论（请填写）

```
结论：□ 通过   □ 通过但需修改   □ 不通过

阻断项（必须改才能烧录/长跑）：
1.
2.

重要项（影响可信度，建议改）：
1.
2.

建议项（可选优化）：
1.

复核人：________   日期：________
依据（读了哪些文件/行号）：____________________________
```

---

## 四、附：改动前后关键数字（供交叉验证）

| 项 | HEAD `ff0b6f1` | 改动后 | 差异 |
| --- | --- | --- | --- |
| Flash（SELFTEST=0，干净重编） | 1,086,409 B | 1,086,695 B | **+286 B** |
| RAM（SELFTEST=0） | 49,496 B | 49,496 B | **0** |
| Flash（SELFTEST=1） | — | 1,078,957 B | 0 error |
| RAM（SELFTEST=1） | — | 49,368 B | — |

> ⚠️ 仓库文档长期引用的 `1,070,975` 是**过期基线**（早期 core/配置），与当前源码不符。复核时请以本表为准，并确认我没有把基线写错。

`--selftest` 实测：注入 50 整轮丢 / 20 数据丢 / 10 心跳丢 / 3 err 丢 / 5 重包 / 2 重启 / 各 1 次同秒与回跳 ⇒ **逐项精确复现，unexpl = 0**。
