jiangtao-ml/ESP32_C3_Gateway/04_ai_prompts/08_复核提示词_交付方案.md

# 08 · 复核提示词：交付方案（作者 ≠ 验证者）

> 用法：把下面 `====` 之间的整段复制给 Claude / Codex。**不要让它改代码**，只要它挑错。
> 产出物：`02_docs/21_需求规格说明书.md`、`02_docs/22_实现与交付方案.md`（2026-10-15，砚青）
> 作者：砚青（WorkBuddy）｜ 复核人：（待填）｜ 复核日期：（待填）

---

====

你是独立复核人。任务不是夸这份方案，是**找出它错在哪里、哪里会翻车**。
作者是另一个 AI，**没有自审权限**，所以你的挑剔程度直接决定这份方案能不能上验收会。

## 工作区与必读文件

工作区：`C:/Users/17352/Desktop/ESP32_C3_Gateway`

按顺序读：

1. `02_docs/21_需求规格说明书.md`（被复核对象 A：代码逆向需求基线）
2. `02_docs/22_实现与交付方案.md`（被复核对象 B：五问落地方案）
3. `01_firmware/esp32c3_gateway/esp32c3_gateway.ino`（事实来源，重点 L680–870、L1051–1230）
4. `01_firmware/esp32c3_gateway/config.h`（常量）
5. `01_firmware/esp32c3_gateway/web_config.h`（Web 层，重点 L104–108、L451–470）
6. `06_tests/db_proto.py` + `06_tests/db_schema.sql`（方案声称要复用的资产）
7. `04_ai_prompts/00_context.md`、`02_docs/01_项目任务书.md` §6.1.2 / §9 / §11.3
8. `PROGRESS.md` §8.2（历史决策与实测）

## 复核纪律

- **只读，不要改任何文件**（包括被复核的两份文档）。发现问题写进你的报告。
- **不要写代码**，不要"顺手优化"。
- 不确定就说不确定，**禁止编造**。所有结论要能指到"文件 + 行号"。
- 如果你认为方案某处是**错的**，请给出**反例**或**可复现的失败场景**，不要只说"我觉得不稳妥"。

## 必须逐项回答的问题

### 一、事实核对（最重要，错一条就足以推翻整份方案）

1. 21 §4.1 的数据行字段表，与 `.ino` L694–720 的 `buildDataJson` **逐字段**是否一致？有无漏项、错项、类型写错？
2. 21 §4.2 心跳 13 键、§4.3 失败行 8 键，与 `.ino` L737–745、L760–766 是否一致？
3. 21 §9 D-01 称「`00_context.md` L41 写 4ms、L52 与 `config.h` L89 写 8ms、任务书写 3–5ms」。请**亲自打开三个文件核对**，确认这三处是否真的互相矛盾。若作者读错了行号或误读了版本，请指出。
4. 22 §3.2 的对账法依赖一个前提：`poll_ok/poll_err` 在 WiFi 判断**之前**自增，`seq` 在**之后**才自增。请核对 `.ino` L788–806，确认这个前提**是否真的成立**。
5. 22 §2.5 声称 `meter_record` 的现主键 `(device_id, collect_time)` 在 NTP 回跳 1 秒时会**静默覆盖**一行。请核对 `db_schema.sql` 与 `db_proto.py` 的 `ingest()`，确认是否真的会覆盖、是否有别的保护。
6. 21 §8 的 13 条「隐含需求」，逐条判断：**代码里真的有吗？去掉真的会坏吗？** 若某条是作者臆测，请点名。

### 二、逻辑与数学

7. 22 §3.2 的闭合恒等式 `2·ΔR = R + 未组装 + 发送失败 + 网络丢失` 是否恒成立？请**自己构造一个反例尝试打破它**（例如：WiFi 断开中途恢复、某轮 payload 被截断、心跳被重复收到、设备在区间中途重启）。
8. 22 §3.2 把初稿的 `k = ΔS/ΔR 必须等于 2` 改成 `ΔS ≤ 2·ΔR`。这个修正**正确吗**？还有没有第三种更容易被忽略的异常（例如 `ΔS > 2ΔR` 但不成整数倍）？
9. 22 §3.4 的按轮分类（奇数 seq = 心跳、偶数 = 数据/err）依赖「每轮恒 2 行」。`QI_SEND_ERR_ROW=1` 时成立；若该宏被改成 0，或 payload 截断导致某行未发出，分类会不会错位？方案有没有兜住？
10. 22 §3.4 的重包键加了 `epoch_id`。重启识别的三条判据（seq ≤10 且上一条 ≥20；poll 计数回退）**有没有漏掉某种重启形态**？例如：重启后刚好赶上 WiFi 未连、若干轮后才发第一行。
11. 22 §3.6 说 `M2 ≥96%` 隐含要求 `M1 ≥96.4%`（取 A≈99.7%、D≈99.9%）。这个推导对不对？若 A 实际只有 99.0%，M1 需要多少？方案有没有把这种敏感性写清？

### 三、工程可实现性

12. 22 §2.2 的 3 线程 + 2 队列，在 Windows + Python 的 GIL 下，收包线程会不会被落库线程的 SQLite 调用拖慢？方案给的缓解手段（`sleep` 间隔、批量提交、WAL）是否足够？
13. 22 §2.5 声称 168h 约占 1.0–1.5 GB。请**自己估一遍**（121 万包 × 平均 payload + 60 万行 meter_record + 索引开销），指出作者的估算偏乐观还是偏保守。
14. 22 §2.6 声称「统计不存运行时累加值、报告 100% 由 SQL 重算」就能实现断点续收。**这个说法有没有漏洞**？例如队列里未提交的数据在崩溃时丢失、`recv_mono` 跨进程不可比。
15. 22 §4.3 的 nonce 构造（dev_tag + boot_id + seq）唯一性论证是否严密？特别是：`boot_id` 写在 NVS，**写入本身有寿命限制与失败可能**，方案的 fail-closed 够不够？
16. 22 §4.5 声称加密只改 `udpSendLine()`，不动三个 `build*Json`。这样能保证 `seq` 语义不变吗？**加密后包变大 29 B，会不会让本来"刚好不超 MTU"的判断失效**？

### 四、验收口径

17. 22 §6 的 13 条判据，**有没有互相矛盾、或某条不通过却仍能宣称整体通过**的漏洞？
18. `M2 ≥96%` 这个阈值，对照老师基线 96.9%（那是 M1）是否合理？会不会出现"M1 达标但 M2 不达标"从而被判失败？方案的处置建议是否可接受？
19. 22 §3.8 要求用构造数据集"证伪"统计引擎。这个要求本身**可执行吗**？构造集应该包含哪些注入项才够？

### 五、遗漏

20. 22 §5 列了 14 项补漏。**还漏了什么？** 请只列真正影响 168h 成败或验收结论的，不要凑数。候选方向：数据留存合规、多设备扩展、接收端时钟源、报告的可信度、评审现场演示失败预案。
21. 21 的差异清单（12 条）**有没有漏掉你发现的偏差**？

## 输出格式（严格遵守）

```
## 复核结论
总体判定：可提交 / 需修订后提交 / 不可提交
一句话理由：

## 阻断项（必须改，否则不能上验收会）
| # | 位置 | 问题 | 证据（文件:行号） | 建议改法 |
|---|---|---|---|---|

## 重要项（应改）
| # | 位置 | 问题 | 证据 | 建议 |

## 建议项（可选）
（最多 5 条，不要凑数）

## 我核对过但没问题的点
（列出来，让作者知道哪些不用再查）

## 我无法确认的点
（说明为什么无法确认，需要什么信息）
```

**判定标准**：

- 「阻断项」= 事实错误、数学错误、会导致 168h 跑完拿不到有效结论的问题。
- 「重要项」= 不致命但会在答辩时被问住的问题。
- 若阻断项为 0 且重要项 ≤3，判「可提交」。

最后一句提醒：**如果你只挑出措辞问题而放过事实与逻辑错误，这次复核就是失败的。**

====

---

## 复核后处理流程（给砚青自己看）

1. 阻断项 → 必须逐条修，修完在 `PROGRESS.md` §8 挂条。
2. 重要项 → 能改则改，不能改的在文档里显式标「已知限制」。
3. 建议项 → 择要采纳，不采纳的说明理由。
4. **复核人签名与日期填进本文档头部**，否则视为未复核。
5. 若复核结论为「不可提交」，**不得进入 P1（写接收程序）**。

> 最后更新：2026-10-15 · 砚青 · 首版
