jiangtao-ml/ESP32_C3_Gateway/04_ai_prompts/04_Codex提示词_功能对齐_JSON上报与统计.md

# Codex 施工指令 · 功能对齐（对齐老师的参考实现）

| 项 | 内容 |
| --- | --- |
| 文档 | `04_ai_prompts/04_Codex提示词_功能对齐_JSON上报与统计.md` |
| 版本 | v1.0 |
| 日期 | 2026-10-06 |
| 发出 | WorkBuddy（文档 / 测试角色） |
| 接收 | Codex（写代码 / 编译；**也可改「事实类」文档** —— 见 `PROGRESS.md` §6 第 7 条。**决策类改动必须留痕**：更新该文档的变更记录，并在 `PROGRESS.md` §8 挂一条） |
| 事实来源 | `04_ai_prompts/00_context.md` |
| 规格来源 | **`02_docs/17_参考实现逆向笔记_2026-10-05.md` §3**（从老师固件二进制里读出的**原文格式串**）、`05_hardware/STB3-125_字段字典.csv`、`02_docs/16` §8/§9.4/§10 |
| 关联 | `04_ai_prompts/03_Codex提示词_M5功能码与3段读取.md`（上一轮，已完成） |

> ⚠️ **本指令分三批，不要一次全做。**
> **只先做【批次 1】**。批次 2、3 等批次 1 验证通过后再另发指令。

---

## 零、为什么分批（请先读）

用户要求「老师有的功能我们也要有」，共 8 项：

| # | 老师有 | 我们现状 | 归入 |
| --- | --- | --- | --- |
| 1 | 一帧读全部 39 | 走 3 段（E-02 保守方案） | **批次 2** |
| 2 | **输出 JSON** | 文本 `时间戳 \| 78B HEX` | **批次 1** |
| 3 | **设备命名 `ESP485-<MAC后6位>`** | 无 | **批次 1** |
| 4 | Web 配置页（可改 WiFi/NTP/UDP/周期） | 编译期常量 | **批次 3** |
| 5 | `/status` JSON 端点 | 无 | **批次 3** |
| 6 | AP 回退 | 无 | **批次 3** |
| 7 | 闪存配置持久化 | 无 | **批次 3** |
| 8 | **统计 `poll_ok/poll_err/udp_tx`** | 只有串口统计 | **批次 1** |

**分批理由**：批次 1 只动**上行侧**（`sendUdpPayload` + 几个计数器），**风险低、可验证**；
批次 3 等于新写一套配置体系（AP + HTTP + NVS），改动量与风险完全不同级，**不应与批次 1 混在一次提交里**。

---

## 一、硬约束（沿用 03，**不得违反**）

1. **NTP 三源值不得动**：`172.16.0.2` / `ntp.aliyun.com` / `203.107.6.88`；`NTP_TZ_INFO` 仍是 `"CST-8"`（不得加尖括号）。
2. **`UDP_TARGET_IP` = `192.168.1.113`**（2026-10-05 实测）。⚠️ 若开工前 `ipconfig /all` 显示又漂了，**先报告再改**。
3. **非阻塞状态机结构不得重构**（`ST_IDLE→TX→WAIT_RX→PARSE→SEND`）。**禁止 `delay()`**；`setup()` 内原有的 USB CDC 有界等待保留。
4. **收发顺序不得改**：清 RX 必须在 `Serial1.write()` 之前，然后 `flush()`。
5. **UART 引脚与参数不得改**：`Serial1.begin(9600, SERIAL_8N1, 20, 21)`；`RS485_DE_PIN = -1`（MAX13487，EN 固定高，**不得动态切换**）。
6. **`RS485_MODE_LOOPBACK_SELFTEST` 保持 `0`**，该分支代码保留不动。
7. **只读不写**：不得出现任何合闸 / 分闸 / 锁扣 / 解锁 / 复位 / 写寄存器 / 广播帧。
8. **不得引入第三方库**。⚠️ 本批次**允许**使用 ESP32 Arduino core **自带**的 `WiFiUdp` / `time` / `HardwareSerial`（已在用），以及**新增** `ArduinoJson`？——**不允许**。
   ⇒ **JSON 必须手写 `snprintf` 组装**（与老师一致：他固件里就是格式串 `"%s":%u` 拼出来的，没有 JSON 库）。
9. **`secrets.h` 编译期守卫保留**。
10. **只提交自己负责的文件**。

### 本批次新增的三条硬约束

11. **不得改动 485 侧的任何逻辑**（帧、段数、超时、解析、CRC）—— 本批只改**上行格式与计数器**。
12. **不得删掉原始值路径**：JSON 里**必须同时**带 `raw`（78 字节 HEX）。理由见 §三.4。
13. **时间戳格式**：JSON 用 **ISO8601**（`2026-10-06T20:10:03`）；**人眼串口日志可继续用旧格式**（`YYYY-MM-DD HH:MM:SS \| HEX数据`，Q-12 裁定不动）。

---

## 二、批次 1 · 目标与产出

**目标**：把上行从「文本 + HEX」改成「**JSON（数据行 / 心跳行）+ 设备命名 + 累计计数器**」，除自检外不引入任何第三方库。

**允许改动的文件**：`01_firmware/esp32c3_gateway/config.h`、`esp32c3_gateway.ino`。**别的不许动。**

---

## 三、批次 1 · 详细规格

### 3.1 数据行（每轮三段全成功时发一行）

**字段顺序照抄**（与 `02_docs/17` §3 的原文格式串一致，便于日后与老师的数据并表）：

```
{"seq":<u32>,"dev":"ESP485-<6HEX>","mac":"<MAC>","ip":"<本机IP>","ts":"<ISO8601>","ts_ok":<true|false>,
 "openState":"<%04X>","record1":"<%04X>","record2":"<%04X>","record3":"<%04X>",
 "frequent":<f1>,"leakage_current":<f3>,"N_temp":<d>,
 "A_temp":<d>,"A_voltage":<d>,"A_current":<f2>,"A_Pf":<f2>,"A_power":<d>,"A_Q":<d>,"A_S":<d>,"A_H":<d>,"A_L":<f3>,
 "B_temp":<d>,…,"C_temp":<d>,…,
 "power":<d>,"Q":<d>,"S":<d>,"H":<d>,"L":<f3>,
 "quality":"OK|PARTIAL","invalid":"<无效字段,逗号分隔>","seg":"<0|3>","raw":"<78 字节 HEX，空格分隔，固定 233 字符>"}
```

> 📌 `seg` 的取值只有两个：**`"0"` = 一帧读全**、**`"3"` = 三段读取**。
> ⚠️ **【勘误注 2026-10-07 砚青】本条已被批次 2 取代**：seg 一帧读全改为 **`"1"`**（"0" 弃用，见 `04_ai_prompts/06` §2 P5 与 `config.h` 的 `QI_SEG_TAG_MODE_FULL`），且 seg 改为**运行时判定**（心跳行另有 `mode` 字段）。本文件其余内容为批次 1 历史指令，原文保留。
> （`QI_READ_SPLIT_3SEG=1` → `"3"`；`=0` → `"0"`。**不存在 `"1"`** —— 早先版本写 `<0|1|3>` 是笔误，Codex 已指出，此处更正。）
> 📌 `queue` / `dropped` 本批**固定 0**；这是"**本批没有队列**"，**不代表队列健康**。

**换算口径**：一律以 **`05_hardware/STB3-125_字段字典.csv` 的 `conv` 列为准**（`raw/10`、`raw-40`、`(H*65536)/1000+L` …）。
⚠️ 电量公式按文档写 `(H*65536)/1000 + L`，并在代码注释里注明「**该式存疑**，若设备语义是 32 位累加器（0.001 度）则应为 `(H*65536+L)/1000`，两者差 1000 倍」（见 `06_tests/db_proto.py` 文件头）。

### 3.2 心跳行（每轮都发，独立一类）

```
{"seq":<u32>,"dev":"ESP485-<6HEX>","ts":"<ISO8601>","ts_ok":<bool>,"type":"hb",
 "rssi":<d>,"free_heap":<u32>,"poll_ok":<u32>,"poll_err":<u32>,"udp_tx":<u32>,"queue":<u32>,"dropped":<u32>}
```

**两类行的关系**（**必须明确，这是本次唯一的"行为变更"**）：

| 本轮结果 | 发什么 |
| --- | --- |
| 三段全成功 | **数据行 1 行** |
| 任一段失败 | **心跳行 1 行**（原 `FAIL:Sx:原因` 不再单独成行，但**失败原因必须写进串口日志**，且计入 `poll_err`） |

> ⚠️ 这一条**修改了上一轮 P13 的行为**（原来失败发 `FAIL:Sx:原因`）。**改动理由**：对齐老师的两类行模型；
> **代价**：拔掉 USB 时现场看不到失败原因。⇒ **必须用计数器补偿**：`poll_err` 递增 + **串口日志保留 `FAIL:Sx:原因`**。
> 若总控认为现场可观测性更重要，可保留「失败时额外发一行 `{"type":"err","seg":"S2","reason":"TIMEOUT"}`」—— 请**在回报里给出你的建议**。

### 3.3 设备命名

- `dev` = `"ESP485-"` + **MAC 后 6 位十六进制大写**（例：MAC `48:F6:EE:15:9B:88` → `ESP485-159B88`）。
- `mac` = 完整 MAC（`WiFi.macAddress()` 的默认写法，冒号分隔大写）。

### 3.4 为什么必须保留 `raw`（**不要"优化"掉**）

老师的 JSON **只有工程量、没有原始值** ⇒ **他的历史数据不可重算**（公式一改只能重采）。
我们**多给一个 `raw` 字段**：JSON 接收端按名取值，多一个字段**不破坏兼容**，但换来
**公式可演进 + 历史可重放**。这是本项目相对参考实现的核心改进之一（`02_docs/16` §9.4）。

### 3.5 累计计数器

| 计数器 | 含义 |
| --- | --- |
| `poll_ok` | 三段全成功的**轮数**（不是段数） |
| `poll_err` | 至少有 1 段失败的**轮数** |
| `udp_tx` | UDP 发送**成功**的次数（`beginPacket`/`endPacket` 都返回 1） |
| `queue` / `dropped` | 预留；本批**固定发 0**（本批不引入队列） |
| `free_heap` | `ESP.getFreeHeap()` |
| `seq` | 每发**一行**（数据行或心跳行）自增 1，`uint32_t` 回绕正常 |

### 3.6 缓冲区

`g_payload` 目前 `char[384]`。**数据行加上 `raw`（78 字节 → 233 字符 HEX）后最长约 900 字节**
⇒ **必须把缓冲扩到 ≥1024**，并且沿用现有的"snprintf 返回值 ≥ sizeof 就告警"的检查。

### 3.7 时间戳

- `ts` 用 **ISO8601**：`strftime("%Y-%m-%dT%H:%M:%S")`。
- `ts_ok` = 本轮会话**确实收到过 NTP 回包**（沿用现有 `ntpHasReply()` 判据，**不要改回 `getLocalTime()`**）。
- 未同步时 `ts` 仍要填（用 `BOOT+<秒>` 或 `1970-01-01T00:00:00`），**并把 `ts_ok` 置 false** —— **字段不许缺**。

---

## 四、批次 2 · 概要（**本批不做**，先知道方向）

**一帧读全（`00 27`）为默认 + 失败自动降级 3 段。**
- 把 `QI_READ_SPLIT_3SEG` 默认改为 `0`；保留 3 段代码路径。
- 新增：一帧读全**连续 `N=3` 轮失败**（超时或 `01 84 xx`）⇒ **自动切 3 段**并打印一次告警（此后不再回切）。
- 意义：**一举给出 E-02 的答案**（真机到底接不接受 39 寄存器一帧读？），且对齐老师。
- ⚠️ 风险：会改动状态机与 E-02 判定，**必须与批次 1 分开**，且需要真机验证。

---

## 五、批次 3 · 概要（**本批不做**）

**配置体系**：常驻 AP + Web 配置页 + `/status` + NVS 持久化。
- 四栏表单：① WiFi（SSID/密码/开放网络） ② NTP + UDP 接收地址/端口 ③ 采集周期（1–5 s） **④ 管理账号（`admin_user`/`admin_pass`）**
- 路由：`GET /`（配置页）、`POST /save`、`GET /reset`、`GET /status`
- 用 core **自带**的 `WebServer.h` + `Preferences.h`（**不是第三方库**）；存 NVS。
- **安全（我们与老师的差异，必须是这样）**：
  - **AP 超时关闭**（上电开 N 分钟，或按键开启），**不做常开**
  - **一机一密**（AP 密码出厂随机写入 NVS，**不硬编码**）
  - **`/` 与 `/status` 都要鉴权**（`/status` 不能匿名读）
- ⇒ 单独一份施工指令，**等批次 1 验证通过后再发**。

---

## 六、批次 1 · 验收判据

| # | 判据 | 怎么验 |
| --- | --- | --- |
| 1 | **0 error / 0 warning** | `arduino-cli compile`（`--clean`），报告 Flash / RAM 增量 |
| 2 | 字段名 / 顺序与 `02_docs/17` §3 格式串**逐字一致** | 代码走查 + 回报里贴出你拼出的格式串 |
| 3 | **心跳行台面可验** | A/B 从面包板拔掉、USB 供电（**此配置无市电回路，安全**）；`udp_listen.py` 每秒应收到 1 行 `"type":"hb"`，含 `dev` / `seq` / `poll_ok` / `poll_err` / `udp_tx` |
| 4 | `dev` = `ESP485-<MAC后6位>` | 与板子实际 MAC 对照（本板 `48:F6:EE:15:9B:88` → `ESP485-159B88`） |
| 5 | 计数器语义正确 | 台面上每轮都失败 ⇒ `poll_ok` 应停在 0、`poll_err` 每秒 +1、`udp_tx` 每秒 +1 |
| 6 | 缓冲区够 | 数据行 + `raw` 不触发"缓冲不足"告警（可用合成数据在本地拼一次验证长度） |
| 7 | 原始值仍在 | 数据行含 `raw`（78 字节 HEX） |

> **数据行的完整验证需要一次真机运行**（485 侧要有真实应答）—— 这一步由用户安排，不必你执行。

---

## 七、回报格式

请逐条回复：

1. 改了哪些文件、每处改了什么的**清单**。
2. **你实际拼出的两行格式串**（数据行 / 心跳行，原文贴出）。
3. 编译结果：0 error / 0 warning？Flash / RAM 增量？缓冲区是否够？
4. §3.2 的**建议**：失败时"只发心跳行 + 计数器补偿"够不够？要不要额外发一行 `type:"err"`（用于现场可观测性）？
5. 任何你认为本指令**不成立、写错或做不到**的地方 —— **直接指出来，不要硬凑**。

---

## 八、批次 1 复核结论 + **需补的 3 项**（2026-10-06，WorkBuddy 复核后追加）

### 8.1 复核结论：**通过**

WorkBuddy 独立复现：`arduino-cli --clean --warnings all` → **`Sketch uses 1004579` / `Global variables 39108` / EXIT=0**，
与你的回报**逐字节一致**；硬约束逐条核过（`.113` / `172.16.0.2` / `"CST-8"` 无尖括号 / 9600+GPIO20/21 /
`DE_PIN -1` / 回环宏 0 / 清 RX 在 write 前 / 写帧功能码 **0 命中** / `delay()` 仅 setup 一处）；
6 处 `appendf` 的**格式串与实参逐个对上了**（含 `%c` 那段 18 个实参）；
本工程文件上 **0 error / 0 warning**（38 条警告全部来自 core 的 `gpspi_flash_ll.h` / `spimem_flash_ll.h`）。
**你对 §3.2 的建议、以及对"`0 warning` 不等于格式串没错配"的提醒，都采纳。**

### 8.2 🔴 需补的 3 项（请在**本次烧录之前**一起改完，可省一次断电窗口）

#### ① 🔴 最重要：`A/B/C_temp == -40` **不能进 `invalid`** —— 否则 `quality` 永远是 `PARTIAL`

**现象**：你在 `buildDataJson()` 里把 `pTemp[i] == -40` 判定为无效并 `addInvalid`（第 567~569 行）。
但该型号设备**恒不上报接线柱温度**（`raw` 恒为 0 ⇒ 恰为量程下限 −40，真机与老师的设备都是如此）。
⇒ **每一行数据的 `invalid` 都非空 ⇒ 每一行的 `quality` 都是 `PARTIAL`** ⇒ `quality` 字段**彻底失去区分度**。
（WorkBuddy 在做落库原型时**踩过同一个坑**并已修正：修正前后是 `OK=0/PARTIAL=6` → `OK=6/PARTIAL=0`。
见 `02_docs/16` §6 的「A3 的一个关键设计」。）

**要求**：把「**该型号已知不上报**」与「**本次异常**」分开。

| | 判定 | 是否进 `invalid` | 是否影响 `quality` |
| --- | --- | --- | --- |
| `<A\|B\|C>_temp` **恰好等于 −40** | **已知不上报** | ❌ 不进 | ❌ 不影响（仍可 `OK`） |
| `<A\|B\|C>_temp` 越界（< −40 或 > 160） | 本次异常 | ✅ 进 | ✅ 降为 `PARTIAL` |
| 其它字段越界 | 本次异常 | ✅ 进 | ✅ 降为 `PARTIAL` |

**做法（推荐）**：加编译期宏 `#define QI_PHASE_TEMP_ABSENT 1`（默认 1 = 该型号不上报接线柱温度）。
该宏为 1 时，`== -40` 走"已知不上报"分支；为 0 时退回当前行为。
（这样与 `06_tests/db_proto.py` 的 `--known-missing` 口径一致。）
**可选**：若想把信息留痕，可在数据行末尾追加 `"no_sensor":"A_temp,B_temp,C_temp"` —— 但**不要**靠它改 `quality`。

#### ② `QI_UDP_PAYLOAD_MAX`：`1024` → **`1200`**

你自己算出来的最坏情况是 **1106 B > 1024**（`invalid` 填满 + 10 位计数器）。
虽然 `appendf` 会置 `trunc` 并打印告警（不会静默截断），但**那一行 JSON 是不完整的**。
⇒ 把缓冲提到 **1200**（余量 ~90 B），一行常量的事。**同时**保留你的告警路径。

#### ③ `QI_SEND_ERR_ROW`：**实现它，且本次编译默认为 `1`**

你的分析我采纳 —— 失败时只发心跳行，**丢失了"哪一段 + 什么原因"**，这是相对上一轮 P13 的**可观测性倒退**。
而**第一次真机运行时 USB 必须拔掉**（安全红线：真机带电不得插 USB）⇒ **串口日志拿不到**
⇒ `type:"err"` 行是**唯一**能看见失败段与原因的通道。

**要求**：
- 新增 `#define QI_SEND_ERR_ROW 1`（**本次烧录用 1**；M6 之后可改回 0）。
- 为 1 时，失败轮在心跳行**之外**再发一行：
  `{"seq":%lu,"dev":"%s","ts":"%s","ts_ok":%s,"type":"err","seg":"%s","reason":"%s","poll_err":%lu}`
- 为 0 时严格两类行（对齐老师）。
- **串口日志里的 `FAIL:Sx:原因` 无论宏取值都保留。**

### 8.3 顺带要改的文档口径（**WorkBuddy 负责，你不用管**）

- `02_docs/17` / 本指令 §3.1 的 `seg` 枚举 `"0|1|3"` → **`"0|3"`**（你的第 3 条指出得对，`"1"` 本固件不产出）。
- `queue`/`dropped` 恒 0 需在文档注明「**本批没有队列，恒 0 不代表队列健康**」（你的第 6 条）。
- 心跳行去掉 `cfg` 的差异记为「**待批次 3 恢复**」（配置体系上线后 `cfg` 有语义）。

### 8.4 还请你回报

1. ①②③ 的落实方式（尤其 ① 的分支与 `quality` 判定）。
2. 改完后的 **Flash / RAM** 与 **0 error / 0 warning** 复核结果。
3. 你最坏情况的长度现在是多少（改完 ① 之后 `invalid` 通常只剩空，长度会明显下降）。
