jiangtao-ml/ESP32_C3_Gateway/02_docs/18_接手体检与优化建议_2026-10-06.md

# 18 · 接手体检与优化建议

> 最后更新：**2026-10-06 · 砚青（接手智能体）** —— 首次接手全仓体检；本文是**建议稿**，涉及决策类口径的改动**待姜涛拍板后再落地**。
> 位置：`02_docs/18_接手体检与优化建议_2026-10-06.md`（new）。与 `PROGRESS.md` / `00_context.md` 冲突时，**未拍板的建议不改现值**。

---

## 0. 一句话结论

**项目本身的工程纪律比一般学生项目强得多**（字段字典驱动、先模拟后真机、"作者≠验证者"、方法学红线留档）——这些是资产，不要动。

**拖效率的不是技术，是三件事：**

1. **同一份事实散在 8+ 个文件里** —— 最典型的 IP `.113` 遍布 8 个入库文件；它每隔几天就漂一次，每次要人工同步 8 处。
2. **规则本身在重复、并已自相矛盾** —— 同一批规则在 `PROGRESS.md` §2b/§6、接手指令 §5、`00_context.md` 里各写一遍；`README.md` §6.1 已出现两段互相打架的 EN 说明（证据见 §4.6）。
3. **一条"WorkBuddy 不许写 ESP32 代码"的硬分工，把最便宜的验证动作（编译、跑宿主机测试）也一并锁死了** —— 这条是把"作者≠验证者"这个**正确原则**，错误实现成了"某角色永久禁用某动作"。

---

## 1. 体检结果（结论 + 证据）

| 维度 | 现状 | 判断 |
| --- | --- | --- |
| 关卡 | M0–M5 全过；批次 1 代码完成待真机；M6/M7 未开始 | ✅ 进度真实、有证据 |
| 待提交 | 仅 `config.h` + `esp32c3_gateway.ino`（批次 1，预期内） | ✅ 工作区干净 |
| 代码规模 | `esp32c3_gateway.ino` **1194 行单文件**；含 WiFi/NTP/UDP/Modbus/CRC/JSON/状态机 | ⚠️ 批次 3 前必须拆分 |
| 文档规模 | `02_docs/` 16 份（含 47KB/44KB 审查存档）；任务书 85KB | ⚠️ 文档体量已超过代码一个量级 |
| 事实源 | `00_context.md` 94 行纯文本，内嵌 **8+ 处** `【本条由…同步，如需回滚请告知】` | ⚠️ "权威快照"和"变更日志"混在一个文件 |
| 规则数 | §2b 11 条 + §6 10 条 + §7 + §8 + 接手指令 §5 22 条，**大量重叠** | ⚠️ 见 §4 |
| 证据 | M5 关键证据 `03_logs/M5真机首测_*.log` **未入库**（`03_logs/*` 被 ignore） | ⚠️ 被引用的证据不在版本库里 |
| 版本号缺口 | `02_docs` 缺 08 / 09 / 10（M5 记录、成本、验收） | ⚠️ 三份结项交付物仍缺 |

---

## 2. 流程与协作：可优化项（按收益排序）

### 2.1 【高】事实源重构：单一机器可读源 + 一处叙述层

**现状**：`192.168.1.113` 出现在 8 个入库文件（`config.h`、`README.md`、固件 `README.md`、任务书 §11、`00_context.md`、`04_ai_prompts/02·03·04`、接手指令 §5）。**它每周漂 1~2 次**，每次都要人工核对全仓。

**建议**：
- 机器参数（IP / 端口 / 超时 / 帧）**只以 `01_firmware/esp32c3_gateway/config.h` 为唯一来源**。
- 文档里的这些值**改为指向**（如"当前 `UDP_TARGET_IP` 见 `config.h`"），不再逐处抄数值；保留漂移史只在一个地方（`README.md` §6.4）。
- 加一个 `06_tests/check_docs_sync.py`：扫描"文档写死的值"与 `config.h` 是否一致，不一致就报错。把"人工纪律"换成"自动检查"。

### 2.2 【高】规则去重：一个规则只写一次

**现状**：`git add -A` 禁令写在 §2b 第 6 条 + §6 第 1 条 + 接手指令 §5 第 10 条 + README §2.3；"改完留痕"写在 §2b 第 2/3/4 条 + §6 第 7/8/9 条 + 接手指令 §5 第 6/7/8 条。

**问题**：规则抄 3~4 遍 ⇒ 改一处忘一处 ⇒ 已经产生矛盾（§4.6 就是活证据）。

**建议**：**规则只保留在 `PROGRESS.md` §2b 一处**；`README`、接手指令、`00_context.md` 一律**改成引用**，不再复述。接手指令是"给外人看的拷贝"，允许它复制，但**每次改规则必须连带更新它**（或干脆让接手指令只写一句话："规则以 `PROGRESS.md` §2b 为准"）。

### 2.3 【高】解耦 M6 与 PlatformIO：这是**自设的路障**

**现状**：`PROGRESS.md` §5b / `README.md` §4 把 "M6 前置 = 先定 PlatformIO core" 写成了串行依赖。

**问题**：**M6 压测验的是"固件在真机上的长时间稳定性"，与"用哪个构建工具"技术上是正交的**。`arduino-cli` 已经能编能烧、行为已验过 5 个关卡。把 PlatformIO 的 core 选择卡在 M6 前面，会让**唯一还需要真机做的事**被迫等一个纯工程问题。

**建议**：
- **M6 现在就能跑**（arduino-cli 产物），门槛改为"批次 1/2 真机通过"。
- PlatformIO 迁移降为**独立工作流**（导师要求的组内工具链统一），**不与 M6 串行**；迁完再单独补一次对照验证。

### 2.4 【中】证据入库缺口

**现状**：`03_logs/*` 被 `.gitignore` 忽略，但 `PROGRESS.md` / `00_context.md` 反复引用 `03_logs/M5真机首测_20261005_2035.log` 作为"M5 通过"的证据 ⇒ **证据在本地，仓库里没有**。同理 `老师固件_app镜像_20261005.bin`（逆向依据）也不入库。

**建议**：把**关键证据**的"结论摘要 + 关键片段"写进 `02_docs/`（正缺的 `08_M5真机联调记录.md` 正好承担这个），并**允许 `03_logs/` 里加白名单**（如 `!03_logs/M5真机首测_*.log`）保留原始证据。

### 2.5 【中】多智能体并发无锁

**现状**："不要和另一个智能体同时改同一个文件"只能靠 `git status` + 自觉。Codex 常驻同仓库。

**建议**：轻量加锁——改公共文件前先在该文件顶部留一行 `> 锁定：<角色> <日期>` 或用 `.workbuddy/tmp/LOCK.<文件>` 约定；**或**更简单：**明确"谁拥有哪个文件"**（如 firmware 归 Codex/我，`02_docs` 归我，`00_context` 归用户），把并发面降到最低。

---

## 3. 代码结构：可优化项

### 3.1 【高·批次 3 前必做】1194 行单文件的拆分

**现状**：`esp32c3_gateway.ino` 单文件承载 WiFi / NTP / UDP / Modbus 帧组装 / CRC / JSON 三行 / 状态机 / 解析。批次 3（AP + Web 配置页 + `/status` + NVS）会再塞进至少 400~600 行。

**建议**：批次 3 之前拆成 `.h/.cpp`（Arduino 支持同目录多文件）：
- `net.{h,cpp}`（WiFi / NTP / UDP）、`qi_modbus.{h,cpp}`（帧 / CRC / 解析）、`report.{h,cpp}`（JSON 三行）、`web_cfg.{h,cpp}`（批次 3）。
- ⚠️ 这**违反" M6 只加固不重构"**，所以**必须把"拆分"作为一个独立、零行为变更的步骤**（拆完逐字节比对编译产物大小 / 冒烟一次），不与功能变更同批。**若你决定不拆，就要接受批次 3 后单文件 1800 行。**

### 3.2 【高】纯函数没有宿主机测试

**现状**：CRC16、Modbus 解析、JSON 组装、温度换算——**全都能在 PC 上跑**，但现在只能在真机/串口上验。这正是项目"验证成本高、真机机会少"的根因。

**建议**：加一个宿主侧测试（把纯函数抽到 `qi_pure.h`，用 gcc/py 对拍 + `06_tests/` 里放向量表）。收益：**改解析/CRC 再也不用等真机**。`db_proto.py` 已经有字段字典和换算，可作为"参照实现"对拍。

### 3.3 【中】编译/烧录无脚本

**现状**：每次要敲那一长串 arduino-cli 路径 + `--fqbn ...:CDCOnBoot=cdc`，容易漏 `CDCOnBoot`（漏了 Serial 会抢 GPIO20/21）。

**建议**：`01_firmware/build.ps1`（compile）/ `upload.ps1`（compile+upload COM 口自动探测），把易错参数固化。零风险。

---

## 4. 识别到的"过死 / 不灵活"规则（逐条：现状 → 问题 → 建议）

> 这一节直接回应"哪些规则太死"。**每条都只给建议，不擅自改。**

| # | 规则（出处） | 问题 | 建议 |
| --- | --- | --- | --- |
| 4.1 | **"WorkBuddy 不写 ESP32 业务代码"**（§2b 第9条 / §2 / README §2.3 / `00_context` 一） | 把**正确的**"作者≠验证者"实现成了"某角色**永久禁用**某动作"。我手上有 `arduino-cli`，能编能烧能跑宿主机测试，却连改一个 `#define` 都要绕道 ⇒ 最便宜的验证动作也被锁死。 | **改为"任何人都可以改代码，但改动必须有第二双眼睛"**：我改 → 由 Codex / 另一个智能体 / 你复核后才定案；**唯一硬约束 = 不得自审自改**。（保留"真机接线/烧录归你"这条物理边界。） |
| 4.2 | **"决策类改动必须挂 `PROGRESS.md` §8"**（§2b 第2/3/4条 + §6 第7/8/9条） | §8.2 一天就长了 8 行，且**单调增长、无回收**。它把"留痕"这个好习惯变成一块**永不清空的告示板** ⇒ 很快没人看。 | 留痕**落到文档自己的"变更记录"行即可**；`§8` 只保留**尚未闭环**的活条目（已闭环即出列，归档到文档本身）。**取消"决策类必须再挂 §8"这条双写要求。** |
| 4.3 | **"不得自主 `codex exec`"**（§2b 第10条） | 规则本身合理（自主发起危险）。但连带后果是**所有跨智能体协作要人肉转交，你的对话就是消息总线** ⇒ 延迟主因。 | **规则保留**。缓解靠"**减少协作次数**"：把无需第二方判断的活（文档、脚本、宿主机测试、编译）全部由我直接做完，只在"需要写业务逻辑 + 要独立复核"时才产提示词给 Codex。 |
| 4.4 | **"M6 前置 = 先定 PlatformIO core"**（§5b / README §4） | 自设路障：把正交的两件事捆成串行（见 §2.3）。 | 解耦；M6 用 arduino-cli 直接跑。 |
| 4.5 | **"`00_context.md` 逐处行内留痕"**（§2b 第4条） | 该文件已内嵌 8+ 处 `【本条由…同步，如需回滚请告知】` ⇒ **既不是干净快照、也不是变更日志**，两边不靠，且引用了它的人越来越难读。 | 把 `00_context.md` 恢复成**干净事实快照**；变更痕迹移到**文末"变更记录"小节**（一处集中）。 |
| 4.6 | **文档一致性纪律**（§2b 第2条，无自动校验） | 已经产生矛盾：`README.md` §6.1 有**两段打架的 EN 说明**（L145"丝印已确认 MAX13487" vs L146"随型号二选一"）；同节 L138 仍写"型号待丝印复核"（早已闭环）；`00_context.md` 三.2/三.3 仍写"未实测前一律按 5V 处理"（实测已直连通过）。 | 见 §2.1 的自动检查脚本 + 一次"过期事实清扫"（属决策类→待你授权一次批量清理）。 |
| 4.7 | **"一次只推进一个最小可验证目标"**（接手指令 #你的角色） | 原则正确，但在**没有真机**时，它会把"等待真机"变成唯一节奏 ⇒ 空转。 | 补一条**"无真机时的并行轨道"**：文档补全 / 宿主机测试 / 脚本 / 拆分重构——都在真机之外可独立验证。 |

---

## 5. 可执行改进方案（分级）

### 5.1 现在就能做（零依赖、不动决策类、我可直接干）

| # | 动作 | 产出 | 风险 |
| --- | --- | --- | --- |
| A1 | 写 `02_docs/08_M5真机联调记录.md`（唯一欠交付） | M5 结项记录 + 证据摘要 | 无 |
| A2 | 修 `README.md` §6.1 的两段 EN 矛盾 + L138 过期"待复核" | 文档自洽 | 低（事实类） |
| A3 | 修 `00_context.md` 三.2/三.3 过期口径（实测已可直连） | SSOT 准确 | 低（事实类，按最严档留痕） |
| A4 | 统一温度量程口径（`db_proto.py:127` −80…120 vs 固件 −40…160） | §8.1 第3条闭环 | 低（事实类） |
| A5 | 加 `01_firmware/build.ps1` / `upload.ps1` | 编译烧录一键化 | 无 |
| A6 | 加 `06_tests/check_docs_sync.py` | 自动查文档与 `config.h` 漂移 | 无 |
| A7 | 把我 `.workbuddy/tmp/` 里 24+ 个历史构建目录清掉（不入库，纯本机） | 工作区整洁 | 无 |

### 5.2 需你拍板（决策类）

- **D1**：放宽 4.1（我可以写代码，条件=第二方复核）？—— **这是收益最大的一条**。
- **D2**：授权一次"事实源重构 + 过期事实清扫"（§2.1 / §2.2 / §4.5 / §4.6）？
- **D3**：解除 M6 与 PlatformIO 的绑定（§2.3 / §4.4）？
- **D4**：关键证据入库（§2.4）——允许 `03_logs/` 加证据白名单？

### 5.3 批次相关（等真机）

- 批次 1：真机跑一次 → commit（**你是唯一能碰真机的人，这是硬瓶颈**）。
- 批次 2：一帧读全 + 降级（顺带答 E-02）。
- 批次 3 **之前**：先做 §3.1 拆分。

---

## 6. 接手后我的推进计划

**核心判断：本项目的硬瓶颈是"真机机会稀缺"（只有你能碰配电箱），不是"没人写代码"。**
所以我的推进原则是——**把真机每一次都用在只能真机验证的事上，其余全部前置做完。**

| 时间 | 做什么 |
| --- | --- |
| **本轮（今晚）** | 交本文 + 等你拍板 D1~D4；同时可立即开 A1~A4（若你说"直接做"）。 |
| **真机前** | 把 5.1 全部做完：M5 记录、文档清矛盾、一键编译脚本、自动一致性检查、宿主机测试。**目的：真机上只需验"新功能行为"，不浪费在环境/文档问题上。** |
| **真机（你有窗口时）** | 批次 1：台面预演 → 真机跑 → commit。**我逐步给你判据和失败处置**（沿用接手指令的口径）。 |
| **真机后** | 批次 2 指令 + 你跑 → 验 E-02；同时我并行做批次 3 的拆分准备。 |
| **M6** | 解耦后直接用 arduino-cli 跑 ≥10 分钟真机压测；PlatformIO 迁移单独排期。 |

**我给自己定的节奏**：一次只给你**一个**真机动作 + 明确判据；其余时间不打扰你，能做的事情直接做完汇报。

---

## 7. 我要你拍板的三件事（其余我可自行推进）

1. **D1**：我能不能写 ESP32 代码（条件：改完交 Codex/你独立复核，绝不自审自改）？
2. **D2**：允不允许我做一次"事实源轻量重构 + 过期事实清扫"（改动 `README` / `00_context` / `PROGRESS` 的重复与矛盾条目）？
3. **D3**：M6 解绑 PlatformIO，现在就能跑？

> 拍板后我按 §5 开干；拍板前**只做 5.1 里零风险项**。

---

## 8. 决策结果与执行记录（2026-10-06 夜 · 砚青）

| 决策 | 结果 | 已落地 |
| --- | --- | --- |
| **D1** 我可否写 ESP32 代码 | ✅ **可以**（条件：改完交 Codex/用户独立复核，绝不自审自改） | `PROGRESS.md` §2 / §2b 第 9 条；`00_context.md` 一（C-8） |
| **D2** 事实源轻量重构 + 过期事实清扫 | ✅ **允许，已执行** | `README.md` §6.1（两段矛盾 EN 合成一条 + 清除"待复核"）；`00_context.md` 三（过期表述清除）+ 新增「七、变更记录」；`db_proto.py` 温度口径统一 |
| **D3** 解绑 M6 与 PlatformIO | ❌ **撤回** —— 老师要求组内用 PlatformIO，属**硬交付约束** | `PROGRESS.md` §5b 已改写：先打通迁移（真阻塞 = core 选择 + 离线安装），再跑 M6 |

**本轮实际产出（除本报告外）**

1. `06_tests/db_proto.py`：修正温度量程口径（`raw_min/raw_max` 实为"换算后工程量范围"，不再二次减 40）⇒ 与固件一致，闭合 §8.1-3。
2. `README.md`：§6.1 去重校准。
3. `00_context.md`：过期事实清扫 + 变更记录归置（C-7/C-8）。
4. `PROGRESS.md`：D1/D2/D3 入档、§5b 改写、§8.1 闭环。
5. `02_docs/08_M5真机联调记录.md`：**补齐原唯一欠交付**。

**D3 修正后的推进顺序**（取代原 §6 表里的 M6 行）：

```
批次 1 真机验证 → commit → 批次 2（顺带答 E-02）
   → 【打通 PlatformIO 迁移：先定 core + 离线安装】→ M6 压测 → M7 验收
```

> 待办：`06_tests/check_docs_sync.py`（自动查文档与 `config.h` 漂移）、`01_firmware/build.ps1`（一键编译）——尚未做，列入下一轮零依赖项。
