jiangtao-ml/ESP32_C3_Gateway/04_ai_prompts/03_Codex提示词_M5功能码与3段读取.md

# Codex 施工指令 · M5 第一次烧录：功能码 0x03→0x04 + 3 段读取

| 项 | 内容 |
| --- | --- |
| 文档 | `04_ai_prompts/03_Codex提示词_M5功能码与3段读取.md` |
| 发出 | WorkBuddy（文档 / 测试角色） |
| 日期 | 2026-10-05 |
| 接收 | Codex（写代码 / 编译；**也可改「事实类」文档** —— 见 `PROGRESS.md` §6 第 7 条。**决策类改动必须留痕**） |
| 事实来源 | `04_ai_prompts/00_context.md` |
| 规格来源 | `05_hardware/STB3-125_Errata.md` §4「B 方案：3 段读取」；`02_docs/06_QI协议说明.md` §6 / §7 |
| 现行操作卡 | `06_tests/M5_真机联调操作卡.md` §0b / §0c / §4 / §6 |
| 本步目的 | 让固件能对 **QI 真机（STB3-125）** 发 `0x04` 读输入寄存器；并把上一轮 M4 遗留的临时档位收回到正式值 |

> ⚠️ **勘误（2026-10-06 补注，仅记事实不改历史）**：本指令成文时记的电脑 IP `192.168.1.114` **已被后续实测取代** —— `config.h` 现值 = **`192.168.1.113`**（见 `04_ai_prompts/04` 第 2 条 / `00_context.md` 四.4.4 / `PROGRESS.md` §0）。**开工前一律以 `ipconfig /all` 实测为准**，不一致先报告再改。本指令已完成，原文保留。

> ⚠️ **本指令只做一件事：把轮询帧从 M4 的 `0x03` 回环帧换成 M5 的 `0x04` 真机帧，并启用 3 段读取。**
> 不要顺手改 NTP、不要改 UART 引脚、不要重构状态机。

> 🔴 **现场约束（2026-10-05 19:08 由用户确认，决定了 P13 是强制项）**：
> 有充电宝；**没有 USB 转 485**；**真机与 MAX13487 的 A/B 已接好、配电箱带电运行**。
> ⇒ ① **线 A 台面预演做不了**，直接上真机；② 真机带电期间 USB 必须拔掉 ⇒ **运行期拿不到串口日志**，
> **UDP 是唯一可观察通道**。详见 §五与本指令硬约束 12。

---

## 一、硬约束（**不得改动**，与上一轮一致）
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
