jiangtao-ml/ESP32_C3_Gateway/02_docs/17_参考实现逆向笔记_2026-10-05.md

# 17 · 参考实现逆向笔记（直接读老师的固件 flash）

| 项 | 内容 |
| --- | --- |
| 文档 | `02_docs/17_参考实现逆向笔记_2026-10-05.md` |
| 版本 | v1.0 |
| 日期 | 2026-10-05 |
| 作者 | WorkBuddy（文档 / 测试角色） |
| 对象 | 用户手上另一块 ESP32-C3（`MAC 48:F6:EE:15:9B:88`，端口 **COM11**） |
| 方法 | `esptool 5.3.0` `read_flash`：app 位于 `0x10000`，取 **1.25 MB**（160 个子块，缺 1 个 8 KB） |
| 安全状态 | **`Secure Boot: Disabled` / `Flash Encryption: Disabled`** ⇒ 明文可读 |
| 关联 | `02_docs/16_数据落地与商业化设计.md` §8（与参考实现的对比）、§9（推进计划） |
| 产物 | `03_logs/老师固件_配置页_20261005.html`、`03_logs/老师固件_app镜像_20261005.bin`、`03_logs/老师固件_字符串报告_20261005.txt`（`03_logs` 不入库） |
| 工具 | `06_tests/fw_strings.py`（可复用：从 flash 镜像提取字符串/JSON 字段名/HTML 片段） |

> **只读分析，未对板子做任何写操作。** 能拿到的**只有字符串** —— 宏、被优化掉的中间量、
> 隐藏逻辑、注释全都看不到。协议字段名与格式串是其中"最可靠的那部分"。

---
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
