jiangtao-ml/ESP32_C3_Gateway/05_hardware/洞洞板落点方案_7x9.png

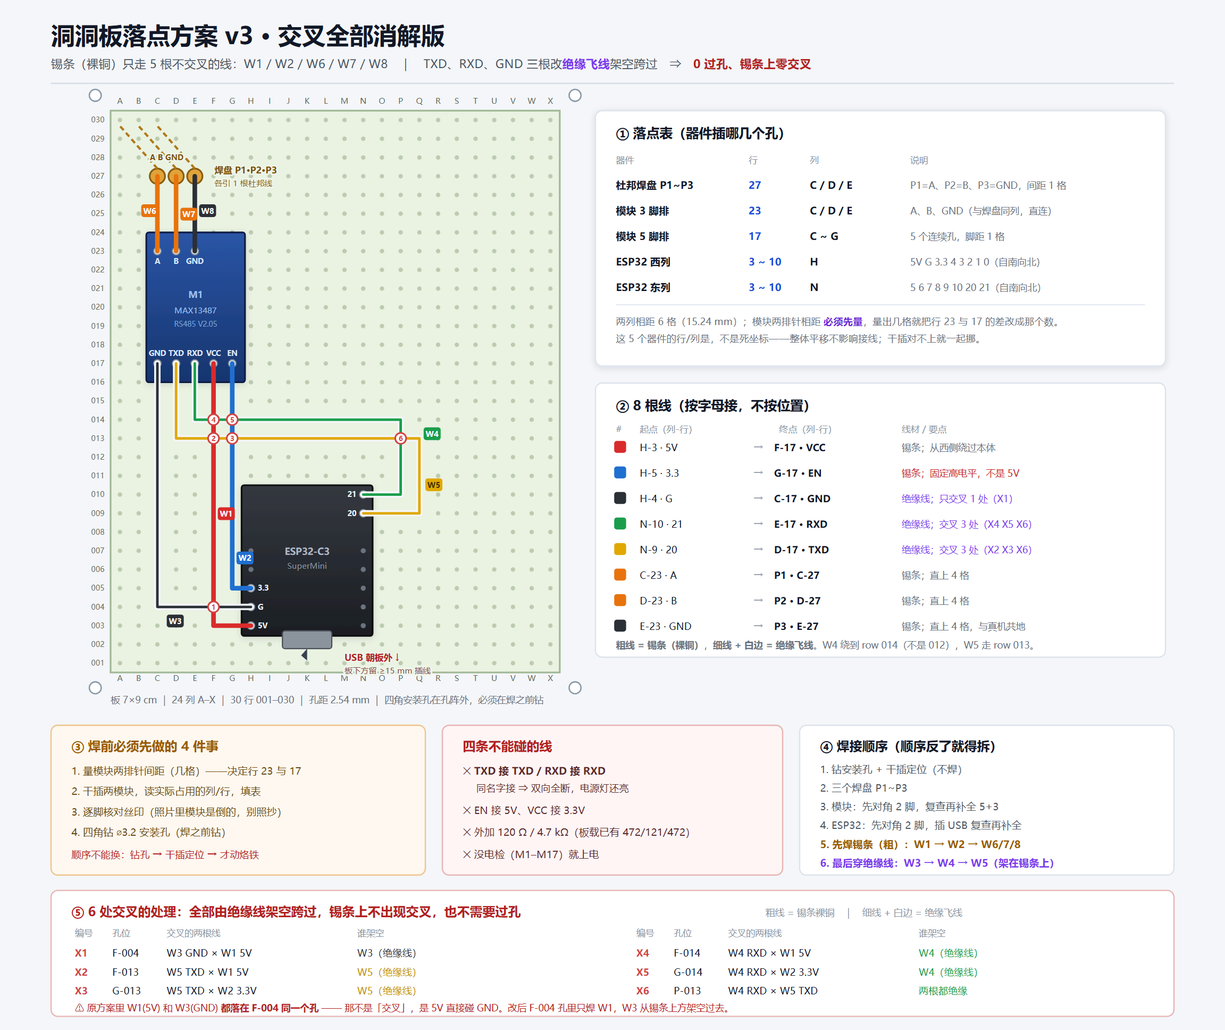
05_hardware/洞洞板落点方案_7x9.png
