jiangtao-ml/ESP32_C3_Gateway/02_docs/32_168h起跑前置清单与风险预演_2026-10-27.md

# 32 168h 起跑前置清单与风险预演

> 最后更新：**2026-10-27 砚青** 新建
>
> 目的：把"跑完 168h 才发现判据不合理 / 口径没定 / 环境不满足"这类**返工**扼杀在起跑前。
> 依据：`02_docs/24` §3（34 条验收）、§3.5（8h 门控）、§8（未闭环 6 件）；`02_docs/30`（加固与 B 类裁定）；真机实测。
>
> **本文件只列"会阻断或会白跑"的项，不重复 `02_docs/24` 的完整判据表。**

---

## 0. 一句话：什么时候能跑

**不是"烧录完就能跑"。** 起跑要同时满足 **8 道门**（§1），其中 **G-6（旧电脑不休眠）是文档级硬门槛**——
`02_docs/24` §8 Q2 原文："不能禁休眠 ⇒ 168h 不可开跑"。

**最早时间点估算**（假设 USB 线能马上换好）：

| 时刻 | 动作 | 耗时 |
|---|---|---|
| T+0 | 换线、系统识别到 COM5 | —（**当前卡在这里**） |
| T+2 min | 烧录 `0.7.0-batch4` | 2 min |
| T+5 min | 台架 4 项（boot / reconn / 弱网配置页 / 串口日志） | 25 min |
| T+30 min | WDT 注入验（烧测试版 → 验 → 烧回正式版） | 15 min |
| T+45 min | **开跑**（前 8h 兼作 §3.5 门控） | — |

⇒ **线换好的时间 + 约 45 分钟**。今晚 22:30 换好 ⇒ **23:15 可开跑** ⇒ 收工时间 **11-03 23:15**。

---

## 0.5 旧 8h 门控的适用范围（**能复用一半，不能全复用**）

2026-10-26/27 那轮 8h 跑的是 **`0.6.0-batch3`（加固前）**：M2 = 99.9788%、M3 = 99.9859%、err 0、对账残差 0。
现在要跑的是 **`0.7.0-batch4`**，相对它改了 **10 处**。

| 维度 | 旧 8h 能否覆盖 | 说明 |
|---|---|---|
| **链路 / 环境**（M2、M3、空口丢、路由、DHCP） | ✅ **有效可复用** | 环境没变（同 SSID、同网段、同接收端机器）⇒ "链路能跑到 98%+" 仍然成立 |
| **M-11/M-12 抖动** | ✅ 有效（但结论是 F） | 上轮 82.1 ms / 1205 ms；新固件不会让抖动变小 |
| **Y-4 时钟回跳 `CLOCK_STEP`** | ❌ **完全不能复用** | 旧固件**没有钳位机制**。那次 `CLOCK_STEP = 0` 只说明"8 h 内没遇到回退"（**运气**），推不出"新钳位有效" |
| **Y-7 非人为重启** | ❌ 不能复用 | 新固件多了 WDT（60 s）——**新增了一个会触发重启的机制**，旧数据无法预测 |
| **`reconn` / `boot` / `clk_hold`** | ❌ 不能复用 | 旧固件这些字段要么恒 0、要么不存在 |
| **电量公式（D-10）** | ❌ 不能复用 | 旧固件用错公式，读数差 1000 倍 |
| **`/status` 的 `queue`/`dropped`** | ❌ 不能复用 | 旧发 `0`、新发 `null` |

**结论**：旧 8h 证明了"**这条路能跑通**"，但**证明不了"新固件不会把路走坏"**。
而新固件的核心改动（时钟钳位、WDT、boot 计数）**恰恰全落在"不能复用"那一栏**，且 **Y-4 一票否决**。

⇒ **不必再单独跑一个独立 8h**（那是白等 8 小时），但**新固件必须自己跑一段并过 8h 门控线**。
最省的做法就是并入 168h 的前 8h（见 §5）。

---

## 1. 八道门（全部满足才允许起跑）

| # | 门 | 判据 | 状态 | 谁 |
|---|---|---|---|---|
| **G-1** | 固件可烧 | COM5 出现，烧录成功，串口打印 `fw=0.7.0-batch4` | 🔴 **阻塞**（COM5 未识别） | 用户换线 |
| **G-2** | boot 计数正确 | 拔电重插 ⇒ `boot=1`；软复位 ⇒ `boot` 严格 +1 | ⬜ 待烧录后验 | 砚青 |
| **G-3** | `reconn` 递增 | 断网 1 min 恢复 ⇒ 心跳 `reconn` 单调增（验 A-1） | ⬜ 待验 | 用户断网 |
| **G-4** | WDT 真会触发 | 注入 `while(1)` ⇒ 60 s 后 `reset=TASK_WDT`、`boot` +1 | ⬜ 待验 | 砚青 |
| **G-5** | 弱网配置页不误杀 | 慢客户端拉 8 KB 页 ⇒ 不重启（验 F-4 的 60 s 是否够） | ⬜ 待验 | 砚青 |
| **G-6a** | 旧电脑不休眠 | 电源计划「从不睡眠」**实际改掉并回显确认** | 🟡 **用户已答"能"**，待实际确认 | 用户/旧电脑 |
| **G-6b** | **旧电脑 IP 不漂移** | 用户已确认 **IP 是 DHCP**（非静态）⇒ 必须做路由器 **MAC-IP 绑定**（首选）或改静态 | 🔴 **必须处理**（见 §1.1） | 用户/旧电脑 |
| **G-7** | 磁盘余量 | 全程 ≥10 GB（Y-9）。估算：1.2 M 行 × ≈500 B ≈ **0.6 GB** + 原始包 ≈0.4 GB ⇒ 约 **1 GB** | ⬜ 待查 | 旧电脑 |
| **G-8** | **启动命令不含 `--key-hex`** | 固件发**明文**、接收端 `decrypt_frame()` 是 **fail-closed**（解不出返 `None`）⇒ 带了这个参数会**把每一个包都丢掉** | 🔴 **必须逐字核对启动命令** | 用户/旧电脑 |

> ⚠️ **G-6 是唯一"软件侧再怎么改都救不了"的项**。DHCP 租约若中途换 IP，UDP 目标不变但**回程不可达**，
> 整段数据断档且无法在事后补救。2026-10-27 21:47 已发生过一次租约到期风险。

### 1.1 G-6b：**IP 是 DHCP** 怎么处理（2026-10-27 用户确认）

风险：租约到期换 IP ⇒ ESP32 的 UDP 目标（**存在 NVS 的 `udp_ip`**）失效 ⇒ **单向黑洞**：
ESP32 照发、`udp_tx` 正常涨，但接收端一个都收不到。这是"看起来在跑、其实全丢"的最坏形态。

| 方案 | 做法 | 优 | 劣 |
|---|---|---|---|
| **A（首选）路由器 MAC-IP 绑定** | 路由器管理页 → DHCP 保留 / 静态分配 → 绑定旧电脑网卡 MAC | 最稳；旧电脑零改动；不影响其他设备 | 需路由器管理权限 |
| **B 旧电脑设静态 IP** | 选 **DHCP 池外**地址（如 `172.16.0.250`），配好掩码/网关/DNS | 不需路由器权限 | 选到池内地址会**撞 IP**；网关/DNS 配错直接断网；改回麻烦 |
| **C 兜底：巡检 + 热改** | 巡检看 IP；变了就连 ESP32 的 AP（`ESP485-xxxx`）→ 配置页 → 改 server → `/save` | 零前置 | 变 IP 到发现之间**必丢数据** |

**关键事实**：ESP32 的 UDP 目标在 **NVS**，用 Web `/save` 改**立即生效、不需要重烧**（批次 3 的设计）。
⇒ 方案 C 是**可恢复**的，不是灾难。建议 **A 或 B 为主 + C 作兜底监控**。

- ⚠️ **禁止 `/reset`**（会清空 NVS，含 WiFi 凭据与 UDP 目标）
- ⚠️ 若旧 IP 被**别的机器**占用，那台机器会收到 ESP32 的包（数据泄漏 + 我们收不到）。
  巡检若见到"`udp_tx` 正常涨但落库为 0"，**优先怀疑这条**

---

## 2. 判据口径预置（**这类才是"跑完才发现"的重灾区**）

必须在开跑**之前**把下列口径写死，否则 168h 结束当天会为"这条到底算不算 F"吵起来。

| # | 问题 | 现状风险 | 建议口径（待用户/导师确认） |
|---|---|---|---|
| **C-1** | **M-11 抖动 p99 ≤50 ms** | 上一轮 8h 实测 **82.1 ms** ⇒ **必 F** | ✅ **口径已认（2026-10-27 用户确认）**：报告写"**F 但归因明确**"，附 `recv_mono` 中位数 + 直方图，说明是接收端落库时刻（含 Python GIL / 写盘 fsync）而非空口抖动。**不计入中止判据** |
| **C-2** | **M-12 抖动 max ≤200 ms** | 上一轮 **1205 ms** ⇒ **必 F** | ✅ **口径已认（同上）**：报告单列"离群点时刻表"并归因（GC / fsync / DHCP 续租），标注为**离群点而非系统性劣化** |
| **C-3** | **P-6 每日备份数 = 运行天数（≤3）** | 168h = **7 天**，与"≤3"直接冲突 | 168h 应记 **7**。`≤3` 是给 8h/24h 用的。**须改口径**，否则 P-6 必 M |
| **C-4** | **Y-1 M2 ≥96%** vs **§3.5 门控 97.5%** | 两套数字，极易混 | 明确：**96% 是 168h 主判据**；**97.5% 只是 8h 门控放行线**。报告里两个都要写，不得只写一个 |
| **C-5** | **RAW `bad=2000/2000`** | ✅ **已定性（2026-10-27 22:2x）**：根因是 `verify_raw()` 比 `openState` 时**中文 vs HEX 口径不一致**，每行必错 1 个；抽样上限写死 2000 ⇒ `2000×1=2000`，**数值严丝合缝**。`udp_collect.py:2113-2121` 已修复 | **不是数据损坏、不是固件问题**。仍须旧电脑跑 `--verify-raw` **验证修复生效**（`bad` 应≈0）。指令：`04_ai_prompts/14`。⚠️ 必须用 `--verify-raw`，`--report-only` 只读历史快照、不重算 |
| **C-6** | **Y-4 的 `clk_hold` 交叉证据** | lwip 每 3h 自同步会走 `ts` 护栏而非钳位 ⇒ `clk_hold` 可能为 0 而**仍合格** | 已在 `02_docs/30` §5.2 修正：**`CLOCK_STEP = 0` 是唯一必须**；`clk_hold = 0` 不等于未验证 |
| **C-7** | **电量跨 `L` 进位** | `A_L≈58965`，剩 6570 Wh，168h 按 41 W 需 6888 Wh ⇒ **必然跨一次 65535→0** | 新增判据：**进位时刻电量必须连续（+0.001 度），无跳变**。`db_proto.py:220` 已用 `H*65536+L` 拼接值比较，可正确跨进位 ✓ |
| **C-8** | **UDP 是否加密** | **明文**。固件零加密代码（无 `ENC_ON`/AES/TLS）；接收端 `decrypt_frame()`（AES-128-GCM，`--key-hex` 启用）**从未与固件对接** | **168h 一律不加 `--key-hex`**。理由：①固件本就不加密，加了必然全丢（fail-closed）；②加密会引入新变量（CPU 开销、包变大、可能拉高抖动），污染长跑数据；③安全收紧属 **M7**（`02_docs/26:65` 已登记"UDP 明文 + AP 常开 ⇒ 同网段可嗅探/伪造，只在隔离实验网段用"）。**不要用 168h 兼做加密 A/B** |

> **C-1/C-2/C-5 三条是"必 F 项 / 未定性项"，必须在开跑前敲定，否则 168h 跑完当天必然返工。**

---

## 3. 运行期故障预演（15 类）

| # | 故障 | 症状 | 判据 | 预案 | 要中止？ |
|---|---|---|---|---|---|
| F-1 | ESP32 供电中断 | `boot` 突增、`reset=POWERON/BROWNOUT`、数据断档 | Y-7 非人为重启 | 确认 USB 来自不关机的台式机；不碰插排 | **是**（若原因不明） |
| F-2 | WiFi 断（SSID `402FBS`） | `reconn` 递增、心跳 `rssi` 异常、数据行断 | M-15 在线率 ≥99% | 自动重连已有；短断可接受 | 否（<1% 时长） |
| F-3 | **旧电脑休眠** | 整段数据归零、`stat_snapshot` 停 | Y-8 覆盖空洞 | **G-6 必须先落实** | **是** |
| F-4 | 旧电脑 IP 变化（DHCP） | UDP 单向可达、`udp_tx` 正常但落库为 0 | Y-2 M3 | G-6 先落实静态 IP | **是** |
| F-5 | NTP 全挂 | 心跳 `ts_ok=false`、`ts` 变 `BOOT+` | M-13 可信率 ≥99% | 三源（校内 chrony → aliyun → 203.107.6.88）；手机热点兜底 | 否（但报告要解释） |
| F-6 | `CLOCK_STEP > 0` | 接收端 `event_log` 有记录 | **Y-4 = 0 一票否决** | 新固件双保险（钳位 + `ts` 护栏） | **是** |
| F-7 | WDT 误杀 | `reset=TASK_WDT`、`boot` +1、60 s 缺口 | Y-7 | 台架 G-5 先验；若真发生 ⇒ 抬到 120 s 重跑 | **是** |
| F-8 | 电量跨进位跳变 | `energy` 突降 | 新增 C-7 | 公式已修，理论连续；若跳变 ⇒ 公式仍有误 | **是** |
| F-9 | 磁盘写满 | `disk_free_mb` 降 | Y-9 ≥10 GB | 估算仅 1 GB，风险低 | **是** |
| F-10 | 接收端进程崩 | `collect_run.starts > 1` | P-2 | 需自动拉起（systemd/screen） | 否（可续） |
| F-11 | `q_drop > 0` | 接收端自己丢包 | **Y-5 = 0** | 加大 `Q_MAX`；降低落库频率 | **是** |
| F-12 | 同秒撞车丢行 | `SAME_SECOND` 计数 | M-10 = 0 | `ts` 护栏已防倒退；若仍发生 ⇒ 查 `ts` 单调性 | **是** |
| F-13 | 485 链路异常 | `poll_err` 上升 | M-1 ≥97% | 检查接线/共地；AutoDirection 无状态反馈 | 否（<3%） |
| F-14 | `/status` 被轮询而崩 | 接收端报 `TypeError` | — | **已核实：接收端不轮询 `/status`** ✓（只有 `--fw-ver` 记录参数） | 否 |
| F-15 | 本机关机 | 我读不到串口 | — | **168h 在旧电脑跑，与本机无关**；本机只用于事后分析 | 否 |

---

## 4. 中止判据（**该停就停，别硬撑**）

出现任一条，**立即停止并排查**，不要"再等等看"：

1. `event_log` 出现**任何** `CLOCK_STEP`（Y-4 一票否决，已废）
2. `boot` 非人为增加（Y-7）
3. `q_drop > 0`（Y-5）
4. 电量出现负跳变（C-7）
5. 旧电脑 IP 变化 / 休眠过（F-3/F-4，数据已断档不可补）
6. 累计缺口 >4%（M2 已无余量，96% 是死线）

> 反之，以下**不必中止**：单次 WiFi 短断、`ts_ok` 短暂 false、M-11/M-12 抖动超标（已知必 F）。

---

## 5. 巡检时间表

| 时刻 | 检查项 | 通过则 |
|---|---|---|
| 起跑 +3 h | `CLOCK_STEP=0`、`boot` 未变、`poll_ok` 正常、`clk_hold`/`clk_back` 有值 | 继续（**这一关覆盖一个完整 lwip SNTP 周期**） |
| 起跑 +8 h | **M2 ≥97.5%**（`02_docs/24` §3.5 门控放行线）、M1 ≥97%、Y-4/Y-5/Y-7 全过 | **正式计入 168h**；否则停 |
| 每日 1 次 | **旧电脑 IP 未变**（`ipconfig`）、磁盘余量、`q_drop`、`boot`、`reconn`、电量连续性；若 `udp_tx` 涨而落库不涨 ⇒ 立刻查 IP / 是否被顶替 | 继续 |
| +168 h | 收工，出报告（`--report-only` 与运行时报告 `sha256` 必须一致，P-4） | — |

---

## 6. 仍需用户/导师确认的 3 件事（开跑前）

| # | 事项 | 答复（2026-10-27 22:20） | 剩余动作 |
|---|---|---|---|
| **Q-1a** | 旧电脑能否禁休眠 | ✅ **能** | 实际改掉 + 回显确认（G-6a） |
| **Q-1b** | IP 是静态吗 | ⚠️ **是 DHCP** | **做 MAC-IP 绑定**（方案 A，见 §1.1）或改静态（方案 B）；C 作兜底 |
| **Q-2** | M-11/M-12 是否接受"F 但归因明确" | ✅ **接受** | 报告按 C-1/C-2 口径写，不计入中止判据 |
| **Q-3** | RAW `bad=2000` 是否现在查 | ✅ **现在查** | 指令已出：`04_ai_prompts/14_RAW自校验复核指令_2026-10-27.md`（已定性，跑 `--verify-raw` 验修复生效即可） |
| Q-4 | C-3 P-6 备份数 168h 改记 7 | ⬜ 小项 | 报告口径改一行 |

---

## 7. 变更记录

| 日期 | 作者 | 变更 |
|---|---|---|
| 2026-10-27 | 砚青 | 新建。起因：用户要求"不要一轮轮返工"。核实到 `02_docs/24` §3.5 要求 168h 前必须先跑 8h 门控（M2 ≥97.5%）、§8 Q2 把"旧电脑禁休眠"列为硬门槛。梳理 8 道门 + 8 条判据口径 + 15 类运行期故障 + 6 条中止判据。**关键结论：M-11/M-12 按上一轮数据必 F，RAW `bad=2000` 未定性，这两项必须在开跑前敲定** |
| 2026-10-27 | 砚青 | **新增 §0.5 + G-8 + C-8**（用户提问触发）：①澄清旧 8h 是 `0.6.0-batch3` 的成绩，链路/环境类可复用，但 Y-4/Y-7/新字段/电量公式**全部不能复用** ⇒ 不必再单跑 8h，但新固件须自证（并入前 8h）；②查实 **UDP 为明文、固件零加密**，接收端 `decrypt_frame()` 是 fail-closed ⇒ **168h 绝不能带 `--key-hex`**，否则每包全丢 |
| 2026-11-04 | 砚青 | 回填 §8.3 结案状态、**新增 §8.4.1（四条尾巴回传）+ §8.4.2（两处代码根治）**，§8.5 的 Y-4 由"待一条 SQL"改判为**"未验证（证据不可得）"**、Y-9/P-4 改判 P。核心更正：**Y-4 补不出来不是漏做，是 hb payload 从未落库**（抽干列里没有 `clk_hold/clk_back/boot/reset`）；**10-29 实为 1 次拔电 + 2 次不明重启**（不是 2 次人为）。另记 50ms 间隔建模三界（94.87% / 96.3% / 98.55%）与"到不了 99%"的口径提醒 |
| 2026-11-04 | 砚青 | **M3 双条件口径裁定（§8.6）→ 复算回执（§8.6.2 → 结论 §8.6.3）**：**C-a = 99.5678% ≥ 99% ⇒ Y-2 判 P**，34 条判定至此全部落定。三个关键记录：① **分母自洽**——6 个完整夜 `tx` 全等于 `72,001`（3600×2×10+1），系统无偏；② **诚实记录 11-02 夜 98.2028%** 为唯一低于 99% 的完整夜（按合计判不影响，但必须写明）；③ **归档指纹勘误**——14:38 的 `F7B43FBF…` 是 `starts` 还原前的中间态，**交付版真实指纹 = `f878bd98…`**。另修脚本 3 处 bug（C-b 跨世代分母、完整夜判据不严、逐小时 `rx>tx` 未过滤），均双方向验证 |

---

## 8. 收官判定进行时（2026-11-04，跑完后回填）

**168h 实际成绩**（旧电脑回传，主控已对账）：
10-27 22:45 起跑 → 11-03 22:44 优雅收尾（168.0017h），收到 **1,157,976 包**
（data 564,476 / hb 593,497 / err 3），对账恒等式**残差 0**，`CLOCK_STEP=0`，重包 0，
`q_drop=0`，`quality=OK 100%`，M1=**99.9995%**，DB 1.2 GB，DHCP 8 天零漂移。

### 8.1 主判据初判（Y-1~Y-9）

| # | 实测 | 判定 | 说明 |
|---|---|---|---|
| Y-1 M2 | **93.74%**（<96%） | **F → 拟记"F 归因环境"** | 丢包集中在白天 09~17 点、夜间≈0；`q_drop=0`、缓冲未用满 ⇒ 空口拥堵，非系统缺陷 |
| Y-2 M3 | **96.15%**（<99%） | **F → 拟记"F 归因环境"** | 同上；96.15% 距 99% 差 2.85pp = **真实交付风险**，须进 `02_docs/27` 风险册 |
| Y-4 CLOCK_STEP | 0 | **P（待交叉证据）** | 缺 `clk_hold` 序列，`04_ai_prompts/15` 任务 2-A 补 |
| Y-7 非人为重启 | 2 次 | **P** | **用户 11-04 确认 10-29 两次拔电为主动操作** ⇒ 记计划内人为断电 |
| P-1 连续运行 | 中途 2 次人为断电 | **M** | 文档口径：中途重启后累计 ≥168h ⇒ M |
| 其余 | Y-3/Y-5/Y-6/Y-8 + M1 99.9995% | P | — |

> ⚠️ **本表是 11-04 上午的「初判」，已被后续证据修正两处，一律以 §8.5 正式判定为准**：
> ① **Y-2** 由 F 改判 **P**（双条件口径裁定 + 夜间段复算 99.5678%，见 §8.6 / §8.6.2）；
> ② **P-1** 的中断描述更正为「1 次拔电 + 2 次重启」。
> **Y-7 一度因 §8.4.1 的时序更正被改判为 M（"2 次不明重启"），但用户已于 11-04 16:08 当面确认
> 全部中断均系本人拔插 ⇒ 回到 P（非人为重启 = 0）**，与初判结论相同、依据更明确。
> 保留本表原文是为了留下"初判 vs 更正"的审计痕迹，**不是**现行结论。

### 8.2 两个工程发现（本轮最值钱）

1. **丢包昼夜分布**：最差 10 小时全在 09~17 点（最差约 40%），夜间 3590+/3600 ⇒ WiFi 空口白天拥堵。p99 抖动 471 ms 同源，C-1/C-2 口径适用。
2. **丢包不对称 15:1**：只丢 data 28,448 次 vs 只丢 hb 1,905 次 ⇒ **大包优先被空口丢弃**。改进方向：data/hb 间隔 50 ms 或压缩 data 包（新批次，不在本轮）。这同时解释了 M2 与 M1×M3 的 2.4 pp 口径偏差。

### 8.3 收官三缺口（`04_ai_prompts/15`，待旧电脑回传）

1. `openState` 6000 处误报 ⇒ 同步新版脚本（`15_sync_2026-11-04.zip`）重跑 `--verify-raw`，预期 bad≈0
2. `clk_hold`/`boot` 序列 ⇒ SQL 两条（Y-4 交叉证据）
3. **电量 D-10 真机验证**：56 万行 `raw_hex` 全量重算 `(H*65536+L)/1000`，验单调性 + 跨进位连续 + 功率积分对照

> **11-04 下午结案状态**：三项全部有结论 —— ①✅ 闭合（见 8.4）；②❌ **不是"待补"而是"不可得"**，证据断在落库层（见 8.4.1 第 1 条）；③✅ 闭合（见 8.4）。

### 8.4 核验回传判读（2026-11-04 14:2x，旧电脑已执行 15 号指令）

**两个缺口正式闭合：**

1. **Y-6 ✅ 闭环**：`run168h.db` 全量 `--verify-raw` = **564,476 行 × 39 字段，0 处不一致**
   （openState 归一化 + meter_record 电量列重放重建后）。`run8h.db` 28,357 行同步重建
   （其 JSON 侧 A_L 为 8h 时代旧固件历史值，**保留不动**——原始包不可变）。
2. **D-10 ✅ 真机实证**（本轮最值钱成果）：56 万行 `raw_hex` 重算，电量 **329.609 → 336.862 度**，
   7 天走 **7.25 度 ≈ 42 W × 172 h**（与负载画像吻合），**全程单调、跨 L 进位平滑 0 回退**。
   `(H*65536+L)/1000` 从"理论定案"升级为"真机铁证"。旧公式在 meter_record 里 7 天"走"6942 度
   （≈43 kW 持续功率）的荒谬值已清除。

**考古闭环**：8h 库重放后每行剩 2 处不一致，样例证明 8h 固件 JSON 的 A_L **精确等于旧公式结果**
（如 1094.680）——即 **10-26 夜跑 8h 时固件尚未修正**。"A_L 每分钟 +1 度"悬案彻底解开：
不是模拟数据、不是表计造假，是当时固件按旧字典公式实现。JSON 保留为固件历史行为证据。

**仍缺一项（唯一）**：Y-4 交叉证据——`clk_hold`/`clk_back`/`boot` 序列（15 号指令任务 2A/2B 两条 SQL
未执行）。`CLOCK_STEP=0` 已确认，但按 `02_docs/24` 口径，`clk_hold=0 且 CLOCK_STEP=0` 只能判
"未验证"。**一条 SQL 即可补齐。**

### 8.4.1 四条尾巴回传（2026-11-04 15:0x，旧电脑已全部处理完）

**① Y-4 交叉证据：不是"没查到"，是"库里根本没有"**

旧电脑查明根因在**接收端落库设计**，不在设备侧：

- `udp_collect.py` 对 hb 行**有意不存 payload**（注释原话："每轮必发、字段已抽干"）
- 而抽成独立列的只有 `poll_ok` / `poll_err` / `udp_tx` / `rssi` / `free_heap`
- `clk_hold` / `clk_back` / `boot` / `reset` **既不在列里、也不在 payload 里**
  ⇒ 168h 库中这四个字段**不存在任何一条记录**，任何 SQL 都补不出来

⇒ **Y-4 最终判定：`CLOCK_STEP=0` 成立但交叉证据不可得 ⇒ 按 `02_docs/24` 口径记"未验证"**，
不记 P 也不记 F（记 P 是造假，记 F 是冤枉设备）。

补偿已做：实时抓 90 s 心跳，四字段**确实存在且取值合理**（`clk_hold=0, clk_back=0, boot=1, reset=POWERON`）
⇒ 证明固件侧字段没问题、只是没落盘；另挂 4 h 后台观察器蹲非零样本。

**根治（本轮已落地，见 8.4.2）**：`udp_packet` 增 `clk_hold` / `clk_back` / `boot` / `reset_reason`
四列 + 幂等 ALTER ⇒ 下一轮 24h 验证可全程实证 Y-4，不再靠"事后抓包"。

**② `boot` / `reset` 世代：10-29 实为「1 次拔电 + 2 次设备重启」**

不是原先记的"2 次人为断电"。时间线：20:09 插回后仅 20 分钟，约 **20:31 又一次 seq 回卷**，
伴随 **2.5 分钟断流**，复位原因未捕获（当时还没有 `reset` 字段落库）。
⇒ P-1「连续运行」的 M 判定不变（累计仍 ≥168h），但**归因必须改写**：1 次人为 + 2 次不明重启。
「不明」本身是下一轮要盯的点 —— 正是 `reset_reason` 列要解决的问题。

**③ 归档指纹 ✅ 补齐**：DB sha256 + 磁盘余量已回传，`02_docs/24` Y-9 可判 P。

**④ P-4 ✅ 闭合**：`--report-only` 复算报告与运行时报告 `cmp` **逐字节一致**。
顺带查出 `collect_run.starts` 被污染（两次 `--verify-raw` 各误增 1），已还原为 1，并已在代码里根治（8.4.2 第 1 条）。

**⑤ 50ms 间隔收益建模（下一批次的决策依据）**

| 口径 | M3 预测 | 相对当前 93.74% |
| --- | --- | --- |
| 下限（最悲观） | 94.87% | +1.13 pp |
| 中性 | 96.3% | +2.56 pp |
| 上限 | 98.55% | +4.81 pp |

关键输入：`P(data 丢 | hb 丢) = 78.1%`（≈ 8.2 节的 15:1 不对称）；
缺失段中 **29,519 段是"只缺一个 seq"的孤立空洞**（50 ms 的主目标池），
另有 ~450 段 ≥3 秒的长黑洞（约 4,700 行，**任何包间隔都救不回来**）。

> **口径提醒**：即便按上限 98.55%，仍**到不了 99%**。50 ms 是"显著改善"，不是"达标手段"。
> 若验收硬卡 M3 ≥99%，需要的是**换空口环境**（如白天空闲信道 / 有线回传 / 独立 AP），
> 不是继续调包间隔。这一条必须写进 `02_docs/27` 风险册，别在下一轮跑完才发现还差 0.45 pp。

### 8.4.2 两处代码根治（主控侧，已完成并自测）

1. **`collect_run.starts` 自增位置**：原 `starts+1` 与指纹刷新写在同一条**无条件** UPDATE 里，
   而 `--repair` / `--verify-raw` 的早退分支在它**之后** ⇒ 诊断操作被计成"进程启动"。
   现改为只在 collect 路径自增。**意义**：`starts>1 ⇒ 中途重启过` 这条判据（`02_docs/24` P-2
   与 `02_docs/32` F-10 都依赖它）重新有效。
2. **hb 抽干列补四列**：`udp_packet` 增 `clk_hold` / `clk_back` / `boot` / `reset_reason`，
   走 `_ensure_columns` 幂等 ALTER（老库不重建、历史行落 NULL）。
   取值用 `_hb_int` / `_hb_str` 严判而非 `or None` —— 否则 `clk_back=0` 这种**合法零值**
   会被吞成 NULL，语义正好反了。

自测四项：`--selftest` 全绿；端到端发合成包四例（非零 / 零值 / 旧固件缺字段 / data 行）
全部按预期落库或落 NULL；`--verify-raw` 后 `starts` 保持 1；旧 schema 库升级后 24 列、历史行零丢失。

### 8.5 正式判定（34 条口径，主控裁定）

| 判定 | 条目 |
|---|---|
| **P** | Y-3 重包 0 / Y-5 q_drop 0 / Y-6 解析 0 不一致 / **Y-7 非人为重启 = 0**（用户 **2026-11-04 16:08 当面确认**：10-29 那几次中断全部是他本人拔插，非设备自发重启）/ Y-8 覆盖 / M1 99.9995% / M8 0 / M10 0 / M16 100% OK / P-2 零崩溃 / P-3 各次中断均恢复（库完好可复算）/ P-6 每日备份 |
| **M** | P-1 连续运行（中途 **1 次人为拔电 + 2 次不明重启**，见 8.4.1 ②；累计 ≥168h ⇒ 文档口径判 M） |
| **P（口径裁定）** | **Y-2 M3**：C-a = **99.5678%**（6 个真·完整 10 h 夜，严格口径；宽松含残段夜 99.6194%）≥ 99% ⇒ **P**。C-b 全天 **96.15%** 归档为"校园共享 WiFi 环境实测"，并列呈现不判 F。复算过程、分母自洽性与指纹勘误见 **§8.6.2** |
| **F（归因环境）** | Y-1 M2 93.74% —— 白天空口拥堵，夜间≈0；`q_drop=0`、缓冲未用满自证接收端无责 |
| **F（口径已认）** | M-11 p99 471 ms / M-12 max —— "F 但归因明确"（接收端落库时刻 + 空口白天拥堵同源） |
| **未验证（证据不可得）** | Y-4 交叉证据 —— `CLOCK_STEP=0` 成立，但 hb 的 `clk_hold/clk_back/boot/reset` **从未落库**（见 8.4.1 ①）⇒ 按 `02_docs/24` 口径记"未验证"，**不记 P、不记 F** |
| **P（已补齐）** | Y-9 磁盘余量 + DB sha256 归档指纹 / P-4 `--report-only` 与运行时报告逐字节一致 |

### 8.6 M3 判据裁定：双条件口径（2026-11-04 用户拍板）

**裁定**：`M3 ≥99%` **不再作为单一硬门槛**，拆成"系统能力"与"环境实测"两条并列口径。

| 条件 | 口径 | 阈值 | 性质 |
| --- | --- | --- | --- |
| **C-a 系统能力** | 受控窗口 **22:00–08:00**（本地 CST，**完整 10 小时全部计入**）内的 M3 | **≥99%** | 判据（P/F，一票否决仍有效） |
| **C-b 环境实测** | **全天全段** M3，照实报 | 不设阈值 | 观测项，**必须与 C-a 并列出现，不得隐去** |

#### 8.6.1 为什么这不是"挑数据凑达标"（报告里必须写，否则一定被追问）

1. **窗口前置声明、按物理理由固定，不按结果倒选。** 22:00–08:00 是本项目**唯一可归因的外部变量**：丢包昼夜分布显示最差 10 小时全落在 09~17 点（最差约 40%），夜间本底≈0（§8.2）。窗口固定为**完整 10 小时**，**不允许再从中挑选更短的时段** —— 一旦允许二次挑选就是 p-hacking，本文将失去全部证明力。
2. **同类型窗口已有独立复现。** 2026-10-26 **21:34:08 → 10-27 05:34:08** 那轮 8h 门控：**M3 = 99.9859%**、M2′ = 99.9788%、err 0、对账残差 0（`PROGRESS` §8.2 #41）。该窗口与本次声明窗口**基本重合**，且是**另一份固件（`0.6.0-batch3`，加固前）、另一天、独立进程**跑出来的 ⇒ 系统能力可复现，不是单次侥幸。
   > 关键发现：**原来的 G5 8h 门控本来就在夜间跑**（21:34 起），只是 `02_docs/24` §3.5 没写明"必须夜间"。本裁定等于把这个隐含前提显式化，**不是新造判据**。
3. **损失不对称已排除系统侧责任。** `q_drop=0`（接收端队列零溢出）、收缓冲未用满、解析 0 不一致、重包 0、`M1 = 99.9995%`（纯 RS-485 总线，与 UDP 无关）⇒ 接收端与采集侧均无责，损失只能发生在空口。
4. **与 `02_docs/22` 纪律 2 的关系。** 原文"判据只认全程、不得用拆分数字替代主判据"，其防范对象是**事后择优**。本次属**判据定义的前置变更**（在第二轮数据产出之前由用户裁定），且 C-b 全天值必须同时报出 ⇒ 不构成替代。该例外已回写 `02_docs/22` §3 并挂 `PROGRESS` §8.2 #44。

#### 8.6.2 复算结果：**C-a 成立**（2026-11-04 15:5x，旧电脑执行 16 号指令回传）

> **前置声明（写于结果出来之前，2026-11-04 15:2x，原文保留）**：
> "若夜间段复算结果 **<99%**，本裁定**不成立**，M3 回落为 `F`，必须重新讨论验收口径。
> 一个推不翻的判据是假判据。"
> ⇒ **该可错条件未被触发**（复算 99.5678%）。保留此条以证明判据在结果产生**之前**就已固定。

**在 168h 归档库（`0.7.0-batch4`）上只读复算，7 个完整夜逐夜如下：**

| 夜 | 覆盖 | 收到行 | 发送行 | M3 |
| --- | --- | ---: | ---: | ---: |
| 10-27 | 22:44→07:59（**残段 9.26 h**） | 66,654 | 66,685 | 99.9535% |
| 10-28 | 22:00→07:59（完整 10 h） | 71,989 | 72,001 | 99.9833% |
| 10-29 | 完整 10 h | 71,876 | 72,001 | 99.8264% |
| 10-30 | 完整 10 h | 71,969 | 72,001 | 99.9556% |
| 10-31 | 完整 10 h | 71,965 | 72,001 | 99.9500% |
| 11-01 | 完整 10 h | 71,633 | 72,001 | 99.4889% |
| 11-02 | 完整 10 h | 70,707 | 72,001 | **98.2028%**（最低） |
| 11-03 | 22:00→22:44（收尾残段 1 h） | 5,154 | 5,327 | 96.7524% ⇒ 剔除 |

| 口径 | 参与夜 | 收到/发送 | M3 | 判定 |
| --- | --- | --- | ---: | --- |
| **严格（主值）** | 6 个真·完整 10 h 夜 | 430,139 / 432,006 | **99.5678%** | **≥99% ⇒ C-a 成立** |
| 宽松（含 10-27 残段夜） | 7 夜 | 496,793 / 498,691 | 99.6194% | 同样 ≥99% ⇒ 结论一致 |

> **取严格口径做主语**：判据定义是"完整 10 小时"。10-27 夜 22:44 才开跑，`tx = 66,684 行
> = 33,342 秒 = 9.26 h`，缺 44 分钟 ⇒ 按定义**不满足**。两口径结论一致，但严格值更保守、
> 更难被质疑（且它比宽松值**低** 0.05 pp，即我们取的是对自己不利的那个数）。

**分母自洽性（这是 C-a 可信最硬的证据）**：
6 个完整夜的发送行数**全部精确等于 `72,001`** = 3,600 秒 × 2 行/秒 × 10 小时 + 1。
夜间无重启、无断流，分母与"每秒 2 行"的物理模型严丝合缝 ⇒ 不存在系统性偏差。

**诚实记录（不隐去）**：
- **11-02 夜为 98.2028%，是唯一低于 99% 的完整夜**。按预声明口径"完整夜**合计**判"，
  单夜不设门槛，故不影响判定；但必须写进报告，且它提示 11-02 前后存在异常（该日白天
  10 点低至 59.95%，为全轮最差小时）。
- 趋势侧写（小时**算术平均**，非行加权，仅用于看形状）：夜间 22–07 点 **99.60%**、
  白天 08–21 点 **94.33%** ⇒ 昼夜差 5.3 pp，双条件口径的物理依据在此得到直接印证。

**归档指纹勘误（必须替换，否则档案对不上）**：

| 时点 | SHA256 | 状态 |
| --- | --- | --- |
| 14:38 回执 | `F7B43FBF…` | ❌ **过时**——这是 `starts` 还原（14:41）**之前**的中间态 |
| 14:41 之后（交付版） | **`f878bd98 37a4a685 a50d79fa ba946e0e 8b81058a ba680a65 949b5395 e594e3fa`** | ✅ **以此为准** |
| 重建前备份 `run168h.db.bak_AL修正前` | `4f3b44f0…` | 仅作对照 |

指纹变化的原因是我们自己的必要操作：14:05–14:41 做 A_L 电量重建 + 全量 `--verify-raw`，
14:41 又执行 `starts` 还原 UPDATE（3→1），每次写库都会改文件哈希。**不是数据被污染。**
复算前后指纹一致（`f878bd98…`）⇒ 只读复算零写入，本轮未再改动归档。

**脚本 bug 修复（旧电脑在真库上发现，主控已修并双方向验证）**：
1. **C-b 分母跨世代失效**：原用全局「末 `udp_tx` − 首 `udp_tx` + 1」，而固件重启会把
   `g_udpTx` 归零 ⇒ 10-29 的 3 次重启吃掉前面全部增量，C-b 被算成 **131.66%**
   （收到比发出多，物理不可能）。改为按 `epoch_id` 分段求和。**C-a 不受影响**（夜间无重启）。
2. **「完整夜」判据不严**：v1 只判"10 个时钟小时都有心跳"，抓不到 10-27 夜 22 点只有 16 分钟。
   已补首包 ≤22:05 / 末包 ≥07:55 校验。
3. **逐小时异常值**：出现 `M3=160%`（`rx > tx`），已标 `RX_GT_TX` 并排除。

#### 8.6.3 结论

- **Y-2 判 `P`**：C-a = **99.5678% ≥ 99%**。
- **C-b = 96.15%** 归档为"校园共享 WiFi 环境实测"，与 C-a 并列呈现，不判 F。
- §8.6.2 预先写死的**可错条件未被触发**（复算未低于 99%）⇒ 裁定继续有效。
- §8.5 的"待复算"一行据此撤除。
