jiangtao-ml/ESP32_C3_Gateway/05_hardware/洞洞板装配示意图.png

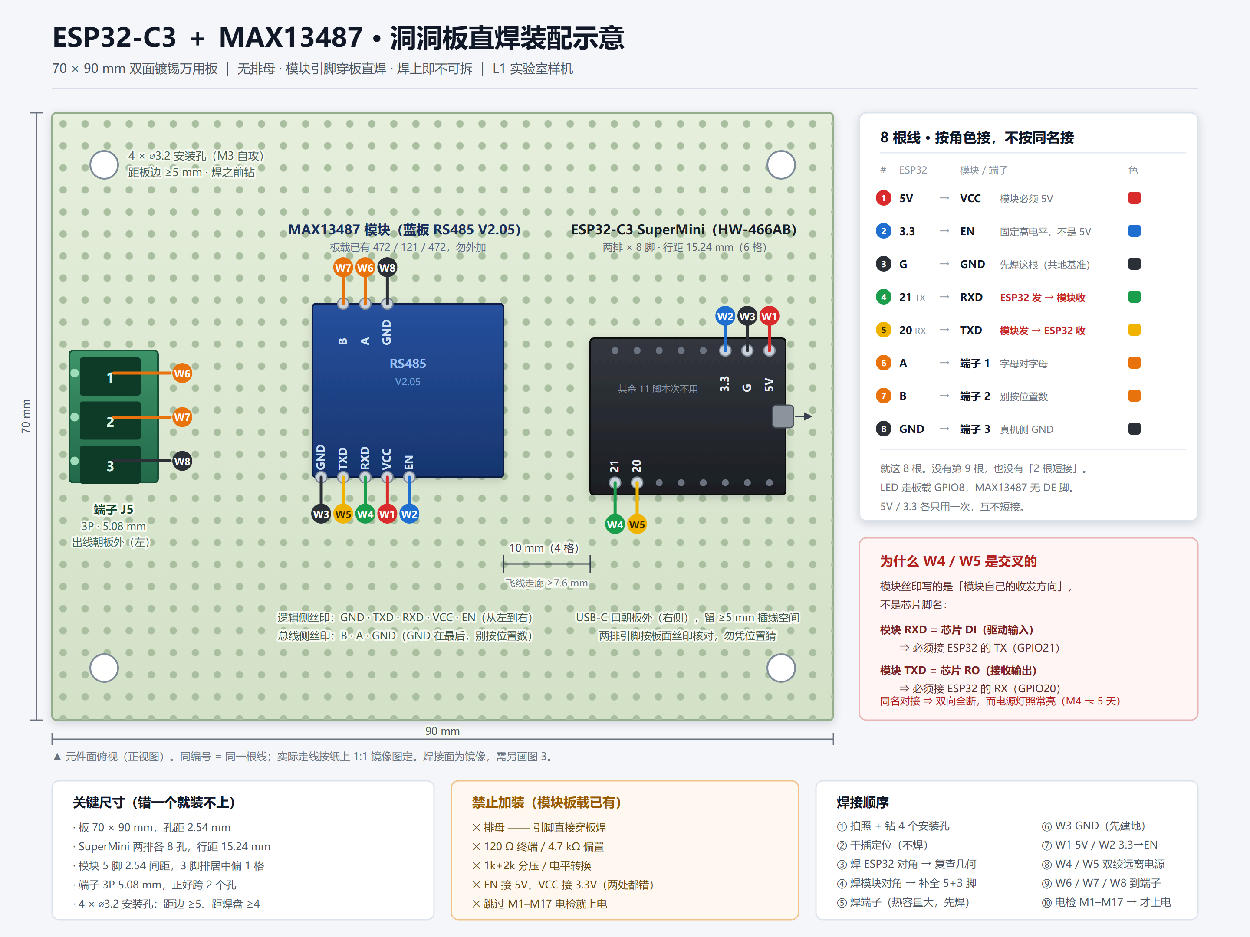
05_hardware/洞洞板装配示意图.png
