jiangtao-ml/ESP32_C3_Gateway/06_tests/README.md

# 06_tests —— 测试资产索引

本目录存放本项目的**测试工具、操作卡与测试方法说明**。所有脚本均为 **PC 侧**工具（Python），
不涉及 ESP32 业务代码；运行环境为受管虚拟环境：

```
C:\Users\17352\.workbuddy\binaries\python\envs\default\Scripts\python.exe
```

依赖：`pyserial`、`pymodbus`（已安装）。

---

## 1. 脚本一览

> **目录约定（2026-10-17 起）**：活跃脚本放本目录；**已证伪 / 已作废**的资产移入 `_archive/`，只作证据保留、不参与任何流程。

| 脚本 | 用途 | 典型用法 |
| --- | --- | --- |
| **`udp_collect.py`** | **168h 连续采集接收端（M7 验收主工具）**：3 线程（收包 / 落库 / 统计）+ 2 队列；WAL SQLite 六表；`udp_packet` 存**原始包**（不可再生）、`meter_record` 存解析结果（可重放）。报告**全部由 SQL 重算**，`--report-only` 与运行时报告**逐字节一致**。含统计引擎自检、环境自检、raw 自校验、每日在线备份；Linux 侧采 `/proc/net/snmp` 与网卡计数作为「接收端丢包」的硬证据。**已移植到 Ubuntu**（SIGTERM 收尾、`SO_RCVBUF` 回读、LF 报告） | `python udp_collect.py --db 03_logs\m7_longrun_<日期>.db`<br>`… --env-check`（开跑前）<br>`… --hours 0.5`（30 min 冒烟）<br>`… --report-only --report-out x.txt`（验收复算）<br>`… --selftest`（不需设备）<br>`… --verify-raw`（raw 重算比对） |
| **`udp_listen.py`** | **PC 侧 UDP 接收监听**：确认 ESP32 上行数据**真的到达电脑**。⚠️ 串口报「发送成功」≠ 数据送达（UDP 无连接，目标不存在可能静默丢弃）⇒ **必须两侧同时看** | `python udp_listen.py 8888 120` |
| **`ntp_verify.py`** | **NTP 三源改造烧录验收**：抓 ESP32 启动日志，自动判定三源配置 / 时区 / 同步，并回答核心问题「实际生效源是内网 `172.16.0.2` 还是落到公网备源」；**含"判定过早"与"走兜底分支"的自动识别** | `python ntp_verify.py COM5 80` |
| **`ntp_probe.py`** | **NTP 可达性探针**：查某 NTP 源是否真的在应答（UDP/123）、stratum、往返延迟、与本地钟偏差。改 ESP32 的 NTP 源之前**必须先跑它** | `python ntp_probe.py 172.16.0.2 ntp.aliyun.com` |
| **`m5_frame_check.py`** | **M5 真机帧 CRC 独立复核**（读全部 39 / 3 段 / 单寄存器探针共 7 帧）+ 响应帧长核算 | `python m5_frame_check.py` |
| **`m5_slave_04.py`** | **M5 台面预演从站**：电脑端应答 **`0x04`** 真机帧（39 个**合成**寄存器，3 段 / 一帧读全皆可）；`--limit16` 复现 E-02 的 `0x84/0x02` 拒绝分支；`--short N` 回**短帧**（帧自洽但与请求不符），靶子是 P0-1 帧长判据。**用途 = 接真机前把「代码问题」与「真机问题」分开**（见操作卡 §0b） | `python m5_slave_04.py COM7`（默认）／`… COM7 --limit16`／`… COM7 --short 30` |
| **`db_proto.py`** | **数据落库原型**：解析 → **四层校验 L0~L3** → 质量打标 → **幂等入库（SQLite）**。字典驱动（读 `05_hardware/STB3-125_字段字典.csv`，**不硬编码字段**）；保留 `raw_hex`；`PRIMARY KEY(device_id, collect_time)` 保证补传幂等；把「型号已知不上报字段」（A/B/C_temp）与「本次异常」分开，否则每行都会降级成 PARTIAL。**不依赖真机** | `python db_proto.py --demo`<br>`python db_proto.py --log <udp_listen 抓包>`<br>`python db_proto.py --ddl` |
| **`db_schema.sql`** | 由 `db_proto.py --ddl` 依字段字典生成的**建表 DDL**（11 个元数据列 + 39 个测量列 + 唯一键） | — |
| **`m4_accept.py`** | **M4 验收补测（一键跑完 3 项）**：静默 10 次后恢复 / 注入 1 位 CRC 错误 / 1000 次累计统计。同时开 ESP32 口 + 从站口，脚本化档位驱动 | `python m4_accept.py COM5 COM7 1000` |
| **`m4_verify.py`** | **一键联测**：同时开「ESP32 串口 + 1~2 个 485 端口只读监听」，自动汇总并判定"是否在驱动总线" | `python m4_verify.py COM5 30 COM6 COM7` |
| **`two_port_loopback.py`** | **两个 485 端口背靠背互测** —— 本项目**唯一有效**的"换件后第一动作" | `python two_port_loopback.py COM7 COM6` |
| `m4_slave_rtu.py` | 手写帧组装的 Modbus RTU 从站（替代 Modbus Slave GUI），含容错解析（扫描 + CRC）。**恒定正常应答**，供人工长时间观察 | `python m4_slave_rtu.py COM7` |
| `bus_sniff.py` | 485 总线**只读**监听（不发送，不会与从站争抢总线） | `python bus_sniff.py COM7 30` |
| `bus_probe_tx.py` | 单向注入探针（用于分离"去程 / 回程"） | `python bus_probe_tx.py COM7 55 200 45` |
| `serial_capture.py` | ESP32 串口抓取（替代人工复制串口监视器输出） | `python serial_capture.py COM5 115200 30` |
| ⚠️ `_archive/usb485_loopback.py` | **单端口 A/B 短接自环 —— 已证无效，已移入归档区，勿使用** | 见 §3.1 与 `_archive/README.md` |

### `m4_accept.py` 的五段档位（按从站收到的请求序号）

| 阶段 | 请求序号 | 从站行为 | 验的是 |
| --- | --- | --- | --- |
| 1 基线 | 1–10 | 正常应答 | 链路可用（若此处全超时，先别往下看，去查接线） |
| 2 静默 | 11–20 | **不应答** | 制造连续 10 次超时 |
| 3 恢复 | 21–30 | 正常应答 | **补测 1**：超时后仍继续轮询 |
| 4 CRC 注入 | 31–35 | 回 CRC **错 1 位**的帧 | **补测 2**：CRC 能被识别且不崩溃 |
| 5 长稳 | 36–N | 正常应答 | **补测 3**：N 次累计（N 默认 1000） |

- **先跑 `60` 冒烟**（约 1 分钟）确认脚本与链路都正常，再跑 `1000`（约 17 分钟）。
- 退出码：`0` = 三项全 PASS，`2` = 有 FAIL，`1` = 串口打不开。
- 运行期间**不要让 ESP32 复位**（固件计数器会归零，账目就对不上；我的脚本自己是独立计数的，不受影响）。
- 原始日志写 `03_logs/M4验收补测_<时间戳>.log`，报告写 `03_logs/M4验收补测_report.txt`（`03_logs` 不入库）。

---

## 2. 文档一览

| 文档 | 用途 |
| --- | --- |
| **`M5_真机联调操作卡.md`** | **M5 现场操作卡（现行版）**：**§0b 台面预演（接真机前必走）**、**§0c 无 USB 转 485 / 无串口时的现场单**、上电前安全项、接线差异、帧清单（CRC 已独立复核）、E-02 决策树、代码改动清单、四步执行与判据、失败速查、换算速查、现场记录表 |
| **`M4_从零重建分步指南.md`** | M4 现场操作卡：五步、每步带判据与失败处置，含正确的 `TXD`/`RXD` 交叉接线表（**M4 已通过，留作回归参考**） |
| ⚠️ `_archive/M4_重测操作卡.md` | **已作废**（第 0 步为无效的 A/B 自环；接线表为"同名对接"，是错的）。已移入归档区，原因见 `_archive/README.md` |
| `README.md` | 本索引 |

---

## 3. ⚠️ 方法学红线（务必遵守）

### 3.1 「短接 A/B 发 abc 看回显」是**无效**的自环测试

- 两线半双工 485 短接 A/B 后差分 `V_AB ≡ 0`，接收器判据是 `|V_AB| > 200mV` → 落在判定窗口**正中间**；
  标准 fail-safe 器件输出不确定、full-fail-safe 器件恒输出高 ⇒ **健康模块也不会回显**。
- **负结果不能证明模块坏。** 本项曾导致一只完好的模块被判"物理损坏"。
- 依据：MaxLinear XR33156 应用笔记、Renesas KB「fail-safe short」、Industrial Monitor Direct / US Converters 知识库。
- 👉 **正确做法：用 `two_port_loopback.py` 做两端口背靠背互测。**

### 3.2 免仪表能力边界

| 待验证的事 | 免仪表 | 工具 |
| --- | --- | --- |
| 485 模块收发是否正常 | ✅ | `two_port_loopback.py` |
| 节点 / 布线是否连通 | ✅ | 用已验证的模块对在同一节点互测 |
| 器件是否在驱动总线 | ✅ | `bus_sniff.py` / `m4_verify.py` |
| MCU 引脚与串口通路 | ✅ | 固件 `RS485_MODE_LOOPBACK_SELFTEST=1` + 短接 GPIO21↔GPIO20 |
| **器件是否通电（VCC 有无 5V）** | ❌ | **必须万用表** |
| 两点之间是否导通 | ⚠️ 只能间接 | 让信号"穿过被测物"走一圈 |

### 3.3 常用判定口径

| 现象 | 结论 |
| --- | --- |
| 485 端口收到 `01 03 00 00 00 02 C4 0B` | ESP32 的请求帧上了总线 ⇒ **发送通路正常** |
| ESP32 打印 `[M4] 解析 OK ... REG: [0]=10 [1]=20` | **双向全通**（M4 通过判据） |
| 双方都是 0 字节 | **双向全断** ⇒ 故障在"共用段"（A/B 总线 / 收发器 / 共地） |
| 收到乱码而非零字节 | 极性反 / 波特率不符 / 偏置不足 —— **注意：零字节 ≠ 极性反** |
| `[M4] 超时 … RX=8 期望 9`（半帧） | **PC 侧 USB 转 485 批量交付抖动**（R-15），非固件/ESP32 缺陷；M5 真机 + 阈值 4~8ms 后应消失。1000 次补测中实测命中 1 次，见 `02_docs/15` §4.1 |
| `m5_slave_04.py --short 30` 从站回短帧（固件期望 83 字节，只收到 65） | 判**固件有没有 P0-1 帧长判据**：<br>· **有** → `[M4] 帧长与请求不符 期望 83 收到 65（byte count=60）`，该轮改发 `err` 行、不发数据行（正确）<br>· **无（P0-1 之前的固件）** → 静默判成功、发数据行，且 `raw` 尾部 18 字节是**上一轮**残留（静默掺假，本项目 §4「错误的数据不要」明令禁止） |

---

## 4. 前置检查

1. 关掉 Arduino IDE 的**串口监视器**（同一端口不能同时被两个程序打开）。
2. 只允许**一个程序**占用某个 COM 口（如 `m4_slave_rtu.py` 与 Modbus Slave 不能同占）。
3. 端口号每次换 USB 口都会变，先确认：
   ```
   python -c "import serial.tools.list_ports as lp;[print(p.device,'|',p.description,'|',p.hwid) for p in lp.comports()]"
   ```
   已知：**ESP32 = `VID:PID 303A:1001`**；USB 转 485 = CH340 `1A86:7523` / FTDI `0403:6001`。

---

## 5. 变更记录

| 版本 | 日期 | 作者 | 变更内容 |
| --- | --- | --- | --- |
| v1.13 | 2026-11-04 | 砚青 | **`udp_collect.py` 修 2 处**（168h 收官核验时旧电脑挖出）：①`collect_run.starts` 原与指纹刷新写在同一**无条件** UPDATE 里，而 `--repair`/`--verify-raw` 的早退在它**之后** ⇒ 两次 `--verify-raw` 把 1 次真实启动刷成 3，`starts>1 ⇒ 中途重启过` 判据（`02_docs/24` P-2、`02_docs/32` F-10 依赖）当场失效，现改为只在 collect 路径自增；②`udp_packet` 增 `clk_hold`/`clk_back`/`boot`/`reset_reason` 四列（幂等 ALTER，老库不重建），因为 hb **有意不存 payload** 而抽干列里没这四个 ⇒ Y-4 时钟钳位证据在 168h 库中彻底不可得。取值用 `_hb_int`/`_hb_str` 严判，避免 `clk_back=0` 被 `or None` 吞成 NULL。自测：`--selftest` 全绿 + 端到端四例（非零/零值/旧固件缺字段/data 行）+ `--verify-raw` 后 starts 仍为 1 + 旧 schema 库升 24 列零丢行。 |
| v1.12 | 2026-10-21 | 砚青 | **`udp_collect.py` 修 3 个会静默失效的 bug 并移植 Ubuntu**：统计线程误用只读连接（快照/告警写不进去且被吞）、续跑 naive/aware 不一致致 T3 `TypeError`、无 SIGTERM 收尾。新增 `--env-check` / `--verify-raw` / `--report-out` / `--bin`，`SO_RCVBUF` 回读、内核与网卡丢包采样、每日备份、报告固定 LF。触发：168h 要在 Ubuntu 旧机上跑。 |
| v1.11 | 2026-10-17 | 砚青 | 新增 **`udp_collect.py`**（168h 连续采集接收端，承接 `02_docs/22` §2 的设计）。落地时发现并修正方案里三处与固件实际行为不符的口径：① `2·ΔR` 只在该 `QI_SEND_ERR_ROW=1` 时成立，须实测推断；② hb 的 `udp_tx` 是**发送前**的值，窗口内发出行数 = `Δudp_tx+1`；③ 世代首轮无差分可依，须看 `seq_first+1` 的 ptype 归属，否则 M1 系统性少 1。另实测到一个**既有 schema 限制**：`meter_record` 主键为秒级 `collect_time`，1 Hz 下同秒两轮会顶掉一行（原始包未丢，主键加宽后可 `--repair` 重放）。 |
| v1.10 | 2026-10-17 | 砚青 | **结构整理**：`usb485_loopback.py` 与 `M4_重测操作卡.md` 移入 `_archive/`（含归档说明 README）；§1 补目录约定与 M7 计划项 `udp_collect.py`。触发：用户要求整理项目结构。 |
| v1.9 | 2026-10-08 | WorkBuddy | 新增 **`m5_slave_04.py --short N`**（短响应对照从站：帧自洽但与请求不符，用于验证 P0-1「帧长必须与本段请求的寄存器数一致」）；§1 该脚本行与 §3.3 判定口径表补对应条目。触发：P0-1 需要一个能**稳定复现短帧**的对手端，而原脚本只会回满/回异常码，做不出短帧。 |
| v1.8 | 2026-10-06 | WorkBuddy | ① 新增 **`db_proto.py`**（数据落库原型：解析 → 四层校验 → 打标 → 幂等入库；字典驱动、保留 raw_hex；**把"型号已知不上报字段"与"本次异常"分开**）与 **`db_schema.sql`**（生成的建表 DDL）；② 配套新增字段字典 **`05_hardware/STB3-125_字段字典.csv`**（39 行，**唯一事实来源**，`m5_parse.py` 与 `db_proto.py` 共用其口径）。实测：真机抓包 59 条全部入库且 `quality=OK`；同数据二次入库 **7→7 新增 0 行**（幂等成立）。 |
| v1.7 | 2026-10-05 | WorkBuddy | §2 的 M5 操作卡条目补 **§0c**（无 USB 转 485 / 无串口时的现场单）。触发：现场实际为「有充电宝、无 USB 转 485、真机 A/B 已接且带电」⇒ 台面预演跳过，运行期改为只看 UDP。 |
| v1.6 | 2026-10-05 | WorkBuddy | 新增 **`m5_slave_04.py`**（M5 台面预演从站：电脑端应答 `0x04` 真机帧，39 个合成寄存器，`--limit16` 复现 E-02 拒绝分支）；§2 的 M5 操作卡条目补 §0b。触发：M5 首次烧录要同时改三处固件，直接接真机首跑会把「代码问题」与「真机问题」混在一起 ⇒ 先用电脑把 `0x04` 全链路跑通再去碰真机。 |
| v1.5 | 2026-10-05 | WorkBuddy | ① 新增 **`udp_listen.py`**（PC 侧 UDP 接收监听 —— 验证数据"真的到了电脑"，因为串口报成功 ≠ 送达）；② **`ntp_verify.py` 增强**：新增「同步行是否早于『触发 SNTP 对时』行」的**判定过早自动识别**、**走兜底分支识别**、以及"时区看起来是 +0000 但实际时间正确"的澄清提示；③ 新增**串口掉线自动重连**（ESP32-C3 原生 USB CDC 在芯片复位时必然重新枚举）。 |
| v1.4 | 2026-10-05 | WorkBuddy | 新增 **`ntp_verify.py`**（NTP 三源改造烧录验收脚本）：抓串口自动判定三源配置 / WiFi / 同步 / 时区，并**回答核心问题「实际生效源是内网还是公网」**；含"落公网备源时应降级内网源"的结论分支。 |
| v1.3 | 2026-10-04 | WorkBuddy | 新增 **`ntp_probe.py`**（NTP 可达性探针）。触发：导师通知内网 **172.16.0.2 有 chrony 服务**，实测该源可用（stratum 2 / RTT 3.4ms，公网对照 41ms）⇒ 建议将其列为 ESP32 主 NTP 源、公网降为备源（待总控/Codex 落地）。 |
| v1.2 | 2026-10-04 | WorkBuddy | 新增 **`m5_frame_check.py`**（M5 帧 CRC 独立复核，7 帧全 OK）与 **`M5_真机联调操作卡.md`**（M5 现场执行卡）；文档一览标注 M4 指南转为"回归参考"。 |
| v1.1 | 2026-10-04 | WorkBuddy | 新增 **`m4_accept.py`**（M4 验收补测一键跑）及其五段档位表；脚本一览补注各从站脚本的行为差异 |
| v1.0 | 2026-10-04 | WorkBuddy | 首版：脚本与文档索引、方法学红线（A/B 自环无效）、免仪表能力边界、判定口径、前置检查。 |
