jiangtao-ml/ESP32_C3_Gateway/06_tests/_archive/README.md

# 06_tests/_archive —— 已作废资产（只读，勿使用）

> 最后更新：2026-10-17 · 砚青（结构整理：从 `06_tests/` 主目录移入）

## 为什么保留而不删除

这两个文件代表的都是**被证伪的做法**。删掉它们，下次有人（或某个 AI）还会再踩一遍同样的坑。
它们是 M4 卡 5 天的物证，属于 `PROGRESS.md` §2b 所说的「排障记录 = 复现依据」。

**但不要在活跃工具链里使用它们。**

## 清单

| 文件 | 作废原因 | 正确替代 | 证据 |
| --- | --- | --- | --- |
| `usb485_loopback.py` | **单端口 A/B 短接自环测试无效**。两线 485 短接后差分 `V_AB ≡ 0`，正好落在接收器判定窗口正中间；标准 fail-safe 器件输出不确定、full-fail-safe 器件恒输出高 ⇒ **健康模块也不会回显**。负结果不能证明模块坏。 | `two_port_loopback.py`（两端口背靠背互测） | `06_tests/README.md` §3.1；`02_docs/14_M4排障全过程复盘` §4.1 |
| `M4_重测操作卡.md` | 第 0 步即上述无效自环；接线表按「同名对接」编写（`GPIO21`→模块 `TXD`），**是错的**，会双向全断。 | `M4_从零重建分步指南.md`（含正确的 `TXD`/`RXD` 交叉接线表） | `02_docs/14` 全文 |

## 一句话教训

> **「负结果」只有在测试本身有判别力时才有意义。**
> 一个恒定为负的测试，和「设备坏了」看起来一模一样。
