jiangtao-ml/ESP32_C3_Gateway/05_hardware/STB3-125_Errata.md

# STB3-125 协议文档 CRC 勘误记录

> 旁路勘误文件。**不修改**原始 `STB3-125_Modbus_Protocol.md` 与原始 `STB3-125_Modbus_Protocol.doc`，
> 本文件仅记录对其内示例帧的独立校验结果与处理建议。
> 最后更新：**2026-10-07 砚青**（E-02 批次 2 真机实测结案：A 成立——真机接受 39 寄存器一帧读全，384 轮 100%；见第 4 节"明确"）

## 1. 校验方法

- 算法：**CRC16/Modbus**
- 初值：`0xFFFF`
- 多项式：`0xA001`
- 字节序：**低字节在前**（帧尾两字节依次为 CRC 低字节、CRC 高字节）

## 2. 校验统计

| 项目 | 数量 |
| --- | --- |
| 已校验示例帧 | **22 条** |
| 通过 | **21 条** |
| 不通过 | **1 条** |

## 3. 不通过明细

**位置：** 读线圈 0-3 的**回复**示例

| 项目 | 内容 |
| --- | --- |
| 文档写的帧 | `01 01 01 02 90 48` |
| 文档写的 CRC | `90 48` |
| 独立计算 CRC | `D0 49` |
| 结论 | 文档疑似笔误，正确帧应为 `01 01 01 02 D0 49` |

**建议：** M3/M4 若用到此帧，按 `D0 49` 处理；不影响读输入寄存器（功能码 0x04）相关帧。

---

## 4. E-02 · 39 寄存器读取的长度上限问题

**问题：** 协议原文两处注明“数据长度以 2 字节为 1 单位；**数据长度不能超过 16**”（`STB3-125_Modbus_Protocol.md` L794、L872），
而原文示例帧给出“读全部参数 / 读输入寄存器”为 `01 04 00 00 00 27 B0 10`，其中 `00 27` = **39 个寄存器**，
超出原文自述上限 16 的两倍以上。

**冲突双方：**

| 来源 | 内容 |
| --- | --- |
| 原文注释（L794 / L872） | 数据长度不能超过 16 |
| 原文示例帧（L605） | `01 04 00 00 00 27 B0 10`（39 个寄存器） |
| 原文字段 / 寄存器表 | 输入寄存器共 39 个（30001~30039），“读全部参数”即读满 39 个 |

**判定：真机才能验证。** 原文在“读保持寄存器”与“读输入寄存器”两节使用**同一句**上限注释，因此不能排除该注释是沿用通用模板的遗留文字；
但也不能排除设备固件确实按 16 截断。任何一方都不能靠文档推断，**必须 M5 真机实测**。

**三种可能结论与应对：**

| 情况 | 真机现象 | 应对 |
| --- | --- | --- |
| **A. 真机接受 `00 27`** | 返回合法响应 `01 04 4E …`（1+1+1+78+2 = 83 字节），CRC 正确 | **M5 直接一帧读全**，无需分段；把该结论回写 `02_docs/06_QI协议说明.md` 第 7 节与第 3.1 节，并关闭分段代码路径 |
| **B. 真机拒绝 `00 27`** | ① 返回异常码 `01 84 03 …`；② 只返回被截断的长度；③ 完全不响应（超时） | 改用 **3 段读取**（见下），每段 ≤16 个寄存器 |
| **C. 其它** | 例如：接受但只返回前 16 个、或返回 CRC 错帧、或返回功能码异常 | **按 B 方案的 3 段读取处理**，并把真机原始现象（HEX）完整记录到本节；不得自行推测固件行为 |

**B 方案：3 段读取（本轮已固化，CRC 全部独立重算）**

| 段 | 覆盖寄存器 | 0-based 范围 | 数量 | 完整帧（含 CRC，低字节先发） |
| --- | --- | --- | --- | --- |
| **S1** | 30001~30016 | `0x0000~0x000F` | 16 | `01 04 00 00 00 10 F1 C6` |
| **S2** | 30017~30032 | `0x0010~0x001F` | 16 | `01 04 00 10 00 10 F0 03` |
| **S3** | 30033~30039 | `0x0020~0x0026` | 7 | `01 04 00 20 00 07 B0 02` |

- 三段覆盖 `0x0000~0x0026` **恰好 39 个寄存器，无重叠、无缺口**。
- **CRC 独立重算记录**（CRC16/Modbus，初值 `0xFFFF`，多项式 `0xA001`，反射算法，低字节先发）：
  - S1 请求帧载荷（**不含 CRC**）`01 04 00 00 00 10` → 计算值 `0xC6F1` → 线上追加 `F1 C6`
  - S2 请求帧载荷（**不含 CRC**）`01 04 00 10 00 10` → 计算值 `0x03F0` → 线上追加 `F0 03`
  - S3 请求帧载荷（**不含 CRC**）`01 04 00 20 00 07` → 计算值 `0x02B0` → 线上追加 `B0 02`
- **预期响应帧长**：S1 / S2 = `3 + 2×16 + 2` = **37 字节**；S3 = `3 + 2×7 + 2` = **19 字节**。
  帧长驱动收帧必须**按段分别计算**，不得写死。
- **合并解析逻辑**：按 S1 → S2 → S3 顺序，把每段响应的**数据域**（去掉地址 / 功能码 / 字节数 / CRC）依次拼接，
  得到 `39 × 2 = 78` 字节的连续数据域；之后再按 `02_docs/06_QI协议说明.md` 第 4 节的字段映射逐字段解析。
  **每段必须独立校验 CRC**，任一段失败即整轮判失败（不得用部分段拼出“看起来正常”的数据）。
- **失败降级**：某段连续失败 N 次（建议 N = 3）时，该轮整体丢弃并在日志标记 `PARTIAL/FAIL`，不得发送残缺数据。
- **宏开关**：`01_firmware/` 侧以编译期宏（建议名 `QI_READ_SPLIT_3SEG`）在“一帧读全 / 3 段读取”之间切换。

**明确（本轮结论）：**

> ✅ **【2026-10-07 批次 2 真机实测结案：情况 A 成立】**
> 真机 STB3-125 **接受 `00 27` 一帧读全**：`01 04 00 00 00 27 B0 10` → **83 字节合法响应**（byteCount=78，CRC 正确），
> **384 轮连续成功、poll_err=0、成功率 100%**；39 寄存器值与 3 段方案（批次 1 真机 59/60）**同序同值**（reg14/15 电量 = 59167.144 度，两方案一致）。
> 原文"数据长度不能超过 16"注释对 0x04 读输入寄存器**不成立**（疑为沿用的通用模板遗留文字）。
> **落地**：固件批次 2 起**运行时自适应**（启动默认一帧读全；从未成功且连续 `QI_FULLFRAME_FALLBACK_AFTER=3` 轮失败自动降级 3 段，曾成功永不降级）——
> **不再用编译期宏 `QI_READ_SPLIT_3SEG` 二选一**（该宏已删除），3 段保留为失败降级路径。结论已回写 `02_docs/06_QI协议说明.md` 第 7 节与第 3.1 节。

---

## 5. E-03 · 寄存器方式锁扣 / 合闸的地址

**问题：** 原文“远程锁扣命令”一节把两条**不同语义**的帧并列：

| 原文位置 | 原文命令 | 原文标注 | 实际寄存器地址 |
| --- | --- | --- | --- |
| L1009 | `01 05 00 02 FF 00 2D FA` | 远程锁扣（线圈 2 = 00003） | 线圈 2 ✓ |
| L1013 | `01 06 00 0D 00 00 18 09` | 远程锁扣（寄存器方式） | 保持寄存器 `0x000D` |

**独立核对（按原文寄存器表，不引用任何推断）：**

| 协议编号 | 0-based | 原文功能 |
| --- | --- | --- |
| 40012 | `0x000B` | **远程锁扣 / 解锁**（`0xFF00` 锁 / `0x0000` 解） |
| 40013 | `0x000C` | 自动控制 / 手动 |
| 40014 | `0x000D` | 远程合闸 / 分闸（`0xFF00` 合 / `0x0000` 分） |

- 原文 **V4.1 版本更新记录**明确写：“加入**远程锁扣放在 40012**，本地锁扣放在 30001 高位”（`STB3-125_Modbus_Protocol.md` L43）。
- 因此“远程锁扣”对应的寄存器是 **40012 = `0x000B`**，而不是 `0x000D`。

**判定：** 原文该条 `01 06 00 0D 00 00 18 09` **疑似复制粘贴笔误** —— 把 40014 的地址 `00 0D` 抄到了锁扣条目上。
注意其 CRC `18 09` 对 `00 0D` 是**正确的**，说明错的是**地址字段**，不是 CRC。

**⚠️ 高危后果（必须登记）：** 若照原文执行 `01 06 00 0D 00 00 18 09`，写入 40014 = `0x0000`，
设备的实际动作是 **“远程分闸”**，而**不是**“远程锁扣”。这属于“看起来是锁扣、实际是拉闸”的静默错误。

**修正后的候选帧（CRC 独立重算，低字节先发）：**

| 用途 | 候选帧 | 说明 |
| --- | --- | --- |
| **远程锁扣（候选）** | `01 06 00 0B FF 00 B9 F8` | 写 40012 = `0xFF00`（CRC 字 `0xF8B9`） |
| **远程解锁（候选）** | `01 06 00 0B 00 00 F8 08` | 写 40012 = `0x0000`（CRC 字 `0x08F8`） |

**保留原文帧作为对照（CRC 均正确，问题出在地址 / 标注）：**

| 原文帧 | CRC 复核 | 对照结论 |
| --- | --- | --- |
| `01 06 00 0D FF 00 59 F9` | ✓ 与独立重算一致 | 40014 = 远程**合闸**（原文标注正确） |
| `01 06 00 0D 00 00 18 09` | ✓ 与独立重算一致 | 40014 = 远程**分闸**（原文标注为“锁扣”，**标注错误**） |

**明确（本轮结论）：**

> **本阶段一律禁止执行任何 STB3-125 控制类命令**（含上述候选帧）。E-03 **仅登记与判定，不做真机验证**。
> 任何一条在 M5 之后启用，必须单独走安全评估并由用户现场确认（见 `02_docs/06_QI协议说明.md` 第 9 节使用纪律第 3 条）。

本项定性为“静默高危”：原文把 40014 分闸操作标注为“远程锁扣”，若照抄执行会误触发分闸。已登记为 R-08 子项。

---

## 6. 勘误清单汇总

| 编号 | 事项 | 性质 | 状态 |
| --- | --- | --- | --- |
| E-00 | 22 条示例帧 CRC 复核基线（21 通过 / 1 不通过） | 复核基线 | 已完成 |
| E-01 | 读线圈 0-3 回复帧 CRC 笔误：`90 48` → `D0 49` | 笔误（有确定修正值） | 已判定 |
| **E-02** | `00 27`（39 寄存器）超出原文"不能超过 16"自述上限 | 需真机验证（A/B/C 三选） | ✅ **已判定（批次 2 实测 2026-10-07）：A 成立——真机接受一帧读全，384 轮 100%**；3 段保留为固件自动降级路径 |
| **E-03** | 寄存器方式锁扣地址 `00 0D` 疑似应为 `00 0B` | 笔误（高危，地址字段） | 已判定，**仅登记不执行** |

> 本文件为旁路勘误，**不修改**原始 `STB3-125_Modbus_Protocol.md` 与 `STB3-125_Modbus_Protocol.doc`、
> `STB3-125_Database_Fields.md` 与 `STB3-125_Database_Fields.docx`。
