jiangtao-ml/ESP32_C3_Gateway/(commit log)

2026-09-27 阶段0: 初始化工程目录
2026-09-27 阶段0: 添加上下文包 00_context.md
2026-09-27 阶段0: 补全上下文包 00_context.md
2026-09-27 阶段0: 修正README与上下文一致
2026-09-27 阶段0: 修正上下文包内部不一致并补充盲区清单
2026-09-27 阶段0: 收尾脱敏与残留修正
2026-09-27 阶段0: 修正目录树说明措辞
2026-09-27 阶段1: 新增任务书 v0.1 与技术审查报告
2026-09-27 阶段1: 更新上下文包（任务书进度、状态机时点、EN引脚）
2026-09-27 阶段1: 修正主控板型号误标并同步上下文
2026-09-27 阶段1: 入库QI协议材料并关闭R-01
2026-09-27 阶段1: 新增STB3-125协议CRC勘误记录
2026-09-27 阶段1: 统一RXO术语
2026-09-27 阶段1: 新增任务书v0.2复查报告
2026-09-27 阶段1: 同步README与CTX（EN冲突/术语/过期措辞/Q-08）
2026-09-27 阶段1: 扫尾清理CTX与README残留
2026-09-27 阶段1: 修正CTX第五节（网络事实/术语/裁定）
2026-09-27 阶段1: CTX补注UDP目标IP与ESP32自身IP区分
2026-09-27 阶段1: CTX去掉任务书版本号硬编码
2026-09-27 阶段1: CTX去掉未确认的5GHz断言
2026-09-27 阶段1: M0 冻结
2026-09-27 阶段2: README软化5GHz未确认断言
2026-09-27 阶段2: 任务书软化5GHz未确认断言（v0.2.6→v0.2.7）
    - §7.3 M1「网段」行、§10 R-03、§11.2 第 5 条：删除未确认的"电脑连 5GHz"断言，
    统一软化为"电脑侧频段未实测，以 M1 实测为准；频段差异本身不是网段不一致的判据"
    - §13 v0.2.6 行状态补"已冻结（e32b3b9）"；新增 v0.2.7 行
    - 头部版本/更新日期 → v0.2.7；§9.1 M0 行、§8.3 示例同步
    - 不涉及事实变化（文档卫生）
2026-09-27 阶段2: 任务书阶段一收口（v0.2.7→v0.2.8）
    - §9.1 M0 行状态改为「✅ 已完成（e32b3b9，2026-09-27）」
    - 头部文档状态 → 已冻结（v0.2.7，2026-09-27）
    - 头部当前阶段 → 阶段二：环境搭建与基建
    - §13 新增 v0.2.8 行；版本/更新日期 → v0.2.8
    - 不涉及事实变化
2026-09-27 阶段2: 初始化固件工程骨架（M1 前置）
2026-09-27 阶段2: 新增 ESP32 开发板包排障文档
    - 新增 02_docs/11_esp32开发板包排障.md（v1.0，待验证）
    - 记录 M1 阻塞项：开发板包卡在 esp-x32@2601
    - 四个排查方向：A 镜像源 / B 网络DNS代理 / C 手动离线 / D PlatformIO 备选
    - 含执行顺序路由表、现象判定表、清理纪律、5 项待确认
    - 引用地址均出自 Espressif 官方 Troubleshooting 文档或平台索引 JSON
    - 不含 ESP32 业务代码
2026-09-27 阶段2: .gitignore 忽略 .workbuddy 目录
2026-09-27 阶段2: 任务书 §8.2 补两条已完成交付物（v0.2.8→v0.2.9）
    - §8.2 M1 段补入：11_esp32开发板包排障.md（aae2c8d）
    - §8.2 M1 段补入：固件工程骨架 01_firmware/esp32c3_gateway/（c37afa5）
    - §13 新增 v0.2.9 行；版本/更新日期 → v0.2.9
    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
2026-09-27 阶段2: 修正CTX工具链记录（esp-x32→esp-rv32）
2026-09-27 阶段2: 排障文档补 esp-rv32 与 CN 镜像验证
    - 工具链更正：esp-x32（Xtensa）→ esp-rv32（RISC-V）；补「ESP32-C3 是 RISC-V 芯片」说明
    - §1.1 补首次失败实测报错（走 github.com / 20.205.243.166）
    - §1.2 写入 CN 镜像 URL；补「必须完全重启 IDE」「必须选 -cn 后缀版本」两条关键提示；
    新增「验证 CN 镜像是否生效」小节（下载 URL 指向 jihulab.com 才算生效）
    - §2 判定表补「报错含 github.com / 20.205.243.166 → 镜像未生效」一行
    - §4 C-01 闭环（工具链名称已澄清），新增 C-06（两条镜像路径是否等价）
    - 文档版本 v1.0 → v1.1
2026-09-27 阶段2: 全文清理esp-x32残留并更新引用块
2026-09-27 阶段2: 实现M2 WiFi+NTP+UDP+最小状态机骨架
2026-09-27 阶段2: 修复NTP时区不生效（CST-8 + 挪到WiFi连上后）
    [config.h, esp32c3_gateway.ino]
2026-09-27 阶段2: 任务书 v0.3.2（M2 达成 + FR-02 修正 TZ 串）
    - FR-02：TZ 串去尖括号 configTzTime("CST-8", ...)，补 POSIX TZ 解析说明与 SNTP 时序要求
    - §7.3 后新增「M2 实测结果（2026-09-27）」表（WiFi 静态 IP / NTP / UDP 每秒发包 /
    最小状态机骨架 / WiFi 自恢复 / 偶发丢包 / 关键 bug）
    - §13 新增 v0.3.2 行；版本/更新日期 → v0.3.2
2026-09-27 阶段2: 任务书 v0.3.3（M2 正式通过，进入 M3）
    - §7.1 里程碑表 M2 行标记 ✅ 已完成
    - §7.3 M2 实测表「偶发丢包」行：观察通过，1 分钟丢包率低，满足 M2 判据（<1%），M6 压测再收口
    - §13 新增 v0.3.3 行；版本/更新日期 → v0.3.3
2026-09-27 阶段2: M3 实现UART1物理回环自测
2026-09-27 阶段2: 任务书 v0.3.4（M3 通过：UART1 物理回环）
    - §7.3 后新增「M3 实测结果（2026-09-27）」表：UART1 物理回环 / 1 分钟统计 /
    M2-M3 共存 / 状态机填充满跑通
    - §7.1 里程碑表 M3 行标记 ✅ 已完成
    - §13 新增 v0.3.4 行；版本/更新日期 → v0.3.4
2026-09-27 阶段2: 任务书 v0.3.4 补完（M4 启动 + M3 关键修正行）
    - §7.3 M2 实测表「偶发丢包」行定案为「✅ 观察通过，1 分钟丢包率低」
    - §7.3 M3 实测表补「关键修正」行（清 RX 缓冲挪到 write() 之前，Codex 修正
    总控规格错误）；保留原有「状态机填充」行，共 5 行
    - §7.3 后新增「M4 启动（2026-09-27）」：真实 485 总线方案 + USB 转 485（丝印 B/A/G）
    - §13 v0.3.4 行内容补齐为「M2 定案通过；M3 通过；M4 启动」
2026-09-27 阶段2: M4 实现真实485收发与Modbus RTU解析
2026-10-03 阶段2: 全仓库审查与一致性修正（授权直接改）
2026-10-03 阶段2: 核实MAX13487数据手册并升级偏置电阻为功能验收项
2026-10-03 阶段2: 第6轮独立复验与文档补强
2026-10-03 阶段2: 审查纠错（偏置机理/明文脱敏/一致性）
2026-10-04 阶段2: M4 验收通过（3 项补测全 PASS）+ 全轮文档与测试资产归档
    【M4 结项】
    - 主干：2026-10-04 21:33，连续 65 秒解析 OK 65 次 / 0 超时 0 CRC 失败。
    - 根因：485 模块丝印 TXD/RXD 为「交叉」约定（GPIO21→模块 RXD、GPIO20←模块 TXD），
    此前按「同名对接」接线导致双向全断、而模块电源灯仍亮。
    - 补测三项全 PASS：① 静默 10 次后仍完成后续轮询；② 注入 1 位 CRC 错误被识别且不崩溃；
    ③ 1000 次累计统计。实测 1000 次 / 1000.0 s（节奏零漂移），
    解析 OK 984 / 超时 11 / CRC 失败 5 / 帧长异常 0，账目自洽。
    - 唯一非刻意失帧 1 次为半帧 RX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
2026-10-04 阶段2: M5 前置准备（真机联调操作卡 + 帧 CRC 独立复核脚本）
    - 新增 06_tests/M5_真机联调操作卡.md：M5 现场执行卡。
    含上电前安全闭环（供电隔离 R-14 / 共地 / EN 固定高 / 只读不写）、
    M4→M5 接线差异、帧清单、E-02 决策树、代码改动清单（交总控/Codex）、
    四步执行与判据、失败判读速查、换算速查、现场记录表。
    卡内所有命令帧均取自 02_docs/06_QI协议说明.md，未发明任何帧。
    - 新增 06_tests/m5_frame_check.py：独立重算 CRC16/Modbus 复核 M5 用帧。
    复核结果 7/7 OK：真机帧 01 04 00 00 00 27 B0 10、
    3 段帧 S1 01 04 00 00 00 10 F1 C6 / S2 01 04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
2026-10-04 阶段2: 新增 NTP 可达性探针（内网 chrony 172.16.0.2 实测可用）
2026-10-04 阶段2: 新增 Codex 施工指令 01（NTP 改三源 + 日志打印实际生效源）
2026-10-04 阶段2: M5 操作卡 v1.1 —— 按真机实拍（带电 220V 配电箱）整体重写安全章节
2026-10-04 阶段2: M5 操作卡补记 —— 真机疑似三相 380V（断电须断全三相）
2026-10-04 阶段2: M5 操作卡 v1.2 —— 新增「引出线是信号线还是电源线」判定步骤
2026-10-04 阶段2: 清理误入库的 AI 临时产物并加 .gitignore 规则
2026-10-04 阶段2: M5 操作卡 v1.3 —— 引出线身份定性 + 纠正「断电安装≠此后安全」+ 端子台可靠性提示
2026-10-04 阶段2: 补记 —— NTP 三源固件改动（Codex 产出，被提交 1545901 顺带收录）
    说明：本轮 WorkBuddy 提交 1545901（操作卡 v1.3）时使用了 `git add -A`，把 Codex 在同一
    时间完成的固件改动一并收录，而该提交信息未覆盖固件内容。此处补记，避免日志误导。
    改动内容（01_firmware/esp32c3_gateway/）：
    config.h
    - NTP 由两源改三源：NTP_SERVER_1 = "172.16.0.2"（主，校内 chrony）
    / NTP_SERVER_2 = "ntp.aliyun.com"（备1）/ NTP_SERVER_3 = "203.107.6.88"（备2）
    - 旧宏 NTP_SERVER / NTP_SERVER_IP 已更名，无悬空引用
    - 注释写明实测延迟（3.4 / 41.0 / 40.8 ms）与「为什么必须保留公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
2026-10-05 阶段2: 新增 NTP 三源改造烧录验收脚本 ntp_verify.py
2026-10-05 阶段2: NTP 验收定位「判定过早」根因 + 同步电脑 IP + 新增 UDP 侧监听
    【烧录验收结果（2026-10-05）】
    - ✅ 编译 + 烧录成功（arduino-cli 1.5.1；WorkBuddy 首次自行完成编译与烧录）
    - ✅ UDP 上行端到端打通：电脑侧 udp_listen.py 收到 76 包（来源 192.168.1.200:12345）
    - ✅ 时区实际正确（14:39:58 起的时间戳为正确本地时间）
    - ⚠️ 但「实际生效源」未测出，且「时间已同步」行显示 +0000
    【根因（已定位并取证）】
    复位后 ESP32 的 RTC 域保留时间 ⇒ ntpTick() 里 getLocalTime() 立即返回 true ⇒
    固件在「WiFi 未连、configTzTime 未调用、TZ 未生效」的时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
2026-10-05 阶段2: 修正 NTP 同步判定（改用 SNTP 回包状态，兼容复位后 RTC 保留时间）
    问题（03_logs/NTP验收_20261005_143955.log）：
    - 软复位后 RTC 域保留上一轮时间，getLocalTime() 立即返回 true，于是在 WiFi 未连、
    configTzTime 未调、TZ 未生效时就打印「时间已同步」，%z 显示 +0000（应 +0800）；
    紧接着 logNtpEffectiveSource() 因 SNTP 未收到任何回包而只剩兜底，读不到实际生效源。
    - 连带隐患：g_timeSynced 被过早置位，「同步丢失→降级 UNSYNCED」路径被 RTC 旧时间掩盖。
    改动（仅 01_firmware/esp32c3_gateway/esp32c3_gateway.ino）：
    - 「已同步」判据改为 g_ntpTrigg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
    [esp32c3_gateway.ino]
2026-10-06 阶段3: M5 真机联调通过 + 数据落地设计 + PlatformIO 并行验证
    M5 主干（2026-10-05 实测）：真机三段读取 59/60，78 字节真实数据；
    WiFi/NTP/UDP 上行 36/36 包；COM5 消失确认 USB 已拔。
    【文档】
    - 新增 02_docs/16 数据落地与商业化设计
    · 39 输入寄存器 ↔ 39 数据库字段 一一对应、顺序一致（三方吻合）
    · 数据分层 L0~L3 与「固件只搬原始值」原则
    · 「错误数据不要」应实现为「整行入库 + 字段置 NULL + 打质量标记」，不是丢行
    · 商业化 12 条按 P0/P1/P2 分级；含与老师参考实现的对比、六条线推进计划
    - 新增 02_docs/17 参考实现逆向笔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
2026-10-06 阶段3: 数据落库原型（字段字典 + SQLite 落库 + 四层校验 + 幂等）
    承接 02_docs/16 的 A1/A3。
    【新增】
    - 05_hardware/STB3-125_字段字典.csv 39 行机器可读字段字典（唯一事实来源）
    列：reg_index/reg_addr/field/cn/unit/raw_min/raw_max/decimals/conv
    由 m5_parse.py 的 KIND 表脚本生成，避免手工转录出错
    - 06_tests/db_proto.py 落库原型：字典驱动 解析 → L0~L3 校验 → 质量打标 → 幂等入库
    · 保留 raw_hex（公式可演进、历史可重放）
    · PRIMARY KEY(device_id, collect_time) + UPSERT ⇒ 补传/重发天然幂等
    · --known-missing：把「该型号已知不上报字段」与「本次异常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
    [STB3-125_字段字典.csv]
2026-10-06 阶段3: 功能对齐（对齐老师参考实现）施工计划 + 批次 1 施工指令
    用户列出老师的 8 项能力，要求「老师有的我们也要有」。
    【分批（按可独立验证切，不一次全塞）】
    - 批次 1：JSON 上行（数据行 + 心跳行）+ dev 命名 + 累计计数器
    · 只动 sendUdpPayload 与几个计数器，不动 485 逻辑
    · 台面即可验证（A/B 拔掉 + USB 供电 = 无市电回路，安全）
    - 批次 2：一帧读全为默认 + 失败自动降级 3 段
    · 顺带一举给出 E-02 的答案；但会动状态机，必须与批次 1 分开
    - 批次 3：AP 回退 + Web 配置页 + /status + NVS 持久化
    · 约等于新写一套配置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
2026-10-06 阶段3: 新增根目录 PROGRESS.md（给所有协作者/智能体的当前状态与下一步）
2026-10-06 阶段3: 角色口径变更 —— Codex 也可改文档（分事实类/决策类，决策类须留痕；00_context.md 仍禁改）
2026-10-06 阶段3: 批次 1 独立复核通过 + 补项（known-missing 分层 / 缓冲 1200 / err 行）
2026-10-06 阶段3: PROGRESS.md 新增 §5b 工具链（编译/烧录走 Arduino，PlatformIO 只做对照）+ 迁移门槛
2026-10-06 阶段3: 同步固件工程 README —— 文首加当前状态块、新增 M5 章节、修正 NTP 三源/IP/超时/基线，历史章节标注保留原样
2026-10-06 阶段3: 依用户授权同步根 README 与 00_context —— M5 已通过/NTP 三源/IP .113/JSON 上行/角色新口径（逐处留痕）
2026-10-06 阶段3: 文档铁律改版(分层+留痕) + 全仓过期清理(任务书v0.4.0/06升v1.2/16升v1.10) + PROGRESS.md 新增 §0 交接入口
2026-10-06 阶段3: 补 PROGRESS.md §2b 第4条改版(上一轮漏改) + 两份已执行指令补 IP 勘误注(.114→.113)
2026-10-06 阶段3: 新增 04_ai_prompts/05 新智能体接手指令(可整段复制) + PROGRESS.md §0 加入口
2026-10-06 阶段3: 05 接手指令补「开新会话第一条消息」模板 + 交接状态说明
2026-10-06 阶段3: 接手校准(D1/D2)：事实源清扫 + 温度口径闭环 + 补 M5 结项记录
    - 角色口径 D1：WorkBuddy 由「不写业务代码」改为「可写，须不得自审自改」
    同步 README §2.3 / 00_context 一 / PROGRESS §2·§2b9 / 任务书 §3·§12
    - README §6.1：两段矛盾 EN 说明合成一条，清除「型号待复核」过期表述
    - 00_context：三节过期事实清扫 + 新增「七、变更记录」(C-1~C-9，内容保留仅归置)
    - db_proto.py：温度量程口径修正(不再二次减40) ⇒ 与固件一致，闭合 PROGRESS §8.1-3
    - 任务书 v0.4.0→v0.4.1；§11.1 由「逐字镜像」改为「带日期快照·以CTX为准」
    - PROGRESS §5b：Pla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
    [db_proto.py]
2026-10-06 阶段3: PlatformIO core 选型决策备忘(建议钉 3.x) + PROGRESS §8.1-4 更新
    - 核到硬事实:官方安全策略 2.x ❌ / 3.x ✅;2.0.x 自 2024-07 停支
    - 实测 API 审计:本固件只用 Serial1/WiFi/WiFiUDP/configTzTime,
    3.x 破坏性变更区(ADC/LEDC/RMT/Timer/I2S/... )一个都没碰
    - 结论:方案一(2.0.17)= 作废 M0-M5 且无安全补丁;方案二(3.x)= 现基线
    - 落地:PIO 需走 pioarduino 并钉精确 release,框架包归档自持
    - 待用户/老师拍板;另需核实现板 3.3.10-cn 对应官方哪个确切版本
2026-10-06 阶段3: 确认 -cn 镜像含义 + PlatformIO 3.x 国内镜像/离线方案(02_docs/20)
    - -cn = Espressif 官方中国镜像渠道标记(本机两索引 JSON 对照):
    3.3.10-cn 对应官方 3.3.10;CN 索引全部 URL 指向 dl.espressif.cn;索引源 jihulab.com
    - 根因实测:github.com 直连超时(0 字节);dl.espressif.cn/jihulab/gh-proxy/ghfast.top/清华PyPI 均可达
    - 归纳两条通道规则:A) espressif 组织资产 -> dl.espressif.cn/github_assets/...
    B) 非 espressif(如 pioarduino) -> gh-proxy
    - 关键发现:pioarduino/registry 的 zip 只是清单桩(1~2KB),tools.json 里真实
    工具链地址回到 espressif 组织 => 可走 CN CDN
    - 给出 3.x 迁移完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
2026-10-07 阶段3: PlatformIO 3.x 迁移编译打通（pioarduino 55.03.311 首编 SUCCESS）
    - pio_cn_seed.py v2.0：平台驱动 + 桩包解析 + magic-byte + 双通道(规则A/B)
    - platformio.ini：平台 espressif32@7.1.3(2.0.17) ⇒ 本地 pioarduino(3.3.11/IDF5.5.5)；
    lib_ldf_mode deep+ ⇒ deep（上游 issue #9782，3.x 禁带 +）
    - main.cpp：加 WiFi.h 锚点（deep 模式 LDF 不跟进 src 外 .ino）
    - 02_docs/20 v1.1：§8 落地结果 + 6 个环境坑 playbook；风险表 #2/#6 闭环
    - PROGRESS.md：§5b 落地注记 + §8.2-14
    [main.cpp, pio_cn_seed.py]
2026-10-07 阶段3: 功能对齐批次 1 真机验证通过（JSON 上行 + USB CDC 阻塞修复）
    - config.h/.ino：批次 1 上行改手写 snprintf JSON（每轮 1 行心跳 + 三段全成功 1 行数据 + 失败 1 行 err），
    含 seq/dev/mac/ts/ts_ok/quality/invalid/seg/raw(78B HEX) + poll_ok/poll_err/udp_tx 计数
    - bugfix（砚青，已复核）：Serial.setTxTimeoutMs(0) 修 USB CDC 无主机 write 阻塞(默认100ms × 每轮~190次=19s/轮)，
    真机拔 USB 轮询 19s/轮 -> 1s/轮
    - 真机验证：300s 采样 poll_ok=403/poll_err=0=100%；39 字段+raw 全对；电量公式 (H*65536)/1000+L 实证
    - PROGRESS.md：§0 进度 + §8.2-15/16
    [config.h, esp32c3_gateway.ino]
2026-10-07 阶段3: 批次 2 一帧读全+自动降级，E-02 结案（A: 真机接受 39 寄存器一帧）
    - config.h/.ino（Codex 写，砚青独立复核）：废除编译期 QI_READ_SPLIT_3SEG，
    改运行时 g_readMode 自适应：启动一帧读全(00 27,83B)，从未成功且连续 3 轮
    失败自动降级 3 段（曾成功永不降级）；心跳加 mode；数据行 seg 1/3、err F/S1~S3
    - 编译：0 err/0 warn，Flash 1005739(+804B)/RAM 39292(+8B)
    - 真机：一帧读全 384 轮 poll_err=0=100%，从未降级；39 字段逐项对照 raw 全对
    （E-02 情况 A 成立：原文上限16对 0x04 不成立）；悬空态降级路径亦验证通过
    - 文档：06_QI E-02 结案+3.1/头部更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
2026-10-08 阶段3: 批次 3 常驻AP+Web配置页+/status+NVS（Codex 写，砚青复核+台面 9/9）
    - config.h/.ino/web_config.h（新，480 行）：常驻 SoftAP(ESP485-<MAC后6位>，口令 NVS+MAC 派生)
    + 配置页 4 卡片（照老师版逆向 02_docs/17）+ POST /save、GET /reset（Basic Auth）
    + GET /status（老师 22 项逐字 + dev/mode/free_heap，无密码字段）
    - 运行时化：UDP 目标/采集周期(1-5s)/NTP 主源/WiFi 凭据编译期宏 -> 变量（NVS cfg485 覆盖，
    保存立即生效无需重启）；enableDelay(false)；/reset 延迟重启；凭据零回显
    - 编译：0 err/0 warn，Flash 1070427(+63.2KiB)/RAM 49340(+9.8KiB)（复核独立复现一致）
    - 台面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
    [config.h, esp32c3_gateway.ino, web_config.h]
2026-10-08 阶段3: 批次 3 真机回归 100%，批次 3 正式闭环
    - 真机合闸采样 300s：HB 301 + DATA 300 + ERR 0，mode=full/seg=1，poll_ok=590/poll_err=0
    - 1s 节拍（NVS period 生效）；UDP 目标 = Web 配置的 192.168.1.121（NVS 配置真机场景工作正常）
    - PROGRESS 8.2-22 入档
2026-10-08 阶段3: 批次 3.5 LED 状态指示（板载蓝灯 GPIO8，用户现场验证通过）
    - config.h +5 宏 / .ino +55 行：ledPulse()（ST_SEND 每轮触发：成功短亮 30ms / 失败长亮 200ms）
    + ledTick()（WiFi 未连接 500ms 慢闪；慢闪->脉冲切换主动灭灯防常亮）；全 millis() 非阻塞
    - 板载蓝灯 HW-466AB = GPIO8 低电平点亮（[待确认] 批次差异用 LED_ACTIVE_LOW 宏可切）
    - 编译 0/0：Flash 1070761(+334B)/RAM 49348(+8B)；现场验证：WiFi 慢闪 + 连上后每秒轻闪
    - 对标老师固件 [LED 状态灯；不碰 485/UDP/状态机
2026-10-08 阶段3: M6 前置·迁移对照验证台面部分完成（pio 编译 SUCCESS + 悬空对照 8/8 一致）
    - main.cpp 补 WebServer/Preferences LDF 锚点（web_config.h 在 src/ 外，LDF 看不到）
    - pio 编译最新源码 SUCCESS 192s；环境 4 障碍突破（penv 依赖修复 / esptool 5.4.0 sdist
    缺陷绕过 / tool-scons 版本对齐 / pioarduino Core enable_telemetry KeyError patch；
    safe-delete 挂死用 CODEBUDDY_SAFE_DELETE_ENABLED=0）——patch 细节见 PROGRESS 8.2-24
    - 悬空对照 8/8 与 Arduino 产物一致：/status 25 项、Web、401、改目标立即生效、
    1s 节拍、3seg 降级、LED；发现：烧 pio factory.bin 清 NVS（烧后需 Web 重配）
    - 剩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
    [main.cpp]
2026-10-08 阶段3: P0-1 短帧防护（Claude 完善 + 砚青复核，编译 0/0）
    - parseResponse (5b)：byteCount+5 必须等于本段期望响应长（83/37/37/19 自动成立），
    否则判段失败发 err 行。堵住静默掺假路径：从站回短帧时 (5) 自洽判定拦不住，
    g_merged 尾部残留上一轮值且 quality 可能仍 OK（一帧读全 39 寄存器下风险更大）
    - 复核：闭环正确（WAIT_RX 按 byte count 提前收尾，(5b) 是唯一防线）、不写死常量、
    单点失败分支不碰状态机；Flash 1070975(+214B)/RAM 49348
    - 注意：设备需重烧（pio 链重编译后 factory.bin 清 NVS，需 Web 重配）
2026-10-08 阶段3: M6 前置收官——迁移真机对照 100%，PlatformIO 迁移正式完成
    - pio 产物真机 300s：HB 301/DATA 296/ERR 0，poll_ok=385/poll_err=0=100%
    - mode=full/seg=1/raw 78B/39 字段与 Arduino 产物同源同值（A_voltage=221、
    frequent=50.0、openState=00F0）；1s 节拍；P0-1 零误伤
    - 结论：Arduino 3.3.10 与 pio 3.3.11 真机行为等价 => 正式编译链 = PlatformIO
    - 下一步 = M6 压测（正式链）-> M7
2026-10-08 阶段3: M6 压测通过（900s 100%）+ P0-1 配套测试工具入库
    - M6 收官：poll_ok=975/poll_err=0=100%（线 97%，老师基线 96.9%）；HB 900 节拍
    零漂移；DATA 882 无 LEN 失败（P0-1 零误伤）；UDP 丢 2/1800；free_heap 稳定
    - P0-1 配套：m5_slave_04.py --short N（短响应对照从站，P0-1 靶子）+ README v1.9
    （Claude 产出，砚青复核：语法/逻辑通过，实测留待下次台面窗口）
    - 下一步 = M7 安全收紧 + 验收
    [m5_slave_04.py]
2026-10-08 阶段3: 洞洞板固化操作卡 v1.0（老师要求：面包板 -> 洞洞板）
    - 接线表 8 根从 config.h 引脚定义与接线说明.md 提取，照抄已验证 100% 的面包板现状
    - 排母方案（模块可换）+ A/B/GND 端子 + 万用表逐根核对 + 上电六步验证流程
    - 红线照抄：字母对接 / EN 固定 5V / 共地 / RXO 直连（本模块实测）
2026-10-17 阶段4: 新增 M7 需求规格说明书与实现交付方案
    - 02_docs/21: 从代码逆向的需求基线（18 FR / 6 IF / 6 DR / 10 NFR / 13 隐含需求 / 12 条差异 / 追溯矩阵）
    - 02_docs/22: 168h 接收程序设计 + 统计三口径与对账恒等式 + 明文vs AES-GCM 对比 + 168h 判据表
    - 04_ai_prompts/08: 交付方案复核提示词（作者≠验证者）
2026-10-17 阶段4: 项目结构整理与文档状态校准
    删除(6): _enc_probe.txt / .codex_baseline_build.txt / __pycache__ /
    .pio/build_2x.bak(38MB) / 5个失效 .gitkeep
    归档(2): usb485_loopback.py / M4_重测操作卡.md -> 06_tests/_archive/
    (保留 M4 踩坑物证，附作废原因 README)
    更新(6): 根README与固件README的关卡/编译基线/工具链/IP/轮询模式；
    00_context 4.2 字符间隔 4ms->8ms(C-10, 最严档定点修正)；
    .gitignore 放行 03_logs/README.md
    新增(4): 02_docs/23 项目结构说明 / 05_hardware/README（厘清carrier vs pcb）
    / 03_logs/README（A证据-B迭代-C待定分级）/ _archive/README
    [usb485_loopback.py]
2026-10-17 阶段4: 168h 接收端 udp_collect.py 落地（含统计引擎自检与 4 处口径校准）
2026-10-21 阶段4: 168h 长跑前代码加固 + 洞洞板施工文档（修 3 个静默 bug、固件 4 项加固、EN 统一 3.3V、M6 送达率更正 98.0%）
    [config.h, esp32c3_gateway.ino, udp_collect.py]
2026-10-21 阶段4: 装配定稿为无排母直焊不分压 + 产出 Codex 全面审查指令
2026-10-21 阶段4: Codex 固件审查改动入库（砚青复核通过：12 项禁区未动、双模式 0 error）
    [config.h, esp32c3_gateway.ino, web_config.h]
2026-10-21 阶段4: 全仓文档一致性对齐 + 第二轮清理（基线与送达率校正、EN/不分压统一、新增 §9 待办清单）
2026-10-21 阶段4: 目标级别定档 L1 + 外壳预留进布局（焊前必须钻安装孔）
2026-10-21 阶段4: 建立六阶段流程主线（S0-S5）+ 评审与风险登记册，PROGRESS 降级为日志
2026-11-04 阶段4: 商用级加固落地 + D-10 电量公式修正（P0-1~P0-4/A类4处/B类3处）+ 烧录与台架验证通过
    [STB3-125_字段字典.csv]
2026-11-04 阶段4: 168h 收官前置清单与风险预演(02_docs/32) + 电量勘误(31) + 加固与优化方案(28-30) + 收官核验指令(15)
2026-11-04 阶段3: 接收端修 starts 污染 + hb 证据列补四列；回填 168h 收官判定与风险册
2026-11-04 阶段3: M3 判据改双条件口径（用户拍板）+ 夜间窗口复算指令与脚本
2026-11-04 阶段3: C-a 复算 99.5678% 通过、Y-2 定稿 P；修脚本 3 处 bug；指纹勘误与 Y-7 改判
2026-11-04 阶段3: Y-7 经用户确认判 P（10-29 中断均为本人拔插）
2026-11-04 阶段3: 批次5指令（50ms 非阻塞间隔 + AES-128-GCM）v2 自查七处修正
    三处裁决：帧格式以 22 文档为准(0x82+AAD) / 加密后 payload 存明文 / 921B 不分片(v2 改按最坏 1135B 算)。
    v2 补齐 7 处：① ST_SEND 复位块必须随第二行后移（漏搬会让失败轮静默发 data 行）；② 两处 #if 守卫不能搬丢；③ ts 同轮一致判据改为 100%；④ 分片余量 337B 并定死 g_encbuf 下界；⑤ 回环分支禁入加密路径；⑥ 增量偏低也要解释；⑦ G5-2 增加失败注入。
2026-11-04 阶段3: 批次5指令 v3 补密钥派发流程(3.5) + 执行顺序补成7步
    §3.5 补：钥匙从哪来、两边怎么保证同一把、打错了怎么办。钥匙配错的现象(全盘 decrypt_fail)与加密实现有 bug 完全一样，不单独成节就会把两类故障混成一种。定死 aes_key 写入后只许擦 NVS 重配。§4 标题口径改为 3 处改动 + 回归自测。
2026-11-04 阶段3: 批次5 实施复核结论（独立重编双模式 + 逐行核对 + 3 处发现）
    ST0/ST1 全量重编与接收端 --selftest 均由我独立重跑，体积/警告数逐位一致。14 项硬要求全部落地。F1: boot_id 在 NVS 擦除后回 1 ⇒ 同一密钥重配会 nonce 复用，建议 esp_random 播种。F2: 密钥已落盘但开关失败的提示会误导。F3: /status 无 enc ⇒ 改为开跑 10 分钟内看 --report-only 的 enc 分布。
2026-11-04 阶段3: 新增批次5台架闸门 batch5_gate.py（G5-1~G5-7 可复算，不靠人眼对表）
    从采集库直接算：两包间隔分位数 / 相邻 hb 的 udp_tx 增量 / ts 单调 / decrypt_fail 与 enc 分布 / payload_len-payload 恒为 29B / 对账残差 / 丢包不对称比。复用已通过自检的 classify_loss 与 _epoch_stats，不另写一套。只读打开。
    自测：合成库好例 rc=0；gap=0ms 被判 FAIL(G5-1)；udp_tx 注入 +3 被判 FAIL(G5-2)；无 udp_packet 表时给友好提示不抛栈。修正一处自造 bug：hb 与第二行是两个不同 seq，第一版按 seq 分组导致永远配不上对（G5-1 全 NA、G5-2 半轮 100%）。
    [batch5_gate.py]
2026-11-04 阶段3: 修 G5-2 判据（原判据把整轮丢包误判为固件缺陷）
    原判据『相邻 hb 的 udp_tx 必须 +2』根本区分不了设备少发和网络丢包：整轮两包都丢时 udp_tx 就是 +4，照样 FAIL。台架首跑 3564 包因此误判 23 处，固件实际无问题。
    改为用 hb 自带的 poll 计数器做分母：Δudp_tx 必须 == 2×Δ(poll_ok+poll_err)。丢包不破坏该恒等式，只有少发/半轮才破坏；奇数 Δtx 才是设备半轮的真信号。另加独立判据抓跳轮：设备执行轮数/墙钟秒数须 ≈1/period。
    阈值同步修正：删掉『半轮占比<0.1%』（那是网络损失，不是设备行为）。
    自测四场景：好库 P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
    [batch5_gate.py]
2026-11-04 阶段3: 新增独立 g5_2_check.py（修正判据的极简复算，供无法传文件的机器自行落盘）
    batch5_gate.py 的修正在旧电脑上没送达（桌面仍是 21:26 版）。改走文本通道：这个脚本不依赖 batch5_gate/udp_collect，只需 sqlite3，让对端把代码块写成文件即可，绕开二进制传输。
    自测：好库 PASS；注入 +3 FAIL（抓到 seq 57->59 Δtx=3 / 59->61 Δtx=1）；整轮丢包(Δ+4/+6) PASS 不误判。
    [g5_2_check.py]
2026-11-04 阶段3: 批次5 台架首轮结果（明文臂全过）+ 记下我判据写错的教训
    G5-1 中位49.4ms / G5-2 修正判据后 1801轮÷1801.0s=1.0000 与 Δtx≠2Δ轮=0 / G5-4/5/6 PASS / G5-3/7 NA。
    核心教训：判据必须只用设备自己能感知的量做分母。udp_tx 是发送量、poll_ok+poll_err 是执行量，比值才是设备行为；udp_tx 的绝对变化混了网络丢包。原判据因此把 19 处整轮丢包误判成固件缺陷。
    另记 G5-7 方向反转=大包优先丢（本次 hb 300B 才是大包），15:1 不是阈值。
2026-11-05 阶段3: 新增 rssi_probe.py（RSSI/体积/分类丢包三联对照）
    密文臂 M3=69.39%、data 丢 50% 需定因。固件每包带 rssi（ino:1016），udp_packet.rssi 是独立列 ⇒ 两个库的 RSSI 分布对比即可区分「链路变了」与「大包更脆弱」。
    自测：合成库 plain(-56, 0.6% 丢) / enc_ok(-56, data50%/hb12%) / enc_bad(-79) 三种场景输出正确；尾部不满 5 分钟的桶已略过。
